xaiojie/papabot/hardware-selection/README.md

# 选型、BOM 与采购

| 资料 | 入口 | 用途 |
|---|---|---|
| 集成板 BOM 总表 | [最新 BOM 总表](procurement/2026-09-12/最新BOM总表.md) | 板载物料与整机配套件汇总 |
| 第三方资料 | [规格书与参考图](../docs/references/README.md) | 厂商规格、供应商说明与商品截图 |
| 采购清单 | [采购说明](procurement/2026-09-12/README.md) | 立创/淘宝清单、替代料及历史价格 |
| 2026-09-13 原始报价 | [报价归档](procurement/2026-09-12/立创报价单-20260913/README.md) | 原始 Excel、CSV、核对数据 |
| 模块方案 V7 | [V7](bom-v7/README.md) | 早期模块方案底表，与集成板清单区分使用 |
| 早期 BOM 工作簿 | [BOM 与建模尺寸](bom-v1/exports/桌面助手-BOM与建模尺寸.xlsx) | 原 `outputs/<会话编号>/` 工作簿 |
| 2S 供电选择 | [电源方案](power-selection-2s.md) | 电池和充电方案演进 |
| ACE800 电池记录 | [电池记录](battery-stock-2026-09-09/README.md) | 选型与结构适配依据 |
| 舵机参考 | [MG90S](servo-mg90s-180.md) | 型号和尺寸参考 |

`bom-v1` 至 `bom-v7` 之间有生成器和历史数据依赖，保留原相对布局。库存、价格、已购数量与替代料兼容性须按实际采购和器件核对，历史报价不视为实时数据。

采购原始表格未重新生成，本轮只归类目录并修正引用路径。生成器输出归到对应 BOM 版本的 `exports/`；本机依赖、检查转储和缓存不入库。
