xaiojie/papabot/pcb-design/README.md

# PCB 设计与制造资料

当前集成板为 `DesktopAssistant_Integrated`，110 × 75 mm 双层板。用户在 2026-09-13 调整过文字，继续编辑时优先读取用户最新版备份。

| 资料 | 入口 | 适用范围 |
|---|---|---|
| 用户最新版 | [核对结论](integrated-v1/user-latest-review-2026-09-13/核对结论.md) | 保留用户丝印与文字位置调整 |
| 芯片和屏幕资料 | [第三方资料索引](../docs/references/README.md) | 完整 PDF、规格图和供应商说明 |
| V1.2 无旋钮交付 | [交付说明](integrated-v1/final-no-encoder-2026-09-12/README.md) | 五页原理图、原生工程、Gerber、BOM 与检查报告 |
| 集成板设计演进 | [设计记录](integrated-v1/README.md) | 部分早期条目已被最终交付替代 |
| RevB 载板 | [RevB](native-rev-b/README.md) | 模块方案载板，屏幕电源修订为 3.3V |
| RevB 用户丝印 | [丝印与核验](revb-lettering-2026-09-10/README.md) | Jay/爬爬丝印版本 |
| RevA 早期载板 | [RevA](native-rev-a/README.md) | 历史资料，旧屏电源接法不作为当前接线依据 |

`repair-*`、`layout-*`、`before` 和 `history` 保留用于追溯；本次仓库整理没有重新生成制造文件。DRC 与 Gerber 检查记录不等于实板上电、充电、负载和温升验证，当前状态见 [项目进度总览](../项目进度总览.md)。
