xaiojie/papabot/mechanical-design/README.md

# 外壳、腿部与打印资料

| 资料 | 入口 | 状态 |
|---|---|---|
| 结构版本入口 | [当前结构版本](当前结构版本.md) | 当前 CAD 与使用说明 |
| A5 宽体短机身 | [A5](structure-a5/README.md) | CAD 试装基线，含 31 个 STL、试配件、渲染与检查记录 |
| 完整圆角外观提案 | [方案与效果图](concept-rounded-body-20260915/外观与结构方案.md) | 设计提案，尚未实施到 Blender/STL |
| A4 结构 | [A4](structure-a4/README.md) | A5 前的结构基线 |
| A3 与电池适配 | [A3](structure-a3/README.md) · [ACE800](battery-ace800-a3/README.md) | 模块方案历史结构 |
| A2 与早期结构 | [A2](structure-a2/README.md) · [早期总装](assembly-v1/README.md) | 设计追溯 |
| 早期比例与配色 | [V6 比例](concepts/design-v6-compact-centered/design-notes.md) · [奶油薄荷](concepts/design-v7-cmf-options/design-notes.md) | 外观参考，不作为加工尺寸依据 |
| BOM 与外壳规划 | [核对与修改计划](a4-planning-2026-09-13/BOM核对与外壳修改计划.md) | PCB、模块和内部安装空间记录 |

A5 报告记录机身 124 × 112 × 76 mm，中立站姿含脚垫和耳朵为 162.9 × 116.5 × 122.46 mm。完整圆角效果图表达下一版方向，不能直接当作已修改的 A5 模型。

Git 跟踪 STL、建模脚本、渲染、说明和检查报告。原生 `.blend`、自动备份及重复整机 ZIP 沿用既有忽略规则保留本地；外部克隆需要原生模型时应另外取得对应文件。CAD 检查不替代实物打印、试装、承重或行走验证。
