xaiojie/papabot/design-coordination/README.md

# PCB与整机结构协调记录

2026-09-08：用户明确恢复旧V1方案：**屏幕竖直正对使用者，旋钮与按键保留在原板，藏在可拆前盖内，屏幕内凹。** 当前机械入口为[structure-a3](../mechanical-design/structure-a3/README.md)，30个独立STL及Blender总装/爆炸/零件总览/拆前盖场景已生成。后台建模，原V1、A1、A2保留。

2026-09-09：电气载板已更新为[RevB](../pcb-design/native-rev-b/README.md)，屏幕VCC/BLK改为3.3V；JP3默认断开，J10预留外部3.3V输入。机械仍为A3，新增连接位的实物插头高度及线束空间待验，未修改Blender/STL。

## 当前接口

- 单位mm；X左右、Y前后（前为负）、Z向上。机身宽124、高76；前盖外Y−46.2，主壳后Y68，后盖外Y70.6，含盖深116.8。
- 屏幕原板91×44mm，中心(10.5,−20.2,68)，孔距标称84.5×37.5。原EC11位于右上(43.5,78.5)，独立按键位于右下(43.5,55.8)，均保留原装。显示面法线−Y，与前窗平行，玻璃名义内凹20.79mm。
- R02为深可拆前盖，集成内井及麦克风导声管；取下4颗M3×30/0.8mm垫片后向−Y抽出。底盘前固定点归R01，前盖无电线，不必拆底盘/主板。旋钮和按键在拆盖后操作。
- 旋钮总高度沿用V1假设；商品图15mm是轴长，不能直接当作PCB到旋钮顶的总高。实物间隙与声学需复核。
- PCB现为native-rev-b，保持原80×32mm精确板框、天线U形开口及4个Ø3.2孔。孔心(5,5)、(75,5)、(75,27)、(5,27)。变换X=u−40，Y=v−2，Z=w+66，w=0为板底。固定用4颗小头M2×8，头径≤4mm，避开J9。R06底部仍为M3×10。
- 底盘4.6mm厚，Z30～34.6；电池目标75×40×20mm，Z35.6～55.6。尺寸、出线及≤80g待商家最终确认。
- 8个MG90S 180°，每腿2个；采用原装舵盘和中心螺丝，不打印花键。各腿与A2打印几何相同，耳槽、轴伸、舵盘与负载待同批实物试验。
- R03保留S1A、充电口、喇叭套和功放座，取消EC11/按键孔及R07/R08后置压片。R09/R10可单独调整。后盖附件沿+Y退出，需要线束检修余量。
- R14仍为可换麦克风托架；模块外形身份待核。DFR0753/PCA/好盈UBEC用开放架和绝缘垫/扎带；DFR0753仅为空间预留，UBEC标称本体43×17×7不含线和磁环。
- USB调试仍需拆后盖并松开右侧电源架；后盖Type-C为独立充电口，首版仍关机充电。

## 文件与检查范围

[参数记录](../mechanical-design/structure-a3/reports/assembly-parameters.json)及[接口JSON](interface-proposal.json)为当前A3数据。旧后置控件决定已被用户本轮确认替代。

30件STL重读均为单一闭合连通体；453对静态实体检查无超过0.05mm³冲突。正面显示区143条抽样视线无遮挡，前后盖各16个轴向拆卸位置与32个逐腿姿态抽样通过。详见[验证说明](../mechanical-design/structure-a3/验证说明.md)，不等于连续扫掠、实物配合、线束、承载、步态、声学、温升或RF通过。

A3只改4个打印件R01/R02/R03/R04，取消R07/R08，其余26件的STL几何数据与A2逐字节一致。原V1/A1/A2的Blender文件校验值与A2交付记录一致。前一版当前入口已备份在history/before-a3/。

采购参考V7暂定选型；结构细化差额见[装配说明](../mechanical-design/structure-a3/装配与打印说明.md)。A3前盖新增M3×30，M2螺母总数减为60。A3机械修订当时没有变更购物车或下单，也没有改电气PCB；2026-09-09的RevB电气修改见顶部入口。
