xaiojie/papabot/hardware-selection/battery-stock-2026-09-09/README.md

# 成品电池方案：格氏 ACE 800mAh 2S

2026-09-09，按用户授权以现成电池调整设计。**本轮选定格氏 ACE 800mAh / 45C / 7.4V / 2S1P，T型插头。** 不再等待定制1000mAh、内置保护均衡和XT30齐全的电池包。已选型，未下单、未联系商家。

| 采购项 | 准确选项 | 页面参考价 | 数量 |
|---|---|---:|---:|
| [格氏 ACE 电池](https://item.taobao.com/item.htm?id=663039669190&skuId=4779123056788) | **T型插头；800mAh-45C-7.4V-2S1P** | ¥39.60 | 1 |
| [优信电子保护均衡板](https://item.taobao.com/item.htm?id=574046367042) | **HX-2S-JH20，2串带均衡款** | ¥9.02 | 1 |
| 机器端T插配对线 | 与电池实物匹配、16/18AWG短线；不剪电池原插头 | 未计价 | 1 |
| 2S三线平衡头配对线 | 按实物接头确认；中间线接BM，另两根独立封好 | 未计价 | 1 |

前两项合计 **¥48.62**。两页查询时均有货；价格和库存不是结算承诺。店铺显示名称分别为“格氏电池全国总代”和“深圳市优信电子科技有限公司”。旧采购表的电池定制行和“随定制附送XT30”行由以上条目替代；其余常规物料沿用V7及RevB装配差额。

## 电池与取舍

- 页面尺寸 **60×32×16mm**，主线16AWG、长80mm；平衡线22AWG、长45mm。尺寸不含插头和自由线长。
- 主图写55g（±15g），详情表写60g，按约55–60g规划，收货称重。不要当作已实测重量。
- 标称容量800mAh、能量5.92Wh，比原1000mAh少20%；不据此承诺整机续航。
- 45C是页面标称放电倍率，理论换算36A仅用于理解标称，**不是本机允许电流，也没有做过负载实测**。这是一款动力电池候选，不再以“商家必须承诺持续3A/10A并且内置所有功能”为采购门槛。
- 此款按**没有内置保护板**处理，另接现成保护均衡板。四足八舵机目标保留，先按现有一个舵机进行限流测试，再逐级增加负载。

## 电路适配结果

现有载板是[RevB](../../pcb-design/native-rev-b/README.md)，电池与舵机的功率路径本来就在板外。这次电池仍为7.4V、满电8.4V，因此**不需要修改载板铜线、板框、屏幕3.3V或重新生成Gerber**。本轮已读取现有嘉立创工程P1核对接口；没有改动在线工程。

| 核对处 | 结果 |
|---|---|
| J8 | 仍接逻辑UBEC稳压后的5V / P− |
| J9 | 仍接保险丝、总开关之后的VBAT_SW / P−，仅用于采样 |
| R1/R2 | 100kΩ/33kΩ，8.4V分压为2.084V，保持不变 |
| J3/J10/JP3 | 屏幕仅3.3V；外供J10时JP3断开，保持RevB接法 |
| 舵机供电 | DFR0753输出5V，经独立粗线配电；不走载板/PCA细铜箔 |
| 逻辑供电 | 好盈86010010 UBEC跳帽设5V；与舵机路只共地，不并联5V输出 |

具体线束见[电源接线与调试](接线与调试.md)和[接线图](power-wiring.svg)。新增保护板是采购模块，不是新增一块待打样PCB。

## 结构适配结果

新增[电池适配试装件](../../mechanical-design/battery-ace800-a3/README.md)：R21定位垫框、R22独立保护板托架。原A3机壳、前后盖、底盘和PCB支撑架保持原几何，原位旋钮及正面内凹屏幕保持原设计。

新Blender副本中包含按成品尺寸更新的总装与电源舱场景；原A3源文件不覆盖。新增STL供试装，实物尺寸、固定牢固度及温升还未验证。

## 充电与软件边界

电池充电要求按标准2S锂聚合物处理：**8.4V CC/CV，首轮0.4A，关机充电。** 这是保守调试设定，不是从商品页取得的最大充电电流。原TELESKY MK021163充电板的实际电流仍未知，**不能直接假定它已经是0.4A，也不能只凭空载8.4V就连接新电池**。先用电池模拟负载确认限流、终止电压和温升；若无法设到合适电流，改用能明确设定2S/0.4A的外置充电器。保护板不代替充电器。

现有USB/台式电源开发测试程序继续使用。它没有电池ADC与低压停机功能，不能当作整机电池保护固件。后续整机固件按校准后的电压先采用7.2V提示、7.0V停止动作并提示手动关机的保守起点，再做负载压降和滞回验证；板上单节2.9V保护只是最后一道硬件保护。

## 依据与检查记录

- 电池选中SKU截图：`evidence/ace800-selected.png`，详情参数：`evidence/ace-details-2.jpg`。
- 保护板供货页手册：[67325.pdf](evidence/YourCee-67325-2S-protection.pdf)。标称46.7×23×3.15mm、工作电流上限10A、瞬时20A；这些是模块页面规格，不作为整机实测结论。
- 手册内阻写“<300mΩ”，未擅自改为其他数值。必须实测压降和温升，尤其增加舵机负载时。
- [电气兼容性记录](electrical-review.json)、[新物料记录](selection.json)、[结构检查](../../mechanical-design/battery-ace800-a3/reports/fit-check.json)。

本方案完成选型和设计适配；没有宣称已实机运行、已充电验证或已通过八舵机负载测试。
