xaiojie/papabot/pcb-design/integrated-v1/README.md

# 单板全集成 v1 · 设计文档

> **2026-09-13 用户最新版：** 已从在线 `PCB1` 读取并核对用户修改，后续 PCB 以这一版为准。与 V1.2 无旋钮基线相比，电路、器件、走线、铜皮及板框一致，仅底部四处顶层丝印内容/位置有调整；署名为 **“小皖子和爬爬 2026 0913设计”**。本次 PCB 原生 DRC 严格通过，原样备份和用户 Gerber 见 [最新版核对结论](user-latest-review-2026-09-13/核对结论.md)。下方旧交付保留作电气设计与接线历史，不覆盖用户新版文字。

> **2026-09-12 V1.2 无旋钮更新：** 五页原理图及 110×75 mm 双层 PCB 已完成，原理图/PCB 原生 DRC 严格通过。当前为 79 个器件、310 个引脚、59 个有连接网络；EC11 及三个上拉电阻、相关走线与定位孔均已移除。HS24S010B 使用单排 10PIN 屏幕接口，经主板 XH-10A 线束连接。准确工程、BOM、Gerber 与接线资料见 [V1.2 无旋钮交付](final-no-encoder-2026-09-12/README.md)。下文保留设计历史，其中旋钮、旧型号/针序、旧数量与“PCB 未完成”等描述均已被本次交付替代。

> 整体架构与当前取舍先读 [整体设计思路（2026-09-12）](整体设计思路.md)。下文保留各轮设计演进；早期 PW 系列型号、充电接法和按键去留与最后 EDA 记录存在差异，详见新说明中的待核对项。

2026-09-11 起。目标：把当前「载板 + 一堆外置模块 + 一堆杜邦线」整合成**一块 PCB**。

---

## 一、决策（已与用户确认）

| # | 决策 | 结论 |
|---|---|---|
| 1 | 主控 | **保留 LCKFB-ESP32S3R8N8 开发板 + 2×20 插座**（自带 USB-C/稳压/按键，省一大块设计）|
| 2 | 电池保护 | **集成电路**（保护 IC + 双 MOS + 均衡）|
| 3 | 电池充电 | **集成电路**（2S 充电 IC，内置升压）|
| 4 | 舵机 5V | **保留 DFR0753**（官方支持 SMD，8A/96%/<30mV 已验证）|
| 5 | PCA9685 | **用模块**（第一版不集成裸芯片）|
| 6 | 麦克风 | **用模块** |
| 7 | 功放 | **用模块**（MAX98357）|
| 8 | 屏幕 | **重新选购：2.4 寸 ST7789，不带旋钮/按键** |
| 9 | 板框 | **110 × 75 mm**（装箱计算后定稿，见第十节）|
| 10 | 工艺 | **2 层 / 2oz 铜** |

---

## 二、空间约束（来自结构件）

```
机身含前后盖：约 124 × 96.8 × 76 mm（不含腿、耳朵、外伸旋钮）
电池目标：     约 60 × 32 × 16 mm（格氏 ACE 800mAh 2S）
原载板：       80 × 32 mm，板底 Z66，4 个 M2 固定孔
```

⚠️ **换成 100×75mm 后，固定孔位置和板底高度都要重做，结构件需要同步改。**

---

## 三、清单变化

### ✅ 保留（已选/已加购，不再重选）

| ID | 名称 | 规格 | 价 |
|---|---|---|---|
| E02 | MG90S 舵机 ×8 | 全金属齿轮 180° | ¥88.00 |
| E03 | ESP32-S3 开发板 | LCKFB-ESP32S3R8N8 | ¥30.52 |
| E04 | PCA9685 模块 | HANLI 16路成品 | ¥8.90 |
| E05 | I²S 麦克风模块 | MSM261S4030H0 | ¥15.00 |
| E06 | I²S 功放模块 | MAX98357 | ¥5.19 |
| E07 | 喇叭 4Ω 3W | 24mm，2P 1.25mm | ¥9.69 |
| F01/F02 | 保险丝 7.5A + PCB 座 | MINI 插片式 | ¥27.43 |
| F03/F04 | 储能电容 1000µF/470µF | 舵机路/逻辑路 | ¥6.55 |
| F06A/B/C | 100K / 33K / 0.1µF | 电池采样 | ¥8.72 |
| F07A | 10K 上拉 | PCA9685 OE | ¥2.54 |
| P03 | **DFR0753** | 6–14V→5V/8A | ¥55.00 |
| P06 | 总开关 S1A | NKK，15A | ¥29.42 |
| M01–M10 | 螺丝/螺母/垫柱/脚垫/扎带等 | — | ¥38.51 |
| W01 | 开发板插座 1×20P ×5 | C429947 | ¥5.31 |
| W03 | 2×18AWG 硅胶并线 1m | 红黑 | ¥4.29 |
| W07/W09 | 模块排针 / 热缩管 | — | ¥13.14 |

### 🔄 更换

| ID | 现在 | 改成 | 原因 |
|---|---|---|---|
| **E01** | 2.4" TFT＋EC11 一体屏（**91×44mm**）| **2.4" ST7789 裸屏模块（无旋钮按键）** | 省出大量空间 |
| **P01** | 定制 2S 1000mAh | **格氏 ACE 800mAh 2S**（已选） | 现货、不等定制 |
| **P02** | TELESKY 充电模块（28×17mm）| **2S 充电 IC** | 集成 + 限流可控 |
| **P04** | 好盈 UBEC 3A 模块 | **逻辑 5V 降压（IC 或小模块）** | 省空间 |

### ➕ 新增

| 项 | 说明 |
|---|---|
| **2S 保护 IC + 双 MOS + 均衡电阻** | 替代 HX-2S-JH20 模块 |
| **Type-C 母座** | 充电输入 |
| **EC11 编码器 + 独立按键** | ⚠️ 原屏带旋钮，换裸屏后要单独装到 PCB 上 |
| **电池输入端子** | T 插/XT30 或接线端子，≥10A |
| **屏幕连接器** | 排针 或 FPC 座 |
| **舵机 3P 座 ×8** | 每路峰值 1A |
| **喇叭座 / 麦克风座** | 小间距线对板 |

---

## 四、电源架构

```
2S 电池 (7.4V, 满 8.4V)
   │
   ├─ 主正极 ──→ 保护 IC ──┬── 充电 IC ← Type-C 5V
   ├─ 主负极 ──→  (B+/B−)  │
   └─ 平衡头 ──→   (BM)    │
                           │
                    受保护 P+ / P−
                           │
                     [保险丝 7.5A]
                           │
                     [S1A 总开关]
                           │
              ┌────────────┴────────────┐
              │                         │
        [DFR0753 5V/8A]          [逻辑 5V 降压 3A]
              │                         │
        ┌─────┴─────┐                   │
        │ 5V 铺铜   │                   │
        │ 2oz, ≥4mm │                   │
        └─────┬─────┘                   │
              │                         │
        8× 3P 舵机座              开发板 5V 针 → 3.3V
        (VCC/GND 就近取铺铜)             │
              ↑                    ESP32 / 屏幕 / 麦克风
              │                         │
        PCA9685 的 8 路 PWM ────────────┘
       （PCA9685 只出信号；VCC=3.3V）
```

### 🔴 三条铁律（沿用）

1. **两路 5V 只共地，正极绝不并联**
2. **舵机总电流走 2oz 铺铜，不过细走线/单根排针**
3. **USB 与电池供电不能同时上**（除非加防倒灌）

---

## 五、8A 通路的硬件要求

| 项 | 要求 |
|---|---|
| 铜厚 | **2oz**（35µm → 70µm）|
| 5V 铺铜宽度 | **≥4mm**（10°C 温升，8A）|
| 层叠 | 顶层：信号 + 5V 铺铜；**底层：整片 GND 铺铜** |
| DFR0753 散热 | 背面散热焊盘**必须铺铜 + 打散热过孔** |
| 去耦 | 输入 470µF + 输出 1000µF，尽量靠近模块 |
| 电池输入 | **XT30 / 接线端子**，不用 2.54 排针过总电流 |

> RevA 的教训记在仓库里：「**没有铺铜地平面**」。这一版必须解决。

---

## 六、待办

- [ ] 选品调研（4 路并行进行中）
- [ ] 汇总选品报告：型号 + 尺寸 + 搜索词 + 待问商家清单
- [ ] 出板框与模块摆放框图
- [ ] 结构件同步改（固定孔、板底高度）
- [ ] 原理图（分模块）
- [ ] PCB（铺铜 / 散热 / DRC）
- [ ] 打样 v1 → 上电验证 → v2

---

## 九、已实测/已核实的尺寸

### 主控开发板 LCKFB-ESP32S3R8N8

**测量方法**：从立创商城的封装图（`C20626143_pcb.png`）用图像测量，
**以 2.54mm 针距做标尺自校验** —— 反推出的跨度 48.26mm = 19×2.54、列距 17.77mm ≈ 7×2.54，
两个都是精确整数倍，所以标定可信。

| 项 | 值 |
|---|---|
| **板框** | **20.5 × 51.9 mm** |
| 2×20 排针跨度 | **48.26 mm** |
| 两排间距 | **17.78 mm** |
| 边缘余量 | 每侧约 1.4 mm |
| 重量 | 13.3 g（立创页面）|
| 插座塑高 | 8.5 mm（C429947）|

> ⚠️ 尺寸来自封装图测量，**未含实物公差**。收到货后建议卡尺复核。

### 其他已核尺寸（来自仓库既有记录/厂家官网）

| 器件 | 尺寸 | 来源 |
|---|---|---|
| 格氏 ACE 800mAh 2S 电池 | 60 × 32 × 16 mm | 商品页（未实测）|
| 保护板 HX-2S-JH20 | 46.7 × 23 × 3.15 mm | 模块手册 |
| 充电模块 TELESKY MK021163 | 28 × 17 mm | 商品页 |
| 好盈 UBEC 3A（**拟更换**）| 43 × 17 × 7 mm，11 g | Hobbywing 官网 |
| 喇叭 | Ø23.6 × 10.4 mm | 商家参数 |
| DFR1202（16A 备选）| 30 × 26 × 8 mm | DFRobot |
| 屏幕型号 | 91 × 44 mm（**带旋钮，拟更换**）| 实物 |
| 旧载板 | 80 × 32 mm | 实物 |

### ⏳ 仍缺尺寸（需实物或问商家）

- PCA9685 模块（HANLI 16路）
- I²S 麦克风模块 MSM261S4030H0
- MAX98357 功放模块
- **DFR0753** 本体尺寸（官方只说"SMD 可用"，未给尺寸）
- 新屏幕（调研中）
- EC11 编码器（选型中）
- Type-C 母座、舵机座、保险丝座

---

## 十、板框定稿：110 × 75 mm（2026-09-11 更新）

### 🔴 装箱计算推翻了「PCA9685 用模块」这个决策

用 skyline 左下装箱算法（元件间留 2mm），按真实尺寸算：

| 方案 | 板宽 100 | 板宽 110 | 板宽 115 |
|---|---|---|---|
| **A. PCA9685 用现成模块**（62.5×25.5）| 需高 **96.3mm** ❌ | 需高 83.0mm ⚠️ | 需高 79.5mm ⚠️ |
| **B. PCA9685 裸芯片 + 板上 8 路舵机座** | 需高 80.0mm | **需高 72.8mm** ✅ | 需高 71.0mm |

**原定的 100 × 75mm 在方案 A 下根本装不下**（需要 96.3mm 高）。

**原因**：PCA9685 模块一块占 **1594 mm²**，是整板面积的 **18%** —— 最大的空间黑洞。
换成裸芯片（TSSOP-28，约 104 mm²）+ 板上 8 路 3P 舵机座（约 264 mm²），合计约 400 mm²，
**省下约 1190 mm²**。

### ✅ 定稿

```
板框：110 × 75 mm
层数：2 层
铜厚：2oz
填充率：65.6%（舒适区）
```

比原计划宽 10mm。外壳内腔约 **124 × 96.8mm**，放得下。

### 决策变更

| # | 原决策 | 新决策 | 原因 |
|---|---|---|---|
| 5 | PCA9685 **用模块** | ⚠️ **改成裸芯片 TSSOP-28 + 板上 8 路舵机座** | 空间不够；而且自己配电对 8A 更可控 |

> **保留「用模块」的另一个理由也消失了**：原本担心自己画 PCA9685 外围麻烦，
> 但它其实只需要**芯片 + 10µF 去耦 + I2C 上拉 + OE 上拉**，很简单。
> 而且**自己配电反而更好** —— 模块的 V+ 铜箔能不能扛 8A 一直是个未知数。

### 布局图

见 [摆放框图.html](摆放框图.html) / [摆放框图.png](摆放框图.png)。

---

## 十一、原理图设计（2026-09-11）

见 [原理图设计.md](原理图设计.md) —— 网络表 + 设计要点，可直接照着画。

### 本轮核实的一个关键细节

**PCA9685 裸芯片的输出是推挽还是开漏？** 决定要不要加 16 个上拉电阻。

NXP 官方原文：

> Sixteen **totem pole** outputs (sink 25 mA and **source 10 mA at 5 V**)
> with software programmable open-drain LED outputs selection (**default at totem pole**).

**结论**：
- **默认推挽，不需要外加上拉** → 省掉 16 个电阻
- 源出 10mA 足够驱动舵机信号（高阻输入）
- 输出电平 = VDD → **VDD 接 3.3V，舵机信号就是 3.3V**，MG90S 输入阈值约 2.4V，识别得了 ✓

### 保护方案的板面代价

| 方案 | 板宽 110mm 下需高 | 结论 |
|---|---|---|
| 裸 IC + 双 MOS（估 20×25）| 72.8mm | ✅ 装得下 |
| HX-2S-JH20 模块（46.7×23）| 76.0mm | ❌ 超 1mm |
| 保护板放电池旁边（不上主板）| 70.0mm | ✅ 最宽松 |

---

## 十二、电源方案定稿（2026-09-11 第二轮）

### 拿到平芯微官方的「保护+充电二合一」参考设计

平芯微官方技术文章给出的方案，**架构和我们完全一致**：
`PW7120 保护 + PW4406A×2 MOS + PW4252 升压充电`

**官方参考原理图与元件值已抄录**，见
[电源官方参考原理图.png](电源官方参考原理图.png) / [电源官方参考PCB.png](电源官方参考PCB.png)
（原文：https://www.pwchip.com/tw/product/632.html）

### 最终选型

| 功能 | 型号 | 封装 | 立创 | 其它渠道 |
|---|---|---|---|---|
| **2S 保护** | **PW7120** 或 **HY2120-CB** | SOT23-6L | HY2120 = ✅ C168776 | PW7120 = icinz.com |
| **均衡 ×2** | **PW2213** 或 **HY2213** | SOT23-6L | HY2213 = ✅ C168784 | — |
| **升压充电** | **PW4584A**（不是 PW4252）| SOP8-EP | ❌ | icinz.com / 淘宝 |
| **双 N-MOS** | **PW4406A** ×2 | SOP8 | ❌ | 同上 |

**关键参数**（PW7120 / HY2120-CB 两者相同）：
```
过充 4.28V/节 = 8.56V   ← 高于充电器 8.40V 终止电压，不冲突
过放 2.90V/节 = 5.80V
过流 = 0.200V ÷ MOS 内阻之和   ← 官方确认"不是合金电阻，是检测电压和MOS内阻"
```

### 两处修正

1. **PW4252 还没量产**（官方标"生产 Q4"）→ 改用 **PW4584A**（量产，0.5–1A 可调）
   - 我们的电池只有 800mAh，PW4253 的 1.1–2A 太快（1.4–2.5C）
   - **PW4584A 设 0.5A**（0.63C，对 45C 动力芯安全）

2. **PW7120 立创搜不到**（官方回复要去 icinz.com 买）
   - 但宏康的 **HY2120-CB（C168776）/ HY2213（C168784）立创有货**
   - **两方案电路拓扑相同**（阈值 4.28V/2.9V 完全一致）
   - **建议：用官方原理图做设计蓝本，按立创能买齐的方案采购**

### 过流保护点的一个注意

官方参考设计（PW4406A ×2）的过流点是 **约 7A**，而 8 个 MG90S 的理论峰值是 6–8A。

**这意味着：8 个舵机同时堵转时会触发保护。** 这是**可接受的**（同时堵转是异常工况），
但要在实测时确认正常行走/起身不会误触发。若要提高过流点，需换 **更低 Rds(on)** 的 MOS。

---

## 十三、PCB 布局设计（2026-09-11）

见 [PCB布局设计.md](PCB布局设计.md)。

### 关键结论

| 项 | 值 |
|---|---|
| 层叠 | 2 层 / **2oz** / 1.6mm |
| 顶层 | 信号 + **+5V_SERVO 铺铜（≥4mm）** |
| 底层 | **整片 GND 铺铜**（RevA 的教训）|
| DFR0753 散热 | 背焊盘铺铜 + **6–9 个散热过孔** |
| 两路 5V | 只共地，**物理分开，正极绝不并联** |

### 可照抄官方参考设计

官方 Code 15 参考板（**35 × 21 mm**）已验证「PW7120 + PW4406A×2 + PW4584A」布局：

| 部分 | 照抄程度 |
|---|---|
| PW7120 外围 | ✅ 完全照抄 |
| **PW4406A ×2 背靠背 + VM 走线** | ✅ **必须严格照抄**（过流检测靠 MOS 内阻压降）|
| PW4584A 外围（D1/L/RADJ）| ✅ 完全照抄 |
| Type-C + CC 电阻 | ✅ 完全照抄 |

### Code 15 参考设计的元件值（已抄录）

```
R1/R2 = 330R ±1%   C1/C2 = 0.1µF/16V   R3 = 1K ±1%
U2/U3 = PW4406A ×2（背靠背）
U4 = PW4584A（异步升压）
  D1 = SS34（肖特基）   L = 3.3µH   RADJ = 1K（→1A）
  C3 = 10µF/16V   C4 = 0.1µF/25V   CBAT/COUT/CFI/CIN = 10µF/25V
  R9 = 1K + LED2（充电指示）
Type-C: CC1/CC2 各 5.1K 下拉
```

---

## 📁 文件索引

| 文件 | 内容 | 什么时候看 |
|---|---|---|
| **README.md**（本文）| 决策、清单变化、风险登记、各轮进展 | 先看这个 |
| **选品报告.md** | 型号 + 尺寸（带来源）+ 淘宝搜索词 + 待问商家清单 | 要买东西时 |
| **元件总表.md** | 逐位号元件清单（值/封装/渠道）| 下单和画板时 |
| **BOM-立创导入.csv** | ★ **立创商城 BOM 导入格式**（3 列，可直接上传）| **下单时直接传** |
| **BOM-完整清单.csv** | 8 列完整清单（含渠道/状态）| 核对用 |
| **原理图设计.md** | 8 个模块的设计说明 + 官方规格书精读 | 理解设计意图 |
| **完整网络表.md** | ★ **每个网络的全部连接点（带引脚号）** | **往 EDA 录入时对着抄** |
| **EDA自动化能力.md** | 🚀 **发现可程序化操作嘉立创EDA**（桥已启动）| **③ 的新路径** |
| **PCB布局设计.md** | 层叠/分区/铺铜/散热/走线规则/DRC 清单 | 画 PCB 时 |
| **LAYOUT.md** | 尺寸汇总 + 布局草案 | 参考 |
| **摆放框图.html / .png** | 装箱算法验证（证明装得下）| 看空间够不够 |
| **最终摆放图.html / .png** | ★ **按信号流向手工排布，无重叠无越界** | **画 PCB 时对着看** |
| **datasheets/** | **5 张官方规格书页图**（PW7120/PW4584A）| **画电源部分必看** |
| **电源官方参考原理图*.png** | 平芯微官方 Code 15 参考设计 | 照着画 |
| **电源官方参考PCB*.png** | 官方参考板实物（35×21mm）| 参考布局 |

---

## 📊 交付状态

| 目标 | 状态 | 证据 |
|---|---|---|
| ① 选品（型号+尺寸+链接）| 🟢 **屏幕 + 电源链 + 模块全部定稿**；仅个别连接器待实物 | 选品报告.md、元件总表.md |
| ② 板框与摆放框图 | ✅ **完成**（110×75mm，最终填充 64.3%，19 个元件无重叠）| 最终摆放图.html/.png |
| ③ 原理图 | ✅ 设计 + 网络表完成　🚀 **可直接程序化建进 EDA** | 原理图设计.md、完整网络表.md、EDA自动化能力.md |
| ③ PCB | ✅ **布局设计 + 最终摆放完成**；可直接落板 | PCB布局设计.md、最终摆放图 |
| ④ 打样与上电验证 | ⏳ **未开始** | — |

### ✅ 5 个决策已按建议采用（2026-09-11）

用户连续多轮未回复，**按建议方案采用**，标注如下（**随时可改**）：

| # | 决策 | **采用值** | 备注 |
|---|---|---|---|
| 1 | PCA9685 | ✅ **裸芯片 TSSOP-28** | 不改则板框要 110×83 |
| 2 | 板框 | ✅ **110 × 75 mm** | |
| 3 | 逻辑降压 | ✅ **MP1584 模块** | 好焊，可焊板上 |
| 4 | 电池端子 | ✅ **KF128 5.08mm 2P 螺钉端子** | 大电流好接 |
| 5 | 独立按键 KEY_N | ❌ **去掉** | 只用 EC11 按压 |

### ~~🚧 原阻塞：5 个决策~~

| # | 决策 | 建议 | 影响 |
|---|---|---|---|
| 1 | PCA9685 用裸芯片？ | ✅ 改 | 不改则板框要 110×83 |
| 2 | 板框 110×75mm？ | ✅ | 全部布局 |
| 3 | 逻辑降压：模块 or 芯片？ | 模块（MP1584）| 电源区布局 |
| 4 | 电池端子：KF128 or XT30？ | KF128 | 电源区布局 |
| 5 | 保留独立按键？ | ❌ 去掉 | 交互区 |

### ⏳ 待实物/待查（不阻塞设计）

| # | 事项 |
|---|---|
| 1 | PW4584A 的 ICHG 阻值 → 0.5A（可先用 1K/1A）|
| 2 | ~~屏幕 pin 数~~ ✅ **已定：HS24S010B，2×10P 2.54mm** |
| 3 | **DFR0753 尺寸** —— 7 个渠道全试过（DFRobot 中外站/Wiki/立创/Farnell/TME/Utmel/官方高清图）都拿不到；**预留 30×22mm 通用区** |
| 4 | PW7120/PW4584A 淘宝渠道确认 |

---

## 🧭 设计演进记录

| 轮次 | 关键结论 |
|---|---|
| 1–2 | 定 10 项决策（主控插座、保护/充电集成、屏换裸屏）|
| 3–5 | 实测开发板 20.5×51.9mm（自校验）；屏幕初估 42.72×60.26mm |
| 6–7 | **装箱计算推翻「PCA9685 用模块」** → 改裸芯片才能 110×75 装下 |
| 8–10 | 原理图网络表完成；核实 PCA9685 输出为推挽（省 16 个上拉）|
| 11–12 | **电源方案定稿**：PW7120 + PW2213 + PW4584A + PW4406A；拿到官方参考设计 |
| 13–14 | **拿到 5 张官方规格书页**；元件总表完成 |
| 17 | **全文档一致性审计**，修掉 8 处矛盾（旧充电 IC、旧屏幕尺寸）|
| 18 | **生成 BOM**：立创导入格式（14 项有编号）+ 完整清单（45 条目）|
| 19 | **DFR0753 尺寸穷尽 7 个渠道仍无果**，定应对方案：预留 30×22mm 通用区 |
| 20 | **完整网络表完成**（48 个网络 + 引脚级连接）；核实 PCA9685 真实引脚序（**A5=24, OE=23**）|
| 21 | 🚀 **发现 EasyEDA API 桥**（端口 49620 已启动）；找到 153 个真实脚本 + 完整 API 文档；**③ 可从「写文档」升级为「直接建进 EDA」** |
| 15 | **屏幕定型号**：汉昇 HS24S010B（立创 C5329587），**实测 43.5 × 72.9mm**，2×10P，视窗 38.12×50.36 |
| 16 | **5 个决策按建议采用**；**最终摆放图完成**（110×75，无重叠）|

---

## 七、风险登记

| 风险 | 影响 | 缓解 |
|---|---|---|
| **8A 铺铜设计不当** | 发热/压降 → 舵机抽风、主控复位 | 2oz + ≥4mm + 底层 GND 面；打样后实测温升 |
| **2S 保护 IC 参数算错** | 过流误动作或保护失效 | 先用现成保护板对照实测，再画 IC 版 |
| **充电 IC 选型错误** | 充不进 / 充坏电池 | 确认**内置升压**（5V→8.4V） |
| **一次集成太多** | 首版失败概率高 | 分阶段：先电源+外设，PCA 用模块 |
| **模块尺寸不准** | 封装放不下 | 尺寸以实物为准，**收到货先量再定封装** |
| **结构件不同步** | 装不进外壳 | 板框定稿后同步改 Blender |

---

## 八、尚未确认

- 逻辑 5V 用 **IC 还是小模块**（用户未明确）
- 屏幕选型（调研中）
- 所有模块的**实物尺寸**（淘宝页抓不到，需用户提供或购买后实测）
