xaiojie/papabot/pcb-design/rev-a/README.md

# 桌面助手 PCB 电路审阅包 · Rev A

**当前原生PCB为RevB：** 请用[RevB工程与接线说明](../native-rev-b/README.md)。本目录是早期设计资料，不用其中旧屏幕供电/控件说明指导当前接线。

**2026-09-09更新：本目录的5V屏幕接线属于旧设计记录，已发现必须修订。** 新模块原理图确认控件上拉至VCC，当前按3.3V供电方向修订。最新结论见[屏幕资料核对](../native-rev-a/supplier-review-2026-09-09/屏幕资料核对与PCB修改要求.md)；本目录历史网表/示意图尚未改成新硬件，不能据旧5V说明接屏幕。

2026-09-08。本包已同步厂家主控电源原理图、屏幕供电和背光说明，以及主任务当前的原理图22元件、PCB21元件载板结构。它提供接线与上电核验依据，**本包仍不是已完成制造检查的 PCB 发布文件**。

嘉立创EDA专业版工程为 `DesktopAssistant_RevA`，项目 ID `e5e438419c1c4681946d5009bb8d6daf`。原生原理图/PCB 由主任务维护；本目录的 `build-review.py` 只生成本地审阅数据和概念图，不操作 EDA，不改写 `DesktopAssistant_RevA.eprj2`。

## 当前原生载板与审阅网表

主任务报告的原生原理图共 **22 个元件，PCB为21个元件**，C2（470µF/16V）因12mm高度可能影响主控插装/USB空间而放在外部UBEC/功放支路，通过两只独立 C429947 20P 排母连接 LCKFB 主控；排母之间采用厂家板卡的 17.78mm 列距。7 组外设接口和两条可断线桥对应如下：

| 原生位号 | 审阅数据名称 | 功能 |
|---|---|---|
| 两只 20P 排母 | U1 的左右排位置 | 主控板接口，2.54mm 节距；不得套用列距15.24mm的整板封装 |
| J3 | J_LCD | LCD：5V供电、3.3V SPI，第8脚NC，模块BLK不接 |
| J4 | J_PCA | PCA9685逻辑：3.3V、GND、SDA、SCL、OE |
| J5 | J_MIC | 麦克风：3.3V、I2S、LR |
| J6 | J_AMP | 功放信号：GND、BCLK、LRC、DIN |
| J7 | J_REAR | 后置编码器与独立按键 |
| J8 | J_LOGIC_IN | 好盈UBEC的逻辑5V入口 |
| J9 | J_SENSE | 总开关后的电池采样入口 |
| JP1 | JP_MCU | 逻辑5V至主控5V的可断开线桥 |
| JP2 | JP_SENSE | 电池采样可断开线桥 |

高电流供电继续采用外部独立线束与额定连接点：DFR0753到八个舵机、好盈UBEC到功放，以及电池、保险、开关和降压输入均不借主控排母或信号杜邦线承载。

审阅逻辑网表另含主控模块、电池、外部降压、充电板、喇叭和八个舵机，因此其 **41 个功能元件、40 个连接网络、2 个独立 NC 点** 与原生原理图22元件/PCB21元件不是同一统计范围。它没有冒充原生网表导出。

## 文件

| 文件 | 内容 |
|---|---|
| [signal-schematic.svg](signal-schematic.svg) / [PNG](signal-schematic.png) | 主控与J3–J9接口、GPIO和上电限制 |
| [power-schematic.svg](power-schematic.svg) / [PNG](power-schematic.png) | 保险、开关、两路5V、充电分支、JP1/JP2与ADC |
| [01-controller-pinout.csv](01-controller-pinout.csv) | 40个主控位置、厂家排针脚号和丝印 |
| [02-gpio-plan.csv](02-gpio-plan.csv) | 19个GPIO用途、方向和限制 |
| [04-connector-map.csv](04-connector-map.csv) | 载板自定义接口、原生位号和逐针接线 |
| [03-logical-netlist.json](03-logical-netlist.json) | 整机逻辑连接、独立NC与原生位号映射 |
| [05-electrical-evidence-review.md](05-electrical-evidence-review.md) | 本次USB直连与屏幕规格证据 |
| [board-interface.svg](board-interface.svg) / [JSON](board-interface.json) | 保留的A1结构空间候选；实际布局以主任务原生工程为准 |
| [validation.json](validation.json) | 审阅数据的一致性检查；不代表ERC、DRC或实测 |

## 已确认的电气事实

**主控USB与5V排针直接相连。** 厂家公开原理图第2页（图框2024-02-28）显示 Type-C U13 VBUS 与 J1.2/3/4 同接 `+5V`，U6 ME6217C33M5G 将该网络降至3.3V，图中没有电源选择或反向阻断器件。[原页证据](sources/lckfb-schematic-core.jpg)。外接5V与普通USB VBUS不得同时直连；单在外供一侧串二极管仍不能阻止向电脑回灌。

**屏幕工作电压为3.3–5V，BLK可不接、默认全亮。** 所选 TOUGLESY 2.4寸 ST7789＋EC11 商品规格图已确认上述两项。Rev A 的 VCC接 `+5V_LOGIC`，SPI使用3.3V，BLK留空；载板J3第8脚也不接线。这不证明信号脚有5V容限。模块工作电流、物理针序与3.3V SPI实际稳定性仍需在收货后确认。[供应商图](sources/selected-display-module-spec.png)。

**主控尺寸和针序已有原厂依据。** 板体51.66×20.32mm，两排20P、节距2.54mm、列距17.78mm、首末孔距48.26mm。项目位置Ln/Rn按“元件面朝上、天线上、USB下”从上到下编号；厂家原理图左排J2、右排J1由下往上编号，故Ln＝厂家J2.(21−n)，Rn＝厂家J1.(21−n)。原生排母Pin 1朝向必须对应其实际封装。

**19个GPIO没有重复分配。** 避开启动配置0/3/45/46、USB19/20、UART43/44、内存26–37与板载LED48。ADC用GPIO1/ADC1_CH0；两个I2S时钟组分别用于麦克风与功放。

## 供电与首次上电核验

1. **首次USB烧录：把主控从载板完全取下，单独接电脑USB。** 烧录结束断开USB，再装回载板。整机使用电池供电时勿插USB。
2. **JP1、JP2都是人工可断开线桥，初次上电先保持断开。** 分别用于切断主控外供5V和电池采样路径；它们不是自动防回灌或自动电源切换电路。
3. **先核电源再连接负载。** 确认两路降压均为5V，好盈跳帽处于5V档；核对极性、主控3.3V、接口电压、静态电流及ADC节点电压，按分阶段上电结果分别接通JP1/JP2。改接线桥时断电。未完成实测前不把正常电压或上电行为写成已通过。
4. **电池采样从总开关后取电。** 100k/33k＋100nF在8.4V时输出名义2.084V，1%电阻最坏约2.116V；等效阻抗24.8kΩ、RC约2.48ms。JP2可断开采样，供电瞬态中3.3V未建立时的ADC注入仍需分析与测试，100k限流不等于自动满足芯片额定。
5. **舵机逐只卸载测试。** OE先保持高，核PCA模块实际下拉及I2C上拉电源，再配置频率与零输出、自检后使能；验证复位、低电量、八舵机动作电流和温升。OE只禁止PWM，不切断舵机电源。

首版采用关机充电；电池保护后P+经过7.5A保险，再分至充电板与S1A总开关，开关后分两路降压。充电板负端接保护后的P−，不绕过BMS。`+5V_SERVO`与`+5V_LOGIC`禁止并联，舵机回流走独立粗线返回舵机电源；电气共地不等于共用细回路线。

## 仍需实物确认

- HANLI PCA9685板的OE下拉、I2C上拉阻值与物理脚序；外加10k不能直接假定压过板载下拉。芯片MODE2拟用OUTNE=00、OUTDRV=1、INVRT=0；0x40只对应A0–A5全低。
- 所购麦克风的确切板型：DFRobot SEN0327 HTML为直径14mm、1.8–3.3V；所链PDF却是Sipeed I2S_Mic、矩形15.24×9.14×11.2mm。相同MSM261S4030H0芯片不能证明同一块板。3.3V I2S功能映射可继续，实际针序以实物为准。
- MAX98357模块的A/B版本、SD_MODE/GAIN及上电静音配置。功放VIN走独立5V线，喇叭接BTL的SPK+/SPK−，任何一端都不接地。
- 后置EC11与独立键拆下后的公共端和无源触点针序。A/B/两键各10k上拉3.3V，不将原屏控件焊盘自动并入新接口。
- DFR0753实际焊盘、充电电流/反向漏电、定制电池保护与均衡参数，以及外部保险座安装、支路插座、线径和温升。目标舵机5V/6A必须结合低电量与堵转情况验证。

来源索引见 [sources/README.md](sources/README.md)。厂家资料证明规格和原理连接，不能代替本机负载测试。

## 结构与后续发布

3D工作暂停。主任务原生布局已将天线端设为u=14.17mm，采用U形槽u=0…24.17、v=9.5…22.5mm；实际PCB记录优先。`board-interface.*`保留80×32×1.6mm、四孔Ø3.2的A1候选，坐标变换X=u−40、Y=v−2、Z=w+64，四孔中心(5,5)、(75,5)、(75,27)、(5,27)。其放置只是空间候选，不能据此声称原生21元件PCB的连接器、天线、USB维护空间、线束弯折与高度都已经校验。实际板框、元件位置及DRC以主任务正在维护的原生工程为准。

外部高电流供电及MINI PCB保险座仍需有额定且可靠的安装方式。完成原生ERC、PCB布线/DRC、供电承载和装配核验后再发布Gerber、钻孔、BOM与装配图。本包的检查不代替这些制造检查。

`python3 build-review.py`可重生成本包JSON/CSV/SVG和数据检查，已同步本次证据，不会恢复旧的屏幕电压/BLK未知项。PNG需由对应SVG重新渲染。该脚本不会操作EDA。
