xaiojie/papabot/hardware-selection/procurement/2026-09-12/README.md

# 采购清单 · 2026-09-12（对应 Integrated V1.2 无旋钮版）

> 依据：`pcb-design/integrated-v1/final-no-encoder-2026-09-12/`
> 设计规格：**79 器件 / 36 种物料 / 310 引脚 / 59 网络 / 110×75mm 双层板 / 原生 DRC 严格通过**
> 屏幕：**汉昇 HS24S010B（立创 C5329587）** —— 不带旋钮和按钮

---

## 📁 文件说明

| 文件 | 用途 |
|---|---|
| **`立创商城-一键下单.csv`** | ⭐ **直接导入立创商城 BOM 工具**，只有「立创编号 + 数量」两列 |
| `立创商城-明细核对.csv` | 带型号/值/封装/位号，人工核对用 |
| `立创商城-逐位号.csv` | 按位号展开（79 行），贴片/焊接对照用 |
| **`淘宝-采购清单.md`** | 淘宝部分，含商品链接、价格、以及 V1.2 新增件 |

---

## 🛒 两个渠道怎么分

### 立创商城（一键下单）

| 内容 | 数量 | 文件 |
|---|---|---|
| **板载物料** | **36 种 / 79 器件** | `立创商城-一键下单.csv` |
| **屏幕 HS24S010B** | 1 | 搜 `C5329587`（没在板上，单独加）|
| **配套插头/跳帽/保险丝插片** | 见淘宝清单第二节 | 搜型号 |

**下单步骤：**
1. 立创商城 → **BOM 配单** → 上传 `立创商城-一键下单.csv`
2. 系统自动匹配 36 种物料
3. **手动加**：屏幕 `C5329587`、配套插头、跳帽、保险丝插片
4. 核对数量后下单

### 淘宝

| 分类 | 项数 | 金额 |
|---|---|---|
| 板外功能模块（舵机/麦克风/功放/两路降压/充电头）| 6 | ¥226.1 |
| 线材与连接 | 5 | ¥32.14 |
| 紧固件与结构 | 8 | ¥31.01 |
| **V1.2 新增**（总开关/NTC/喇叭/保险丝/跳帽）| 6 | 待核算 |
| 电池 | 1 | 待定 |

**详细链接见 `淘宝-采购清单.md`**

---

## ✂️ 相比旧 BOM 砍掉的 7 项

集成板做进板子了，淘宝件作废：

```
旧屏 TOUGLESY＋EC11    ¥32.4    → 换成 HS24S010B
PCA9685 成品模块        ¥8.9     → 板载 U7
采样电阻电容            ¥8.72    → 板载 R10/R19/R21/R24
PCA9685 OE 上拉         ¥2.54    → 板载 R13/R14/R15
2S Type-C 充电模块      ¥14.13   → 板载 IP2326
旧屏旋钮 EC11           —        → V1.2 彻底移除
旧屏按键 KEY0           —        → 不需要
                       ───────
                        约 ¥66.7
```

**V1.2 全板没有任何旋钮或按钮** ✓ —— 输入交互完全由软件方案处理。

---

## 🔴 下单前必须先决定的两件事

### ① 电池要不要保护板

集成板**自带**过充/过放保护（HY2120-CB）+ 均衡（HY2213-BB3A ×2）。

| 方案 | 买什么 |
|---|---|
| **A** | 带保护板的成品包 → ⚠️ 与板上**重复** |
| **B** ✅ | **裸 2S1P 电芯包**（无保护板）→ 完全用板上保护，**推荐** |

**还要注意接口**：主板 JBAT 是 **XT30**，格氏那块是 **T 插**，需要转接。

### ② 外壳怎么办

新板是 **110×75mm**，原 80×32mm 载板的结构**不兼容**。
`mechanical-design/structure-a3/` 还没适配新板 + 新屏。

**可以先打样焊板调试，外壳后面再设计。**

---

## ⚠️ 三个跳线默认断开

| 跳线 | 断开时 | 何时接 |
|---|---|---|
| **JP_CHG** | EN 下拉，**禁止充电** | 电池/电流/NTC 台架核验后 |
| **JP_MCU** | +5V_LOGIC 与 MCU_5V 隔离 | 外部逻辑 5V 供电时；**USB 调试保持断开** |
| **JP_LCD** | 开发板 +3V3 与 LCD_3V3 隔离 | 用开发板 3.3V 供屏时接通 |

**屏幕供电只能选一个来源，J10 和开发板稳压输出不能并联。**

---

## 📌 数据来源

全部取自 `pcb-design/integrated-v1/final-no-encoder-2026-09-12/`：

| 文件 | 用途 |
|---|---|
| `采购BOM_合并同料.csv` | 36 种物料（本清单的立创部分）|
| `板载BOM_79器件.csv` | 79 个器件逐个明细 |
| `装配与接线说明.md` | 板外物料、屏幕线束、跳线 |
| `接口引脚表.csv` | 310 引脚逐针连接 |
| `PCB_DRC_final.json` | DRC 结果 |

**注意**：本轮 BOM **价格和库存未刷新** —— 立创下单时会显示实时价格。

---

## 🆕 配套件已全部找到并并进 BOM（2026-09-12 追加）

### 立创商城：新增 6 项

| 立创编号 | 型号 | 规格 | 数量 | 用途 |
|---|---|---|---|---|
| **C5329587** | HS24S010B | 2.4" IPS ST7789 320×240 3.3V | 1 | **屏幕** |
| **C5360462** | WAFER-XH2.54-10PJK | XH2.54 胶壳 10P | 1 | J3 屏幕线束 |
| **C5360454** | WAFER-XH2.54-2PJK | XH2.54 胶壳 2P | 2 | J7 / J10 |
| **C5360455** | WAFER-XH2.54-3PJK | XH2.54 胶壳 3P | 1 | JBAL |
| **C5360463** | WAFER-XH2.54-DZ | XH2.54 压线端子 | 30 | 配上面所有胶壳（含备用）|
| **C100114** | 2.54短路帽闭口 | 2.54mm 跳线帽 | 5 | JP_CHG / JP_LCD / JP_MCU + 备用 |

**`立创商城-一键下单.csv` 现在是 42 行（36 板载 + 6 配套）** —— 直接导入即可。

### ⚠️ 还有 2 样是「立创 MRO 工业品」，不走元件库

立创的元件 BOM 工具**导不进 MRO 商品**，要单独加购：

| 物品 | 链接 | 说明 |
|---|---|---|
| **XT30 母头**（配板上 JBAT 的公头 C431092）| [XT30(2+2)-F.G.B 三件套](https://item.szlcsc.com/mro/20526039.html) | AMASS 艾迈斯，母头焊线 |
| **小号插片保险丝 7.5A** | [汽车保险丝分类](https://list.szlcsc.com/catalog/907.html) | 板上 F1 = `01530008Z` 是 **Mini Blade（小号）** 座，15A/32V 规格，**要配 7.5A 小号插片** |

> 📌 **保险丝座已确认**：`01530008Z` = Littelfuse 座，**Mini Blade / ATM / APM 小号插片**，不是中号（ATO）也不是大号（MAX）。
> 设计要求的额定值是 **7.5A**（见 `原理图设计.md`：`VBAT_PROT+ → F1（7.5A）→ S1A 总开关 15A`）。

### ✏️ 一处修正

之前淘宝清单里写的「**KF301 5.0mm 2P 插头 ×5**」是我搞错了 ——
**KF301 是螺钉式端子，导线直接拧进去，不需要配对插头** ✓ 已从清单移除。

---

## 🔧 修正：两个「匹配不到」的编码（2026-09-12 追加）

立创 BOM 工具导入后，这两个显示 **❌ 暂无匹配结果**：

| 原编码 | 型号 | 位号 |
|---|---|---|
| `C9900021383` | 长排针,2.54mm,6p | J4 J5 |
| `C9900216560` | Type-C-16P | J6 |

### 原因

**`C9900…` 开头是嘉立创EDA 的「内部/客供料」编号，不是立创商城的商品编号** ——
BOM 工具当然匹配不到。

### 换成真实商品编码（封装已核对）

| 原编码 | 新编码 | 型号 | 品牌 | 封装核对 |
|---|---|---|---|---|
| `C9900021383` | **`C37208`** | 2.54-1x6P直针 | BOOMELE(博穆精密) | 原封装 `HDR-TH_6P-P2.54-V-M-A` ✅ 一致 |
| `C9900216560` | **`C2848974`** | GT-USB-7010E | G-Switch(品赞) | 原封装 `USB-C-SMD_GT-USB-7010E` ✅ **型号就在封装名里** |

> 💡 **J6 的线索是封装名**：`USB-C-SMD_GT-USB-7010E` 里的 `GT-USB-7010E`
> 就是具体型号，直接搜它就能找到封装完全一致的物料 —— 不会买错。

### 现在

**`立创商城-一键下单.csv` = 42 行，全部有真实立创编码，无 C9900 残留。**

---

## 🔄 J6 USB-C 母座换型（2026-09-12 追加）

### 问题：GT-USB-7010E 没货了

```
C2848974   GT-USB-7010E   stockNumber: 0   ❌ 确实没货
```

### 先确认板子到底要什么封装

从 `PCB1_geometry.json` 里把 J6 的 16 个焊盘坐标全扒出来量了：

```
12 个信号脚（贴片）
  间距序列 31.5 / 25.6 / 19.7 / 19.7 / 19.7 / 19.7 / 19.6 / 19.7 / 19.7 / 25.6 / 31.5 mil
  → 常规间距 19.7 mil = 0.50 mm    ← USB-C 标准脚距
  → 跨度 252 mil = 6.40 mm

4 个固定脚（多层）
  x 跨度 340.2 mil = 8.64 mm       ← USB-C 外壳标准宽度
  y 跨度 164.5 mil = 4.18 mm
```

**结论：这是【通用 USB-C 16P 卧贴】封装，不是某家专有。**
（两端间距大是因为 A1/B12、A4/B9 是双针合并焊盘 —— 16P USB-C 的标准做法）

### 有货的替代（都核对过「16P SMD 卧贴」）

| 编码 | 型号 | 品牌 | 库存 | 采用 |
|---|---|---|---|---|
| ~~C2848974~~ | ~~GT-USB-7010E~~ | G-Switch(品赞) | **0** | ❌ 没货 |
| **C165948** | **TYPE-C-31-M-12** | **韩国韩荣** | **233,087** | ✅ **已换用** |
| C2997435 | HC-TYPE-C-16P-01A-G | HCTL(华灿天禄) | 655 | 备选 |

**已把 BOM 里的 J6 换成 `C165948`。**

> ✅ **为什么选它**：23 万库存、韩荣品牌、国内最通用的 USB-C 16P 卧贴
> —— 大量国产开发板都用它，封装就是事实标准。
>
> ⚠️ **建议在 EDA 里再确认一眼**：右键 J6 → 更换器件 → 搜 `C165948`
> → 看封装预览的焊盘位置是否与原来重合。如果重合就直接用。

### 备选（如果 C165948 也不合适）

```
型号   HC-TYPE-C-16P-01A-G
编码   C2997435
品牌   HCTL(华灿天禄)
库存   655
链接   https://item.szlcsc.com/3468398.html
```

---

## 🔄 U7 PCA9685 换型（2026-09-12 追加）

### 这个「海外代购」是什么

```
C2688894   PCA9685PW,112   TSSOP-28   U7   NXP(恩智浦)
供货方式：RS Components 代购（海外）
库存：0
```

**它不是「模块」，是裸芯片。**

**PCA9685 是什么：**
- NXP 的 **16 路 12 位 PWM 驱动 IC**，I²C 接口
- 淘宝上卖 ¥8–15 的「**16 路舵机驱动板**」= 这颗芯片 + 外围元件做成的模块
- 集成板把它**直接做在板上**（U7），所以**不需要买模块**，只要裸芯片

> ⚠️ 你原来 BOM 里的 `E04 16路PWM舵机信号模块 ¥8.9` 就是它的模块版 ——
> 集成板已经把这部分做进 PCB 了，**那个模块不用买了** ✓

### 换型：同芯片，只是包装不同

| 编码 | 型号 | 库存 | 说明 |
|---|---|---|---|
| ~~C2688894~~ | ~~PCA9685PW,112~~ | **0** | ❌ 管装，海外代购 |
| **C2678753** | **PCA9685PW,118** | **455** | ✅ **编带，已换用** |
| C92206 | PCA9685PW/Q900,118 | 1422 | 车规版，备选 |

```
,112 = 管装 (tube)
,118 = 编带 (tape & reel)      ← 都是 NXP 同一颗芯片
                                   封装都是 TSSOP-28，完全一样
```

**已把 BOM 里的 U7 换成 `C2678753`。**

> 💡 **立创直接有货，不用去淘宝。** 而且比淘宝靠谱（原装 NXP，不是散新）。

### 如果还想在淘宝找备选

搜索词（淘宝搜索页要登录，我抓不到直链）：

```
PCA9685PW 贴片 TSSOP-28 原装
PCA9685PW,118
PCA9685 芯片 16路
```

**注意**：淘宝上的多是**散新/翻新**，或直接卖模块。
**要买模块版**搜：`PCA9685 16路舵机驱动板`（约 ¥8–15）

---

## 📋 三次换型汇总

| 位号 | 原编码 | 原型号 | 问题 | 换成 |
|---|---|---|---|---|
| J4 J5 | `C9900021383` | 长排针 6P | EDA 内部编码，匹配不到 | **C37208** |
| J6 | `C9900216560` | Type-C-16P | EDA 内部编码，匹配不到 | **C165948** |
| J6 | `C165948`→原 `C2848974` | GT-USB-7010E | 库存 0 | 同上 |
| **U7** | `C2688894` | PCA9685PW,112 | **库存 0（海外代购）** | **C2678753** |

**现在 42 项全部有货、全部是真实立创编码。**

---

## 🔄 第二轮换型：C86816 电容 + C28319 电阻（2026-09-12）

### ① C86816 22µF 电容 → **立创有货替代，不用淘宝**

```
C86816   村田 GRM21BR61E226ME44L      （用户反馈无货）
C602037  三星 CL21A226MAYNNNE         库存 342,318  ✅ 已换用
```

**等价性核对：**

| | 村田原选 | 三星替代 |
|---|---|---|
| 封装 | 0805 | 0805 ✅ |
| 容值 | 22 µF | 22 µF ✅ |
| 精度 | ±20% | ±20% ✅ |
| 耐压 | 25V | 25V ✅ |
| **介质** | **X5R** | **X5R** ✅ |

**完全等价，而且三星库存 34 万，不可能缺货。**

### ② C28319 500mΩ 电阻 → **立创确实没有，淘宝买**

```
C28319     厚声 0805W8F500LT5E          库存 0     ❌
C4013772   Stackpole RMCF0805FTR500     库存 0     ❌
C2083351   Vishay RCWE0805R500FKEA      库存 2     ⚠️ 仅剩 2 个
```

**淘宝已找到同款**：[0805W8F500LT5E 厚声 500mΩ ±1% 125mW](https://item.taobao.com/item.htm?id=1041899561942&skuId=6226693982787)
—— 型号、品牌、精度、功率全对 ✅

> ⚠️ **R6 是 IP2326 充电电流采样电阻**，**必须 ±1%**，不能用 ±5% 普通电阻。

**已从立创清单移除，转到淘宝清单「二·五」节。**

---

## 📋 换型总账（四轮）

| 位号 | 原编码 | 问题 | 换成 |
|---|---|---|---|
| J4 J5 | `C9900021383` | EDA 内部编码 | **C37208** |
| J6 | `C9900216560` | EDA 内部编码 | **C165948** |
| J6 | `C2848974` | 库存 0 | 同上 |
| U7 | `C2688894` | 库存 0 海外代购 | **C2678753** |
| C11 C12 | `C86816` | 库存 0 | **C602037** |
| **R6** | `C28319` | **库存 0，无替代** | **→ 淘宝买** |

**立创清单现在 41 种（板载 35 + 板外 6），全部有货。**
