xaiojie/papabot/pcb-design/integrated-v1/final-2026-09-12/README.md

# DesktopAssistant Integrated · PCB 设计交付

2026-09-12 · 当前工程 `DesktopAssistant_Integrated` · 嘉立创EDA专业版 3.2.149.88089769。

**五页原理图已修复并通过检查；关联 PCB 已完成板框、布局、布线、双面接地铜皮和丝印，原生 PCB DRC 严格通过。可编辑工程、原理图 PDF、BOM 和 Gerber 审阅包已导出并复核。** 本目录是本次设计的有效交付入口，优先于上级目录中的早期选品、单页原理图、导入稿及布局草案。

## 文件入口

| 文件 | 用途 |
|---|---|
| [DesktopAssistant_Integrated_final.epro2](DesktopAssistant_Integrated_final.epro2) | 完整可编辑工程，包含五张有效原理图页、关联 PCB 和工程器件库 |
| [Integrated_schematic_final.pdf](Integrated_schematic_final.pdf) | 五页 A3 原理图，已逐页检查渲染 |
| [DesktopAssistant_Integrated_Gerber_review.zip](DesktopAssistant_Integrated_Gerber_review.zip) | 原生 Gerber、钻孔、槽孔和飞针网络数据，供制造审阅 |
| [PCB_Gerber_Top.png](PCB_Gerber_Top.png) / [PCB_Gerber_Bottom.png](PCB_Gerber_Bottom.png) | 从实际 Gerber 绘制的正反面审阅图；背面是翻面后的视角，颜色仅为展示 |
| [板载BOM_83器件.csv](板载BOM_83器件.csv) / [采购BOM_合并同料.csv](采购BOM_合并同料.csv) | 83 个板载器件，合并后 37 种物料；本轮未刷新价格、库存 |
| [引脚网络表_323引脚.csv](引脚网络表_323引脚.csv) / [接口引脚表.csv](接口引脚表.csv) | 当前原生网表导出的连接资料 |
| [器件坐标_结构参考.csv](器件坐标_结构参考.csv) | 毫米坐标，原点为板左上角，X 向右、Y 向下；供结构参考，不作为未经检查的贴片机文件 |
| [装配与接线说明.md](装配与接线说明.md) | 外置模块、屏幕线束、三处跳线和后续实物验证 |
| [PCB_DRC_final.json](PCB_DRC_final.json) / [Schematic_verification.json](Schematic_verification.json) | 本次最终原生检查结果 |
| [Native_archive_verification.json](Native_archive_verification.json) / [Gerber_verification.json](Gerber_verification.json) | 原生归档、逐引脚与实际制造文件核验 |

## 本次原理图修复

原单页拆成五张功能分区明确的原生图页，元件、标题、说明和网络标签统一对齐。当前顺序为：

1. `01_电池保护与均衡`：HY2120-CB、背靠背 MOS 和两节 HY2213-BB3A 均衡。
2. `02_USB充电`：USB-C 5V 输入、IP2326 2S 升压充电、NTC、使能及状态指示。
3. `03_配电与主控`：保险丝、外置总开关、两路降压接口、ESP32-S3 插座和电池采样。
4. `04_显示音频与交互`：独立 3.3V 屏幕支路、I²S 接口和单独的 EC11。
5. `05_八路舵机驱动`：PCA9685、OE 默认禁止输出、八路统一引脚定义的舵机接口。

除布局外，修复了保护 MOS 源漏/栅极连接、检测滤波、均衡器型号与驱动脚、充电 VSYS/VOUT 分离、供电隔离和部分错误的器件/封装。具体电路修复过程保留在 [阶段记录](../repair-2026-09-12/修复与检查记录.md)。

**新屏幕为 HS24S010B / C5329587，本身不带旋钮或按钮。** 主板 J3 使用真实的 XH-10A / C2908608 连接器，通过线束连接屏幕；已移除把整块 LCD 模组当作主板器件的旧封装。EC1 是单独的 EC1106S 编码器，位于主板右下方。没有额外的旧屏 KEY0 按钮。

## PCB 实际规格与布局

| 项目 | 当前设计 |
|---|---|
| 板框 | 闭合矩形，110 × 75 mm |
| 层叠 | 2 层 FR-4，标称成品厚度 1.6 mm，上下铜层各约 70 µm / 2oz |
| 安装孔 | 4 个 Ø3.2 mm 非金属化孔，坐标 (4,4)、(106,4)、(4,71)、(106,71) mm |
| 螺钉净空 | 上下铜层均预留半径 2.8 mm 的螺钉头禁布区 |
| MCU 插座 | J2 左列、J1 右列，20 针直插座，列距 17.78 mm；1 脚在上，20 脚在下 |
| 天线净空 | 两面 x=56.5–71.3、y=0–10 mm 区域禁布铜；这是铜净空，不是板框缺口 |
| 充电区 | 左下角；USB-C 朝下板边，IP2326 与电感、输入输出电容紧邻 |
| 电池/保护/均衡 | 左上区域；原始电池负极与保护后系统 GND 分开 |
| 屏幕接口 | 右上 J3，屏幕在前面板独立安装 |
| 舵机区 | 右侧 PCA9685 与八个 3P 接口；大电流主干使用两面并联走线 |
| EC11 | 右下角 EC1，独立于屏幕 |
| 丝印 | 83 个位号已统一，另有版本、Jay、电池极性、舵机方向和三处 OPEN 标记 |

关键电源先手动布线，再完成其余网络。电池正极主干约 2.5 mm，MOS 共漏极采用多条扇出与 3.5 mm 主干；舵机 5V 主干两面各 2.5 mm，地回路有并联走线及接地铜皮。普通信号线约 0.254 mm，QFN 逃线使用局部细线后加宽。全板有 899 段原生走线、88 个过孔，其中 46 个为新增 GND 缝合过孔。

原生三维视图已经成功渲染并检查可见器件位置；没有嵌入外置 LCD、完整 ESP32 开发板或外壳总装。最终归档内的 [原生二维预览](PCB_native_preview.webp) 已提取保存。结束阶段电脑锁屏，因此未能额外保存原生三维截图。

## 检查结果

| 检查 | 结果 |
|---|---|
| 原理图原生 DRC | 错误结果为空，严格返回 true |
| PCB 原生 DRC | 错误结果为空，严格返回 true，保存返回 true |
| 器件 / 引脚 / 网络 | 83 / 323 / 62 |
| 有意不连接的 NC 引脚 | 45；单引脚孤立网络 0 |
| 审阅连接表 → 原生原理图 → PCB | 323 个引脚逐一一致 |
| 电气关系独立核对 | 保护、充电、隔离、舵机等 15 项全部通过 |
| 归档完整性 | epro2 和 Gerber ZIP 的 CRC 通过 |
| 保存状态与 epro2 | 器件、焊盘网络、走线、过孔、填充、丝印、规则和层叠一致；仅归档省略了一个无自定义内容的默认规则选择器 |
| Gerber 走线 | 顶层 696 段、底层 203 段，与当前 PCB 一一一致 |
| Gerber 铜皮 | 10 个接地填充区域均完整导出，几何核验没有缺失面积 |
| 钻孔/槽孔 | 207 个金属化圆孔（含 88 个过孔）、4 个 USB-C 金属化槽孔、9 个非金属化孔；与原生封装/板孔一致 |
| 锡膏/阻焊 | 200 个贴片焊盘均有锡膏开口，所有元件焊盘均有对应阻焊开口 |
| 飞针数据 | 网络与原理图一致；45 个 NC 引脚保留为相互独立的网络 |
| 封装外形审查 | 对工程中可读取的 61 条本体外形检查，未发现交叠；不等同于完整三维装配验证 |

部分元件的焊盘锡膏扩展为 -100 mm，是库中使用独立锡膏图形的表示方式。已依据最终 GTP 验证 200 个贴片焊盘的开口，没有直接依据 API 数值误改封装。USB-C 的四个长孔实际导出为 G85 槽孔。

重新布线时有四个网络的局部线形发生变化，已保存 [转角对比图](Critical_corner_review.png)：BST_CAP、GND 和 VBAT_FUSED 为转角整理；CHG_VSYS 删除了重复的同网连接段，仍经相邻同网引脚连接。原生连通性及实际制造走线检查均通过，不声称所有手工线段形状逐点未变。

## 后续编辑注意

**本版接地铜皮为原生、可编辑的静态 Fill 多边形，不能随走线自动重算。** 当前 EDA 版本的 Pour 重建接口与界面重建均遇到故障，因此使用 10 个已检查的 GND 填充区域和 46 个缝合过孔完成当前版。最终原生 PCB 不含未生成的 Pour 占位对象。

移动器件、改变板框或修改走线后，需要从最新焊盘、线路和净空重新生成接地铜皮，再运行连通性/间距 DRC 和制造文件核验。不要直接重跑 `layout-2026-09-12/` 中的历史布线、导入或填充脚本，它们记录特定阶段状态，可能覆盖后续修改。继续编辑请打开本目录 epro2，并先保存新的备份。

Gerber 中 `Copper Areas: 0` 指自动 Pour 对象数量；当前接地铜皮以 `SolidRegion` 导出，已做实际多边形覆盖核验。单独的 Via 钻孔文件是完整 PTH 文件的子集，不是额外需要重复钻的孔。

## 尚未验证的实物事项

设计文件和检查已完成，尚未进行本版打样下单、付款、焊接、实物充放电、温升、满负载舵机测试或结构试装。当前 110×75 mm 主板与原 80×32 mm 载板的固定结构不同；新屏幕、EC11、外接模块、线束和插头空间需要纳入整机结构。

IP2326 的 R8=255kΩ 对应约 0.353A，是公式计算值，低于手册典型 0.5A 示例范围，须在连接实际电池前验证恒流、截止、超时与 NTC 动作。2S 保护/均衡阈值、MOS 温升、舵机启动压降及电源模块输出也须逐项验证。没有以 DRC 通过宣称整机已可安全运行或持续承载 8A。

本轮原理图修订号为 1.1，PCB 丝印版本为 Integrated V1.0，二者在本交付包中逐引脚一致。文件 SHA-256 列表见 `SHA256SUMS.txt`。
