xaiojie/papabot/design-coordination/history/before-a3/design-coordination/README.md

# PCB与整机结构协调记录

2026-09-08：用户已恢复结构设计并要求专心后台建模。当前机械入口为[structure-a2](../../../../mechanical-design/structure-a2/README.md)，32个独立STL及Blender整机/爆炸/零件总览场景已生成；原V1和A1文件保留。PCB入口为[原生检查版](../../../../pcb-design/native-rev-a/README.md)，本轮机械任务不修改电气设计。

## 当前接口

- 坐标单位mm；X左右、Y前后（前为负）、Z向上。机身外宽124、高76；前盖外Y−26.2，主壳后Y68，后面板外Y70.6。
- PCB按native-rev-a中原80×32mm含天线U形开口的精确板框、4个Ø3.2孔生成参照。孔中心(5,5)、(75,5)、(75,27)、(5,27)。整机变换`X=u−40; Y=v−2; Z=w+66`，w=0为板底。
- PCB紧固件选小头M2×8，头径≤4mm；R06底盘连接仍为M3×10。原PCB孔不改，避免M3大头与J9排针外壳冲突。
- 屏幕保留91×44mm完整原板，标称孔距84.5×37.5mm。EC11和独立按键按用户确认后置，后续拆焊接线；玻璃约0.8mm内缩及60×43开窗需实物复核。
- 底盘4.6mm厚，Z30～34.6；电池目标75×40×20mm，放置Z35.6～55.6。R06横梁下方距目标电池3mm、距1mm上束带2mm。电池最终尺寸、≤80g重量和出线待商家确认。
- 每腿两个MG90S 180°，共8个；用原装舵盘和中心螺丝，打印件不含花键。耳孔为可调槽；同批舵机与舵盘未实测。
- R03集成后置控件、S1A、充电口、喇叭套和功放座；R09/R10充电板固定可单独调整。R14为可换麦克风托架，模块身份与外形仍待核。
- PCA9685、DFR0753和好盈UBEC采用开放支架加绝缘垫/扎带。DFR0753包络仅为空间预留，UBEC本体43×17×7mm不含导线和磁环。
- USB调试首轮通过拆后盖、松开右侧电源架接入主控USB；后面板Type-C为独立充电口，仍按关机充电。

## 文件与验证边界

[参数记录](../../../../mechanical-design/structure-a2/reports/assembly-parameters.json)与[接口JSON](interface-proposal.json)为当前A2数据。旧print-v2参数仍作为历史输入，不能覆盖当前坐标。

当前32件STL重读闭合检查通过，静态检查363对实体交集未发现超过0.05mm³冲突。腿部32个离散姿态的检查范围见[验证说明](../../../../mechanical-design/structure-a2/验证说明.md)。这些结果不代替切片、实物试装、连续扫掠、扭矩、步态、线束、温升或RF验证。

采购仍参考V7暂定选型；A2细化后产生的紧固件差额单列在[装配说明](../../../../mechanical-design/structure-a2/装配与打印说明.md)，没有改购物车或替用户联系商家、下单。PCB Gerber/原生工程的既有审查结果见PCB目录，最终生产资格不因结构文件导出而自动成立。
