xaiojie/papabot/pcb-design/native-rev-b/before/current-pointers-before-revb/pcb-design/native-rev-a/README.md

# DesktopAssistant RevA — 嘉立创EDA原生PCB检查版

2026-09-09屏幕资料复核：**当前RevA需要修订，旧Gerber暂停下单。** 新收到的整板原理图显示A/B/PUSH/K0各经10kΩ上拉至屏幕VCC，引脚说明指定3.3V；当前J3.2仍接5V，不能据此连接所选模块。屏幕应改按3.3V供电，具体供电源需核对最大工作电流及主控稳压余量。详见[屏幕资料核对与PCB修改要求](supplier-review-2026-09-09/屏幕资料核对与PCB修改要求.md)。此前原理图/PCB严格DRC、25个网络和Gerber板框/钻孔检查通过描述的是既有设计；本次未修改原生工程或Gerber。3D仍为A3标称试装模型，控件留原板。

## 打开工程

- 在线工程：<https://pro.lceda.cn/editor?cll=warn#id=e5e438419c1c4681946d5009bb8d6daf>
- PCB：`Board1 / PCB1`，文档 ID `641e84beea5fc9c6`。
- 原理图：`Board1 / Schematic1 / P1`，图页 ID `834bc1f5a1044766`。
- 离线备份：`DesktopAssistant_RevA_PCB_review.epro2`，可在嘉立创EDA专业版导入。
- `Schematic1_1` 为保留的早期副本，不是当前设计入口。

## 已完成的设计

| 项目 | 当前结果 |
|---|---|
| 载板 | 80×32mm，双面布线；建议工艺目标为1.6mm、1oz，尚未下单 |
| 原理图 | 22个实体元件，包含板外C2 |
| PCB | 21个实体元件、98个元件焊盘、4个Ø3.2mm非金属化安装孔 |
| 网络 | 25个网络全部连通，86个已接网络焊盘；12个焊盘按设计空置 |
| 实际原生布线 | 738个铜线段、24个过孔 |
| 板框对象 | 板框层1个闭合POLY；原生一键导出已识别尺寸并进入保存窗口 |
| 线宽 | 信号12mil；3.3V 24mil；5V及GND 40mil；电池采样前段32mil |
| 过孔 | 已从工程源文件核实0.6mm外径/0.3mm钻孔；两处GND换层增加了并联过孔 |
| 主控插座 | 两排20P，2.54mm针距、17.78mm排距；两排1脚均朝天线 |
| 天线 | 板左侧24.17×13mm的U形避空；须以实际主控及射频测试复核 |
| 旋钮/按键接口 | J7输入上拉至主控3.3V；已确认模块也上拉到其VCC，因此屏幕5V接法必须修订，控件继续留原板 |
| 电源边界 | 载板只处理逻辑供电与信号，8个舵机及功放功率支路走板外配线 |

C2（470µF/16V）放在板外UBEC/功放供电分支，避免电解电容高度占用主控下方空间。JP1、JP2初始保持断开。主控USB VBUS与5V排针直连，本版没有自动防倒灌切换；首次烧录时应把主控拔下单独连接USB。

## 检查结果及边界

1. 原理图导出网表与接口定义核对：98个焊盘逐一匹配，没有网络名错误。
2. 原理图与PCB的21个板上元件唯一ID一致；12个NC焊盘保持空置。
3. 从原生EDA重新读取全部焊盘、铜线、过孔和板框，使用连续几何而非网格近似验证：25/25网络连通；所有铜线和过孔均接入焊盘，没有孤立铜。没有发现异网短接、线宽、铜到板边或螺钉头避铜违规。
4. 实际最小异网铜间距为8.009mil；铜到板/槽边最小13.016mil；铜相对半径2.5mm螺钉头的最小额外余量为4.331mil（约0.110mm）。数值基于当前精确原生坐标，不含制造公差。
5. 导入时EDA自动合并/拆分同网线段，过孔查询API按整数mil返回外径/孔径，但已从保存的原生工程确认仍为0.6/0.3mm。因此API返回数据与候选的字面比较并不完全一致；逐网铜轮廓最大偏差仅0.070711mil（约0.0018mm），修改后的真实几何已另行通过验证。详见 `routing-import-check.json`。
6. **原生PCB严格DRC为true，界面全部(0)。** 初始37条连接性提示及1条网表不一致，在应用原理图属性同步后消失，保存重开后仍通过。修复前后全部铜线、过孔、焊盘及网络映射一致；设计规则也逐项一致，没有放宽规则或屏蔽报错。原生内部为何产生旧连接性结果尚无接口证据，不将其归因于已证明的物理断线。
7. **原理图原生严格检查为true，0致命错误、0错误、0警告。** J1/J2按C429947官方目录补齐属性，器件名恢复为制造商型号，图面仍用Value显示MCU_LEFT_20P/MCU_RIGHT_20P。保存重开后通过；两条信息仅为检查开始/完成日志。本版以模块连接器为边界，检查通过不代替模块内部电路及整机负载实测。
8. Gerber ZIP完整性通过，包含上下铜层、上下阻焊、上下丝印、板框和钻孔；板框80×32mm、U形开口、4个Ø3.2mm非金属孔及122个金属孔（98元件孔+24过孔）已与工程核对。独立过孔钻孔文件是金属孔文件中24孔的重复子集，勿另行叠加加工。详见`gerber-export-check.json`。
9. 已修复原生“一键导出”提示没有板框层线条的问题：原8段独立LINE虽进入API导出的Gerber，却未被原生尺寸检查识别。现用同一路径的1个闭合POLY替代。原生导出显示估算79.985×31.979mm，实际Gerber仍为80×32mm；点击导出并执行DRC后正常进入系统保存窗口，不再出现缺板框警告。铜线、元件、过孔、焊盘与规则均未改动。详见`outline-recognition-check.json`。

打样前重点确认模块原板控件电平、主控排针方向和插座高度，并核对天线避空及开口铣刀内角。A3已完成标称CAD配合检查，实物配合仍未验收。完整接线和首次上电步骤见 `装配与上电核对.md`；当前下单结论以 `supplier-review-2026-09-09/屏幕资料核对与PCB修改要求.md` 为准。

## 交付文件

- `DesktopAssistant_RevA_PCB_review.epro2`：本次最新原生工程备份。
- `DesktopAssistant_RevA_Gerber_review.zip`：原生导出的Gerber与钻孔检查文件，尚未下单。
- `previews/641e84beea5fc9c6.webp`：从原生工程导出的PCB实际预览。
- `previews/834bc1f5a1044766.webp`：从原生工程导出的原理图实际预览。
- `载板接口与引脚.csv`：全部元件焊盘的针号、信号及位置。
- `载板装配清单.csv`：21个板上元件加板外C2；是装配清单，不是重新下单建议。
- `装配与上电核对.md`：模块接线、电源分支、跳线及调试顺序。
- `DesktopAssistant_Carrier_RevA.enet`：原理图制造网表，不包含板外C2。
- `native-routing-validation.json`：实际原生PCB的独立几何与连通性检查。
- `native-pcb-drc.json`：原生严格DRC返回值。
- `native-schematic-drc.json`：原理图原生严格检查与界面计数。
- `drc-resolution.json`：本次同步与检查结果记录。
- `gerber-export-check.json`：Gerber板框、钻孔与源工程核对。
- `outline-recognition-check.json`：原生一键导出板框识别修复与复验记录。
- `netlist-check.json`、`pcb-netlist-check.json`：接口/网表核对结果。
- `routing-import-check.json`：导入前后差异及真实几何验收结果。
- `delivery-manifest.json`：工程备份校验值与当前交付状态。

`router/`中保存离线候选和对应验证。实际原生布线以保存的`.epro2`和`pcb-persisted-geometry.json`为准；`pcb-routed-readback.json`保留API原始返回值。`audit/`保留原生API操作记录。`build_schematic.py`为过时的初始建图脚本，不得在当前工程上直接重跑；其他早期`.epro2`仅为历史备份。
