xaiojie/papabot/design-v6-compact-centered/design-notes.md

# V6：紧凑比例，屏幕居中

日期：2026-09-07。

用户认可小耳饰，希望继续压缩机身横向长度，暂不考虑刻字和 Logo；指出整板 91 mm、屏幕标注 59 mm，希望屏幕居中并减少板两侧余量。本轮保留耳饰，清空两侧装饰，按这两个商品标称尺寸重新研究比例。

## 文件

- [本轮效果图](desktop-pet-compact-centered-v6.png)
- [主要提示词](imagegen-prompt.txt)与[示意图修正提示词](imagegen-final-prompt.txt)：内置 imagegen 参考图编辑。
- [商品规格图](../mechanical-design/assembly-v1/reference/selected-display-module-spec.png)

## 结果与限制

本轮先以约 **118 mm 的机身外宽**表现紧凑居中方案，相比上轮 130 mm 的预估减少 12 mm。它是基于位置假设的外观目标，**不是已经确认的最小宽度、加工尺寸或保证兼容的结果**。不含腿；高度、深度、耳饰与整机占地仍待后续结构设计。

本轮将商品标注 59 mm 用作屏幕组件外形宽度的比例参考，而非确认它就是有效显示区开窗宽度。显示电子规格仍为原来的 2.4 英寸 ST7789、320×240；既有商品标注矛盾仍需实物/尺寸图澄清。

效果图保留居中的屏幕、小耳饰、奶白色可拆前盖与浅绿色四足，移除所有刻字和 Logo。旋钮与按键仍留在完整 PCB 上并由前盖遮挡，拆盖后操作。耳饰外观方向已获用户认可，固定方式还未工程验证。

## 为何不能直接用 91 + 3～5 mm 得到居中外壳

整板长 91 mm，屏幕组件标注宽 59 mm，差值 32 mm 包含左侧板边及右侧旋钮/按键区。商品图中显示区偏左，不能假定这 32 mm 均匀分配在屏幕两侧。

设屏幕组件距 PCB 左边为 a，板右边到外壳外边的余量为 r，外壳宽度为 W。保持完整 PCB 和显示区居中时：

`W = 2 × (91 - (a + 59/2) + r) = 123 - 2a + 2r`

仅知道 91 和 59 两个长度还不能唯一确定 W，需要 a 的实测值。

本轮画图使用以下**假设值**，并非从商品图读出的明确尺寸：

| 参数 | 数值 | 依据 |
| --- | --- | --- |
| 整板宽 | 91 mm | 商品标称 |
| 屏幕组件宽 | 59 mm | 商品标注，非已确认光学开窗 |
| a：屏幕组件左边到 PCB 左边 | 5.5 mm | 为研究比例而作的估计，待实测 |
| r：PCB 右边到外壳外边 | 3 mm | 暂定设计余量，包含壳壁，非已验证内部净空 |
| 推导的外壳宽 W | 118 mm | 按上述假设计算 |
| PCB 左边到外壳左边 | 24 mm | 由 118 - 91 - 3 得出 |
| 屏幕左边在外壳中的位置 | 29.5 mm | 24 + 5.5 |
| 屏幕中心 / 外壳中心 | 59 / 59 mm | 两者对齐 |

所以在本轮完整模块居中的假设下，右侧可以只留约 3 mm，**左侧的整板余量并不是 3～5 mm，而是约 24 mm**。用户提出的极小板边余量与严格居中需要进一步核实，不能宣称本图已经同时满足。

若 a 在 5～7 mm、r 为 3 mm，计算出的居中外壳宽度约为 115～119 mm；这仅是参数敏感性示例，不是测量结果。实际值可能不同。

## 后续结构依据

需要确认屏幕有效区/外形相对 PCB 左边的准确位置、原板尺寸与孔距公差、壳壁厚度、排针/插头空间，以及旋钮高度和按压行程。商品提示手工尺寸存在 0.5～1 mm 误差，不能把本轮 3 mm 直接当作经过公差验证的装配余量。

数值关系已计算复核；生成图中的模型、标线和部件轮廓仅为示意，不应从图片量取尺寸。真实 CAD 需要按实测数据重新建立约束，随后校核舵机安装、线束、重量与运动干涉。
