xaiojie/papabot/hardware-selection/power-selection-2s.md

# 电池与 Type-C 充电：2026-09-07 选型记录

2026-09-09现行方案：[ACE800成品电池＋外置保护均衡](battery-stock-2026-09-09/README.md)。下文定制1000mAh/XT30及6.4V阈值是历史记录；当前阈值与接线以新方案为准。

2026-09-08采购V7更新：淘宝购物车27项已核，含8个MG90S。电池定制线径更新为18AWG；完整可复制规格见[发给商家的文字](bom-v7/03-电池定制-发给商家.txt)。普通14.70元车内电池未核实达标，定制报价仍留空。充电头已选绿联CD104 17W双USB-A，单口固定5V/2.4A，1个27.90元；Type-C数据/充电线按用户要求本次不采购。PCB及3D打样暂缓。当前表格见[采购V7](bom-v7/README.md)。

2026-09-08最新补充：用户授权完成四类配件选型。舵机路保留DFR0753×1；逻辑路选好盈UBEC 3A(2-6S)/86010010×1（35元，5.5–26V输入，跳帽必须5V）；总开关选立创NKK S1A/C5366606×1（29.42元，官网15A/DC、30VDC）。详见[选型与接线V4](bom-v4/README.md)。S1A直接断开两路工作负载，去掉F05重复MOSFET预算；首版仍关机充电，不含额外电子自动低压断电。约6.4V负载电压停止动作并提示手动关机是待验证起点，停动作不等于断电。主控为LCKFB-ESP32S3R8N8。下文保留9月7日电池/充电来源与定制文字；当时的网页拒绝记录不表示本轮未查到新商品。

本轮选择：定制成品 **2S 7.4V 1000mAh 电池包 1 包**，配 **TELESKY MK021163 的 TYPE-C 接口 2S 8.4V 充电板 1 块**。MG90S 全金属齿轮 180 度共 **8 个**，每腿 2 个。没有下单，也没有给店家发送消息。

电池属于定制需求选择，商家尚未承诺能够按此供货，尚无报价和成品尺寸。充电板的店铺款式、截图价格和标注平面尺寸已有依据，芯片型号、默认恒流电流、实际充电终止与温升仍未核实。整套电源尚不能标记为已验证兼容或已准许装机通电。

## 给电池商家的定制文字

> 我需要 1 包成品动力锂聚合物电池，用于 8 个 MG90S 舵机和 ESP32 桌面机器人。规格为 2S1P，标称 7.4V，充满 8.4V，整包容量 1000mAh。整包需支持持续放电至少 10A，电芯、保护板、线材和插头都需要匹配。允许充电电流至少 1A，请提供推荐充电电流及最大允许值。请用匹配的同批电芯，集成每节过充、过放、过流、短路保护，以及已接好的 2S 被动均衡；采用共口保护方案，对外引出保护后的 P+/P-。成品带绝缘包膜、已焊线、XT30 配对接头，主线以 18AWG 硅胶线约 80～100mm 为定制要求，由你们按额定电流和温升核定。含保护板和包膜的主体外形希望控制在 75×40×20mm 内，重量尽量不超过 80g；这是目标，请给实际可做尺寸与重量。不要用标称普通数码电芯或低电流保护板替代。请先回复能否做 1 包、实际成品长宽厚、重量、持续放电电流、过流动作值/延迟、充电范围、均衡方式、接头极性、单价和交期，再安排生产。

容量按整包标称。两节 1000mAh 电芯串联后的电池包仍为 1000mAh。上面的 75×40×20mm 是询价包络目标，不能当作确定的电池仓尺寸；还需给出线材出口、插头和装配余量。

定制入口来自图二明盛电子的 [商品页](https://item.taobao.com/item.htm?id=966262592635)。页面上的“可定制其他尺寸和电压（此项不发）”是询价入口，不是可以直接拍下就发货的具体电池。现货 7.4V 款截图价 **14.70 元** 不适用于上述高倍率定制要求。BOM 暂预留 **80 元**，范围 60～120 元仅为预算假设；不是商家报价，也没有新的预算上限批准。

## 充电板选择

- 店铺：telesky 旗舰店，图五白色 PCB。
- 商品：[2串7.4V / 8.4V 锂电池 USB 升压充电板](https://detail.tmall.com/item.htm?id=709098048793&skuId=5148568746386)。
- 选择 **TYPE-C接口**，数量 **1**，商家编码 **MK021163**。
- 用户截图价 **14.13 元**。页面标注板体 **28×17mm**，人工测量约 0.5～1mm 误差。板厚、最高元件、孔距、孔径以及 USB 金属座相对板边的位置还没有尺寸依据。
- 页面声明输入约 **4.6～5.5V / 5V 2A**，给两节普通 4.2V 锂电池串联充电，具有涓流、恒流、恒压及充电状态指示等功能。这些是商品声明，未进行实物测试。
- **默认电池端恒流充电电流没有在这张图中明确给出。** 不能把 5V 2A 输入当成 8.4V 2A 充电输出。仅按功率守恒，10W 输入在 8.4V 时的理想电流上限为约 1.19A，实际还存在转换损耗，但这不能反推出该板实际恒流设置。
- 本项目先以 **0.4～0.5A 充电**为设计目标。可让商家确认能否提供该限流设置；若默认其他电流，必须保证实际最大值不超过电池厂家允许的充电范围。修改限流设置的服务与费用未包含在截图价中。默认电流没有确认之前不将电池与板直接连接测试。
- 图中看到 BAT+、BAT- 两个电池端焊点，不能由此声称具有每节电芯保护和均衡。因此本轮把每节保护与均衡明确要求在成品电池包内部完成。充电输出接到电池包厂家定义的保护后充电端，共口方案即 P+/P-；不能绕过保护去接裸电芯端。
- 充电头已选绿联CD104 17W双USB-A，单口5V/2.4A；USB-A转Type-C线由用户安排，本次不采购。首版按关机充电布置；八舵机供电来自电池经降压，不能依靠该充电板带动整机。已有合适充电头或线材时可在 Excel 将相应数量改成 0。

实际充电板芯片型号尚不明确。检索了 [英集芯 IP2326 原厂数据手册，立创镜像](https://datasheet.lcsc.com/datasheet/pdf/6aa3821340da5e73caf821c7fe4760e8.pdf?productCode=C5441281)：其 2S 均衡需要中点检测等连接，充电电流由外部配置决定。这是用于区分芯片功能和完整商品电路的技术依据，**并不是声称图三或图五就是该芯片或已经实现这些功能**。

## 图片里的候选结论

| 图片 | 可读到的所选规格 | 结论 |
|---|---|---|
| 1 Breeze | 当前选中 11.1V 500mAh 30C，39元；同页有7.4V850mAh30C选项 | 当前选中的3S不用于本项目；2S850mAh作为现货备选，但其价格、尺寸、保护、接头额定电流及充电上限未确认 |
| 2 对讲机电池 | 7.4V，选项53×34×10mm，14.70元，称带保护；标题另写50mm | 现货放电能力/均衡不明，不能直接认定合适；使用该页定制入口询价 |
| 3 黑色QC充电板 | 8.4V锂电池5V充2串，一件1个，7.13元 | 保留备选；尺寸、电流、均衡实施不明。另售“保护板”不是同一充电SKU，也不能替代充电板 |
| 4 扑翼机电池 | 7.4V 40mAh、20C、2.82g，58元 | 不选。按标称20C计算只有0.8A，容量与动力供应均不适合本项目 |
| 5 白色Type-C板 | 2S8.4V、TYPE-C、MK021163、28×17mm，14.13元 | 本轮选择的充电板样品款式；限流、板厚和孔位待核 |
| 6 802540 | 当前选中3.7V半成品电芯/无保护，11.80元；图示工作电流1000mA | 不选此SKU。其它2S和动力款不能继承这个单节价格或尺寸；没有证据满足10A成品包要求 |
| 7 MG90S | 黑色壳、金属输出轴、塑料舵盘与螺丝 | 外观参考已归档。整机8个、每腿2个；照片不确定孔距与花键配合 |

价格均来自本轮用户截图，不是结算价。网页访问尝试被 Computer Use 自动访问审查拒绝，未绕过限制读取商品页，未把标签页标题或链接当作已读取详情证据。

## 供电与机械布局

结构顺序：外部 5V USB 充电头 → Type-C 2S 充电板 → 保护后电池接口。电池保护后P+经保险分出充电支路，再经S1A总开关分别送DFR0753舵机5V支路及好盈86010010逻辑/音频5V支路，两支路共地、输出不并联。2S 电压不能直接送给 MG90S 或 ESP 低压输入。

持续放电 10A 是采购筛选目标。原 BOM 的舵机支路 5V/6A、逻辑支路 5V/2A 也是待实测的选型目标，尚未证明满足八舵机起身、无线和音频同时工作的峰值与温升。不能只因电池额定电流足够就认定整机电源通过验证。

电池托架位于机身内较低处，以重量和重心校核后定位；采用束带及柔软缓冲，留出包膜、线缆和装配余量。充电板、降压热源与软包电池分开，Type-C板固定到可更换后接口板，避免反复插线使焊点受力。

屏幕沿用上轮建议：保留91×44mm完整PCB，将EC11和独立按键移到后部可拆面板，使前脸只露居中显示区，玻璃内缩约0.5～1mm作为设计目标。拆焊条件、实际高度和线束尚未验证；用户尚未单独确认拆焊执行，本轮没有动硬件或修改Blender。仅去掉旋钮帽不足以确认可以平齐。原先约20.8mm深井不作为最终目标。

## 没有舵机工程图时的建模办法

商品图足够重建外观和开始可调整的装配占位。可用原厂外形作为初始参考，但当前商家没有证明与原厂同版。先参数化地建立舵机包络和可替换托架，使用随包舵盘连接打印腿件，避免凭照片直接制作输出轴花键。

最终锁孔至少补齐：本体长宽高、安装耳外廓与孔距/孔径、轴中心到边缘及轴高、舵盘厚度/孔位、线材出口。收到货后用卡尺测这几项，先打印单腿与孔距样片再发布全套。8个舵机中取2个做单腿试配，不额外增加到10个；备用件可自愿另买，但不计入当前BOM。
