xaiojie/papabot/mechanical-design/当前结构版本.md

# 当前结构版本

2026-09-14：最新为 **A5 宽体短机身 CAD 试装版**。

- [A5原生Blender模型](structure-a5/DesktopAssistant-整机结构-A5.blend)
- [A5完整模型包](structure-a5/DesktopAssistant-A5-试装模型包.zip)
- [A5装配、USB充电开孔与打印说明](structure-a5/README.md)
- [A5验收摘要](structure-a5/验收摘要.md)
- [A5整机渲染](structure-a5/renders/A5-perspective.png)
- [A5背面充电口与内凹总开关](structure-a5/renders/A5-rear.png)

机身宽124×深112×高76 mm；当前站姿整机宽162.9×深116.5×高122.46 mm，含耳朵和脚垫，不含线缆。110×75 mm主板横置，J6充电USB-C朝后盖，S1A候选总开关内凹安装；HS24S010B近齐平前窗，无EC11。Blender默认隐藏相机/灯光辅助物和关系线。

原A4、A3、ACE800改版文件、概念图及PCB/BOM均保留。独立毫米STL以本次A5包为准，腿部与主板支架不能与A4混装。

31个独立打印件、5个试配件、9张实际渲染图。模型通过静态、离散姿态、拆卸及导出复读检查，尚未做实物打印、承重、连续步态或温升测试。先以试配件核对真实屏幕、舵机和USB-C接口。
