xaiojie/papabot/pcb-design/integrated-v1/原理图设计.md

# 单板全集成 v1 · 原理图设计

> **2026-09-12 V1.2 无旋钮更新：** 五页原理图及 110×75 mm 双层 PCB 已完成，原理图/PCB 原生 DRC 严格通过。当前为 79 个器件、310 个引脚、59 个有连接网络；EC11 及三个上拉电阻、相关走线与定位孔均已移除。HS24S010B 使用单排 10PIN 屏幕接口，经主板 XH-10A 线束连接。准确工程、BOM、Gerber 与接线资料见 [V1.2 无旋钮交付](final-no-encoder-2026-09-12/README.md)。下文保留设计历史，其中旋钮、旧型号/针序、旧数量与“PCB 未完成”等描述均已被本次交付替代。

2026-09-11。板框 **110 × 75 mm**，2 层 / **2oz**。

> 本文是**原理图级设计**（网络表 + 设计要点），可直接照着在嘉立创EDA里画。

---

## 📘 官方规格书精读（2026-09-11）

**5 张官方规格书页已存档到 `datasheets/`**，以下是精读出的设计依据。

### PW7120 保护 IC（SOT23-6L，印字 `20CB 7120`）

| 脚 | 名称 | 功能 |
|---|---|---|
| 1 | **DOUT** | 放电控制输出，接放电 MOS（Q2）栅极 |
| 2 | **COUT** | 充电控制输出，接充电 MOS（Q1）栅极 |
| 3 | **VM** | 充/放电**电流检测**输入。经限流电阻（一般 1kΩ）接 Q1 源极，**检测电流在 Q1+Q2 两个 MOS 上形成的压降** |
| 4 | **VC** | 两节电池中间节点输入 |
| 5 | **VDD** | 电源输入（电池正极），**需 0.1µF 瓷片去耦** |
| 6 | **VSS** | 电源地（电池负极）|

**官方外围推荐值（原文抄录）**：

> R1 和 R2 用于稳定芯片的供电电压，**推荐分别使用 330Ω**。
> R1、R2 太大 → 导通电流导致检测电压上升，阈值偏差增大，充电器反接时 VDD-VSS 可能超极限；
> R1、R2 太小 → 反接时芯片损坏。**一般控制在 100Ω 至 470Ω 之间**。
>
> R3 太小 → 充电器反接时芯片内部流入过大电流有损坏危险；
> R3 太大 → 接高电压充电器时可能无法切断充电电流。**应控制在 1KΩ 至 4KΩ 之间**。
>
> C1 和 C2 **推荐 ≥ 0.1µF**。

**Q1/Q2 选型参考**：`PW8206A6S`（SOT23-6）、`PW4406A`（SOP8）、`PW20N03`/`PW50N03`（TO252）

**极限参数**：

| 项 | 范围 |
|---|---|
| 供电 VDD | −0.3 ~ **+12V** |
| VM / COUT 允许输入 | VDD−30 ~ VDD+0.3V |
| VC / DOUT 允许输入 | −0.3 ~ VDD+0.3V |
| 功耗 PD（TA=25°C，θJA=200°C/W）| **625 mW** |
| 焊接温度（10 秒）| 260°C |

### ⭐ 官方「保护 + 均衡」搭配电路（参考电路图 2）

这是我们要照抄的均衡方案：

```
         B+ ──┬──────────────────────────────┬── P+
              │                              │
        ┌─────┴───── 上节均衡 ─────┐         │
        │  PW2213 (SOT23-6L)       │         │
        │  620KΩ × 2（分压到两节） │         │
        │  PW2302（N-MOS 放电）    │         │
        │  0.1µF                   │         │
        └──────────────────────────┘         │
   BM ──┬────────────────────────────────────┤
        │  ┌──── 下节均衡 ────┐               │
        │  │  PW2213          │               │
        │  │  620KΩ × 2       │               │
        │  │  PW2302          │               │
        │  │  0.1µF           │               │
        │  └──────────────────┘               │
   B− ──┴──────────────────────────────────────┴── P−
```

**均衡元件清单（每节一套，共 2 套）**：
| 元件 | 值 |
|---|---|
| PW2213 | ×1 |
| 分压电阻 | **620KΩ × 2** |
| 均衡 MOS | **PW2302** ×1 |
| 电容 | 0.1µF ×1 |

> 来源：[PW7120 规格书 p3](datasheets/PW7120规格书_p3_均衡搭配与极限参数.png)

### PW4584A 充电 IC（SOP8-EP）

**引脚表**（官方）：

| 脚 | 符号 | 说明 |
|---|---|---|
| 1 | VIN | 电源输入 |
| 2 | AGND | 数字模拟地 |
| 3 | LX | 内部功率 MOS 漏极输入端，外接功率电感和二极管 |
| 4 | VBS | 外接 BOOST 升压输出端 |
| 5 | BAT | 充电输出端 |
| 6 | **ICHG** | **充电电流控制端口，外部通过电阻与地相接，可设置充电电流** |
| 7 | NTC | 热敏电阻输入端 |
| 8 | STAT | 充电状态指示端口 |
| 9 | PGND | 功率地，**需大面积良好接地和散热** |

**官方典型应用电路元件值**（规格书 p1）：

```
VIN 5V ──┬── CIN 10µF ── GND
         ├── R1 1K ── LED ── GND        （电源指示）
         └── L1 4.7µH ── LX(3)
                          │
                       D1 = SS34（肖特基）── VBS(4) ── BAT(5) ── 电池
                       
  ICHG(6) ── RICHG 1K ── GND            ← 充电电流设定
  CF1 = 1nF（VIN 附近）
  COUT = 10µF + CF2 = 1nF（BAT 附近）
  C2 = 22nF   C3 = 22nF   C4 = 1nF
  NTC(7) 接热敏电阻
  STAT(8) 充电状态指示
  AGND(2) / PGND(9) ── GND
```

**关键电气参数**：
| 项 | 值 |
|---|---|
| 输入 | 3.6–6V，过压 6V 关闭充电，**VIN 耐压 30V** |
| 输出 | 8.4V / 1A |
| **开关频率** | **500kHz** |
| 效率 | 90%（异步升压）|
| 充电电流 | **外部电阻调节 0.5A–1A** |
| 内置 | 自适应环路、输入欠压/过压、输出过压/短路保护、NTC |
| 封装 | SOP8-EP |

**⭐ 官方 PCB 布局建议（原文抄录，必须遵守）**：

1. 输入、L1、D1、VBS 引脚、BAT 引脚与 GND 组成的**功率通路，采用短而宽的布线**
2. 输入电容 **CIN、CF1 尽量靠近 PW4584A 的 VIN 引脚**；**COUT 尽量靠近 BAT 引脚**
3. **电感 L1 和肖特基 D1 应该直接相连，连接短而粗；芯片、L1、D1 三者同一层，不过孔和跳线**
4. **LX 节点（L1、D1、LX 引脚连接处）尽量短，面积尽量少**，以减少干扰和 EMI —— **这个很关键**
5. **芯片底部散热片是功率地，需与地可靠焊接，多打过孔增加散热**

**充电指示灯参考电路**：`PW2602C + LED2(红) + LED1(绿)`
- 充电中：LED2 亮，LED1 灭
- 充满：LED2 灭，LED1 亮

> 来源：[PW4584A 规格书 p1/p2](datasheets)

---

## 一、系统框图

```
                    ┌──────────── 2S 电池 7.4V ────────────┐
                    │  B+                        B−        │
                    │   │            ┌──── BM ────┐        │
                    │   │            │ (平衡中点)  │        │
                    │   ▼            ▼            ▼        │
                    │ ┌──────────────────────────────┐      │
                    │ │  2S 保护 IC + 双 N-MOS       │      │
                    │ └──────────────┬───────────────┘      │
                    └────────────────┼──────────────────────┘
                                     │ P+ / P−（受保护）
                          ┌──────────┴──────────┐
                          │                     │
                    [Type-C 5V]           [保险丝 7.5A]
                          │                     │
                  ┌───────▼────────┐      [S1A 总开关]
                  │ PW4584A 充电IC │            │ VBAT_SW
                  │ (5V→8.4V 升压) │            │
                  └───────┬────────┘      ┌─────┴─────┐
                          │               │           │
                     （充回电池）    [DFR0753]   [逻辑降压 3A]
                                      5V/8A         5V/3A
                                         │           │
                                   +5V_SERVO    +5V_LOGIC
                                         │           │
                          ┌──────────────┤           ├──────────┐
                          │              │           │          │
                   8× 舵机 VCC     PCA9685 输出    开发板      功放
                   （5V 铺铜分配）   PWM 0-7        5V针
```

---

## 二、网络命名

| 网络 | 含义 | 电压 |
|---|---|---|
| `VBAT_RAW+` / `VBAT_RAW−` | 电池原始正负极（保护**前**）| 6.0–8.4V |
| `BM` | 两节电池中间节点（平衡检测）| 3.0–4.2V |
| `VBAT_PROT+` | 保护后正极（P+）| 6.0–8.4V |
| `GND` | 保护后负极（P−）＝ 全机地 | 0V |
| `VBUS` | Type-C 输入 5V | 5V |
| `VBAT_SW` | 总开关之后 | 6.0–8.4V |
| `+5V_SERVO` | DFR0753 输出 | 5.0V / 8A |
| `+5V_LOGIC` | 逻辑降压输出 | 5.0V / 3A |
| `+3V3` | 开发板 3.3V | 3.3V |

---

## 三、分模块网络表

### 模块 1 · 电池输入与保护 ✅ 型号已定

**主芯片：HY2120-CB**（HYCON 宏康 / 平芯微 PWChip，SOT-23-6）

| 引脚 | 连到 | 说明 |
|---|---|---|
| 电池连接器 + | `VBAT_RAW+` | 接线端子 ≥10A |
| 电池连接器 − | `VBAT_RAW−` | |
| 平衡头中点 | `BM` | ⚠️ 用万用表确认，**不只看线色** |
| IC `VDD` | `VBAT_RAW+` **经 R1 330Ω** | R1 范围 100–470Ω |
| IC `VSS` | `VBAT_RAW−` | |
| IC `VC` | `BM` **经 R2 330Ω** | 中间节点检测 |
| IC `VM` | 双 MOS 中间点 **经 R3 1k–4kΩ** | 过流检测 |
| IC `COUT` → Q1 栅极 | N-MOS 1 | **充电控制** |
| IC `DOUT` → Q2 栅极 | N-MOS 2 | **放电控制** |
| C1 / C2 | 各 0.1µF，靠近 VDD / VSS | 去耦 |
| 双 N-MOS | **背靠背串在 `VBAT_RAW−` → `GND`** | 低端开关 |

**HY2120-CB 已核实的保护参数**（来源：平芯微官方文章 + 立创商城）：

| 项 | 值 |
|---|---|
| 过充检测 | **4.280V** ±25mV，延时 1.0s |
| 过充释放 | 4.080V，延时 ~16ms |
| **过放检测** | **2.900V** ±80mV，延时 128ms |
| 过放释放 | 3.000V，延时 ~1.2ms（**CB 版支持自恢复**）|
| 放电过流 | **VM 端 0.200V** ±30mV，延时 12ms |
| 充电过流 | VM 端 −0.200V，延时 8ms |
| **短路** | **0.6–1.4V**，响应 150–500µs |
| 工作/待机电流 | 4.5µA / 2.1µA |
| 0V 电池充电 | ✅ 支持 |

> ✅ **过充阈值 4.280V/节 = 8.56V，高于充电器的 8.40V 终止电压** —— 两者不冲突，
> 保护 IC 只在充电器失效时才动作。**这正是正确的架构。**

**过流点计算**（关键）：

```
I_过流 = 0.200V ÷ (两个 MOS 的 Rds(on) 之和)

目标过流点 ≈ 10A  →  Rds(on)总和应 ≈ 20mΩ  →  每个 MOS ≈ 10mΩ
```

⚠️ Rds(on) 随温度上升约 1.5 倍，**按 25°C 规格值选，热态过流点会更高**，这是可接受的。

**MOS 候选**（平芯微推荐）：
| 型号 | 封装 | 场景 |
|---|---|---|
| **PW8206A6S** | SOT-23-6（双 N-MOS）| 中小电流，占板小 |
| **PW4406A** | SOP8 | 通用 |
| PW20N03 / PW80N03 | TO252 | 大电流 |

> **备选方案**：不上主板，把 HX-2S-JH20 模块（46.7×23×3.15mm）放在电池旁边 —— 板面省 1074mm²。
> 实测下来这样板面最宽松（需高 70mm vs 72.8mm）。

### 模块 1B · 单元均衡 ✅ 型号已定

**HY2213**（HYCON 宏康，SOT-23-6，立创 C168784）—— **单节**均衡 IC，2S 需要 **2 颗**。

| 项 | 值 |
|---|---|
| 过充检测 | 4.000–4.500V ±25mV |
| 过充释放 | 3.800–4.500V ±35mV |
| 待机检测 | 2.70V |
| 工作/待机电流 | 2.5µA / 0.5µA |
| 封装 | SOT-23-6 |

**用法**：每节电芯并一颗 HY2213 + 一个限流电阻，超过阈值时电阻放电，把高的一节拉下来。

### 📐 官方参考设计（平芯微「PW7120 + PW4252」二合一方案）

**平芯微官方给出的完整参考设计**，架构和我们完全一致：

| 参数 | 官方规格 |
|---|---|
| 电池 | 2S 7.4V / 8.4V 满充 |
| 保护芯片 | **PW7120** |
| MOS | **PW4406A × 2**（SOP8，背靠背）|
| 持续放电 | 3A |
| **过流保护** | **约 7A** |
| 充电芯片 | PW4252（升压）|
| 电池端充电电流 | 1.2A |

**官方参考原理图的元件值**（已抄录，见 [电源官方参考原理图.png](电源官方参考原理图.png)）：

```
【保护】U1 = PW7120（SOT23-6L）
  R1 = 330R ±1%          R2 = 330R ±1%
  C1 = 0.1µF/16V         C2 = 0.1µF/16V
  R3 = 1K ±1%（VM 到 P−）
  U2/U3 = PW4406A ×2（背靠背，SOP8）
         U2: G=4  S=1,2,3  D=5,6,7,8
         U3: 同，D 对 D 相连
  电池侧 B+/B− ── 输出侧 P+/P−

【充电】U4 = PW4252（SOP8-EP）
  RADJ = 2.74K ±1%  →  1.2A   ← ⚠️ 见下方"改 0.5A"
  R4   = 10K ±1%（NTC 上拉）
  L    = 2.2µH
  C4   = 0.1µF/25V（自举）
  C5   = 0.1µF/25V
  C3 = CBAT = CIN = 10µF/25V
  R5 = 4.75K ±1% + LED1（充电指示）
  R6 = 0R

【USB Type-C】
  CC1 / CC2 各 5.1K ±1% 下拉（Sink 标准配置）
```

**官方还提供了 PCB 文件下载**：
- `PW7120保护板PCB.zip`
- `PW7120+均衡的PCB.zip` ← **含均衡的版本**

> 来源：[平芯微官方技术文章](https://www.pwchip.com/tw/product/632.html)

### ⚠️ 选型修正：PW4252 **还没量产**

官方页面标「**生产 Q4**」，官方回复："目前Q4才会出，可以先看 PW4253"。

**而我们的电池只有 800mAh**：

| 型号 | 充电电流范围 | 对 800mAh 电池 | 状态 |
|---|---|---|---|
| PW4252 | 0.4–1.2A | 0.5–1.5C | ❌ Q4 才量产 |
| **PW4584A** ⭐ | **0.5–1A** | **0.63–1.25C** | ✅ **量产** |
| PW4253 | 1.1–2A | 1.4–2.5C ❌ **太快** | ✅ 量产 |

**结论：改用 PW4584A，充电电流设 0.5A**（约 0.63C，对 45C 动力芯是安全的）

**PW4584A 参数**（官方）：
- 输入 3.6–6V，**VIN 耐压 30V**，输入过压 6V 关闭
- 升压型，两串，充满 **8.4V**
- 充电电流 **0.5A–1A** 电阻可调
- **带 OVP 过压保护**
- **SOP8-EP**
- 官方评论确认：**可与 PW7052 组合**实现充电+保护；**脚位与 PW4053A 相同**

### ⚠️ 采购渠道问题

| 型号 | 立创商城 | 其它渠道 |
|---|---|---|
| **PW7120 / PW2213 / PW4584A**（平芯微）| ❌ **搜不到** | **icinz.com**（官方指定）或淘宝 |
| **HY2120-CB**（宏康）| ✅ **C168776** | 淘宝 |
| **HY2213**（宏康）| ✅ **C168784** | 淘宝 |

**两个可选组合**：

| | **方案 A（平芯微官方组合）** | **方案 B（立创一次买齐）** |
|---|---|---|
| 保护 | PW7120 ✗立创无 | **HY2120-CB** ✅C168776 |
| 均衡 | PW2213 ✗立创无 | **HY2213** ✅C168784 |
| 充电 | PW4584A ✗立创无 | PW4584A（淘宝）|
| MOS | PW4406A ×2 | 同 |
| **优势** | ✅ **有官方原理图 + PCB 文件** | ✅ **立创一次下单** |
| 劣势 | 要分开两个渠道买 | 无官方组合参考图 |

> 💡 **两方案的电路拓扑是一样的**（PW7120 与 HY2120-CB 的阈值完全相同：4.28V / 2.9V）。
> **建议：用方案 A 的官方原理图做设计蓝本，按方案 B 采购**（立创能一次买齐保护+均衡）。

### 📐 官方 Code 15 参考设计（PW4584A 版，**这才是我们要照抄的**）

官方英文站给出的是 **PW4584A** 版本（我们选定的那颗），与 PW4252 版有**两处电路差异**：

| | PW4252 版 | **PW4584A 版（我们用的）** |
|---|---|---|
| 升压拓扑 | **同步**整流 | **异步**（**多一个肖特基二极管**）|
| 关键器件 | 无二极管 | **D1 = SS34**（LX → 输出）|
| 电感 | 2.2µH | **3.3µH** |
| RADJ | 2.74K → 1.2A | **1K → 1A** |
| 输出电容 | C5 0.1µF | **COUT / CFI 各 10µF/25V** |

**官方 Code 15 参考原理图元件值**（见 [电源官方参考原理图_PW4584A版.png](电源官方参考原理图_PW4584A版.png)）：

```
【保护】U1 = PW7120（SOT23-6L）
  R1 = 330R ±1%   R2 = 330R ±1%
  C1 = 0.1µF/16V  C2 = 0.1µF/16V
  R3 = 1K ±1%（VM → P−）
  U2 / U3 = PW4406A ×2（背靠背，SOP8）

【充电】U4 = PW4584A（SOP8-EP）异步升压
  D1 = SS34（肖特基）        ← 异步升压必需
  L  = 3.3µH
  RADJ = 1K ±1%              ← 1A；改 0.5A 需查规格书换值
  C3 = 10µF/16V              C4 = 0.1µF/25V
  CBAT / COUT / CFI / CIN = 10µF/25V
  R9 = 1K ±1% + LED2（充电指示）
  R2(上) + LED1

【USB Type-C】
  CC1 / CC2 各 5.1K ±1% 下拉
```

**官方参考板实测尺寸：35 × 21 mm**（含保护 + 充电 + Type-C，不含均衡）

> 来源：[PWChip Code 15 英文页](https://www.pwchip.com/en/product/607.html)
> ⚠️ **RADJ = 1K → 1A**；我们要 0.5A，**需查 PW4584A 规格书确认对应阻值**。
> 规格书下载：https://www.pwchip.com/file-download-5613-left.html（需注册）

### 模块 2 · 充电 ✅ 型号已定（改用国产方案）

**主芯片：PW4252**（平芯微 PWChip，**SOP8-EP**）—— 5V 输入同步升压充电 IC

| 引脚 | 连到 | 说明 |
|---|---|---|
| `VIN` | `VBUS`（Type-C）| 经 10µF + 0.1µF 到 GND |
| `SW` | 电感 L1 | 升压开关节点 |
| `BAT` | `VBAT_PROT+` | **充回保护后的正极**（共口）|
| **电流设定电阻** | `BAT` 到 GND | **设 0.4A**（范围 0.4–1.2A）|
| `NTC` | NTC 10k 分压 | 电池温度保护 |
| `EP`（底部焊盘）| `GND` + 铺铜散热 | **必须焊 + 打过孔** |

**为什么改用它，而不是 TI BQ25887**：

| | **PW4252 + HY2213×2** | TI BQ25887 |
|---|---|---|
| 封装 | **SOP8-EP + SOT-23-6** ✅ 好手焊 | VQFN 4×4 ❌ 要热风枪 |
| 控制 | **电阻设定，不用写固件** ✅ | I2C，要写固件配置 |
| 均衡 | HY2213×2 独立 | 内置 400mA |
| 价格 | 国产，便宜 | 贵 |
| 资料 | 有实测数据 + 完整 BOM | TI 官方 |

**PW4252 参数**：
- 5V 升压到 8.4V，输出最大 **1.2A**
- 输入 4.5–6V，输入过压 6V，VIN 耐压 20V
- **同步整流，效率 93%**
- 充电电流外部电阻调节 **0.4A–1.2A**
- 输入自适应环路，兼容 5V/1A~3A 适配器
- 支持涓流/恒流/恒压三段式充电
- **电池反接保护，静态功耗 0µA**
- 内置 NTC 温度保护

**首版充电设定**：**0.4A / 8.4V CC/CV**（0.5C，保守值）

**备选**：PW4584A（异步 1A，便宜）、PW4253（同步 2A，快充）、PW4000（升降压 3A，宽输入）

### 模块 3 · 电源分配

| 从 | 到 | 说明 |
|---|---|---|
| `VBAT_PROT+` | 保险丝 F1（7.5A）| |
| F1 | S1A 总开关 | 15A |
| 开关后 | `VBAT_SW` | |
| `VBAT_SW` | DFR0753 `VIN` | 经 470µF + 0.1µF |
| DFR0753 `VOUT` | `+5V_SERVO` | 经 **1000µF** + 0.1µF |
| `VBAT_SW` | 逻辑降压 `VIN` | 经 10µF |
| 逻辑降压 `VOUT` | `+5V_LOGIC` | 经 **470µF** + 0.1µF |
| `VBAT_SW` | R1 100kΩ → `ADC_BAT` | 电池采样 |
| `ADC_BAT` | R2 33kΩ → `GND` | 分压 8.4V → 2.084V |
| `ADC_BAT` | C 100nF → `GND` | 滤波 |
| `ADC_BAT` | GPIO1 | |

### 模块 4 · 主控（2×20 插座 J1/J2）

**完整引脚表**（沿用仓库已核规划，`L`/`R` 为开发板位置）：

| GPIO | 位置 | 网络 | 用途 |
|---|---|---|---|
| 1 | L1 | `ADC_BAT` | 电池电压采样 |
| 2 | L2 | `ENC_B` | 旋钮 B 相 |
| 4 | L4 | `MIC_BCLK` | 麦克风 I2S 时钟 |
| 5 | L5 | `MIC_WS` | 麦克风帧时钟 |
| 6 | L6 | `MIC_SD` | 麦克风数据 |
| 7 | L8 | `ENC_A` | 旋钮 A 相 |
| 8 | L9 | `PCA_SDA` | PCA I2C 数据 |
| 9 | L10 | `PCA_SCL` | PCA I2C 时钟 |
| 10 | L11 | `PCA_OE_N` | 舵机输出禁止（**高=禁止**）|
| 11 | L12 | `LCD_MOSI` | 屏幕 SPI 数据 |
| 12 | L13 | `LCD_SCLK` | 屏幕 SPI 时钟 |
| 13 | L14 | `LCD_CS_N` | 屏幕片选 |
| 14 | L15 | `LCD_DC` | 屏幕数据/命令 |
| 15 | R5 | `AMP_BCLK` | 功放 I2S 时钟 |
| 16 | R6 | `AMP_WS` | 功放帧时钟 |
| 17 | R7 | `AMP_DIN` | 功放数据 |
| 21 | R10 | `LCD_RST_N` | 屏幕复位 |
| 38 | R13 | `ENC_SW_N` | 旋钮按压 |
| 40 | R11 | `KEY_N` | 独立按键（可选）|
| **18** | **R8** | **空闲** | **原来接舵机 PWM，现在走 PCA9685 → 可留测试点** |
| — | L17/L18/L19 | `+3V3` | 3.3V 输出 |
| — | R17/R18/R19 | `+5V_LOGIC` | 5V 输入 |
| — | L7/L20/R9/R20 | `GND` | |

### 模块 5 · 舵机（PCA9685 裸芯片 + 8 路座）

#### 🔑 已核实的芯片特性（NXP 官方）

> "Sixteen **totem pole** outputs (sink 25 mA and **source 10 mA at 5 V**) with software programmable open-drain selection (**default at totem pole**)."

**→ 默认推挽输出，不需要外加上拉电阻。** 省掉 16 个电阻。

#### 连接

| 引脚 | 连到 | 说明 |
|---|---|---|
| `VDD` | `+3V3` | **3.3V**（I2C 也上拉到 3.3V）|
| `VSS` | `GND` | |
| `SDA` / `SCL` | `PCA_SDA` / `PCA_SCL` | 上拉 10kΩ 到 `+3V3` |
| `OE` | `PCA_OE_N` + 10kΩ 上拉到 `+3V3` | **高电平禁止输出** → 上电默认禁止，舵机不乱动 |
| `A0`–`A5` | `GND` | I2C 地址 0x40 |
| `EXTCLK` | 悬空 | 用内部 25MHz 振荡器 |
| `LED0`–`LED7` | `PWM0`–`PWM7` | → 8 个舵机信号脚 |
| `LED8`–`LED15` | 悬空（可留测试点）| 备用 8 路 |
| `VDD` 去耦 | 0.1µF + 10µF 到 GND | 紧贴芯片 |

#### 舵机 3P 座 ×8

```
每个 3P 座：
  1  信号  ← PCA9685 LEDn
  2  +5V   ← 【+5V_SERVO 铺铜，就近取】
  3  GND   ← 【GND 铺铜，就近取】
```

⚠️ **脚序必须和舵机线色对上**（红色电源在中间，地/信号在两旁，不同批次可能不同）——**焊接前用蜂鸣档确认**。

⚠️ **8A 全部走铺铜**，每个座就近从铺铜取电，**绝不串联**。

### 模块 6 · 音频

| 器件 | 引脚 | 连到 |
|---|---|---|
| 麦克风 SEN0327 | `VDD` | `+3V3` |
| | `GND` | `GND` |
| | `SCK`(BCLK) | `MIC_BCLK` (GPIO4) |
| | `WS` | `MIC_WS` (GPIO5) |
| | `SD` | `MIC_SD` (GPIO6) |
| | `L/R` | `GND`（选左声道）|
| 功放 MAX98357A | `Vin` | `+5V_LOGIC` |
| | `GND` | `GND` |
| | `BCLK` | `AMP_BCLK` (GPIO15) |
| | `LRC` | `AMP_WS` (GPIO16) |
| | `DIN` | `AMP_DIN` (GPIO17) |
| | `SD` | 悬空（默认 (L+R)/2 立体声混合）|
| | `GAIN` | 悬空（默认 9dB）|
| | `OUT+` / `OUT−` | 喇叭两端（**BTL，都不接地**）|

### 模块 7 · 交互（EC11 + 按键）

| 信号 | 连到 | 上拉 |
|---|---|---|
| `ENC_A` | EC11 A 相 | 10kΩ → `+3V3` |
| `ENC_B` | EC11 B 相 | 10kΩ → `+3V3` |
| `ENC_SW_N` | EC11 按压 | 10kΩ → `+3V3` |
| EC11 公共端 | `GND` | |
| `KEY_N` | 轻触开关 | 10kΩ → `+3V3`（可选，建议去掉）|

> 💡 **建议去掉独立按键** —— EC11 自带按压，省一个开孔和两个元件。

### 模块 8 · 显示 ✅ 型号已定

**屏幕：汉昇 HS24S010B**（立创 **C5329587**）— 2.4" IPS / ST7789 / SPI / 3.3V / **43.5 × 72.9mm**

**连接器：上下各一排 10 针 2.54mm**（两排同信号、顺序不同，**用右排即可**）

| 右排针 | 信号 | 连到 | 说明 |
|---|---|---|---|
| 1 | GND | `GND` | |
| 2 | VCC | `+3V3` | **3.3V**（不要 5V）|
| 3 | SCL | `LCD_SCLK` (GPIO12) | SPI 时钟 |
| 4 | SDA | `LCD_MOSI` (GPIO11) | SPI 数据（MOSI）|
| 5 | RES | `LCD_RST_N` (GPIO21) | 复位 |
| 6 | DC | `LCD_DC` (GPIO14) | 数据/命令 |
| 7 | CS | `LCD_CS_N` (GPIO13) | 片选 |
| 8 | LED | `+3V3` | 背光，常亮 |
| 9 | FS0 | **悬空** | 外挂字库/Flash 用，不用 |
| 10 | FCS | **悬空** | 同上 |

**左排（11–20）是同一组信号、顺序不同**，可作为备份焊盘或留空。

**去耦**：VCC 到 GND 加 0.1µF（紧贴连接器）

> ⚠️ **必须用立创 EDA 库里的 `C5329587` 封装**，不要自己画 ——
> 两排针的顺序不同，画错就插不上。

## 四、关键设计要点

| # | 要点 | 原因 |
|---|---|---|
| 1 | **PCA9685 的 VDD 接 3.3V，不是 5V** | I2C 上拉到 3.3V；ESP32 GPIO 不耐 5V |
| 2 | **舵机信号 3.3V 电平可用** | MG90S 输入高阈值约 2.4V ✓ |
| 3 | **OE 上拉到 3.3V = 上电禁止输出** | 舵机不乱动，固件初始化后才放开 |
| 4 | **PCA9685 输出不用上拉** | NXP 核实：默认推挽，10mA 源出 |
| 5 | **两路 5V 只共地，正极绝不并联** | 舵机噪声不窜进逻辑 |
| 6 | **8A 走 2oz 铺铜（≥4mm 宽）** | 不过细走线、不过单根排针 |
| 7 | **底层整片 GND 铺铜** | RevA 没有地平面，是硬伤 |
| 8 | **DFR0753 背面散热焊盘铺铜 + 打散热过孔** | 40W 满载发热大 |
| 9 | **电池采样从总开关后取** | 关机时读数为 0，能区分"关机"和"没电" |
| 10 | **充电走保护后的 P+/P−（共口）** | 过充时有保护板兜底 |

---

## 五、元件清单（原理图级）

| 类别 | 元件 | 数量 |
|---|---|---|
| 主控 | 2×20 母座（C429947）| 2 |
| 电源 | DFR0753 | 1 |
| 电源 | 逻辑降压（MP1584 模块 / MP2315 芯片）| 1 |
| 电源 | **PW4584A** + 电感 **4.7µH** + 肖特基 **SS34** + RICHG | 1 套 |
| 电源 | **PW7120** + **PW4406A×2** + R1/R2=330Ω + R3=1K | 1 套 |
| 电源 | **PW2213×2** + 620KΩ×4 + **PW2302×2** | 1 套 |
| 电源 | 保险丝 7.5A + PCB 座 | 1 |
| 电源 | S1A 总开关 | 1 |
| 保护 | 2S 保护 IC + 双 N-MOS + 均衡电阻 | 1 套 |
| 舵机 | PCA9685 (TSSOP-28) | 1 |
| 舵机 | 3P 公排针 ×8 | 8 |
| 音频 | 麦克风模块 + 功放模块 + 喇叭座 | 各 1 |
| 交互 | EC11 编码器 | 1 |
| 显示 | 8P 或 14P 母座 | 1 |
| 连接器 | Type-C 16P 母座 | 1 |
| 连接器 | 电池输入端子（KF128 / XT30）| 1 |
| 电容 | 1000µF/10V ×1，470µF/16V ×1 | 2 |
| 电容 | 10µF ×2，0.1µF ×8 | 10 |
| 电阻 | 10kΩ ×5（I2C×2 + OE + 按键×2）| 5 |
| 电阻 | 100kΩ + 33kΩ（电池采样）| 2 |
| 电阻 | 100Ω ×2（保护 IC 滤波 + 均衡）| 2 |

---

## 六、上电顺序

```
1. 不接电池，量各电源网络对 GND 不短路
2. 接电池（不插开发板），测 VBAT_PROT ≈ 电池电压
3. 总开关 ON，测 +5V_SERVO 和 +5V_LOGIC 都 ≈5.0V
4. 插开发板，测 +3V3 ≈3.3V，开机正常
5. 接屏幕 → 出画面
6. 接麦克风/功放 → 录音放音
7. 接 PCA9685（先不插舵机）→ 量 VDD=3.3V、OE 被上拉
8. 插 1 个舵机测小角度 → 记电流/压降/温升
9. 逐级 2 → 4 → 8 个
```

---

## 七、待确认

| # | 项 | 状态 |
|---|---|---|
| 1 | ~~2S 保护 IC 具体型号~~ | ✅ **已定：HY2120-CB（SOT-23-6）** |
| 2 | 逻辑降压：模块 还是 芯片 | 待用户定（MP1584 模块 / MP2315 芯片）|
| 8 | PW4252 / HY2120 / HY2213 的采购渠道与价格 | 立创商城有 HY2120/HY2213；PW4252 需确认 |
| 3 | 屏幕引脚数（8P / 14P）| 待实物 |
| 4 | 电池输入端子选型（KF128 / XT30）| 待用户定 |
| 5 | 是否保留独立按键 KEY_N | 待用户定 |
| 6 | ~~BQ25887 I2C 配置~~ | ✅ **不用 I2C 了**（PW4584A 电阻设定）|
| 7 | DFR0753 实物尺寸（画封装要用）| 待实物 |
