xaiojie/papabot/mechanical-design/structure-a2/验证说明.md

# A2 交付验证

- 32/32个STL重新读回通过：单一连通闭合体、正体积；无边界边、非流形边、重复/退化三角面；尺寸与清单相符，导出单位mm且Z=0落底。
- 主装配场景内32个可打印网格闭合；原V1和A1源文件保留，完整性记录见complete-preservation.json。
- 静态检查覆盖177个外购件/接插件/引脚预留体；363对执行实体交集，超过0.05mm³的冲突为0。
- 4条腿共32个离散抽样姿态未报告零件碰撞。采样：髋−15/0/+15°、膝−20/0/+20°，每腿8个非静止组合。抽样中的移动件与固定件包围盒已分离，不需进一步实体交集。
- PCB紧固件专项：Ø6mm的M3螺丝头与J9名义排针壳体相交；采用Ø≤4mm的M2螺丝头后，名义最小边缘间隙约0.46mm。PCB没有修改。
- 螺母受力路径已按建模尺寸复核：R06/R16脚底侧装槽留1.6mm下承压壁；后控件/喇叭固定座留1.6mm前承压壁。模型检查不证明打印后的材料强度。

检查采用模型名义尺寸，尚未实际切片、试装或承载测试。小于0.05mm³的交叠不作为本检查冲突，接触安装面允许共面。抽样姿态逐腿独立检查，没有证明整个连续活动范围、同时四腿联动、线束或地面支撑安全。

证据文件：complete-stl-verification.json、complete-reopen.json、assembly-collision-check.json、leg-motion-sample-check.json、pcb-fastener-head-check.json、complete-preservation.json、presentation-preservation.json。它们位于本目录或交付包的reports/中。
