xaiojie/papabot/mechanical-design/structure-a3/设计修正说明.md

# A3 前后盖修正

用户已确认：按旧V1，旋钮和按键留在原91×44mm屏幕板上，藏在可拆前盖内；屏幕竖直正对前方（法线沿整机−Y），采用内凹显示。此决定替代A2的拆焊后置方案。

本轮按该决定修正：

- 保持原屏幕板和玻璃的安装平面不动，前盖加深到原V1的Y−46.2附近，玻璃仍在Y−25.4附近，名义内凹约20.8mm；不倾斜屏幕。
- 前盖作为独立深盖，整合黑色遮光内壁和麦克风导声通道，沿−Y直接拆下。原板旋钮保留在屏幕右侧，拆盖后可操作。
- 底盘前方固定点转接主壳，使拆前盖不必拆底盘、PCB或腿。前盖用4颗M3×30固定到既有主壳孔位。
- 后面板保留充电口、总开关、喇叭和功放固定，取消旋钮/按键孔及R07、R08后置压片；仍可独立拆卸。
- 复核静态配合、沿轴拆盖路径、STL闭合性，输出正面视图及拆开视图。旋钮整装高度沿用V1名义包络，商品图中的15mm是轴长，实物总高度仍需复核。

A2原文件保留为历史，不覆盖用户V1源文件。电气PCB和四腿结构继续沿用当前方案。
