xaiojie/papabot/mechanical-design/structure-a4/紧固件与辅料.md

# A4 紧固件与辅料起始清单

这是本次模型的装配起始配置，不是已经购买或实物试装确认的清单。M2螺钉与自攻螺钉分开；打印导孔与舵机自带螺丝均须试配。不能用此表覆盖原采购BOM。

| 部位 | 建议配置 | 数量 | 说明 |
|---|---|---:|---|
| 上壳到底盘 | M3×10 + M3螺母 | 4套 | R01有侧装螺母槽 |
| 前盖、后盖 | M3×10 + M3螺母 | 8套 | 各4，螺母预装在上壳 |
| R06到底盘 | M3×10 + M3螺母 | 4套 | 支柱底部侧装螺母 |
| 四个髋固定座到底盘 | M3×12 + M3螺母 | 8套 | 每座2；顶部螺母、头部和导线需实际复核 |
| 主板到R06 | M2.5×8 + M2.5螺母 | 4套 | 头径≤5 mm，避免大垫片侵入铜区 |
| 八个舵机耳片 | M2×8 + M2螺母 | 16套 | 每舵机2；也可按实物配原厂合适螺丝，不能强行扩舵机孔 |
| 四个髋舵盘到上腿 | M2×8 + M2螺母 | 8套 | 只接原装双臂舵盘，按实物检查末端突出 |
| 四个膝舵盘到下腿 | M2×10 + M2螺母 | 8套 | 下腿4.8厚；试装核对螺纹伸出不碰旋转部件 |
| 舵盘中心 | 舵机原配中心螺丝 | 8 | 不用M2通用螺丝替代型号不明的中心螺丝 |
| 两个耳朵 | M2×6 + M2螺母 | 2套 | 沿用A3耳朵的螺母槽与内压垫 |
| 开关可换板 | M2×6 + M2螺母 | 2套 | 结合实际垫片/头厚检查螺钉末端 |
| 屏幕压框 | 2 mm塑料用自攻×6 | 4 | Ø1.7导孔；轻压四角软垫，不压玻璃 |
| 麦克风、功放、USB侧板 | 2 mm塑料用自攻×6 | 6 | 每件2 |
| 电池托盘、两路降压托架 | 2 mm塑料用自攻×6 | 6 | 每件2；主板架拆下后安装 |
| 喇叭后压圈 | 2 mm塑料用自攻×8 | 2 | 只压壳边，勿使振膜受力 |

合计参考：M3螺母24；M2.5螺母4；M2螺母36。普通M2×8共24，M2×10共8，M2×6共4；塑料用2 mm自攻×6共16、×8共2。上述未含备件，舵盘连接方式与孔距必须以到货批次为准。

结构辅料：透明PC片57×42×0.8 mm（四角R2），屏幕四角0.5 mm EVA或相近软垫，电池底0.8 mm绝缘软垫，模块绝缘垫，2条电池束带、模块束带/扎带、线束固定扎带，Ø12×2硅胶脚垫4个。透明片薄胶仅在周边接触，不覆盖亮区，不让胶污染液晶。

电气辅料沿用项目最新接线说明：电池转接/均衡线、屏幕10线接头、端子线等另按真实端接选型；本模型不会自动证明线序或插头极性正确。
