xaiojie/papabot/mechanical-design/structure-a4/验收摘要.md

# A4 CAD 试装版本验收摘要

日期：2026-09-14。原生文件重新打开、几何检查和导出验证完成；未进行实物打印或负载测试。

| 检查 | 本次结果 |
|---|---|
| 静态装配 | 通过 |
| 原生零件闭合连通 | 通过 |
| 31个毫米STL | 通过 |
| 5个试配件 | 通过 |
| 36组腿部离散姿态 | 通过 |
| 23个拆装位置 | 通过 |
| USB插拔量规 | 通过 |
| 屏幕接头对主板 | 通过 |
| 原文件保护 | 通过 |
| 最终图像 | 8张，与最终原生文件对应 |

静态交集阈值0.05 mm³；腿部离散检查阈值0.1 mm³。腿部每条检查髋−15/0/+15°和膝−20/0/+20°的9种组合，共36组；不表示整个连续行程、同时步态或地面接触已验证。拆装需按README的断线、拆盖、拆主板顺序。

USB检查仅适用于15×14×8 mm护套及6.5×8.4×2.6 mm金属端量规，检查装入及向外3/8/15 mm位置。J6金属端的正常插接重合排除，采购连接器与PCB焊盘兼容仍待核实。屏幕接头使用7.7 mm深包络，与主板前边相隔1.1 mm，不能直接换成长母头。

原生文件：`DesktopAssistant-整机结构-A4.blend`

SHA-256：`82c49abd8b2335633ff7e55c6c32337df68edd180fdfc25d098fc703cb272ab1`

原A3、用户最新版PCB source、最新BOM总表的哈希前后相同。主板纹理已打包到Blender文件。

质量和重心仅为明示假设下的估算，详见`reports/mass-and-support-estimate.json`；未据此批准舵机扭矩或整机承重。屏幕、舵机、开关、降压、电池等实际配合以试配结果为准。
