xaiojie/papabot/mechanical-design/structure-a5/验收摘要.md

# A5 CAD 试装验收摘要

2026-09-14。实际模型、独立STL和最终图像已核对；尚无实物打印或负载测试。

| 检查 | 结果 |
|---|---|
| 静态装配 | 通过 |
| 原生31零件闭合连通 | 通过 |
| 31个毫米STL复读 | 通过 |
| 5个试配件复读 | 通过 |
| 36组腿部离散姿态 | 通过 |
| 24个拆装检查位置 | 通过 |
| J6充电USB-C插拔量规 | 通过 |
| 屏幕接头对主板 | 通过 |
| 原文件保护 | 通过 |

静态体积交集阈值0.05 mm³，腿部检查阈值0.1 mm³。每腿髋−15/0/+15°、膝−20/0/+20°；不代表连续行程、地面接触或四腿联动已验证。

J6量规为14×15×8护套、8.4×6.5×2.6金属端；完全插入以及向外3/8/15 mm位置均无非配合碰撞。后盖17×11入口按护套留余量。实际连接器焊盘兼容及插口基准仍须实板验证。

整机当前站姿宽×深×高：162.9 × 116.5 × 122.46 mm；机身124×112×76 mm。未计入外接线缆。

托盘拆卸检查包含移除R18/UBEC后向右平移2 mm再上提的路径。主板、壳体拆卸和实际线束仍需按README操作。

9张图均由最终Blender模型渲染。默认视口关闭相机/灯光辅助物和关系线。原A4、A3、PCB source和BOM未由本次脚本修改。

Blender SHA-256：`ace8224003803e50476a99f97ab77cd0ece0d78287bd298232193ee7870a4cf9`
