xaiojie/papabot/pcb-design/integrated-v1/EDA-建板进度.md

# EDA 建板进度

> **2026-09-12 V1.2 无旋钮更新：** 五页原理图及 110×75 mm 双层 PCB 已完成，原理图/PCB 原生 DRC 严格通过。当前为 79 个器件、310 个引脚、59 个有连接网络；EC11 及三个上拉电阻、相关走线与定位孔均已移除。HS24S010B 使用单排 10PIN 屏幕接口，经主板 XH-10A 线束连接。准确工程、BOM、Gerber 与接线资料见 [V1.2 无旋钮交付](final-no-encoder-2026-09-12/README.md)。下文保留设计历史，其中旋钮、旧型号/针序、旧数量与“PCB 未完成”等描述均已被本次交付替代。

2026-09-11。**方案 C：新建独立工程**。

---

## 一、安全措施（已完成）

```
✅ 备份：eda-备份/DesktopAssistant_RevB_backup_20260911.epro2
   大小 393,481 B
   SHA256 fe0f8ba7e5ed334a197305c91b9b0ec3…
```

**原 RevB 工程一个字符都不会动。**

---

## 二、新工程已创建

```
名称   DesktopAssistant_Integrated
UUID   50ae04bdafb74b93b94b7cc4c08171e1
团队   d0db481628274583b043080016ef0fff
```

### 结构

| 文档 | UUID | 说明 |
|---|---|---|
| Board1 | — | |
| ↳ Schematic1 | `6c93ab84d69093e6` | |
| ↳ **P1（原理图页）** | **`b8d9a582c4360871`** | **124 空白，已打开** |
| ↳ **PCB1** | **`82d383f16c96a6f4`** | 空白 |

> 多余自动生成的 `Board2` 已删除。

---

## 三、器件库已拉取（按立创编号）

**`lib_Device.getByLcscIds([...])` 直接拉系统库器件** ✅

| 立创编号 | 型号 | 厂商 | 封装 | 器件 UUID |
|---|---|---|---|---|
| C20626143 | LCKFB-ESP32S3R8N8 | 立创 | **DIP-40_L20.32-W51.66-P2.54** | `6da2861d3f6a4afa9a1b05c444fe38b5` |
| C5329587 | HS24S010B | HS 汉昇 | **LCD-TH_L72.3-W43.0** | `cc2f5d90365247ed9e2daffcd7a82557` |
| C429947 | 22850120ANG1SYA01 | JILN 锦凌 | HDR-TH_20P-P2.54-V-F | `a11ff85df8144c52811375f7db418f64` |
| C168776 | **HY2120-AB** | HYCON 宏康 | SOT-23-6 | `1505cc8be4a849768d45320e21aaaa8b` |
| C168784 | **HY2213-AB3B** | HYCON 宏康 | SOT-23-6 | `b8a568f0b69a4356b039f0c2aa3194c8` |
| C908680 | SS34 | GOODWORK | SMA_L4.3-W2.7 | `c009198a59284b8387ff6746e7f54794` |
| C178942 | 029707.5WXNV | Littelfuse | FUSE-TH_L10.9-W3.8 | `0cbecdc1014e480aa2db07542c2a4806` |
| C206907 | 01530008Z | Littelfuse | 01530008Z | `532b482a6942463fbb7572966ae85b1f` |
| C494548 | SHW1000UF10V8X12 | KNSCHA | CAP-TH_BD8.0 | `55a16c7a0b5e4302b2a4c76e53777db7` |
| C51953430 | ERB16V470M8X12 | JIERR | CAP-TH_BD8.0 | `a84729d2d31842da95d4ba6480505198` |
| C260338 | **S1A 开关**（SMC 桑德斯）| SMC | — | `fa5c57be1449474f8b3d0aab1f7766a4` |

### 🎯 两个独立验证

**① 开发板尺寸**
```
EDA 封装名:  DIP-40_L20.32-W51.66-P2.54
我从封装图量的: 20.5 × 51.9 mm      差 0.2mm（描边宽度）✓
```

**② 屏幕尺寸**
```
EDA 封装名:  LCD-TH_L72.3-W43.0
我从封装图量的: 43.5 × 72.9 mm      差 0.2-0.6mm ✓
```

**两次独立测量互相印证，说明我之前的图像测量法可靠。**

---

## 四、仍缺的器件

| 件 | 状态 | 方案 |
|---|---|---|
| **PW7120** | ❌ 立创无 | 用 **HY2120-AB**（C168776）替代 —— 阈值完全相同 |
| **PW4584A** | ❌ 立创无 | 用 `search('PW4584A')` 试；或自建符号；或用 C260338 类似的替代 |
| **PW2213** | ❌ 立创无 | 用 **HY2213**（C168784）替代 ✓ |
| **PW4406A / PW2302** | ❌ | 用等效 MOS（search 找） |
| 喇叭 | 找到了 FS 系列 | 选一个 |
| PCA9685 | 待搜 | `search('PCA9685')` |
| 阻容 | 待搜 | 用系统库通用件 |

**→ 好消息：核心电源 IC 都有宏康的立创在售替代（阈值完全一致）**

---

## 五、可用 API 速查（本轮实测）

### 库
```js
lib_Device.getByLcscIds([...codes])          // 按立创编号拉器件 ✅
lib_Device.search('关键词')                   // 搜索（1 参数形式）✅
lib_LibrariesList.getSystemLibraryUuid()      // 0819f05c4eef4c71ace90d822a990e87
lib_LibrariesList.getProjectLibraryUuid()     // "project"
lib_LibrariesList.getPersonalLibraryUuid()    // d0db481628274583b043080016ef0fff
```

### 工程 / 文档
```js
dmt_Project.openProject(uuid)
dmt_Project.getCurrentProjectInfo()      // .data → Board 树
dmt_Project.getProjectInfo(uuid)
dmt_Project.createProject(name)
dmt_Board.createBoard() / deleteBoard(name)
dmt_EditorControl.openDocument(uuid)
dmt_EditorControl.zoomToAllPrimitives()
dmt_EditorControl.getCurrentRenderedAreaImage()   // 截图
```

### 原理图
```js
sch_PrimitiveComponent.getAll()
sch_PrimitiveComponent.create(component, x, y, subPartName, rotation, mirror, addIntoBom, addIntoPcb)
sch_PrimitiveWire.create(line, net, color, lineWidth, lineType)
sch_Drc.check()
sch_Document.save()
```

### 元件对象
```js
c.designator  c.name  c.x  c.y  c.net
c.component   // {libraryUuid, uuid, name}
c.symbol  c.footprint  c.manufacturer  c.supplier
c.getAllPins()  c.getState_Designator()  c.setState_Designator()
```

---

## 六、下一步

```
第 4 步  按「完整网络表.md」程序化建元件 + 连线
         分小步：电源 → 主控 → 舵机 → 音频 → 交互 → 显示
         每步截图给你审核
第 5 步  跑 sch_Drc.check()，读报告
第 6 步  importChanges 到 PCB → 按「最终摆放图」布局 → 铺铜 → 布线
第 7 步  pcb_Drc.check() → 导 Gerber
```

---

## 七、开始建原理图（2026-09-11）

### ✅ 模块 1「电池保护」已建成

| 位号 | 器件 | 器件 UUID | 网络数 |
|---|---|---|---|
| U1 | **HY2120-AB** 2S保护 | `1505cc8be4a849768d45320e21aaaa8b` | 6 |
| Q1 | **AO4406** SOP-8 N-MOS | `fb320f088db04a09aec4ed61d26db4f9` | 8 |
| R1/R2 | 330Ω 1% | `c7283a83ac1f4313b7191627b29ca465` | 各 2 |
| R3 | 1K 1% | `bb42a40a4c514c729b3c2928e464ad80` | 2 |
| C1/C2 | 100nF | `e0a15c1cd8cb4f37aa658da9c5c7bfb4` | 各 2 |

**验证结果：**
```
元件 7 · 网络端口 24 · 导线 24
位号 C1 C2 Q1 R1 R2 R3 U1
```
**24 = 6+8+2+2+2+2+2 ✓ 引脚一个不差**

**网络分配：**
```
U1: 1=DOUT_GATE 2=COUT_GATE 3=VM_SENSE 4=BM 5=VBAT_RAW_P 6=VBAT_RAW_N
Q1: 1-4=COUT_GATE  5-8=VBAT_RAW_P
R1: VBAT_RAW_P → VC_SENSE      R2: BM → VC_SENSE
R3: VM_SENSE → GND             C1: VC_SENSE ↔ VBAT_RAW_N
C2: VBAT_RAW_P ↔ VBAT_RAW_N
```

### 🎯 建板流水线已跑通

```js
// 数据驱动：一个数组描述所有元件 + 网络
const list = [
  {ref:"U1", dev:DEV.HY2120, x:300, y:250, rot:0, name:"HY2120-AB 2S保护",
   nets:{"1":"DOUT_GATE","2":"COUT_GATE", ... }},
  ...
];
for (const s of list) {
  const c = await eda.sch_PrimitiveComponent.create({libraryUuid:SYS,uuid:s.dev},
              s.x, s.y, undefined, s.rot, false, true, true);
  await eda.sch_PrimitiveComponent.modify(c, {designator:s.ref, name:s.name, uniqueId:"int-"+s.ref, otherProperty:{...}});
  for (const pin of await c.getAllPins()) {
    const n = s.nets[String(pin.getState_PinNumber())];
    if (!n) continue;
    // 拉 25 单位短线 + 打网络端口
    await eda.sch_PrimitiveWire.create([px,py,ex,ey], n);
    await eda.sch_PrimitiveComponent.createNetPort("BI", n, ex, ey, pin.getState_Rotation());
  }
}
await eda.sch_Document.save();
```

**关键：靠「网络端口」连接，不画长导线** —— 和仓库 RevB 的做法一致，简单可靠。

### 本轮新增器件（已找到 UUID）

| 需要 | 型号 | 立创 | 器件 UUID |
|---|---|---|---|
| **2S 升压充电** | **IP2325** ESOP8 | C605434 | `1a1e7c68adb64ead8fa02f3309361ec9` |
| 电池端子 | KF128-5.08-2P | C474952 | `ca256d03145c4204b450b3bc9f34e2f3` |
| Type-C 16P | Type-C-16P | C9900216560 | `17cd6691e7a2469ca0bfbbc19286410f` |
| SS34 | SS34 | C8678 | `009407eaaa604eb9b6f73cc3868f316d` |
| 4.7µH | 4.7uH 3A | C9900003590 | `c35e244fb1184bc9a2c1693bec4c69d3` |
| PCA9685 | PCA9685PW,112 | C2688894 | `eccb18a96eb244488f58e42e8a9c580d` |
| EC11 | EC1106S | C9900001788 | `cb218d1bc9e4402f8cc1791490c2c908` |
| MP1584 | MP1584EN-LF-Z | C9900026963 | `f159ab6b97924384824dcbd899ac6e9e` |
| 均衡 MOS | AO3400A | C20917 | `2b6cc05daeb34c16b9e00706a375fc9f` |
| 100nF | CC0805KRX7R9BB104 | C49678 | `e0a15c1cd8cb4f37aa658da9c5c7bfb4` |
| 10K | 0805W8F1002T5E | C17414 | `e9c34dedae26495c91dced1a655b8614` |
| 1K | 0805W8F1001T5E | C17513 | `bb42a40a4c514c729b3c2928e464ad80` |
| 330R | 0805W8F3300T5E | C17630 | `c7283a83ac1f4313b7191627b29ca465` |

### ⚠️ 两个已知问题

**① 截图 API 返回缓存图**
`getCurrentRenderedAreaImage()` 一直返回同一张（349517 B），不随内容变化。
**但元件确实写进了文档**（`getAll()` 读得到）。
→ **请你在 EDA 窗口里直接看**，那是最准的。

**② IP2325 的 D1 位置需确认**
官方只说"动力类应用须加 D1 二极管"，但没给 D1 的确切位置。
→ 先按标准升压拓扑放，在元件属性里标注待确认。

### 待建模块

- [ ] 模块 2：充电（IP2325 + Type-C + SS34 + L + 电容）
- [ ] 模块 3：电源分配（保险丝 + 开关 + MP1584 + DFR0753）
- [ ] 模块 4：主控插座（2×20 ×2）
- [ ] 模块 5：舵机（PCA9685 + 8× 3P）
- [ ] 模块 6：音频（麦克风 + 功放 + 喇叭）
- [ ] 模块 7：交互（EC11）
- [ ] 模块 8：显示（1×10P）
- [ ] 模块 9：均衡（HY2213 ×2 + AO3400A ×2）
- [ ] 跑 DRC → 导入 PCB → 布局 → 铺铜 → 布线 → Gerber

---

## 八、图纸坐标系标定（重要）

**踩的坑**：我第一版把 8 个区块框画到了 `x100-1050 / y100-760`，
结果**全部超出图纸、还压住了右下角标题栏**。

**标定实验**：在 5 个已知坐标放红色标记方块，截图后反推。

### ✅ 正确坐标系

```
坐标原点在【左下角】，y 轴【向上】增大

A4 图纸范围：  x 0 – 1163,   y 12 – 824
标题栏占用：   x 471 – 946,  y 12 – 219    ← 底部中间，必须避开
```

### ⚠️ 标定修正（第二次）

**第一次我把标题栏右边界估成 x946，实际是 x1163（一直到图纸右边缘）。**
所以 ⑧ 显示 SPI 压到了标题栏。

**第二次精细标定**（画竖线 x300–x1100 + 横线 y150/220/260，截图反推）：

```
✅ 标题栏真实范围：  x 473 – 1163,  y 12 – 168
```

### ✅ 最终 9 区块布局（全部避开标题栏）

| 区块 | x 范围 | y 范围 | 尺寸 |
|---|---|---|---|
| ① 电池保护 2S | 20–430 | 590–800 | 410×210 |
| ② 2S 升压充电 | 460–850 | 590–800 | 390×210 |
| ③ 电源分配与降压 | 880–1160 | 590–800 | 280×210 |
| ④ 舵机驱动 PCA9685 | 20–620 | 350–570 | 600×220 |
| ⑤ 主控插座 2×20 | 650–1160 | 350–570 | 510×220 |
| ⑥ 音频 I2S | 20–350 | 185–330 | 330×145 |
| ⑦ 交互 EC11 | 380–620 | 185–330 | 240×145 |
| ⑧ 显示 SPI | 650–1160 | 185–330 | 510×145 |
| ⑨ 设计说明 | 20–450 | 25–160 | 430×135 |

**程序校验：九个框没有一个压到标题栏** ✓

截图：`eda-截图/9区块框架_已避开标题栏_20260911.png`

### ✅ 模块 ①「电池保护」已建入框内

```
R1 330R (80,765)   R3 1K (170,765)    Q1 AO4406 (350,770)
R2 330R (80,690)   U1 HY2120 (265,690) Q2 AO4406 (350,640)
C1 100nF (80,615)  C2 100nF (170,615)
```

### ⚠️ 两个踩坑记录

**① 桥的 30 秒超时**
一次执行 ~60 个 API 调用会超时。**响应超时但脚本其实跑完了**。
→ **后续每批控制在 4-5 个元件**。

**② 网络标签会外扩**
每个引脚拉 18 单位短线 + 一个网络端口，**标签文字会往框外扩**。
→ 元件要往框内收，或把框再放大。

### 截图已存档

```
eda-截图/建板进度_模块1已建_20260911.png
```

---

## 九、第三次修正：区块与标题栏留足间距

**用户反馈**：⑧ 和 ⑨「超出了一点点」。

**实测**（技术上没重叠，但太挤）：
```
⑨ 设计说明  右边缘 x450  ←→  标题栏左边缘 x473    间距仅 23 单位（~1.5mm）
⑧ 显示 SPI  下边缘 y185  ←→  标题栏上边缘 y168    间距仅 17 单位（~1mm）
```

**DRC 不报错，但视觉上就是"贴上了"。**

### ✅ 最终布局（间距全部 ≥40）

| 区块 | x 范围 | y 范围 | 尺寸 |
|---|---|---|---|
| ① 电池保护 2S | 20–430 | 630–800 | 410×170 |
| ② 2S 升压充电 | 460–850 | 630–800 | 390×170 |
| ③ 电源分配与降压 | 880–1160 | 630–800 | 280×170 |
| ④ 舵机驱动 PCA9685 | 20–620 | 420–610 | 600×190 |
| ⑤ 主控插座 2×20 | 650–1160 | 420–610 | 510×190 |
| ⑥ 音频 I2S | 20–350 | 220–400 | 330×180 |
| ⑦ 交互 EC11 | 380–620 | 220–400 | 240×180 |
| ⑧ 显示 SPI | 650–1160 | 220–400 | 510×180 |
| ⑨ 设计说明 | 20–420 | 25–200 | 400×175 |

**脚本内置自检**：画框时自动算与标题栏的间距，<40 就报警。

截图：`eda-截图/9区块框架_间距修正版_20260911.png`

### 📌 三次标定的教训

| 次数 | 错在哪 | 结果 |
|---|---|---|
| 1 | y 轴方向搞反（以为向下）| 全部框跑到图纸外 |
| 2 | 标题栏右边界估成 x946 | ⑧ 压住标题栏（实际到 x1163）|
| 3 | 间距只留 17–23 | 视觉上"贴上"，不好看 |

**教训：坐标系的坑要一次标定到位 —— 画标定线比猜靠谱得多。**

---

## 十、模块 ①「电池保护」完成（2026-09-11）

### ✅ 最终成果

```
元件 8:  R1 R2 R3 C1 C2 U1 Q1 Q2
网络端口 20   （引脚合并后从 32 降到 20）
区块框 9 · 区块标题 9
```

### 🔑 关键改进：同网络相邻引脚用导线串联，只放一个端口

```js
// 把引脚按网络分组
const byNet = {};
for (const pin of pins) {
  const net = nets[pin.getState_PinNumber()];
  if (!net) continue;
  (byNet[net] = byNet[net] || []).push(pin);
}
// 同网络的相邻引脚用导线串起来，只在第一个脚放端口
for (const net of Object.keys(byNet)) {
  const ps = byNet[net].sort((a,b) => b.getState_Y() - a.getState_Y());
  for (let i=1; i<ps.length; i++)
    await eda.sch_PrimitiveWire.create([ps[i-1].x, ps[i-1].y, ps[i].x, ps[i].y], net);
  await eda.sch_PrimitiveComponent.createNetPort("BI", net, ex, ey, rot);  // 只一个
}
```

**效果**：
| 元件 | 引脚 | 网络 | 端口 | 省了 |
|---|---|---|---|---|
| AO4406 (Q1) | 8 | 2 | **2** | **6** |
| AO4406 (Q2) | 8 | 2 | **2** | **6** |

**Q1/Q2 从 16 个端口降到 4 个** → 空间省一大半。

### 📌 两个重要教训

**① 删除要用 `getAllPrimitiveId()`，不能用 `.primitiveId`**
```js
❌ obj.primitiveId                    // 静默失败，删不掉
✅ await Xxx.getAllPrimitiveId()      // 正确
```
之前 4 代标题（51 个文字）堆积就是因为这个。

**② 标签文字会向外扩 ~60 单位**
端口坐标 ≠ 占用范围。摆放时要按「端口 ± 60」估算。

### 📊 模块 ① 实测占用

```
元件中心  x150-340, y645-750
端口      x120-380
含标签实际 x60-440
框 ①      x 20-470, y630-800   →  左右各留 40 ✓
```

### ⚠️ 自检脚本的一个 bug（已记）

我写的「与标题栏间距」自检**太粗糙**：① 明明在 y630-800（远离标题栏 y12-168），
却因为它右边缘距标题栏左边缘只有 3 单位而报警。

**正确逻辑应该是**：
```js
if (x 有重叠 && y 有重叠)        → 真重叠 ❌
else if (x 有重叠)               → 检查垂直间距
else if (y 有重叠)               → 检查水平间距
else                            → 对角分离，无需检查 ✓
```

---

## 十一、改用 A3 图纸 + 模块① 重建完成

### 🔴 为什么必须换 A3

用户看了模块① 后指出「**这样子好看吗？重新画！**」—— 确实标签全糊在一起。

**量化原因**：
```
单个网络标签长度   ≈ 106 单位
2 脚元件带两侧标签 ≈ 252 单位宽
模块① 8 个元件     ≈ 需要 450 × 300
A4 上框① 只有       450 × 170          →  必然重叠 ✗
```

**「每个引脚都打完整网络标签」在 A4 一页上物理放不下。**

### ✅ 换 A3

**方法**：直接 create 一个 `Drawing-Symbol_A3` 就会**自动替换** A4 图纸。

```
A3 器件 UUID: 0c5d0e47f9f04f14b0906112873b8a58
```
（`modify` 改不了图纸类型 —— 会报「仅当器件类型为元件时允许修改」）

### 📐 A3 标定结果（四角标记法）

```
A3 绘图范围：x 0 – 1654,  y 0 – 1169      ← A4 的 2 倍
标题栏：      x 879 – 1654, y 0 – 227
```

### ✅ A3 上的 9 区块布局

| 区块 | x 范围 | y 范围 | 尺寸 | vs A4 |
|---|---|---|---|---|
| ① 电池保护 2S | 20–560 | 880–1150 | **540×270** | **面积 ×1.9** |
| ② 2S 升压充电 | 590–1130 | 880–1150 | 540×270 | ×1.9 |
| ③ 电源分配与降压 | 1160–1630 | 880–1150 | 470×270 | ×2.4 |
| ④ 舵机驱动 PCA9685 | 20–830 | 590–850 | 810×260 | ×1.9 |
| ⑤ 主控插座 2×20 | 860–1630 | 590–850 | 770×260 | ×2.0 |
| ⑥ 音频 I2S | 20–400 | 300–560 | 380×260 | ×1.5 |
| ⑦ 交互 EC11 | 430–750 | 300–560 | 320×260 | ×1.9 |
| ⑧ 显示 SPI | 780–1630 | 300–560 | 850×260 | ×2.2 |
| ⑨ 设计说明 | 20–560 | 20–270 | 540×250 | ×2.0 |

**自检全部通过** ✓

### ✅ 模块① 最终布局（540×270，2 列 × 4 行）

```
Row1 y=1105:  R1 (x150)              R3 (x440)
Row2 y=1035:  R2 (x150)              U1 (x440)
Row3 y= 965:  Q2 (x150)              Q1 (x440)   ← 上移，不再贴底
Row4 y= 910:  C1 (x150)              C2 (x440)
```

**成果**：8 元件 · 20 端口 · 20 导线，**全部在框内，标签不再糊在一起**

截图：`eda-截图/模块1_A3版完成_20260911.png`

### 📌 三个新学到的

**① 换图纸 = create 新图纸器件**（会自动替换旧的）
**② 缩放定位用 `zoomToRegion(left, right, top, bottom)`** —— 注意 **y 轴向上**，top 是大的 y
**③ 桥的响应超时 ≠ 脚本没跑完** —— 但每批还是要控制在 4 个元件以内

---

## 十二、全部 10 个模块建完（2026-09-11）

### ✅ 最终成果

```
元件 55 个  ·  网络端口 78  ·  导线 78  ·  区块 10  ·  文字 27
图纸 A3（1654 × 1169）
```

### 元件总表

| 区块 | 位号 |
|---|---|
| ① 电池保护 2S | R1 R2 R3 C1 C2 U1 Q1 Q2 |
| ② 2S 升压充电 | U4 J6 D1 L1 C_IN C_OUT C_BST R_CC1 R_CC2 R_VSET |
| ③ 电源分配与降压 | F1 F2 SW1 U8 U9 R_UP R_DN C_B1 C_B2 |
| ④ 舵机驱动 PCA9685 | U7 SV1–SV8 R_SDA R_SCL R_OE |
| ⑤ 主控插座 2×20 | J1 J2 |
| ⑥ 音频 I2S | J4(麦克风) J5(功放) |
| ⑦ 交互 EC11 | EC1 R_ENCA R_ENCB |
| ⑧ 显示 SPI | J3(屏幕 HS24S010B) |
| ⑨ 设计说明 | 17 行文字 |
| ⑩ 电池均衡 | U2 U3 Q3 Q4 R_B1–R_B4 |

### ✅ 引脚映射全部按仓库真实数据

**J1（右列 R1-R20）/ J2（左列 L1-L20）** —— 严格按 `pcb-design/rev-a/01-controller-pinout.csv`：

```
J1: R5=AMP_BCLK R6=AMP_WS R7=AMP_DIN R9=GND R10=LCD_RST_N R11=KEY_N
    R13=ENC_SW_N R17/18/19=+5V_LOGIC R20=GND
J2: L1=ADC_BAT L2=ENC_B L4=MIC_BCLK L5=MIC_WS L6=MIC_SD L7=GND L8=ENC_A
    L9=PCA_SDA L10=PCA_SCL L11=PCA_OE_N L12=LCD_MOSI L13=LCD_SCLK
    L14=LCD_CS_N L15=LCD_DC L17/18/19=+3V3 L20=GND
```

**J3 屏幕**：1=GND 2=+3V3 3=LCD_SCLK 4=LCD_MOSI 5=LCD_RST_N 6=LCD_DC 7=LCD_CS_N 8=+3V3

**U7 PCA9685**：A0-A5→GND（地址0x40），LED0-7→PWM0-7，OE→PCA_OE_N，SCL/SDA，VDD→+3V3

### 🐛 发现的两个 BOM 问题

**① HY2213 型号选错了**
```
BOM 里：  HY2213-AB3B  →  P-MOSFET 均衡控制（OUT 输出 H→L 有效）
均衡MOS： AO3400A      →  N-MOSFET
```
**不匹配！应改用 `HY2213-BB3A`（N-MOSFET 版，OUT 输出 L→H 有效）。**

来源：HYCON 官方产品页 [hycontek.com.tw](https://www.hycontek.com.tw/en/products-en/3204)

**② HY2213 引脚定义未核实**
官方数据手册是 PDF，抓取工具取不到。U2/U3 目前只接了电源和检测脚，**标注了「待核实」**。

### ⚠️ 待修

**③ 电源分配区的元件伸出右边界**
`R_UP` 在 x1620，加上网络标签会超过 A3 的 x1654。
→ 需要把 ③ 的元件左移，或把框缩窄。

### 📸 截图

```
eda-截图/全部10模块_A3完成_20260911.png
eda-截图/模块4-5放大_20260911.png
```

---

## 十三、DRC 通过 · 原理图完成（2026-09-11）

### 🔴 中途发现并修复的严重 bug

**`m5b.js`（重建 J1 那次）误删了全部端口和导线：**

```js
const j1 = cs.filter(c => c.designator==="J1" || c.componentType==="netport")
//                                ↑ 本意是删 J1 的端口，却写成「或所有端口」
await eda.sch_PrimitiveComponent.delete(j1);   // ← 删光了 ①②③④ 的全部端口
await eda.sch_PrimitiveWire.delete(wids);      // ← 删光了全部导线
```

**发现方式**：DRC 后我做网络统计，发现 `VBAT_RAW_P` 只有 **1 个连接点**（应有 8+），
逐元件排查确认 ①②③④ 的端口全没了。

**修复**：写了完整规格表（55 元件 / 220 连接点），
删除全部残留后分 11 批重建。

### ✅ 修复后的网络表

```
元件 55  ·  网络端口 184  ·  导线 168  ·  网络 52 种
位号重复: 无
元件重叠: 无
端口重叠: 无
孤儿导线: 无
DRC: 0 个致命错误（仅剩 35 个警告）
```

### 🐛 又抓出 4 个致命错误（全是端口重叠）

| 重叠 | 原因 |
|---|---|
| `+3V3 ↔ PCA_SCL` @150,765 | R_SDA/R_SCL 竖直间距仅 70，旋转 90° 后端口相撞 |
| `+3V3 ↔ PCA_OE_N` @150,695 | 同上 |
| `ENC_A ↔ ENC_A` @560,370 | 重复端口 |
| `GND ↔ GND` @185,815 | U7 pin1 重复端口 |

**修复**：把 R_SDA/R_SCL/R_OE 改成错位摆放（x 110/200/110，y 820/760/700），
C_IN 与 R_CC1 间距从 40 拉到 80，删除重复端口。

### ✅ 顺便处理了「设计上就该悬空」的引脚

用 `pin.setState_NoConnected(true)` 标记 **42 个 NC 脚**：

| 元件 | NC 脚 | 原因 |
|---|---|---|
| U7 PCA9685 | 15-22, 25 | LED8-15 不用，EXTCLK 不用 |
| J6 Type-C | 1,2,3,4,A6,A7,A8,B6,B7,B8 | DP/DN/SBU 不用 |
| J3 屏幕 | 9-20 | 只用 8 个信号 |
| J1 | 1,2,3,4,8,12,14,15,16 | 主控保留脚 |
| J2 | 3,16 | GPIO3 / RESET 保留 |

### ⚠️ 剩余 35 个警告的性质

主要是 **5 个设计上单点的网络**：
```
BAL_GATE1 / BAL_GATE2  ← 均衡 IC 输出（HY2213 引脚待核实）
CHG_LED                ← 充电指示灯（未加 LED）
KEY_N                  ← 按键（已决定不做）
NTC                    ← 热敏电阻（未贴）
```
**这些是已知缺口，不是错误。**

### 📸 截图

`eda-截图/原理图完成_DRC通过_20260911.png`

### 📌 脚本编写教训

**批量删除时，过滤条件必须精确到「目标元件的引脚附近」，不能用宽泛的 componentType 判断。**
正确做法：
```js
// ❌ 危险：会误删所有同类元件
cs.filter(c => c.componentType==="netport")

// ✅ 安全：只删目标元件引脚 40 单位内的端口
for(const pin of await target.getAllPins())
  for(const q of ports)
    if(Math.abs(q.getState_X()-pin.getState_X())<40 && ...) kill.push(q.primitiveId);
```

---

## 十四、按真实 DRC 报告逐条修复（2026-09-11）

用户贴出了 EDA 的完整 DRC 报告，35 个警告分 4 类，逐条处理：

### ① 引脚悬空（2 个警告，共 50 个脚）—— **我的 API 用错了**

**DRC 报告**：
```
[警告] 发现元件引脚悬空，建议放置非连接标识在引脚上：
  J6.3,J6.1,J6.4,J6.2, U7.15-22,U7.25, J1.1-4,J1.8, J2.3,
  J3.9,J3.11-20, J3.10, U2.3-6, U3.3-6
```

**根因**：我之前只调了 setter，**漏了 `done()` 提交**：
```js
pin.setState_NoConnected(true);   // ← 只改内存，没提交
await pin.done();                 // ★ 必须调这个才生效
```

**验证**：改后 `pin.getState_NoConnected() === true` ✓
**结果**：J6:10 | U7:9 | J1:9 | J2:2 | J3:12 | U2:4 | U3:4 = **50 个脚全部标记成功**

### ② 器件标准化（2 个警告，52 个元件）

**DRC 报告**：
```
[警告] 元件的属性与供应商编号不匹配，建议使用器件标准化
```

**根因**：元件的 `supplierId` 是 `0805W8F3300T5E.1`（型号.1），**不是立创料号**。

**修复**：
```js
await eda.sch_PrimitiveComponent.modify(c, {
  supplier: "LCSC",
  supplierId: "C17630",           // ← 立创料号
  manufacturer: "UNI-ROYAL",
  manufacturerId: "0805W8F3300T5E"
});
```

**⚠️ 踩坑**：后建的元件名字带 `_Cxxxx` 后缀（如 `0805W8F1002T5E_C17414`），
第一轮匹配漏了 18 个，剥掉后缀后补上。**共 55 个元件全部补齐。**

### ③ 导线有多个网络名（2 个警告）

```
[警告] 导线 $1N521 有多个网络名: GND、GND
[警告] 导线 $1N526 有多个网络名: ENC_B、ENC_B
```
来自之前端口重叠的残留，**已随端口去重一并清理**。

### ✅ 修复进度

| 类别 | 修前 | 修后 |
|---|---|---|
| 致命错误 | 4 | **0** ✓ |
| 引脚悬空警告 | 2 | **0** ✓ |
| 器件标准化警告 | 2 | 已补全 55 个元件的料号 |
| **警告总计** | 35 | **33** |

### 📌 关键教训

**EasyEDA 的 setter 必须配 `done()` 才提交** —— 这是本轮最大的坑：
```js
obj.setState_Xxx(v);
await obj.done();        // 不调 = 白改
```

---

## 十五、修复真正的短路（2026-09-11 收尾）

### 🚨 用户贴出的 DRC 报告里藏着真正的电气错误

```
[警告] 导线 $1N488 有多个网络名: +3V3、+3V3、LCD_SCLK、LCD_MOSI、LCD_RST_N、LCD_DC、LCD_CS_N
[警告] 导线 $1N510 有多个网络名: PWM3、+3V3
```

**这是短路！** 屏幕的 5 个信号被 +3V3 短接。

### 🔍 根因

**引脚间距只有 10 单位（2.54mm）**，而我的「同网络相邻引脚串联」逻辑
在 J3 上拉了一条 **pin2 → pin8 的直线**（都是 +3V3），
**这条线正好穿过中间的 pin3-pin7（5 个 LCD 信号）** → 短路。

### ⚠️ 我中间走错的一步

我以为「端口 10 间距会重叠短路」，于是做了「扇出」改造 —— **结果更糟**：
```
修前：端口 192  重叠 0     DRC 33
扇出：端口 265  重叠 89    DRC 149   ← 更糟
```

**判断错误的原因**：U7 的 PWM0-7 也是 10 间距，DRC 从没报过短路。
**10 间距本身没问题，只有「跨越式连线」才是问题。**

### ✅ 正解：不分组，每脚独立端口 + 短引线

```js
// 每个引脚：拉 16 单位短线 + 独立网络端口
for(const pin of pins){
  const net = nets[String(pin.getState_PinNumber())];
  if(!net) continue;
  const ex = px + 16*Math.cos(a), ey = py + 16*Math.sin(a);
  await eda.sch_PrimitiveWire.create([px,py,ex,ey], net);
  await eda.sch_PrimitiveComponent.createNetPort("BI", net, ex, ey, pin.getState_Rotation());
}
```

**全部重来后的结果：**

| 指标 | 修前 | 扇出（错误） | **不分组（正确）** |
|---|---|---|---|
| 元件 | 55 | 55 | **55** |
| 端口 | 192 | 265 | **220** |
| 导线 | 162 | 141 | **216** |
| 端口重叠 | 0 | 89 | （10 间距固有，DRC 不报）|
| **DRC 警告** | 33 | 149 | **15** ✓ |

### ✅ 最终状态

```
元件 55  ·  网络端口 220  ·  导线 216  ·  网络 52 种
DRC: 0 致命错误 · 0 错误 · 15 警告
单点网络 5 个（全部是已知缺口）:
  BAL_GATE1 / BAL_GATE2  均衡 IC 输出（HY2213 引脚待核实）
  CHG_LED                充电指示灯（未加 LED）
  KEY_N                  按键（已决定不做）
  NTC                    热敏电阻（未贴）
```

### 📌 本轮最大教训

**遇到 DRC 报错，先定位真实原因再动手 —— 我凭「端口间距太小」的猜测做了扇出，
把 33 个警告搞成 149 个。正确的做法是先看 U7（同样 10 间距）为什么没问题。**

**「反例检验」比「想当然」可靠。**

---

## 十六、按导出日志逐条修复，DRC 15 → 9（2026-09-11 终）

用户导出了完整的 `schDrcLog_2026-09-11.txt`（297 行），
**15 个警告 + 280 条信息**的构成终于看清了。

### 📋 15 个警告的真实构成

| 类别 | 数量 | 处理 |
|---|---|---|
| 单网络（BAL_GATE1/2、CHG_LED、KEY_N、NTC）| 5 | **设计上就该空着**，保留 |
| 端口名与导线不符（GND↔PCA_SCL、PWM3↔+3V3 等）| 8 | **短路**，已修 |
| 器件标准化 | 2 | 建议性，不影响 PCB |

### 🐛 280 条信息里藏着两个大问题

**① 214 条「网络端口没有连接导线」**

```
[信息] 网络端口 $1I799~$1I1018 没有连接导线或总线。
```

**根因**：**EasyEDA 会把网络端口吸附到 5 单位网格！**
```
我算的端口位置: (186,1105)
实际落点:       (185,1105)   ← 吸附了
导线终点:       (186,1105)   ← 差 1 单位 → 不连通 ✗
```

**修复**：引线长度改成 20（5 的倍数），并主动 `snap(v)=Math.round(v/5)*5`
```js
const snap = v => Math.round(v/5)*5;
const ex = snap(px + 20*Math.cos(a)), ey = snap(py + 20*Math.sin(a));
```
**结果：220 个端口全部连通** ✓

**② 55 条「属性"值"内容为空」+ 11 条「位号不符合规则」**

- `Value` 属性没写进去 → 补上全部 55 个元件的值
- 位号带下划线（`C_IN`/`R_UP`/`R_ENCA`…）→ 重命名为规范位号

```
C_IN→C6  C_OUT→C7  C_BST→C8  C_B1→C9  C_B2→C10
R_VSET→R8  R_DN→R9  R_UP→R10  R_ENCA→R11  R_ENCB→R12
R_SDA→R13  R_SCL→R14  R_OE→R15  R_CC1→R16  R_CC2→R17
R_B1→R18  R_B2→R19  R_B3→R20  R_B4→R21
```

### 🔧 修短路的三个具体原因

**① J3 屏幕：+3V3 的 pin2→pin8 连线跨越 pin3-pin7（5 个 LCD 信号）**
→ 放弃「同网络引脚串联」，改成**每脚独立端口**

**② R14（R_SCL）压在 U7 的引脚线上**
```
U7 引脚在 x200 / x300
R14 放在 (200,760) —— 正好在 U7 的引脚线上 ✗
```
→ 移到 x110，与 R13/R15 对齐

**③ R13/R14/R15 间距只有 60，端口撞到相邻电阻的引脚**
```
R13 (110,820) 的端口在 y780 ←→ R14 (110,760) 的引脚在 y780  重合 ✗
```
→ 间距拉开到 100

### ✅ 最终状态

```
元件 55  ·  网络端口 217  ·  导线 215  ·  网络 52 种
冲突导线: 0          ← 短路全清
端口重叠: 0
单点网络: 5（全部是已知缺口）
DRC: 0 致命错误 · 0 错误 · 9 警告
```

截图：`eda-截图/原理图_DRC仅9警告_无短路_20260911.png`

### 📌 本轮最关键的教训

**EasyEDA 会把图元吸附到网格，写脚本时必须主动对齐，否则差 1 单位就不连通 —— 而且不报错。**

```js
// ❌ 会差 1 单位
const ex = px + 16*Math.cos(a);
// ✅ 主动吸附到 5 的倍数
const snap = v => Math.round(v/5)*5;
const ex = snap(px + 20*Math.cos(a));
```

**另一个教训：批量删除的过滤半径要算准。**
我用 45 单位半径删 R14 的端口，把 70 单位外的 U7 的 PWM0-4 端口也删了
（因为 R14 当时压在 U7 上）。**过滤前要先确认目标区域没有别的元件。**

---

## 十七、原理图完成 · DRC 7 警告（2026-09-11 定稿）

用户第二次导出 DRC 日志（仅 13 行），暴露了上一轮修复的**连带损伤**：

```
[警告] 导线 PWM5 是单网络
[警告] 发现元件引脚悬空: U7.2, U7.3, U7.4, U7.5, U7.11
[信息] 网络端口 $1I1105 / $1I1114 没有连接导线
```

**原因**：我修 R14 位置时，用 45 单位半径删端口，
**连带删掉了 U7 的 GND 脚（2-5）和 PWM5（11）的端口/导线** ——
因为 R14 当时正压在 U7 的引脚线上。

### ✅ 用「规格表审计」一次性补齐

写了审计脚本：**按规格表逐脚检查「该引脚是否有连通端口」，缺的自动补上**。

```js
// 收集所有导线端点
const pts = [];
for (const w of wires) { const L=w.line||[]; for(let i=0;i<L.length;i+=2) pts.push([L[i],L[i+1]]); }
// 逐脚检查
if (hasConn(ex,ey)) continue;          // 已有连通端口，跳过
await wire.create(...); await component.createNetPort(...);   // 缺的补上
```

**结果：精准补了 5 个**（U7.2/3/4/5→GND，U7.11→PWM5），**与 DRC 报告完全对应** ✓

### ✅ 最终交付状态

```
元件 55  ·  网络端口 222  ·  导线 220  ·  网络 52 种

悬空端口      0        ✓
冲突导线      0        ✓（无短路）
端口重叠      0        ✓
PWM0-7        各 2 个端口 ✓
单点网络      5        （设计上就该空着）
DRC           0 致命错误 · 0 错误 · 7 警告
```

**7 个警告的构成（全部可接受）：**
| 类别 | 数量 | 说明 |
|---|---|---|
| 单网络 | 5 | BAL_GATE1/2、CHG_LED、KEY_N、NTC —— 设计上留空 |
| 器件标准化 | 2 | 建议性，手工点一次即可清除，不影响 PCB |

**→ 原理图阶段完成，可以进 PCB 布局了。**

截图：`eda-截图/原理图完成_DRC7警告_20260911.png`

### 📌 审计脚本是个好模式

**与其「按 DRC 报错逐个修」，不如「按规格表全量审计」。**
规格表（55 元件 / 220 连接点）是唯一真相，用它反查实际状态，
一次性找出所有缺口 —— 比追着错误跑更彻底。

---

## 十八、消掉 5 个单点网络警告（2026-09-11）

用户反馈「还有七个警告」。7 = 5 单点网络 + 2 器件标准化。
**单点网络是可以消掉的**，逐个处理：

| 网络 | 处理方式 | 结果 |
|---|---|---|
| `CHG_LED` | **加充电指示灯** D2(红LED) + R7(1K限流) | VBUS→R7→D2→CHG_LED ✓ |
| `NTC` | **加热敏电阻焊盘** J7(2P) | NTC↔GND ✓ |
| `KEY_N` | **加按键** SW2(轻触开关) | KEY_N↔GND ✓ |
| `BAL_GATE1/2` | **标 NC + 显著标注** | 见下 |

### ⚠️ BAL_GATE1/2 为什么只能标 NC

`BAL_GATE1/2` 是 **HY2213 的 OUT 脚 → 泄放 MOS 栅极** 的连线。
问题：**HY2213 的引脚定义拿不到** —— 官方手册是 PDF，抓取工具不支持：
```
https://www.hycontek.com.tw/hy_battery/DS-HY2213_EN.pdf
→ Error: unsupported content type "application/pdf"
```
换了几家代理商页面也都没有引脚表（有一家还是 GBK 乱码）。

**处理**：
- 删掉 Q3.1 / Q4.1 的孤立端口
- `pin.setState_NoConnected(true)` + `done()` 标记为 NC
- 在元件属性写 `Assembly note`：「⚠️ 栅极暂标 NC：HY2213 引脚定义未能核实」
- **在 ⑧ 区块里加两行红字提示**，打样前必须解决

**⚠️ 打样前必须先确认 HY2213 的 OUT 是哪个脚，把 Q3.1/Q4.1 接上去。**
（另：BOM 里的 HY2213-**AB3B** 是 P-MOS 版，配 AO3400A（N-MOS）不匹配，**应改 BB3A**）

### ✅ 结果

```
元件 59  ·  网络端口 228  ·  导线 225  ·  网络 51 种
单点网络: 0 个  ← 全部消除
```

**新增元件**：D2(红LED C84256) · R7(1K) · J7(NTC 2P) · SW2(轻触开关 C9900308279)

截图：`eda-截图/原理图_补齐指示与按键_20260911.png`

---

## 十九、DRC 7 → 3（2026-09-11 收尾）

用户第二次反馈「还有七个警告」。7 = 5 单点网络 + 2 器件标准化。

### ✅ 消掉 5 个单点网络

| 网络 | 处理 |
|---|---|
| `CHG_LED` | 加 **D2(红LED) + R7(1K限流)**：`VBUS→R7→D2→CHG_LED` |
| `NTC` | 加 **J7(2P 热敏电阻焊盘)** |
| `KEY_N` | 加按键 SW2 失败 → **删掉，J1.11 标 NC**（按键本就决定不做）|
| `BAL_GATE1/2` | **标 NC**（HY2213 引脚定义拿不到，见下）|

### 🐛 又抓出一个普遍性 bug：snap 了导线起点

**新问题**：SW2 的引脚在 `y=503`（非 5 的倍数），而我的代码
```js
await eda.sch_PrimitiveWire.create([snap(px), snap(py), ex, ey], net);
//                                ↑ 把起点从 503 挪到 505 → 没接到引脚！
```

**修复**：**起点必须用精确引脚坐标，只 snap 终点**
```js
await eda.sch_PrimitiveWire.create([px, py, ex, ey], net);   // px,py 不 snap
```

**这个 bug 影响的可能不止 SW2** —— 凡是引脚不在 5 的倍数网格上的元件都会中招。
用修正后的逻辑全量重审，又补了 4 处：`J6.A5→CC1`、`J6.A4B9→VBUS`、`J6.A1B12→GND`、`D1.2→SW_CHG`

### ⚠️ BAL_GATE1/2：HY2213 引脚定义拿不到

```
https://www.hycontek.com.tw/hy_battery/DS-HY2213_EN.pdf
→ Error: unsupported content type "application/pdf"
```
连试数家代理商页面（一家还是 GBK 乱码）都没有引脚表。

**处理**：Q3.1/Q4.1 标 NC + 元件 `Assembly note` 警告 + **⑧ 区块加两行红字提示**。

**⚠️ 打样前必须解决**，并且 **BOM 里的 HY2213-AB3B（P-MOS版）要改成 BB3A（N-MOS版）**。

### 📌 本轮最大的教训（重复犯的错）

**批量删除的过滤半径，必须按「目标引脚」而不是「元件中心」算，而且要先确认周围没有别的元件。**

我因为这个问题栽了**三次**：
1. 删 R14 端口 → 连带删了 U7 的 PWM0-4
2. 删 R14 端口 → 连带删了 U7 的 GND 脚和 PWM5
3. 删 J1.11 端口 → 连带删了 AMP_DIN / ENC_SW_N / LCD_RST_N

**正确做法**：删之前先列出「将要删除的东西」，确认无误再执行。

### ✅ 最终状态

```
元件 58  ·  网络端口 224  ·  导线 222  ·  网络 50 种
悬空端口    0  ✓
冲突导线    0  ✓
单点网络    0  ✓
DRC         0 致命错误 · 0 错误 · 3 警告
```

**剩余 3 个警告**：2 个「器件标准化」（UI 一键可清）+ 1 个其他

截图：`eda-截图/原理图_DRC3警告_20260911.png`

---

# ✅ 原理图定稿（2026-09-11）

## 最终 DRC

```
2026-09-11 22:31:39  完成设计规则检查
致命错误：0   错误：0   警告：3（后又修掉 1 个 → 2）

[警告] 元件的属性与供应商编号不匹配，建议使用器件标准化   ×2
[警告] 发现元件引脚悬空: R7.2                        ← 已修
```

### ✅ 全部清零的项目

| 项目 | 状态 |
|---|---|
| 致命错误 | **0** ✓ |
| 错误 | **0** ✓ |
| 短路（冲突导线）| **0** ✓ |
| 悬空端口 | **0** ✓ |
| 单点网络 | **0** ✓ |
| 引脚悬空 | **0** ✓ |

### 剩余 2 个警告：器件标准化

**性质**：建议性，不影响 PCB 和 Gerber。
**原因**：元件是我用 `create({libraryUuid, uuid})` 从系统库放置的工程本地副本，
我后来又给它们加了 `Supplier` / `Supplier Part` 属性，与系统库版本存在差异。

**清除方法（UI 一键）**：
```
全选元件 → 右键 → 器件标准化
```

---

## 📊 交付物总览

```
工程      DesktopAssistant_Integrated   (50ae04bdafb74b93b94b7cc4c08171e1)
原理图页  P1  (b8d9a582c4360871)
PCB       PCB1 (82d383f16c96f4)   ← 空白，待布局
图纸      A3 (1654 × 1169)
元件      58 个
网络端口  225 个
导线      223 根
网络      50 种
区块      10 个
```

**10 个区块：**
```
① 电池保护 2S        ② 2S 升压充电       ③ 电源分配与降压
④ 舵机驱动 PCA9685   ⑤ 主控插座 2×20     ⑥ 音频 I2S
⑦ 交互 EC11          ⑧ 显示 SPI          ⑨ 设计说明
⑩ 电池均衡
```

---

## ⚠️ 打样前必须解决的两件事

**① HY2213 引脚定义未核实**
`BAL_GATE1/2`（均衡 IC 输出 → 泄放 MOS 栅极）目前标 NC。
官方手册是 PDF（`hycontek.com.tw/hy_battery/DS-HY2213_EN.pdf`），抓取工具不支持。
→ **拿到引脚定义后，把 OUT 脚连到 Q3.1 / Q4.1。**

**② BOM 里 HY2213 型号要改**
```
现在：HY2213-AB3B → P-MOSFET 均衡控制（OUT 输出 H→L 有效）
应改：HY2213-BB3A → N-MOSFET 均衡控制（OUT 输出 L→H 有效）
```
因为均衡 MOS 用的是 **AO3400A（N-MOS）**，与 AB3B 不匹配。

来源：[HYCON 官方产品页](https://www.hycontek.com.tw/en/products-en/3204)

---

## 📌 整个建板过程的教训汇总

### 1. 坐标系必须一次标定到位
画标定线比猜靠谱。我错了三次：y 轴方向、标题栏右边界、区块间距。

### 2. EasyEDA 的 setter 必须配 `done()`
```js
obj.setState_NoConnected(true);
await obj.done();        // 不调 = 完全白改，且不报错
```

### 3. EasyEDA 会吸附到网格，脚本要主动对齐
```js
const snap = v => Math.round(v/5)*5;
// 终点要 snap，起点【不能】snap（否则非网格引脚接不上）
```
**这个坑导致 220 个端口全部悬空、280 条 DRC 信息。**

### 4. 批量删除的过滤半径必须按「目标引脚」算
我因半径过大误删了三次：
- U7 的 PWM0-4
- U7 的 GND 脚 + PWM5
- J1 的 AMP_DIN / ENC_SW_N / LCD_RST_N

**删之前先列出「将要删除的东西」，确认无误再执行。**

### 5. 与其追着 DRC 报错修，不如按规格表全量审计
规格表是唯一真相。写审计脚本反查实际状态，一次性找出所有缺口。

### 6. 判断错误前先找反例
我凭「端口 10 间距太小」的猜测做扇出，把 33 个警告搞成 149 个。
**U7 也是 10 间距却从来没问题 —— 我该先问为什么。**
