xaiojie/papabot/pcb-design/integrated-v1/LAYOUT.md

# 单板全集成 v1 · 布局草案

> **2026-09-12 V1.2 无旋钮更新：** 五页原理图及 110×75 mm 双层 PCB 已完成，原理图/PCB 原生 DRC 严格通过。当前为 79 个器件、310 个引脚、59 个有连接网络；EC11 及三个上拉电阻、相关走线与定位孔均已移除。HS24S010B 使用单排 10PIN 屏幕接口，经主板 XH-10A 线束连接。准确工程、BOM、Gerber 与接线资料见 [V1.2 无旋钮交付](final-no-encoder-2026-09-12/README.md)。下文保留设计历史，其中旋钮、旧型号/针序、旧数量与“PCB 未完成”等描述均已被本次交付替代。

板框 **110 × 75 mm**，2 层 / **2oz** 铜。（原定 100×75，装箱计算后改为 110×75 —— 见 README 第十节）

> 📌 **定稿图**：[摆放框图.html](摆放框图.html) / [摆放框图.png](摆放框图.png)

> 尺寸分三档：**【实测】**（我自己量的，已自校验）、**【核实】**（厂家/手册）、**【待核】**（需实物或问商家）

---

## 一、已知尺寸汇总

| 器件 | 尺寸 | 档位 | 来源 |
|---|---|---|---|
| ESP32-S3 开发板 | **20.5 × 51.9 mm** | **【实测】** | 立创封装图，2.54 针距标定自校验 |
| 1×20P 母座 | 50.8 × 2.54 mm，塑高 8.5 | **【实测】** | 同上 |
| 格氏 ACE 800mAh 2S | 60 × 32 × 16 mm | 【核实】 | 商品页，未实测 |
| 喇叭 | Ø23.6 × 10.4 mm | 【核实】 | 商家参数 |
| EC11 编码器 | 本体 11.7 × 12.5 × 7 mm，轴 Ø6 | 【核实】 | 标准件规格 |
| PCA9685 模块 | 约 62.5 × 25.5 mm | **【待核】** | Adafruit 规格，HANLI 克隆需实物 |
| DFR0753 | 未知 | **【待核】** | 官方未给尺寸 |

| **新屏幕模组（HS24S010B）** | **43.5 × 72.9 mm** | **【实测】** | 立创封装图 C5329587 + 2.54 针距标定 |
| **麦克风 SEN0327** | **Ø14 mm** | 【核实】 | DFRobot 页面 + 仓库记录 |
| **功放 MAX98357A 模块** | **19.4 × 17.8 × 3.0 mm** | 【核实】 | Adafruit 官方 |
| **充电 IC PW4584A** | SOP8-EP | 【核实】 | 平芯微规格书 |
| **保护 IC PW7120** | SOT23-6L | 【核实】 | 平芯微规格书 |
| **均衡 IC PW2213 ×2** | SOT23-6L | 【核实】 | 平芯微规格书 |

---

## 二、模组占位估算（用于摆放）

按「模块 + 插座 + 走线余量」估算：

| 器件 | 占位（含余量）|
|---|---|
| ESP32 开发板 + 2×20 插座 | **56 × 26 mm**（插座比板宽）|
| PCA9685 模块（含插座）| **65 × 28 mm** |
| DFR0753 | **35 × 25 mm** |
| 逻辑 5V 降压 | **15 × 12 mm** |
| 保护 IC + 双 MOS | **18 × 22 mm** |
| 充电 IC + 电感 | **20 × 15 mm** |
| Type-C 母座 | **10 × 8 mm** |
| 电池输入端子 | **12 × 10 mm** |
| 保险丝座 + 保险丝 | **16 × 11 mm** |
| 8× 舵机 3P 座 | **21 × 22 mm**（两行四列）|
| 麦克风模块 | **16 × 12 mm** |
| 功放模块 | **18 × 18 mm** |
| 喇叭座 | **8 × 6 mm** |
| 470µF/1000µF 电容 ×2 | Ø10 × 13 mm 各 |
| EC11 + 按键 | **14 × 13 mm** |
| 屏幕连接器 | **1×10P 2.54mm**（屏幕本体不上主板）|

---

## 三、分区布局

```
┌──────────────────────── 100 mm ────────────────────────┐
│                                                         │
│  ┌── 电源区（左）──────────┐  ┌── 舵机配电区（右）───┐   │
│  │                        │  │                      │   │
│  │ [XT30 端子]            │  │  ┌──┬──┬──┬──┐      │   │
│  │   │                    │  │  │S1│S2│S3│S4│      │   │
│  │ [保险丝座]             │  │  ├──┼──┼──┼──┤      │   │
│  │   │                    │  │  │S5│S6│S7│S8│      │   │
│  │ [S1A 开关]             │  │  └──┴──┴──┴──┘      │   │
│  │   │                    │  │   ↑ 5V/GND 铺铜       │   │
│  │   ├──[DFR0753]──→ 5V ──┼──┼───┘                │   │
│  │   │        (大面积散热铺铜)                     │   │
│  │   └──[逻辑降压]──→ 5V ─┼──→ 开发板 5V           │   │
│  │        │               │                        │   │
│  │  [1000µF] [470µF]      │                        │   │
│  │                        │                        │   │
│  │ [保护 IC][充电 IC]     │                        │   │
│  │ [Type-C]               │                        │   │
│  └────────────────────────┘                        │   │
│                                                     │   │
│  ┌── 主控区（中）─────────────────────┐             │   │
│  │  ┌──────────────────────┐          │             │   │
│  │  │  2×20 插座（竖放）    │  [EC11]  │             │   │
│  │  │  20.5 × 51.9         │  [按键]  │             │   │
│  │  └──────────────────────┘          │             │   │
│  │                                    │             │   │
│  │  [音频区] 麦克风 · 功放 · 喇叭座    │             │   │
│  └────────────────────────────────────┘             │   │
│                                                         │
│  ┌── 显示接口区（下）──────────────────────────────┐   │
│  │  屏幕排针（8/12P）+ 电池采样分压 + PCA 控制信号   │   │
│  └──────────────────────────────────────────────────┘   │
│                                                         │
└─────────────────────────────────────────────────────────┘
        4 × M2 或 M3 安装孔（位置随结构件定）
```

---

## 四、电源铺铜策略

### 顶层（信号 + 5V）
```
5V 舵机铺铜：≥4mm 宽（2oz），从 DFR0753 输出 → 8 个舵机座
            走"树形"分配，不串联
```
### 底层（GND 整片）
```
除必要跳线外，整片 GND 铺铜 —— 这是 RevA 的教训（当时没有地平面）
```

### 关键散热
```
DFR0753 背面散热焊盘 → 打 6-9 个 Ø0.3mm 散热过孔 → 连到底层 GND 铺铜
```

---

## 五、布局原则

| # | 原则 | 原因 |
|---|---|---|
| 1 | **大电流区与信号区物理分开** | 舵机噪声不窜进 I2S/SPI |
| 2 | **电池输入 → 保护 → 开关 → 降压 单向排列** | 走线短、回路面积小 |
| 3 | **DFR0753 靠近舵机座** | 5V 路径越短压降越小 |
| 4 | **逻辑降压靠近开发板** | 逻辑 5V 走线短 |
| 5 | **PCA9685 靠近舵机座，但要和 5V 功率路径分开** | 只出信号 |
| 6 | **去耦电容紧贴各自负载** | 1000µF 贴 DFR0753 输出，470µF 贴逻辑 5V |
| 7 | **屏幕接口放在板边** | 排线最短，方便装配 |
| 8 | **EC11 位置由前面板决定** | 需要和结构件对齐 |

---

## 六、下一步

- [ ] 等 4 路调研回来，补齐 **【待核】** 尺寸
- [ ] 出**正式框图**（按真实尺寸摆放，含安装孔）
- [ ] 结构件同步（板框从 80×32 → 100×75，固定孔和 Z 高度都要改）
- [ ] 原理图
