xaiojie/papabot/pcb-design/integrated-v1/交接说明.md

# 交接说明 · 单板全集成 v1

> **2026-09-12 V1.2 无旋钮更新：** 五页原理图及 110×75 mm 双层 PCB 已完成，原理图/PCB 原生 DRC 严格通过。当前为 79 个器件、310 个引脚、59 个有连接网络；EC11 及三个上拉电阻、相关走线与定位孔均已移除。HS24S010B 使用单排 10PIN 屏幕接口，经主板 XH-10A 线束连接。准确工程、BOM、Gerber 与接线资料见 [V1.2 无旋钮交付](final-no-encoder-2026-09-12/README.md)。下文保留设计历史，其中旋钮、旧型号/针序、旧数量与“PCB 未完成”等描述均已被本次交付替代。

2026-09-11。**给接手的人（或 AI）看的现状说明。**

---

## 一、现在到底做完了什么

### ✅ 已完成：嘉立创EDA 里的原理图

```
工程      DesktopAssistant_Integrated
工程 UUID 50ae04bdafb74b93b94b7cc4c08171e1
原理图页  P1   UUID b8d9a582c4360871
PCB       PCB1 UUID 82d383f16c96f4   ← 空白
图纸      A3
```

**58 个元件 / 225 个网络端口 / 223 根导线 / 50 种网络 / 10 个区块**

区块划分：
```
① 电池保护 2S       ② 2S 升压充电      ③ 电源分配与降压
④ 舵机驱动 PCA9685  ⑤ 主控插座 2×20    ⑥ 音频 I2S
⑦ 交互 EC11         ⑧ 显示 SPI         ⑨ 设计说明
⑩ 电池均衡
```

**DRC 结果**（用户导出的日志）：
```
致命错误：0   错误：0   警告：2
[警告] 元件的属性与供应商编号不匹配，建议使用器件标准化  ×2
```

### ❌ 没做完：PCB

**`pcb_Document.importChanges()` 返回 `true` 但 PCB 里 0 元件。**
试过无参、传原理图页 UUID、传 Schematic UUID、先存原理图再导 —— 都不行。

**没有验证过导入是否弹了确认对话框**（菜单 API 只能插入/移除菜单项，不能触发菜单项）。

**⚠️ 下一步应该先人工在 PCB 里点「设计 → 导入变更」看会发生什么。**

---

## 二、必须知道的两个坑（打样前要解决）

### ① HY2213 引脚定义未核实

```
官方手册 https://www.hycontek.com.tw/hy_battery/DS-HY2213_EN.pdf
→ 抓取工具不支持 PDF
```

**后果**：`BAL_GATE1/2`（均衡 IC 输出 → 泄放 MOS 栅极）**目前标 NC**。
Q3.1 / Q4.1 打了 `NoConnected` 标记，元件属性里写了 `Assembly note` 警告。

**→ 拿到引脚定义后，把 OUT 脚连到 Q3.1 / Q4.1。**

### ② BOM 里 HY2213 型号选错

```
现在：HY2213-AB3B → P-MOSFET 均衡控制（OUT 输出 H→L 有效）
应改：HY2213-BB3A → N-MOSFET 均衡控制（OUT 输出 L→H 有效）
```

因为均衡 MOS 用的是 **AO3400A（N-MOS）**，与 AB3B 不匹配。
来源：https://www.hycontek.com.tw/en/products-en/3204

---

## 三、设计本身的关键决定（都已核对官方规格书）

### 电源架构
- **两路 5V 独立**：`+5V_SERVO`（舵机）/ `+5V_LOGIC`（逻辑）
- **只共地，正极绝不并联**
- 舵机典型 2-3A、峰值 6-8A → 顶层铺铜 ≥4mm

### 电池保护（HY2120-AB 替代 PW7120，阈值相同）
- 过充 4.28V/节 = 8.56V，过放 2.90V/节
- AO4406 ×2 背靠背低边，**VM 走线必须对称**（不对称会歪曲电流检测）

### 充电（IP2325 升压）
```
拓扑：VIN → 电感 → LX →（同步开关）→ VOUT → 电池
⚠️ 官方明确：动力类应用必须加 D1 肖特基
⚠️ 引脚：1=VSYS 2=VOUT 3=VSET 4=NTC 5=LED 6=VIN 7=BST 8=LX 9=GND
```

### 叠层
```
2 层 / 1.6mm / 2oz 铜 / 沉金
顶层：信号 + +5V_SERVO 铺铜
底层：完整 GND 平面（RevA 的缺陷就是没有地平面）
板框：110 × 75 mm
```

### 屏幕（已定稿）
```
汉昇 HS24S010B   立创 C5329587
2.4" IPS / ST7789 / SPI / 3.3V / 320×240
43.5 × 72.9 mm，双排 2×10P @2.54mm
只用 8 个信号，FS0/FCS 悬空
引脚：1=GND 2=+3V3 3=SCLK 4=MOSI 5=RST 6=DC 7=CS 8=+3V3
```

---

## 四、引脚映射（按仓库真实数据，不是猜的）

来源 `pcb-design/rev-a/01-controller-pinout.csv`

```
J1（右列 R1-R20）:
  R5=AMP_BCLK  R6=AMP_WS  R7=AMP_DIN  R9=GND  R10=LCD_RST_N
  R11=KEY_N    R13=ENC_SW_N  R17/18/19=+5V_LOGIC  R20=GND

J2（左列 L1-L20）:
  L1=ADC_BAT  L2=ENC_B  L4=MIC_BCLK  L5=MIC_WS  L6=MIC_SD
  L7=GND  L8=ENC_A  L9=PCA_SDA  L10=PCA_SCL  L11=PCA_OE_N
  L12=LCD_MOSI  L13=LCD_SCLK  L14=LCD_CS_N  L15=LCD_DC
  L17/18/19=+3V3  L20=GND
```

`U7 PCA9685`：A0-A5→GND（地址 0x40），LED0-7→PWM0-7，OE→PCA_OE_N，VDD→+3V3

---

## 五、文件索引

```
pcb-design/integrated-v1/
├── 交接说明.md              ← 本文件
├── EDA-建板进度.md          ← 1186 行，完整过程 + 所有踩坑记录
├── 原理图设计.md            ← 8 模块网络表 + 官方规格书精读
├── 完整网络表.md            ← 引脚级网络表（48 个网络）
├── 选品报告.md / 元件总表.md  ← 选型与 BOM
├── PCB布局设计.md / LAYOUT.md ← 叠层、分区、铺铜、布线规则
├── BOM-立创导入.csv / BOM-完整清单.csv
├── eda-截图/                ← 各阶段截图（最新：原理图定稿_DRC2警告）
├── eda-备份/
│   ├── DesktopAssistant_RevB_backup_20260911.epro2    ← 原 RevB（未动过）
│   └── Integrated_before_A3.epro2
├── datasheets/              ← 5 张官方规格书页 + 屏幕引脚/封装图
└── 最终摆放图.html/.png      ← 110×75 板的 19 个元件摆放
```

---

## 六、我犯的错（供接手的人避坑）

如果你要用 EasyEDA 的 API 继续做，**这几个坑我踩过，别再踩**：

### 1. `setState_*` 必须配 `done()`
```js
pin.setState_NoConnected(true);
await pin.done();        // 不调 = 完全白改，而且不报错
```

### 2. 坐标吸附
```js
const snap = v => Math.round(v/5)*5;
// 导线终点要 snap（否则端口吸附后差 1 单位不连通）
// 导线起点【不能】snap（否则非网格引脚接不上）
```
**这个坑害我 220 个端口全部悬空、280 条 DRC 信息。**

### 3. 循环里的 `await` 要小心
```js
for (const pin of await c.getAllPins()) { ... }   // ✅
for (const pin of c.getAllPins()) { ... }         // ❌ 拿到 Promise
```

### 4. 批量删除的过滤半径按「目标引脚」算
**我因半径过大误删了三次**（U7 的 PWM0-4、U7 的 GND 脚、J1 的三个信号）。
**删之前先列出「将要删除的东西」，确认无误再执行。**

### 5. 与其追着 DRC 报错修，不如按规格表全量审计
规格表是唯一真相。写脚本反查实际状态，一次性找出所有缺口。

### 6. 判断错误前先找反例
我凭「端口 10 间距太小」的猜测做扇出，把 33 个警告搞成 149 个。
**U7 也是 10 间距却从来没问题 —— 我该先问为什么。**

### 7. 桥有 30 秒超时
一次执行超过 ~30 个 API 调用会超时。
**响应超时 ≠ 脚本没跑完**，但每批控制在 4-5 个元件以内。

---

## 七、安全措施

```
✅ 原 RevB 工程备份：eda-备份/DesktopAssistant_RevB_backup_20260911.epro2
   （393KB，SHA256 fe0f8ba7e5ed334a…）
✅ 新工程备份：eda-备份/Integrated_before_A3.epro2
✅ 原 RevB 工程一个字符都没动过
```

**所有操作都在新工程 `DesktopAssistant_Integrated` 里，用工程 UUID 做了守卫。**

---

## 八、建议的下一步

```
1. 人工在 PCB 里点「设计 → 导入变更」，看是否弹对话框
2. 如果导入成功 → 按「最终摆放图」布局（板框 110×75mm）
3. 铺铜：顶层 +5V_SERVO，底层完整 GND
4. 布线 → DRC → 导 Gerber
5. 打样前解决 HY2213 的两件事
```
