xaiojie/papabot/pcb-design/integrated-v1/元件总表.md

# 单板全集成 v1 · 元件总表

> **2026-09-12 V1.2 无旋钮更新：** 五页原理图及 110×75 mm 双层 PCB 已完成，原理图/PCB 原生 DRC 严格通过。当前为 79 个器件、310 个引脚、59 个有连接网络；EC11 及三个上拉电阻、相关走线与定位孔均已移除。HS24S010B 使用单排 10PIN 屏幕接口，经主板 XH-10A 线束连接。准确工程、BOM、Gerber 与接线资料见 [V1.2 无旋钮交付](final-no-encoder-2026-09-12/README.md)。下文保留设计历史，其中旋钮、旧型号/针序、旧数量与“PCB 未完成”等描述均已被本次交付替代。

2026-09-11。**这是从设计走向下单的清单。**

> 标 ✅ 的表示已有确定的型号和参数；标 ⏳ 的等实物或等确认。

---

## 一、核心 IC

| 位号 | 型号 | 封装 | 功能 | 立创编号 | 采购渠道 |
|---|---|---|---|---|---|
| U1 | **PW7120** | SOT23-6L | 2S 保护 | ❌ 无 | **icinz.com** / 淘宝（印字 `20CB 7120`）|
| U2/U3 | **PW4406A** ×2 | SOP8 | 放电控制 N-MOS（背靠背）| ❌ | icinz.com / 淘宝 |
| U4 | **PW4584A** | SOP8-EP | 5V→8.4V 升压充电 | ❌ | icinz.com / 淘宝 |
| U5/U6 | **PW2213** ×2 | SOT23-6L | 单元均衡（每节一颗）| ❌ | icinz.com / 淘宝 |
| Q3/Q4 | **PW2302** ×2 | — | 均衡放电 MOS | ❌ | 同上 |
| U7 | **PA9685**（PCA9685）| **TSSOP-28** | 16 路 PWM 舵机驱动 | 需查 | 立创 / 淘宝 |
| — | 逻辑降压 | — | 见"决策待定" | — | — |

**备选（立创有货的宏康版本）**：

| 原型号 | 立创替代 | 立创编号 | 说明 |
|---|---|---|---|
| PW7120 | **HY2120-CB** | **C168776** | 阈值完全相同（4.28V / 2.9V）|
| PW2213 | **HY2213-AB3B** | **C168784** | 同为单节均衡 IC |

---

## 二、主控与模块

| 位号 | 名称 | 规格 | 封装/占位 | 状态 |
|---|---|---|---|---|
| J1/J2 | 开发板插座 | **1×20P 2.54mm 母座** | C429947 | ✅ 已选（仓库 W01）|
| — | ESP32-S3 开发板 | LCKFB-ESP32S3R8N8 | 20.5 × 51.9mm | ✅ 已购 |
| — | **屏幕** | **汉昇 HS24S010B** 2.4" ST7789 240×320 SPI 3.3V | **43.5 × 72.9mm**，2×10P 2.54mm | ✅ **C5329587**，立创有货 |
| — | 麦克风 | DFRobot **SEN0327** | Ø14mm | ✅ 已加购 |
| — | 功放 | **MAX98357A** 模块 | 19.4 × 17.8 × 3.0mm | ✅ 已加购 |
| — | 喇叭 | 4Ω 3W 24mm | Ø23.6 × 10.4mm | ✅ 已加购 |
| — | 舵机 | MG90S ×8 | — | ✅ 已加购 |

---

## 三、连接器

| 位号 | 名称 | 规格 | 数量 | 状态 |
|---|---|---|---|---|
| J3 | **屏幕接口** | **2×10P 2.54mm 母座**（用一排即可，另一排留或不装）| 1 | ✅ 建议用 1×10P（只接右排）|
| J4 | 舵机座 | **2.54mm 单排 3P 公排针** | **8** | ✅（仓库 W07）|
| J5 | 电池输入 | **KF128 5.08mm 2P 螺钉端子** | 1 | ⏳ 待决策（或 XT30）|
| J6 | Type-C | **16P 母座**（贴片/沉板）| 1 | ⏳ 待买 |
| J7 | 喇叭 | 2P 1.25mm 或直接焊线 | 1 | ✅ 建议焊线 |
| J8 | 麦克风 | 排针或焊线 | 1 | ⏳ 待实物 |
| J9 | 充电 I2C（可选）| 4P 排针 | 1 | 可选 |
| — | EC11 编码器 | 5 脚直插，Ø6 轴 | 1 | ⏳ 待买 |

---

## 四、电源无源件

### PW7120 保护外围

| 位号 | 值 | 封装 | 数量 | 依据 |
|---|---|---|---|---|
| R1, R2 | **330Ω ±1%** | 0805/1206 | 2 | 官方推荐（100–470Ω）|
| R3 | **1KΩ ±1%** | 0805 | 1 | 官方推荐（1K–4K）|
| C1, C2 | **0.1µF/16V** | 0805 | 2 | 官方推荐 ≥0.1µF |

### PW2213 均衡外围（×2 套）

| 位号 | 值 | 数量 | 依据 |
|---|---|---|---|
| 分压电阻 | **620KΩ** | **4** | 官方参考电路图 2 |
| 电容 | **0.1µF** | 2 | 同上 |

### PW4584A 充电外围

| 位号 | 值 | 封装 | 依据 |
|---|---|---|---|
| **L1** | **4.7µH**（≥1.5A 饱和）| 贴片电感 | 官方典型应用电路 |
| **D1** | **SS34**（肖特基 3A/40V）| SMA/DO-214AC | 官方 |
| **RICHG** | **1KΩ → 1A**（0.5A 待查）| 0805 | 官方；见待办 |
| R1(LED) | 1KΩ | 0805 | 官方 |
| CIN | **10µF/25V** | 0805/1206 | 官方 |
| COUT | **10µF/25V** | 0805/1206 | 官方 |
| CF1, CF2 | **1nF** | 0603/0805 | 官方 |
| C2, C3 | **22nF** | 0603/0805 | 官方 |
| C4 | **1nF** | 0603 | 官方 |
| CC1, CC2 | **5.1K ±1%** | 0603/0805 | Type-C Sink 标准 |
| LED1/LED2 | 充电指示（红/绿）| 0603/0805 | 官方参考 |

### 两路 5V 储能

| 位号 | 值 | 说明 |
|---|---|---|
| C_BULK1 | **1000µF/10V** | DFR0753 输出侧（舵机路）|
| C_BULK2 | **470µF/16V** | 逻辑 5V 侧 |
| 去耦 | 0.1µF ×N | 每个 IC 电源脚 |

### 电池采样

| 位号 | 值 |
|---|---|
| R_UP | **100KΩ ±1%** |
| R_DN | **33KΩ ±1%** |
| C | **0.1µF** |

### PCA9685 外围

| 位号 | 值 | 说明 |
|---|---|---|
| I2C 上拉 | **10KΩ ×2** → +3V3 | SDA/SCL |
| OE 上拉 | **10KΩ ×1** → +3V3 | 上电默认禁止输出 |
| 去耦 | **0.1µF + 10µF** | VDD |

### 交互

| 位号 | 值 | 说明 |
|---|---|---|
| ENC 上拉 | 10KΩ ×2 → +3V3 | A/B 相 |
| PUSH 上拉 | 10KΩ ×1 | EC11 按压 |

---

## 五、其他

| 项 | 规格 | 状态 |
|---|---|---|
| 保险丝 | MINI 插片 7.5A | ✅（仓库 F01）|
| 保险丝座 | PCB 座 01530008Z | ✅（仓库 F02）|
| 总开关 | NKK S1A | ✅（仓库 P06）|
| DFR0753 | 6–14V→5V/8A | ✅（仓库 P03）|
| 螺丝/垫柱/扎带/热缩管 | — | ✅（仓库 M01–M10）|

---

## 六、⏳ 待办

| # | 事项 | 状态 | 阻塞什么 |
|---|---|---|---|
| 1 | ~~5 个决策~~ | ✅ **已按建议采用**（可改）| 无 |
| 2 | ~~屏幕 pin 数~~ | ✅ **2×10P 2.54mm** | 无 |
| 3 | ~~板框~~ | ✅ **110 × 75 mm** | 无 |
| 4 | **PW4584A 的 ICHG 阻值 → 0.5A** | ⏳ 规格书需注册下载 | 充电电流（可先用 1K/1A）|
| 5 | **DFR0753 实物尺寸** | ⏳ **7 渠道穷尽，等收货实测** | 该模块封装（预留 30×22mm 通用区）|
| 6 | **PW7120/PW4584A 采购渠道** | ⏳ icinz.com 或淘宝 | 下单 |
| 7 | PBC 打样 | ⏳ | 需先完成原理图录入 |

### ✅ 已解除的阻塞

| 事项 | 结论 |
|---|---|
| 5 个决策 | 按建议采用：PCA9685 裸芯片 / 110×75 / MP1584 模块 / KF128 端子 / 无独立按键 |
| 屏幕选型 | **汉昇 HS24S010B**，立创 **C5329587**，43.5×72.9mm，2×10P |
| 电源方案 | PW7120 + PW2206A×2 + PW2213×2 + PW4584A（**有官方参考设计**）|

---

## 七、💰 预算估算（不含已购）

| 项 | 估算 |
|---|---|
| 电源 IC（PW7120 + PW4584A + PW2213×2 + MOS×4）| ¥15–30 |
| 无源件（电阻电容电感二极管）| ¥15–25 |
| 连接器（Type-C/端子/排针/座）| ¥15–25 |
| PCA9685 裸芯片 | ¥5–10 |
| 新屏幕 | ¥30–50 |
| PCB 打样（110×75，2 层 2oz，5 片）| **¥60–80** |
| **合计** | **约 ¥140–220** |
