xaiojie/papabot/pcb-design/integrated-v1/完整网络表.md

# 单板全集成 v1 · 完整网络表

> **2026-09-12 V1.2 无旋钮更新：** 五页原理图及 110×75 mm 双层 PCB 已完成，原理图/PCB 原生 DRC 严格通过。当前为 79 个器件、310 个引脚、59 个有连接网络；EC11 及三个上拉电阻、相关走线与定位孔均已移除。HS24S010B 使用单排 10PIN 屏幕接口，经主板 XH-10A 线束连接。准确工程、BOM、Gerber 与接线资料见 [V1.2 无旋钮交付](final-no-encoder-2026-09-12/README.md)。下文保留设计历史，其中旋钮、旧型号/针序、旧数量与“PCB 未完成”等描述均已被本次交付替代。

2026-09-11。**这是往嘉立创EDA录入原理图的直接依据。**

> 每个网络列出**所有**连接点（位号.引脚）。引脚号均已核对官方规格书。
> 标 ⚠️ 的是需要特别注意的。

---

## 一、元件引脚定义（已核实）

### U1 · PW7120（SOT23-6L，2S 保护）
| 脚 | 名 | 脚 | 名 |
|---|---|---|---|
| 1 | DOUT | 4 | VC |
| 2 | COUT | 5 | VDD |
| 3 | VM | 6 | VSS |

### U2 / U3 · PW4406A（SOP8，双 N-MOS）
| 脚 | 名 |
|---|---|
| 1, 2, 3 | **S**（源）|
| 4 | **G**（栅）|
| 5, 6, 7, 8 | **D**（漏）|

### U4 · PW4584A（SOP8-EP，升压充电）
| 脚 | 名 | 脚 | 名 |
|---|---|---|---|
| 1 | VIN | 5 | BAT |
| 2 | AGND | 6 | ICHG |
| 3 | LX | 7 | NTC |
| 4 | VBS | 8 | STAT |
| 9 | PGND（底部焊盘）| | |

### U7 · PCA9685（TSSOP-28，16 路 PWM）
```
 1=A0    2=A1    3=A2     4=A3     5=A4     6=LED0   7=LED1
 8=LED2  9=LED3  10=LED4  11=LED5  12=LED6  13=LED7  14=Vss
15=LED8  16=LED9 17=LED10 18=LED11 19=LED12 20=LED13 21=LED14
22=LED15 23=OE   24=A5    25=EXTCLK 26=SCL  27=SDA  28=VDD
```

### U8 · MP1584 降压模块
| 脚 | 名 |
|---|---|
| IN+ | 输入正 |
| IN− | 输入负 |
| OUT+ | 输出正 |
| OUT− | 输出负 |

### J1 / J2 · 主控插座（2×20，位置映射见仓库 `01-controller-pinout.csv`）
> 元件面朝上、天线在上、USB 在下；左列 L1–L20、右列 R1–R20 由上往下。

---

## 二、电源网络

### NET-01 `VBAT_RAW+`（电池原始正极）
| 连接点 | 说明 |
|---|---|
| J5.1 | 电池端子 |
| U1.5 (VDD) | **经 R1 330Ω** |
| U1.4 (VC) | **经 R2 330Ω** |
| U2.5,6,7,8 (D) | 上管漏极 |
| **P+** | 直通到输出正极 |

### NET-02 `VBAT_RAW−`（电池原始负极）
| 连接点 | 说明 |
|---|---|
| J5.2 | 电池端子 |
| U1.6 (VSS) | 保护 IC 地 |
| C1−, C2− | 去耦电容地 |
| U3.1,2,3 (S) | 下管源极 |

### NET-03 `BM`（电池中间节点，均衡检测）
| 连接点 | 说明 |
|---|---|
| 电池平衡头中间线 | ⚠️ **万用表确认，不只看线色** |
| U1.4 (VC) | **经 R2 330Ω** |
| U5 分压电阻上端 | 上节 PW2213 |
| U6 分压电阻上端 | 下节 PW2213 |

### NET-04 `VM_SENSE`（过流检测点）
| 连接点 | 说明 |
|---|---|
| U1.3 (VM) | 保护 IC 检测脚 |
| R3 一端 | **1KΩ 限流** |
| R3 另一端 → U2.1,2,3 (S) + U3.5,6,7,8 (D) | **两管中间点** |

> ⚠️ **这是过流保护的关键节点**：VM 检测 Q1+Q2 两个 MOS 上的压降。
> `I_过流 = 0.200V ÷ (Rds_Q1 + Rds_Q2)`，**走线必须严格照抄官方参考，不对称会导致检测偏差**。

### NET-05 `COUT_GATE`（充电控制栅极）
| 连接点 |
|---|
| U1.2 (COUT) → U2.4 (G) |

### NET-06 `DOUT_GATE`（放电控制栅极）
| 连接点 |
|---|
| U1.1 (DOUT) → U3.4 (G) |

### NET-07 `GND`（全机地 = 保护后负极 P−）
| 连接点 | 说明 |
|---|---|
| U2.1,2,3 (S) | 上管源极 = P− |
| U1.3 经 R3 | VM 检测 |
| U4.2 (AGND), U4.9 (PGND) | 充电 IC 地 |
| U4 的 CIN/C3/C4/CBAT/COUT/CF 的负端 | |
| U7.14 (Vss) | PCA9685 地 |
| U8.IN−, OUT− | 逻辑降压地 |
| DFR0753 GND | 舵机降压地 |
| J3.1 (屏幕 GND) | |
| J4.1..8 pin3 (舵机地 ×8) | |
| J6.GND (Type-C) | |
| U_MCU L7, L20, R9, R20 | 主控地 |
| 所有去耦电容负端 | |

### NET-08 `VBUS`（Type-C 5V 输入）
| 连接点 | 说明 |
|---|---|
| J6.VBUS | Type-C 的 VBUS（多脚并联）|
| U4.1 (VIN) | **经 CIN 10µF + CF1 1nF 到 GND** |
| R1_LED 一端 | 电源指示（经 LED 到 GND）|

### NET-09 `VBAT_SW`（总开关之后）
| 连接点 | 说明 |
|---|---|
| SW1 输出 | NKK S1A |
| U4.5 (BAT) | 充电**输出**（充回电池）|
| R_UP 上端 | 电池采样分压 |
| U8.IN+ | 逻辑降压输入 |
| DFR0753 VIN | 舵机降压输入 |

> ⚠️ **充电是「共口」的**：U4.BAT 接在**保护之后**的 VBAT_SW，
> 充电电流穿过保护 MOS，过充时保护 IC 能兜底。

### NET-10 `+5V_SERVO`（舵机 5V / 8A）
| 连接点 | 说明 |
|---|---|
| DFR0753 VOUT | **经 1000µF 到 GND** |
| J4.1..8 pin2 (舵机 VCC ×8) | **铺铜 ≥4mm，就近取** |

### NET-11 `+5V_LOGIC`（逻辑 5V / 3A）
| 连接点 | 说明 |
|---|---|
| U8.OUT+ | **经 470µF 到 GND** |
| U_MCU R17, R18, R19 | 主控 5V 针（**3 根并接**）|
| 功放 MAX98357A Vin | 音频功放供电 |

> ⚠️ **`+5V_SERVO` 和 `+5V_LOGIC` 只共地，正极绝不并联。**

### NET-12 `+3V3`（3.3V）
| 连接点 | 说明 |
|---|---|
| U_MCU L17, L18, L19 | 主控 3.3V 输出（3 根并接）|
| J3.2 (屏幕 VCC), J3.8 (屏幕 LED) | **屏幕只用 3.3V** |
| U7.28 (VDD) | PCA9685 逻辑电（**几 mA**）|
| 麦克风 SEN0327 VDD | |
| I2C 上拉 ×2 上端 | |
| OE 上拉 上端 | |
| ENC 上拉 ×2 上端 | |

### NET-13 `SW_CHG`（充电升压开关节点）
| 连接点 | 说明 |
|---|---|
| U4.3 (LX) | |
| L1 一端 | 4.7µH |
| D1 阳极 | SS34 |
| U4.4 (VBS) 经 C4 0.1µF | 自举 |

> ⚠️ **官方要求：LX 节点面积尽量小；L1、D1、芯片三者同一层，不过孔。**

### NET-14 `CHG_OUT`（升压输出）
| 连接点 |
|---|
| D1 阴极 → U4.4 (VBS) |
| **COUT 10µF + CF2 1nF 到 GND** |

### NET-15 `ICHG_SET`（充电电流设定）
| 连接点 |
|---|
| U4.6 (ICHG) → RICHG 1KΩ → GND |

> ⚠️ **1KΩ → 1A**。要 0.5A 需查 PW4584A 规格书（电气特性表）确认对应阻值。

### NET-16 `NTC`（电池温度检测）
| 连接点 |
|---|
| U4.7 (NTC) → 热敏电阻 10K → GND（可选，不用时可固定分压）|

### NET-17 `CHG_STAT`（充电状态）
| 连接点 |
|---|
| U4.8 (STAT) → R9 1KΩ → LED2 → VBAT_SW |

---

## 三、信号网络

### NET-20 `ADC_BAT`（电池电压采样）
| 连接点 | 说明 |
|---|---|
| VBAT_SW 经 R_UP 100KΩ | 上臂 |
| R_DN 33KΩ → GND | 下臂（8.4V → 2.084V）|
| C 0.1µF → GND | 滤波 |
| U_MCU **L1 (GPIO1)** | ADC1_CH0 |

### NET-21 `LCD_SCLK`
`U_MCU L13 (GPIO12)` → `J3.3`

### NET-22 `LCD_MOSI`
`U_MCU L12 (GPIO11)` → `J3.4`

### NET-23 `LCD_RST_N`
`U_MCU R10 (GPIO21)` → `J3.5`

### NET-24 `LCD_DC`
`U_MCU L15 (GPIO14)` → `J3.6`

### NET-25 `LCD_CS_N`
`U_MCU L14 (GPIO13)` → `J3.7`

### NET-26 / 27 / 28 `ENC_A` / `ENC_B` / `ENC_SW_N`
| 网络 | 主控 | 编码器 | 上拉 |
|---|---|---|---|
| `ENC_A` | L8 (GPIO7) | EC11 A 相 | 10KΩ → +3V3 |
| `ENC_B` | L2 (GPIO2) | EC11 B 相 | 10KΩ → +3V3 |
| `ENC_SW_N` | R13 (GPIO38) | EC11 按压 | 10KΩ → +3V3 |
| — | — | EC11 公共端 → GND | |

### NET-29 / 30 / 31 `MIC_BCLK` / `MIC_WS` / `MIC_SD`
| 网络 | 主控 | 麦克风 SEN0327 |
|---|---|---|
| `MIC_BCLK` | L4 (GPIO4) | SCK |
| `MIC_WS` | L5 (GPIO5) | WS |
| `MIC_SD` | L6 (GPIO6) | SD |
| — | — | L/R → **GND**（选左声道）|

### NET-32 / 33 / 34 `AMP_BCLK` / `AMP_WS` / `AMP_DIN`
| 网络 | 主控 | MAX98357A |
|---|---|---|
| `AMP_BCLK` | R5 (GPIO15) | BCLK |
| `AMP_WS` | R6 (GPIO16) | LRC |
| `AMP_DIN` | R7 (GPIO17) | DIN |
| — | — | GAIN / SD 悬空（默认 9dB、立体声混合）|
| — | — | OUT+ / OUT− → 喇叭（**BTL，都不接地**）|

### NET-35 / 36 / 37 `PCA_SDA` / `PCA_SCL` / `PCA_OE_N`
| 网络 | 主控 | PCA9685 | 上拉 |
|---|---|---|---|
| `PCA_SDA` | L9 (GPIO8) | **27 (SDA)** | 10KΩ → +3V3 |
| `PCA_SCL` | L10 (GPIO9) | **26 (SCL)** | 10KΩ → +3V3 |
| `PCA_OE_N` | L11 (GPIO10) | **23 (OE)** | 10KΩ → +3V3（**上电默认禁止输出**）|

### NET-38 `PCA_ADDR`（地址脚）
`U7.1,2,3,4,5,24 (A0–A5)` → **全部接 GND**（I2C 地址 = 0x40）

### NET-39 `PCA_EXTCLK`
`U7.25 (EXTCLK)` → **悬空**（用内部 25MHz 振荡器）

### NET-40 ~ 47 `PWM0` ~ `PWM7`（舵机信号 ×8）
| 网络 | PCA9685 | 舵机座 |
|---|---|---|
| `PWM0` | U7.6 (LED0) | J4-1 pin1 |
| `PWM1` | U7.7 (LED1) | J4-2 pin1 |
| `PWM2` | U7.8 (LED2) | J4-3 pin1 |
| `PWM3` | U7.9 (LED3) | J4-4 pin1 |
| `PWM4` | U7.10 (LED4) | J4-5 pin1 |
| `PWM5` | U7.11 (LED5) | J4-6 pin1 |
| `PWM6` | U7.12 (LED6) | J4-7 pin1 |
| `PWM7` | U7.13 (LED7) | J4-8 pin1 |

> **LED8–LED15（15,16,17,18,19,20,21,22）全部悬空** —— 备用，可留测试点。
> ⚠️ **不需要外加上拉电阻**（NXP 核实：输出默认推挽，源出 10mA）。

### NET-48 / 49 均衡网络（每节一套）
| 网络 | 连接 |
|---|---|
| `BAL_TOP` | 上节电芯正极 → U5 分压电阻上端 |
| `BAL_MID` | BM → U5 分压电阻下端 + U6 分压电阻上端 |
| `BAL_BOT` | 下节电芯负极（VBAT_RAW−）→ U6 分压电阻下端 |
| `BAL_MOS1` | U5 输出 → Q3 栅极 → 均衡电阻 → 上节电芯 |
| `BAL_MOS2` | U6 输出 → Q4 栅极 → 均衡电阻 → 下节电芯 |

> 分压电阻 **620KΩ ×2/每颗 IC**，均衡 MOS **PW2302**，去耦 **0.1µF**。
> 来源：PW7120 官方规格书 p3「参考电路图 2」。

---

## 四、Type-C 配置

| 脚 | 连接 | 说明 |
|---|---|---|
| VBUS | `VBUS` 网络 | **多脚并联** |
| GND | `GND` | |
| CC1 | 5.1KΩ → GND | **Sink 标准配置** |
| CC2 | 5.1KΩ → GND | 同上 |
| D+ / D− | **悬空** | 只充电，不传数据 |

---

## 五、完整性校验

| 检查项 | 状态 |
|---|---|
| 每个网络的连接点 ≥2 | ✅ |
| 所有 IC 电源脚已接 | ✅ |
| 所有 IC 地脚已接 | ✅ |
| 未用引脚已声明（LED8–15、EXTCLK、D±、FS0/FCS）| ✅ |
| 上拉电阻齐备（I2C×2、OE、ENC×2、CC×2）| ✅ |
| 去耦电容齐备（每个 IC 电源脚）| ✅ |
| 无网络名冲突 | ✅ |

---

## 六、⚠️ 五项「必须照抄官方」的地方

| # | 部位 | 原因 |
|---|---|---|
| 1 | **PW4406A 背靠背 + VM 走线** | 过流检测靠 MOS 内阻压降，走线不对称 → 检测偏差 |
| 2 | **LX 节点面积最小** | 官方明确要求，减少干扰和 EMI |
| 3 | **L1、D1、芯片同一层，不过孔** | 官方要求，功率回路最短 |
| 4 | **CIN/CF1 靠 VIN，COUT 靠 BAT** | 官方要求 |
| 5 | **R1/R2=330Ω、R3=1KΩ、C1/C2≥0.1µF** | 官方推荐值，偏差会导致阈值偏移 |
