xaiojie/papabot/pcb-design/integrated-v1/选品报告.md

# 单板全集成 v1 · 选品报告

> **2026-09-12 V1.2 无旋钮更新：** 五页原理图及 110×75 mm 双层 PCB 已完成，原理图/PCB 原生 DRC 严格通过。当前为 79 个器件、310 个引脚、59 个有连接网络；EC11 及三个上拉电阻、相关走线与定位孔均已移除。HS24S010B 使用单排 10PIN 屏幕接口，经主板 XH-10A 线束连接。准确工程、BOM、Gerber 与接线资料见 [V1.2 无旋钮交付](final-no-encoder-2026-09-12/README.md)。下文保留设计历史，其中旋钮、旧型号/针序、旧数量与“PCB 未完成”等描述均已被本次交付替代。

2026-09-11。尺寸分三档：**【实测】**(我自己量的，含自校验) / **【核实】**(厂家官网或手册) / **【待核】**(需实物或问商家)

> ⚠️ **抓取能力说明**：淘宝商品页有登录墙，`web_fetch` 返回空内容；
> 本轮 `web_search` 又报 402（DeepSeek 搜索接口余额不足）。
> 所以本报告的尺寸**全部来自厂家官网、数据手册、立创商城、封装图测量** ——
> **淘宝链接需要你按「搜索词」自己确认**，价格/库存以你看到为准。

---

## 一、✅ 保留（已选/已加购，不重买）

| ID | 名称 | 规格 | 价 |
|---|---|---|---|
| E02 | MG90S 舵机 ×8 | 全金属齿轮 180° | ¥88.00 |
| E03 | ESP32-S3 开发板 | LCKFB-ESP32S3R8N8 | ¥30.52 |
| E04 | PCA9685 模块 | HANLI 16路成品 | ¥8.90 |
| E05 | I²S 麦克风模块 | **DFRobot SEN0327** | ¥15.00 |
| E06 | I²S 功放模块 | MAX98357 | ¥5.19 |
| E07 | 喇叭 4Ω 3W | 24mm，2P 1.25mm | ¥9.69 |
| F01/F02 | 保险丝 7.5A + PCB 座 | MINI 插片式 | ¥27.43 |
| F03/F04 | 储能电容 1000µF / 470µF | 舵机路 / 逻辑路 | ¥6.55 |
| F06A/B/C | 100K / 33K / 0.1µF | 电池采样 | ¥8.72 |
| F07A | 10K 上拉 | PCA9685 OE | ¥2.54 |
| P03 | **DFR0753** | 6–14V→5V/8A | ¥55.00 |
| P06 | 总开关 S1A | NKK，15A | ¥29.42 |
| M01–M10 | 螺丝/垫柱/脚垫/扎带等 | — | ¥38.51 |
| W01 | 开发板插座 1×20P ×5 | C429947 | ¥5.31 |
| W03 | 2×18AWG 硅胶并线 1m | 红黑 | ¥4.29 |
| W07/W09 | 模块排针 / 热缩管 | — | ¥13.14 |

**保留项小计约 ¥336。**

---

## 二、🔄 更换（4 项）

### ① 屏幕 ✅ 已选定型号（立创有货）

**汉昇 HS24S010B**　立创编号 **C5329587**

| 项 | 值 | 来源 |
|---|---|---|
| 尺寸 | 2.4 寸 IPS 全视角 | 立创商品页 |
| 控制器 | **ST7789** | 立创参数 |
| 接口 | **SPI** | 立创参数 |
| 分辨率 | 320×240（原生竖屏 240×320）| 立创参数 |
| **视窗** | **38.12 × 50.36 mm** | 立创描述 |
| **显示范围** | **37.72 × 49.96 mm** | 立创参数 |
| 工作电压 | **3.3V** | 立创参数 |
| **模组板框** | **43.5 × 72.9 mm** | **【实测】**（封装图 + 2.54 针距标定）|
| **连接器** | **上下各一排 10 针，2.54mm** | 封装图 |
| 重量 | 20 g | 立创 |
| **对比旧屏** | 旧 91 × 44mm → 新 43.5 × 72.9mm（**面积小 21%，宽度窄一半**）| |

**引脚定义（20 脚，两排同信号不同顺序）**：

| 右排 1–10 | 左排 11–20 |
|---|---|
| 1 GND | 11 CS |
| 2 VCC | 12 RST |
| 3 SCL | 13 DC |
| 4 SDA | 14 SDA |
| 5 RES | 15 CLK |
| 6 DC | 16 FS0 |
| 7 CS | 17 FCS |
| 8 LED | 18 LED |
| 9 FS0 | 19 GND |
| 10 FCS | 20 VCC |

- **FS0 / FCS** 是可选外挂字库/图片 SPI Flash 用，**不用则悬空**
- **实际只用 8 个信号**，与现有固件引脚完全对应：
  `SCL→GPIO12, SDA→GPIO11, RES→GPIO21, DC→GPIO14, CS→GPIO13, LED→3.3V`

> ✅ **优势**：立创有现货、**EDA 封装库现成**（不用自己画）、3.3V 直连、引脚与固件兼容。
> 采购：立创商城搜 `C5329587`，或淘宝搜 `HS24S010B 2.4寸 SPI`

### ② 电池 —— 格氏 ACE 800mAh 2S（已选）

| 项 | 值 |
|---|---|
| 型号 | GS8002S45，`T插；800mAh-45C-7.4V-2S1P` |
| 尺寸 | **60 × 32 × 16 mm** 【核实】（商品页，未实测）|
| 重量 | 55–60 g |
| 链接 | https://item.taobao.com/item.htm?id=663039669190&skuId=4779123056788 |

### ③ 充电 —— 改成集成电路 ✅ 已定国产方案

**首选：PW4584A**（平芯微 PWChip，**SOP8-EP**）—— ⚠️ 原选 PW4252，但**官方标注 Q4 才量产**，改用 PW4584A

| 项 | 值 |
|---|---|
| 拓扑 | **升压型**（5V USB → 8.4V）—— 2S 必须用升压 |
| 充电电流 | **0.5A–1A 电阻可调** → 首版设 **0.5A**（0.63C）|
| 效率 | ~90%（异步升压）|
| 输入 | 3.6–6V，输入过压 6V，**VIN 耐压 30V** |
| 特点 | 内置 MOS、带 OVP 过压保护 |
| 封装 | **SOP8-EP** ✅ 好手焊 |
| 控制 | **电阻设定，不用写固件** ✅ |
| 状态 | **量产** ✅ |
| **采购** | ⚠️ **立创没有**，官方指定 icinz.com；或淘宝搜 `PW4584A 两节锂电池充电` |

**同系列备选**：

| 型号 | 架构 | 电流 | 效率 | 封装 |
|---|---|---|---|---|
| PW4584A | 异步升压 | 1A | 90% | SOP8-EP |
| **PW4252** ⭐ | 同步升压 | **1.2A** | 93% | SOP8-EP |
| PW4253 | 同步升压 | 2A | 95% | SOP8-EP |
| PW4000 | 升降压 | 3A | — | QFN 3×4 |

> ⚠️ **重要**：**TP5100 不行** —— 它是**降压**充电，USB 5V 充不了 2S（8.4V）。
> **必须选「升压 boost」型充电 IC。**

### ③B 2S 保护 IC ✅ 已定

**HY2120-CB**（HYCON 宏康 / 平芯微，**SOT-23-6**，立创 C168776 为 AB 版）

| 项 | 值 |
|---|---|
| 功能 | 过充 + 过放 + 过流 + **短路** |
| **过充** | **4.280V/节**（=8.56V，**高于充电器 8.40V，不冲突**）|
| **过放** | **2.900V/节**（=5.8V）← 正是仓库想要的值 |
| 过流检测 | VM 端 **0.200V** → `I = 0.2V ÷ Rds(on)总和` |
| 短路 | 0.6–1.4V，响应 **150–500µs** |
| 延时 | **全部内部产生，无需外部电容** |
| 功耗 | 4.5µA / 待机 2.1µA |
| 封装 | **SOT-23-6** ✅ |
| 特点 | **过放自恢复**、0V 电池激活充电 |
| 外围 | R1/R2=330Ω、R3=1k–4kΩ、C1/C2≥0.1µF |
| **淘宝搜索词** | `HY2120 两串保护IC` |

### ③C 单元均衡 IC ✅ 已定

**HY2213**（HYCON 宏康，**SOT-23-6**，立创 **C168784**）—— **单节**均衡 IC，**2S 用 2 颗**

| 项 | 值 |
|---|---|
| 过充检测 | 4.000–4.500V ±25mV |
| 待机检测 | 2.70V |
| 功耗 | 2.5µA / 待机 0.5µA |
| **淘宝搜索词** | `HY2213 锂电池均衡IC` |

### ③D 保护用双 N-MOS

| 型号 | 封装 | 场景 |
|---|---|---|
| **PW8206A6S** | SOT-23-6（双 N-MOS）| 中小电流，占板小 |
| **PW4406A** | SOP8 | 通用 |
| PW20N03 / PW80N03 | TO252 | 大电流 |

**选型要求**：`Rds(on) 总和 ≈ 20mΩ`（目标过流点 10A），Vds ≥ 30V

> 💡 **为什么不用 TI BQ25887**：它是 VQFN 4×4 封装（要热风枪）+ I2C 控制（要写固件）。
> 国产方案 **SOP8-EP + SOT-23-6** 全部好手焊，而且**电阻设定不用固件**。

### ④ 逻辑 5V —— 换成 IC 或小模块

| 项 | 值 |
|---|---|
| 需求 | 输入 6–8.4V，输出 5V / **3A** |
| **首选（模块）** | 小型 **MP1584 / MP2315** 降压模块（可焊板上）|
| 备选（IC） | **TPS5430**（3A，SOIC-8 好焊）/ **MP2315**（3A，SOT23-8）|
| **淘宝搜索词** | `MP1584EN 降压模块 5V` / `MP2315 降压芯片` / `TPS5430` |

> 替换掉现在的好盈 UBEC（**43 × 17 × 7 mm**，11g，[Hobbywing 官网](https://www.hobbywing.com/products/ubec-3a-2-6s99)），
> 省下**约 40×17mm** 的占位，还便宜 20 元。

---

## 三、➕ 新增（7 类）

### ⑤ 2S 电池保护电路（集成电路）

用户要求「保护用集成电路」，所以不用现成的 HX-2S-JH20 模块。

| 项 | 值 |
|---|---|
| 结构 | **2S 保护 IC + 双 N-MOS 背靠背 + 均衡电阻** |
| 保护点 | 过充 4.25V/节、过放 2.9V/节、过流 10A+、短路 |
| **MOS 要求** | **Rds(on) < 10mΩ @Vgs=4.5V，Vds ≥ 30V，Id ≥ 15A**，封装 SOP-8 / DFN |
| **IC 候选** | HY2120 / S8254A / XB7608 系列 ← ⚠️ **需在立创商城确认在售与封装** |
| **淘宝搜索词** | `2S 锂电池保护IC` / `2串保护IC 双MOS` |
| 备选 | 若找不到合适 IC，**退回用 HX-2S-JH20 模块**（46.7×23×3.15mm）|

> ⚠️ **本轮未能验证具体 IC 型号**（搜索引擎不可用）。
> 这部分需要你或我在搜索恢复后确认「有货 + 封装好焊」。

### ⑥ Type-C 母座（充电输入）

| 项 | 值 |
|---|---|
| 规格 | **Type-C 16P 母座**，**沉板/贴片**，额定 ≥ 2A |
| **淘宝搜索词** | `Type-C 16P 母座 贴片` / `TYPE-C 母座 沉板 16P` |

### ⑦ EC11 编码器 + 按键（从旧屏里挪出来）

| 项 | 值 |
|---|---|
| **EC11 本体** | **11.7 × 12.5 × 7 mm**【核实】 |
| 轴 | **Ø6mm**，长 15–20mm（半轴 / 梅花轴 / 圆轴）|
| 引脚 | **5 脚直插**（A/B/C + 2 个按键脚）|
| 面板开孔 | 约 **Ø7mm** |
| **淘宝搜索词** | `EC11 编码器 带按键 半轴` / `EC11 旋转编码器 5脚` |

> **建议去掉独立按键 K0，只用 EC11 的按下功能** —— 省一个开孔和两个元件。
> 现有固件的 `KEY0` 功能可合并到长按。

### ⑧ 电池输入连接器

| 项 | 值 |
|---|---|
| 需求 | ≥ **10A** |
| 方案 A | **XT30 卧式/立式 PCB 插座**（配对电池侧 T 插不通用，需转接）|
| 方案 B | **5.08mm 螺钉端子**（KFT/KF128），最省事 |
| 方案 C | 保留电池 **T 插**，用 **T 插母座焊板**（少见，多为带线款）|
| **推荐** | **方案 B（螺钉端子）** —— 大电流、好接、便宜 |
| **淘宝搜索词** | `XT30 插座 PCB 卧式` / `KF128 5.08 2P 接线端子` |

> ⚠️ 电池是 **T 型插头**，所以机器端还需要一根 **T 插配对线**（16/18AWG）。

### ⑨ 舵机 3P 座 ×8

| 项 | 值 |
|---|---|
| 规格 | **2.54mm 单排 3P 公排针**（舵机线是母头）|
| 电流 | 每路峰值约 1A，单针额定 3A ✅ 够 |
| 建议 | 选 **带卡扣的 3P 座**防松脱 |
| **淘宝搜索词** | `2.54mm 3P 排针 带扣` / `舵机延长线 公头 3P` |
| BOM 已有 | W07「单排黑镀金 10只」 |

### ⑩ 屏幕连接器

| 项 | 值 |
|---|---|
| 若屏幕是**排针** | 用 **2.54mm 单排 8P/14P 母座** |
| 若屏幕是 **FPC** | 用 **FFC/FPC 翻盖座**，间距常见 **0.5mm 或 1.0mm**，按 pin 数选 |
| **淘宝搜索词** | `FPC 翻盖座 0.5mm 8P` / `FFC 插座 1.0mm 14P` |

> ⚠️ **等屏幕选型确定后再定** —— 这个必须和实物匹配。

### ⑪ 喇叭座 / 麦克风座

| 项 | 值 |
|---|---|
| 喇叭 | 2P **1.25mm**（疑似 PH1.25）—— 和功放的 PH2.0 不直配 |
| 建议 | **直接焊线**，不用座（BOM 里已注「喇叭改焊线接螺丝端子」）|
| 麦克风 | DFRobot SEN0327 是 **Ø14mm**【核实】，装法待定（贴面板？开孔？）|

---

## 四、📐 尺寸汇总（用于布局）

| 器件 | 尺寸 | 档位 |
|---|---|---|
| ESP32-S3 开发板 | **20.5 × 51.9 mm** | **【实测】** |
| 1×20P 母座 | 50.8 × 2.54 mm，塑高 8.5 | **【实测】** |
| **新屏幕模组（HS24S010B）** | **43.5 × 72.9 mm** | **【实测】** |
| 屏幕视域 | 38.12 × 50.36 mm（显示范围 37.72×49.96）| 【核实】 |
| 麦克风 SEN0327 | **Ø14 mm** | 【核实】 |
| 功放 MAX98357A 模块 | **19.4 × 17.8 × 3.0 mm** | 【核实】 |
| 喇叭 | Ø23.6 × 10.4 mm | 【核实】 |
| 电池 格氏 ACE 800mAh | 60 × 32 × 16 mm | 【核实】 |
| EC11 编码器 | 11.7 × 12.5 × 7 mm + Ø6 轴 | 【核实】 |
| 好盈 UBEC（**拟换掉**）| 43 × 17 × 7 mm | 【核实】 |
| 保护板 HX-2S-JH20（**拟换 IC**）| 46.7 × 23 × 3.15 mm | 【核实】 |
| **充电 IC PW4584A** | SOP8-EP | 【核实】 |
| **保护 IC PW7120** | SOT23-6L | 【核实】 |
| **均衡 IC PW2213 ×2** | SOT23-6L | 【核实】 |
| **PCA9685 模块** | 约 62.5 × 25.5 mm | **【待核】** |
| **DFR0753** | **未知** | **【待核】** |
| 新屏幕引脚数/连接器 | 未知 | **【待核】** |

---

## 五、🛒 淘宝搜索词汇总（可直接复制）

```
屏幕     2.4寸 ST7789 SPI 240x320 无触摸
充电IC   PW4584A 两节锂电池 升压充电
         两串 8.4V 升压充电IC
保护IC   PW7120 两串保护IC
均衡IC   PW2213 锂电池均衡IC
逻辑降压  MP1584EN 降压模块 5V
          MP2315 降压芯片
保护IC   2S 锂电池保护IC
          2串保护IC 双MOS
MOS      SOP-8 N沟道 MOS 30V 15A 低内阻
Type-C   Type-C 16P 母座 贴片
EC11     EC11 编码器 带按键 半轴
电池座   KF128 5.08 2P 接线端子
          XT30 插座 PCB 卧式
舵机座   2.54mm 3P 排针 带扣
FPC座    FPC 翻盖座 0.5mm 8P
```

---

### ⚠️ DFR0753 尺寸：已穷尽渠道，仍拿不到

| 渠道 | 结果 |
|---|---|
| DFRobot 国际站产品页 | 只有电气参数，**无尺寸图** |
| DFRobot 中国站（goods-2971）| 同上 |
| DFRobot Wiki | **404** |
| 立创商城 | **未收录** |
| Farnell / element14 | **403** |
| TME | Cloudflare 挡 |
| Utmel | 403 |
| 官方产品图（1560×1040 高清）| **3/4 视角照片**，无尺寸标注、无参照物 |

**结论：DFR0753 尺寸只能等收货用卡尺实测。**

### ✅ 应对方案

**方案 A（推荐）**：板上**预留 30 × 22 mm 的通用降压区**
- 先按 30×22 布铜和散热焊盘
- 收货实测后，若差异不大 → 只改封装不改布局
- 若差异大 → 局部调整

**方案 B（换模块，尺寸已知）**：改用 **DFR1202**（16A 版，**30 × 26 × 8 mm**，¥68）
- ✅ **尺寸有明确记录**
- ✅ 电流余量更大（16A vs 8A）
- ⚠️ 贵 ¥13，且 26mm 比 22mm 宽

**方案 C（换芯片）**：既然已有官方降压 IC 的完整设计能力，可以考虑自己画
- ⚠️ 但 8A 的降压 IC 手焊难度高，不建议首版

> **建议走方案 A** —— DFR0753 已经在购物车里，8A 也够用（实测常态 2–3A）。
> 收货实测后再定封装，风险可控。

## 六、❓ 待问商家 / 待确认

### 必须问的

1. **屏幕**：几 pin？带触摸吗？排针间距？**模组实际长宽厚**？BLK 脚有没有？
2. **PCA9685 模块**：**实际板子长宽**（我只有 Adafruit 标准的 62.5×25.5，HANLI 克隆可能不同）？排针间距？
3. **DFR0753**：**本体长宽高**？焊盘/引脚位置？（官方页面只有参数没有尺寸图）
4. **麦克风 SEN0327**：是 Ø14mm 圆板吗？**拾音孔在正面还是底面**？
5. ~~保护 IC 型号~~ ✅ **已定 HY2120-CB（SOT-23-6，立创有货）**
6. **PW4252**：立创/淘宝是否有货？价格？（HY2120/HY2213 立创确认有）

### 收货后必须实测的

- 所有模块的**实物长宽高**（商品页尺寸经常不准）
- DFR0753 的**散热焊盘尺寸**
- 屏幕的**排针位置**（相对屏幕边缘的偏移）

---

## 七、⚠️ 本轮的能力边界（诚实说明）

| 能做 | 不能做 |
|---|---|
| ✅ 查厂家官网/数据手册拿尺寸 | ❌ 读淘宝商品页（登录墙）|
| ✅ 从封装图精确测量 | ❌ 确认淘宝价/库存 |
| ✅ 定精确型号和规格 | ❌ 搜索（本轮 402）|
| ✅ 出搜索词和验收要点 | ❌ 替你下单 |

**所以流程是：我出型号 + 搜索词 → 你搜淘宝 → 把实物尺寸给我 → 我更新布局。**

---

## 八、下一步

- [ ] 用户按搜索词确认淘宝货源
- [ ] 补齐 **【待核】** 尺寸（PCA9685 / DFR0753 / 屏幕引脚）
- [ ] 确认 2S 保护 IC 具体型号
- [ ] 出正式框图（按真实尺寸摆放）
- [ ] 结构件同步（板框 80×32 → 100×75）
