xaiojie/papabot/pcb-design/native-rev-b/修改与复核报告.md

# RevB 修改与复核报告

日期：2026-09-09。状态：本次屏幕供电修订和设计文件复核完成；实物试装及上电验证待完成。未下单。

## 修改依据与边界

用户提供的整板原理图显示，VCC直接供液晶并连接A/B/PUSH/K0上拉，没有画出5V稳压/电平转换；引脚说明指定3.3V。采用3.3V供电同时匹配屏幕逻辑及ESP32-S3 GPIO。BLK按说明固定接3.3V。市场图/部分示例注释的5V说法未用作本版接线依据。

原生载板新增独立LCD_3V3网络、JP3选择连接位、J10外部3.3V输入和C5旁路。屏幕5V供电铜线已移除，J3.2与J3.8均在LCD_3V3。J7沿用原脚位，说明修订为保留原板控件；R4–R7默认不焊。没有改动主控GPIO分配或机械几何。

保留21个原有PCB元件位置、原板框及安装孔。移除49段旧5V铜线，保留689段原有铜线，新增63段及1个过孔；最终752段、25个过孔、24个板上元件、104个元件焊盘。原理图另含板外C2。

## 检查证据

| 检查 | 结果 | 证据文件 |
|---|---|---|
| 原生PCB严格DRC | 通过；空错误列表 | native-pcb-drc.json |
| 原生原理图严格DRC | 通过；空错误列表 | native-schematic-drc.json |
| 原理图/PCB/归档网表 | 104/104引脚匹配；5V与LCD隔离 | netlist-check.json |
| 独立连续几何 | 26/26网络连通，无孤立铜，无间距/板边/螺钉头避让违规 | native-routing-validation.json |
| 保存工程对照 | 21个原元件位置、板框与孔不变；规则实际数值不变 | native-archive-check.json |
| Gerber输出 | 752铜线、129PTH、4NPTH逐一匹配；闭合板框 | gerber-export-check.json |

精确归档焊盘尺寸下，最小异网间距为8.0001mil（约0.203203mm），最小铜到板/槽边为13.0157mil；相对半径2.5mm螺钉头避让圆的最小额外余量为4.3307mil。8mil间距接近规则下限，工艺选用1oz并由板厂按该能力处理，不能直接换成未经复核的厚铜工艺。

原生封装电阻孔带±0.011mil小偏移，验证分别处理焊盘中心与钻孔中心；API的孔径/尺寸取整不用于最终孔径判断。Gerber与归档最大钻孔、线段差均不超过1µm。129个PTH包含104元件孔及25过孔；via-only钻孔文件不可再次叠加加工。

归档省略LCD_3V3空规则选择器及空网络的默认等长选择器，所有实际规则与模板/层叠仍逐项比较。196项原理图属性仅在绘制顺序和默认删除线字段上不同；内容、位置、可见性、元件及连接均一致。飞针文件为11个NC脚各生成唯一NET_n名称，已确认互相独立、未与26条有效网络混同。详情见source-archive-normalization.json及gerber-export-check.json。

## 交付后仍需的实物验证

1. 屏幕3.3V/背光全亮最大电流未给出；共用主控电源的电流/温升余量尚未确认。JP3保持断开；可经J10采用独立合格3.3V支路。外部稳压器还未定型、采购或做安装验证。
2. 实物主控针序、插座高度、板底元件、J10/JP3连接方式、线束弯曲和A3壳体配合尚未验收。PCB外形不变不代表新增插头高度自动合适。
3. 上下电时序、信号倒灌、显示/语音/Wi-Fi并发、舵机负载、温升/RF和步态需要样机测试。供电检查与低速SPI调试完成后再提高刷新率。
4. U形槽内角按板厂铣刀处理，孔槽尺寸和双层1.6mm/1oz选项须在下单预览核对。用户自行决定打样，本次未执行下单。

旧RevA保留为历史备份，不能混用其5V屏幕接线或Gerber。在线项目保留旧名称DesktopAssistant_RevA，实际Board1/P1/PCB1已为RevB。
