xaiojie/papabot/mechanical-design/assembly-v1/reports/independent-review.md

# 第一阶段总装模型独立审查

审查日期：2026-09-07  
范围：只读核对 `scripts/build_assembly.py`、`mechanical-design/modeling-and-print-plan.md`、生成的 `.blend` 清单/日志及 8 张渲染。此结论仅针对第一阶段外观和装配评审，不是生产打印放行。

## 结论

当前交付基本覆盖第一阶段：A 奶油薄荷配色、可编辑 `.blend`、按集合和父级组织的独立对象、已选屏幕模块及未选电子/舵机占位、整机多视角、前盖/底盖拆开状态和爆炸图均已生成。日志显示 Blender 5.2.1 LTS 完成构建与 8 张渲染；对象清单含 161 个网格，其中 45 个标作 `PRINT_CANDIDATE`、44 个标作 `ENVELOPE`。清单中的网格非流形边、零面积面均为 0。

模型适合继续做比例、造型和空间布局评审，但尚不能据此确认可拆装、运动、紧固或可打印性。以下问题应在把任何对象升级为试配件之前解决或明确披露。

## 主要发现（按优先级）

### P1 — 前盖定位柱没有主壳配对结构，组装位置存在实体干涉

脚本在前盖组中创建四个独立管状定位件（中心 `y=-16.8`、深 5 mm），但主壳没有对应定位孔、螺母座或让位结构。主壳前缘约在 `y=-14.7`，定位件延伸到 `y=-14.3`，因此装配姿态包含约 0.4 mm 的名义重叠；这不是经过定义的压配公差。渲染能表达拆盖方向，却不能证明盖子可实际装入、锁止或反复拆卸。

建议：第一阶段文档把它称为“定位概念”并列入待补尺寸；下一阶段明确定位柱与主壳接收孔/槽、装配间隙、紧固件和工具路径，再做干涉检查。若定位柱意图与前盖一体成型，应合并为一个零件或在清单中明确“同件多对象”，避免把四根柱误计为四个打印件。

### P1 — 腿部舵机托架目前没有与主壳形成可实现的连接

主壳侧开口在每侧 `x=±57`，12 mm 宽，内边约为 `|x|=51`；所谓机身侧托架中心在 `x=±44.5`、厚 5 mm，外边约为 `|x|=47`，与侧开口/侧壁之间留有约 4 mm 空档。托架只是带两孔的薄板，也没有包围脚本注释所称的舵机本体。当前渲染依靠空间叠放呈现完整外观，不能说明舵机载荷如何传入壳体。

建议：继续保留为舵机/机构概念占位是合理的，但将 `P010` 从可打印候选降级或显著标注为“结构占位”；待选定舵机后再定义壳体安装耳、螺钉轴线、轴承/舵盘连接、装配顺序和活动避让。

### P1 — “45 个可打印候选”不等于 45 个独立可交付零件

脚本把前盖定位柱、电子托板支柱、耳部定位键、屏幕垫柱等都作为独立网格并统一标成 `PRINT_CANDIDATE`。其中部分显然更像所属零件的一体特征，部分可能是独立垫柱；当前没有 BOM 层级或 `same_part_as` 关系来区分。耳框与耳键也是两个重叠对象，电子托板与四个支柱同样分离。直接按对象导出会得到错误的零件数量和悬空小件。

建议：第一阶段可以保持对象可编辑性，但交付说明必须说清楚“对象级独立”不代表“制造件级独立”。下一阶段先冻结部件边界和数量，再决定布尔合并、一体打印或外购。

### P2 — 布尔构建顺序持续产生 Blender 警告，重建结果缺少强保证

`cube()` / `cylinder()` 先应用倒角，然后保留一个未应用的 Weighted Normal 修改器；后续 `boolean()` 再把布尔修改器追加到它后面并单独应用。构建日志大量出现 `Applied modifier was not first, result may not be as expected`。当前导出的评估网格没有非流形边，渲染也完成，但这一结果不足以证明未来参数变化或 Blender 版本变化后仍会得到相同开孔。

建议：在后续脚本中让几何布尔先于法线类修改器，或在每次布尔前显式处理修改器栈；把该警告数纳入构建失败/验收条件。当前 `.blend` 应记录为“本次构建可打开和渲染”，不要表述为无警告可复现。

### P2 — 拆装动画展示了位移状态，没有验证真实拆卸路径

帧 40 将前盖、装饰圈和遮光井分别作为三个组向前移动 85 mm；帧 70 只把底盖向下移动 29 mm；帧 100 对所有大组做平移。该方式清楚表达“拆下后在哪里”，但未检查连续路径上的碰撞、线缆牵连、旋钮避让、螺钉退出长度或工具空间。前盖渲染中旋钮仍在 PCB 上，深前盖确实把它遮住，但未证明拆盖过程中不会扫碰旋钮或按键。底盖四颗螺钉跟随底盖一起移动，只能视为示意。

建议：文档统一称为“拆开姿态/爆炸示意”，避免称为“已验证拆装动画”。下一阶段用连续行程做 swept-volume/干涉检查，并明确哪些附属件随总成拆下。

### P2 — 爆炸图有裁切和归属表达问题

`exploded.png` 顶部耳件被画面裁切；显示支撑框留在装配原位，而显示模块前移，能看出层次但不易判断垫柱/螺钉属于哪一侧。腿组、线束和电子板同时散开，部分线束成为悬空短段。它可用于内部概览，不适合作为装配顺序图。

建议：扩大爆炸相机画幅，避免任何部件出框；按装配轴分层，必要时用编号/引线图单独说明前盖、显示总成、底盘和四腿，不让概念线束承担装配说明作用。

### P2 — 当前自动验证范围容易被误读为“打印检查通过”

清单只检查每个评估网格的非流形边、零面积面和体积。它没有检查对象间碰撞、共面/重叠实体、最小壁厚、悬垂、封闭后的可装入性、孔径/公差、导出单位、STL 实际尺寸、切片或强度。尺寸列也来自对象 `dimensions`，并非一份带公差和测量基准的工程尺寸报告。

建议：第一阶段报告可以保留“161 个网格均未检出非流形边/零面积面”，同时紧邻披露上述未检查项，禁止简写为“网格验证通过”或“可打印”。

## 已确认合理的部分

- 场景根节点、功能集合与装配组层级清楚；前盖、装饰圈、遮光井、主壳、底盖、屏幕、屏幕支架、电子托板、耳件和四腿均可单独选择与移动，满足第一阶段编辑和评审需求。
- `.blend` 自带材质、相机、灯光与打包字体；渲染不依赖外部表情位图。场景属性明确写有 `NO_PRINT_RELEASE`，未选电子模块使用 `ENVELOPE` 标记。
- 91×44 mm PCB、84.5×37.5 mm 孔距、Ø3 mm 孔为供应商标称值，并标明制造前实测；118 mm 外宽、LCD 外形/偏置、有效区推导、旋钮突出约 21 mm，以及舵机/电子模块均被识别为假设。这与计划文件的阶段边界一致。
- 正面、侧面、背面、三分之四视角、前盖拆开、底盖拆开和爆炸图均有实际 PNG；A 奶油薄荷的颜色关系在渲染中可辨认。

## 第一阶段交付说明中必须披露

1. 这是比例、外观、空间占位和分件组织模型；不是 STL/STEP/G-code、生产图、打印报价依据或制造放行。
2. 屏幕 PCB 与孔距来自商品标称，LCD 玻璃/外框/相对位置、排针方向、背面最高元件、按钮和 EC11 全高/突出均需实物测量。21 mm 是明确假设。
3. 118 mm 外宽及当前机身深高、屏幕居中方式、四腿落点和姿态尚未由重心、舵机扭矩、稳定性或运动学验证。
4. 舵机、主控、驱动、功放、麦克风、扬声器、电源与连接器未最终选型；其模型和孔/开口仅为占位，不构成采购或孔位确认。
5. 前盖/底盖画面是拆开姿态；紧固、配合、公差、连续拆卸路径、线束连接和工具进入空间尚未验证。
6. 当前对象清单的 `PRINT_CANDIDATE` 表示后续拟开发的几何，不表示每个对象都是独立制造件或已经通过打印检查。
7. 本次拓扑结果仅说明列入清单的单体评估网格未检出非流形边和零面积面；未进行对象间干涉、最小壁厚、切片、试配、承载、热、声学或实物验证。

## 建议的下一道验收门槛

在进入试配打印前，至少应完成：实测屏幕总成及旋钮/按钮/接插件包络；选择舵机并重建载荷路径；明确制造件 BOM 和一体/分体关系；补齐前盖与底盖的配对定位和紧固结构；对连续拆卸路径及整机各姿态做碰撞检查；消除构建日志中的修改器顺序警告；随后再对选定的小样件做毫米单位导出、最小壁厚、切片和实物试配验证。

---

## 第二轮复核（2026-09-07）

本节保留以上初审作为修订历史，并以第二轮脚本、重新生成的 `.blend`、新渲染、`reopen-verification.json` 与日志为当前状态依据。第二轮已实质修复多项初审问题，但重开验证当前结果为 **23/25**，仍不能表述为全部验证通过。

### 已确认修复或改进

- **前盖与主壳外形接缝已明显改善。** 主壳改为与前盖后截面相配的 `ring_loft`。新 `hero.png` 中原先前上角明显破口/大接缝已消失；侧视仍能看到正常的可拆分界线，未见先前那种破损边缘。
- **前盖定位结构已形成配对概念。** 四个定位管已通过 UNION 并入前盖，主壳增加接收套和让位孔；脚本记录 3.2 mm 外半径定位管与 3.4 mm 接收孔半径，即 0.2 mm 名义径向间隙。重开验证中前盖与主壳实体相交体积为 0。该间隙仍是试配假设，紧固方式和工艺公差未验证，不能称为最终连接设计。
- **对象级零件数量的误导已减少。** 耳键已并入耳框并在主壳开接收孔；电子托板支柱已并入托板。`PRINT_CANDIDATE` 从初审时 45 个降至 31 个，说明一体特征不再作为独立打印对象计数。
- **修改器顺序警告已消失。** 第二轮构建日志未再出现 `Applied modifier was not first`；Weighted Normal 统一在几何操作完成后添加。日志仅保留 Blender 6.0 相关的 `use_nodes` 弃用提醒，不影响本次 Blender 5.2.1 构建。
- **P010 的状态表述诚实。** 四个 P010 已从 `PRINT_CANDIDATE` 降为 `ENVELOPE`，对象属性明确写有承载连接与孔位未完成，并在渲染中隐藏。当前材料没有把舵机托架或载荷路径说成已完成，这一点符合阶段边界。
- **腿部外移消除了已发现的 PCB 相交。** 四个腿组在全部关键帧上左右各外移 13 mm；重开验证测得四个髋舵机包络与 PCB 相交体积均为 0。机身宽仍为 118 mm，可见整机包络宽度为 208 mm。208 mm 是当前占位姿态的外包络，不是步态、稳定性或最终落脚宽度认证。
- **拆盖路径验证比初审更具体。** 验证脚本抽样检查前盖/遮光井在 0、2、5、10、20、40、85 mm 七个前移位置，与 PCB、旋钮和 LCD 外框的最大相交体积均为 0。这支持当前直线拆盖概念，但仍不是连续 swept-volume、线束、工具或手指操作验证。
- **相机构图已修复。** 新 `hero.png`、`side.png`、`exploded.png` 和 `layout.png` 中未见对象越出画幅；先前爆炸图顶部耳件被裁切的问题已消失。自动投影边界检查也判定 8 个视角全部位于画面内。侧视前腿接近下边缘但脚垫仍完整可见，属于紧凑构图，不是裁切。

### 当前阻塞项

#### P1 — 主壳拓扑在第二轮回归，重开验证明确失败

第二轮 `object-inventory.json` 和重开验证均报告 `P001__main_hood` 有 **51 条非流形边**；重开验证还报告 **2 个零面积面**。这与初审产物中主壳为 0 的状态不同，是主壳改用 loft、增加孔/接收套并做连续布尔后出现的新回归。渲染外观看起来完整，前盖/主壳抽样相交也为 0，但这些结果不能抵消单体拓扑失败。

当前应明确写为：“第二轮外观和装配占位可评审，主壳网格拓扑未通过重开验证”；不能写成“网格检查通过”“验证全部通过”或“可进入打印”。在下一次修订中需要定位非流形边与零面积面来自哪一步 loft/UNION/DIFFERENCE，并在重新保存后让同一重开检查归零。

#### P3 — 字体失败是验证脚本的筛选缺陷，不能当成交付资源缺失

报告把 `Bfont Regular` 计入字体列表并因其未打包而失败；脚本实际只排除了名字精确等于 `Bfont` 的字体。Blender 内置 Bfont 通常不需要作为外部资源打包，而真正使用的 `Arial Unicode MS Regular` 已显示 `packed: true`。因此 23/25 中的字体失败属于校验逻辑误报的可能性很高。

建议把过滤条件改为识别 Blender 内置 Bfont，再重跑验证；在修正验证器前，只能说“实际使用的 Arial Unicode 字体已打包、无外部位图，字体检查项因 Bfont 识别问题失败”，不要直接声称 25/25。

### 第二轮当前结论

初审中的前盖无配对定位、独立小特征被误计为零件、修改器顺序警告、P010 被误列为可打印候选、腿部与 PCB 相交以及爆炸图裁切，均已得到可核对的修复或诚实降级。尚未选定真实舵机，P010 承载连接仍未设计，脚宽 208 mm 也未做稳定性和运动学验证；这些待办表述符合事实。

第二轮尚不能关单，唯一实质几何阻塞是主壳的 51 条非流形边和 2 个零面积面。字体项应修正验证器后复跑。只有主壳拓扑归零、重开验证按修正后的合理规则全数通过，才可以把本轮描述为“第一阶段模型验证完成”；即使届时通过，也仍不构成生产打印发布。

---

## 最终复核（2026-09-07）

本节取代第二轮的阻塞结论，初审和第二轮文字继续保留作为修订记录。最终复核依据当前构建脚本、对象清单、重开验证报告、README 和最后一轮 8 张渲染。

### 复核结果

- 主壳接收套已改为先将后退 0.3 mm 的实心圆柱与壳体并集，再统一切出 3.4 mm 半径内孔，避免接收套内孔与壳面共面。当前 `object-inventory.json` 中 `P001__main_hood` 为 **0 条非流形边、0 个零面积面**；全部 150 个受检网格的拓扑项均通过。第二轮记录的 51 条非流形边和 2 个零面积面已经消除。
- 字体检查已排除名称以 `Bfont` 开头的 Blender 内置字体。重开报告只检查实际使用的 `Arial Unicode MS Regular`，其状态为已打包；外部位图数量仍为 0。第二轮的字体误报已经修复。
- 最新重开报告为 **25/25**，明确保持 `print_release: false`。其中包括毫米单位、屏幕 PCB 标称包络/孔中心、显示居中、单体拓扑、若干明确命名的实体相交、四个髋舵机与 PCB、七个直线拆盖采样位置、四个展示帧、8 个相机构图、字体和原生图形依赖检查。
- 屏幕支撑框已新增 `6 × 8 × 33 mm` 的局部排针让位开口，对应当前假设的后向排针区域。该开口解决了占位模型中的明显穿插风险，但排针焊接方向、线缆接头和弯折半径仍必须实测；README 没有把此处写成最终连接器空间验证。
- 最后一轮构建日志显示 151 个网格、31 个 `PRINT_CANDIDATE`，8 张 1800×1350 PNG 全部重新生成并最终保存 `.blend`。构建日志没有恢复 `Applied modifier was not first`；仅有面向 Blender 6.0 的 `use_nodes` 弃用提醒。
- 人工复看 `hero`、`front_open`、`exploded`、`layout`，并结合前轮 `side` 复核，未见主壳破面、大接缝、排针/支架明显穿插或画面裁切。前盖定位接收结构在拆开/爆炸视图中表达清楚，爆炸图耳件完整位于画幅内。

### 文档边界判断

README 对交付边界的表述准确：本包用于第一阶段外观、比例、分件和空间占位评审；“分件”不等于制造件 BOM；P010 是隐藏的未完成连接占位；拆开中间帧不是已验证动作；不输出 STL、3MF、STEP 或 G-code；真实屏幕细节、舵机和其他电子件、紧固与承载、运动范围、材料/表面和公差仍待确定。118 mm 机身宽、208 × 106 × 122.5 mm 当前静态包络、0.2 mm 定位径向间隙以及 21 mm 旋钮突出等也均按假设或待实测值披露。

重开报告同样主动列出未检查项：整机碰撞矩阵、连续 swept-volume、制造公差与最小壁厚、紧固/工具/载荷路径、舵机运动/强度/稳定性/步态、切片和实物试配、电气/热/声学性能。因此 **25/25 只代表定义在验证脚本中的第一阶段检查通过**，不能扩展解释为制造验证通过。

README 文件清单中列出了 `reports/validation-report.md`，但最终复核时该文件不存在；目前实际可用的验证证据是 `reopen-verification.json` 与 `reopen-verification.log`。这是交付包清单的一处轻微不一致，不影响 `.blend`、渲染和机器可读验证本身，但正式交付前应删除该不存在的条目或补上与 JSON 一致的可读报告。

另一个可追溯性细节是：25/25 重开报告生成在最后一轮完整渲染之前，而渲染流程末尾又保存了一次由同一脚本重建的 `.blend`。本次核对确认最终构建日志成功、脚本几何未在两者之间变化，对象清单仍为全零拓扑；若要形成严格的“最终文件哈希对应验证报告”，应在最后保存后再运行一次只读重开验证并记录文件哈希。这属于交付证据强化，不构成本阶段模型评审的实质阻塞。

### 最终结论

**本第一阶段包现在可以作为外观、比例、分件组织、内部占位和拆开/爆炸展示模型交付评审。** 初审发现的可复现几何、对象分类、相交、修改器顺序和构图问题均已修复或按未完成占位诚实降级；当前定义的重开验证为 25/25，未发现新的第一阶段阻塞。

制造待办仍未完成：需要实测屏幕/旋钮/按钮/排针与线缆包络，选定舵机和电子模块，完成 P010 与壳体的真实载荷连接、紧固与工具路径、腿部运动学/稳定性/强度、整机碰撞、壁厚/公差、毫米导出、切片和实物试配。完成这些工作并另行验证后，才能发布打印或商家生产交付包。
