xaiojie/papabot/pcb-design/integrated-v1/user-latest-review-2026-09-13/核对结论.md

# 用户最新版 PCB 核对结论

核对日期：2026-09-13，在线源文件比对完成时间为 18:41（Asia/Shanghai）。

**当前 PCB 的电路和布局与 V1.2 无旋钮参考设计一致。用户修改的四处顶层丝印已保留，后续以用户最新版为准。** 本次未修改 PCB 器件、走线、铜皮或文字，仅做读取、DRC、导出备份和版本说明整理。

## 核对对象

- 在线工程：`DesktopAssistant_Integrated`，UUID `50ae04bdafb74b93b94b7cc4c08171e1`。
- 在线 PCB：`PCB1`，UUID `bc31667e02a33e5b`；通过端口 49620 的 Bridge 读取。
- 用户制造文件：下载目录中的 `Gerber_PCB1_2026-09-13.zip`，本目录保留其字节不变的副本。
- 电气/几何基线：`../final-no-encoder-2026-09-12/` 中的 V1.2 无旋钮交付。

## 用户改动

| 丝印 | 当前内容与变化 |
|---|---|
| 署名 | `Jay` 改为 **`小皖子和爬爬 2026 0913设计`**，字体及位置按用户当前文件保留 |
| 产品名 | `DesktopAssistant` 内容未变，移动位置 |
| 版本 | `Integrated V1.2` 内容未变，移动位置 |
| 规格 | `2S / 2oz / 1.6mm` 内容未变，移动位置 |

以上均为顶层丝印对象。已查看用户 Gerber 的顶面渲染：底部文字完整可见，未见这些文字压住焊盘或安装孔。

## 电路、布局和 DRC

原生源文件逐类比较确认：79 个器件、310 个引脚网络分配、59 个有连接网络、787 段走线（顶层 608 / 底层 179）、84 个过孔及 10 个静态 GND 填充的电气和几何记录一致。板框仍为 110×75 mm 矩形，四个安装孔不变，EC11 仍已移除。

非设计差异仅包括文档时间/客户端元数据，以及填充对象的空引用写法；填充路径、层和网络未变。

当前 PCB 原生 DRC 结果：`errors: []`，`strict_pass: true`。这次结果是 PCB 检查，不代表整机通电或负载实测验收。

## Gerber 比对细节

用户 ZIP 的 CRC 通过。与 V1.2 制造基线比较，电路、板框、走线和铜皮一致；主要可见变化为顶层丝印。用户导出额外包含钻孔图示层 `Gerber_DrillDrawingLayer.GDD`。

两份 Gerber 不是字节相同：基线与用户导出的坐标格式分别为 2.6 mm 和 4.5 mm。除常规末位舍入外，三个已修正的 NC 连接器焊盘有局部导出数值差异，最大坐标分量差约 0.00116 mm，局部铜/阻焊边界差在 0.003 mm 内；三个焊盘之外未发现超出常规舍入的铜/阻焊变化。0.003 mm 容差仅用于这三个位置，并非全板统一放宽。

这三个孔的实际导出直径均为 **1.2 mm**。钻孔数量为 203 个镀铜圆孔（包含 84 个过孔）、4 个镀铜槽孔、7 个非镀铜孔，与基线一致。引脚网络也一致。完整原始差异和局部容差依据保留在制造比对 JSON 中。

编辑器中的红/蓝表示铜层；本目录蓝/金预览使用统一的检查配色。下单页面的配色可能不同，实际阻焊颜色及表面处理由订单工艺参数决定，本次未读取当前订单选择。预览中较深的区域是无铜区域，不表示板上新增挖空。

## 当前文件入口

- [用户最新版蓝色顶面预览](User_latest_Gerber_Top.png)
- [可编辑工程原样备份](DesktopAssistant_Integrated_用户丝印原样备份_20260913.epro2)
- [用户 Gerber 原文件副本](Gerber_PCB1_2026-09-13.zip)
- [在线 PCB 源文件快照](User_latest_PCB1.source)
- [原生 PCB 比对记录](Live_PCB_comparison.json)
- [当前 PCB DRC](User_latest_PCB_DRC.json)
- [制造文件比对记录](Manufacturing_comparison.json)
- [文件 SHA-256](SHA256SUMS.txt)

工程归档已通过 CRC 检查并回读确认新版文字及位置。这是用户当前工程的原样备份，未重新规范化原理图导出缓存。旧交付文件保留作历史和接线资料，不用于覆盖本版 PCB 丝印。本次未提交订单或支付。
