xaiojie/papabot/mechanical-design/structure-a3/delivery/DesktopAssistant-A3/验证说明.md

# A3 验证记录

- 30/30个STL重新读回：每个为单一连通闭合体、正体积，无边界/非流形边、重复或退化三角面；与清单尺寸一致，毫米单位，Z=0落底。
- 主装配场景30个可打印网格重开闭合。原V1/A1保留，A2作为历史参考不覆盖。
- 完整91×44mm原板与7个原位旋钮/按键对象已恢复；显示面法线为−Y。正面有效区143条抽样视线均未被前盖或遮光井挡住。
- 玻璃前面至前盖最前面名义内凹20.79mm；旋钮包络最前点至盖内面轴向间隙1.31mm。
- 静态检查覆盖231个外购件、接插件或预留体，453对执行实体交集，未发现超过0.05mm³冲突。包含原位EC11、独立按键、屏幕排针与前盖M3×30螺丝包络。
- 前盖沿−Y、后盖及其附件沿+Y，各抽样16个位置：0、0.25、0.5、1、2、3、5、8、12、16、20、24、30、40、60、100mm，未报告超过0.05mm³的冲突。
- 腿部沿用A2几何；已抽样32个逐腿姿态（髋−15/0/+15°，膝−20/0/+20°的非静止组合），未报告零件冲突。不是同时四腿联动验证。
- 爆炸和拆盖展示场景生成前后，主装配打印件的几何与位置指纹一致。

实体交集小于0.05mm³不列作冲突，共面安装接触允许。直视检查不保证大角度可视范围；离散拆盖位置不等于连续扫掠。旋钮总高度仍用V1假设，商品图仅确认轴长标记。以上没有验证真实模块、线束、打印公差、螺纹受力、负载、步态、温升或声学表现。

报告位于reports/：complete-stl-verification.json、complete-reopen.json、assembly-collision-check.json、cover-service-check.json、leg-motion-sample-check.json、complete-preservation.json、presentation-preservation.json、final-artifact-reopen.json。独立交付包内含相同报告。
