xaiojie/papabot/项目进度总览.md

# 桌面助手 · 项目进度总览

> **固件与联调复检：2026-10-26（Asia/Shanghai）。** 依据 2026-09-14～09-17 的实机记录刷新：
> 双舵机 bringup、屏幕「白屏」定性、assistant 产品固件实机跑通（屏幕/Wi-Fi/天气/额度/云端中转）、
> 第三部 GIF 动画与分区表改造。**本轮只读代码与产物、未重新上电**（当前机器上没有 USB 串口设备），
> 所有"实测"标注均来自 9 月那几轮的串口记录。

> **PCB 用户版本核对：2026-09-13 18:41（Asia/Shanghai）。** 当前在线 PCB1 与 V1.2 无旋钮基线的电路和布局一致，保留用户新增的“小皖子和爬爬 2026 0913设计”及另外三处文字位置调整。原生 PCB DRC 严格通过；当前 PCB 编辑与制造文件入口改为 [用户最新版核对与原样备份](pcb-design/integrated-v1/user-latest-review-2026-09-13/核对结论.md)。本次仅检查、备份及更新版本说明；软件、结构和实机状态沿用下文各自的记录时间。

> 更新：2026-09-12 16:39（Asia/Shanghai）。
> **PCB 专项更新：2026-09-12 23:35。** Integrated V1.2 已移除 EC11，完成五页原理图、PCB 布局布线、双面接地填充及原生 DRC；导出工程和 Gerber 已核验。入口见 [V1.2 无旋钮交付](pcb-design/integrated-v1/final-no-encoder-2026-09-12/README.md)。下文软件与实机记录仍保留 16:39 的检查时间。
> 本次 PCB 更新依据：在线 EDA 原理图/PCB、HS24S010B 规格书、修订工程及制造文件检查报告；未烧录、运行舵机或下单。软件/实机章节的源码及控制台健康查询来自此前 16:39 检查，本次未重测。
> 当前进度统一从本文查看。旧 `PROGRESS.md`、各 README 的日期章节及 `design-selection.json` 保留设计历史；出现冲突时，按本文列出的证据与适用版本判断。

## 1. 整体处于什么阶段

**目前已做出能显示中文和动画、联网获取信息、通过网页远程控制的桌面原型，正在进行模块联调。完整的“能听、能说、四足行走、内置电池”的整机尚未完成。**

| 分项 | 已完成 | 当前缺口 | 状态依据 |
|---|---|---|---|
| 主控 | ESP32-S3 开发板已到货，Flash、PSRAM、Wi-Fi、LED、按键实测通过 | 整机并发与长期稳定性 | bench-v1 实机验收记录 |
| 屏幕与交互 | 旧 TOUGLESY ST7789 实屏点亮（12 针接线全部验证通过）；中文、表情、时钟、天气、额度、状态、**三部 GIF 动画**（共 6+3=9 屏）；旧屏旋钮切屏 | 新 HS24S010B 点亮（无旋钮版）、信息与表情联动 | assistant 实机记录 + 当前源码 |
| 联网与网页 | 天气和账号额度已接通；网页切屏、换表情、远程画面、状态回传已验证 | AP 配网、多设备、数据字段直接上报 | 控制台部署记录 + 本次健康查询 |
| 舵机运动 | **双舵机**台架串口验证通过（GPIO18/GPIO15，两路 PWM 各自独立通道、1000–2000 µs）；bringup 与 assistant 都已是双路配置 | 实物型号复核、关节标定、PCA9685 八路、单腿与步态、带载温升 | 2026-09-14 串口实测 + 当前 `config.h` / `wiring.json` |
| 语音 | 麦克风、功放、喇叭已选型，接口已规划 | 录音、播放、ASR、对话、TTS 全链路 | 未见完成验收记录 |
| RevB 载板 | 原生工程、Gerber、Jay/爬爬丝印与设计检查齐全 | 下单/收货状态、焊接、PCB 上电及整机验证 | 制造包哈希/CRC 本次复核通过 |
| integrated-v1 集成板 | 五页原理图、110×75 mm 双层 PCB、79 器件、EC11 已移除、全布线/双面接地填充、原生 DRC 和 Gerber 核验完成 | 打样、焊接、供电/充电/负载实测、外壳适配 | 9 月 12 日最终工程与检查报告 |
| A3 结构 | Blender 总装、30 件 STL、装配资料；ACE800 另有 2 件适配件 | 实物试装、打印、负载；集成板方案的结构适配 | 静态验证通过，实装未确认 |
| 电池与供电 | ACE800 2S 电池已选；模块方案与集成方案均有设计资料 | 采购/到货、充电限流、负载压降、温升、续航 | 选型记录；未见整机供电实测 |

不按文件数量计算完成百分比。下一阶段的成果应以语音闭环、单腿动作、供电测试和实体装配来验收。

## 2. 目前可以运行的软件

### 2.1 本机固件

- **bringup**：硬件自检工程，保留作接口排查工具。主控已烧录实测；主机测试现为 **16 组、293 项检查、0 失败**（2026-09-14 双舵机改动后重跑）。它的 9 月 10 日验证文档没有包含后续全部屏幕/舵机进展。
- **assistant**：产品应用固件。六个固定页面（表情、数字时钟、表盘、天气、账号额度、状态）加 **三部 GIF 动画页**，共 **9 个可轮换页面**（序号 0–8；`screen` 的范围随动画部数变化）。网页用 7 个类别按钮，其中“动画”属于同一类别。
- 已有记录的表情区域刷新约 **23 fps**；这是 10 MHz SPI 配置下的阶段实测，不能套用为所有页面帧率。
- 当前本地 USB-JTAG 固件镜像存在：`firmware/assistant/.pio/build/lckfb_s3_usbjtag/firmware.bin`，**约 4.0 MB，文件时间 9 月 17 日 11:16**（已换用 `partitions-assistant-8mb.csv` 单 app 6.875 MB 布局，才能装下三部动画）。镜像存在与时间先后不等于已经重新核对设备内版本；9 月 16 日那次烧录成功后未再读取设备固件版本。
- 2026-09-16 实测基线：全屏 320×240 推屏 **133 ms**；表情页局部刷新 160×136 **37.8 ms**。运行期 heap≈206 KB、PSRAM≈7954 KB。
- assistant 的现有主机测试范围主要是脏矩形与 SPI 预算（历史记录为 5 组、25 项）；不代表网络、音频、供电和机械运动全部通过测试。本轮未重跑构建或行为测试。

### 2.2 网页控制台与外部数据

入口：[爬爬控制台](https://papa.papaclaoud.top/)。设备通过 WSS 主动连接中转服务。

已有端到端记录覆盖切屏、换表情、前后翻页、刷新数据、状态回传与画面推流。历史远程画面实测约 **4.5 fps**（设定上限 5 fps），与本地屏幕帧率是两项不同指标。当前版本按浏览器连接数量自动开关推流。

**本轮健康检查**：`GET /api/health` 返回 `ok=true`、`service=papa-relay`、`deviceOnline=true`、`clients=0`。这说明查询时服务正常且设备在线；本轮未登录控制台或重测按钮、视频帧和舵机。

当前源码：天气每 **20 分钟**刷新，账号额度每 **5 分钟**刷新，失败 **1 分钟**后重试。已有自动连网、Wi-Fi 掉线重连与云端重连代码。额度页显示的是账号状态和额度，**语音对话功能仍未接通**。

### 2.3 源码已更新、旧说明尚未完全同步的地方

| 项目 | 当前可核对的事实 | 旧说明的问题 |
|---|---|---|
| Wi-Fi 配置 | `wifi connect` 成功后默认写入应用 NVS；末尾加 `ram` 才只用于本次连接；`wifi forget` 可清除 | “所有 Wi-Fi 凭据只存 RAM”不再适用于当前 assistant；bringup 仍是独立工程 |
| 舵机限幅 | 当前 `config.h` 为 **1000–2000µs**，1500µs 中位、每 20ms 变化最多 5µs、10s 超时停 PWM | README 中 500–2400µs 是上一阶段配置；脉宽不能直接当作已标定角度 |
| 舵机接线 | 单舵机目前使用开发板 GPIO18 临时测试路径 | 不据此认定 RevB 载板已增加该舵机接头或铜线 |
| 额度刷新 | 当前为 5 分钟，部署记录有约 304 秒间隔的阶段实测 | assistant README 中还有 10 分钟描述 |
| 字库与权限 | 字库仍需明确再分发许可；设备支持在 NVS 保存 API/管理凭据 | 不能继续引用旧“零持久化凭据”结论；发布前需替换合适字库、收窄额度读取权限 |
| 动画格式 | 2026-09-17 起为 **GFX1 v2**：`u32 start + u16 run`，`0xFFFFFFFF` 结束，单帧像素数不再受 65535 限制 | 文档里 `u16 start / 0xFFFF` 的写法已过期；脚本与 `anim.cpp` 的 `kFormatVersion` 必须同步，否则固件拒绝加载 |
| flash 分区 | assistant 用 `partitions-assistant-8mb.csv`（单 app 6.875 MB，无 OTA / 无 spiffs）；**bringup 仍是 `default_8MB.csv`** | 两个工程的分区表已故意不一致（bringup 的 dist 交付件按原布局做过哈希）。nvs 偏移相同，所以保存的 Wi-Fi 凭据不受影响 |

## 3. PCB 的三个版本分别到哪了

| 版本 | 用途 | 文件状态 | 当前结论 |
|---|---|---|---|
| RevA | 早期载板 | 历史工程与 Gerber 保留 | 屏幕 5V 接法已由 RevB 的 3.3V 修订替代；不作为当前制板入口 |
| **RevB + Jay/爬爬** | 现有模块方案载板 | 原生工程与制造包完整、检查通过 | 当前已完成的载板交付版本；采购与实物验收仍独立确认 |
| **integrated-v1** | 充电/保护/舵机配电等进一步集成 | 五页原理图、完整 PCB 和 Gerber 已导出；原理图/PCB DRC 严格通过 | 设计交付完成；台架、机械及制造审核仍是后续验收阶段 |

### 3.1 RevB 的有效交付

- **80 × 32mm、2 层 FR-4、1.6mm、1oz**，保留左侧天线缺口和 4 个 Ø3.2mm 安装孔。
- 屏幕 VCC/BLK 使用 3.3V；JP1/JP2/JP3 初始断开、R4–R7 默认不焊，供电按 RevB 装配说明选择。
- 已有严格原理图/PCB DRC 通过记录、26 个网络连通、104 个元件焊盘复核。新增 Jay/爬爬仅改顶层丝印，电路和机械几何保持不变。
- 本轮复核原生工程和 Gerber 的 SHA-256 与 `verification.json` 一致，两个归档 CRC 通过。
- 用户此前填写过嘉立创下单表单（5 块、蓝油白字等），**现有记录没有证明已经提交、付款、投产或收货**。以用户补充的实际状态为准。

文件：[带字版交付说明](pcb-design/revb-lettering-2026-09-10/README.md) · [Gerber](pcb-design/revb-lettering-2026-09-10/DesktopAssistant_RevB_Jay_PaPa_Gerber.zip) · [原生工程](pcb-design/revb-lettering-2026-09-10/DesktopAssistant_RevB_Jay_PaPa.epro2) · [RevB 装配说明](pcb-design/native-rev-b/装配与上电核对.md)。

### 3.2 integrated-v1 的真实进度

当前 EDA 工程 `DesktopAssistant_Integrated` 已完成五页原理图，**79 个器件、310 个引脚、59 个有连接网络**。HY2120-CB 保护、HY2213-BB3A 均衡输出与 MOS、电源隔离和 IP2326 充电连接已修复；原理图原生 DRC 严格通过，逐引脚与 15 项电气关系检查均通过。

关联 PCB1 为 **110×75 mm、2 层 FR-4、1.6 mm、2oz**，四个 Ø3.2 mm 安装孔。787 段在线走线、84 个过孔和 10 个双面 GND 填充区域已完成，PCB 原生 DRC 严格通过。可编辑工程及 Gerber 的 CRC、线路、钻孔、槽孔、锡膏和铜皮导出核验均已完成。

屏幕为 **HS24S010B（C5329587），没有旋钮或按钮**。主板使用 XH-10A（2.5 mm）线束接口，屏幕端为单排 2.54 mm 10PIN，屏幕独立安装。EC1 和 R11/R12/R26 已从原理图与 PCB 移除，ENC_A/ENC_B/ENC_SW_N 已删除；J1.13、J2.2、J2.8 改为 NC，旋钮的两个定位孔也已移除。新屏按 3.3V 四线 SPI 接入，BLK 固定高电平开启，可选 FSO/FCS 未使用。ESP32 开发板和两路降压、音频等模块仍按外置/插接件装配。

当前铜皮为可编辑的静态填充，修改布局或走线后须重新生成并复查。尚未完成本版制板下单、焊接、实际充电/保护/舵机负载验证以及与原 A3 外壳的联合试装。0.353A 充电电流是公式值，不能据此视为已完成电池验收；沉金等表面工艺未在本轮提交订单。

屏幕资料的引脚表与 CN1 机械图一致，但附带小原理图的第 7–10 脚顺序不同，接线前需核对实物丝印；规格表、机械图和商品说明的视窗尺寸也有差异，外壳开窗未在本轮冻结。9 月 12 日交付工程/PDF 已清除 EDA 导出缓存的旧版重叠文字。9 月 13 日起，PCB 编辑以用户在线最新版及其原样备份为准，保留新版丝印；原样备份未重新整理原理图导出缓存。

文件：[用户最新版 PCB 核对与备份](pcb-design/integrated-v1/user-latest-review-2026-09-13/核对结论.md) · [V1.2 无旋钮历史交付](pcb-design/integrated-v1/final-no-encoder-2026-09-12/README.md) · [装配与接线](pcb-design/integrated-v1/final-no-encoder-2026-09-12/装配与接线说明.md)。

## 4. 结构、采购与电源

### 4.1 A3 是已有的结构试装基线

A3 按现有 TOUGLESY 完整屏幕模块设计：屏幕正对使用者、内凹约 20.8mm，原位旋钮和独立按键位于可拆前盖内。机身含盖约 **124 × 116.8 × 76mm**，不包含腿、耳朵等外伸部分。

- 30 个独立 STL、Blender 总装、拆盖与爆炸视图、装配打印说明已交付。
- 已有静态记录：30 件闭合/连通检查通过；453 对实体交集检查没有超过设定阈值的冲突；拆盖抽样检查通过。
- ACE800 方案另外增加 **R21 定位垫框、R22 保护板托架**。原 30 件未因此替换。
- 未见实体打印、安装配合、线束避让、载荷及步态完成验收。
- **110×75mm 集成板与新屏幕尚未同步到这套 A3 结构。** 集成方案中把外形包络当作可用内腔的文字，不能用于证明装得下；需要重新核对支架、孔位、模块高度与线束空间。

文件：[A3 说明](mechanical-design/structure-a3/README.md) · [试装 ZIP](mechanical-design/structure-a3/delivery/DesktopAssistant-A3-整机结构试装包.zip) · [电池适配件](mechanical-design/battery-ace800-a3/README.md)。

### 4.2 实物与采购登记

| 物料/服务 | 当前能确认的状态 |
|---|---|
| LCKFB-ESP32S3R8N8 | 已到货并有实机测试记录 |
| TOUGLESY ST7789 + EC11 | 已到货并飞线点亮；继续作为当前模块测试屏幕 |
| 单个测试舵机 | 已有动作记录；此前采购口述为 MG90S，较新测试记录称 SG90，实物型号需核对；不能把一个舵机试验扩展为八路完成 |
| 新屏 HS24S010B | 集成方案选型，未见购买/到货证明 |
| 电池、保护/充电、音频、其余舵机和小件 | 有选型/BOM；最新下单、收货数量待补 |
| PCB 与 3D 打印 | 制造文件或试装文件存在；实际订单、收货状态待补 |

**电池当前选型是现货格氏 ACE800（2S、7.4V、800mAh、T 插），旧定制 1000mAh 方案已被覆盖。** 模块路线配 HX-2S-JH20 外置保护均衡；集成路线计划把保护与充电做进 PCB，两条路线的 BOM 应分别核算。电池和模块参数目前来自选型资料，尚非整机负载验证结果。

采购 V7 的 **¥467.30** 是历史已选商品参考，不含当时未报价的电池、运费和打样，也不是已支付金额；后续电池与集成方案都有替换，不能拿此数作为当前总价。原始 **≤¥300** 目标尚未形成满足该预算的最终 BOM，需重算两条路线的实际成本。

文件：[采购 V7](hardware-selection/bom-v7/README.md) · [现货电池方案](hardware-selection/battery-stock-2026-09-09/README.md)。

## 5. 接下来按什么顺序推进

| 顺序 | 具体工作 | 完成标准 |
|---|---|---|
| 1 | 补齐订单/到货与实物型号记录，整理模块路线和集成路线的差额 BOM | 清楚已买、待买、可复用物料及各路线成本 |
| 2 | 集成板先修均衡选型/连线、补最新原生归档、解决 PCB 导入 | 电气设计审查闭合；PCB 有正确元件与网络，再进入布线 |
| 并行 A | 用现有开发板完成音频模块测试，再接 ASR → 对话 → TTS | 能录到有效声音、扬声器正常播放，完成一次语音往返 |
| 并行 B | 单舵机型号/脉宽标定 → 单腿两关节 → PCA9685 八路 | 无硬顶限位，动作与急停符合预期，有电流和压降记录 |
| 3 | 根据最终使用的 PCB/屏幕路线更新支架和壳体，先做关键件试装 | 实物尺寸、孔位、线束、拆盖与单腿装配通过 |
| 4 | 完成电池/充电/电源负载测试，再组合成整机 | 屏幕、Wi-Fi、音频和运动并发不复位，温升/压降可接受 |
| 5 | 四足站立、缓步、转向及持续运行；完善配网与交互 | 实机达到“可显示、可语音、可行走”的产品目标 |

语音模块测试和单腿验证可以先于集成 PCB 完成。当前最有价值的新验收结果是语音闭环、受控单腿动作和真实供电记录。

## 6. 本轮整理与证据索引

本轮纠正了旧总览中的 RevA 制板入口、电池定制状态、屏幕/舵机未测、六屏/八屏口径及 Wi-Fi 存储策略等冲突。旧文档原样备份在 [本轮历史备份](docs/history/project-status/20260912-163905/项目进度总览.md)。

| 证据 | 本轮核对范围 |
|---|---|
| [主控实机记录](firmware/bringup/docs/验证记录.md) / [验收 CSV](firmware/bringup/docs/实机验收记录.csv) | 读取既有实机数据，未重复上电测试 |
| [主机测试结果](firmware/bringup/test/host-test-results.txt) | 读取既有 14/259 通过记录，未重跑 |
| [应用固件说明](firmware/assistant/README.md) / [当前主程序](firmware/assistant/src/main.cpp) / [配置](firmware/assistant/include/config.h) | 对照历史实验记录和当前实现，区分文档滞后 |
| [控制台部署记录](firmware/web-console/部署记录.md) | 对照已有端到端记录，另只读查询本次 `/api/health` |
| [RevB 丝印检查](pcb-design/revb-lettering-2026-09-10/verification.json) | 重新计算交付包 SHA-256、检查 ZIP CRC，均通过；未重新运行 CAD DRC |
| [集成板 V1.2 无旋钮交付](pcb-design/integrated-v1/final-no-encoder-2026-09-12/README.md) | 在线 EDA 检查、逐针验证及修订工程/Gerber 核验已完成 |
| [A3 静态检查](mechanical-design/structure-a3/reports/assembly-collision-check.json) / [STL 检查](mechanical-design/structure-a3/reports/complete-stl-verification.json) | 读取静态验证报告，不代替实体试装 |

待用户补充的记录：PCB/结构件是否下单或收货，电池/音频是否到货，以及当前单舵机的实际型号。
