xaiojie/papabot/PROGRESS.md

# 桌面助手 · 项目进度总览

> 历史快照，保留追溯。当前状态请读 [项目进度总览（2026-09-12）](项目进度总览.md)。本页含尚未同步的屏幕、舵机、电池和 PCB 状态，请勿作为当前采购或测试依据。

> 整理时间：2026-09-10
> 依据：仓库实际文件、实机串口遥测、真实 API 返回 —— **不凭记忆，每条都标了验证方式**

---

## 0. 一句话状态

**屏幕还没到，但固件已经跑通了全部六屏功能，并且能在浏览器里实时看到设备的真实画面。**

整机尚未组装：PCB 未下单、结构件未打印、舵机/语音/供电都还没接线。

---

## 1. 硬件进度

| 分项 | 状态 | 说明 |
|---|---|---|
| **主控** | ✅ **已到手并验证** | LCKFB-ESP32S3R8N8，8 MB Flash + 8 MB Octal PSRAM |
| **屏幕** | ✅ **已到货并点亮** | TOUGLESY 2.4″ ST7789 320×240，飞线跑通全部 8 屏|
| **旋钮/按键** | ✅ 已到（屏上自带）| EC11 编码器 + KEY0 |
| **舵机** | ✅ **已能驱动** | SG90 首测通过；主固件已内置控制（GPIO18，含限幅/斜率/超时三重保护）|
| **电池** | ⏸ 定制洽谈中 | 2S1P 7.4V / 真实 1000 mAh / 持续 ≥10 A，报价尺寸未定 |
| **PCB** | ⏸ **暂缓下单** | RevA 与 RevB 都已出 Gerber，见 `pcb-design/` |
| **结构件** | ⏸ 暂停 | Blender 源文件在 `mechanical-design/` |
| **采购总额** | 参考 ¥467.30 | 不含定制电池/运费/打样；未下单 |

**实机已验证的硬件事实**（bench-v1 串口遥测）：

```
chip      ESP32-S3 rev0
Flash     8,388,608 字节
PSRAM     heap 8,386,295 字节
LED       GPIO48 绿灯 1 Hz，PWR 红灯常亮
按键      BOOT 计数 3/3，RST 复位正常
```

**PCB 已知待办**：RevA 无铺铜地平面；JP1 无防倒灌（VBUS 直连 5V 已核实）；JP3/J10 的 3.3V 取舍待屏幕到货后决定。

---

## 2. 固件进度：两个工程

| 工程 | 定位 | 代码量 | 单测 | 状态 |
|---|---|---|---|---|
| `firmware/bringup/` | **bench-v1** 硬件自检 | 4,390 行 | 14 用例 / **259 检查** | ✅ 实机验证通过 |
| `firmware/assistant/` | **产品固件** 六屏应用 | 2,496 行 | 5 用例 / **25 检查** | ✅ 实机跑通 |

两者**分开、互不覆盖**：bench-v1 保留为"板子是否正常"的判据，assistant 是真正的产品。

**assistant 构建占用**（`lckfb_s3_usbjtag` 环境）：

```
RAM    [==        ]  22.3%   (73,112 / 327,680 字节)
Flash  [====      ]  42.6%   (1,422,493 / 3,342,336 字节)
```

---

## 3. 六屏功能：全部完成

| 屏 | 内容 | 数据源 | 状态 |
|---|---|---|---|
| ① 表情 | 两种胶囊眼 + 微笑弧，五种情绪，眨眼/视线/呼吸 | 本地几何 | ✅ **23 fps** |
| ② 数字时钟 | 大号时间 + 中文日期 + 昵称「爬爬」 | NTP 阿里云 | ✅ |
| ③ 表盘时钟 | 60 格刻度 + 三指针（秒针橙色） | NTP | ✅ 1 fps |
| ④ 天气 | 长沙 · 岳麓区，实时温度/天气/高低温/观测时间 | **和风 API** | ✅ 实测 `20°C 阴 18~25C` |
| ⑤ 账号额度 | 上游账号的窗口用量 + 限流状态 + 重置券 | **自建 sub2api** | ✅ 实测 `公司Pro 7天100% 重置券2张` |
| ⑥ 状态 | 信号 / IP / 运行时间 / 堆 / PSRAM / SPI | 本机 | ✅ |
| ⑦⑧ GIF 动画 | 「奶蛙」两部，各 20 帧，7.8 / 8.8 fps | 本地 flash | ✅ |

**交互**：旋钮循环切屏、按键切换情绪、串口命令全覆盖。

**实机画面证据**：`firmware/assistant/docs/device-all-screens.png`
（**从设备 PSRAM 帧缓冲 dump 出来重建的真实画面**，不是设计稿）

---

## 4. 三个关键技术决定（都有实测支撑）

### 4.1 为什么必须做脏矩形

全屏 320×240 RGB565 = 153,600 字节，@10 MHz 实测 **133 ms** → 只有 7.5 fps，表情根本动不起来。

于是架构定为 **PSRAM 帧缓冲 + 脏矩形局部刷新**：

| 区域 | 字节 | 耗时 | 帧率 |
|---|---|---|---|
| 全屏 320×240 | 153,600 | 133 ms | 7.5 fps |
| **表情动态区 160×136** | **43,520** | **37.8 ms** | **23 fps** |
| 静态屏 | 0 | 0 | 不浪费带宽 |

### 4.2 中文字体必须自带

屏幕模块**没有字库芯片**，ST7789 只认像素，Adafruit GFX 只有 5×7 ASCII。

方案：`scripts/make_cjk_font.py` 用 PIL 把 TTF 栅格化成 1bpp 点阵 → 二进制 → 由
`board_build.embed_files` 嵌进 flash → 固件按 Unicode 码点二分查找后上色绘制。

| 项 | 值 |
|---|---|
| 字符集 | GB2312 符号 682 + 一级汉字 3755 + 补充 41 = **4,444 字形** |
| 字号 | **16 px** 与 **24 px** 两套 |
| 体积 | 174 KB + 347 KB = **521 KB** |
| 覆盖率自检 | 扫描固件源码里所有非 ASCII 字符，当前 **57/57 全覆盖** |

> ⚠️ **字体现用 macOS 自带字体（Hiragino Sans GB），仅供个人开发。**
> 发布/商用必须换思源黑体或 Noto Sans CJK（SIL OFL）。

### 4.3 浏览器里能看到设备真实画面

没有屏幕时"看到真实画面"的唯一办法：让固件把帧缓冲从串口吐出来，主机重建为 PNG。

| 阶段 | 单帧字节 | 耗时 | 帧率 |
|---|---|---|---|
| 最初（十六进制整屏）| 312,020 | 0.93 s | 1.1 fps |
| **改用行程编码 RLE** | **6,799** | **0.100 s** | **10 fps** |
| 再去掉重复 `screen` 命令与 PNG 放大 | — | 0.056 s | **17.8 fps**（六屏平均）|

---

## 5. 对外集成：两个真实数据源

### 5.1 和风天气（已打通）

- 接口：`/v7/weather/now` + `/v7/weather/3d`，岳麓区 LocationID `101250109`
- 踩到的坑：**只开 443**（必须 TLS）、**无条件 gzip**（用 ROM 里的 miniz 解，仅 916 字节 flash）、**TLS 握手爆 8 KB 栈**（提到 16 KB）

### 5.2 sub2api 上游账号额度（已打通）

- 接口：`GET /api/v1/admin/accounts/<id>`，认证头 `x-api-key: admin-…`
- **额度直接在返回的 `data.extra` 里，不需要 POST 探测**
- 踩到的坑：**请求头套了两层**（`Authorization: x-api-key:` → 401）、**没解 chunked**（HTTP/1.1 下长度行混进正文，而 curl 会透明解码所以主机上看不出来）

---

## 6. 凭据与安全

**仓库里：零残留**（Wi-Fi 密码、和风 Key、凭据 ID、API Host、admin Key、sk- Key 全部扫描过）

**设备 flash 里：**

| 数据 | 状态 |
|---|---|
| **Wi-Fi 密码** | ⚠️ **2026-09-11 改为可选落盘**（见下）|
| **Wi-Fi SSID** | ⚠️ 同上 |
| 和风 Key | ⚠️ 在 NVS（设计内，低价值）|
| **sub2api admin Key** | ⚠️ **在 NVS**（用户明确选择直连方案，这是预期行为）|

> **📌 2026-09-11 Wi-Fi 凭据策略变更**
>
> 原设计是「口令只进 RAM，绝不落盘」（显式 `WiFi.persistent(false)`），
> 代价是**每次断电都要重配**，做不成「始终在线」。
>
> 现改为**可选持久化**（存在 `assistant` 命名空间的 `wifissid`/`wifipass`）：
> ```
> wifi connect <ssid> <pass>        连接并保存到 NVS（开机自动连）
> wifi connect <ssid> <pass> ram    只连，不保存
> wifi forget                       清除保存的凭据
> ```
> 保存后 `setup()` 自动重连；掉线 15 秒后 `loop()` 里的看门狗调
> `netlink::reconnectWifi()`（非阻塞，不卡屏幕刷新）。
>
> **安全影响**：拿到 flash 就能读到 Wi-Fi 明文口令。
> 家用场景可接受；**产品化前**建议开 ESP32-S3 的 flash 加密，
> 或改回「每次上电由手机 BLE/AP 配网」。

> **产品化前必须改**：admin Key 权限很高，拿到 flash 就拿到整个中转站的管理权限。
> 建议改成「服务端加一个只返回这几个数字的只读接口」，把凭据留在服务器侧。

---

## 7. 未完成 / 阻塞

| 项 | 状态 | 阻塞原因 |
|---|---|---|
| **屏幕实机验证** | ⏳ **等硬件** | 屏幕未到货。PIN 序、颜色条、旋转/反转、编码器档位、背光电流都还没验 |
| **PCB 下单** | ⏸ 暂缓 | 用户决定先不动 |
| **结构件打印** | ⏸ 暂停 | 同上 |
| **语音 / 舵机 / 供电** | ❌ 未开始 | 依赖整机组装 |
| **表情与信息联动** | ❌ 未开始 | 例如额度打满时表情自动变难过 |
| **长按 / 双击** | ❌ 未开始 | 目前只有单击 |
| **开机配网页** | ❌ 未开始 | 现在全靠串口配置 |

> 🔌 **当前阻塞**：设备串口已断开（`/dev/cu.usbmodem*` 不存在），实时取景服务暂时取不到画面。

---

## 8. 建议的下一步

按价值排序：

1. **等屏幕到货** —— 这是唯一能解锁"真正看到它"的事。到货后按 `firmware/bringup/docs/` 的接线表接上，先跑 bench-v1 验硬件，再烧 assistant
2. **表情与信息联动** —— 现在六屏都通了，联动是纯软件，不依赖硬件
3. **字体换成思源黑体** —— 授权问题，一条命令的事，但发布前必须做
4. **把 admin Key 换成服务端只读接口** —— 安全债，越早还越好
5. **自动导出六屏对比图** —— 以后每次改 UI 一键回归

---

## 9. 关键文件索引

### 入口
| 文件 | 用途 |
|---|---|
| `README.md` | 项目交接总说明（含采购底表、架构、屏幕选型演变）|
| `START-HERE.txt` | 最新状态速览 |
| `PROGRESS.md` | **本文件** |

### 固件
| 路径 | 说明 |
|---|---|
| `firmware/assistant/README.md` | 应用固件全部技术细节与踩坑记录 |
| `firmware/assistant/src/main.cpp` | 主循环、串口命令、编码器/按键 |
| `firmware/assistant/src/apps.cpp` | 六屏绘制逻辑 |
| `firmware/assistant/src/canvas.cpp` | 帧缓冲 + 脏矩形 + UTF-8/中文渲染 |
| `firmware/assistant/src/net.cpp` | Wi-Fi / NTP / 天气 / 额度 |
| `firmware/assistant/scripts/make_cjk_font.py` | 中文字模生成器 |
| `firmware/bringup/README.md` | 硬件自检工程说明 |

### 看界面（本机服务器）
| 地址 | 用途 |
|---|---|
| `http://127.0.0.1:8770/docs/device-live.html` | **设备真实画面**，支持实时连拍 |
| `http://127.0.0.1:8770/docs/assistant-ui-prototype.html` | UI 原型 + SPI 带宽仿真 |
| `http://127.0.0.1:8770/docs/index.html` | 接线与硬件资料 |

启动方式：
```sh
cd firmware/bringup
QW_HOST=<和风host> QW_KEY=<和风key> \
  ../../.tools/pcb-lettering-venv/bin/python -u scripts/docs_server.py 8770
```
（必须用带 Pillow 的解释器，否则 `/api/device/frame` 会 503）

### 设计与硬件资料
| 路径 | 说明 |
|---|---|
| `pcb-design/native-rev-b/` | RevB 原理图/PCB/Gerber（较新）|
| `pcb-design/revb-lettering-2026-09-10/` | RevB 丝印中文字形 |
| `hardware-selection/bom-v7/` | 采购底表 V7 |
| `mechanical-design/` | Blender 结构件 |
| `design-coordination/` | 并行设计协调记录 |

---

## 10. 验证方式说明

本文所有"✅"都对应一种可复现的验证：

| 标记 | 含义 |
|---|---|
| 实机遥测 | 串口命令读出的真实数值（帧率、内存、RSSI、NTP）|
| 真实 API | 实际 HTTP 请求返回（和风天气、sub2api 额度）|
| 帧缓冲 dump | 从设备 PSRAM 抓出画面重建的 PNG |
| 单元测试 | 主机侧纯逻辑测试，可随时重跑 |
| 文件扫描 | 全仓库 grep 凭据字符串 |
