xaiojie/papabot/文件清理记录.md

# 工作目录清理记录

2026-09-08 按用户要求清理。共移出 48 个文件，约 71.13 MB。文件移入废纸篓，没有清空废纸篓。

## 已移出

- 初版概念图及提示词、V2–V5 过渡外观草稿。
- V7 未选的 B–F 配色及对应提示词、旧对比页。
- V8 三款蓝白探索方案。
- 旧 Blender 总装 ZIP；其中内容均已有副本，旧模型与保留的 `.blend1` 一致。
- 项目内四个 `.DS_Store` 目录缓存。

## 保留

- 当前 BOM V7 全部文件与电池询价记录，内容未改。
- BOM V1–V6、原始导出及选型证据：历史生成器存在串联引用，当前 V7 直接依赖 V6 的数据、Excel 和匹配记录，因此保留原路径。
- V6 当前造型比例、A 奶油薄荷原图、原始提示词与颜色参数。
- 用户编辑后的 `.blend`、其 `.blend1` 备份、八张渲染、模型脚本、规格图和验证报告。

对 157 个保留文件核对清理前后 SHA-256，全部一致。只调整了当前目录文档及已选配色索引，修正因清理失效的当前入口链接。历史快照内的旧路径是当时记录，不作当前入口。

## 恢复位置

`/Users/jay/.Trash/桌面助手清理-20260908-111622`

“移出文件”保留原项目相对路径；“修改前文档”保存调整前的六份索引文档；“清理清单.json”记录每个移出文件的路径、大小和校验值。需要恢复时，可按原相对路径移回。

当前进度：样机 BOM 已整理，概念外观、Blender 第一阶段总装和奶油薄荷配色已完成；定制电池供应、实物尺寸、结构配合、PCB 和固件仍待推进。
