xaiojie/papabot/docs/仓库结构.md

# papabot 仓库结构

2026-10-26 整理。根目录保留项目入口、进度和机器可读的选择记录，资料按固件、PCB、结构、选型、接口、文档归类。

| 目录 / 文件 | 入口 | 放什么 |
|---|---|---|
| `firmware/` | [固件导航](../firmware/README.md) | 两套固件、网页界面、中转服务和接线文档 |
| `pcb-design/` | [PCB 导航](../pcb-design/README.md) | 用户最新版、制造资料、工程与历史版本 |
| `mechanical-design/` | [结构导航](../mechanical-design/README.md) | CAD 脚本、STL、试配件、渲染及概念方案 |
| `hardware-selection/` | [选型与采购](../hardware-selection/README.md) | 型号、BOM、报价、采购和规格证据 |
| `design-coordination/` | [接口约定](../design-coordination/README.md) | PCB 与结构接口、EDA Bridge、基线记录 |
| `docs/history/` | [旧进度](history/PROGRESS-2026-09-12.md) | 分日进度、旧交接与清理记录 |
| `docs/images/` | [README 首图](images/a5-hero.jpg) | 项目说明使用的图片 |
| `docs/references/` | [第三方资料索引](references/README.md) | 规格书、厂商参考图、供应商说明与来源清单 |
| `scripts/` | [仓库检查器](../scripts/check_repository.py) | 仓库级维护工具 |
| `项目进度总览.md` | [当前进度](../项目进度总览.md) | 当前阶段、已验收与待验证事项 |
| `design-selection.json` | [选择记录](../design-selection.json) | 保留生成器依赖的根路径 |

## 文件放置约定

- 新固件功能与测试放入对应固件工程；虚拟环境、编译产物和 Node.js 依赖保留本地。
- 新结构外观草图放 `mechanical-design/concepts/`；结构版本的脚本、STL、渲染和报告放该版本目录内。
- 新采购资料放 `hardware-selection/procurement/<日期>/`；工作簿归到对应 BOM 版本，不再使用会话编号作为根目录。
- 旧进度与交接放 `docs/history/`，不与当前进度并列充当入口。
- 第三方资料也纳入 Git，沿用各模块资料目录，并在 `docs/references/` 汇总来源和查阅入口。
- `.local/` 放本机日志和临时检查资料；`.tools/`、`.workbuddy/`、`.playwright-cli/` 继续作为被忽略的本机环境。
- 其他项目放本仓库外。翻译云两个目录本次已移出，本地内容逐文件校验保留。
- 既有 PCB 与结构历史目录存在脚本依赖，保持模块内部相对位置。工程文件、制造包、STL、图像、BOM 原始表格未重新生成。

## 本次迁移对照

| 原路径 | 新路径 |
|---|---|
| `design-v6-compact-centered/` | `mechanical-design/concepts/design-v6-compact-centered/` |
| `design-v7-cmf-options/` | `mechanical-design/concepts/design-v7-cmf-options/` |
| `采购清单-20260912/` | `hardware-selection/procurement/2026-09-12/` |
| `outputs/01a07a09-ef1b-7760-a41d-14c5a4d8f9ec/` | `hardware-selection/bom-v1/exports/` |
| `project-status-history/` | `docs/history/project-status/` |
| `PROGRESS.md` | `docs/history/PROGRESS-2026-09-12.md` |
| `文件清理记录.md` | `docs/history/文件清理记录-2026-09-08.md` |
| `docs/交接说明-2026-09-12.md` | `docs/history/交接说明-2026-09-12.md` |

旧核验 JSON 内的绝对路径反映当时的工作位置，按原证据保留；当前导航、相关生成器和活动引用已同步到新位置。

## 仓库检查

```sh
python3 scripts/check_repository.py
python3 firmware/bringup/scripts/test_host.py
python3 firmware/assistant/scripts/test_host.py
```

仓库检查覆盖被跟踪的缓存、无关项目、本机绝对符号链接，以及根 README 和本页链接的模块导航。历史快照可能引用已被替代的文件，不作为当前运行入口。
