xaiojie/papabot/pcb-design/integrated-v1/摆放框图.html

# 单板全集成 v1 · 摆放框图

板框 110 × 75 mm，2 层 / 2oz 铜。按真实尺寸摆放（自动装箱，最终会按信号流向重排）。

⚠️ 这个图推翻了一个已定决策
如果 PCA9685 用现成模块（62.5×25.5mm，占 1594mm²），110mm 宽也要 83mm 高， 100×75 根本装不下（需 96.3mm）。
换成 裸芯片 TSSOP-28 + 板上 8 路舵机座（合计约 400mm²）后，110×75 就够了。

✅ 板框定稿建议：110 × 75 mm
填充率 65.6%（舒适区）。比 100×75 宽 10mm，但外壳内腔约 124×96.8mm，放得下。

## 尺寸档位说明

档位 | 含义 | 本轮有几项
🟢 实测 | 我自己量的，含 2.54 针距自校验 | ESP32 开发板、插座
🔵 核实 | 厂家官网 / 数据手册 | 屏幕、麦克风、功放、EC11、喇叭、电池
⚪ 估 | 按经验估算，需实物确认 | 大部分电源和连接器
🔴 待核 | 查不到，必须问商家或实测 | —（本轮已全部消除）

## 最终摆放要按信号流向重排

上图是算法装箱的结果（保证不重叠、证明装得下），但区域是散的。正式布局要按这些原则重排：

1. 电池 → 保险丝 → 开关 → 两路降压 单向排列，走线短
2. DFR0753 靠近 8 路舵机座，5V 铺铜路径最短
3. 逻辑降压靠近开发板，逻辑 5V 走线短
4. ESP32 靠近 PCA9685 / 麦克风 / 功放 / 屏幕连接器（I2C、I2S、SPI 都要短）
5. 大电流区与信号区物理分开 —— 舵机噪声不窜进 I2S/SPI
6. EC11 位置由前面板决定，需要和结构件对齐

## 关键约束

项 | 要求
铜厚 | 2oz
5V 舵机铺铜 | ≥4mm 宽（8A / 10°C 温升）
层叠 | 顶层：信号 + 5V 铺铜 ｜ 底层：整片 GND 铺铜（RevA 的教训）
DFR0753 散热 | 背面散热焊盘必须铺铜 + 打散热过孔到底层
电池输入 | 接线端子 / XT30，不用 2.54 排针过总电流
去耦 | DFR0753 输出 1000µF，逻辑 5V 470µF，都紧贴负载
