xaiojie/papabot/mechanical-design/concept-rounded-body-20260915/生成说明.md

# 概念效果图生成说明

工具：内置 imagegen，未使用 CLI/API 回退。图像生成于 2026-09-14，2026-09-15 整理到项目。

参考源：`../structure-a5/renders/` 中的 `A5-perspective.png`、`A5-front.png`、`A5-rear.png`、`A5-top.png`。

主提示要求：保持 A5 机身比例、屏幕占比、四腿、猫耳、象牙白与薄荷绿配色；前后盖改为完整凸圆角矩形，取消下部凹口；腿向腹部收拢；保留后盖 USB-C 入口、通风、喇叭与凹仓内总开关。布局为左侧主透视图、右侧正面和背面图，标明概念图与结构待验证。

第一轮仍保留内凹，第二轮修正主透视及主要凹口，最后一轮修正正、背面小图剩余的内凹轮廓。项目仅保存最终选定版本。

最终原始文件：`/Users/jay/.codex/generated_images/01a07caa-b282-7763-bb22-488623b16e27/exec-6895cbba-4e87-461e-8e37-1b20ff80349c.png`

## 最终修正提示词原文

```text
Precise final correction to the attached concept sheet: leave the large left perspective robot COMPLETELY UNCHANGED. Leave all labels, background and proportions unchanged. Fix ONLY the small upper-right FRONT view and small lower-right REAR view outer panel silhouette.

They still have a small concave waist on each lower side near the knee motors. Remove these remaining inward steps. Extend white panel material to make a pure convex rounded rectangle on BOTH small views. Four positive/convex corners, absolutely no negative/concave bend in the boundary.

In the 1536x1024 reference image:
FRONT small view: outer left panel side stays at roughly x1048 all the way down from y160 to y350, then convex corner rounds to horizontal bottom at y378. Outer right panel side stays at roughly x1438 all the way down to y350, then rounds inward to horizontal bottom at y378. There must be NO early inward curve at y300–330. White panel fills those old concave areas, OCCLUDING the upper knee box that used to occupy them. Keep ordinary consistent convex corner radii around 20-28 image pixels.
REAR small view: outer left side remains at roughly x1048 from y585 to y774, then convex corner joins bottom y801. Right side stays at roughly x1438 to y774, then convex corner joins bottom y801. NO change of direction/concave step at y726–756. Fill these small missing areas with white panel; let servo motor behind be naturally occluded. The front and rear resulting white panel shapes must be geometrically identical rounded rectangles.

Do not redesign feet, screen, ports, ears, text or the large hero. The feet and limbs remain visible outside/below the panels as before. This is not asking to round off the inner notches: the inner notches must cease to exist. Only the four convex corners of a rounded rectangle may change the boundary direction. No inward waist. Keep final text "概念效果图｜结构待验证".
```
