xaiojie/papabot/mechanical-design/structure-a5/重建说明.md

# A5 重建说明

脚本从A3耳朵轮廓、A4建模方法和用户PCB坐标/纹理建立A5。所有构建尺寸以毫米表达，最终Blender对象使用米坐标。原A4、A3、PCB及BOM为读取来源。

在项目根目录执行。先将任何手工修改的A5另存为其他文件名，因为build_a5.py会重建本目录的生成版。

1. Blender后台运行 `scripts/build_a5.py`，检查 `/tmp` 或终端输出中的 `A5_BUILT 31`。
2. Blender后台运行 `scripts/check_a5.py`；再分别加 `-- --motion`、`-- --service` 检查姿态和拆卸。先检查reports中的通过标志，失败时停止导出。
3. Blender后台运行 `scripts/export_and_views.py`。输出31个独立STL、5个试配件及6个展示场景。
4. 用Python运行 `scripts/verify_stl.py complete-manifest.json stl-verification.json` 和 `scripts/verify_stl.py coupon-manifest.json coupon-verification.json`。
5. Blender后台运行 `scripts/final_audit.py` 核对USB、屏幕、尺寸、纹理及原文件哈希。
6. Blender后台运行 `scripts/render_a5.py -- perspective front rear top internal lower-deck exploded front-open parts`，逐张查看实际渲染。
7. 完成视觉检查后运行 `python3 scripts/package_a5.py`。脚本检查报告、图像时间及哈希，输出ZIP并复核CRC及每个成员的哈希。

以上 `scripts/` 均为本目录下的脚本。Blender调用形式为：

```sh
/Applications/Blender.app/Contents/MacOS/Blender --background --disable-autoexec --python mechanical-design/structure-a5/scripts/build_a5.py
```

材质必须显式使用 `ActualGerberUV`，以免默认UVMap遮盖用户Gerber丝印。相机/灯光保留用于渲染，主视口关闭Extras和Relationship Lines，摄影棚对象在主视口中隐藏。
