xaiojie/papabot/mechanical-design/concepts/design-v7-cmf-options/design-notes.md

# 已选配色：A 奶油薄荷

用户已确认奶油白机身与前盖、薄荷绿腿与耳框及细边，采用低光泽磨砂方向。V6 为当前造型比例基准，小耳饰、居中显示屏、四足、暂不加刻字和 Logo。

- [配色原图](a-cream-mint.png)
- [原始生成提示词](prompts/a-cream-mint.txt)
- [当前设计选择记录](../../../design-selection.json)
- [Blender 总装与渲染](../../assembly-v1/README.md)

| 部位 | 颜色目标 |
|---|---|
| 机身 | #EEEADF |
| 前盖 | #F4F0E8 |
| 腿、耳框及细边 | #9FB9A9 |

原图以哑光 PLA 的细微层纹表现磨砂观感；最终基材、供应商色号和后处理仍以实物样片确认。颜色代码是设计目标，图片是外观示意，不能据图量取加工尺寸。

2026-09-08 按用户要求清理：其余五款配色、对应提示词和旧对比页已移入废纸篓；当前图像及提示词未改。恢复位置见[文件清理记录](../../../docs/history/文件清理记录-2026-09-08.md)。
