xaiojie/papabot/firmware/网页控制台-规划.md

# 网页控制台 · 规划方案

2026-09-11。**一个网页能实现哪些功能，怎么做，有哪些坑。**

---

## 〇、先说结论：三条路，推荐第三条

| 方案 | 全平台 | 需要 HTTPS | 带宽 | 复杂度 | 评价 |
|---|---|---|---|---|---|
| **A. 纯 BLE 网页**（Web Bluetooth）| ❌ **iOS 不支持** | ✅ 需要 | 低（~25KB/s）| 中 | ⚠️ 只适合安卓 |
| **B. 纯 WiFi 网页**（ESP32 自建服务器）| ✅ | ❌ 不需要 | **高** | **低** | ✅ |
| **C. WiFi 为主 + BLE 为辅**（推荐）| ✅ | 部分 | 高 | 中 | ✅ **最佳** |

### 🎯 核心判断

**ESP32 自己当 Web Server 是更优解**，理由：

```
✅ iOS / 安卓 / 电脑 全平台通用
✅ 局域网内 http://192.168.x.x —— 不需要 HTTPS 证书
✅ 带宽够（WiFi 实测能跑 17.8fps 画面预览，BLE 只有 3fps）
✅ 不依赖外网
✅ 网页资源可以放 PSRAM（我们有 8MB）
```

**BLE 的价值只剩一个**：不想切 WiFi 时配网。但代价是「iOS 用不了 + 必须 HTTPS 托管」—— **不划算**。

**→ 配网改用 AP 模式（设备自己当热点），全平台通用，不需要 HTTPS。**

---

## 一、功能总清单

### 1. 配网与连接

| 功能 | 通道 | 说明 |
|---|---|---|
| 首次配网（AP 模式）| WiFi | 设备开热点 `爬爬-配网` → 手机连 → 打开 `192.168.4.1` |
| 扫描附近 WiFi | WiFi | ESP32 扫描，网页显示列表 + 信号强度 |
| 输入密码连接 | WiFi | 支持显示/隐藏密码、连接中动画 |
| 连接结果反馈 | WiFi | 成功→跳到新 IP；失败→显示错误码 |
| 多组 WiFi 记忆 | WiFi | 存 3-5 组，自动连信号最强的 |
| 当前网络状态 | WiFi | SSID / IP / RSSI / 网关 / DNS |
| 手动改设备名/mDNS | WiFi | 支持 `爬爬.local` 访问，不用记 IP |
| 一键切换网络 | WiFi | 不用重新配网 |

### 2. 屏幕控制（核心功能）

| 功能 | 通道 | 说明 |
|---|---|---|
| **画面实时预览** | WebSocket | **★ 核心** —— 复用现有 RLE 协议，实测 17.8fps |
| 切换 8 个屏 | HTTP/WS | 表情 / 数字钟 / 表盘 / 天气 / 额度 / 状态 / GIF×2 |
| 上/下一屏 | WS | 对应旋钮动作 |
| 显示自定义文字 | WS | 便签、跑马灯、单行提示 |
| 改表情情绪 | WS | 5 种情绪（对应按键）|
| 改昵称 | WS | 「爬爬」|
| 背光亮度 | WS | 0-100% |
| 屏幕方向/反转 | WS | rotate / invert |
| **一键截图** | WS | 从预览流抓帧存 PNG |
| **批量导出八屏对比图** | WS | 回归测试用（PROGRESS.md 里的待办）|

### 3. 舵机控制（8 路 PCA9685）

| 功能 | 说明 |
|---|---|
| **8 路滑块实时控制** | 每路 0-180°，拖动即动 |
| 预设姿态 | 站起 / 坐下 / 挥手 / 点头 / 摇头 / 打招呼 |
| **动作序列编辑器** | 关键帧 + 时间轴，可存/读/循环播放 |
| 参数设置 | 每路限速、限幅、死区、微调 |
| 一键回中 | 所有舵机到 90° |
| **急停** | 立即停 PWM 输出（安全）|
| PWM 读数 | 显示每路当前脉宽（µs）|

### 4. 系统与调试

| 功能 | 说明 |
|---|---|
| 状态面板 | 信号 / IP / 运行时间 / 堆 / PSRAM / 芯片温度 |
| **实时日志** | WebSocket 推串口日志到网页 |
| **命令终端** | 复用现有命令分发器，网页里直接敲命令 |
| 重启 / 恢复出厂 | |
| **OTA 固件升级** | 网页上传 .bin 直接升级（WiFi 模式）|
| 分区/版本信息 | |

### 5. 设置

| 功能 | 说明 |
|---|---|
| 和风天气 | Key + LocationID（岳麓区 `101250109`）|
| 账号额度 | sub2api Host + admin Key + 账号 ID |
| 时区 / NTP | |
| 昵称 / 亮度 / 屏幕方向 | |
| **⚠️ 凭据写入策略** | 选「落盘 NVS」还是「仅 RAM」|

### 6. 数据展示

| 功能 | 说明 |
|---|---|
| 天气卡片 | 实时温度/天气/高低温/观测时间 |
| 额度卡片 | 窗口用量 + 限流状态 + 重置券 |
| 历史曲线（可选）| 内存/信号/温度趋势 |

---

## 二、技术架构

### 设备端（ESP32-S3）

```
┌─────────────────────────────────────────────┐
│  启动                                        │
│    ↓                                         │
│  有线凭据吗？──否──→ AP 模式                 │
│    │                  SSID: 爬爬-配网         │
│   是                  网页: 192.168.4.1      │
│    ↓                  ↓                      │
│  连 WiFi ←────── 用户配网 ────┘              │
│    ↓                                         │
│  STA 模式 + mDNS (爬爬.local)                │
│    ↓                                         │
│  Web Server                                  │
│    ├─ HTTP  静态页面（gzip，放 flash/PSRAM） │
│    ├─ HTTP  REST API（/api/status 等）       │
│    ├─ WS    命令通道（复用命令分发器）        │
│    ├─ WS    画面流（RLE 帧）                  │
│    └─ HTTP  OTA 上传                          │
└─────────────────────────────────────────────┘
```

### 复用现有资产（重要）

**你已经有的、可以直接复用的：**

| 现有资产 | 复用方式 |
|---|---|
| **串口命令分发器**（`next`/`prev`/`mood`/`pulse`/`set nick`…）| **WS 收到的字符串直接喂给它** —— 几乎零改动 |
| **RLE 帧编码**（实测 6.8KB/帧、17.8fps）| 把串口的输出改道到 WebSocket |
| **`docs_server.py` 的实时取景服务** | 逻辑已经在，改成设备端自建 |
| **`canvas.cpp` 帧缓冲 + 脏矩形** | 直接复用，预览就是读帧缓冲 |
| **`Preferences`(NVS) 持久化** | 网页设置写 NVS |

**→ 这个架构的最大好处：固件改动很小，主要是「加一个 Web Server + 把串口输出改道到 WS」。**

### 前端

```
单页应用（SPA），纯静态
  ├─ index.html
  ├─ app.js        （原生 JS 或轻框架）
  ├─ style.css
  └─ 打包后 gzip，预计 30-60 KB

通信：
  ├─ REST   /api/status, /api/settings, /api/wifi/scan
  ├─ WS     /ws/cmd    命令通道（文本）
  └─ WS     /ws/frame  画面流（二进制）
```

**前端体积要控制**：ESP32 的 flash 有 42% 余量，但网页 + 字库 + 固件加起来要算总账。
**建议 50KB 以内**，必要时放 PSRAM 或 SPIFFS/LittleFS 分区。

---

## 三、要不要保留 BLE？

**建议：保留 BLE，但定位降到「安卓用户的便捷配网」**

| 场景 | 用哪个 |
|---|---|
| **配网（主）** | AP 模式 —— 全平台 |
| 配网（备选）| BLE —— 仅安卓，且需要 HTTPS 托管的页面 |
| 日常控制 | **WiFi 网页**（唯一选择，因为带宽）|
| 低功耗远程 | BLE —— 但我们是插电设备，不需要 |

**→ 如果嫌麻烦，BLE 可以整个不做。** 省下约 50KB flash + 40KB RAM。

---

## 四、分阶段实施

### 第 1 阶段：最小可用（估计 1-2 天）

```
✅ ESP32 自建 Web Server
✅ AP 配网页（扫描 + 输入密码 + 连接）
✅ 状态页（信号/IP/内存）
✅ 命令终端（WS → 现有命令分发器）
```

**产出**：手机浏览器能配网 + 敲命令

### 第 2 阶段：核心功能（2-3 天）

```
✅ 画面实时预览（WS 推 RLE 帧）
✅ 8 屏切换按钮
✅ 表情 / 昵称 / 亮度控制
✅ 截图 + 八屏对比图导出
```

**产出**：这就是「远程看到屏幕 + 操作它」

### 第 3 阶段：舵机（2-3 天）

```
✅ 8 路滑块
✅ 预设姿态
✅ 急停
✅ 动作序列编辑器
```

**产出**：完整的动作控制台

### 第 4 阶段：完善（2-3 天）

```
✅ OTA 升级
✅ 实时日志
✅ 设置持久化
✅ 页面美化 / 移动端适配
```

---

## 五、技术约束与坑

### 🔴 必须知道的

| # | 约束 | 影响 |
|---|---|---|
| 1 | **Web Bluetooth 不支持 iOS** | 想用 BLE 就必须放弃 iPhone 用户 |
| 2 | **Web Bluetooth 必须 HTTPS** | 页面不能放设备上（设备只有 http）|
| 3 | **HTTPS 页面不能请求 http:// 设备**（Mixed Content）| 所以「HTTPS 页面 + HTTP 设备」这条路是死的 |
| 4 | **BLE 实吞吐 ~25KB/s** | 画面预览只能 3fps，**必须走 WiFi** |

### 🟡 要注意的

| # | 事项 | 说明 |
|---|---|---|
| 5 | **AP 配网时手机可能提示"无互联网"** | 正常，继续用即可（iOS 可能要手动关「无线局域网助理」）|
| 6 | **WiFi + BLE 共存有性能折损** | 若两个都开，画面帧率会降 |
| 7 | **`ARDUINO_LOOP_STACK_SIZE=16384`** | 已为 TLS 提过栈，Web Server 也可能吃栈 |
| 8 | **网页资源体积** | 建议 ≤50KB，否则要挤 flash |
| 9 | **凭据安全** | sub2api admin Key 权限很高，网页写入要提示风险 |
| 10 | **OTA 掉电变砖** | 建议双分区 OTA（`default_8MB.csv` 要确认够）|

### 🟢 可以放心的

- ESP32-S3 跑 Web Server + WS 很轻松（RAM 才用 22.3%）
- 画面预览带宽：WiFi 局域网 >1MB/s，17.8fps 的 6.8KB 帧只占 120KB/s，**余量很大**
- 8MB PSRAM 基本空闲，网页可以放进去

---

## 六、一句话总结

> **做一个「ESP32 自己托管的网页」——手机连上设备就能：配网、看屏幕实时画面、切屏、控舵机、改设置、升级固件。**
>
> **不需要 BLE，不需要 HTTPS，iOS 安卓都能用。**

**如果一定要 BLE**（比如你主要用安卓、且不想切 WiFi），那就在这个基础上**再加一个独立的 HTTPS 配网页**，其余功能仍走 WiFi 网页。

---

## 七、下一步

| 选项 | 内容 |
|---|---|
| **A** | 我先写**最小可用版**（AP 配网 + 状态 + 命令终端），你烧进去试 |
| **B** | 先写**画面预览**（最直观、最能验证架构）|
| **C** | 先出**页面原型**（HTML，在电脑上看效果，不碰固件）|
| **D** | 先确认几个决策：要不要 BLE / 凭据落不落盘 / OTA 分区分多大 |

**我建议 C → B → A**：先看原型确认样子，再做画面预览打通链路，最后补配网。
