xaiojie/papabot/hardware-selection/battery-stock-2026-09-09/evidence/YourCee-67325-2S-protection.pdf

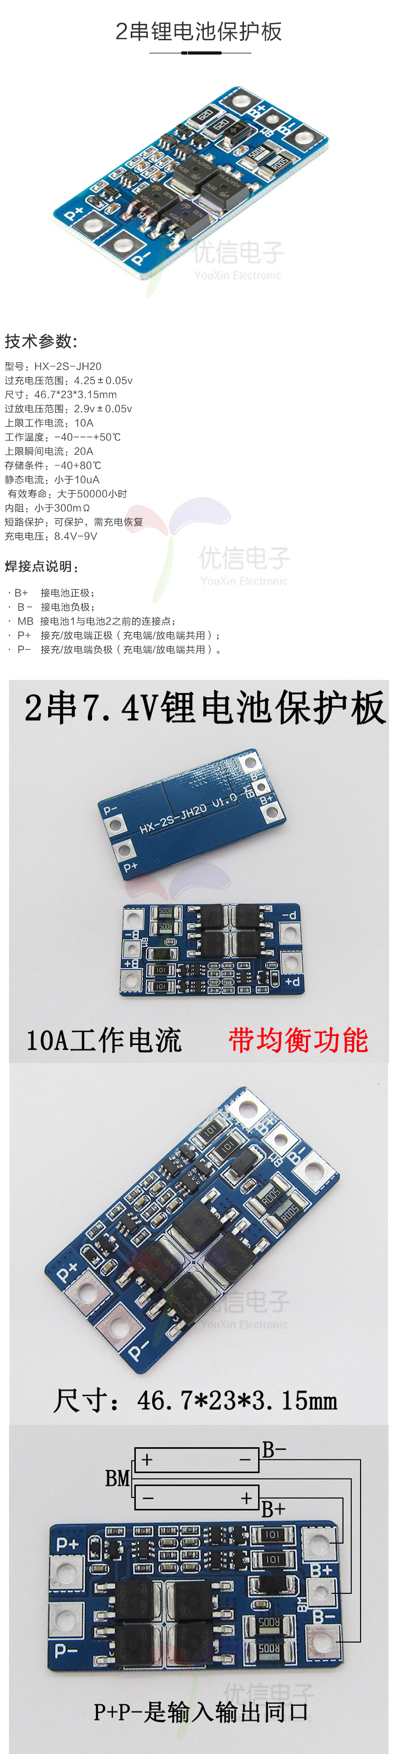
[picture p21: page 1]
