xaiojie/papabot/pcb-design/native-rev-a/preflight-2026-09-08/下单复核结论.md

# RevA PCB 下单复核 — 2026-09-08

**结论：暂缓下单。** 板框、钻孔、原生 DRC 和网络连接检查均通过；当前尚不能确认载板与 A3 保留原板旋钮/按键方案的电气兼容性。本结论是基于实际接口设计与证据缺口的工程判断，不代表已发现屏幕必然输出 5V。

## 本轮重新检查的结果

| 检查 | 结果 | 证据 |
|---|---|---|
| 嘉立创EDA当前项目/PCB | `DesktopAssistant_RevA` / `641e84beea5fc9c6` | `live-pcb-drc.json` |
| PCB 严格 DRC | 通过，API `passed: true` | `live-pcb-drc.json` |
| 当前原理图严格 DRC | 通过，API `passed: true`；本次没有重新读取界面错误计数 | `live-schematic-drc.json` |
| 工程几何 | 738条铜线、1条闭合板框、102个焊盘（含4个安装孔）、24个过孔，与修复板框后的记录一致 | `live-geometry-comparison.json` |
| 设计规则 | 在 API 单位换算的 0.000001mm 容差内一致 | `rule-comparison.json` |
| 独立连续几何检查 | 25/25网络连通，无孤立铜，无检查范围内的几何违规 | `native-routing-validation.json` |
| 最小异网铜间距 / 铜到板边 | 8.009mil / 13.016mil | `native-routing-validation.json` |
| 实际 Gerber 板框 | 80×32mm闭合板框及24.17×13mm侧开口与定义一致 | `archive-preflight.json` |
| 实际钻孔 | 122个金属化孔（98元件孔+24过孔），4个Ø3.2非金属化孔；逐孔与保存工程匹配 | `archive-preflight.json` |
| 导出网表 | 98个元件焊盘逐一匹配接口定义 | `archive-preflight.json` |

Gerber 中单独的 `Drill_PTH_Through_Via.DRL` 是 `Drill_PTH_Through.DRL` 的24孔子集，不能重复加工。本次没有重新导出或修改 Gerber、原生工程、铜线、焊盘或设计规则。

## 影响下单的未确认项

1. **屏幕原板控件与 J7 的电压兼容性。** 当前 J3.2 接 `+5V_LOGIC`；J7 的 A/B/按压/独立按键直接连接 ESP32-S3 GPIO，并各有10kΩ电阻上拉至3.3V。原设计按拆焊后的无源触点处理。A3已改为旋钮和按键留在原屏幕板上，使用模块引出的 A、B、PUSH、K0 时，必须确认其公共端、板载上拉以及在5V供电时的实际信号电压。商家图只说明VCC为3.3–5V和各信号功能，没有提供这些内部连接。模块能用5V供电，不能据此证明所有信号与3.3V GPIO兼容。
2. **主控插座的实物匹配。** 两排20P、2.54mm针距、17.78mm排距和1脚方向按现有厂家资料设计；实际到货型号、排针/插座高度及主控底部让位尚未试插。A3中的孔位和空间是标称模型配合。

保留原板旋钮并不必然需要重新布线；若模块内部确实是兼容的3.3V信号或合适的无源触点，可能只需修正接线说明。若有5V上拉或其他不兼容电路，则需先修改接口设计并重新复核、导出。当前不选择未经验证的电平转换方案，也不把屏幕改接3.3V当作已经验证的解决办法。

## 下一步

先向商家取得所选屏幕准确版本的原理图；或屏幕到货后，在未连接ESP32的条件下核对公共端、上拉及A/B/PUSH/K0电压，并核对SPI的3.3V逻辑兼容性。断电通断检查与上电电压测量分开进行。同步核对主控与插座尺寸/方向。

可以发给屏幕商家的文字：

> 这款屏幕接5V供电时，A、B、PUSH、K0这四个脚能直接接ESP32的3.3V IO吗？它们有没有接到5V的上拉电阻？SPI信号能直接用3.3V吗？麻烦发一下这块模块的原理图。

以上接口核对不需要先打印整机。待这些事项确认并处理后，再决定是否释放当前布线作为首批功能样板；整机负载、线束、打印公差和步态继续留在样机验证阶段。

## 已知上电边界

载板只承载逻辑供电和信号；8个舵机及功放功率支路仍走板外配线。主控USB VBUS与5V排针直连，现版没有自动防倒灌切换，首次烧录拔下主控单独接USB。完整步骤以更新后的 `../装配与上电核对.md` 为准。

机械现行版本为A3，屏幕竖直朝前，控件留原板、藏在可拆前盖内。旧原生工程中的 `REAR_DRY_CONTACTS` 名称和拆焊备注保留了实际设计来源，不作为现行机械装配指令。旧检查包与说明已备份，新检查包仍为待确认版本。

## 本次核对的文件标识

- 原生工程：`DesktopAssistant_RevA_PCB_review.epro2`
  SHA-256：`d1cd0c346180e4c6d4f6c5db1d1d6702007795b03cb1cb408ce0701482a7b223`
- Gerber：`DesktopAssistant_RevA_Gerber_review.zip`
  SHA-256：`5bb6b24ac4f5287ba9d7496af1de8c203dfab9e1f86b854cde08af113cc6e084`

这两个文件保持原样，未下单。
