xaiojie/papabot/design-v6-compact-centered/desktop-pet-compact-centered-v6.png

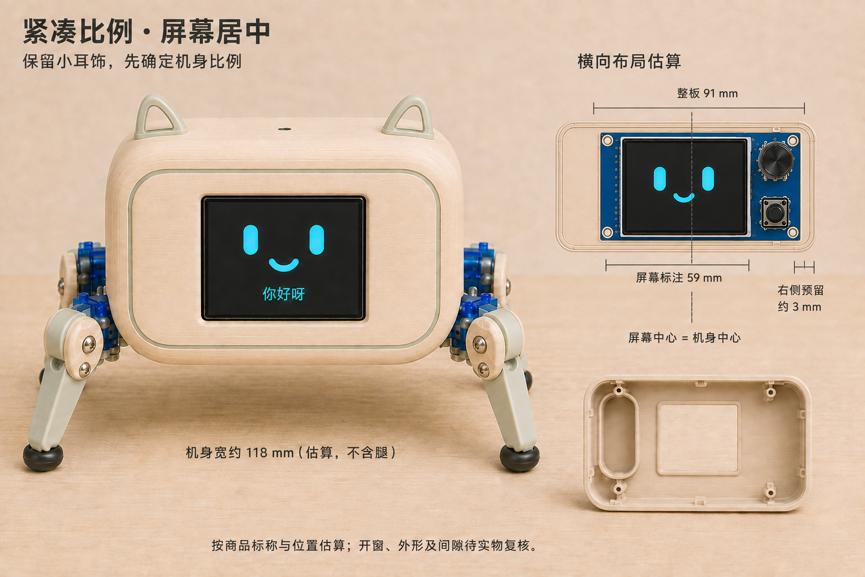
design-v6-compact-centered/desktop-pet-compact-centered-v6.png
