xaiojie/papabot/firmware/assistant/data/anim.preview.png

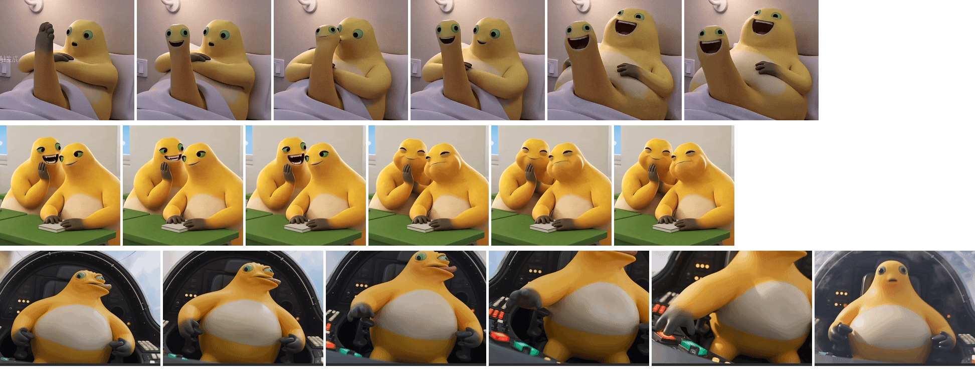
firmware/assistant/data/anim.preview.png
