xaiojie/papabot/firmware/assistant/data/preview-cjk24.png

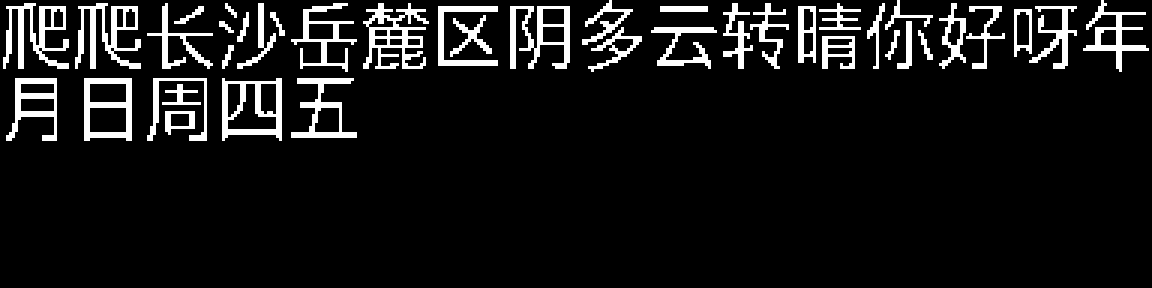
firmware/assistant/data/preview-cjk24.png
