xaiojie/papabot/firmware/assistant/docs/_captures/after-weather-3x.png

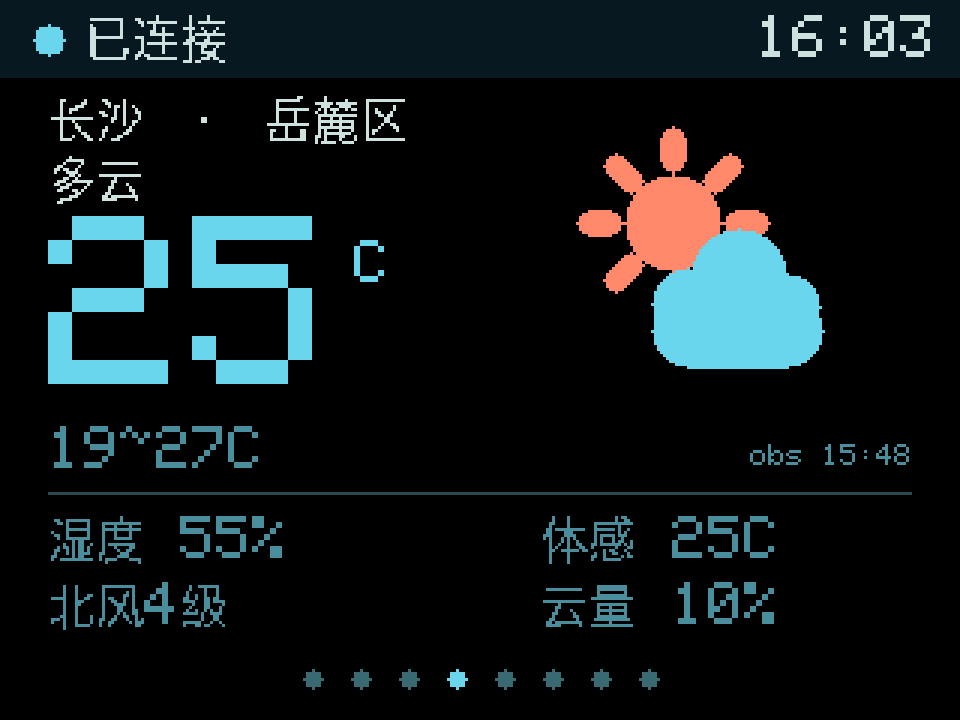
firmware/assistant/docs/_captures/after-weather-3x.png
