xaiojie/papabot/firmware/assistant/docs/_captures/after-weather-nonete-3x.png

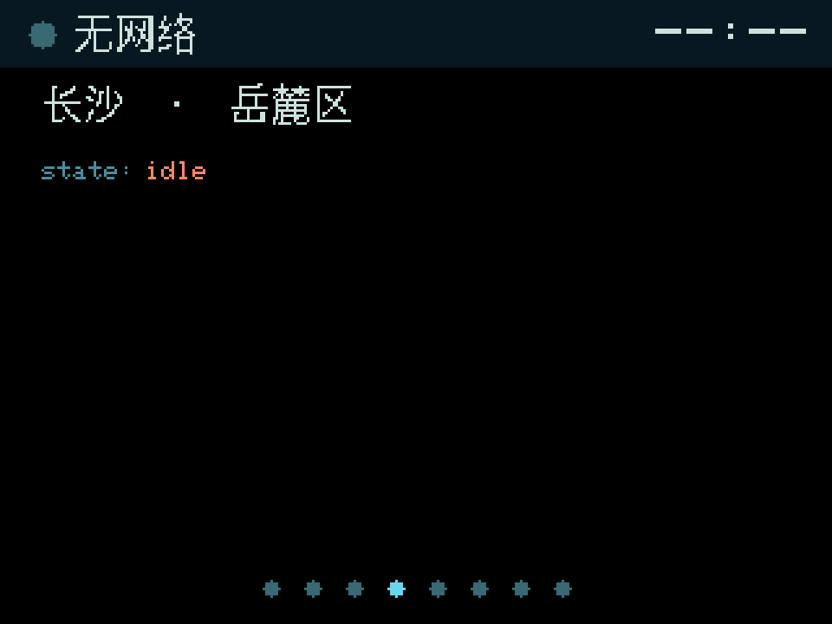
firmware/assistant/docs/_captures/after-weather-nonete-3x.png
