xaiojie/papabot/firmware/assistant/docs/_captures/before-weather-3x.png

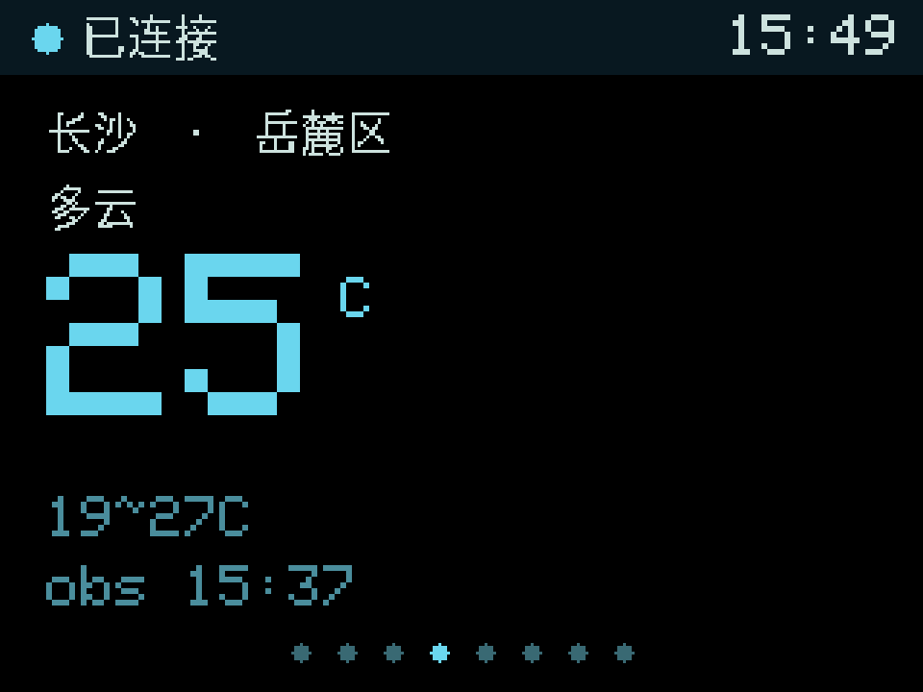
firmware/assistant/docs/_captures/before-weather-3x.png
