xaiojie/papabot/firmware/assistant/docs/device-anim.png

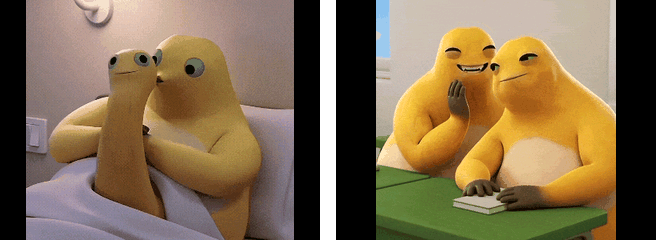
firmware/assistant/docs/device-anim.png
