xaiojie/papabot/firmware/assistant/docs/device-sys.png

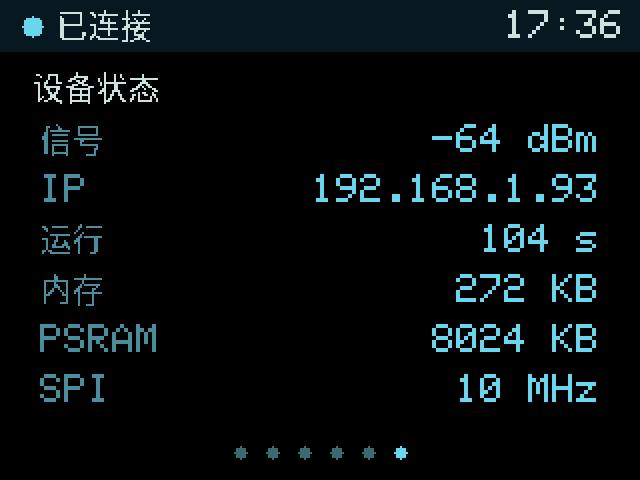
firmware/assistant/docs/device-sys.png
