xaiojie/papabot/hardware-selection/battery-stock-2026-09-09/evidence/ace800-product.webp

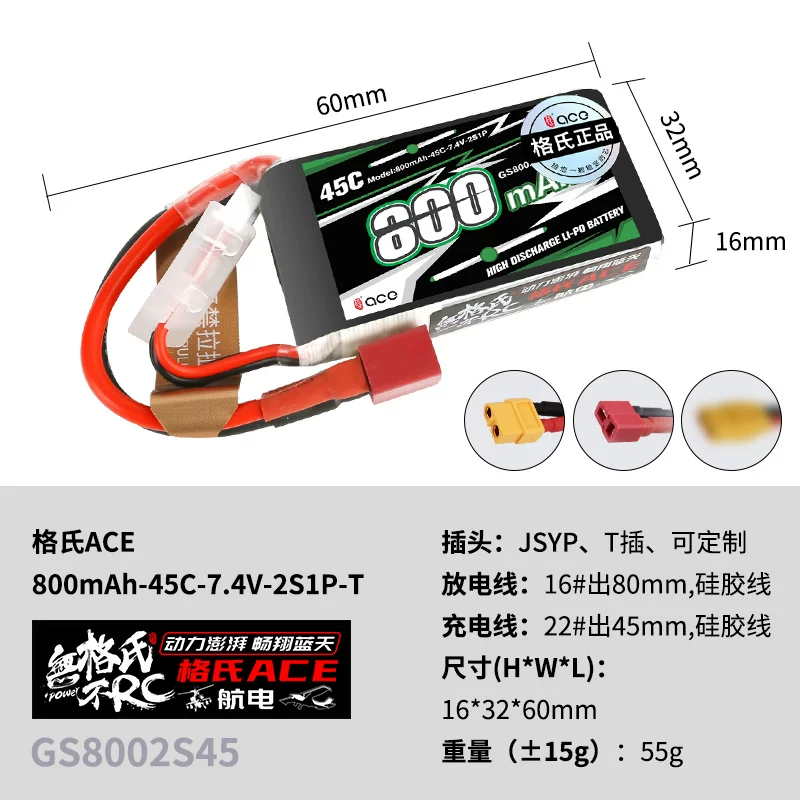
hardware-selection/battery-stock-2026-09-09/evidence/ace800-product.webp
