xaiojie/papabot/hardware-selection/battery-stock-2026-09-09/evidence/ace800-selected.png

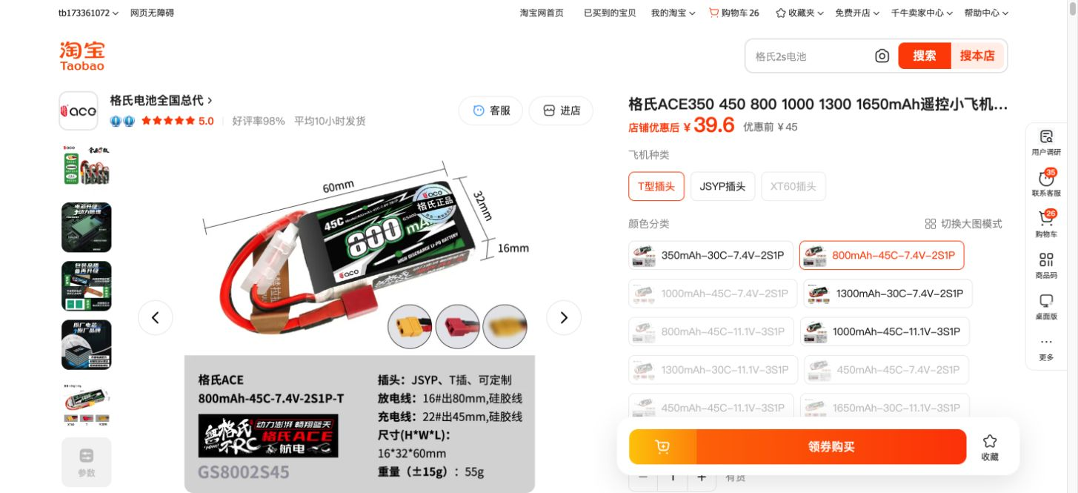
hardware-selection/battery-stock-2026-09-09/evidence/ace800-selected.png
