xaiojie/papabot/hardware-selection/battery-stock-2026-09-09/evidence/ace-details-2.jpg

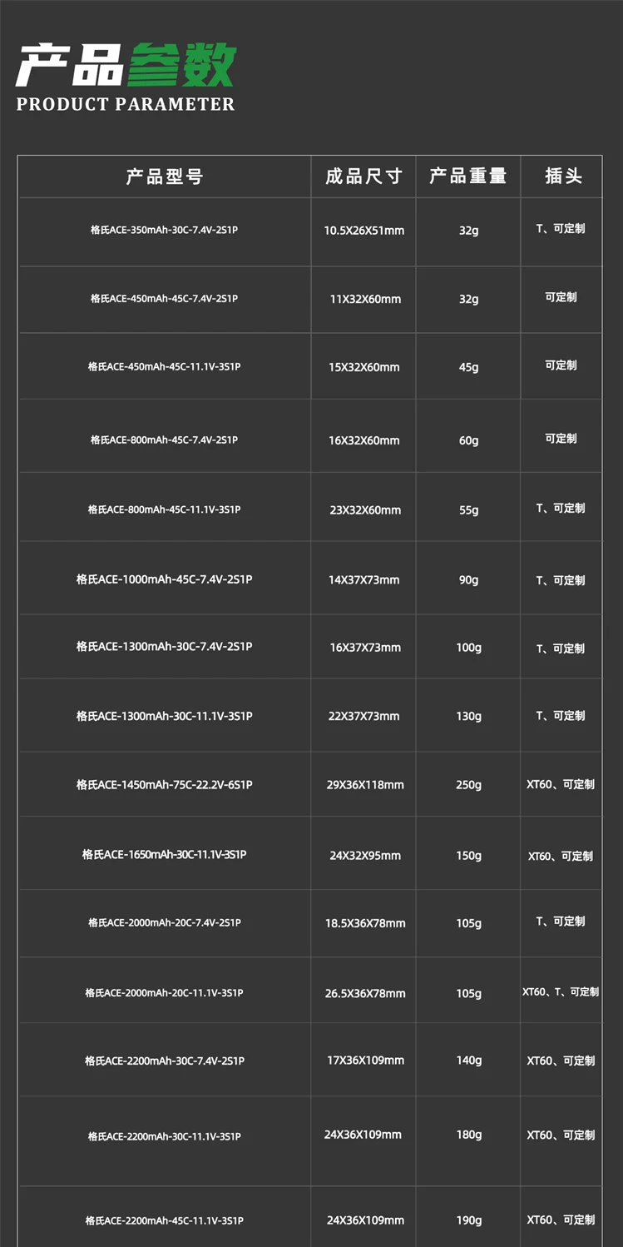
hardware-selection/battery-stock-2026-09-09/evidence/ace-details-2.jpg
