xaiojie/papabot/hardware-selection/battery-stock-2026-09-09/evidence/ace-details-7.jpg

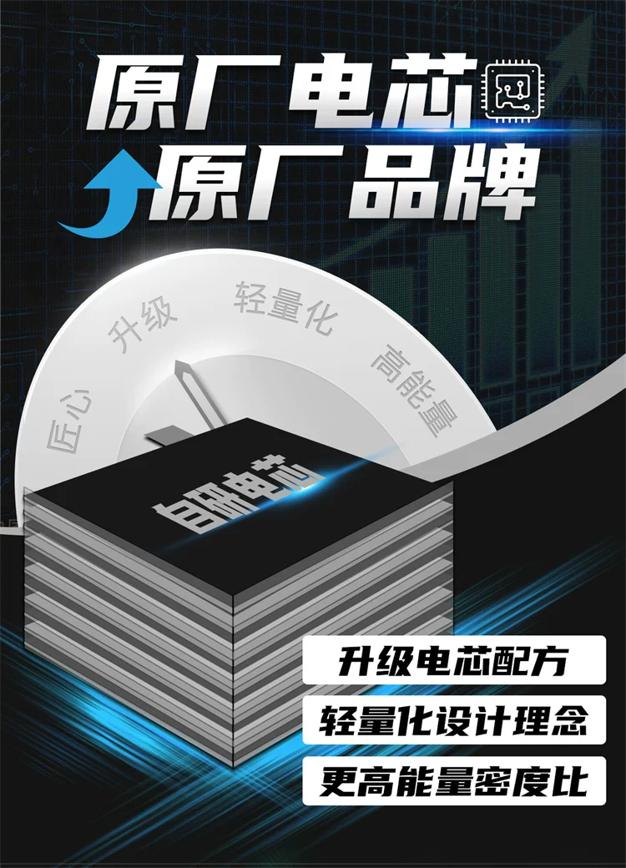
hardware-selection/battery-stock-2026-09-09/evidence/ace-details-7.jpg
