xaiojie/papabot/hardware-selection/reference/battery-802540-unprotected-selected.png

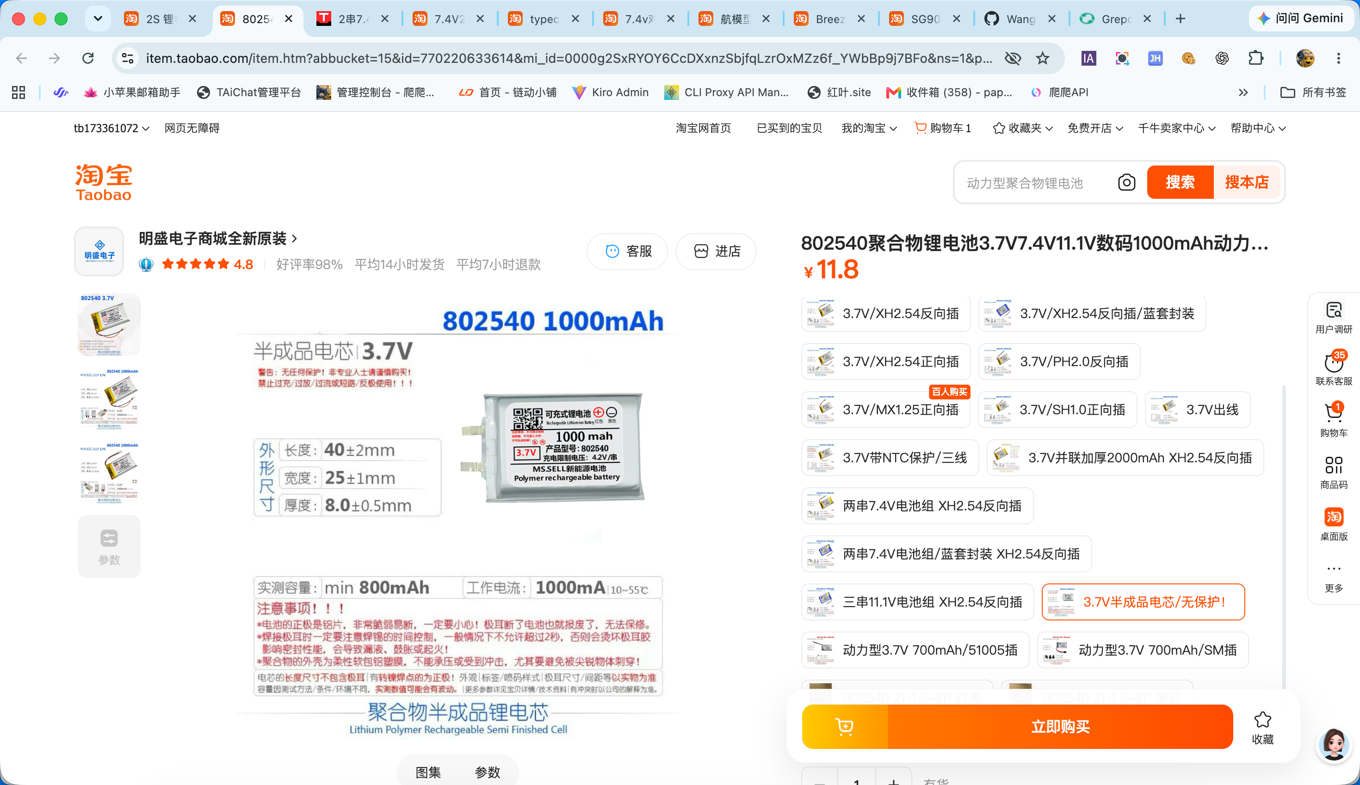
hardware-selection/reference/battery-802540-unprotected-selected.png
