xaiojie/papabot/hardware-selection/reference/battery-breeze-3s-selected.png

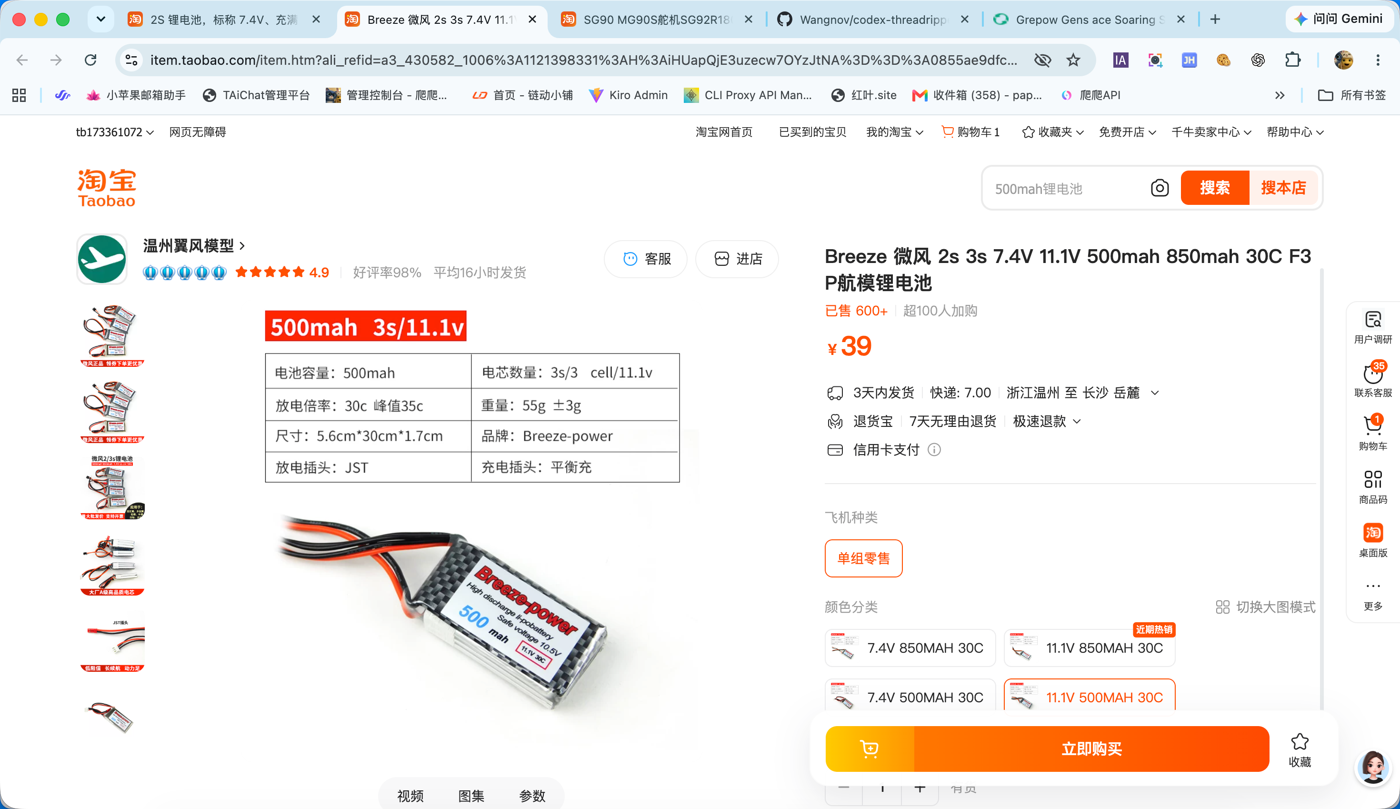
hardware-selection/reference/battery-breeze-3s-selected.png
