xaiojie/papabot/hardware-selection/reference/battery-custom-inquiry-7p4.png

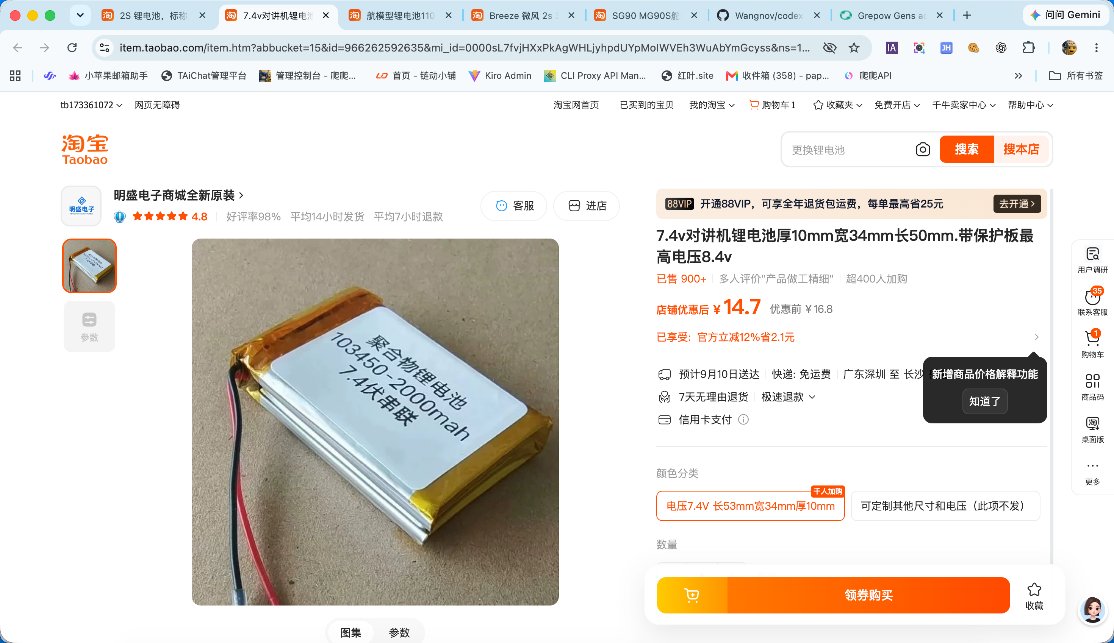
hardware-selection/reference/battery-custom-inquiry-7p4.png
