xaiojie/papabot/hardware-selection/reference/battery-flapping-40mah.png

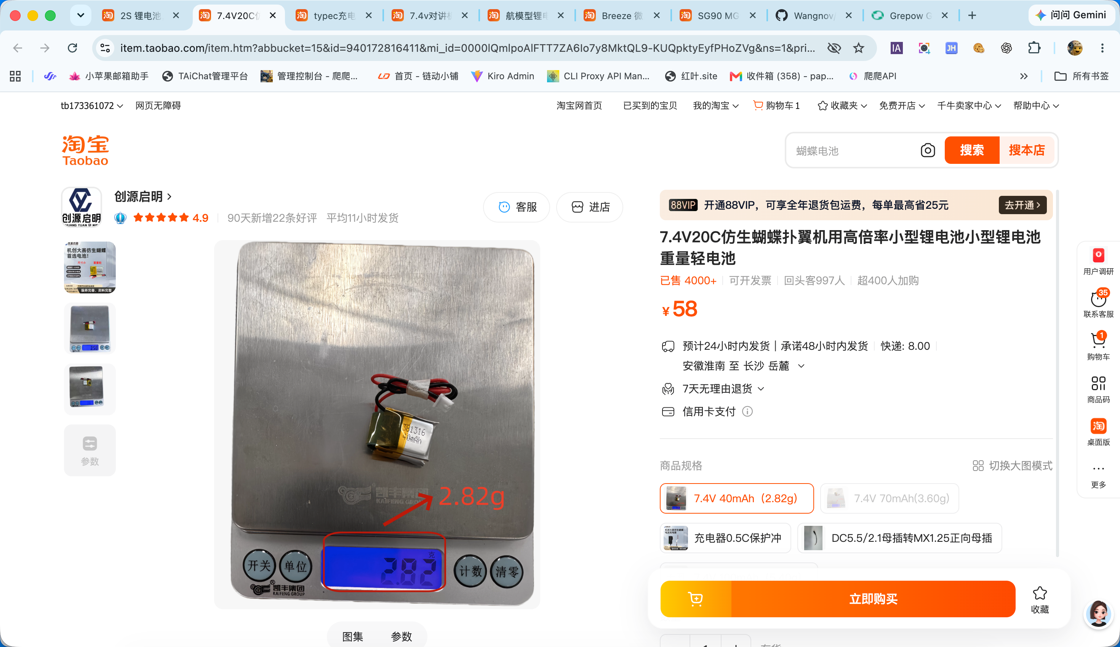
hardware-selection/reference/battery-flapping-40mah.png
