xaiojie/papabot/hardware-selection/reference/charger-qc-2s-black.png

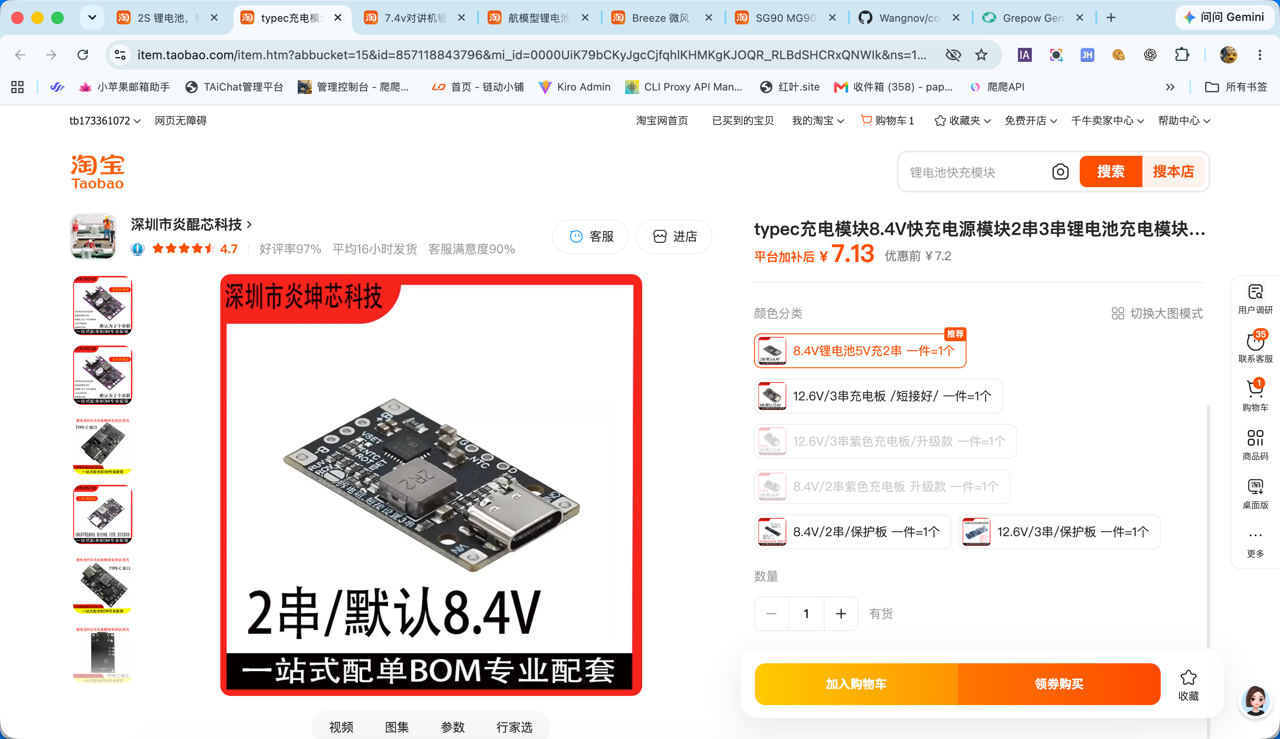
hardware-selection/reference/charger-qc-2s-black.png
