xaiojie/papabot/hardware-selection/reference/charger-telesky-2s-typec.png

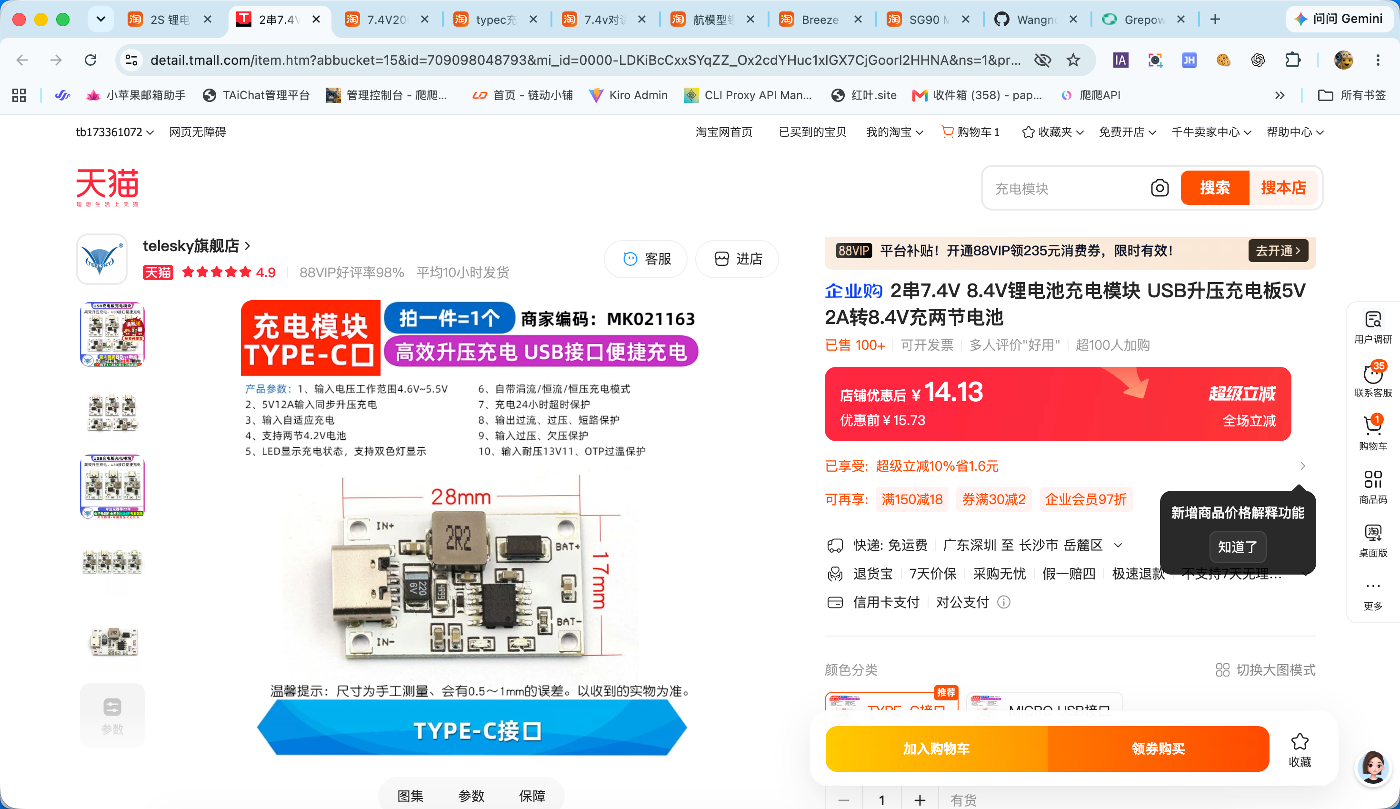
hardware-selection/reference/charger-telesky-2s-typec.png
