xaiojie/papabot/hardware-selection/reference/screen-2p4-ec11-price-32p40.png

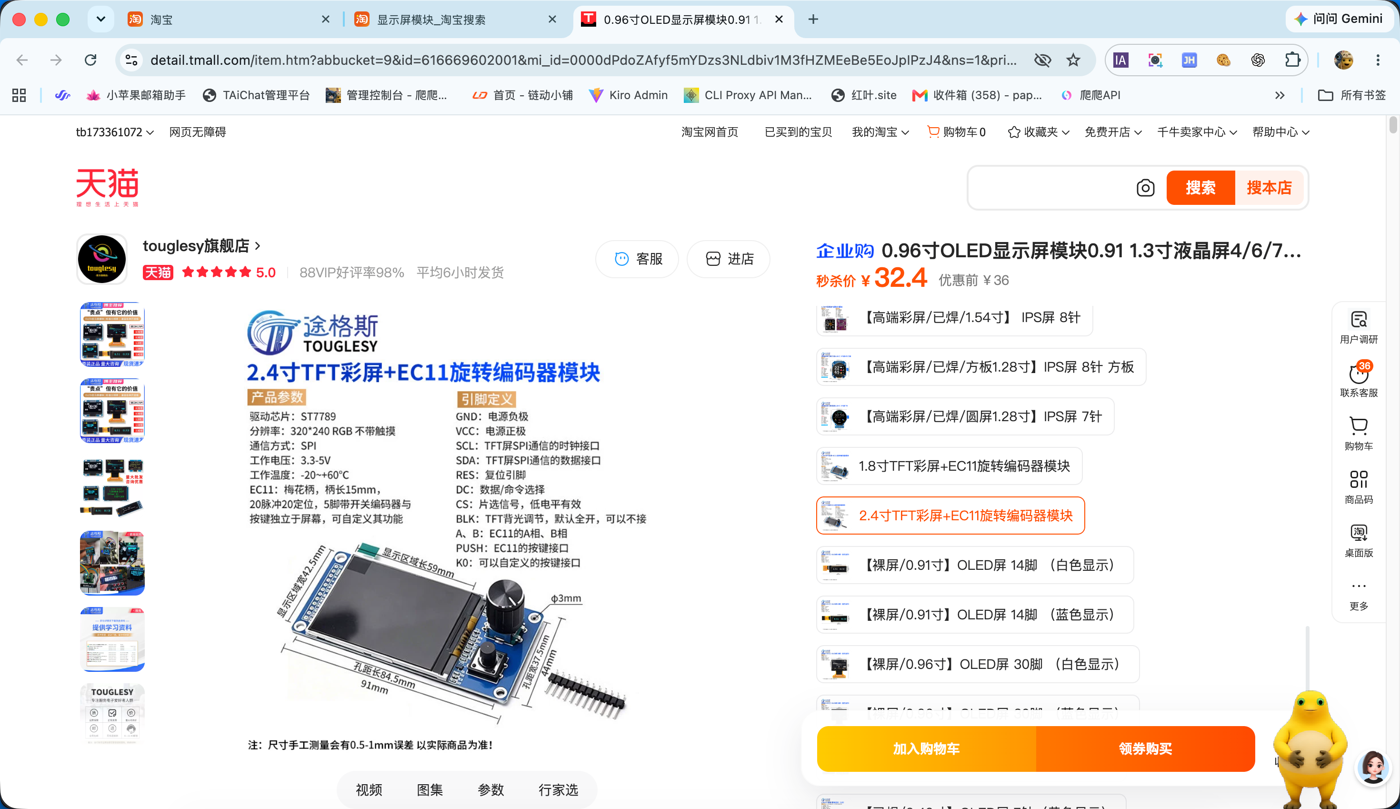
hardware-selection/reference/screen-2p4-ec11-price-32p40.png
