xaiojie/papabot/hardware-selection/reference/servo-combined-listing-start-price.png

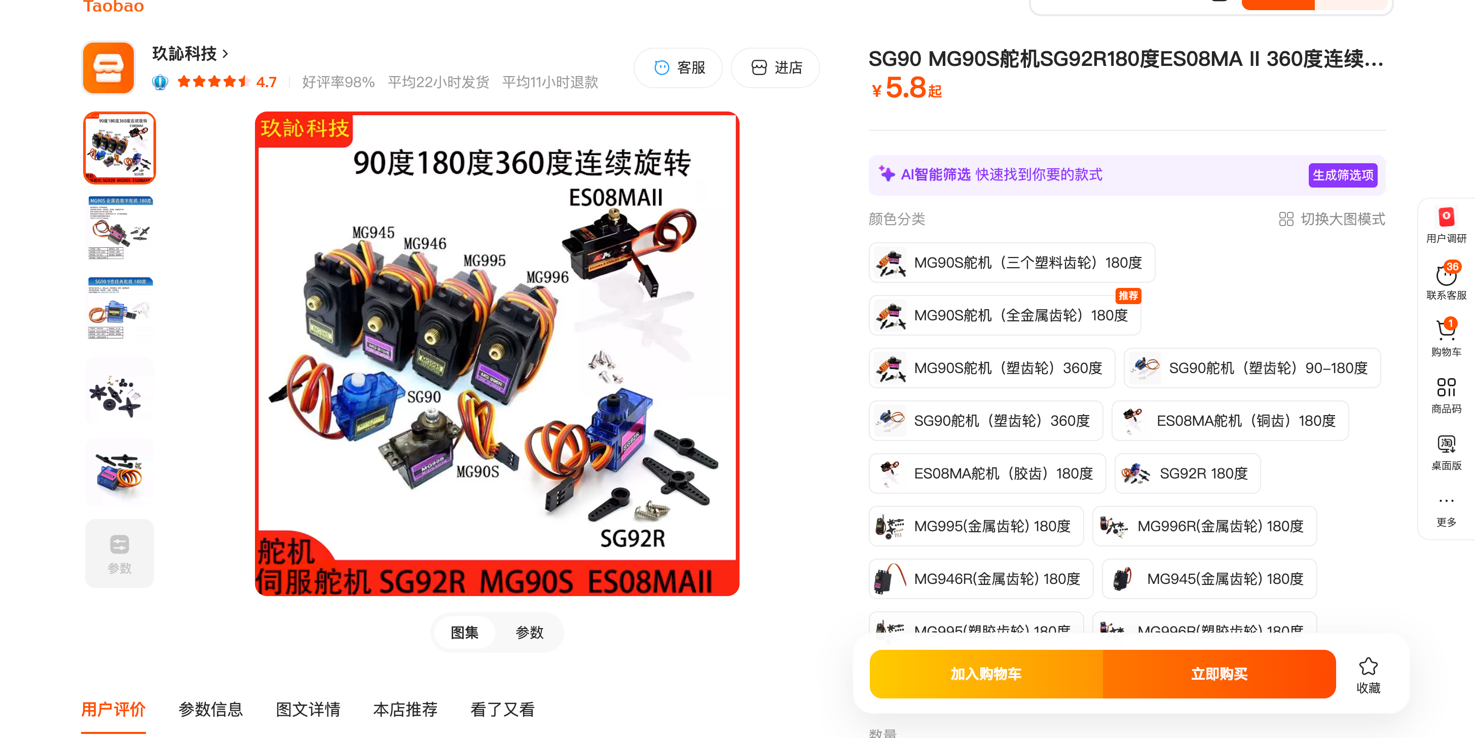
hardware-selection/reference/servo-combined-listing-start-price.png
