xaiojie/papabot/hardware-selection/reference/servo-mg90s-product-photo.png

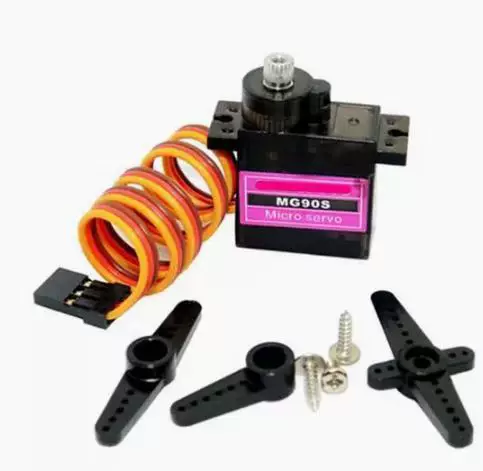
hardware-selection/reference/servo-mg90s-product-photo.png
