xaiojie/papabot/hardware-selection/reference/servo-option-1-sg90-selected.png

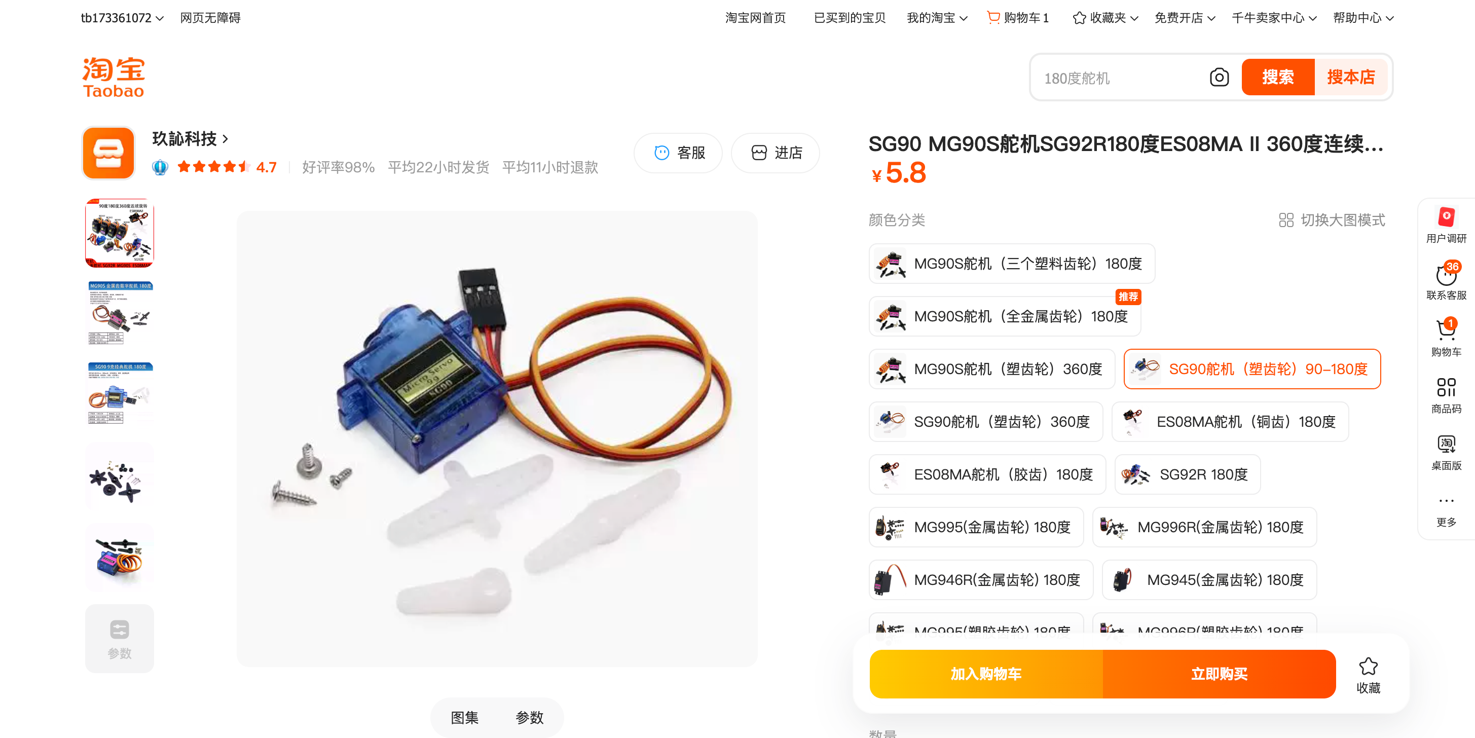
hardware-selection/reference/servo-option-1-sg90-selected.png
