xaiojie/papabot/hardware-selection/reference/servo-option-2-mg90s-180-selected.png

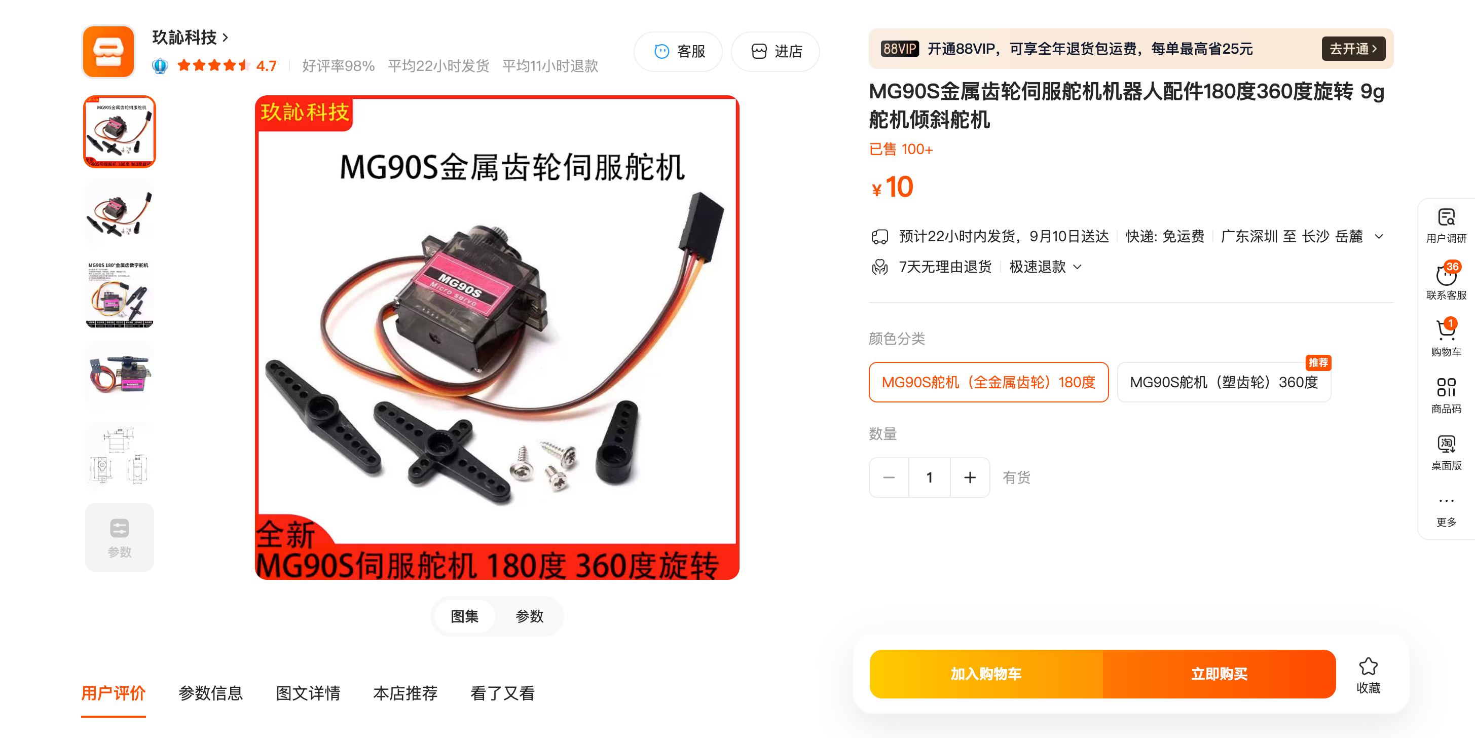
hardware-selection/reference/servo-option-2-mg90s-180-selected.png
