xaiojie/papabot/mechanical-design/assembly-v1/reference/selected-display-module-spec.png

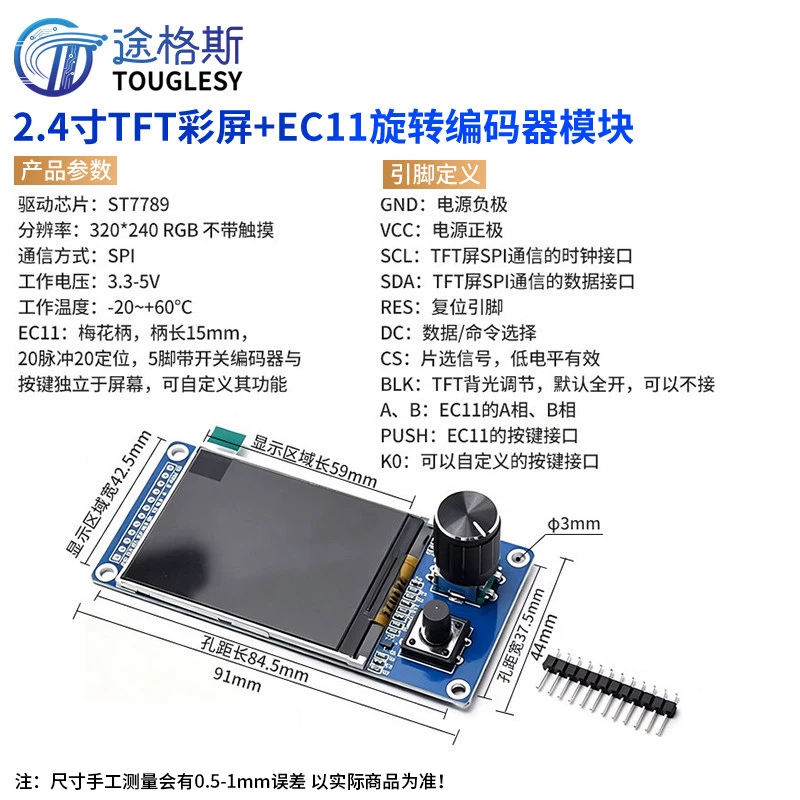
mechanical-design/assembly-v1/reference/selected-display-module-spec.png
