xaiojie/papabot/mechanical-design/concepts/design-v7-cmf-options/a-cream-mint.png

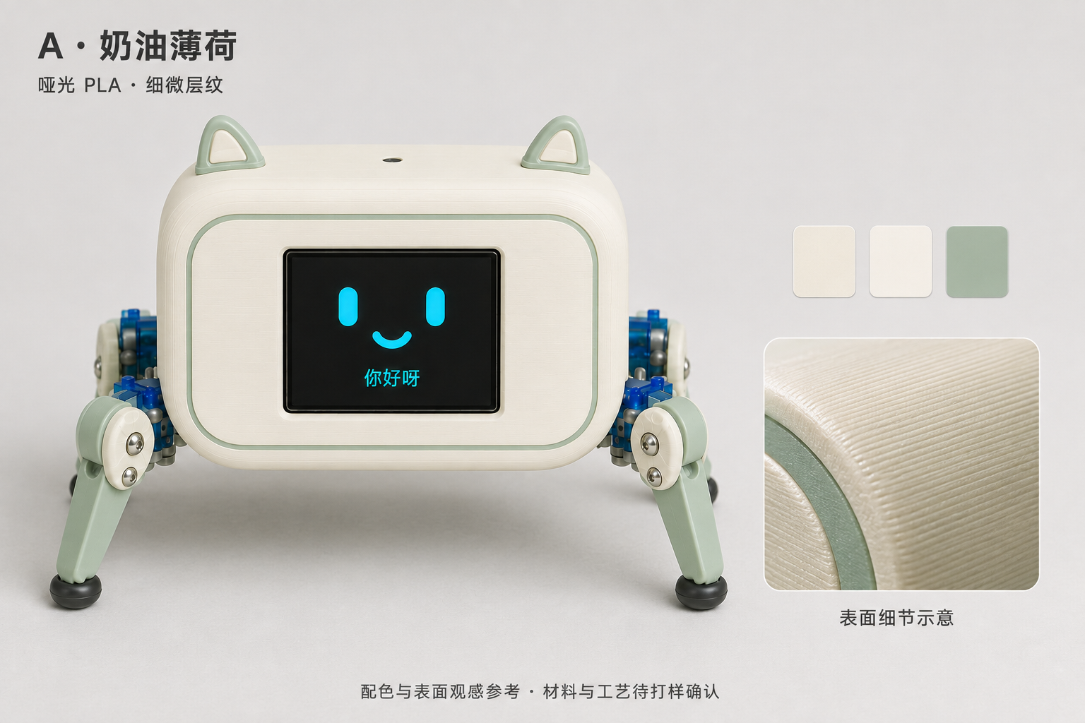
mechanical-design/concepts/design-v7-cmf-options/a-cream-mint.png
