xaiojie/papabot/mechanical-design/structure-a2/renders/R06-part.png

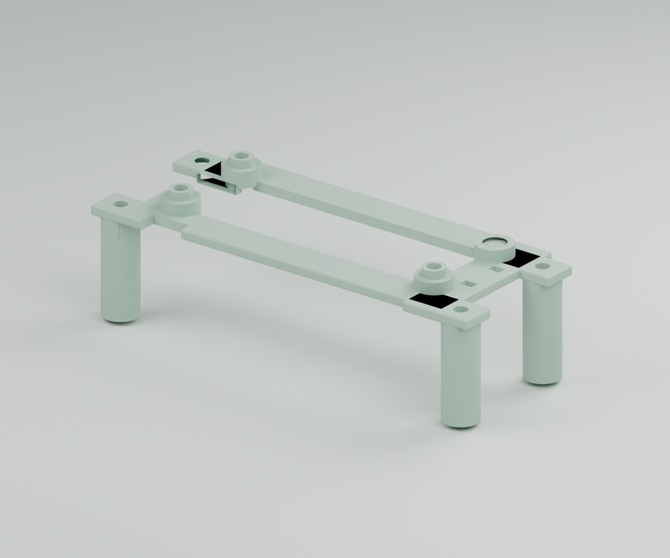
mechanical-design/structure-a2/renders/R06-part.png
