xaiojie/papabot/mechanical-design/structure-a2/renders/R06-pcb-and-battery.png

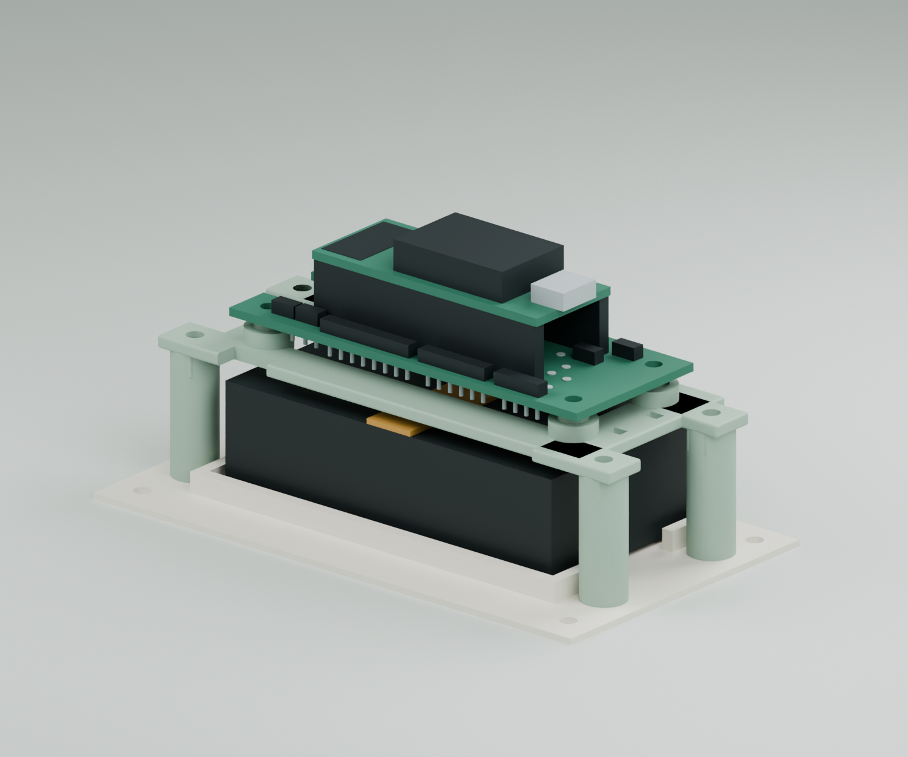
mechanical-design/structure-a2/renders/R06-pcb-and-battery.png
