xaiojie/papabot/mechanical-design/structure-a2/renders/R06-underside.png

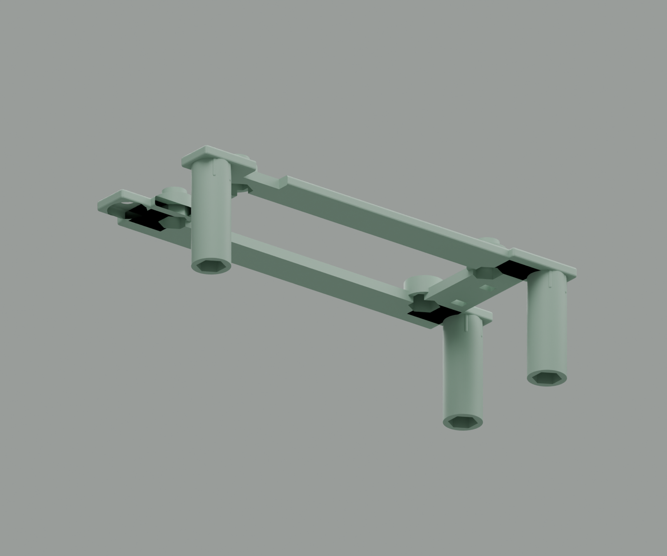
mechanical-design/structure-a2/renders/R06-underside.png
