xaiojie/papabot/mechanical-design/structure-a4/renders/A4-exploded.png

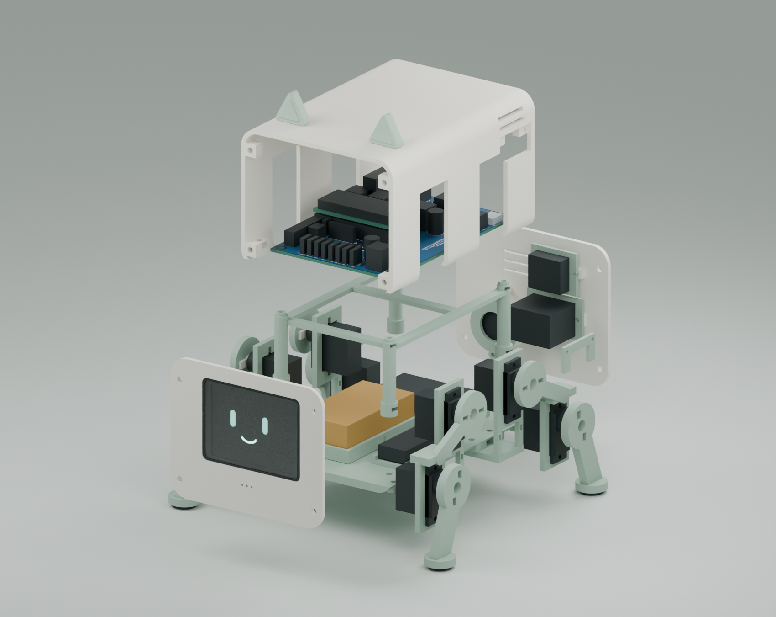
mechanical-design/structure-a4/renders/A4-exploded.png
