xaiojie/papabot/mechanical-design/structure-a4/renders/A4-front-open.png

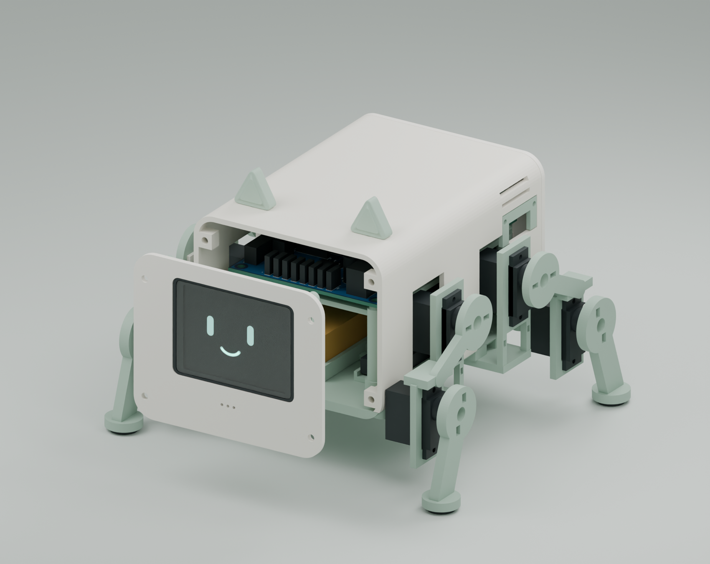
mechanical-design/structure-a4/renders/A4-front-open.png
