xaiojie/papabot/mechanical-design/structure-a4/renders/A4-front.png

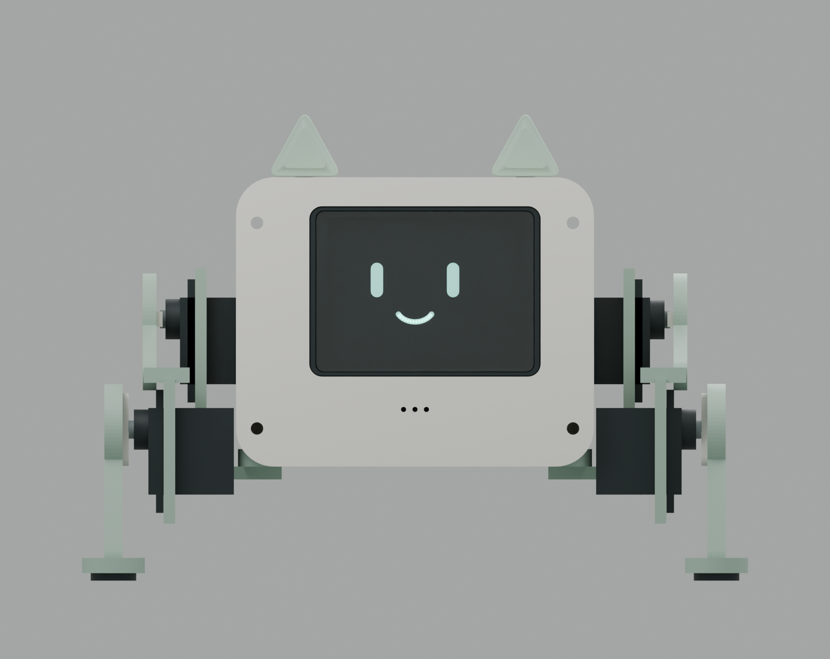
mechanical-design/structure-a4/renders/A4-front.png
