xaiojie/papabot/mechanical-design/structure-a4/renders/A4-internal.png

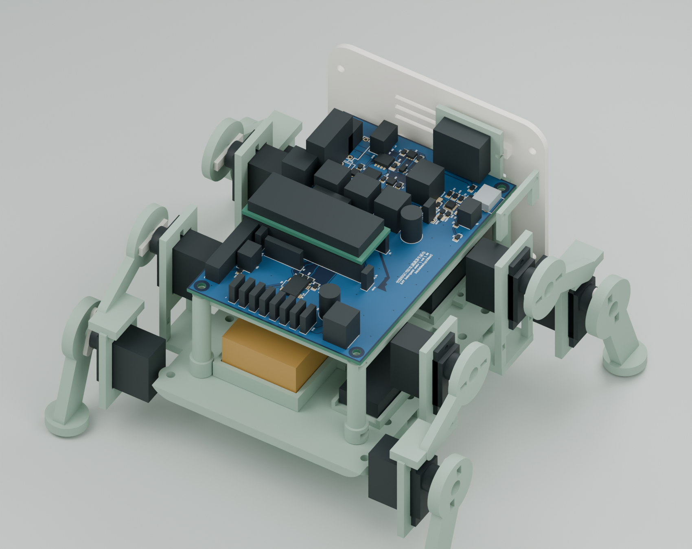
mechanical-design/structure-a4/renders/A4-internal.png
