xaiojie/papabot/mechanical-design/structure-a4/renders/A4-lower-deck.png

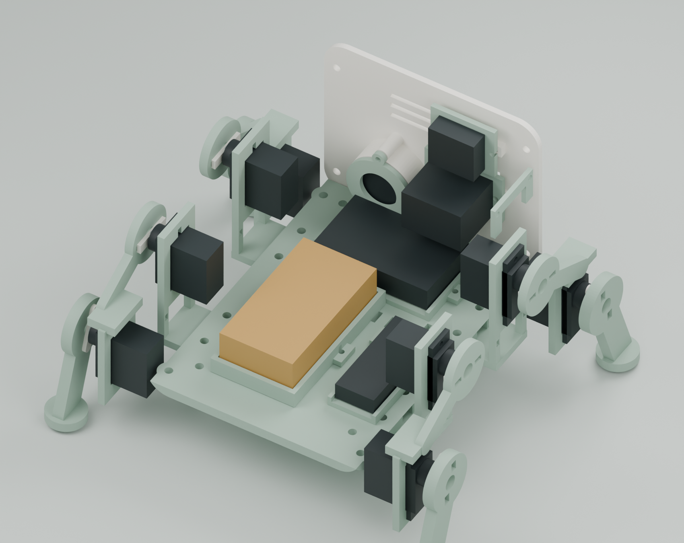
mechanical-design/structure-a4/renders/A4-lower-deck.png
