xaiojie/papabot/mechanical-design/structure-a4/renders/A4-perspective.png

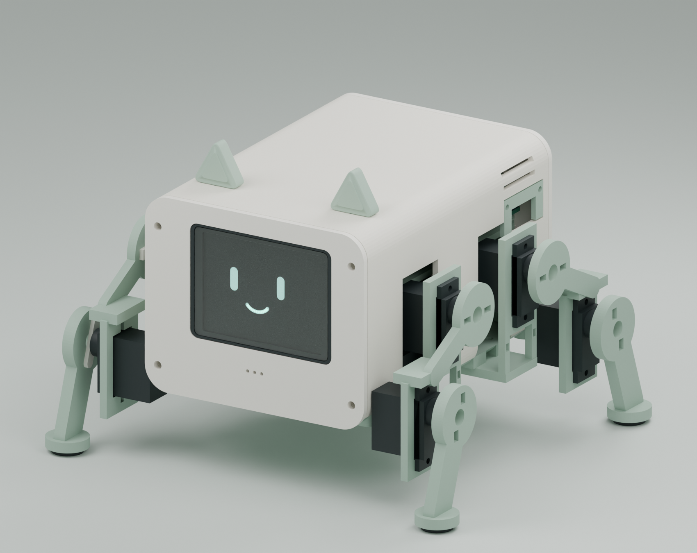
mechanical-design/structure-a4/renders/A4-perspective.png
