xaiojie/papabot/mechanical-design/structure-a4/renders/A4-rear.png

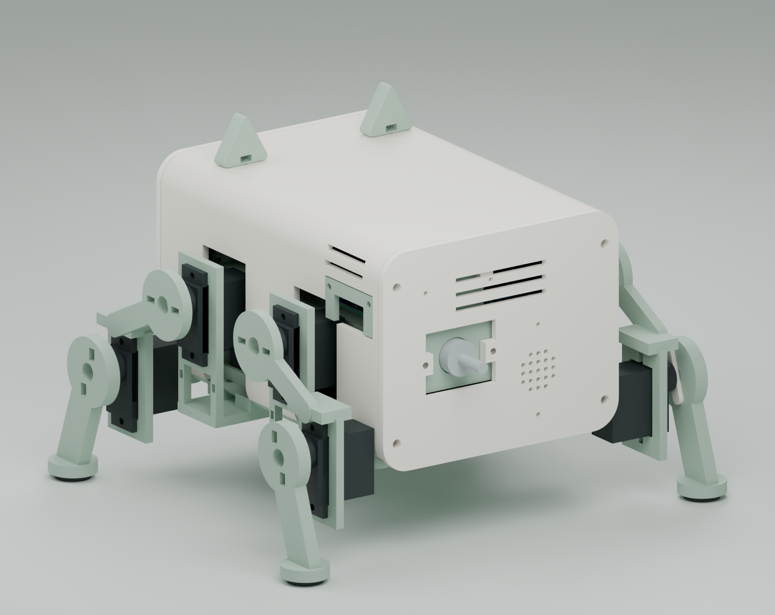
mechanical-design/structure-a4/renders/A4-rear.png
