xaiojie/papabot/mechanical-design/structure-a5/renders/A5-exploded.png

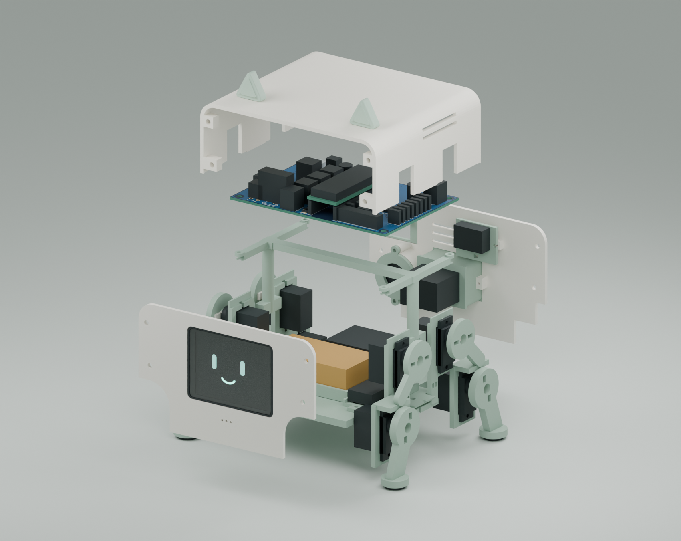
mechanical-design/structure-a5/renders/A5-exploded.png
