xaiojie/papabot/mechanical-design/structure-a5/renders/A5-front.png

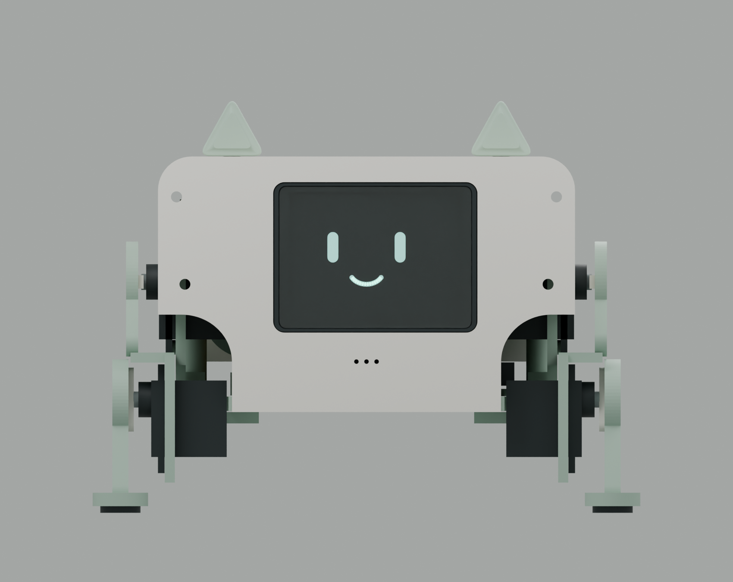
mechanical-design/structure-a5/renders/A5-front.png
