xaiojie/papabot/mechanical-design/structure-a5/renders/A5-internal.png

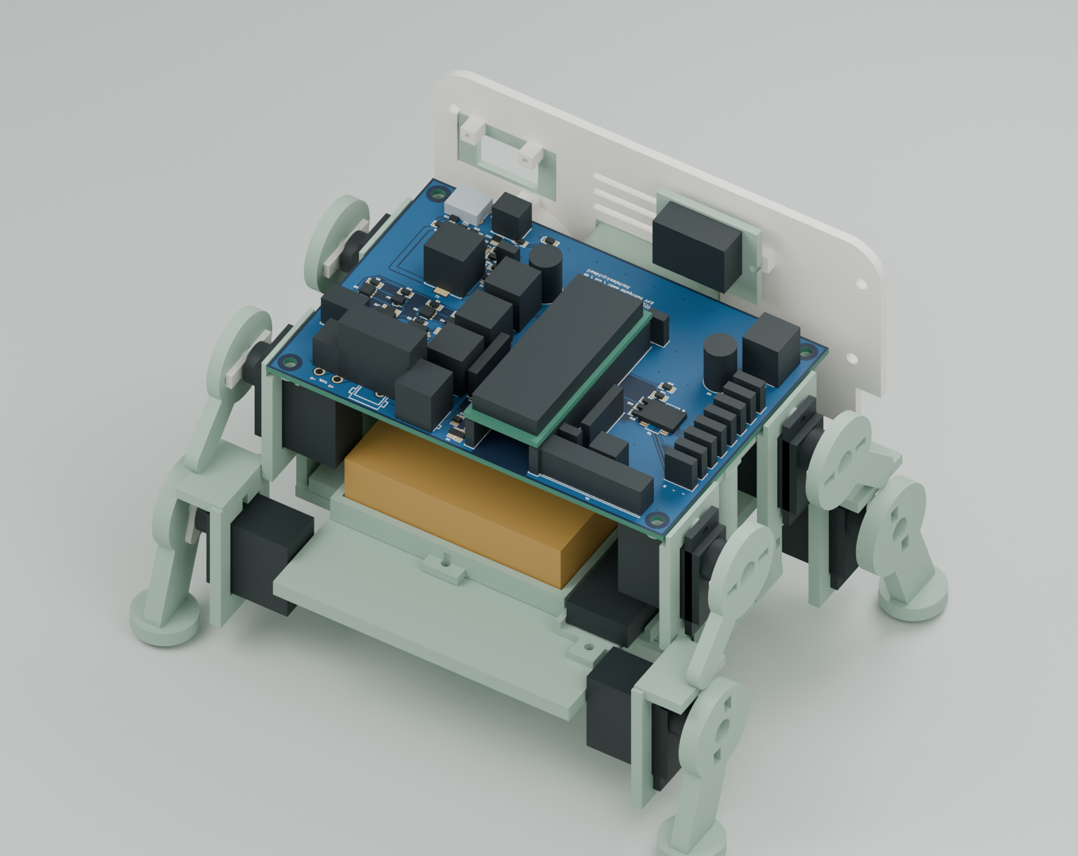
mechanical-design/structure-a5/renders/A5-internal.png
