xaiojie/papabot/mechanical-design/structure-a5/renders/A5-rear.png

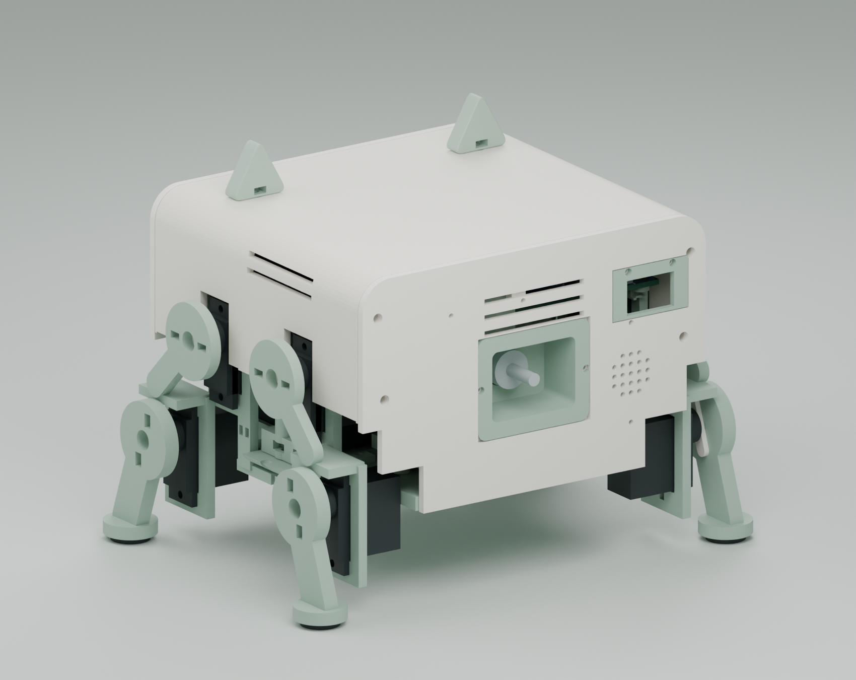
mechanical-design/structure-a5/renders/A5-rear.png
