xaiojie/papabot/mechanical-design/structure-a5/renders/A5-top.png

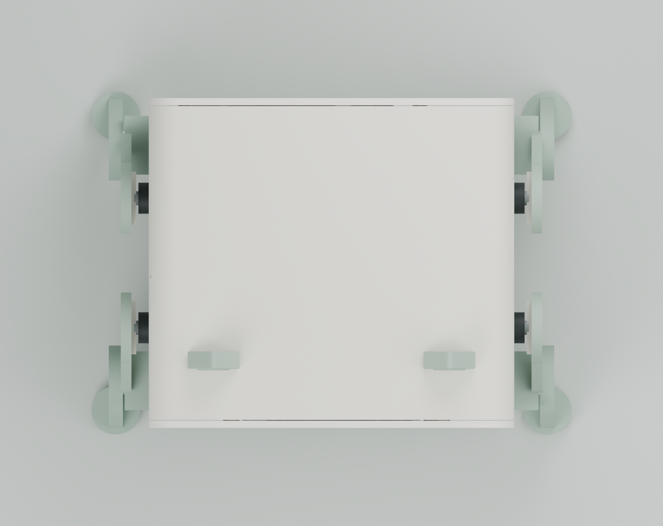
mechanical-design/structure-a5/renders/A5-top.png
