xaiojie/papabot/pcb-design/integrated-v1/datasheets/PW4584A规格书_p2_引脚与PCB建议.png

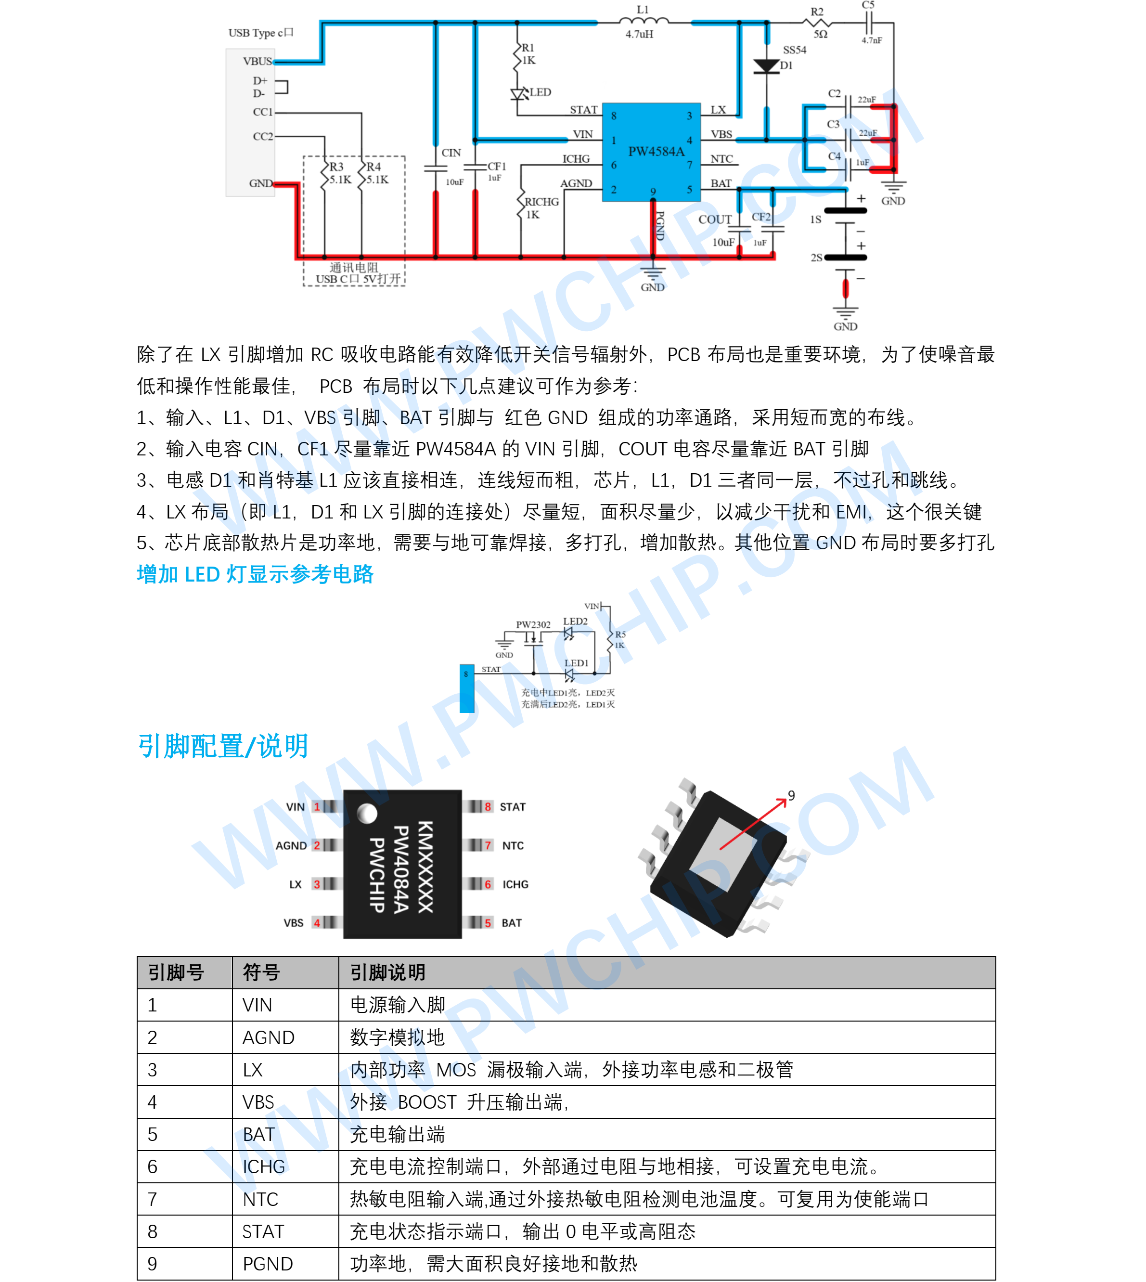
pcb-design/integrated-v1/datasheets/PW4584A规格书_p2_引脚与PCB建议.png
