xaiojie/papabot/pcb-design/integrated-v1/datasheets/PW7120规格书_p1_典型应用电路.png

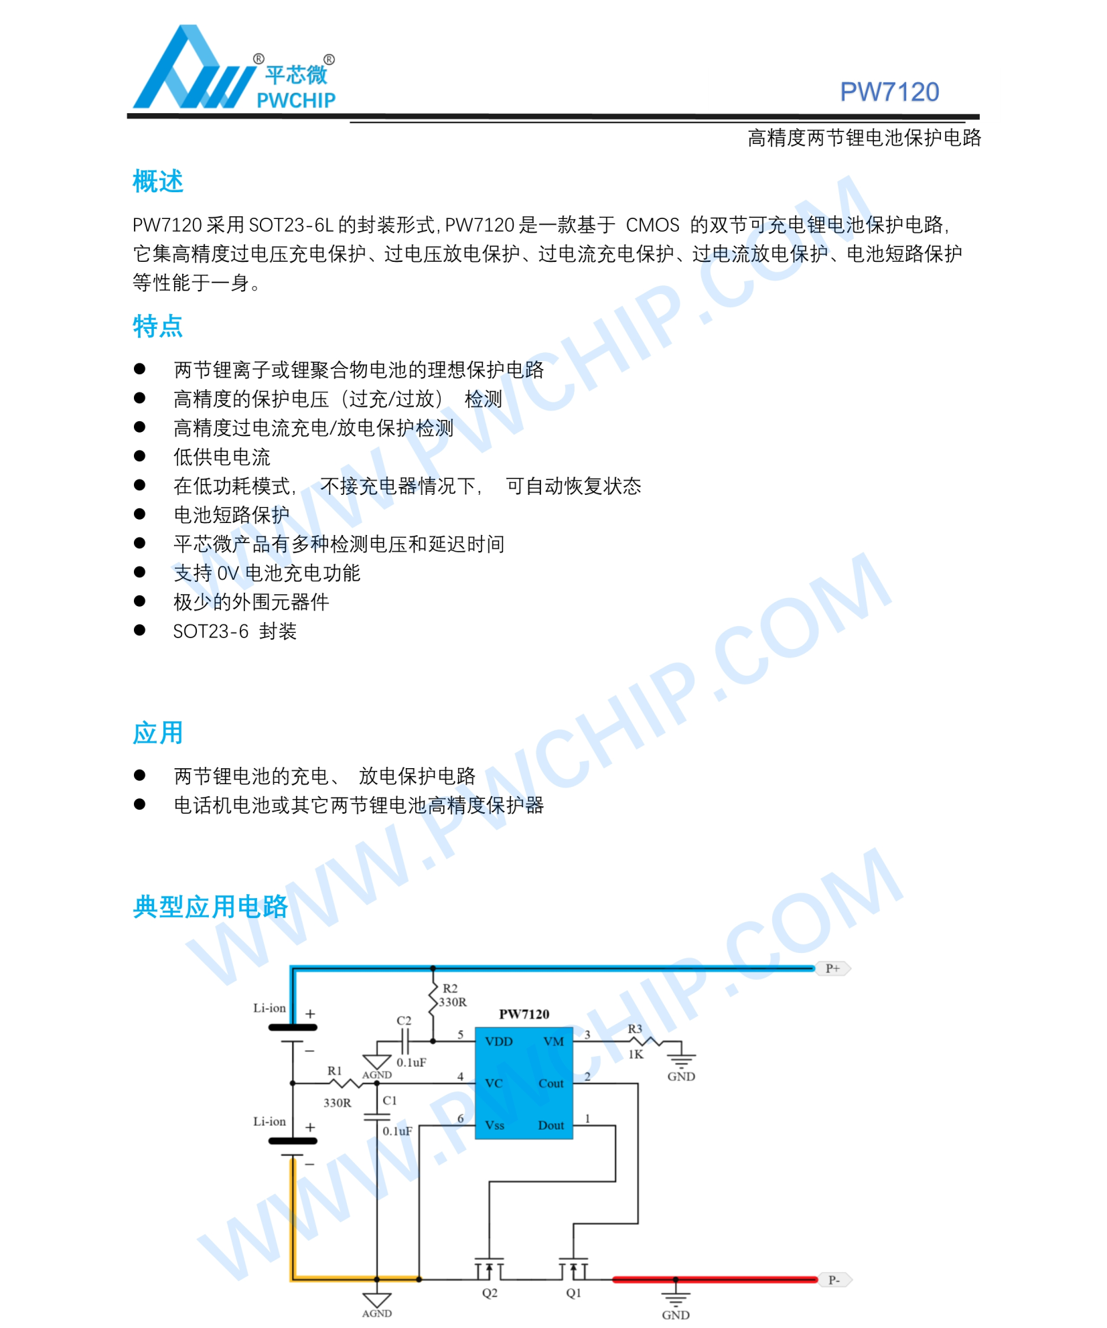
pcb-design/integrated-v1/datasheets/PW7120规格书_p1_典型应用电路.png
