xaiojie/papabot/pcb-design/integrated-v1/datasheets/PW7120规格书_p2_引脚描述与搭配电路.png

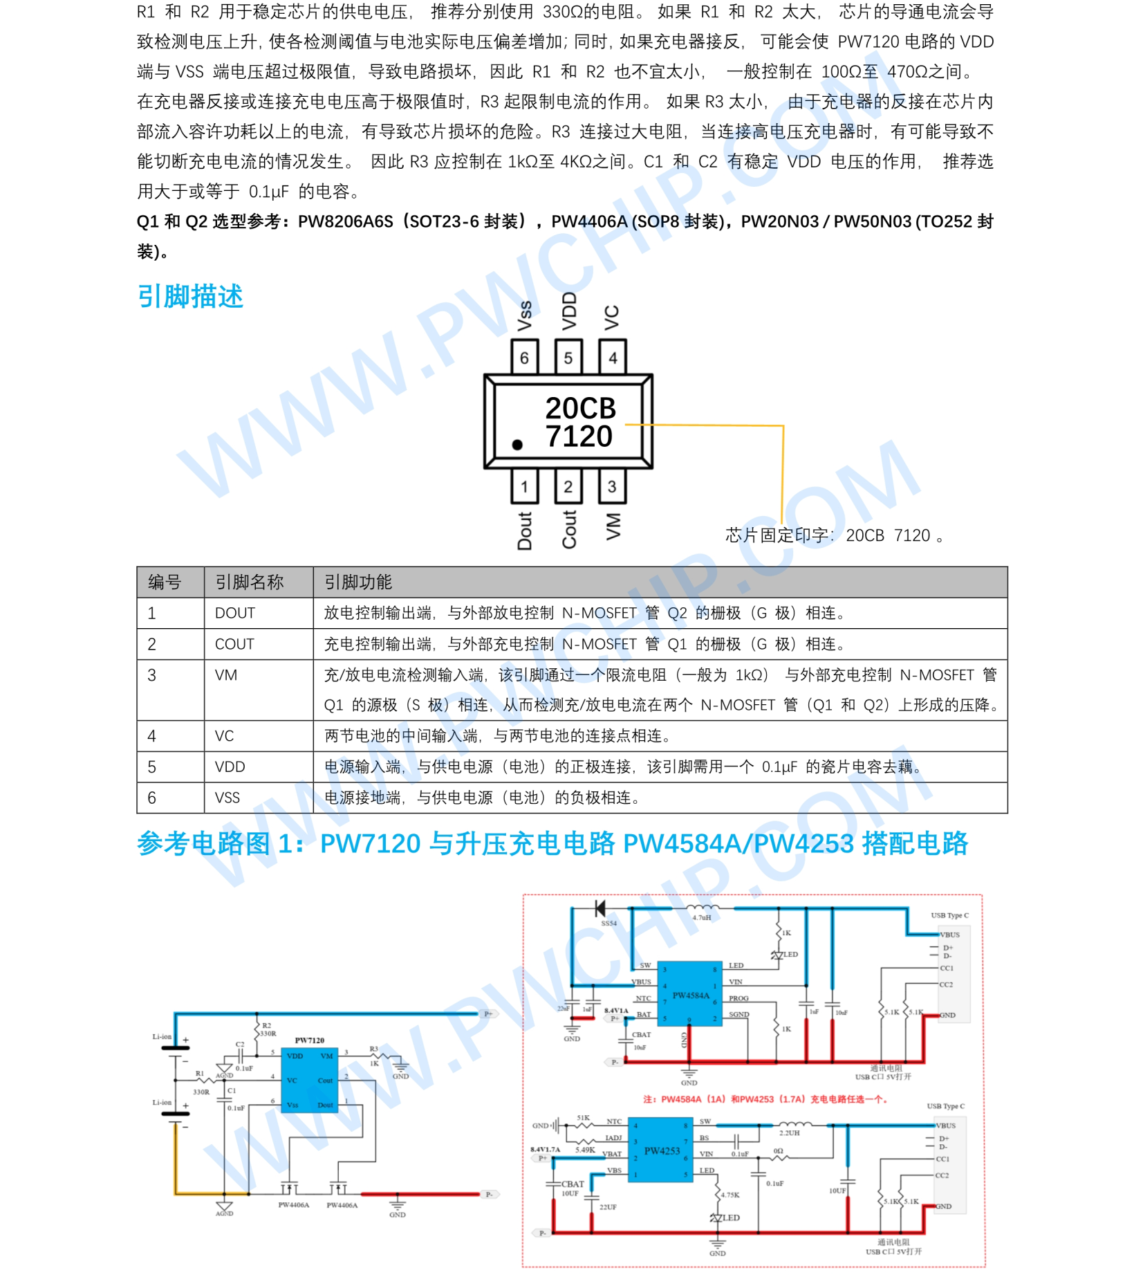
pcb-design/integrated-v1/datasheets/PW7120规格书_p2_引脚描述与搭配电路.png
