xaiojie/papabot/pcb-design/integrated-v1/datasheets/PW7120规格书_p3_均衡搭配与极限参数.png

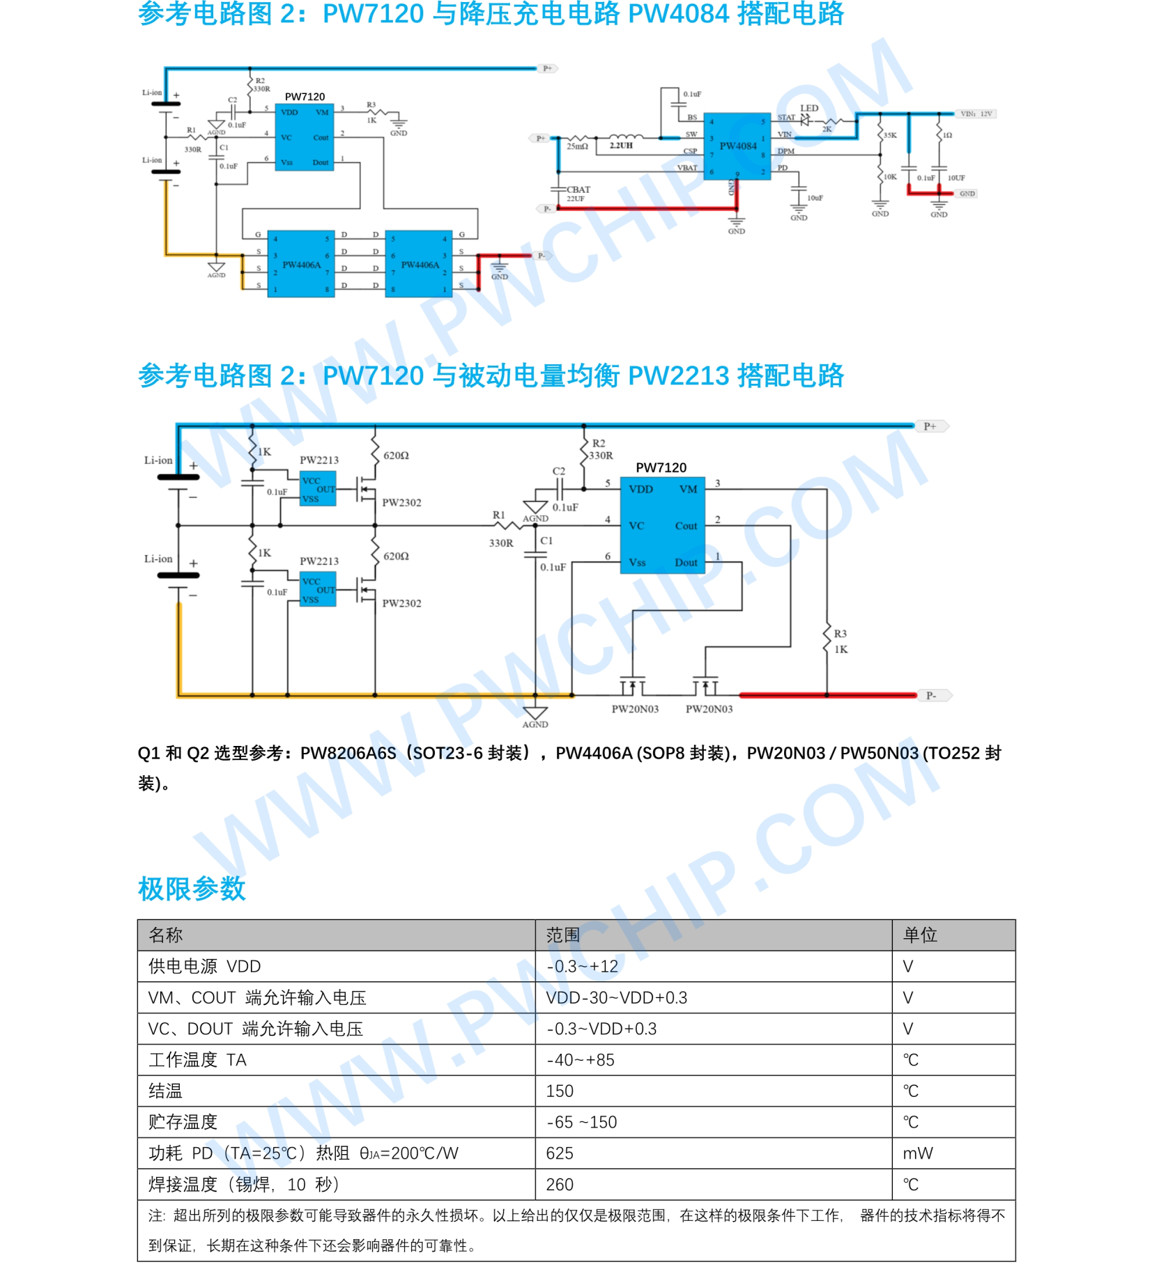
pcb-design/integrated-v1/datasheets/PW7120规格书_p3_均衡搭配与极限参数.png
