xaiojie/papabot/pcb-design/integrated-v1/datasheets/屏幕_HS24S010B_封装图.png

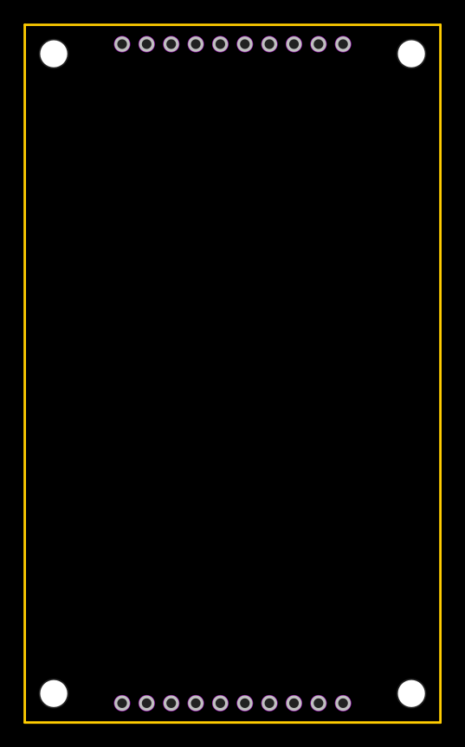
pcb-design/integrated-v1/datasheets/屏幕_HS24S010B_封装图.png
