xaiojie/papabot/pcb-design/integrated-v1/eda-截图/9区块_A3版_20260911.png

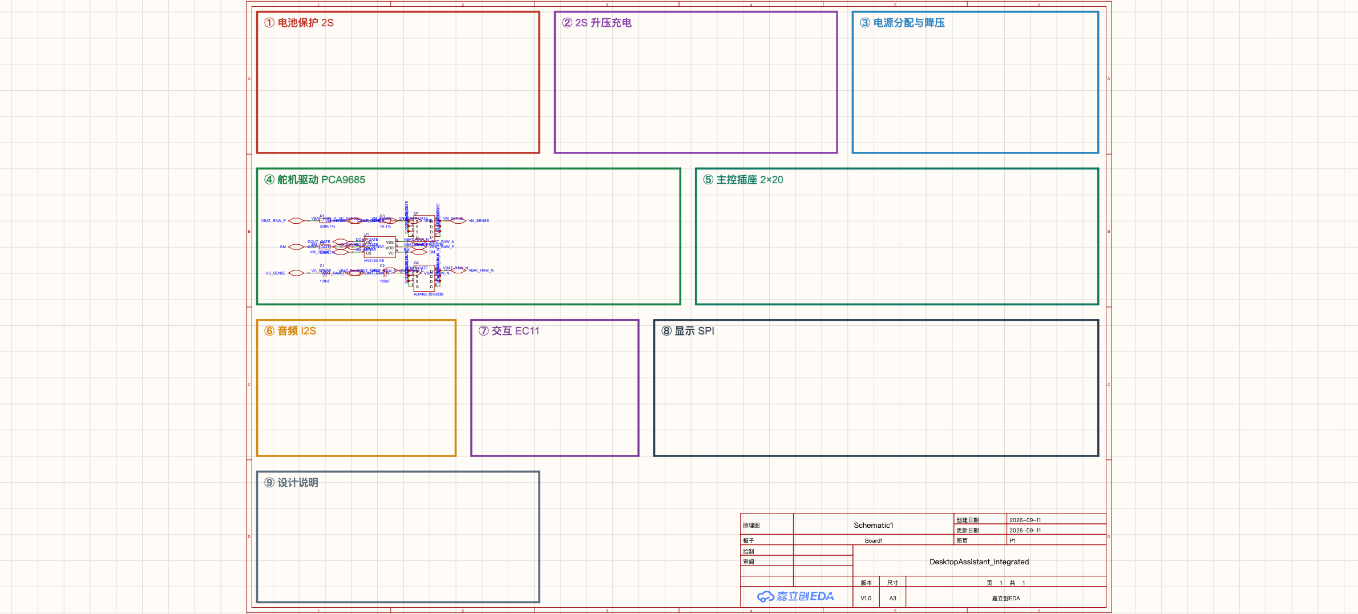
pcb-design/integrated-v1/eda-截图/9区块_A3版_20260911.png
