xaiojie/papabot/pcb-design/integrated-v1/eda-截图/9区块框架_已避开标题栏_20260911.png

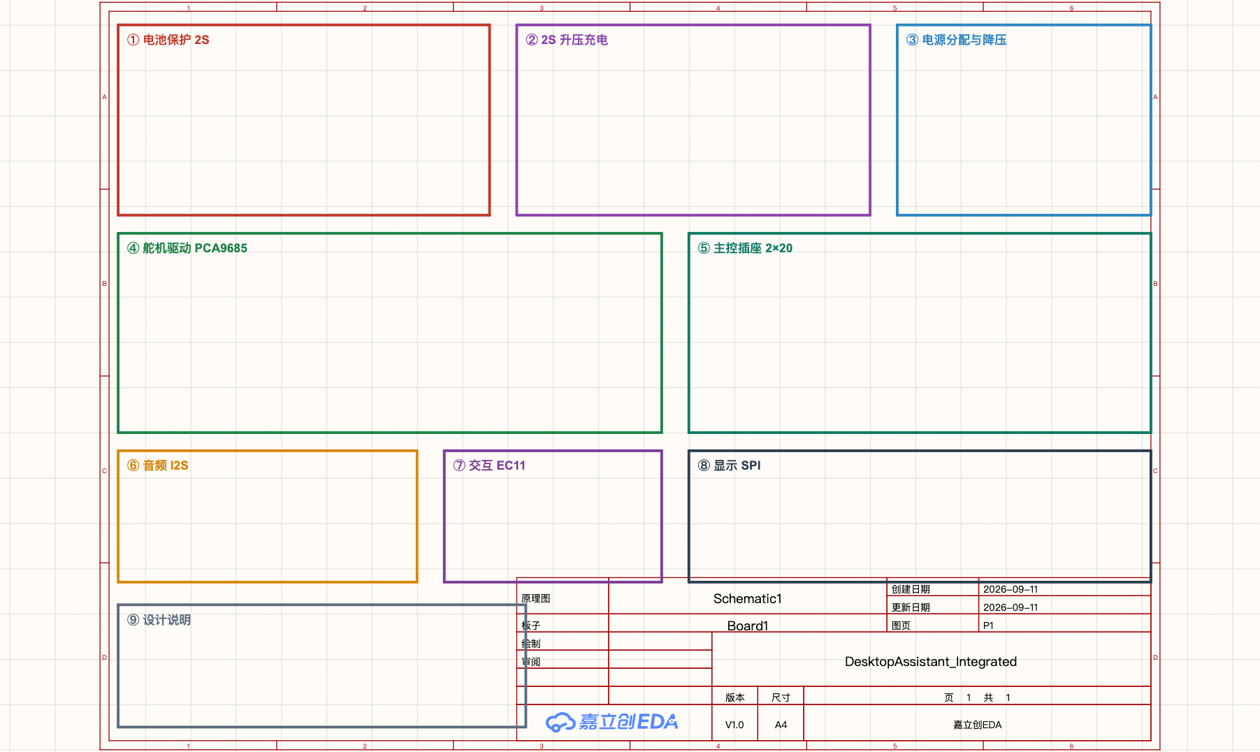
pcb-design/integrated-v1/eda-截图/9区块框架_已避开标题栏_20260911.png
