xaiojie/papabot/pcb-design/integrated-v1/eda-截图/RevB载板原理图_20260911.png

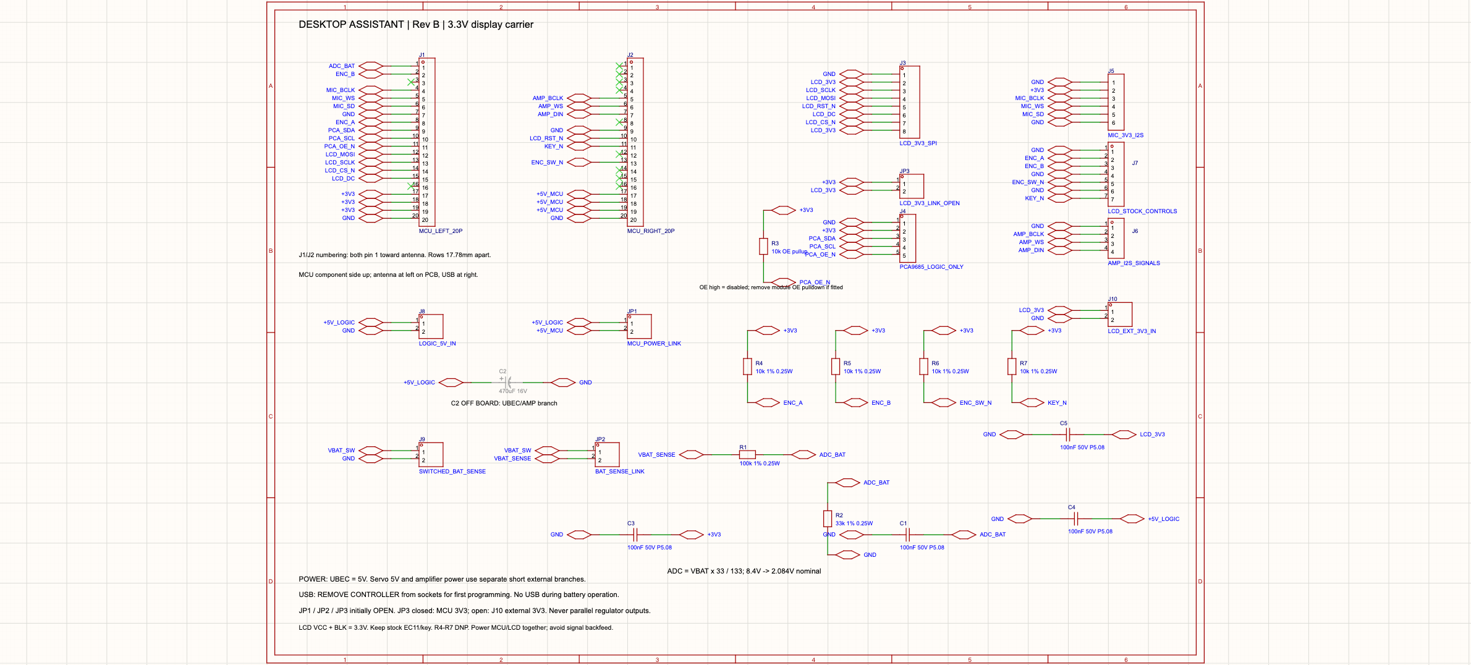
pcb-design/integrated-v1/eda-截图/RevB载板原理图_20260911.png
