xaiojie/papabot/pcb-design/integrated-v1/eda-截图/全部10模块_A3完成_20260911.png

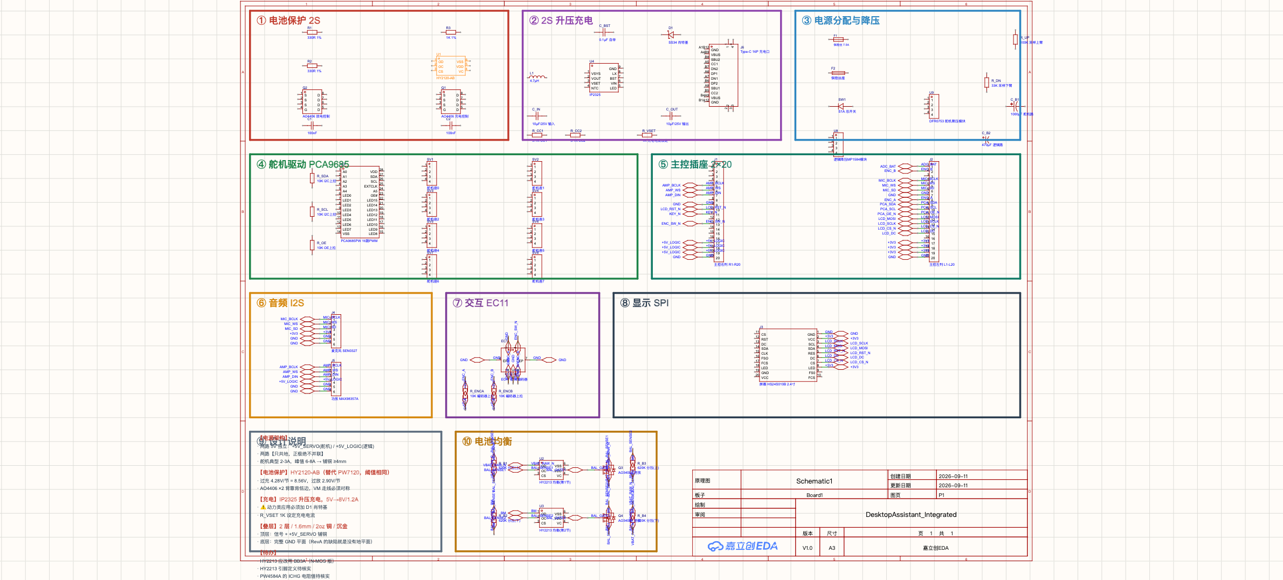
pcb-design/integrated-v1/eda-截图/全部10模块_A3完成_20260911.png
