xaiojie/papabot/pcb-design/integrated-v1/eda-截图/原理图_DRC3警告_20260911.png

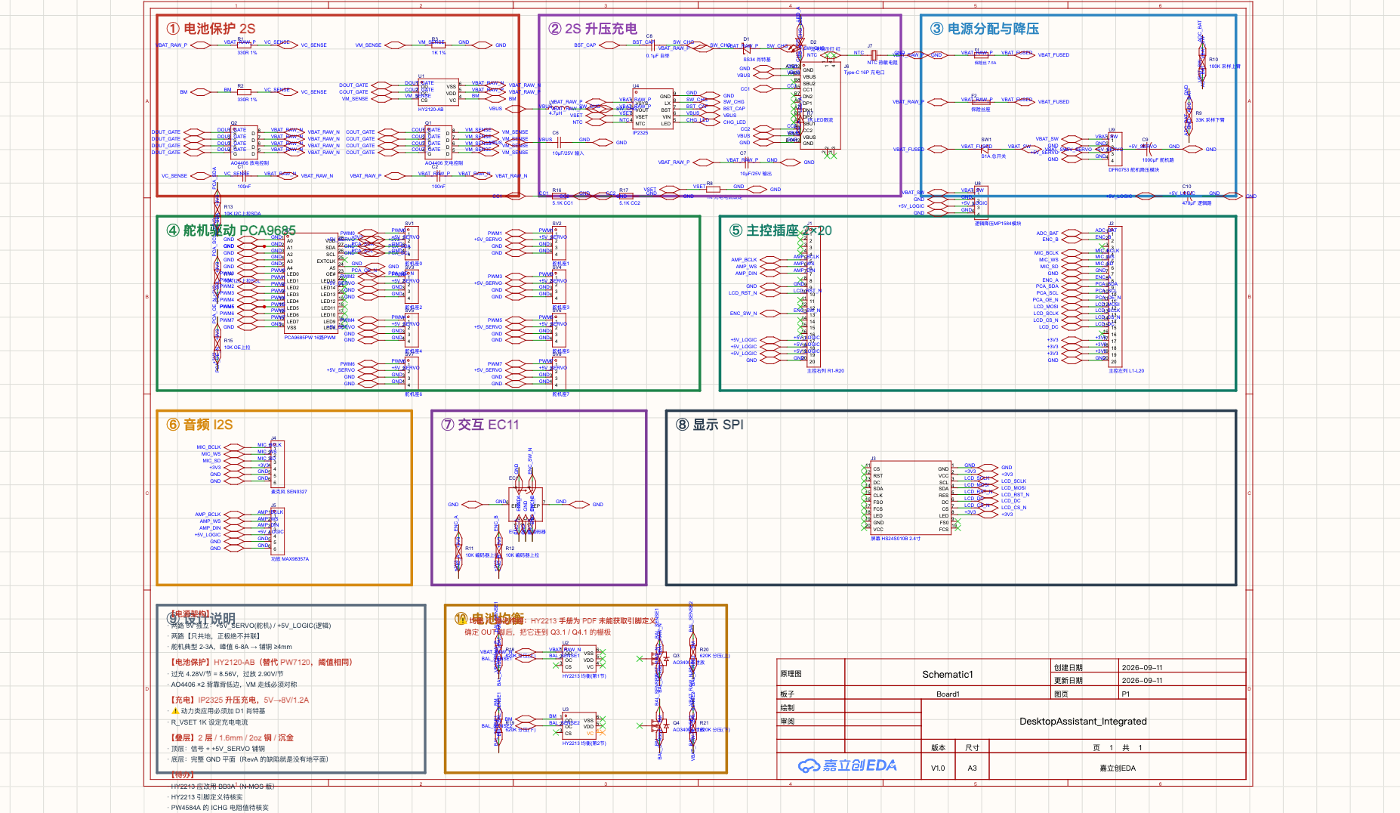
pcb-design/integrated-v1/eda-截图/原理图_DRC3警告_20260911.png
