xaiojie/papabot/pcb-design/integrated-v1/eda-截图/原理图_DRC仅9警告_无短路_20260911.png

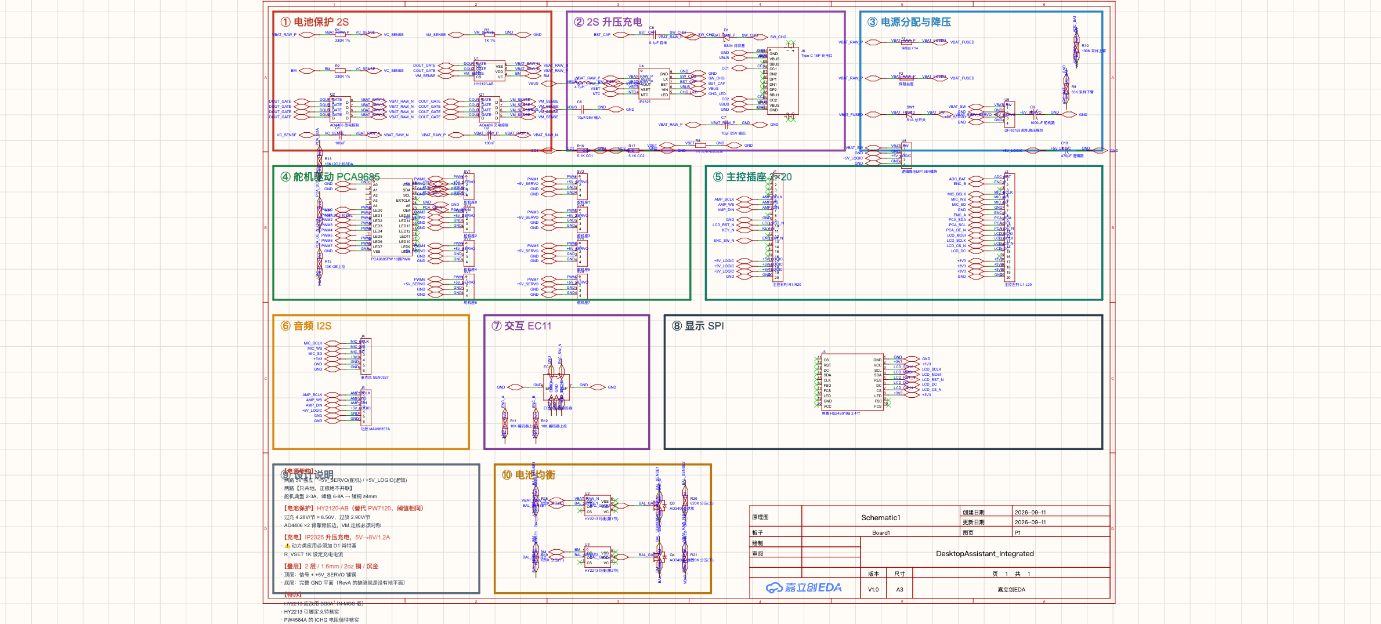
pcb-design/integrated-v1/eda-截图/原理图_DRC仅9警告_无短路_20260911.png
