xaiojie/papabot/pcb-design/integrated-v1/eda-截图/建板进度_模块1已建_20260911.png

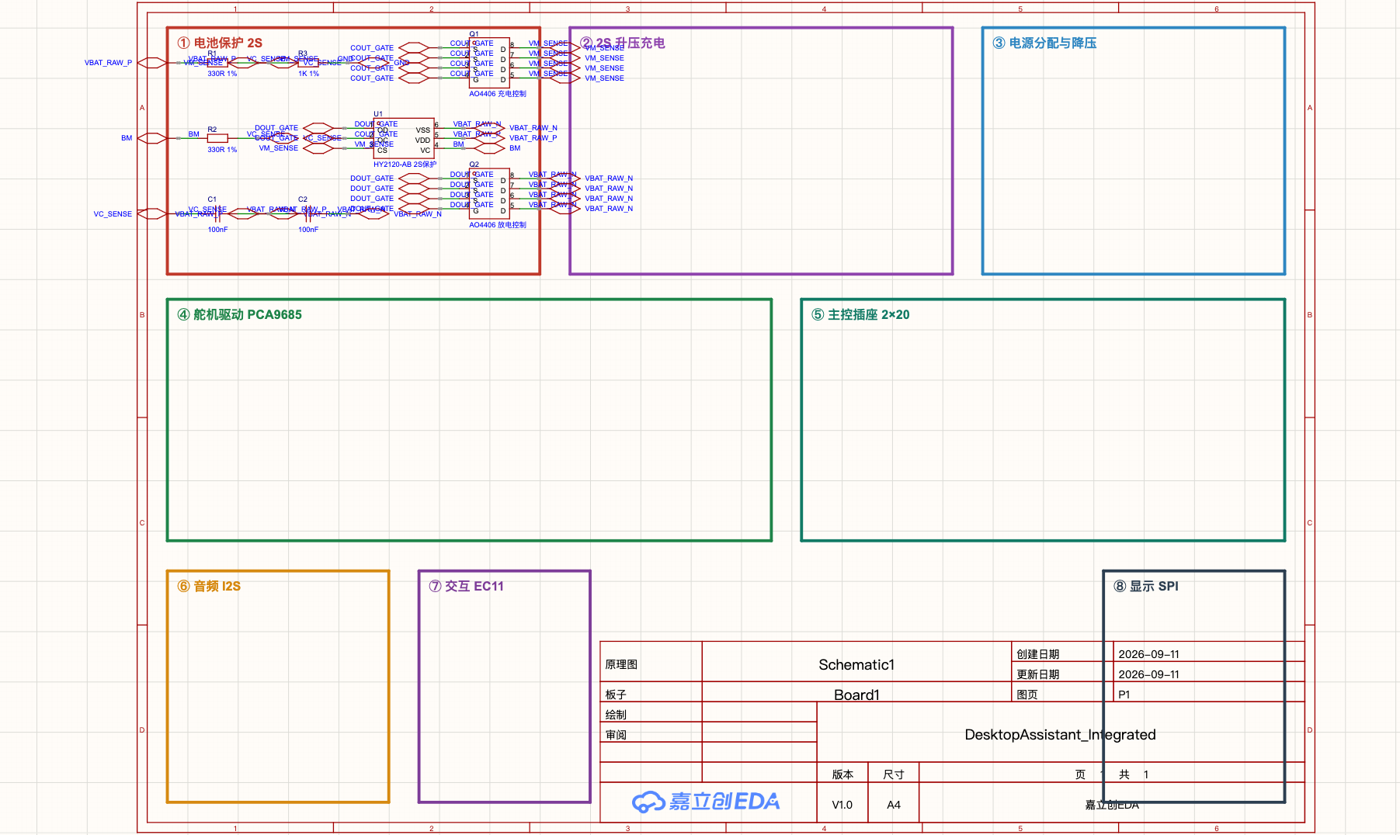
pcb-design/integrated-v1/eda-截图/建板进度_模块1已建_20260911.png
