xaiojie/papabot/pcb-design/integrated-v1/eda-截图/模块1完成_20260911.png

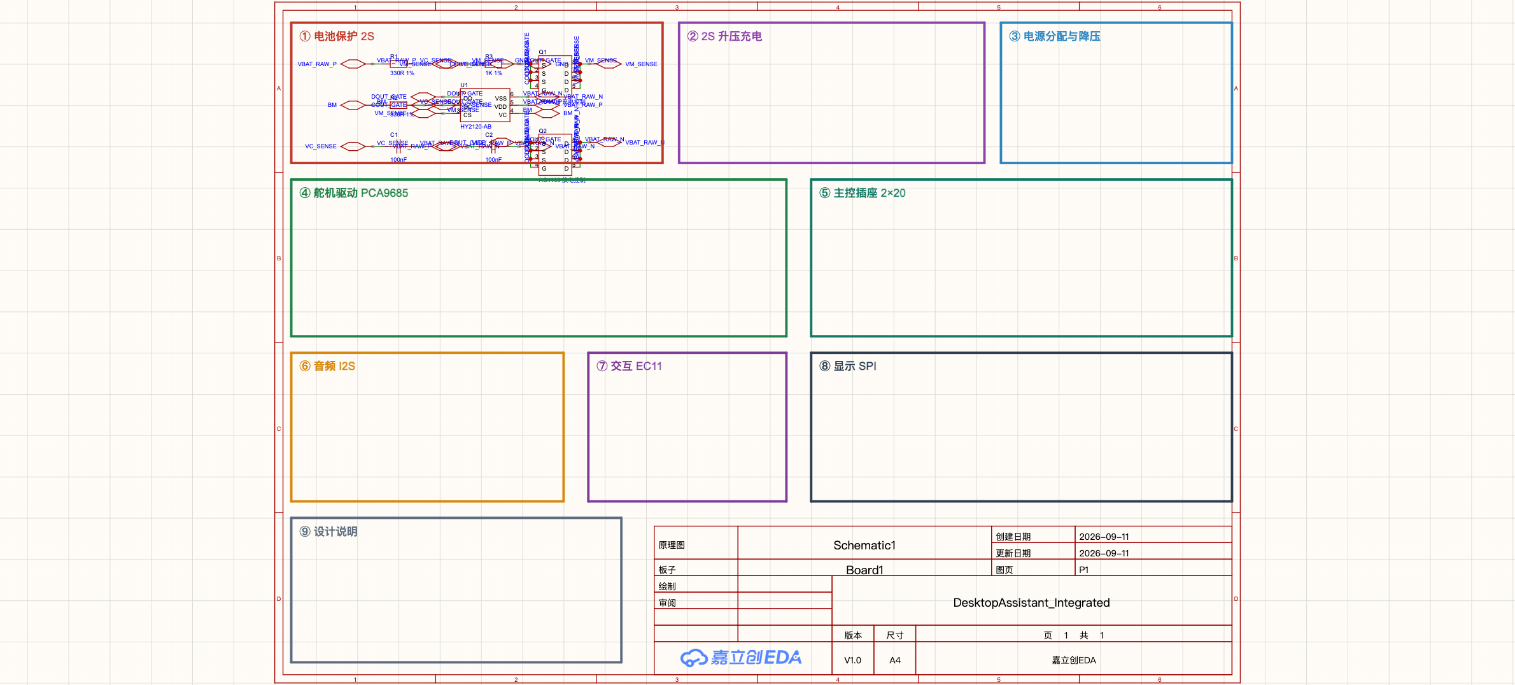
pcb-design/integrated-v1/eda-截图/模块1完成_20260911.png
