xaiojie/papabot/pcb-design/integrated-v1/eda-截图/模块4-5放大_20260911.png

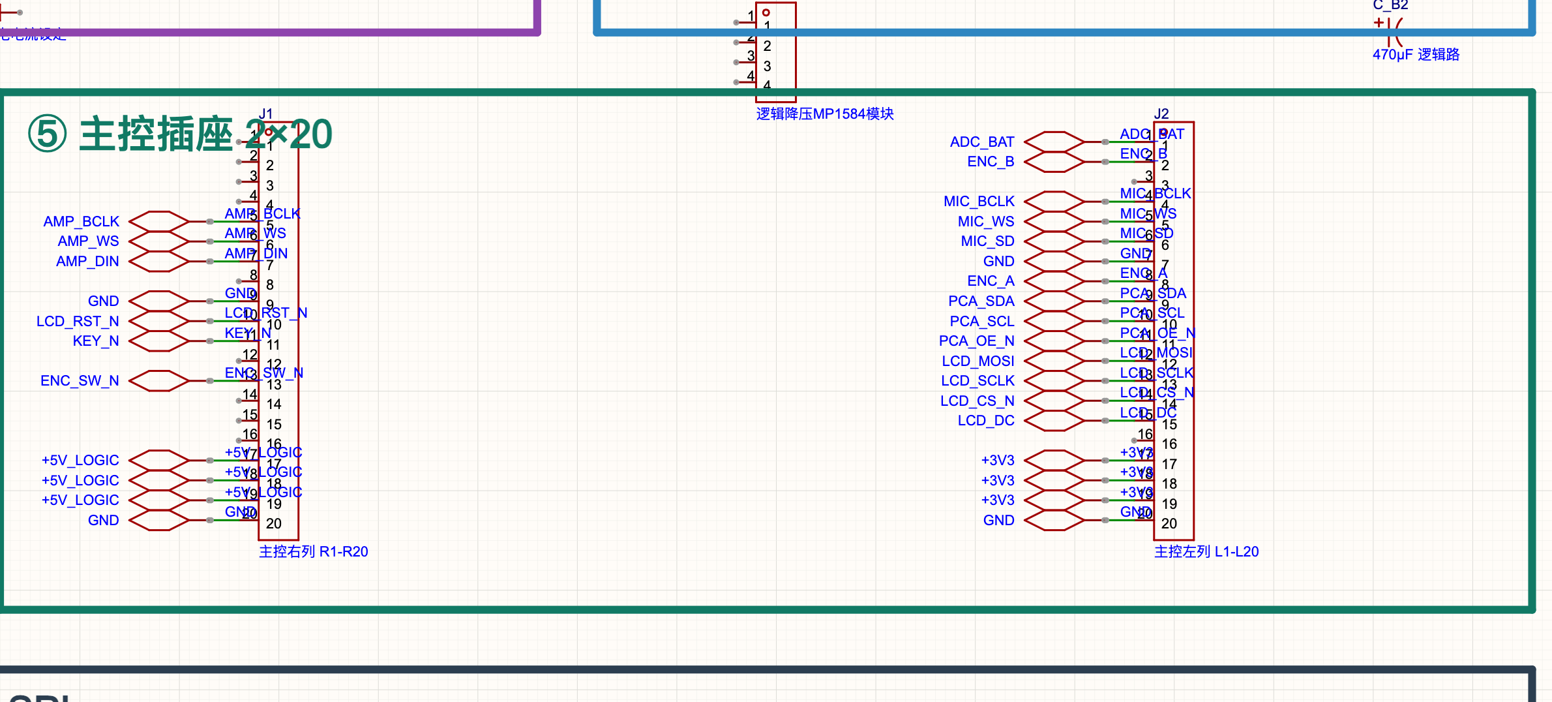
pcb-design/integrated-v1/eda-截图/模块4-5放大_20260911.png
