xaiojie/papabot/pcb-design/integrated-v1/final-2026-09-12/Critical_corner_review.png

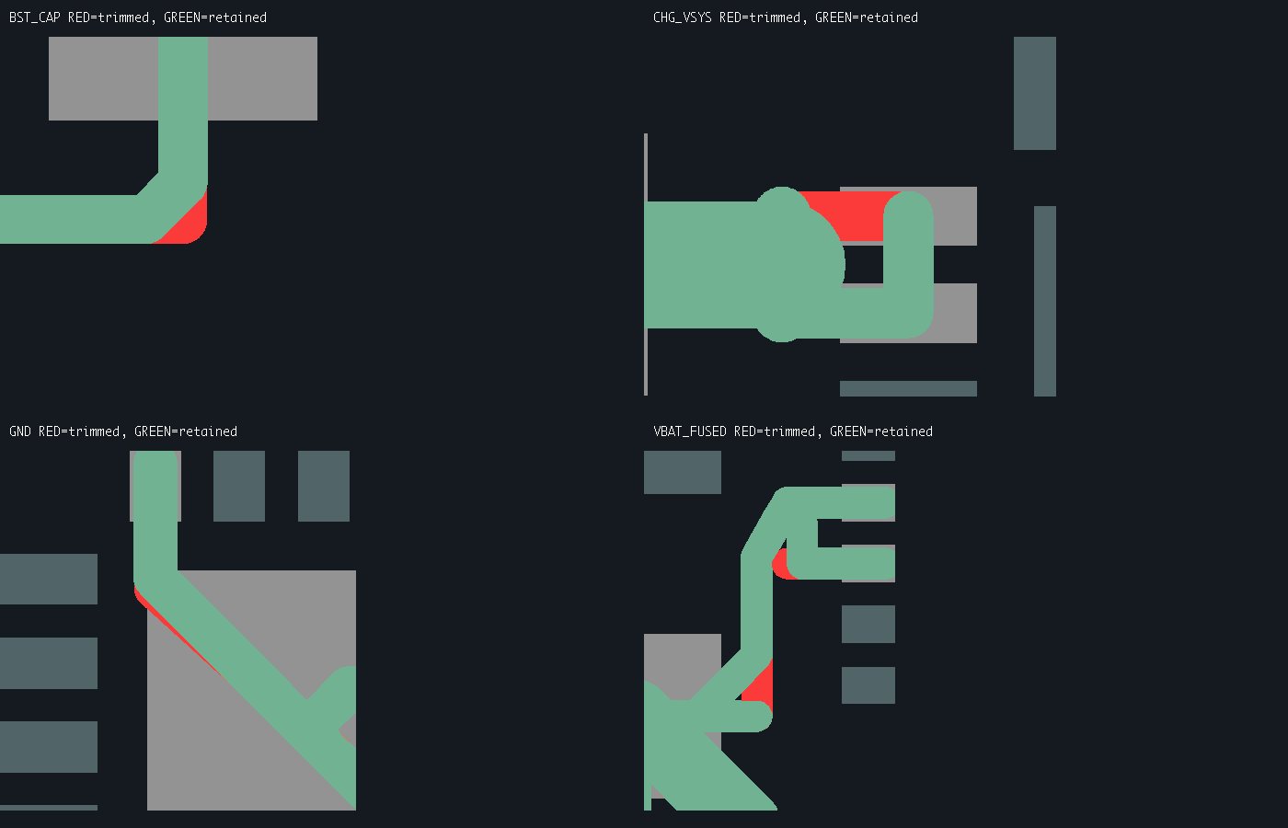
pcb-design/integrated-v1/final-2026-09-12/Critical_corner_review.png
