xaiojie/papabot/pcb-design/integrated-v1/final-2026-09-12/PCB_Gerber_Bottom.png

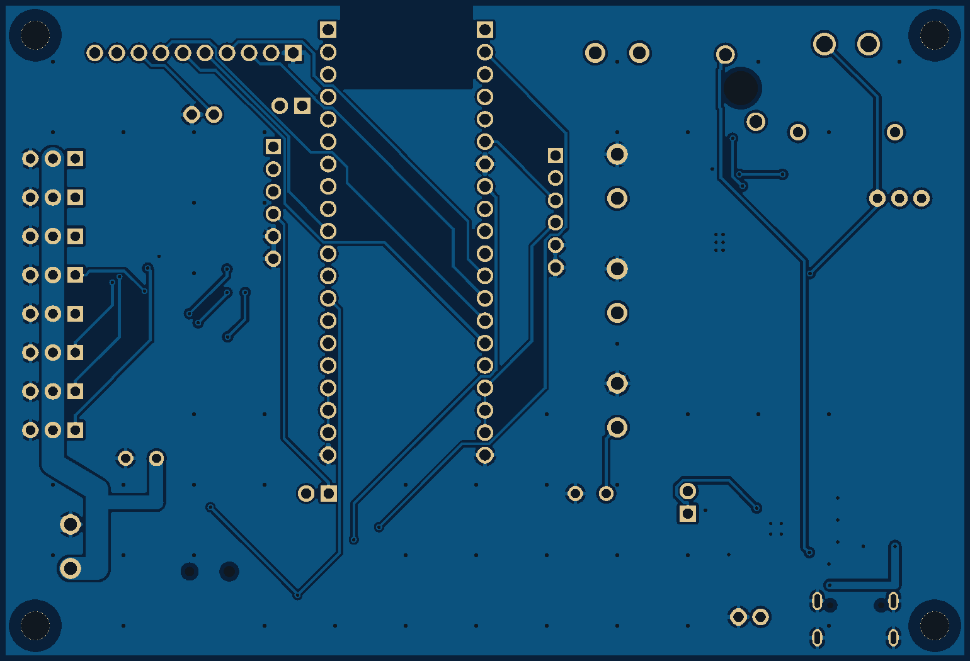
pcb-design/integrated-v1/final-2026-09-12/PCB_Gerber_Bottom.png
