xaiojie/papabot/pcb-design/integrated-v1/final-2026-09-12/PCB_native_preview.webp

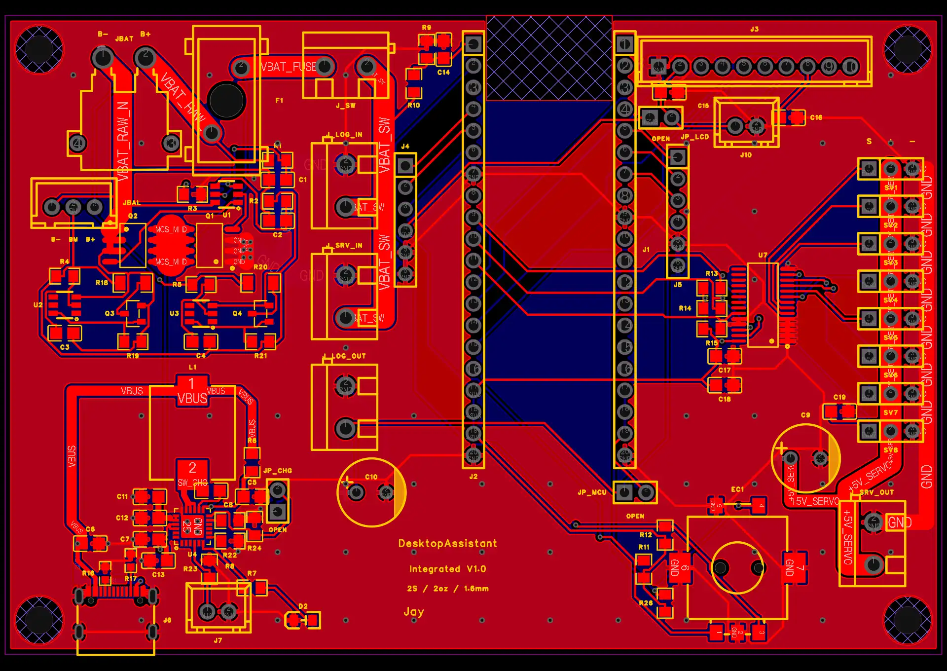
pcb-design/integrated-v1/final-2026-09-12/PCB_native_preview.webp
