xaiojie/papabot/pcb-design/integrated-v1/final-2026-09-12/Schematic_page_5.png

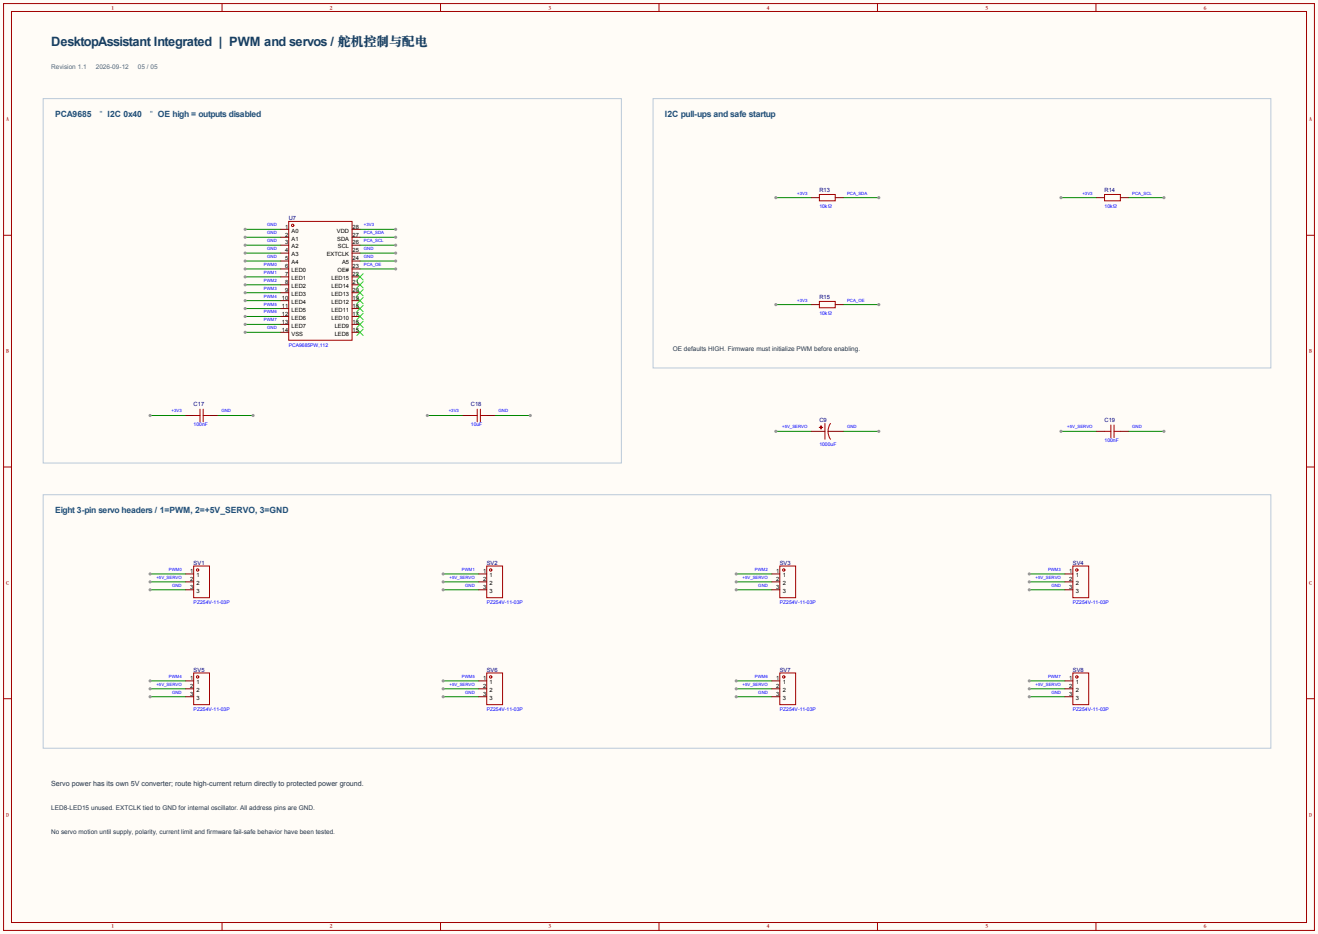
pcb-design/integrated-v1/final-2026-09-12/Schematic_page_5.png
