xaiojie/papabot/pcb-design/integrated-v1/final-no-encoder-2026-09-12/Schematic_page_3.png

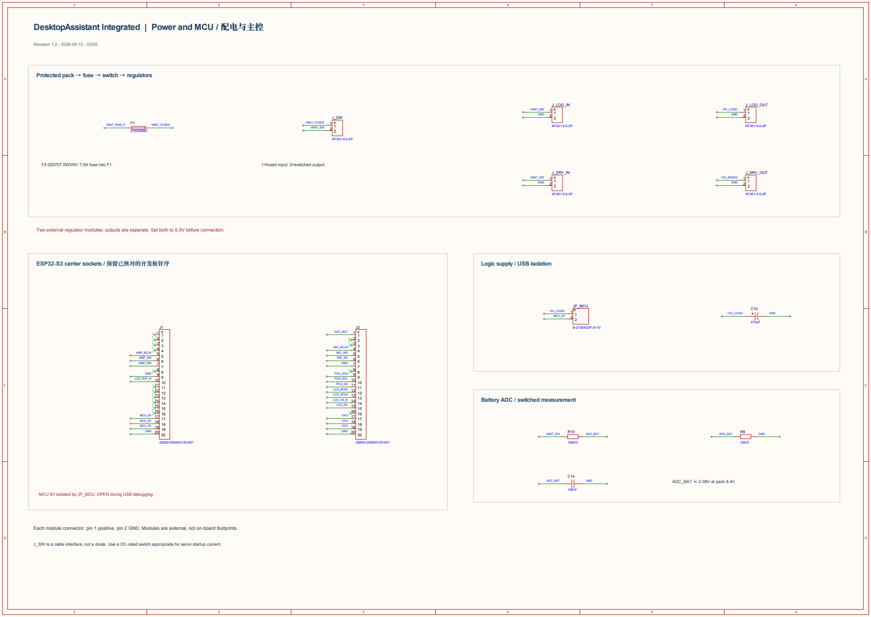
pcb-design/integrated-v1/final-no-encoder-2026-09-12/Schematic_page_3.png
