xaiojie/papabot/pcb-design/integrated-v1/layout-2026-09-12/bm-routing.png

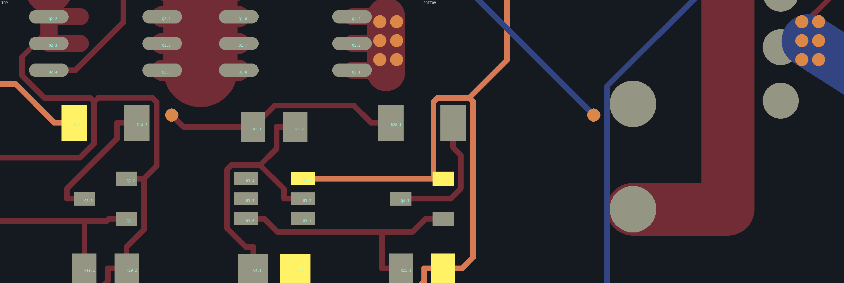
pcb-design/integrated-v1/layout-2026-09-12/bm-routing.png
