xaiojie/papabot/pcb-design/integrated-v1/no-encoder-2026-09-12/LCD_datasheet_page_13.png

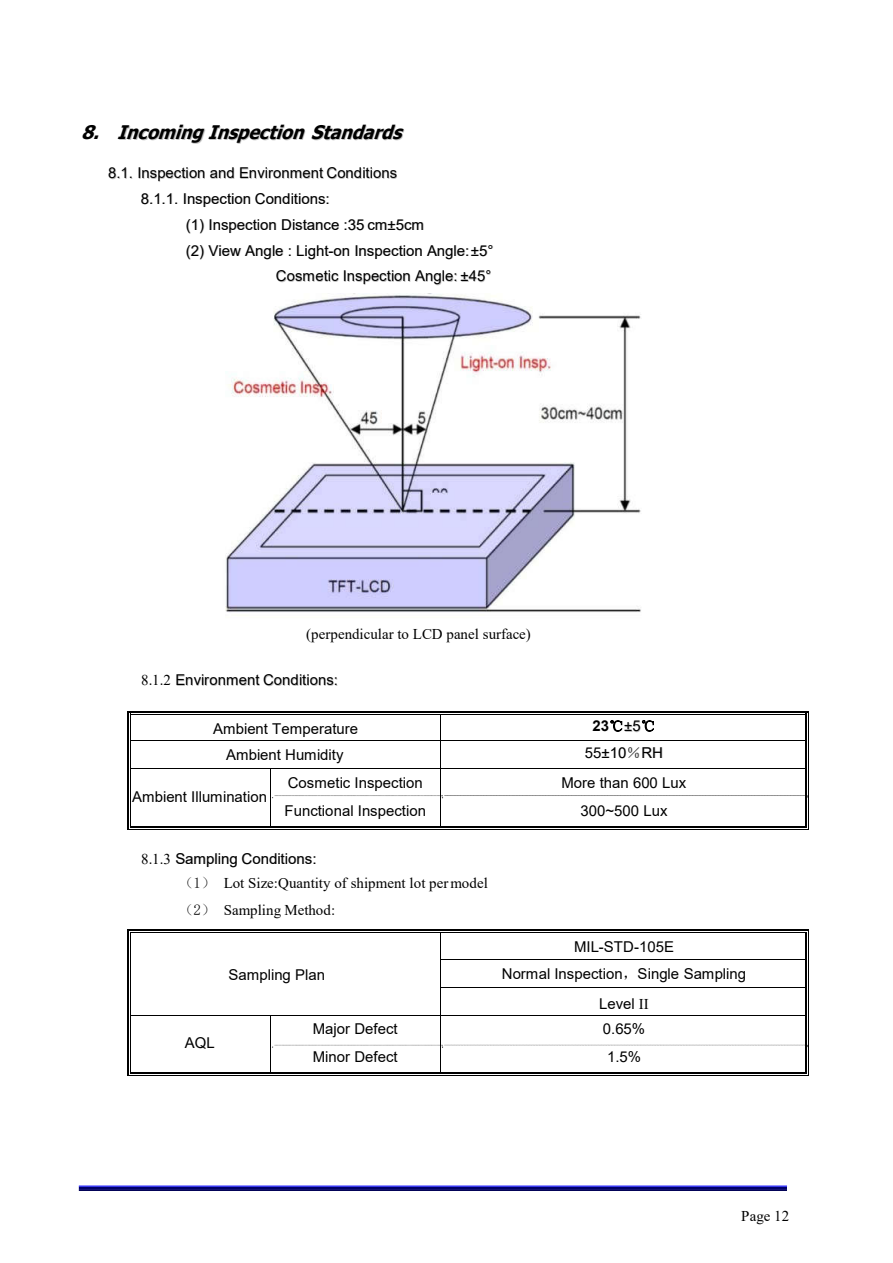
pcb-design/integrated-v1/no-encoder-2026-09-12/LCD_datasheet_page_13.png
