xaiojie/papabot/pcb-design/integrated-v1/user-latest-review-2026-09-13/User_latest_Gerber_Top.png

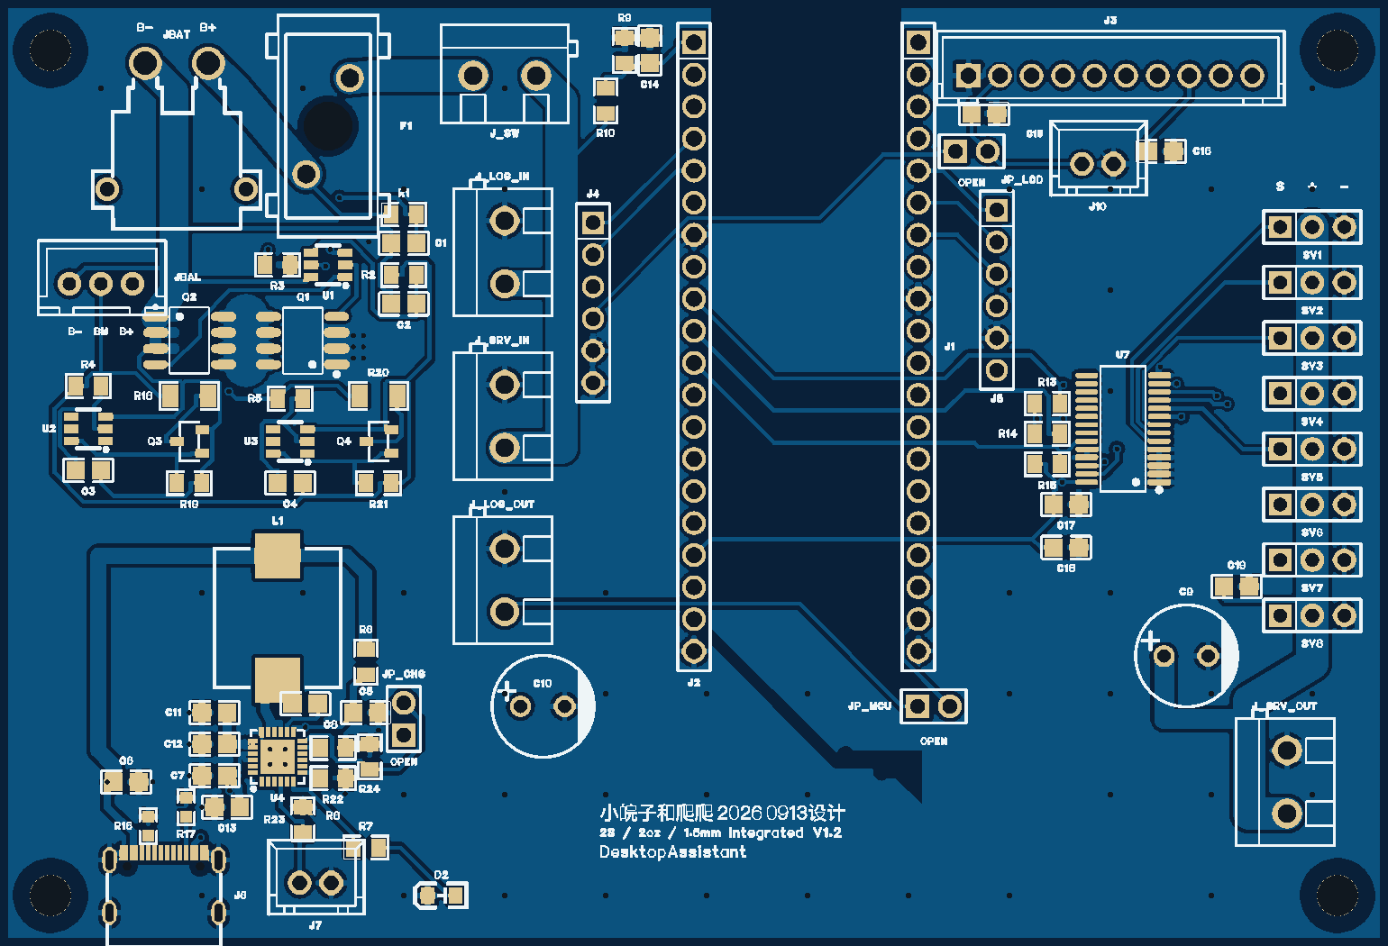
pcb-design/integrated-v1/user-latest-review-2026-09-13/User_latest_Gerber_Top.png
