xaiojie/papabot/pcb-design/integrated-v1/摆放框图.png

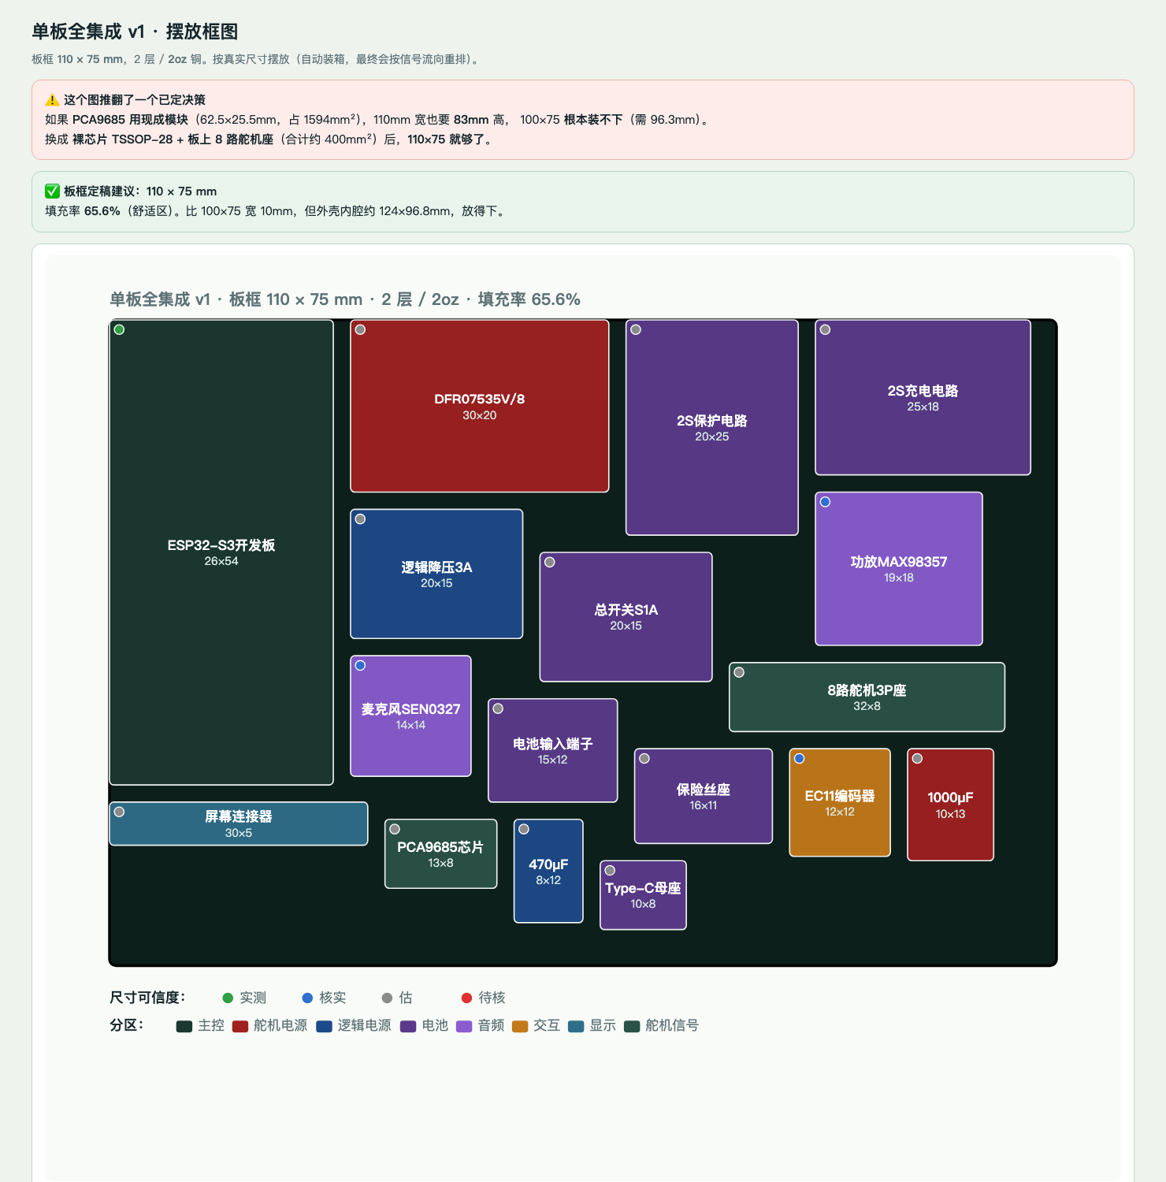
pcb-design/integrated-v1/摆放框图.png
