xaiojie/papabot/pcb-design/integrated-v1/最终摆放图.png

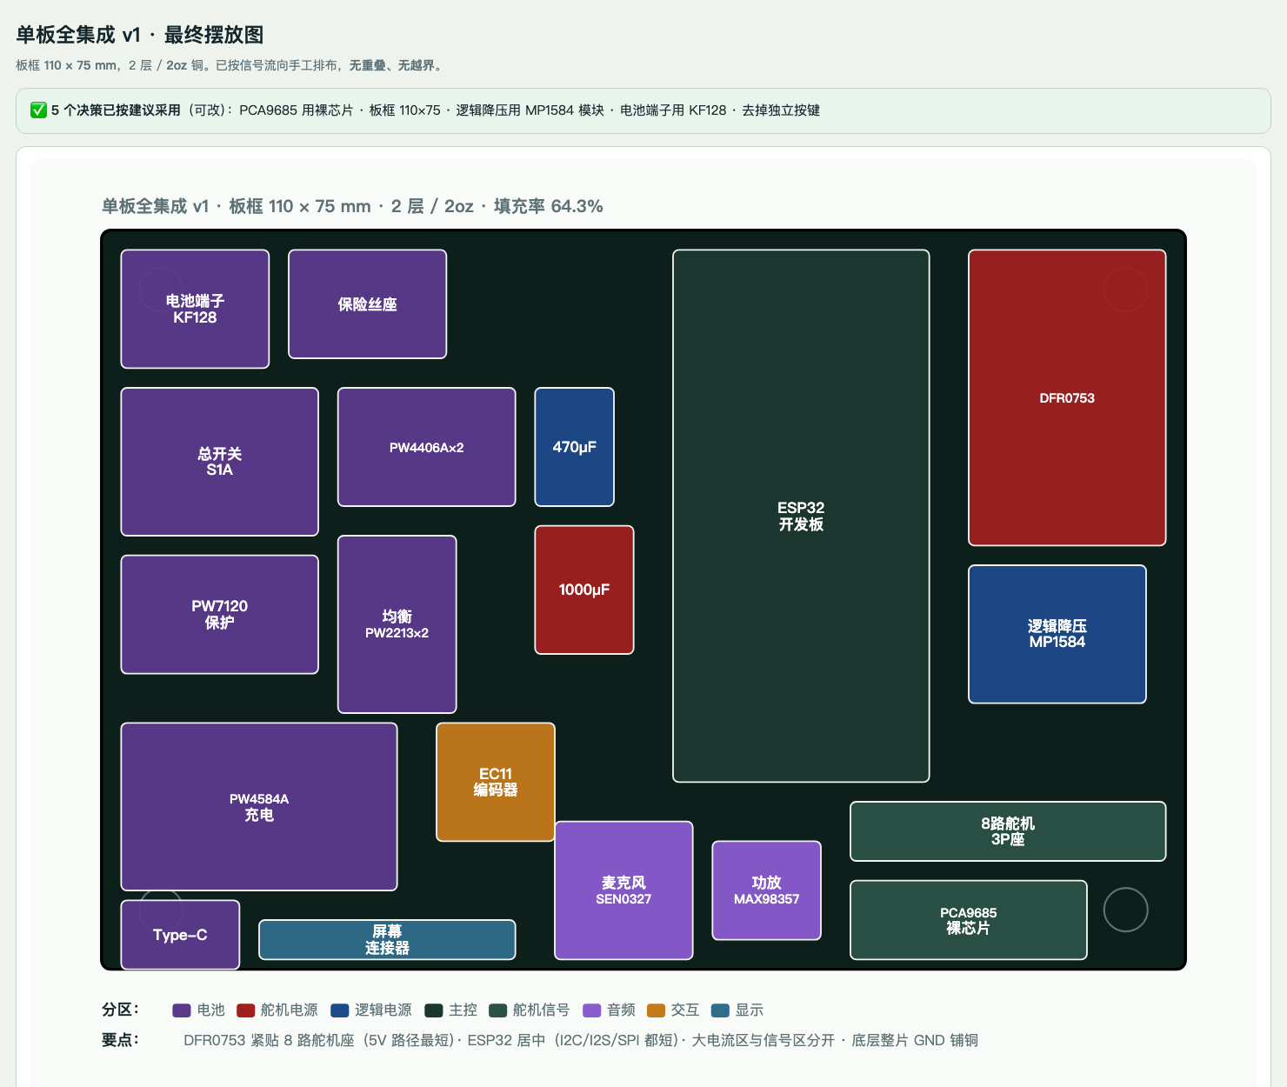
pcb-design/integrated-v1/最终摆放图.png
