xaiojie/papabot/pcb-design/integrated-v1/电源官方参考PCB.png

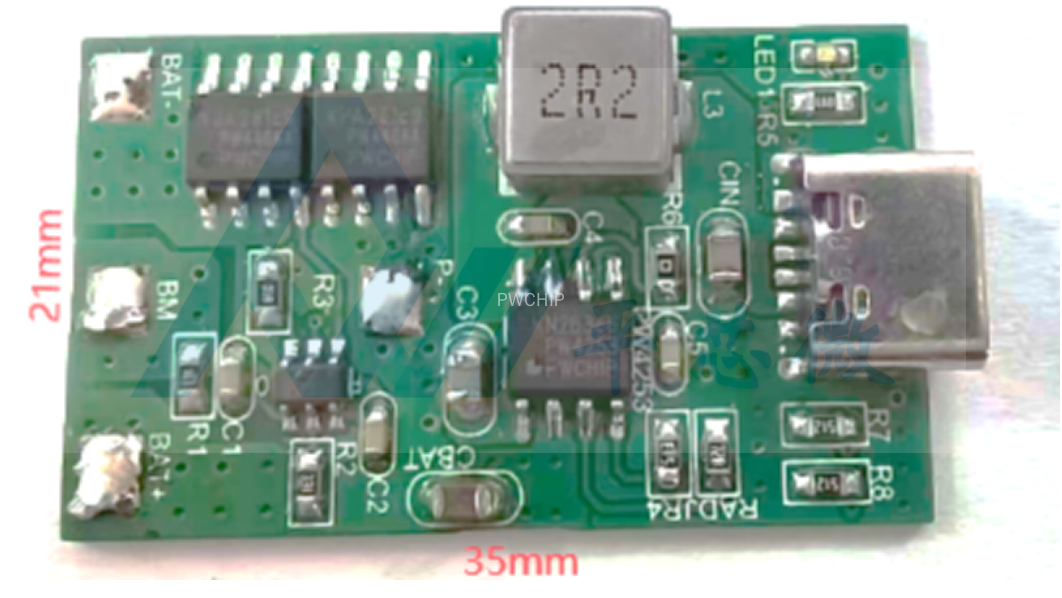
pcb-design/integrated-v1/电源官方参考PCB.png
