xaiojie/papabot/pcb-design/integrated-v1/电源官方参考PCB_PW4584A版.png

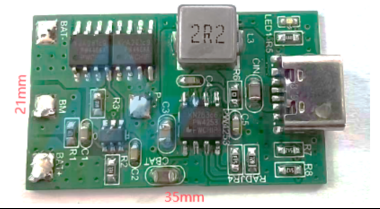
pcb-design/integrated-v1/电源官方参考PCB_PW4584A版.png
