xaiojie/papabot/pcb-design/integrated-v1/电源官方参考原理图.png

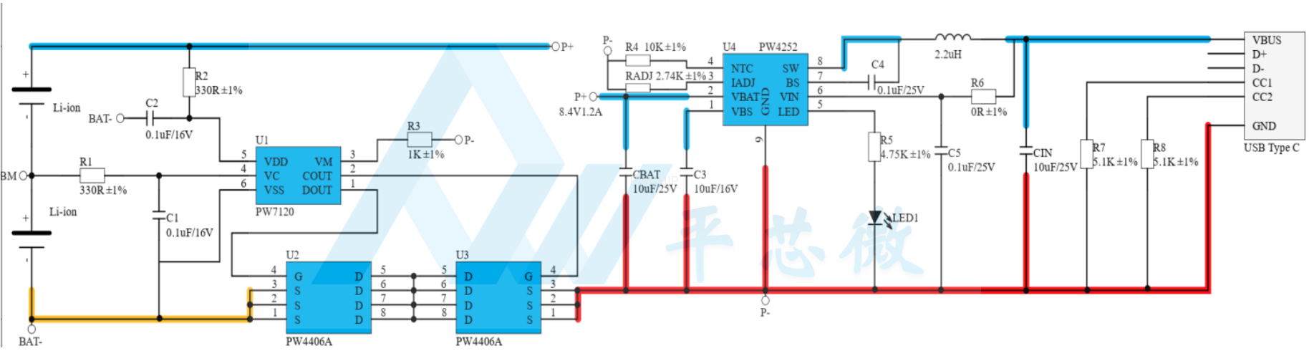
pcb-design/integrated-v1/电源官方参考原理图.png
