xaiojie/papabot/pcb-design/rev-a/board-interface.png

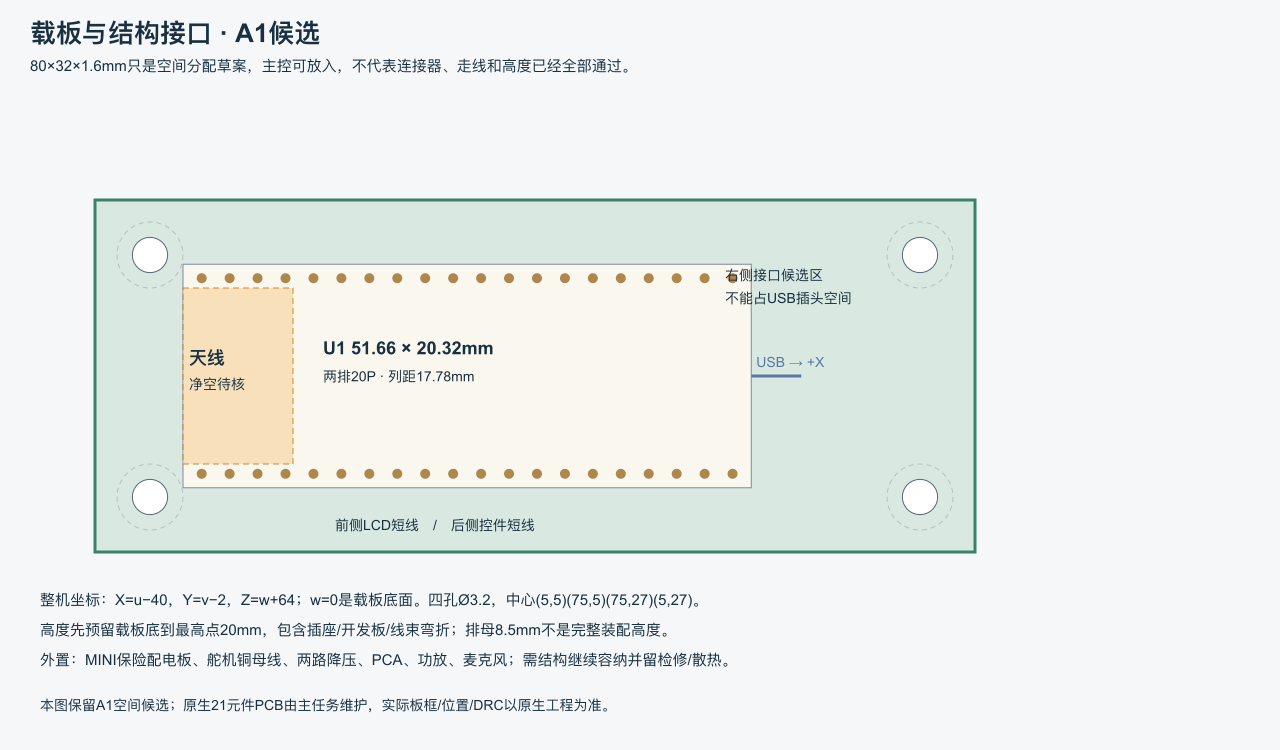
pcb-design/rev-a/board-interface.png
