xaiojie/papabot/pcb-design/rev-a/power-schematic.png

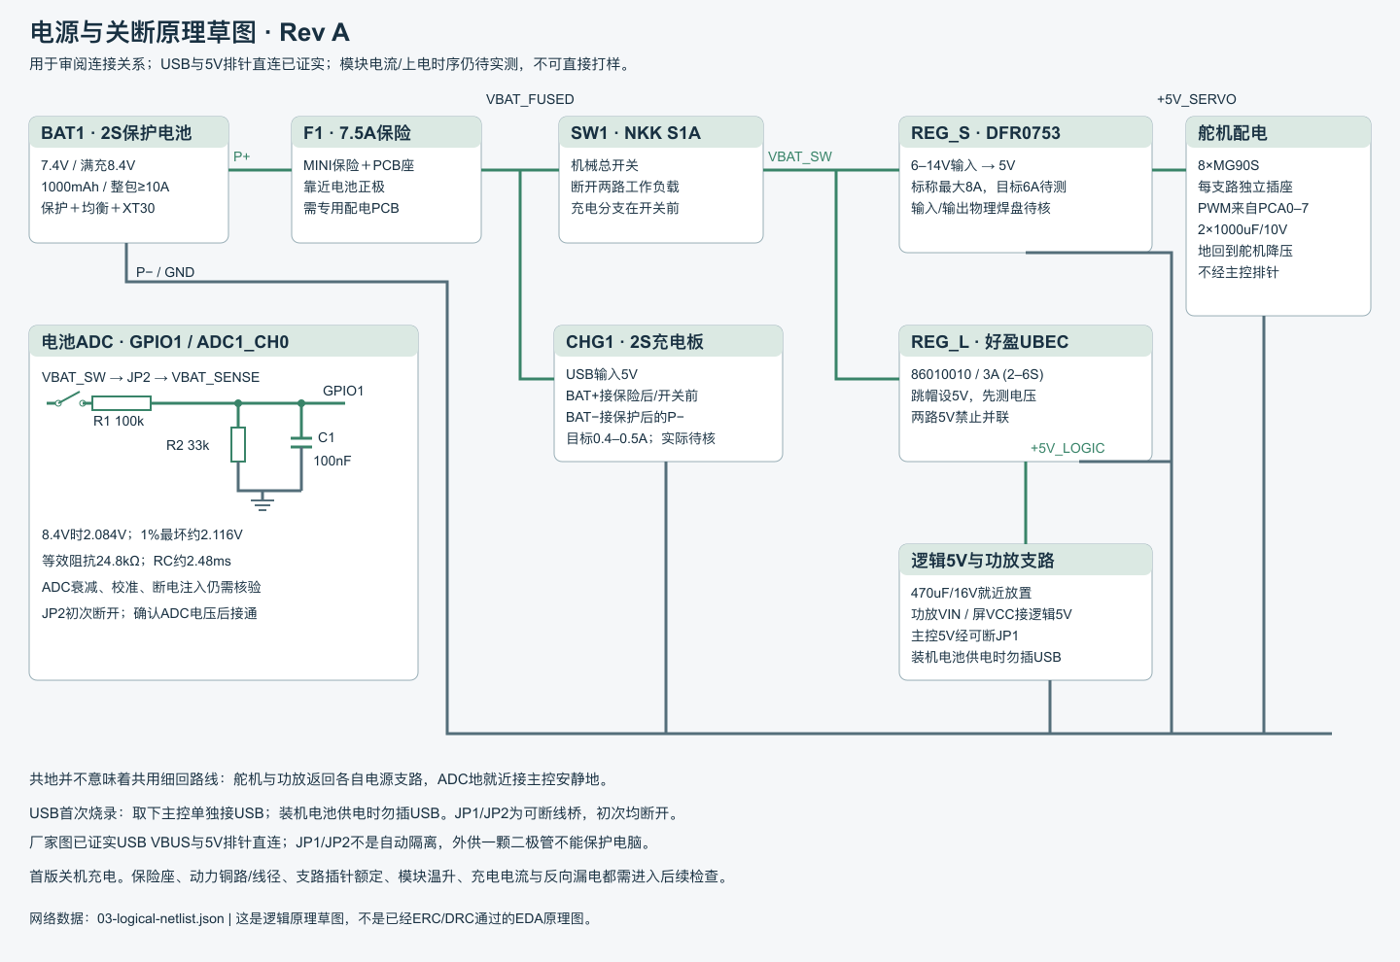
pcb-design/rev-a/power-schematic.png
