xaiojie/papabot/pcb-design/rev-a/signal-schematic.png

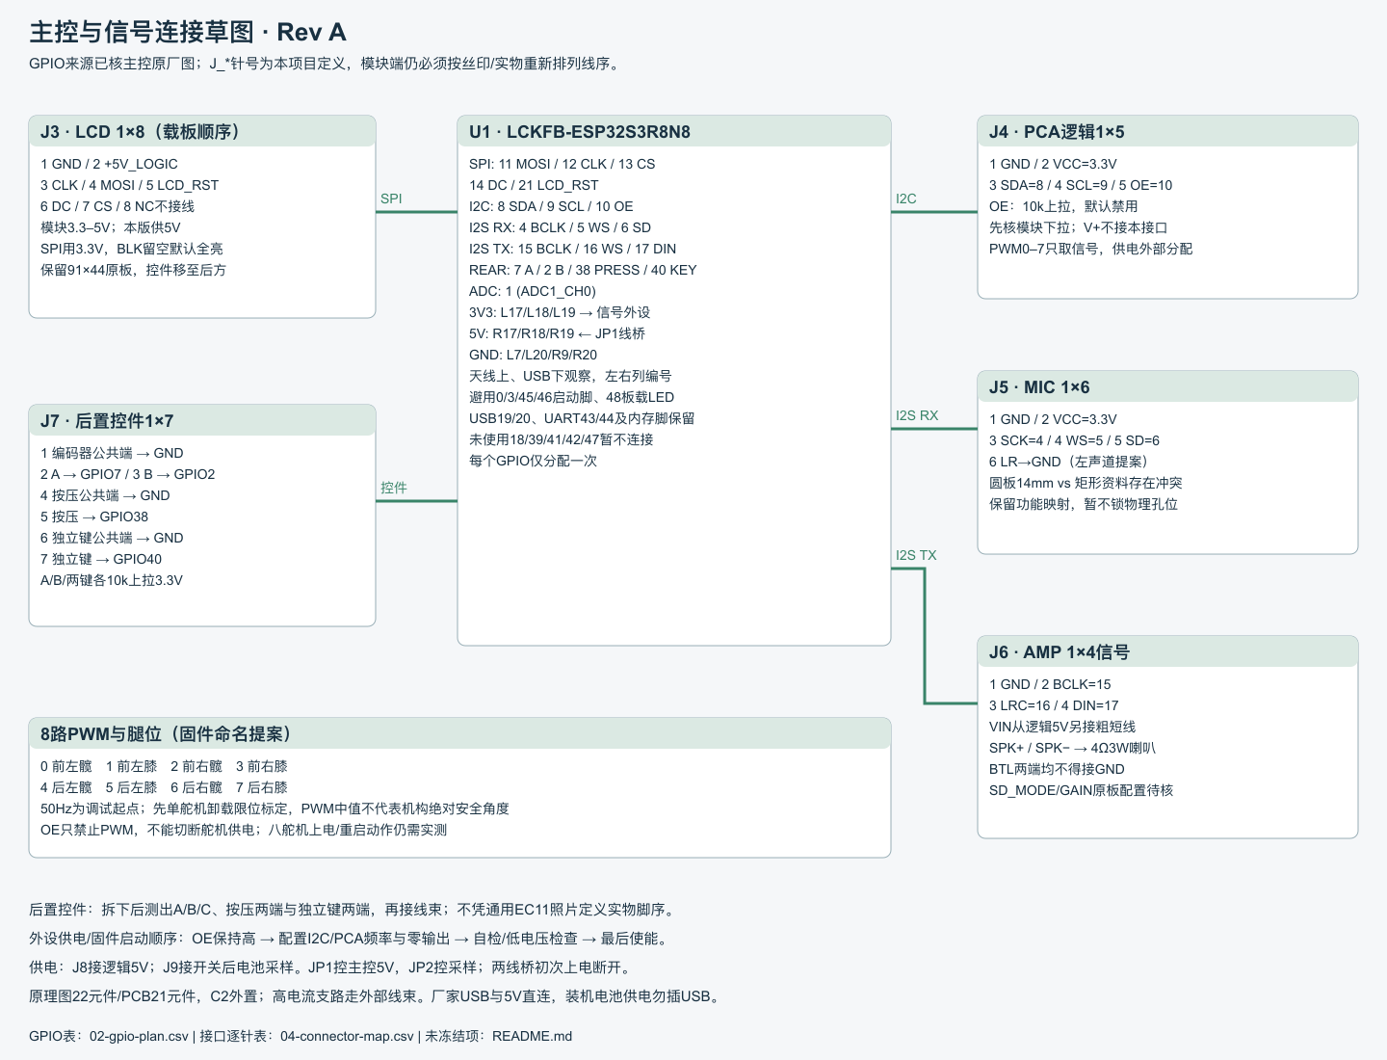
pcb-design/rev-a/signal-schematic.png
