xaiojie/papabot/pcb-design/rev-a/sources/lckfb-antenna-detail.png

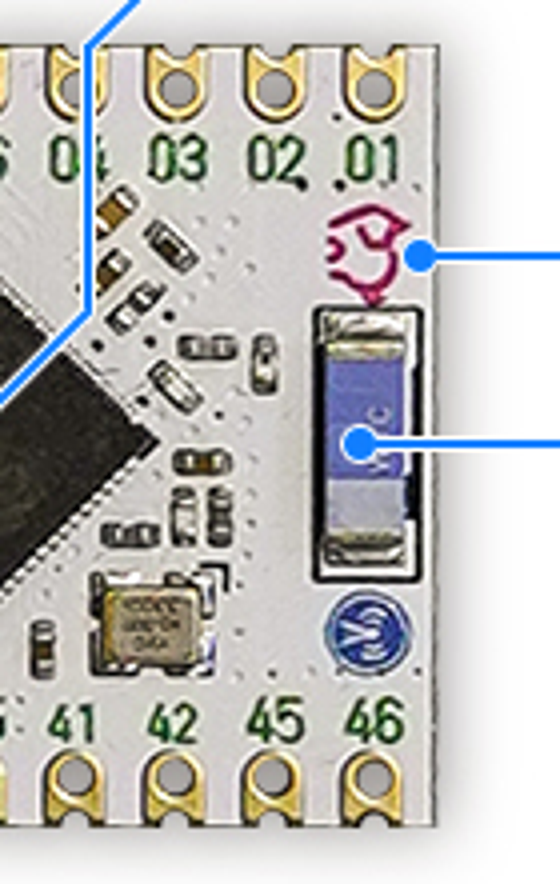
pcb-design/rev-a/sources/lckfb-antenna-detail.png
