xaiojie/papabot/pcb-design/rev-a/sources/lckfb-contact-sheet.jpg

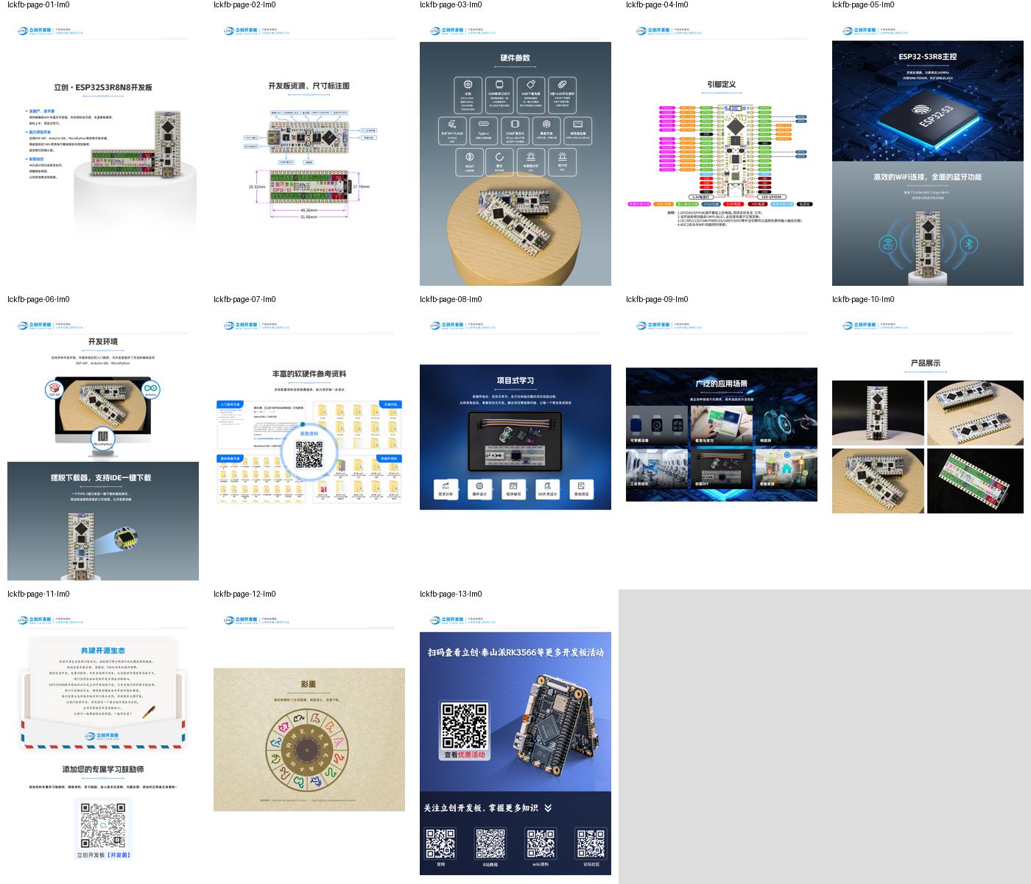
pcb-design/rev-a/sources/lckfb-contact-sheet.jpg
