xaiojie/papabot/pcb-design/rev-a/sources/lckfb-page-04-Im0.jpg

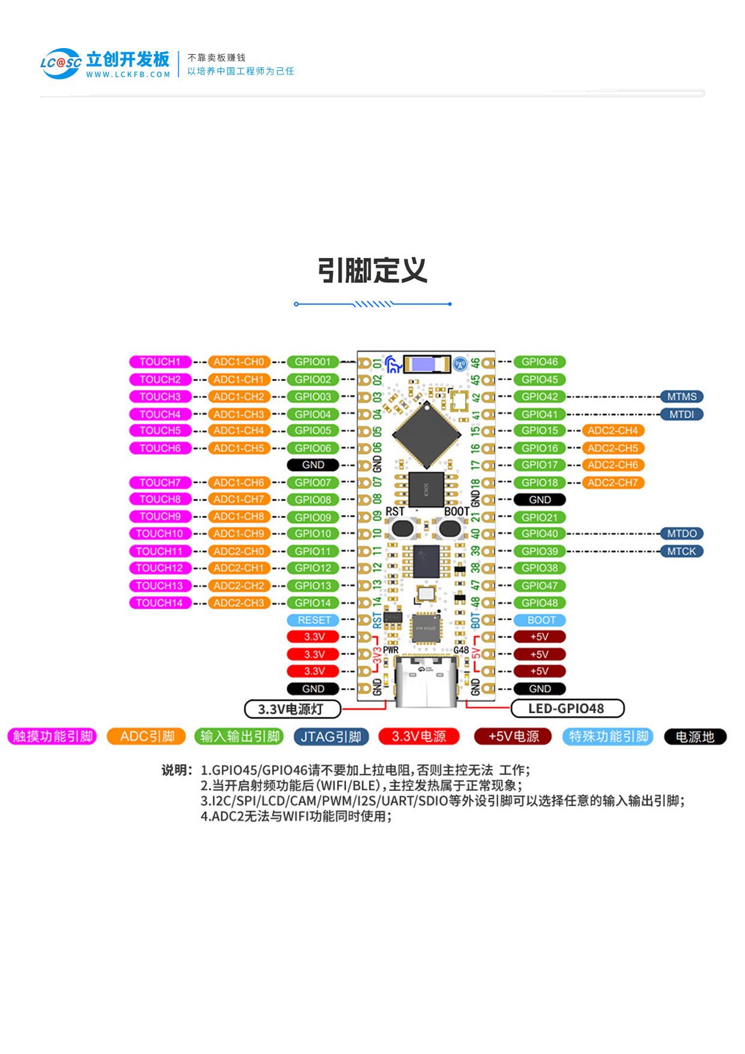
pcb-design/rev-a/sources/lckfb-page-04-Im0.jpg
