xaiojie/papabot/pcb-design/rev-a/sources/lckfb-page-06-Im0.jpg

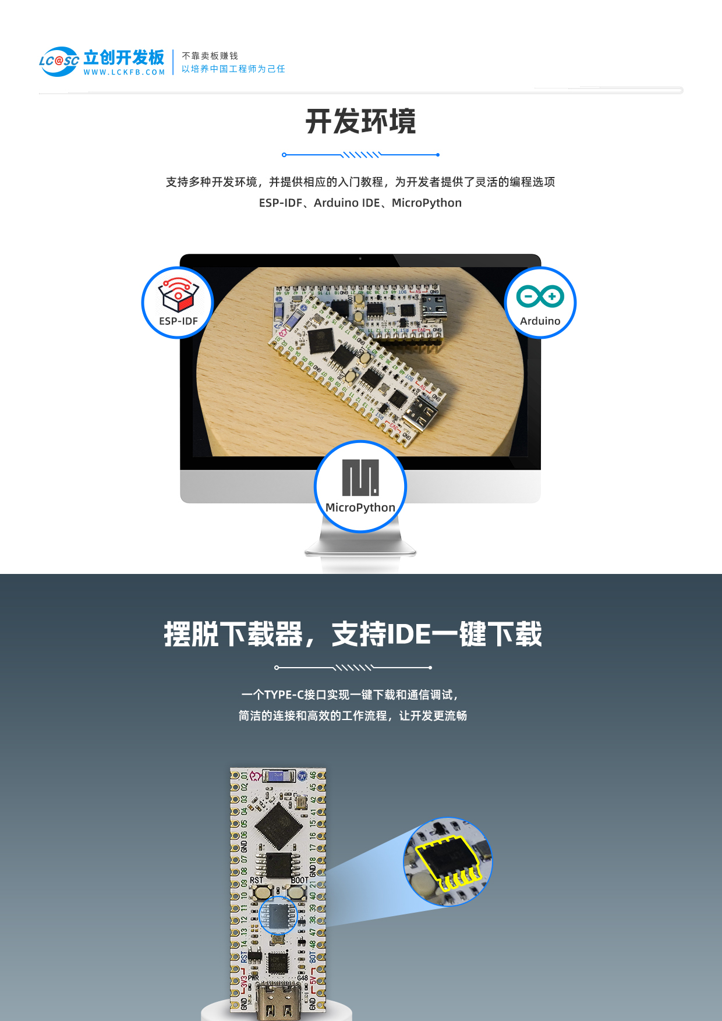
pcb-design/rev-a/sources/lckfb-page-06-Im0.jpg
