xaiojie/papabot/pcb-design/rev-a/sources/lckfb-page-10-Im0.jpg

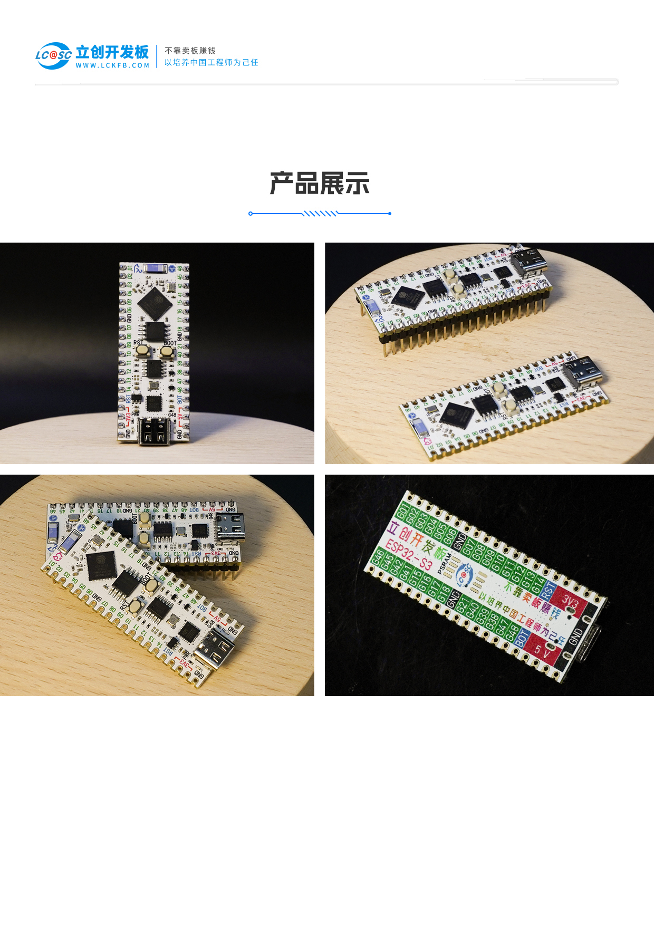
pcb-design/rev-a/sources/lckfb-page-10-Im0.jpg
