xaiojie/papabot/pcb-design/rev-a/sources/lckfb-page-11-Im0.jpg

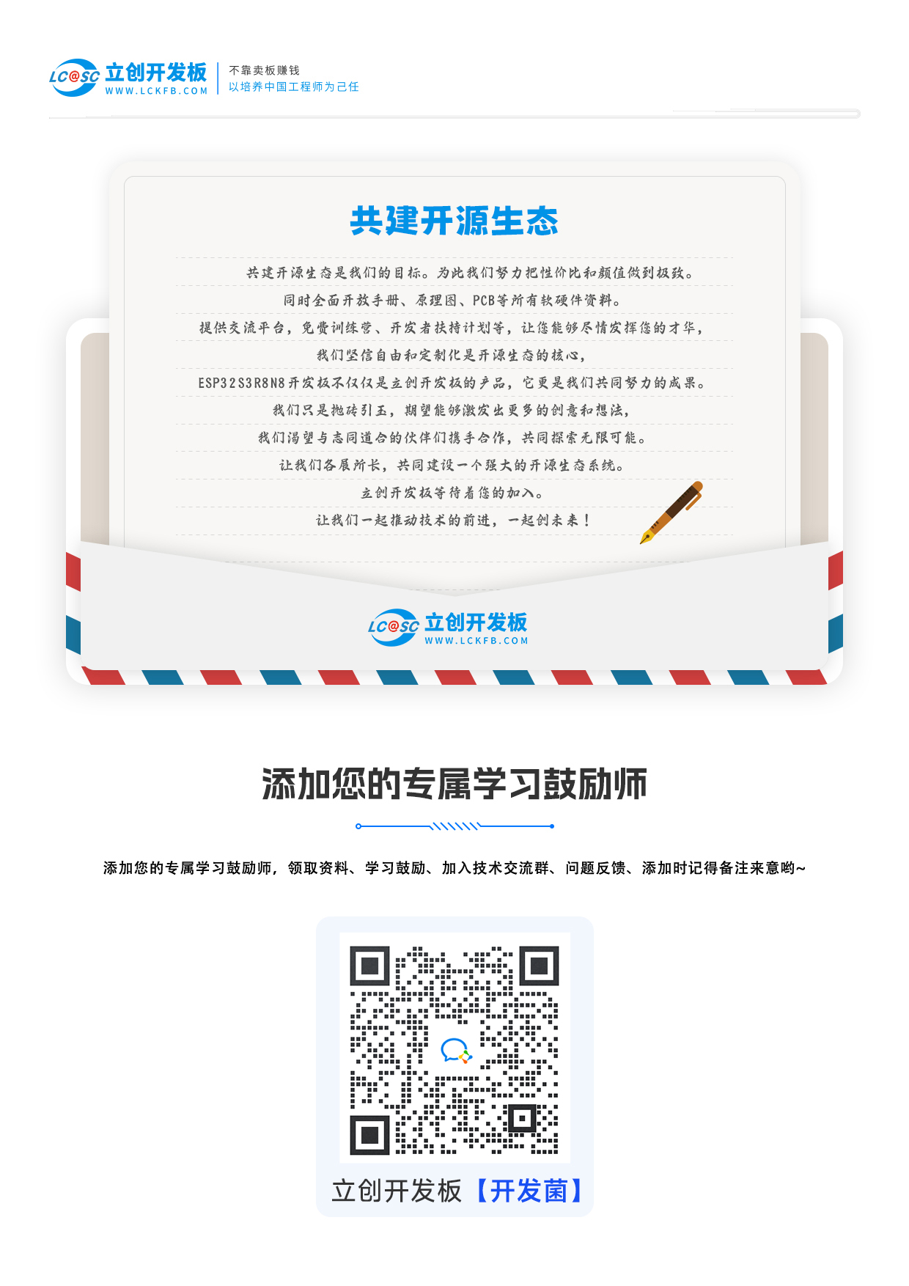
pcb-design/rev-a/sources/lckfb-page-11-Im0.jpg
