xaiojie/papabot/pcb-design/rev-a/sources/lckfb-page-12-Im0.jpg

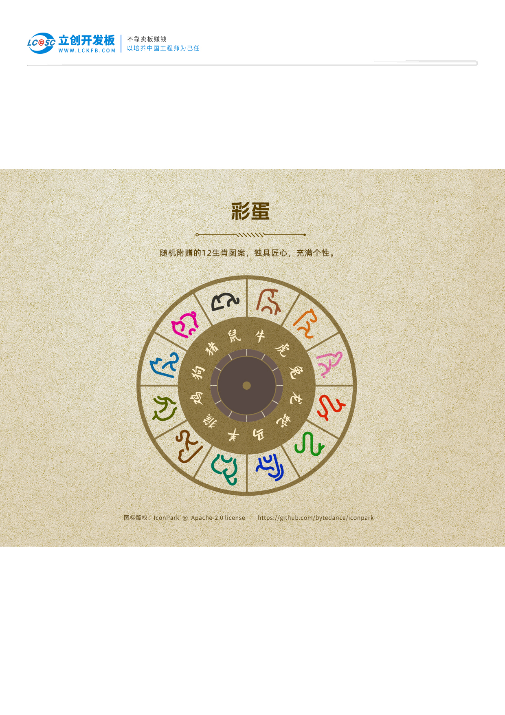
pcb-design/rev-a/sources/lckfb-page-12-Im0.jpg
