xaiojie/papabot/pcb-design/rev-a/sources/lckfb-page-13-Im0.jpg

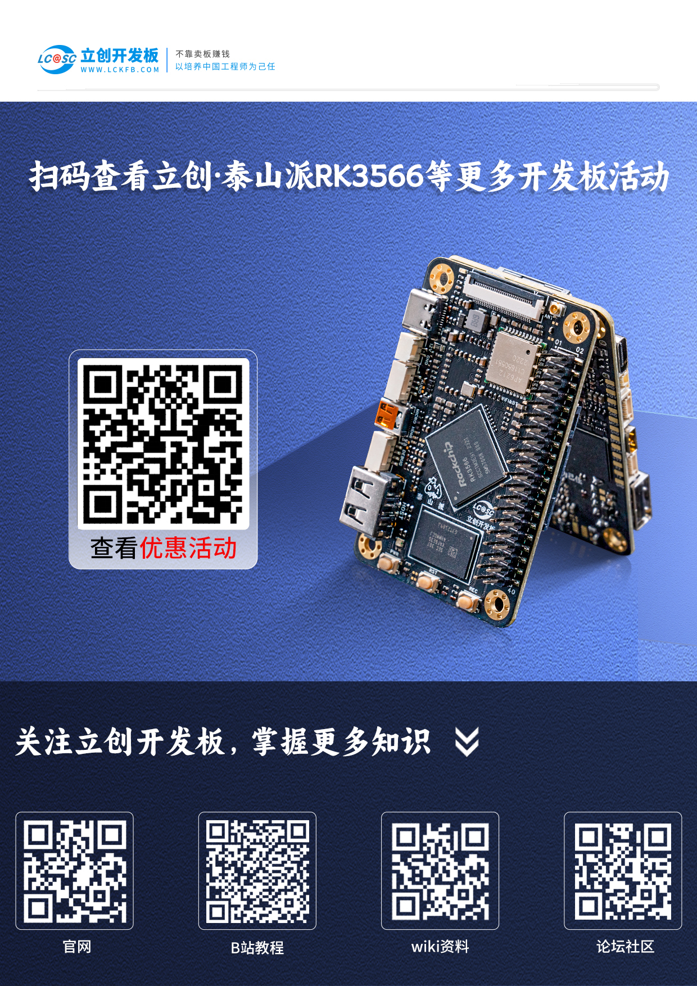
pcb-design/rev-a/sources/lckfb-page-13-Im0.jpg
