xaiojie/papabot/pcb-design/rev-a/sources/lckfb-schematic-core.jpg

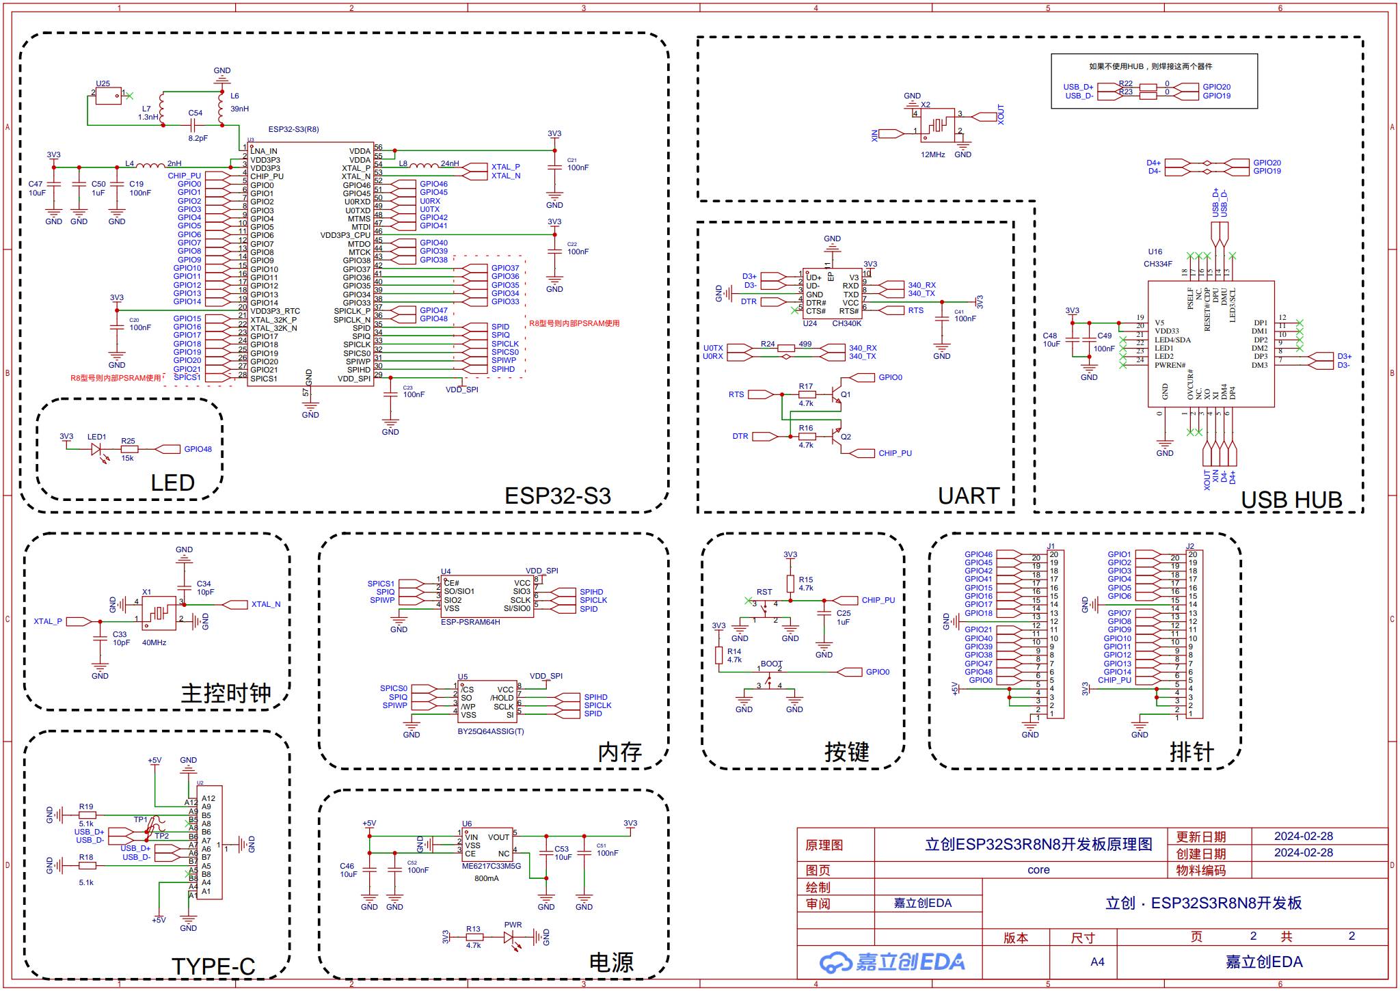
pcb-design/rev-a/sources/lckfb-schematic-core.jpg
