xaiojie/papabot/pcb-design/rev-a/sources/lckfb-schematic-cover.jpg

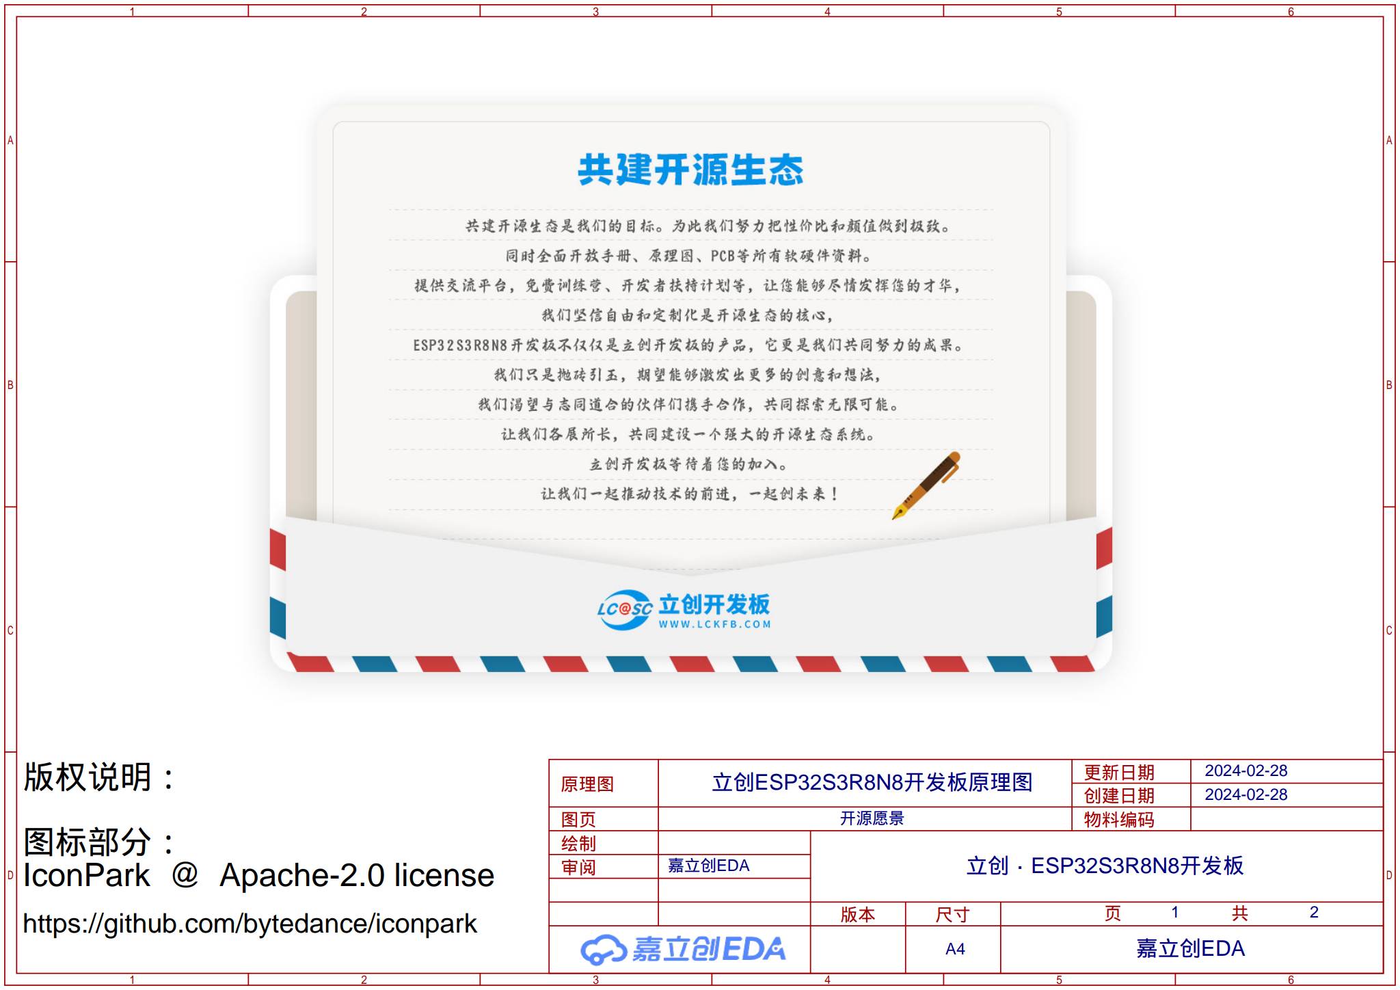
pcb-design/rev-a/sources/lckfb-schematic-cover.jpg
