xaiojie/papabot/pcb-design/revb-lettering-2026-09-10/gerber-silkscreen.png

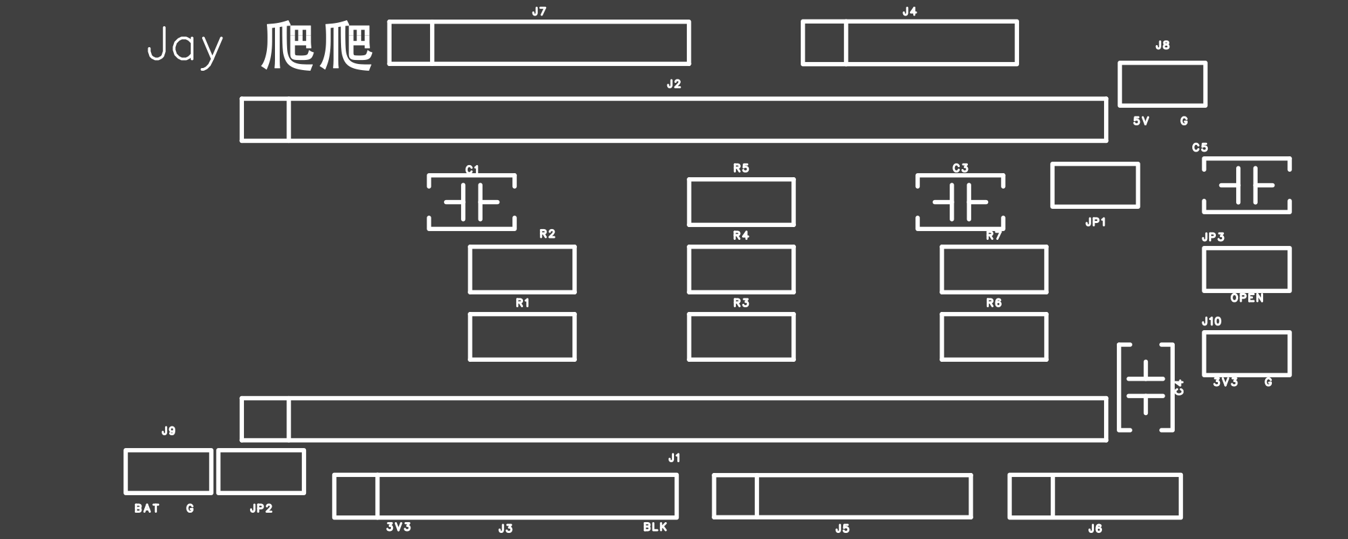
pcb-design/revb-lettering-2026-09-10/gerber-silkscreen.png
