xaiojie/papabot/pcb-design/revb-lettering-2026-09-10/gerber-top-preview.png

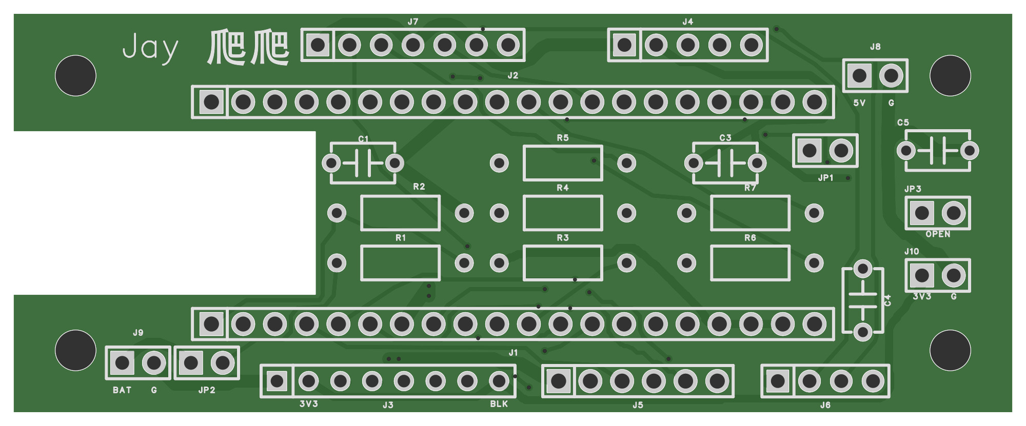
pcb-design/revb-lettering-2026-09-10/gerber-top-preview.png
