xaiojie/papabot/pcb-design/revb-lettering-2026-09-10/pcb-lettering-preview.png

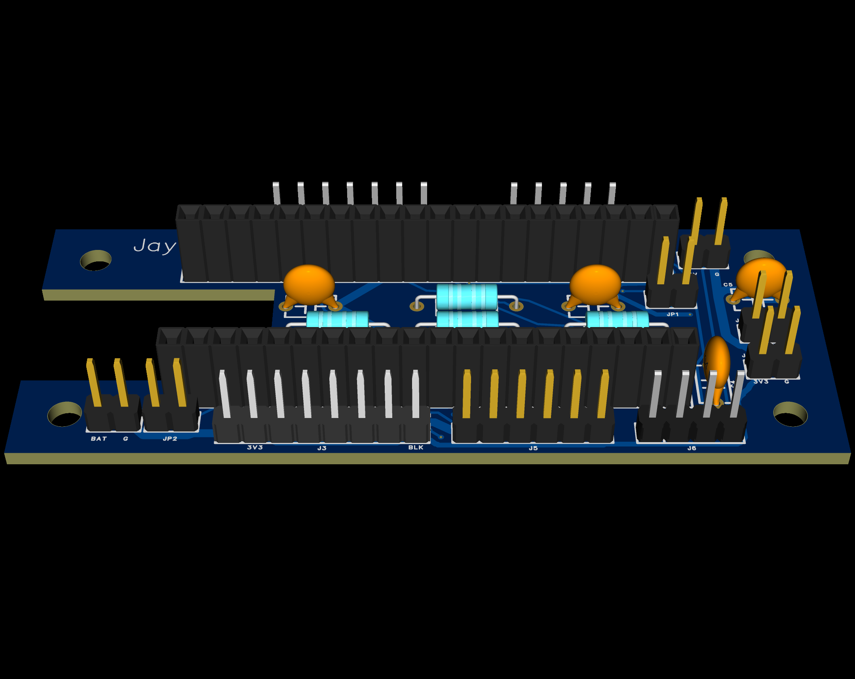
pcb-design/revb-lettering-2026-09-10/pcb-lettering-preview.png
