xaiojie/papabot/hardware-selection/bom-v7/README.md

# 桌面助手采购 V7

**2026-09-09 PCB装配补充：** [RevB装配清单](../../pcb-design/native-rev-b/载板装配清单.csv)新增1只100nF电容、JP3短导线位及J10外部3.3V输入预留；R4–R7默认不焊。外部稳压器是否需要采购取决于屏幕电流/主控稳压余量，尚未选购。本目录Excel和购物车记录保留原采购版本，接线以[RevB说明](../../pcb-design/native-rev-b/装配与上电核对.md)为准。

当前配件全部按用户要求暂定。用户反馈“锂电池总汇店”表示可以做，采购表电池行已换为此店，标记“暂定·待尺寸报价”；完整规格、尺寸重量、线材、报价及交期仍待最终回复。详情见[04 电池换店记录](04-电池换店候选.md)。原店已回复“没有”并排除，车内原店普通款勿下单；原购物车核验记录保留旧商品身份，不能当作新定制款已加购的证据。

2026-09-08，购物车11项核对后补入16个SKU，现在共27项。MG90S金属齿轮180°为8个、单价11元；其余每项1份。未下单、未联系商家。

- [00 整机核对表](00-整机配件采购核对.xlsx)：单页8列，44行覆盖原42类需求。采样/去耦小件拆为真实商品，100nF电容只计一包。此表用于核对，不用于立创导入。
- [01 立创BOM](01-立创商城-BOM导入.xlsx)：单页3列、10项；沿用已核实的C编号，与V6逐字节一致，采购套数填1。
- [02 淘宝采购表](02-淘宝天猫-采购清单.xlsx)：单页7列、27行；26行已加购常规商品，1行新店暂定电池定制入口，电池报价留空。常规商品链接为此前核对的购物车SKU，新电池入口尚未加购。
- [03 电池定制文字](03-电池定制-发给商家.txt)：可直接复制给商家，由用户沟通。目标为2S1P、7.4V、1000mAh、整包持续≥10A，含逐节保护/均衡、18AWG短引线及XT30配对件。

本轮新增参考金额89.66元。淘宝已选商品参考355.93元，不含待定制电池；加立创111.37元，已知参考合计467.30元。这是逐行展示价格汇总，单品券/首单礼金可能互斥，不能当作最终实付；运费及打样不含。车内普通电池14.70元也不计入定制电池报价。

Type-C数据/充电线按用户要求取消本次采购。PCB打样、整套3D打印及试样打印暂缓；XT30配对件并入电池定制，不另买。没有额外的产品官网采购单。

本轮补入：热缩管、双面信号试接板、镀金排针、尼龙垫柱盒、M2/M3螺母、M3平垫、硅胶脚垫、电池束带、扎带、EVA泡棉、绿联17W USB-A充电头，以及100kΩ/33kΩ/10kΩ电阻和100nF电容。采购表区分“1包”和“装机用量”；少量商品固定袋装数量高于单机需要，余件备用，不意味着新增整机数量。

电路小件是直插原型器件，尚未冻结最终PCB封装。分压初选100kΩ上臂+33kΩ下臂，8.4V约为2.08V，100nF作RC；上臂从工作开关后的电池母线取电，ADC采样及衰减/校准随固件确定。OE拟用10kΩ上拉3.3V，先核实所购PCA板是否有下拉/接地连接再接线。现有模块自带的去耦/排针优先复用，不盲目增加电平转换器。

绿联CD104已核商品图：17W双口，输出固定5V，单口2.4A、总3.4A，选裸头。充电板实际恒流仍未核定；首次充电前必须确认不超电池上限，必要时按该板资料改设0.4～0.5A。首版关机充电；保护板带均衡不代表在任意充电电流下都能即时平衡。

8舵机的总电流走专门配电，不能集中通过一根杜邦线、一个排针接点或洞洞板细焊盘。两路降压共地，5V输出不并联；喇叭两端为BTL输出，都不接地。电池≥10A是采购目标，8舵机启动/堵转、保险丝、降压温升和低电量压降仍需实测。

EVA条用于电池缓冲和麦克风周围的环形密封，中心留通孔，不将不透声泡棉贴住拾音孔。尼龙垫柱、螺母和脚垫先供试装，最终结构按到货件测量。未改Blender、PCB或打印文件。

核验记录：[购物车](evidence/taobao-cart-audit.json)、[立创原匹配记录](evidence/lcsc-match-audit.json)、[Excel核验](validation.json)。旧V1–V6归档保留，当前采购请用V7。
