xaiojie/papabot/采购清单-20260912/立创报价单-20260913/README.md

# 立创商城 BOM 报价单 · 2026-09-13

> 用户在立创商城实际配单后的报价单，已归档。
> 对应设计：**Integrated V1.2 无旋钮版**

---

## 一、报价单信息

| 项目 | 值 |
|---|---|
| **BOM 配单编号** | `BOM260913000033` |
| **BOM 名称** | 立创商城-一键下单 |
| **上传时间** | 2026-09-13 00:42:30 |
| **采购套数** | 1 |
| **商品总价** | **¥230.88** |
| 原价 | ¥246.43 |
| **折扣** | **-¥15.55** |
| 询价网址 | https://bom.szlcsc.com/bom.html |

> 📌 立创提示：**匹配结果为实时查询，库存和价格会波动。超过 24 小时请重新匹配再下单。**

---

## 二、✅ 结果：全部通过

| 检查 | 结果 |
|---|---|
| 项数 | **41 项**（与我们的清单完全一致 ✓）|
| 匹配结果 | **41/41 系统匹配** ✓ |
| 渠道 | **41/41 现货** ✓ |
| 交期 | **全部「4 小时内发货」** ✓ |
| 无法匹配 | 0 |
| 待确认 | 0 |

**五轮换型全部生效了 —— 立创那边一项都没卡。**

---

## 三、💰 费用构成（按金额排序）

| 金额 | 占比 | 型号 | 买 | 实际需要 |
|---|---|---|---|---|
| **¥34.37** | 14.3% | **HS24S010B** 屏幕 | 1 | 1 |
| **¥24.35** | 10.1% | **01530008Z** 保险丝座 | 1 | 1 |
| ¥17.66 | 7.3% | PCA9685PW,118 | 1 | 1 |
| ¥15.35 | 6.4% | 74437368022 电感 | 1 | 1 |
| ¥15.34 | 6.4% | GRM21BR61H106KE43L 10µF | 10 | 6 |
| ¥10.28 | 4.3% | CL21A226MAYNNNE 22µF | 10 | 2 |
| ¥7.39 | 3.1% | HY2120-CB | 5 | 1 |
| ¥6.15 | 2.6% | XH-3A | 50 | 1 |
| ¥5.72 | 2.4% | PZ254V-11-03P 舵机排针 | 50 | 8 |
| ¥5.31 | 2.2% | ESP32 插座 | 5 | 2 |
| 其余 31 项 | 39.0% | — | — | — |

---

## 四、⚠️ MOQ（最小起订量）导致的超买

**立创的电阻电容 MOQ 普遍是 100 只**，所以实际买到的远超需求：

| 类型 | MOQ | 需要 | 实际买 | 多出 |
|---|---|---|---|---|
| 0805 电阻 | 100 | 1–4 | 100 | **25–100 倍** |
| 0603 电阻 | 100 | 2 | 100 | 50 倍 |
| 0805 电容 | 20 | 9 | 20 | 2.2 倍 |
| XH 胶壳 | 50 | 1–2 | 50 | **25–50 倍** |
| 舵机排针 | 50 | 8 | 50 | 6 倍 |
| 跳线帽 | 50 | 5 | 50 | 10 倍 |
| LED | 50 | 1 | 50 | 50 倍 |

**这是立创的正常规则，不是问题** —— 余料留着以后用。总花费仍然很低（阻容合计才¥20 左右）。

---

## 五、🔍 两个值得考虑优化的项

### ① 保险丝座 ¥24.35 —— 占 10%，偏贵

```
01530008Z  Littelfuse(美国力特)  插件  库存 417   ¥24.35
```

**这是进口 Littelfuse 的正品价。** 国产同规格（Mini Blade 座）淘宝只要 ¥1–3。

**要省的话**：
- 立创搜 `保险丝座 小号 直插` 找国产替代
- 或淘宝买（几块钱）

**但注意**：保险丝座涉及电池主回路安全，**别买杂牌**。

### ② 电感 ¥15.35 —— 进口 Würth

```
74437368022  Wurth(伍尔特)  2.2µH 28A  ¥15.35
```

**这颗是德国伍尔特的高电流电感**，¥15.35 是合理价。
**但 2.2µH / 28A 这个规格国产也有** —— 如果想省可以找国产替代（¥3–6）。

**不过它是 IP2326 升压充电的关键器件**，换之前要核对饱和电流和 DCR。

---

## 六、📊 对比我们之前的估算

| | 金额 |
|---|---|
| 我之前的估算 | 「约 ¥289 + 立创 + 电池」 |
| **立创实际报价** | **¥230.88** |

**立创部分实际 ¥230.88，比预估低** ✓

---

## 七、📁 本目录文件

| 文件 | 内容 |
|---|---|
| `立创商城BOM报价单-BOM260913000033.xls` | **原始文件**（立创导出）|
| `报价明细.csv` | 转成 CSV，41 行全部字段 |
| `报价明细.json` | 同上，程序可读 |

**CSV 字段：**
```
立创编号 / 需要数量 / 购买数量 / 型号 / 品牌 / 封装 / 商品名称
MOQ / MPQ / 库存 / 单价 / 小计 / 匹配结果 / 渠道 / 交期 / 链接
```

---

## 八、下一步

```
1. ⏰ 24 小时内下单（不然库存价格要重新匹配）
2. 手动加 2 样 MRO：
     • XT30 母头
     • 小号插片保险丝 7.5A
3. 淘宝买 R6（500mΩ 采样电阻）
4. 同一个立创账号下 PCB 打样 + SMT 贴片
```
