xaiojie/papabot/mechanical-design/STL零件与缺项清单.md

# STL零件与整机装配核对（A3）

2026-09-08更新：机械目录内共75个STL文件，其中 **30个是当前A3整机件**。其余是A2、A1和试配片的历史文件。

当前统一使用[structure-a3/stl-complete](structure-a3/stl-complete)，每个文件打印1件。逐件用途、尺寸见[A3零件清单](structure-a3/零件清单.md)。

| 部分 | 当前件数 | 内容 |
|---|---:|---|
| 外壳、盖板和基础支撑 | 6 | R01主壳、R02深可拆前盖、R03后盖、R04屏幕框、R05底盘/电池托架、R06主控架 |
| 四条腿 | 12 | 每腿L101髋座、L102上腿/膝座、L104下腿/脚掌各1 |
| 音频固定 | 2 | R11喇叭压圈、R14麦克风架；功放座集成在R03 |
| 充电、PWM与电源固定 | 6 | R09充电托架、R10压条2件、R16 PCA架、R17/R18电源架 |
| 小耳朵及固定垫 | 4 | R12左右耳、R13左右内侧垫 |
| 合计 | 30 | 电子件、金属紧固件和原装舵盘不计打印件 |

用户已确认按旧V1：屏幕竖直正对前方，内凹约20.8mm；旋钮和按键留在原板，藏在前盖内。R07/R08后置压片因此取消，编号不连续不代表缺件。前盖集成内井与导声管，用4颗M3×30固定；底盘前固定点已移到主壳。

当前所需结构均已建模或集成。仍待做实物复测、切片试打、线束与承载/步态验证；旋钮原位总高度尤其需核对，商品图15mm仅为轴长。螺丝长度与M2螺母差额见[装配说明](structure-a3/装配与打印说明.md)。

[原12个STL历史清单](STL零件与缺项清单-历史A1.md)保留供追溯。V1/A1/A2与A3不要混打。
