xaiojie/papabot/采购清单-20260912/最新BOM总表.md

# 桌面助手 · 最新 BOM 总表

> **对应设计**：`pcb-design/integrated-v1/final-no-encoder-2026-09-12/`
> **Integrated V1.2 无旋钮版** · 79 器件 / 310 引脚 / 59 网络 / 110×75mm 双层板
> **屏幕**：汉昇 HS24S010B（立创 C5329587）—— 不带旋钮和按钮
> 更新：2026-09-12

---

# 一、立创商城（⭐ 一键下单，41 项）

**文件：`立创商城-一键下单.csv`** —— 登录立创商城 → BOM 配单 → 上传

> ## ✅ 已实际配单并拿到报价（2026-09-13）
>
> ```
> BOM配单编号  BOM260913000033
> 商品总价     ¥230.88（原价 ¥246.43，折扣 -¥15.55）
> 结果         41/41 系统匹配 ✅   41/41 现货 ✅   全部 4 小时内发货
> ```
> **详见 `立创报价单-20260913/`**
>
> ⏰ 立创提示：**报价 24 小时内有效**，超时要重新匹配

## 板载元件（35 种 / 79 器件）

| # | 立创编号 | 型号 | 规格 | 数量 | 位号 |
|---|---|---|---|---|---|
| 1 | `C116509` | HY2120-CB | 2S 保护 IC | 1 | U1 |
| 2 | `C113632` | HY2213-BB3A | 均衡 IC | 2 | U2 U3 |
| 3 | `C2832094` | IP2326 | 2S 升压充电 IC | 1 | U4 |
| 4 | `C2678753` | **PCA9685PW,118** | 16 路 PWM 驱动 | 1 | U7 |
| 5 | `C5155212` | AO4406 | 双 N-MOS SOP-8 | 2 | Q1 Q2 |
| 6 | `C20917` | AO3400A | N-MOS SOT-23 | 2 | Q3 Q4 |
| 7 | `C429947` | 22850120ANG1SYA01 | **ESP32 插座 1×20P** | 2 | J1 J2 |
| 8 | `C431092` | XT30PW-M30.G.Y | **XT30 电池接口** | 1 | JBAT |
| 9 | `C206907` | 01530008Z | **保险丝座**（小号插片）| 1 | F1 |
| 10 | `C2908608` | XH-10A | **屏幕接口** | 1 | J3 |
| 11 | `C2908600` | XH-2A | NTC / 外接 3V3 | 2 | J7 J10 |
| 12 | `C2908601` | XH-3A | 电池平衡线 | 1 | JBAL |
| 13 | `C474881` | KF301-5.0-2P | 电源端子（螺钉式）| 5 | J_SW / J_LOG_IN/OUT / J_SRV_IN/OUT |
| 14 | `C2937625` | PZ254V-11-03P | **舵机接口 1×3P** | 8 | SV1–SV8 |
| 15 | `C124375` | B-2100S02P-A110 | 跳线排针 1×2P | 3 | JP_CHG / JP_LCD / JP_MCU |
| 16 | `C37208` | 2.54-1x6P直针 | 麦克风/功放排针 | 2 | J4 J5 |
| 17 | `C165948` | TYPE-C-31-M-12 | **USB-C 充电口** | 1 | J6 |
| 18 | `C49678` | CC0805KRX7R9BB104 | 100nF 0805 | 9 | C1–C4 C8 C14 C15 C17 C19 |
| 19 | `C440198` | GRM21BR61H106KE43L | 10µF 0805 | 6 | C5 C6 C7 C13 C16 C18 |
| 20 | `C602037` | CL21A226MAYNNNE | **22µF 0805 X5R** | 2 | C11 C12 |
| 21 | `C494548` | SHW1000UF10V8X12 | 1000µF 电解 | 1 | C9 |
| 22 | `C51953430` | ERB16V470M8X12 | 470µF 电解 | 1 | C10 |
| 23 | `C5240946` | 74437368022 | 2.2µH 电感 | 1 | L1 |
| 24 | `C149504` | 0805W8F1003T5E | 100kΩ | 4 | R10 R19 R21 R24 |
| 25 | `C17408` | 0805W8F1000T5E | 100Ω | 3 | R4 R5 R7 |
| 26 | `C17414` | 0805W8F1002T5E | 10kΩ | 3 | R13 R14 R15 |
| 27 | `C17436` | 0805W8F1203T5E | 120kΩ | 1 | R22 |
| 28 | `C17513` | 0805W8F1001T5E | 1kΩ | 1 | R3 |
| 29 | `C17578` | 0805W8F2553T5E | 255kΩ | 1 | R8 |
| 30 | `C17630` | 0805W8F3300T5E | 330Ω | 2 | R1 R2 |
| 31 | `C17633` | 0805W8F3302T5E | 33kΩ | 1 | R9 |
| 32 | `C17840` | 0805W8F8202T5E | 82kΩ | 1 | R23 |
| 33 | `C17957` | 1206W4F2200T5E | 220Ω 1206 | 2 | R18 R20 |
| 34 | `C23186` | 0603WAF5101T5E | 5.1kΩ 0603 | 2 | R16 R17 |
| 35 | `C84256` | NCD0805R1 | 红色 LED | 1 | D2 |

## 板外配套件（6 种 / 40 件）

| # | 立创编号 | 型号 | 规格 | 数量 | 用途 |
|---|---|---|---|---|---|
| 36 | `C5329587` | **HS24S010B** | **2.4" IPS ST7789 320×240 3.3V** | 1 | **屏幕** |
| 37 | `C5360462` | WAFER-XH2.54-10PJK | XH2.54 胶壳 10P | 1 | J3 屏幕线束 |
| 38 | `C5360454` | WAFER-XH2.54-2PJK | XH2.54 胶壳 2P | 2 | J7 / J10 |
| 39 | `C5360455` | WAFER-XH2.54-3PJK | XH2.54 胶壳 3P | 1 | JBAL |
| 40 | `C5360463` | WAFER-XH2.54-DZ | XH2.54 压线端子 | 30 | 配所有胶壳（含备用）|
| 41 | `C100114` | 2.54短路帽闭口 | 2.54mm 跳线帽 | 5 | JP_* + 备用 |

---

# 二、⚠️ 立创 MRO 工业品（导不进 BOM，要单独加购）

| 物品 | 链接 | 说明 |
|---|---|---|
| **XT30 母头** | [XT30(2+2)-F.G.B](https://item.szlcsc.com/mro/20526039.html) | 配板上 JBAT 公头 |
| **小号插片保险丝 7.5A** | [汽车保险丝分类](https://list.szlcsc.com/catalog/907.html) | F1 = `01530008Z` 是 **Mini Blade 小号**座 |

---

# 三、淘宝（板外模块 + 线材 + 紧固件）

**文件：`淘宝-采购清单.md`（含全部链接）**

## 🔴 立创缺货，必须淘宝买

| 位号 | 型号 | 链接 |
|---|---|---|
| **R6** | 0805W8F500LT5E 厚声 0805 **500mΩ ±1% 125mW** | [淘宝](https://item.taobao.com/item.htm?id=1041899561942&skuId=6226693982787) |

## 板外模块

| 物品 | 链接 | 参考价 |
|---|---|---|
| MG90S 舵机 ×8 | [玖訫科技](https://item.taobao.com/item.htm?id=1005683789132&skuId=5999915261650) | ¥88.0 |
| I²S 麦克风模块 | [DFRobot](https://item.taobao.com/item.htm?id=610064842890) | ¥15.0 |
| MAX98357 功放模块 | [信诚新电子](https://item.taobao.com/item.htm?id=866632847020&skuId=5886764007198) | ¥5.19 |
| 舵机降压 DFR0753 | [DFRobot](https://item.taobao.com/item.htm?id=633486468011) | ¥55.0 |
| 逻辑降压模块 | [顶峰模型](https://item.taobao.com/item.htm?id=820639316179&skuId=5525930664079) | ¥35.0 |
| 绿联 USB 充电头 | [绿联数码](https://item.taobao.com/item.htm?id=39662398527&skuId=6289267198584) | ¥27.9 |

**小计 ¥226.1**

## 🆕 V1.2 新增需要

```
外置总开关（接 J_SW）    100kΩ B4100 NTC（接 J7）
喇叭（接功放 OUT+/OUT−）  保险丝插片（配 F1）
```

## 线材 ¥32.14 + 紧固件 ¥31.01

详见 `淘宝-采购清单.md`

---

# 四、🔋 电池（需要你先决定）

**集成板自带**保护（HY2120-CB）+ 均衡（HY2213-BB3A ×2）

| 方案 | 买什么 | 说明 |
|---|---|---|
| A | 带保护板的成品包 | ⚠️ 与板上保护重复 |
| **B** ✅ | **裸 2S1P 电芯包** | 完全用板上保护，**推荐** |

| 候选 | 规格 | 链接 | 价格 |
|---|---|---|---|
| 格氏 ACE GS8002S45 | 800mAh-45C-7.4V-2S1P | [格氏总代](https://item.taobao.com/item.htm?id=663039669190&skuId=4779123056788) | ¥39.60 |
| 定制 2S1P | 1000mAh 带 XT30 | [锂电池总汇店](https://item.taobao.com/item.htm?id=986003989892) | 待报价 |

> 🔴 主板 JBAT 是 **XT30**；格氏那块是 **T 插**，要换或做转接线

---

# 五、换型记录（五轮，全部因为缺货/编码问题）

| 位号 | 原编码 | 问题 | 换成 |
|---|---|---|---|
| J4 J5 | `C9900021383` | EDA 内部编码，匹配不到 | **C37208** |
| J6 | `C9900216560` | EDA 内部编码，匹配不到 | **C165948** |
| J6 | `C2848974` | 库存 0 | 同上 |
| U7 | `C2688894` | 库存 0（海外代购）| **C2678753** |
| C11 C12 | `C86816` | 库存 0 | **C602037** |
| **R6** | `C28319` | **库存 0，无替代** | **→ 淘宝** |

---

# 六、💰 汇总

| 渠道 | 内容 | 金额 |
|---|---|---|
| **立创商城** | 41 项（板载 35 + 板外 6）| 见 CSV |
| **立创 MRO** | XT30 母头 + 保险丝插片 | 待核算 |
| **淘宝** | 板外模块 6 项 | ¥226.1 |
| **淘宝** | 线材 5 项 | ¥32.14 |
| **淘宝** | 紧固件 8 项 | ¥31.01 |
| **淘宝** | R6 + V1.2 新增件 | 待核算 |
| **电池** | 1 项 | 待定 |
| | **合计** | **约 ¥289 + 立创 + 电池** |

---

# 七、📋 下单顺序

```
1️⃣ 立创商城
   • 上传 立创商城-一键下单.csv（41 项）
   • 手动加：XT30 母头、小号插片保险丝 7.5A
   • 屏幕 C5329587 已在 CSV 里 ✓

2️⃣ 嘉立创（同一平台）
   • PCB 打样 + SMT 贴片
   • 上传 Gerber + 嘉立创SMT-BOM.csv + 嘉立创SMT-坐标文件.csv
   • R6 走「客供料」（淘宝买的寄过去）

3️⃣ 淘宝
   • 板外模块 + 线材 + 紧固件 + R6

4️⃣ 电池       ← 先定方案 A/B
5️⃣ 外壳       ← 等结构适配 110×75mm
```

---

# 八、📁 本目录文件

| 文件 | 用途 |
|---|---|
| **`最新BOM总表.md`** | ⭐ 本文，一眼看全 |
| **`立创商城-一键下单.csv`** | ⭐ 上传立创 BOM 工具（41 项）|
| `立创商城-明细核对.csv` | 带型号/规格/位号核对 |
| `立创商城-逐位号.csv` | 79 行，贴片焊接对照 |
| `嘉立创SMT-坐标文件.csv` | ⭐ SMT 贴片上传（原点已转好）|
| `嘉立创SMT-BOM.csv` | ⭐ SMT 用的 BOM（49 贴片件）|
| `淘宝-采购清单.md` | 淘宝部分，含全部链接 |
| `哪些焊到板上.md` | 哪些焊/哪些不焊 |
| `焊接服务怎么找.md` | 代焊方案对比 |
| `README.md` | 总览 + 换型过程记录 |
