xaiojie/papabot/采购清单-20260912/淘宝-采购清单.md

# 淘宝 · 采购清单（V1.2 无旋钮版）

> **对应设计**：`pcb-design/integrated-v1/final-no-encoder-2026-09-12/`
> **79 器件 / 36 种物料 / 310 引脚 / 110×75mm 双层板 / 原生 DRC 严格通过**
> 整理：2026-09-12 · 依据 `final-no-encoder-2026-09-12/装配与接线说明.md`

---

## ⚠️ 相比旧 BOM，有 7 项不用买了

集成板把这些**做进板子上了**：

| 旧编号 | 原物品 | 现状 |
|---|---|---|
| ~~E01~~ | 旧屏 TOUGLESY 2.4"＋EC11（¥32.4）| ❌ 换成 **HS24S010B**（立创 C5329587）|
| ~~E04~~ | PCA9685 16 路成品模块（¥8.9）| ❌ **板载 U7** |
| ~~F06A/B/C~~ | 采样电阻 100k/33k＋电容（¥8.72）| ❌ **板载 R10/R19/R21/R24** |
| ~~F07A~~ | PCA9685 OE 上拉电阻（¥2.54）| ❌ **板载 R13/R14/R15** |
| ~~P02~~ | 2S Type-C 充电模块（¥14.13）| ❌ **板载 IP2326 + Type-C** |
| ~~旋钮~~ | 旧屏自带的 EC11 | ❌ **V1.2 已彻底移除，也不另配** |
| ~~KEY0~~ | 旧屏按键 | ❌ **不需要** |

**小计省下约 ¥66.7，而且 V1.2 全板没有任何旋钮/按钮** ✓

---

## 一、淘宝必买：板外功能模块

| # | 物品 | 规格 | 链接 | 参考价 |
|---|---|---|---|---|
| 1 | **MG90S 舵机 ×8** | 全金属齿轮 180° | [玖訫科技](https://item.taobao.com/item.htm?id=1005683789132&skuId=5999915261650) | ¥88.0 |
| 2 | **I²S 麦克风模块** | MSM261S4030H0 | [DFRobot官方店](https://item.taobao.com/item.htm?id=610064842890) | ¥15.0 |
| 3 | **I²S 功放模块** | MAX98357（焊接款）| [信诚新电子](https://item.taobao.com/item.htm?id=866632847020&skuId=5886764007198) | ¥5.19 |
| 4 | **舵机路降压模块** | DFR0753，6~14V→5V/8A | [DFRobot官方店](https://item.taobao.com/item.htm?id=633486468011) | ¥55.0 |
| 5 | **逻辑路降压模块** | 好盈 86010010，3A(2-6S) | [顶峰模型](https://item.taobao.com/item.htm?id=820639316179&skuId=5525930664079) | ¥35.0 |
| 6 | **USB-A 充电头** | 绿联 CD104，5V/2.4A | [绿联数码](https://item.taobao.com/item.htm?id=39662398527&skuId=6289267198584) | ¥27.9 |

**小计 ¥226.1**

### 🆕 V1.2 新增需要（旧清单里没有）

| # | 物品 | 接哪里 | 说明 |
|---|---|---|---|
| 7 | **外置直流总开关** | J_SW | 板上只留两个焊盘，开关本体外购 |
| 8 | **100kΩ B4100 NTC** | J7 | 板上没有 NTC 本体，温度探头要外接 |
| 9 | **喇叭** | MAX98357 的 OUT+/OUT− | **不要**把任一端接主板 GND |
| 10 | **保险丝插片** | 配 F1（立创 C206907）| 座子在板上，插片另配 |
| 11 | **2S 电池** | JBAT（XT30）| 见第四节 |
| 12 | **跳帽 ×3** | JP_CHG / JP_LCD / JP_MCU | 默认断开，但调试必须用 |

---

## 二、淘宝必买：线材与连接

| # | 物品 | 规格 | 链接 | 参考价 |
|---|---|---|---|---|
| 13 | 杜邦线 | 母对母 20cm，1排40根 | [zave旗舰店](https://detail.tmall.com/item.htm?id=608543275703&skuId=6167752202862) | ¥8.36 |
| 14 | 硅胶并线 | 红黑 2×18AWG，1米 | [wxrkdz](https://item.taobao.com/item.htm?id=900626764964&skuId=5923525883949) | ¥4.29 |
| 15 | 排针 | 2.54mm 单排直针 10只 | [zave旗舰店](https://item.taobao.com/item.htm?id=606726184415&skuId=4430371271852) | ¥4.52 |
| 16 | 热缩管 | 127只 黑色盒装 | [touglesy](https://item.taobao.com/item.htm?id=615600154622&skuId=4334209992605) | ¥8.62 |
| 17 | 洞洞板 | 4×6 双面喷锡 5块 | [达科峰](https://item.taobao.com/item.htm?id=616867442654&skuId=5864266635679) | ¥6.35 |

**小计 ¥32.14**

### ✅ 配套插头 —— 已全部在立创找到，见 README

**原来这里列的「KF301 配对插头」是我写错了** ——
KF301 是**螺钉式端子**，导线直接拧进去，**不需要配对插头** ✓

其余配套件已在立创商城找到编码，全部并进 `立创商城-一键下单.csv`：

| 配套对象 | 立创编号 | 说明 |
|---|---|---|
| 屏幕 HS24S010B | **C5329587** | 2.4" IPS ST7789 |
| XH2.54 胶壳 10P | **C5360462** | 配 J3 屏幕线束 |
| XH2.54 胶壳 2P | **C5360454** | 配 J7 / J10（×2）|
| XH2.54 胶壳 3P | **C5360455** | 配 JBAL |
| XH2.54 压线端子 | **C5360463** | 配上面所有胶壳 |
| 2.54mm 跳线帽 | **C100114** | 配 JP_CHG/JP_LCD/JP_MCU |

---|---|---|---|
| J3 屏幕线束 | XH-10A | C2908608 | **XH-2.5 10P 胶壳 + 端子** |
| J7 / J10 | XH-2A ×2 | C2908600 | XH-2.5 2P 胶壳 + 端子 ×2 |
| JBAL 平衡线 | XH-3A | C2908601 | XH-2.5 3P 胶壳 + 端子 |
| 电源端子 ×5 | KF301-5.0-2P | C474881 | KF301 5.0mm 2P 插头 ×5 |
| JBAT 主电源 | XT30PW-M | C431092 | **XT30 配对半边** |
| 跳线 ×3 | B-2100S02P | C124375 | 2.54mm 跳帽 ×3 |

---

## 二·五、🔴 立创缺货，必须淘宝买

| 位号 | 型号 | 规格 | 链接 | 说明 |
|---|---|---|---|---|
| **R6** | **0805W8F500LT5E** | 厚声 0805 **500mΩ ±1% 125mW**（发100只）| [淘宝](https://item.taobao.com/item.htm?id=1041899561942&skuId=6226693982787) | 充电电流采样电阻 |

**为什么立创买不到**（我都查过）：
```
C28319     厚声 0805W8F500LT5E          库存 0     ❌
C4013772   Stackpole RMCF0805FTR500     库存 0     ❌
C2083351   Vishay RCWE0805R500FKEA      库存 2     ⚠️ 仅剩2个
```

> ⚠️ **R6 是 IP2326 充电电流采样电阻**，精度直接影响充电电流准确性。
> **必须买 ±1%**，不能用 ±5% 的普通电阻代替。

---

## 三、淘宝必买：紧固件与结构

| # | 物品 | 规格 | 链接 | 参考价 |
|---|---|---|---|---|
| 18 | M2 六角螺母 | 316不锈钢 20个 | [亿豪紧固件](https://item.taobao.com/item.htm?id=673051124656&skuId=5054000291214) | ¥0.96 |
| 19 | M3 六角螺母 | 316不锈钢 50个 | [亿豪紧固件](https://item.taobao.com/item.htm?id=673051124656&skuId=5054000291216) | ¥1.19 |
| 20 | M3 平垫片 | 6×0.8mm 200片 | [固万基](https://item.taobao.com/item.htm?id=575265264956&skuId=5076932416603) | ¥2.77 |
| 21 | 尼龙绝缘垫柱 | 180PCS 混合盒 | [壹优创](https://item.taobao.com/item.htm?id=704528035119&skuId=5130695735303) | ¥11.16 |
| 22 | 硅胶脚垫 | Ø12×2mm 50只 | [硅胶制品厂](https://item.taobao.com/item.htm?id=771706659250&skuId=5290081145877) | ¥6.83 |
| 23 | 魔术贴束带 | 1×15cm 2条 | [粘扣带制造](https://item.taobao.com/item.htm?id=773700829610&skuId=5466028503337) | ¥1.6 |
| 24 | EVA 泡棉 | 20mm×10m×1mm | [敏佰旗舰店](https://item.taobao.com/item.htm?id=645815964629&skuId=4660038213867) | ¥3.0 |
| 25 | 尼龙扎带 | 3×100mm 100条 | [力泰塑料](https://item.taobao.com/item.htm?id=676815692302&skuId=5034408146913) | ¥3.5 |

**小计 ¥31.01**

---

## 四、🔋 电池（需要你先做决定）

**集成板自带**：过充/过放保护（HY2120-CB）+ 均衡（HY2213-BB3A ×2）

| 方案 | 买什么 | 说明 |
|---|---|---|
| **A** | 带保护板的成品包 | ⚠️ 与板上保护**重复**，浪费且可能互相干扰 |
| **B** ✅ | **裸 2S1P 电芯包**（无保护板）| 完全用板上保护，**推荐** |

**候选电池**（下单前问卖家能否出**不带保护板**的版本）：

| 型号 | 规格 | 链接 | 价格 |
|---|---|---|---|
| 格氏 ACE GS8002S45 | 800mAh-45C-7.4V-2S1P | [格氏总代](https://item.taobao.com/item.htm?id=663039669190&skuId=4779123056788) | ¥39.60 |
| 定制 2S1P | 1000mAh 带 XT30 | [锂电池总汇店](https://item.taobao.com/item.htm?id=986003989892) | 待报价 |

> 🔴 **接口注意**：主板 JBAT 是 **XT30**。
> 格氏那块是 **T 插** —— 要换 XT30，或者自己做一根 T插→XT30 转接线。

---

## 五、⏸ 暂缓

| 项 | 原因 |
|---|---|
| **3D 打印外壳整套** | 新板 **110×75mm**，原 80×32mm 载板结构不兼容；A3 结构尚未适配新板新屏 |
| **屏幕线束成品** | 需自制：J3（XH-10A）→ 屏幕 CN1 排针，10 根，逐针焊（定义见第八节）|
| **USB-A 转 Type-C 线** | 你已明确不需要 |

---

## 六、💰 汇总

| 渠道 | 内容 | 金额 |
|---|---|---|
| **立创商城** | 板载 36 种物料 / 79 器件 | 见 `立创商城-一键下单.csv` |
| **立创商城** | 屏幕 HS24S010B（C5329587）| ~¥30–50 |
| **立创商城** | 配套插头/端子/跳帽/保险丝插片 | 待核算 |
| **淘宝** | 板外模块 6 项 | ¥226.1 |
| **淘宝** | 线材 5 项 | ¥32.14 |
| **淘宝** | 紧固件 8 项 | ¥31.01 |
| **淘宝** | V1.2 新增件（开关/NTC/喇叭/保险丝）| 待核算 |
| **电池** | 1 项 | 待定 |
| | **合计** | **约 ¥289 + 立创 + 电池** |

---

## 七、📋 下单顺序

```
1️⃣ 立创商城   ← 先下，一键导入最省事
   • 立创商城-一键下单.csv       ← 36 种板载物料（编号+数量）
   • 屏幕 HS24S010B              ← 搜 C5329587
   • 配套插头 + 跳帽 + 保险丝插片

2️⃣ 淘宝
   • 板外模块（舵机/麦克风/功放/两路降压/充电头）
   • 线材 + 紧固件
   • V1.2 新增件（总开关 / NTC / 喇叭）

3️⃣ 电池       ← 先定方案 A（带保护）还是 B（裸电芯）
4️⃣ 外壳       ← 等结构适配 110×75mm
```

---

## 八、🔌 附：屏幕线束定义（自制时用）

**主板 J3（XH-10A）→ 屏幕 CN1 排针**

| J3 | 网络 | 屏幕 CN1 | 信号 |
|:---:|---|---|---|
| 1 | GND | 1 | GND |
| 2 | LCD_3V3 | 2 | VCC |
| 3 | LCD_SCLK | 3 | SCL |
| 4 | LCD_MOSI | 4 | SDA |
| 5 | LCD_RST_N | 5 | RES |
| 6 | LCD_DC | 6 | DC |
| 7 | LCD_CS_N | 7 | CS |
| 8 | LCD_3V3 | 8 | BLK（背光控制，高电平开）|
| 9 | NC | 9 | FSO（不用）|
| 10 | NC | 10 | FCS（不用）|

> ⚠️ **供应商 PDF 第 7 页附带的小原理图，7–10 脚顺序和上表不同** ——
> 以上表（PDF 第 6 页机械图 CN1 + 第 7 页 Pin Definition 表）为准。
> **接线前核对实物丝印和 1 脚方向，不要按线色或插头外观猜。** J3 的**方焊盘是 1 脚**。
>
> 屏幕是 **ST7789V2、240×320、四线 SPI、3.3V** 模组，资料里没有触摸接口定义。

---

## 九、⚠️ 三个跳线默认都是断开的

| 跳线 | 断开时 | 什么时候接 |
|---|---|---|
| **JP_CHG** | EN 下拉，**禁止充电** | 电池/电流/NTC/保护台架核验完成后 |
| **JP_MCU** | +5V_LOGIC 与 MCU_5V 隔离 | 用外部逻辑 5V 供电时；**USB 调试时保持断开** |
| **JP_LCD** | 开发板 +3V3 与 LCD_3V3 隔离 | 选开发板 3.3V 供屏时接通；用 J10 外部 3.3V 时保持断开 |

**三处丝印都标了 OPEN。屏幕供电只能选一个来源，不能并联。**
