xaiojie/papabot/mechanical-design/a4-planning-2026-09-13/BOM核对与外壳修改计划.md

# A4 外壳修改计划与 BOM 核对

依据用户提供的《立创商城-一键下单-立创_20260913.xls》、项目《最新BOM总表》及用户最新版 PCB 制定。本轮完成清单核对、模型只读检查与规划；未修改 Blender、STL、PCB、原 BOM 或 Excel。

## 1. 本轮结论

继续采用已讨论的 A4 方向：**94 mm 宽、横屏接近前面板表面、奶油白与薄荷绿配色、四腿八舵机**。以现有 110×75 mm PCB 纵向安装为边界，重做前屏组件、主板托架、底盘和腿座。深度 132 mm、高度 76 mm 是初始布局目标，实际插头和部件包络检查通过前不作为打印定稿尺寸。

本方案从 A3 建立新版本，移除旧外置充电板、PCA9685 模块和独立保护板的专用支架。两路降压、开发板、音频模块、电池、外置总开关仍需要安装空间。

## 2. BOM 与 Excel 核对结果

Excel 工作表为 `sheet`，共 47 行、25 列；第 7–47 行是 41 项物料。它与项目归档的 `立创商城BOM报价单-BOM260913000033.xls` SHA-256 相同。

| 核对项 | 结果及解释 |
|---|---|
| 配单编号与上传时间 | BOM260913000033；2026-09-13 00:42:30 |
| 总表与 Excel 的 41 项 | 料号集合、型号、需求数量逐项一致 |
| 立创板载部分 | 35 种、78 件；R6 另购 1 件后，才是全板 36 种、79 件 |
| 立创板外部分 | 6 种、40 件，包含屏幕、胶壳、端子及备用跳帽；不是 40 个独立模块 |
| 购买数量 | 均不少于需求数量；起订量产生的余料不计入装机空间 |
| 报价时匹配与库存 | 41 项均显示系统匹配、现货；描述的是导出时状态，不是当前库存查询或付款证明 |
| 金额差异 | A4 单元格写折后 230.88 元、原价 246.43 元；X7:X47 明细小计合计 240.71 元，比折后总额高 9.83 元，原因未在表中说明 |
| 全整机范围 | Excel 未包含全部电池、降压、音频、开关、紧固件、主板制造及装配费用，不能据此判断整机采购齐全 |

原表保持原样。后续整理 BOM 时需纠正“35 种 / 79 器件”的表述；另外 AO4406 每颗是单 N 沟道 MOS，两颗组成保护开关，不是每颗双 N-MOS。电感 Excel 参数为额定电流 10A、饱和电流 28A，不能把商品标题的 28A 当持续额定电流。

## 3. 采购替换与结构尺寸的关系

| 位置 | 当前采购型号 | 与当前设计的关系 | 建模处理 |
|---|---|---|---|
| J6 充电 USB-C | C165948 / TYPE-C-31-M-12 | 当前 PCB 坐标表仍标 `USB-C-SMD_GT-USB-7010E`；历史记录只说明同为 16P 卧贴，尚未提供完整焊盘/固定脚重合核验 | 优先核对两者机械图、固定脚、插口高度和插拔方向；开孔先做可换侧板方案，不先定死尺寸，也不据此擅改 PCB |
| J4、J5 音频排针 | C37208 / 2.54-1x6P直针 | 采购为普通直针；原设计采用长排针库器件 | 按采购件 6 mm 配合针长、2.5 mm 塑高及插接端高度建立包络，不沿用旧占位高度 |
| U7 | C2678753 / PCA9685PW,118 | 采购后缀与设计原记录不同，均标 TSSOP-28 | 属于主板板载器件，不新增外置 PCA 模块仓；保留电气/封装替换记录 |
| C11、C12 | C602037 / CL21A226MAYNNNE | 22µF、25V、0805 X5R 替代原采购编码 | 仍属于主板低矮贴片区域，不新增独立模块空间 |
| XH 胶壳 | C5360454/55/62 | 型号写 XH2.54，但 Excel 封装与参数明确 2.5 mm | 主板端按 XH 2.5 mm 配合；屏幕端为另一种 2.54 mm 排针连接，不把两端视作直接对插 |

配单成功只证明商城找到对应商品。J6 与 J4/J5 的机械核对是外壳开孔/高度定稿前的具体工作，不等同于判定它们已经不兼容。

## 4. 建模输入与部件包络

尺寸单位为 mm。供应商标称值、旧占位和实测值分开管理；带线模块须同时计算本体、插头、焊脚、弯线和拆装工具空间。

| 部件 | 数量 | 当前依据 | 外壳规划方式 |
|---|---:|---|---|
| 用户最新版主板 | 1 | 110×75×1.6；四个 Ø3.2 孔，中心距 102×67；PCB 几何已核对 | 水平纵放，四孔可拆托架；下方绝缘和焊脚净空独立于电池仓 |
| LCKFB-ESP32S3R8N8 | 1 | 历史标称本体约 20.5×51.9；插座塑高 8.5；实际插合总高未实测 | 保留拔插、下载 USB 插线和天线周围净空；不按裸主板厚度计算上层空间 |
| HS24S010B | 1 | 规格表横放约 72.26×43×3.7；不同图表的 VA/AA 有差异 | 可拆压框＋软垫，初步预留 74×45×5 本体空间，另算排针与线束；有效显示区居中 |
| MG90S | 8 | 最新 BOM 保留；供应商版本的耳孔、轴高和舵盘仍需实物核对 | 实际电机尺寸不缩放；重排髋座和上腿，保留原装舵盘连接方式 |
| 电池 | 1 | 总表仍待定；之前 ACE800 标称 60×32×16，不含 T 插/线束 | 暂按 ACE800 建可换托盘包络，保留转接线、均衡线、软垫和束带；不视为新采购确认 |
| DFR0753 舵机降压 | 1 | 型号明确，旧 A3 的 50×30×10 空间只是预留 | 确认本体、端接件和高度后设计独立底层托架，不能把旧预留当厂家尺寸 |
| 好盈 86010010 逻辑降压 | 1 | 历史标称本体 43×17×7，不含导线和磁环 | 保留可调整绑带架，磁环与线束另占空间 |
| I²S 麦克风 | 1 | 最新采购写 MSM261S4030H0 模块；旧资料有 SEN0327 / Ø14 占位 | 优先核对实际模块及声孔位置，使用可换前部托架与短导声口 |
| MAX98357 功放 | 1 | 历史包络 19.4×17.8×3，供应商焊接款的端子高度未核实 | 后上部可换托架，计算接线端子与螺丝刀空间 |
| 喇叭 | 1 | 新总表未定具体型号；旧候选为 C50387237，约 Ø23.6×10.4、4Ω 3W | 先按 24 mm 级可换压圈规划，不冻结压圈口径和深度 |
| 外置总开关 | 1 | 新总表未定型号；旧候选 NKK S1A | 放后部可换接口板，等安装螺纹、面板厚度及焊片包络核对后定孔 |
| 保险丝插片、NTC | 各 1 | Mini Blade 7.5A；100kΩ B4100 探头 | 插片装入板载 F1 后增加高度与拔取空间；NTC 贴近电池，线束有固定点 |
| C9、C10、L1、端子 | 随主板 | C9/C10 本体均 Ø8×12；L1 平面 11×10、实际高度待核；KF301 为螺钉式 | 建立主板最高元件包络；KF301 预留拧线工具空间，无需另造配对插头空间 |

充电头、备用器件、洞洞板和工具属于板外使用或备料，不放进整机。电池采购若改为其他型号，只更换托盘参数，不能假定任意 1000mAh 包都能装入 ACE800 槽。

## 5. 尺寸、朝向与空间分层

### 外形边界

- 用户确认的宽度范围为 92–95，本方案沿用 94。
- 初始外形目标 94×132×76，不含脚、耳朵、插头和外露开关。
- 前窗接近齐平，保护窗可低于外框 0.3–0.5；液晶与保护片分开固定，不压迫玻璃或排线。
- 初始壳壁 2.4，转角 R8–R10；底盘和腿部受力区另加筋，不整体薄壁化。
- 直边内净宽约 89.2，75 宽主板居中时每侧约 7.1；内净深约 127.2，110 长主板剩余约 17.2。上述只是静态尺寸预算，未扣筋、屏幕、端子和线束。

### 按实际 PCB 坐标安排方向

采用机身 X 左右、Y 前后（前为负）、Z 向上。PCB 原坐标 u 从板左向右、v 从板上向下；居中放置时使用参考变换：

`X = v − 37.5；Y = 55 − u`。

| 接口参考点 | 原 PCB (u,v) | 机身 (X,Y) | 实际布置含义 |
|---|---|---|---|
| J3 屏幕 | (88,6) | (−31.5,−33) | 左前内侧，上插线束再引向前屏；不意味着插口直接朝向前脸 |
| J6 充电 USB-C | (13,70) | (32.5,42) | 右后侧，对应侧壁接口区 |
| JBAT 电池 | (14,10) | (−27.5,41) | 左后部，电池线沿侧通道接入 |
| J_SW 总开关线 | (40,6) | (−31.5,15) | 左侧偏后，经线束接后部开关 |
| SV1–SV8 | u=104 | Y=−49 | 接口排位于前部，后腿线束需沿两侧回走 |

这细化了旧概念中“屏幕接口一端朝前”的说法。主板安装孔中心距转换为左右 67、前后 102，不能套用旧载板孔距。

主板在侧壁内留有余量，USB 插座可能缩在壳内；模型阶段需检查插头外壳是否先撞侧壁、是否真正插到底。优先通过可换侧板的凹入口和小范围主板偏置解决，偏置后重算支架、屏幕及线束空间。不能只在概念图位置挖一个 USB 形孔。

### 内部层次

1. 前部：独立屏幕压框、柔性线束和短麦克风导声结构。
2. 上层：主板、插接 ESP32、最高元件和端子上方操作空间。
3. 下层中央：软垫与束带固定的电池，可独立取出；与焊脚、螺钉和高温部位隔开。
4. 下层两侧/后部：两路降压分开固定，按实际包络错位，电源线与音频线分路。
5. 后上部：喇叭、功放、可换开关接口板及散热口，避免声孔直接面向齿轮机构。

76 mm 高度须容纳底盘、电池/模块、隔层、PCB 与最高器件、上壳余量。只有逐项堆叠与三维交集检查通过，才能冻结高度。

## 6. 现有模型逐件修改范围

已使用 Blender 5.2.1 LTS 后台、禁用自动脚本方式只读打开 A3。主场景为 `10_A3_COMPLETE_ASSEMBLY`；文件含历史、爆炸和展示副本，后续需分清原件与展示副本。原模型单位是米，124 mm 壳宽在 Blender 中为 0.124，导出 STL 时必须单独验证 mm 比例。

| 原件或组件 | A4 处理 |
|---|---|
| R01 主外壳 | 重做 94 mm 壳体、可拆上壳/底盘连接、侧接口板位置和内部固定点 |
| R02 深前盖 | 重做浅前框，取消深遮光井及旧旋钮/按键让位；背面可拆压屏 |
| R04 屏幕支架 | 按 HS24S010B 与实际排针位置重做，不沿用旧 91×44 屏幕孔距 |
| R03 后盖、R11 喇叭压圈 | 重排喇叭/功放/开关和散热；去掉旧外置充电板开孔 |
| R05 底盘、电池托架 | 重做承力底盘、可换电池托盘及四腿安装横梁 |
| R06 主板支架 | 按新版四孔重做纵向托架，检查 Ø5.6 螺钉头避铜区；不直接套用 Ø6 金属垫片 |
| R09、R10_1、R10_2 | A4 中取消旧外置充电板托架与压条，旧文件保留 |
| R16 | A4 中取消独立 PCA9685 模块架 |
| ACE800 适配件 R21、R22 | 参考 R21 的软垫/束带思路；R22 独立保护板托架不进入集成版 |
| R17、R18 | 按实际两路降压本体和线束重排，保留可调固定 |
| R14 麦克风架 | 按新前脸位置重做可换小托架和导声路径 |
| L101、L102 四组 | 重排髋座、上腿与膝舵机方向，使机构靠近窄机身，保持真实 MG90S 尺寸 |
| L104 下腿与脚掌 | 保留风格与 Ø12 脚垫接口为起点；根据新姿态检查长度与行程，不承诺原件直接通用 |
| R12/R13 小耳组件 | 尽量复用造型，调整安装位置，复查内部螺母空间 |

腿部不做全局比例缩放。仅把旧腿向内平移约 15 mm，足端总宽仍可能超过 210 mm；160–175 mm 站姿总宽仅是收拢目标。先验证一条腿的关节、舵盘、线束和行程，再复制到四角。

## 7. 后续实施顺序与交付

| 步骤 | 工作 | 本阶段完成条件 |
|---|---|---|
| 1 输入确认 | 核对 J6 机械兼容、屏幕孔位/排针、主要模块包络、电池与开关/喇叭候选 | 有可追溯尺寸；未定项使用显式可换接口，禁止伪装成实测 |
| 2 建立 A4 装配副本 | 从 A3 新建 `structure-a4/DesktopAssistant-整机结构-A4.blend`，导入当前 PCB 参考和购买件包络 | 板、孔、插头方向正确；原 A3、用户 PCB、BOM 文件不变 |
| 3 内部布局 | 电池低位、两路降压错层、主板托架、前屏和 USB 插接检查 | 94 mm 宽下无硬件干涉，连接器可插拔，电池可取出 |
| 4 壳体和支架 | 重做前框、后盖、底盘、托架、接口板、声孔和散热口 | 螺丝可操作、开盖不拉断线、受力传到底盘 |
| 5 单腿与四腿 | 重做髋/上腿连接并检查极限姿态，再组四腿 | 无机构互碰或拉线，支撑范围与重心经过计算；实体负载仍单独验证 |
| 6 小件试配 | 输出屏幕角部/压框、USB 侧板、主板孔位及舵机夹具试配件 | 0.3–0.5 mm/侧的初始配合余量经所用打印机与材料校准 |
| 7 定稿交付 | 输出总装/爆炸/开盖图、独立 mm STL、紧固件表和装配顺序 | 原生文件重开正常、STL 闭合连通、尺寸和数量检查通过；实物与运动验收状态单独列明 |

不先打印整套外壳。试配件用于最容易出现尺寸差异的屏幕、USB 和舵机接口，随后再定稿整壳。

## 8. 方案取舍与未定项

推荐继续采用 A：**94 mm 窄机身、现有 PCB 水平纵放、132×76 深高起步**。相较于后半段加宽的 B 方案，它更符合用户确认的等宽外观；相较于缩短机身并重新拆分 PCB 的 C 方案，它能保留用户当前电路板。若插头/电源模块包络证明 130–135 深度内装不下，应先呈现实际冲突与最小增量，不悄悄增宽或修改 PCB。

当前待补充的不是整体外观方向，而是具体机械输入：

- 电池是否继续采用 ACE800；未获新答复前仅把其 60×32×16 标称包络用于规划，不冻结电池仓。
- J6 新采购件与当前 PCB 的机械重合核验。
- HS24S010B 的实际孔位、VA/AA、排针朝向和插合总深度。
- DFR0753、麦克风、功放的实际模块及接线包络。
- 开关和喇叭是否沿用旧候选；使用可换后部接口板和压圈控制改动范围。
- 新紧固件长度/数量需随 A4 重新统计；总表现有螺母/垫片数量不是 A4 螺丝套装已齐全的证明。

## 9. 来源与文件

- [最新 BOM 总表](../../hardware-selection/procurement/2026-09-12/最新BOM总表.md)
- [淘宝采购清单](../../hardware-selection/procurement/2026-09-12/淘宝-采购清单.md)
- 用户原始 Excel：`/Users/jay/Downloads/立创商城-一键下单-立创_20260913.xls`
- [本次机器核对记录](BOM核对记录.json)
- [用户最新版 PCB 核对与备份](../../pcb-design/integrated-v1/user-latest-review-2026-09-13/核对结论.md)
- [PCB 毫米坐标表](../../pcb-design/integrated-v1/final-no-encoder-2026-09-12/器件坐标_结构参考.csv)
- [当前电气装配说明](../../pcb-design/integrated-v1/final-no-encoder-2026-09-12/装配与接线说明.md)
- [A4 概念方案](../a4-concept-2026-09-13/设计方案.md)，只作风格和初始尺寸参考。
- [A3 模型源文件](../structure-a3/DesktopAssistant-整机结构-A3.blend)
- [ACE800 旧适配副本](../battery-ace800-a3/DesktopAssistant-A3-ACE800.blend)，仅借用电池包络/软垫思路。

旧《元件总表》和 A3 文档含旧屏、旧模块、旧孔距及保护板记录，不能覆盖当前 BOM、PCB 和本计划。本计划没有把报价、加购物车或 DRC 当作收货、实际装配或负载测试证据。
