xaiojie/papabot/hardware-selection/bom-v7/04-电池换店候选.md

# 电池换店候选 · 2026-09-08

最新反馈：用户表示第一家“锂电池总汇店”回复可以做，并决定当前所有配件先暂定。已向用户提供尺寸/线材回复文字，供用户自行发送；没有代发。电池供应商暂定为此店，完整规格、成品尺寸重量、报价及交期待最终答复。采购表已更新定制入口，未加购新定制款，未计入预算。以下是此前搜索依据。

优先问“锂电池总汇店”，其次问“鹰王电池工厂直销店”。本次查看了淘宝搜索结果、商品规格和详情图片，尚未找到能仅凭页面确认全部满足原要求的成品。以下都是询价候选，未加购、未下单、未代发商家消息。

| 店铺 | 页面已明确展示 | 仍需商家答复 |
|---|---|---|
| [锂电池总汇店](https://item.taobao.com/item.htm?id=986003989892) | 标题写“一个起订”；定制尺寸选项；详情展示7.4V串联组合包和加保护板服务 | 能否用高倍率全新电芯做1000mAh整包持续10A；2S保护与均衡、共口充放电、成品尺寸重量及XT30线束；单包报价和交期 |
| [鹰王电池工厂直销店](https://item.taobao.com/item.htm?id=559166020526&skuId=4558635752804) | 已选看“XT30头＋2S/7.4V 1000MAH 35C”，标称62×24×17mm；该普通版本展示20元、运费10元、预售15天内发货 | 两节版本未明确内置保护/均衡；能否由厂家加装适合持续10A的2S保护均衡板，保持充放电共口；加装后的尺寸重量、充电能力、线材及最终报价 |

“锂电池总汇店”的5元是定制入口展示价，并非本项目定制报价。鹰王的35C是商品标称倍率，不是对整包、保护板和线束持续10A能力的独立验证；其页面“带保护板”字样明确对应的是3.7V单节选项，不能套用到7.4V两节选项。平衡插头也不等于内置均衡电路，因此该普通航模版本尚不能直接按现有两线充电方案选定。

先发这一句筛选商家即可：

> 老板，能做1块7.4V、1000mAh的电池吗？要整块能持续输出10A，带保护板和两节电池的均衡功能，焊好XT30插头。能做的话，我再发尺寸和线材要求。

对方说能做后，再发[03简洁定制要求](03-电池定制-发给商家.txt)。原目标保持：标准2S1P、充满8.4V、全新配对电芯、整包持续≥10A、逐节过充/过放及过流/短路保护、接好的2S均衡、受保护充放电共口、支持≥1A充电；18AWG约10cm引线，电池端触点防误触的XT30及机器端配对线束；包好后尽量≤75×40×20mm、≤80g。尺寸重量可由商家先提方案，不擅自降电流要求。

其他查看记录：

- 深圳市捷讯新能源科技（商品553314372759）：有定制标题和7.4V/1000mAh普通规格，未见整包持续10A及均衡说明，可作后续备选。
- 广东延尔企业店（商品694697850466）：页面明确可定制高倍率电池，但所看现货规格只有150mAh/8C，不满足本项目，未列为直接采购款。
- 深圳海高志（商品594055173962）：有7.4V、15A、带保护板选项，但详情标重160g，超出80g目标；均衡也未明确，不优先。
- 原店明盛电子商城全新原装（商品966262592635）：用户已询问，回复“没有”，排除。原车内普通电池仍保留作历史核对，不计入可采购电池或预算。

本次未改购物车。27项、8个舵机及467.30元已知参考小计沿用此前核验记录，本次只更新电池来源状态，没有重新核算整车实时价格。
