xaiojie/papabot/design-coordination/history/before-a3/mechanical-design/STL零件与缺项清单.md

# STL零件与整机装配核对（A2）

2026-09-08更新：机械目录共有45个独立STL，其中 **32个是当前A2整机件**，其余为A1结构草稿、试配片和单件R06检查副本。

当前打印入口只用[structure-a2/stl-complete](structure-a2/stl-complete/)，每个文件打印1件；完整逐件说明见[A2零件清单](structure-a2/零件清单.md)。旧文件保留历史，不与A2混打。

| 部分 | 当前件数 | 内容 |
|---|---:|---|
| 外壳、盖板和基础支撑 | 6 | R01主壳、R02前盖、R03后面板、R04屏幕框、R05底盘/电池托架、R06主控架 |
| 四条腿 | 12 | 每腿L101髋座、L102上腿/膝座、L104下腿/脚掌各1 |
| 后控件与音频固定 | 4 | R07旋钮压片、R08按键压片、R11喇叭压圈、R14麦克风架 |
| 充电、PWM与电源固定 | 6 | R09充电托架、R10压条2件、R16 PCA架、R17/R18两路电源架 |
| 小耳朵及固定垫 | 4 | R12左右耳、R13左右内侧垫 |
| 合计 | 32 | 电子模块和金属紧固件不计打印件 |

此前清单中缺少的腿、耳朵、后面板控件、充电板、降压板、PWM、功放、麦克风和喇叭固定结构均已建模或集成。仍待补的是实物尺寸确认、切片试打与装配/承载验证；结构细化后的螺丝和M2螺母差额见[装配说明](structure-a2/装配与打印说明.md)。

[原12个STL的历史清单](STL零件与缺项清单-历史A1.md)保留供追溯，不代表当前缺件状态。
