xaiojie/papabot/pcb-design/native-rev-b/before/current-pointers-before-revb/pcb-design/native-rev-a/supplier-review-2026-09-09/屏幕资料核对与PCB修改要求.md

# 屏幕资料核对与 PCB 修改要求

日期：2026-09-09。资料由用户提供，目录为 `/Users/jay/Downloads/2.4寸TFT彩屏+EC11旋转编码器模块`。用户确认 EC11 为梅花柄、柄长15mm。原文件保持原样，关键资料副本与校验值保存在本目录的 `sources/` 和 `source-manifest.json`。

**结论：当前 RevA 的屏幕5V供电接法必须修订，旧 Gerber 继续暂停下单。** 新资料明确了原板控件公共端、上拉及针序，之前的电平疑问已有电路证据。屏幕和控件应按3.3V供电设计；可保留原板旋钮、按键，不需要为电平兼容拆焊移位。当前尚未修改原生工程、PCB铜线或Gerber。

## 一 原理图确认的电路

以 `sources/原理图/原理图.png` 中的完整屏幕模块为依据。`EC11资料/360度 旋转编码器模块/` 中另有四种独立编码器模块的原理图，它们不是所选屏幕整板，不能替代整板电路。

| 模块节点 | 原理图证据 | 对载板的含义 |
|---|---|---|
| VCC | 直接接液晶连接器的VDD、LEDA，以及控件上拉；此图没有画出5V转3.3V稳压器 | 不按已具备内部降压处理 |
| A、B | 各有10kΩ上拉至VCC、100Ω串联电阻和100nF滤波；编码器C公共端接GND | 输出高电平随模块VCC变化，不是隔离的无源触点输出 |
| PUSH | 10kΩ上拉至VCC，100Ω串联及100nF滤波；按下接GND | 同样必须匹配ESP32的3.3V输入 |
| KEY0 / K0 | 10kΩ上拉至VCC，100nF滤波；按下接GND | 高电平随VCC变化 |
| SPI | SCL/SDA/RES/DC/CS直接接屏幕接口，此图没有逻辑电平转换器 | 采用3.3V电源和ESP32的3.3V SPI；不向这些脚施加5V |
| BLK | 经1kΩ驱动SS8050；基极有10kΩ上拉到VCC，集电极经10Ω连接背光阴极 | 原理图具备默认点亮偏置；新引脚说明建议不用调光时接3.3V |

`引脚说明.docx` 第2项明确写“液晶屏电源正(3.3V)”。部分STM32示例注释仍写“5V或3.3V”，与引脚说明不一致；此前商品图也写3.3–5V。即使某个实物版本允许VCC为5V，整板图中控件上拉到VCC的连接仍不能据此视为3.3V GPIO兼容。按这些资料的共同可用电压3.3V修订设计。

RevA目前 `J3.2 = +5V_LOGIC`；J7的四路输入分别直连ESP32，并经载板R4–R7的10kΩ电阻上拉到主控3.3V。将该模块按原5V方案连接时，在触点断开、忽略GPIO钳位/漏电的理想模型中，两个上拉网络会使输入电压约为4.15V，而不是3.3V。ESP32-S3资料的输入高电平上限为VDD+0.3V，不能采用这个接法。这个数值是电路计算，不是实测电压，也不用于预测损坏程度。

## 二 12针接线对应关系

下表是供电修订后的目标接线。**当前PCB的J3.2仍为5V，不能按此表直接接入屏幕。** 表中针号来自供应商的引脚说明；插接方向仍须与实物丝印核对。

| 模块针号 | 模块信号 | 载板位置 | 状态或修改要求 |
|---|---|---|---|
| 1 | GND | J3.1 | 共地 |
| 2 | VCC | J3.2 | 必须从当前5V改成经供电预算确认的3.3V |
| 3 | SCL | J3.3 | SPI时钟，GPIO12 |
| 4 | SDA | J3.4 | SPI MOSI，GPIO11；不是I2C数据 |
| 5 | RES | J3.5 | 复位，GPIO21 |
| 6 | DC | J3.6 | 数据/命令，GPIO14 |
| 7 | CS | J3.7 | 片选，GPIO13 |
| 8 | BLK | 当前J3.8空置 | 按新说明，固定亮度时接屏幕的3.3V；可在修订接口或模块线束中实现，当前未实施 |
| 9 | A | J7.2 | ENC_A，GPIO7 |
| 10 | B | J7.3 | ENC_B，GPIO2 |
| 11 | PUSH | J7.5 | ENC_SW_N，GPIO38 |
| 12 | K0 / KEY0 | J7.7 | KEY_N，GPIO40 |

模块GND、载板GND和主控GND相连。载板J7.1/.4/.6本来就是GND，不应误接到其他信号。文档把第10脚B的文字说明重复写成“A相”；根据B标签与整板原理图，它对应B相，已在本表明确。旋钮方向可在固件中调整，不据此随意交换电源和其他脚。

载板与模块的10kΩ上拉在同一3.3V供电条件下可以并存，不会因此产生5V电平；约等效5kΩ，上电状态及滤波需要在最终供电方案中一并检查。不要把“去掉载板上拉”当成继续使用模块5V供电的解决办法，模块自身仍会上拉到5V。

## 三 3.3V供电源尚需确认

主控厂家原理图中的U6为ME6217C33M5G，标注800mA，它同时供应ESP32、存储器、USB相关电路及现有3.3V外设。800mA是器件标注，不能全部算作外设可用电流，也不能替代压降和温升评估。

本资料包没有给出整块屏幕在3.3V、背光全亮时的最大工作电流；也没有提供所用LCD/背光的完整电流参数，因此不能仅凭10Ω背光电阻推导可靠的整板最大电流。顶层RAR内的文档清单也已检查，未发现另一份屏幕功耗规格书。

需要的补充参数只有：**模块在3.3V、背光全亮时的最大工作电流，包含屏幕逻辑和背光。** 可向商家确认，或到货后用限流电源测量作样机评估。随后确定是否共用主控3.3V；若余量或温升不足，则给屏幕增加独立3.3V稳压支路，并检查信号的上电时序。当前不把未知负载直接记为主控稳压器已经能承受。

供电方案落实后，才修改原理图/PCB、同步网表、重新运行DRC、连接性和导出核对，形成新的打样文件。原来的几何检查通过仍有效地描述旧版几何，不能证明新发现的外部模块电压问题已解决。

## 四 EC11尺寸与前盖

`EC1103-D5-K15F7.pdf` 为一页机械图，列出了多个L/F/D选项。用户确认的15mm与图中L=15、F=7选项相符：

- L=15mm，图上标注L±0.3mm，从编码器本体前端量到轴顶；不是旋钮装板后的总高度。
- 梅花轴直径标称Ø6mm，18齿；图中F=7±0.2mm为末端花齿段长度。18齿指机械花齿数，与20脉冲/20定位不同。
- 编码器本体沿轴线厚度标称4.5mm；若按图中安装面贴板装配，安装面到裸轴顶端约4.5+15=19.5mm，未加旋钮帽及实际安装间隙。
- 尺寸图未给旋钮帽的完整外径、高度、内孔深度和装配位置，因此仍不能确认“PCB到旋钮帽最顶端”的真实总高度。

V1/A3继承的旋钮外凸约21mm、直径约15.5mm仍为占位假设。不能用“15mm柄长”把前盖缩到15mm，也不能用19.5mm裸轴长度宣称整装净空已经验收。现行结构继续保持：屏幕竖直朝前、旋钮/按键留原板、藏在可拆前盖内；本次没有修改Blender/STL几何。

## 五 当前文件状态

- 资料审阅完成，关键来源已归档；供电电平问题从“未知”更新为“已识别的修订项”。
- 当前原生工程及Gerber保持原样，未重新导出、未放行打样。
- 需要的PCB修改方向已明确：屏幕3.3V供电、BLK高电平接法、同步接口名称与原板控件接线说明；供电源选择待最大电流信息。
- 主控插座实物匹配、首次上电和整机试装等已有待验证事项继续保留。
