xaiojie/papabot/hardware-selection/bom-v7/00-整机配件采购核对.xlsx

当前状态 | 配件 | 型号 / 规格 | 整机用量 | 本次采购量 | 渠道 / 商品链接 | 参考金额(元) | 核对说明
暂定·待尺寸报价 | 2S动力电池包 | 2S1P 7.4V/1000mAh；整包持续≥10A；保护/均衡；XT30配套 | 1包 | 1包 | 淘宝 · 锂电池总汇店 (https://item.taobao.com/item.htm?id=986003989892) |  | 用户反馈新店可以做，暂定此店。目标含保护板包装≤75×40×20mm、≤80g；18AWG约10cm及XT30配对线束、共口充放电/支持1A充电，待完整规格与报价确认。未加购定制款；勿买车内原店普通电池。
随电池定制 | XT30 主电源配对接头 | 随P01定制包包含配对两半 | 1对 | 随电池配1对 | 电池供应商 · 随包确认 |  | 并入定制电池订单，要求电池端已焊XT30＋机器端配对半边，18AWG引线；本次不重复加购。
已加购 | 2.4英寸 TFT＋EC11 屏幕 | TOUGLESY 2.4英寸 ST7789＋EC11 | 1块 | 1块 | 淘宝 · touglesy旗舰店 (https://detail.tmall.com/item.htm?id=616669602001&skuId=5749013252092) | 32.40 | 已加购1块；屏幕、旋钮和按键为同一模块，不另买。开孔按实物复测。
已加购 | MG90S定位舵机 | MG90S舵机（全金属齿轮）180度 | 8个 | 8个 | 淘宝 · 玖訫科技 (https://item.taobao.com/item.htm?id=1005683789132&skuId=5999915261650) | 88.00 | 已核购物车数量8，单价11元；每腿2个；试单腿复用其中2个，不另买。
已加购 | 16路 PWM 舵机信号模块 | HANLI PCA9685 16路成品模块 | 1块 | 1块 | 淘宝 · 汉丽电子科技 (https://item.taobao.com/item.htm?id=967408745108) | 8.90 | 已加购1块；VCC接3.3V。只取PWM信号，8舵机总电源走外部配电。
已加购 | I²S 数字麦克风模块 | I2S麦克风模块MSM261S4030H0（单规格） | 1块 | 1块 | 淘宝 · DFRobot官方品牌店 (https://item.taobao.com/item.htm?id=610064842890) | 15.00 | 已加购1块；接3.3V，I²S输入；拾音孔和固定位置待实测。
已加购 | I²S 单声道功放模块 | MAX98357 焊接 | 1块 | 1块 | 淘宝 · 信诚新电子 (https://item.taobao.com/item.htm?id=866632847020&skuId=5886764007198) | 5.19 | 已加购焊接款；逻辑5V供电。喇叭改焊线接螺丝端子；两路喇叭输出均不接地。
已加购 | 电池采样上臂电阻 | 1/4W 金属膜电阻1% 100K （100个） | 暂1个 | 1包（100个） | 淘宝 · telesky旗舰店 (https://item.taobao.com/item.htm?id=982371708131&skuId=5939246944184) | 2.54 | 原型上臂100kΩ；与33kΩ下臂组成分压，8.4V约降至2.08V。装机暂1个；测阻并校准ADC。
已加购 | 电池采样下臂电阻 | 1/4W 金属膜电阻1% 33K （100个） | 暂1个 | 1包（100个） | 淘宝 · telesky旗舰店 (https://item.taobao.com/item.htm?id=982371708131&skuId=5939246944172) | 2.54 | 原型下臂33kΩ接地；装机暂1个，ADC引脚和衰减档随原理图/固件确定。
已加购 | 采样滤波及本地去耦电容 | 104P 0.1UF 50V 脚距5.08MM ±20%（50个） | 采样1个＋按需去耦 | 1包（50个） | 淘宝 · jccon旗舰店 (https://item.taobao.com/item.htm?id=609963289065&skuId=4286902992281) | 3.64 | 100nF直插独石电容，1个用于采样RC，其余用于需要补充的本地去耦。两项需求共用一包，不重复购买。
已加购 | PCA9685 OE上拉电阻 | 1/4W 金属膜电阻1% 10K （100个） | 暂1个 | 1包（100个） | 淘宝 · telesky旗舰店 (https://item.taobao.com/item.htm?id=982371708131&skuId=5939246944162) | 2.54 | OE拟通过10kΩ上拉3.3V，默认禁止PWM；接线前核实模块原有上下拉，必要时改板；方案未实施。
已加购 | M2六角螺母 | M2【20个】316不锈钢 | 约20个 | 1包（20个） | 淘宝 · 亿豪紧固件企业店 (https://item.taobao.com/item.htm?id=673051124656&skuId=5054000291214) | 0.96 | 普通公制右牙，配M2机牙螺丝；捕获槽按实物留公差。
已加购 | M3六角螺母 | M3【50个】316不锈钢 | 约12个 | 1包（50个） | 淘宝 · 亿豪紧固件企业店 (https://item.taobao.com/item.htm?id=673051124656&skuId=5054000291216) | 1.19 | 选择普通螺母捕获槽方案；暂用约12个，不再另买热熔铜嵌件。
已加购 | M3平垫片 | M3*6*0.8[200个] | 约12个 | 1包（200个） | 淘宝 · 固万基官方旗舰店 (https://item.taobao.com/item.htm?id=575265264956&skuId=5076932416603) | 2.77 | M3、外径6mm、厚0.8mm；暂用约12个。此SKU为200片小袋，余件备用，非200台用量。
已加购 | 尼龙绝缘垫柱试装盒 | 180PCS白色 | 约4个垫柱 | 1盒（180件混合） | 淘宝 · 深圳市壹优创电子 (https://item.taobao.com/item.htm?id=704528035119&skuId=5130695735303) | 11.16 | M3尼龙螺丝/螺母/垫柱混合盒；高度按实物试配。180件是套装总件数，不是180根垫柱。
已加购 | 自粘硅胶软脚垫 | 灰色带胶 直径12mm*2mm/50只装 | 4个 | 1包（50只） | 淘宝 · 硅胶制品厂 (https://item.taobao.com/item.htm?id=771706659250&skuId=5290081145877) | 6.83 | 暂用4只，余46只备用；脚底粘贴面按Ø12mm设计，实物测试抓地力。
已加购 | 电池反扣魔术贴束带 | 黑色1cm宽*15cm长【2条】 | 约1条 | 1包（2条） | 淘宝 · 粘扣带制造 (https://item.taobao.com/item.htm?id=773700829610&skuId=5466028503337) | 1.60 | 10×150mm，暂用1条另1条备用；按成品电池和托架试配，不勒压软包。
已加购 | 自粘EVA缓冲/密封泡棉 | 20mm宽 10米长 1mm厚 | 按用途裁切 | 1卷 | 淘宝 · 敏佰旗舰店 (https://item.taobao.com/item.htm?id=645815964629&skuId=4660038213867) | 3.00 | 裁短条作电池缓冲；麦克风只裁环形密封垫，中心留通孔。不是透声网或覆盖拾音孔的海绵。
已加购 | 小号尼龙扎带 | 国标3*100黑【宽2.5mm】100条 | 约10根 | 1包（100条） | 淘宝 · 浙江力泰塑料工厂店 (https://item.taobao.com/item.htm?id=676815692302&skuId=5034408146913) | 3.50 | 实际宽2.5mm、长100mm；暂用约10条，只束线，不直接捆压电芯。
已加购 | 2S 8.4V Type-C 充电模块 | MK021163，选择TYPE-C接口 | 1块 | 1块 | 淘宝 · TELESKY旗舰店 (https://detail.tmall.com/item.htm?id=709098048793&skuId=5148568746386) | 14.13 | 已加购TYPE-C款；实际充电电流待核，目标0.4–0.5A；首版关机充电。
已加购 | 舵机路独立降压模块 | DC-DC降压模块6~14V转5V8A（单规格） | 1块 | 1块 | 淘宝 · DFRobot官方品牌店 (https://item.taobao.com/item.htm?id=633486468011) | 55.00 | 已加购1块；只需一路舵机电源。5V/6A目标及低电量、温升待实测。
已加购 | 逻辑/音频路5V降压模块 | 好盈86010010，选择3A(2-6S) | 1块 | 1个 | 淘宝 · 顶峰模型 (https://item.taobao.com/item.htm?id=820639316179&skuId=5525930664079) | 35.00 | 原购物车已有1个；到货跳帽设5V。与舵机降压共地，两路5V输出不并联。
已加购 | 绿联USB-A充电头 | 17W丨白色双口USB丨小巧低温|直插 | 1个 | 1个 | 淘宝 · 绿联数码旗舰店 (https://item.taobao.com/item.htm?id=39662398527&skuId=6289267198584) | 27.90 | CD104，固定5V，单口最大2.4A、双口总3.4A。专用一口接充电板；裸头不含线。
已加购 | 全铜母对母20cm信号杜邦线，1排40根 | 全铜杜邦线 母对母（20CM) 2.54mm（1排40P） | 约30根 | 1排（40根） | 淘宝 · zave旗舰店 (https://detail.tmall.com/item.htm?id=608543275703&skuId=6167752202862) | 8.36 | 已加购1排40根；原需求30根，多10根备用，仅用于信号/小电流。
已加购 | 红黑2×18AWG硅胶并线，1米（每色1米） | 硅胶红黑并线 2×18AWG(0.75平方)(1米) | 按布局裁切 | 1米双芯 | 淘宝 · wxrkdz旗舰店 (https://detail.tmall.com/item.htm?id=900626764964&skuId=5923525883949) | 4.29 | 已加购1米双芯，即红黑各1米。需自裁焊接；长度、压降、固定待配线。
已加购 | 舵机接口及模块排针 | 单排黑--镀金（10只） | 3P×8＋短排针 | 1包（10条40P） | 淘宝 · zave旗舰店 (https://item.taobao.com/item.htm?id=606726184415&skuId=4430371271852) | 4.52 | 2.54mm单排直针，可裁成3P×8及模块短针；复用模块自带排针。不能用单个接点承载8舵机总电流。
已加购 | 绝缘热缩管 | 127只 黑色 盒装 | 1包 | 1盒（127段） | 淘宝 · touglesy旗舰店 (https://item.taobao.com/item.htm?id=615600154622&skuId=4334209992605) | 8.62 | 按焊点选择管径后收缩；余量作备用。
已加购 | 信号试接洞洞板 | 4x6 双面喷锡洞洞板（5块） | 1块 | 1包（5块） | 淘宝 · 达科峰旗舰店 (https://item.taobao.com/item.htm?id=616867442654&skuId=5864266635679) | 6.35 | FR-4双面喷锡，40×60mm；暂用1块，其余备用。只用于信号试接，舵机总电流走独立配电。
已列立创BOM | ESP32-S3 开发板 | LCKFB-ESP32S3R8N8 C20626143 | 1块 | 1块 | 立创商城 · C20626143 (https://item.szlcsc.com/22034693.html) | 30.52 | 已列立创BOM；价格取账户报价。附公排针未焊，不重复买；排母另列。
已列立创BOM | 带线小喇叭 4Ω 3W | 24MM-4Ω3W-2P1.25 C50387237 | 1个 | 1个 | 立创商城 · C50387237 (https://item.szlcsc.com/53008620.html) | 9.69 | 已列立创BOM；自带1.25mm插头不能直插功放端子，需改焊导线，不再买PH2.0转接线。
已列立创BOM | MINI 汽车插片保险丝 7.5A 32VDC | 029707.5WXNV C178942 | 1个 | 5个 | 立创商城 · C178942 (https://item.szlcsc.com/190335.html) | 3.08 | 已列立创BOM；装机1个，买5个含4备件；保险值仍需结合舵机浪涌核验。
已列立创BOM | MINI 保险丝 PCB 座 | 01530008Z C206907 | 1个 | 1个 | 立创商城 · C206907 (https://item.szlcsc.com/208026.html) | 24.35 | 已列立创BOM；这是PCB保险座，需配电载板安装，不能直接当带线保险座使用。
已列立创BOM | 舵机5V路储能电容 1000µF 10V | SHW1000UF10V8X12 C494548 | 暂2个 | 5个 | 立创商城 · C494548 (https://item.szlcsc.com/505124.html) | 2.66 | 已列立创BOM；买5个，初始装2个、备3个，数量按供电实测调整。
已列立创BOM | 逻辑5V路储能电容 470µF 16V | ERB16V470M8X12 C51953430 | 暂1个 | 10个 | 立创商城 · C51953430 (https://item.szlcsc.com/54681555.html) | 3.89 | 已列立创BOM；买10个，初始装1个、备9个，最终位置与数量按电路。
已列立创BOM | M2×6 圆头十字机牙螺丝 | PM2X6 C357534 | 暂20个 | 100个 | 立创商城 · C357534 (https://item.szlcsc.com/mro/332656.html) | 1.07 | 已列立创BOM；100个为最小包装，暂用20个；长度随结构核对，不作舵盘中心螺丝。
已列立创BOM | M3×8 圆头十字机牙螺丝 | PM3X8 C357544 | 暂12个 | 100个 | 立创商城 · C357544 (https://item.szlcsc.com/mro/332666.html) | 1.38 | 已列立创BOM；100个为最小包装，暂用12个；屏幕/外壳用孔和长度待结构核对。
已列立创BOM | 总开关 | S1A C5366606 | 1个 | 1个 | 立创商城 · C5366606 (https://item.szlcsc.com/6201668.html) | 29.42 | 已列立创BOM；焊片式、保持开关，切断两路工作负载。面板孔/绝缘待设计。
已列立创BOM | 开发板插座 1×20P 2.54mm 直排母 | 22850120ANG1SYA01 C429947 | 2条 | 5条 | 立创商城 · C429947 (https://item.szlcsc.com/426399.html) | 5.31 | 已列立创BOM；装机2条、买5条；配开发板随包公针，不承担8舵机公共电流。
本次不采购 | USB-A 转 Type-C 数据/充电线 | 5V≥2A，建议USB2.0数据线，约1m | 1条 | 0条 | 用户取消本次采购 |  | 用户明确不需要采购Type-C数据/充电线。
暂缓 | 外壳、腿及支架整套打印 | 奶油白/薄荷绿；原色FDM基础处理 | 1套 | 本次0 | 3D打印 · 待报价 |  | 按用户要求暂缓，设计尚未完成；本轮不选商家、不加购、不计预算。
暂缓 | 样框/单腿/公差试样 | 第一轮试配 | 1轮 | 本次0 | 3D打印 · 待报价 |  | 按用户要求暂缓，设计尚未完成；本轮不选商家、不加购、不计预算。
暂缓 | 载板/配电PCB | 目标5片小批，单机用1片 | 1片载板 | 本次0 | 嘉立创PCB · 待设计报价 |  | 按用户要求暂缓，设计尚未完成；本轮不选商家、不加购、不计预算。
费用另计 | 多供应商运费 | 最终按各订单结算 | — | 非配件 | 非配件 · 费用核对 |  | 运费按实际订单结算；只作费用核对，非配件，不套用旧预算为实际报价。
费用另计 | 补件与试制返工 | 未发生支出 | — | 按需补件 | 非配件 · 费用核对 |  | 只作后续补件/返工费用核对；未发生，不提前重复购买整套配件。
 |  |  |  |  | 已知商品参考小计 | 467.30 | 不含定制电池、运费、打样；优惠以实际结算为准。已加购不等于已下单。
