xaiojie/papabot/mechanical-design/structure-a5/零件清单.csv

编号 | 名称 | 装机数量 | STL文件 | 打印外包尺寸mm | 建议方向 | 说明
R01 | 124 mm 宽体可拆上壳 | 1 | stl-complete/R01__A5__mm.stl | 124.0 × 44.5 × 106.6 | front_down | 124×112×76机身；壁2.4；底部2×M2.5；充电口移到可拆后盖。
R05 | 宽体承力底盘 | 1 | stl-complete/R05__A5__mm.stl | 120.07 × 106.6 × 4.3 | Z | 4.6mm底；上壳、主板架、腿座及下层托盘独立固定。
R06 | 主板横置支架 102×67 | 1 | stl-complete/R06__A5__mm.stl | 109.0 × 72.4 × 45.6 | inverted | 板底Z80.5；四孔102×67；支柱移至髋舵机之间。4×M2.5固定PCB，2×M3固定底盘。
R02 | 浅前脸、压屏固定点和麦克风孔 | 1 | stl-complete/R02__A5__mm.stl | 124.0 × 76.0 × 7.7 | front_down | 前表面Y−56；不保留EC11或按钮；4×M3×10固定。
R07 | 黑色可换屏幕遮边 | 1 | stl-complete/R07__A5__mm.stl | 63.8 × 47.8 × 2.0 | front_down | 外边低于前框0.3 mm；57.6×42.6的浅槽放57×42×0.8透明PC片，面低0.45 mm；后方开窗51×38.7。
R04 | HS24S010B 可换背压框 | 1 | stl-complete/R04__A5__mm.stl | 78.05 × 56.1 × 2.2 | back_down | 72.26×43标称背板；四角0.5mm EVA，禁止压玻璃/焊点；4×M2×6自攻。CN1插头深度须≤7.7mm或改弯脚线束。
R21 | ACE800 可换电池托盘 | 1 | stl-complete/R21__A5__mm.stl | 65.0 × 44.0 × 6.9 | Z | 内净32.8×61；按标称60×32×16包络，各侧需试配后微调；0.8mm EVA；两条束带，不能压电池引线。
R17 | DFR0753 开放绑带托架 | 1 | stl-complete/R17__A5__mm.stl | 63.0 × 34.0 × 7.1 | Z | 2×M2自攻螺丝可拆；EVA+束带；尺寸为标称/预留，实物接线和端子另核。
R18 | 好盈 UBEC 开放绑带托架 | 1 | stl-complete/R18__A5__mm.stl | 21.0 × 58.0 × 4.3 | Z | 2×M2自攻螺丝可拆；EVA+束带；尺寸为标称/预留，实物接线和端子另核。
R03 | 可拆后盖、散热及喇叭座 | 1 | stl-complete/R03__A5__mm.stl | 124.0 × 76.0 × 13.5 | back_down | 喇叭后置，避开膝关节；4×M3×10；开关板独立，未定型号可只换小板。
R11 | 24 mm 级喇叭后压圈 | 1 | stl-complete/R11__A5__mm.stl | 28.0 × 36.6 × 2.0 | front_down | 候选23.6×10.4；2×M2×8自攻轻压壳边，不能压振膜；型号变更替换此件。
R19 | 功放后盖绑带架 | 1 | stl-complete/R19__A5__mm.stl | 28.0 × 23.0 × 2.2 | back_down | 2×M2×6；预留端子高度，不与外部独立PCA板混淆。
R14 | 前部可换麦克风托架 | 1 | stl-complete/R14__A5__mm.stl | 23.0 × 12.0 × 2.0 | front_down | 可调绑带+EVA；按MSM261S4030H0实际模块调整导声垫，非承诺旧Ø14模块适配。
R08 | 内凹总电源开关仓 | 1 | stl-complete/R08__A5__mm.stl | 40.0 × 32.0 × 18.4 | back_down | 保留J_SW总开关功能；沿用S1A候选包络，拨杆不超出后盖；实际型号仍需核对。
R20 | J6充电USB-C可换后盖孔板 | 1 | stl-complete/R20__A5__mm.stl | 27.0 × 16.0 × 2.0 | back_down | 17×11插头入口；口中心X−42/Z83.8；插拔沿Y；2×M2×6固定。5V充电，不是主控下载口。
R12_L | 原型小耳朵 L | 1 | stl-complete/R12_L__A5__mm.stl | 17.6 × 18.66 × 6.47 | front_down
R12_R | 原型小耳朵 R | 1 | stl-complete/R12_R__A5__mm.stl | 17.6 × 18.66 × 6.47 | front_down
R13_L | 耳朵压垫 L | 1 | stl-complete/R13_L__A5__mm.stl | 10.0 × 10.0 × 1.2 | Z
R13_R | 耳朵压垫 R | 1 | stl-complete/R13_R__A5__mm.stl | 10.0 × 10.0 × 1.2 | Z
L101_FL | 收拢髋固定座 FL | 1 | stl-complete/L101_FL__A5__mm.stl | 55.4 × 32.0 × 25.75 | side_down | MG90S原尺寸；2×M3×12固定底盘，底盘内沉头槽配D≤5.5/H≤1.8低头螺丝；底面M3螺母槽；耳孔27.5±1.4。
L102_FL | 向内错位膝座及上腿 FL | 1 | stl-complete/L102_FL__A5__mm.stl | 71.7 × 41.0 × 14.5 | side_down | 用原装舵盘；中心Ø6.4工具孔；2×M2螺丝接舵盘。
L104_FL | 收拢下腿及脚掌 FL | 1 | stl-complete/L104_FL__A5__mm.stl | 43.7 × 30.25 × 16.5 | side_down | Ø12×2脚垫；原装舵盘，非打印花键；新腿不可默认与A3混装。
L101_FR | 收拢髋固定座 FR | 1 | stl-complete/L101_FR__A5__mm.stl | 55.4 × 32.0 × 25.75 | side_down | MG90S原尺寸；2×M3×12固定底盘，底盘内沉头槽配D≤5.5/H≤1.8低头螺丝；底面M3螺母槽；耳孔27.5±1.4。
L102_FR | 向内错位膝座及上腿 FR | 1 | stl-complete/L102_FR__A5__mm.stl | 71.7 × 41.0 × 14.5 | side_down | 用原装舵盘；中心Ø6.4工具孔；2×M2螺丝接舵盘。
L104_FR | 收拢下腿及脚掌 FR | 1 | stl-complete/L104_FR__A5__mm.stl | 43.7 × 30.25 × 16.5 | side_down | Ø12×2脚垫；原装舵盘，非打印花键；新腿不可默认与A3混装。
L101_RL | 收拢髋固定座 RL | 1 | stl-complete/L101_RL__A5__mm.stl | 55.4 × 32.0 × 25.75 | side_down | MG90S原尺寸；2×M3×12固定底盘，底盘内沉头槽配D≤5.5/H≤1.8低头螺丝；底面M3螺母槽；耳孔27.5±1.4。
L102_RL | 向内错位膝座及上腿 RL | 1 | stl-complete/L102_RL__A5__mm.stl | 71.7 × 41.0 × 14.5 | side_down | 用原装舵盘；中心Ø6.4工具孔；2×M2螺丝接舵盘。
L104_RL | 收拢下腿及脚掌 RL | 1 | stl-complete/L104_RL__A5__mm.stl | 43.7 × 30.25 × 16.5 | side_down | Ø12×2脚垫；原装舵盘，非打印花键；新腿不可默认与A3混装。
L101_RR | 收拢髋固定座 RR | 1 | stl-complete/L101_RR__A5__mm.stl | 55.4 × 32.0 × 25.75 | side_down | MG90S原尺寸；2×M3×12固定底盘，底盘内沉头槽配D≤5.5/H≤1.8低头螺丝；底面M3螺母槽；耳孔27.5±1.4。
L102_RR | 向内错位膝座及上腿 RR | 1 | stl-complete/L102_RR__A5__mm.stl | 71.7 × 41.0 × 14.5 | side_down | 用原装舵盘；中心Ø6.4工具孔；2×M2螺丝接舵盘。
L104_RR | 收拢下腿及脚掌 RR | 1 | stl-complete/L104_RR__A5__mm.stl | 43.7 × 30.25 × 16.5 | side_down | Ø12×2脚垫；原装舵盘，非打印花键；新腿不可默认与A3混装。
