xaiojie/papabot/outputs/01a07a09-ef1b-7760-a41d-14c5a4d8f9ec/桌面助手-BOM与建模尺寸.xlsx

Sheet: 采购BOM
奶油薄荷桌面助手 · 内置电池版 BOM
首轮现金预留（元） |  | 619.53
已有截图价小计（元） |  | 126.53
定制2S电池规格及Type-C板型已选。电池未报价，充电电流待核；金额为现金预留。
黄色 D/F 列可修改；F 列为参考预算单价。币种：人民币。
包括一次 PCB 小批打样、整套打印和一轮试样；不含工具、精细喷漆及后续语音服务。
编号 | 器件 / 规格方向 | 数量 | 单位 | 参考单价 | 预算小计 | 当前选型状态 | 影响哪些模型 | 价格依据 | 资料 / 搜索方向
E01 | 途格斯 2.4寸 ST7789 TFT＋EC11 | 1 | 块 | 32.40 | 32.40 | 已选，待实测 | 开窗、支架、前盖深度 | 用户此前选中 SKU 截图 ¥32.4；非实时价 | hardware-selection/reference/screen-2p4-ec11-price-32p40.png
E02 | MG90S 全金属齿轮 180度，带舵盘螺丝 | 8 | 个 | 10.00 | 80.00 | 本轮选定，待实测 | 安装耳、输出轴、舵盘、腿部承载 | 用户图二选中 SKU 截图 ¥10；非实时价 | https://towerpro.com.tw/product/mg90s-3/
E03 | ESP32-S3 N16R8 已焊排针开发板 | 1 | 块 | 45.00 | 45.00 | 推荐型号，板型待定 | USB孔、托板、排母高度与天线空间 | 预算预留；官网有型号，未读到人民币价 | https://www.waveshare.net/shop/ESP32-S3-DEV-KIT-N16R8.htm（参考 N16R8-M）
E04 | PCA9685 16路 PWM 成品模块 | 1 | 块 | 12.00 | 12.00 | 推荐模块，待选商品 | 托板、排针与舵机插头空间 | 预算预留，未询价 | https://www.nxp.com/docs/en/data-sheet/PCA9685.pdf
E05 | I²S 数字麦克风模块，INMP441 类 | 1 | 块 | 8.00 | 8.00 | 推荐接口，待选商品 | 声孔方向、密封导音、安装卡座 | 预算预留，未询价 | 检索：INMP441 I2S 麦克风模块 已焊排针 尺寸图
E06 | MAX98357A I²S 单声道功放模块 | 1 | 块 | 6.00 | 6.00 | 推荐模块，待选商品 | 托板、接线端子空间 | 预算预留，未询价 | https://www.analog.com/en/products/max98357a.html
E07 | 4Ω 3W 小喇叭，优先约28～30mm外形 | 1 | 个 | 6.00 | 6.00 | 规格方向，外形待选 | 声孔、支架、背腔与磁体高度 | 预算预留，未询价 | 检索：4欧 3W 28mm 30mm 喇叭 带线 尺寸
P01 | 定制2S 7.4V 1000mAh电池包＋保护均衡 | 1 | 包 | 80.00 | 80.00 | 规格选定；待商家确认可做 | 电池仓、压条、插头和重心 | 80元为定制预算，未报价；含保护均衡及已焊线接头 | 定制询价入口：https://item.taobao.com/item.htm?id=966262592635；持续10A、允许充电至少1A、XT30；75×40×20仅包络目标
P02 | TELESKY 2S 8.4V Type-C充电板 MK021163 | 1 | 块 | 14.13 | 14.13 | 选TYPE-C款；充电电流待核 | 后接口板、28×17板体与插拔空间 | 用户图五TYPE-C款14.13元；非结算价，不含改电流服务 | https://detail.tmall.com/item.htm?id=709098048793&skuId=5148568746386；目标0.4～0.5A，实际限流须与电池允许值匹配
P03 | 舵机路降压模块，约5V大电流输出 | 1 | 块 | 28.00 | 28.00 | 电源路线候选，待选商品 | 板体、散热、接线与固定空间 | 预算预留，未询价 | 候选目标：5V连续6A级；按8舵机实测峰值和温升选定
P04 | 逻辑/音频路降压模块，5V约2A级 | 1 | 块 | 12.00 | 12.00 | 电源路线候选，待选商品 | 托板、散热与接线空间 | 预算预留，未询价 | 2S输入；与舵机分支供电并共地，实际余量待验证
P05 | USB-A转Type-C充电线，支持5V2A | 1 | 条 | 5.00 | 5.00 | 选接口方向；线材待购 | 外部插头避让；充电座已在P02上 | 预算预留；替代原面板充电插座，避免重复计价 | 与P10及P02配套；现有合适线材可将数量改0
P06 | 电源控制开关 | 1 | 个 | 5.00 | 5.00 | 开关外形待选 | 开孔、拨杆行程与内侧固定 | 预算预留，未询价 | 优先控制负载开关；若直接切电源须满足实际直流电流
P07 | 负载开关/保险、采样与滤波元件 | 1 | 套 | 15.00 | 15.00 | 原理图阶段定值 | 高件高度、发热、维修空间 | 预算预留，未询价；非器件级PCB BOM | 包括必要MOSFET、保险、分压、电容等；具体料号待原理图
P08 | 电源/信号线、排母及配套连接器 | 1 | 套 | 18.00 | 18.00 | 接口方向待定 | 插拔、弯曲、走线和扎线位置 | 预算预留，未询价 | 主电流接头按电流选；舵机标准3线接口；大电流不走开发板
P09 | 定制载板/配电PCB首次打样 | 1 | 批 | 30.00 | 30.00 | 待设计 | 板框、孔位、接口边和最高元件 | 预算预留，非板厂报价；按一次小批订单 | 单机用1块；以5片小批作为询价口径，计整批现金，不计SMT
P10 | 5V 2A USB-A成品电源适配器 | 1 | 个 | 20.00 | 20.00 | 输入规格选定；商品待购 | 外置，无机身开孔 | 预算预留；已有合适5V电源可将数量改0 | 用于Type-C充电板输入；不当作八舵机工作电源
M01 | 壳体与支架螺钉、螺母、垫柱 | 1 | 套 | 15.00 | 15.00 | 规格与数量待结构设计 | 通孔、螺母槽、柱体与工具空间 | 预算预留；舵机随包中心螺丝不重复计价 | 建议主体以M2螺钉/捕获螺母起步；舵机中心螺丝用随包件
M02 | 软脚垫4只 | 1 | 套 | 8.00 | 8.00 | 外形待定 | 脚底嵌槽与支撑高度 | 预算预留，未询价 | 硅胶/橡胶脚垫或TPU件，采购与打印二选一计价
M03 | 电池束带、缓冲/导音泡棉和扎带 | 1 | 套 | 5.00 | 5.00 | 依结构裁切 | 电池固定、导音与线束整理 | 预算预留，未询价 | 不可挤压软包电池；尺寸按所选电池和固定方式确定
M04 | 整套壳体、腿及安装小件打印 | 1 | 套 | 90.00 | 90.00 | 分件计划，未出生产文件 | 全部外壳、关节、耳饰及安装件 | 预算预留，非商家报价；不按广告每克价折算 | 原色FDM及基础处理口径；奶油白/薄荷绿，精细喷漆另询价
M05 | 屏幕样框、单腿与配合试样打印 | 1 | 轮 | 20.00 | 20.00 | 需尺寸后建模 | 校准间隙、紧固及单腿装配 | 预算预留；为额外试样，不与整套打印重复 | 优先小件试配，失败改图后再打印整套
L01 | 多个供应商合计运费 | 1 | 项 | 25.00 | 25.00 | 待结算 | 无模型影响 | 预算预留；已包邮部分应扣除 | 与各件单价分开
L02 | 补件与试制返工预留 | 1 | 项 | 40.00 | 40.00 | 预留 | 无固定模型尺寸 | 预算预留，不是已发生支出 | 不含购买打印机/焊接工具和长期语音服务费用
 |  |  |  | 现金预留合计 | 619.53

Sheet: 开孔前的尺寸
开孔之前，需要哪些准确尺寸
型号、商品尺寸图和装配方式足够明确时可以开始细化；关键配合仍应通过小件试样确认。
H 列留给实测值或收到的尺寸图。主控小板用可更换托板；外壳接口可用可更换接口板。
编号 | 器件 / 决定 | 已有依据（mm） | 必须补齐的尺寸或决定 | 对应结构 | 依据 | 实测值 / 文件 | 当前状态
D01 | 显示屏＋EC11整板 | 商品91×44；孔距84.5×37.5，孔Ø3 | 板厚、玻璃/发光区尺寸及偏置；旋钮/按键/排针总高 | 前盖、居中开窗、支架、机身深度 | 商品图；V1测量表 | 未提供 | 型号已选，详细尺寸缺失
D02 | 屏幕平齐安装方式 | 上轮建议EC11/按键移到后部可拆面板 | 核实拆焊焊点、屏与PCB高度；玻璃内缩0.5～1仅设计目标 | 前盖、显示支架、后控件板；原PCB不裁切 | 用户平齐需求；移位方案尚待硬件核实 | 建议记录：power-selection-2s.md | 建议方案，未改硬件或CAD
D03 | 8个MG90S本体 | 已选全金属齿轮180度；收到黑色商品图 | 含安装耳尺寸、孔距孔径、轴中心/高度、线缆出口、质量 | 四腿安装座、关节位置与摆动范围 | 商家无尺寸图；官方仅作可调整占位参考 | servo-mg90s-product-photo.png | 外观图已有；安装尺寸待实测
D04 | 配套舵盘＋中心螺丝 | 照片有单臂、双臂和十字塑料舵盘 | 舵盘厚度、孔位、花键配合、中心螺丝规格与工具空间 | 上/下腿连接；复用随包舵盘，不打印花键 | 所选MG90S配套实物；照片不提供精确尺寸 | servo-mg90s-product-photo.png | 外观可建；配合尺寸待实测
D05 | 内置电池包 | 定制2S1000mAh，持续10A，包内保护均衡 | 商家确认可做、真实长宽厚/质量、插头位置与极性、充电上限 | 电池仓、底盖、重心；75×40×20只是询价目标 | 图二定制入口；未获得该规格供货承诺 | 定制要求：power-selection-2s.md | 规格已写；供货和尺寸未冻结
D06 | Type-C充电板＋电源开关 | TELESKY TYPE-C款；图示板体28×17 | 板厚/最高件、孔径孔距、USB口坐标、允许面板厚度；开关外形 | 后部可更换接口板；USB插头和线束避让 | 图五MK021163；人工尺寸误差0.5～1 | charger-telesky-2s-typec.png | 板型已选；精确开孔待实测
D07 | ESP32-S3主控板 | N16R8方向；可参考微雪加焊排针款 | 具体板型长宽高、排针/排母、USB位置、插头空间、天线边界 | 可换托板与USB开孔 | 微雪官方页面及所选实物 | 未提供 | 托板孔位前确定
D08 | 喇叭 | 4Ω3W方向；V1的Ø28×7仅占位 | 外框、厚度、磁体、孔位/压边、出线位置与所需背腔 | 声孔、支架、壳内背腔 | 待选商品图 | 未提供 | 声孔和固定座前确定
D09 | 麦克风 | I²S模块方向；具体板型未选 | 顶/底拾音孔方向、板体和声孔坐标、接线高度 | 收音孔、导音泡棉与麦克风座 | 待选商品图 | 未提供 | 收音孔前确定
D10 | PCA9685/功放/两路降压模块 | 芯片/接口方向已给，成品板未选 | 外形、孔位、高件、端子、散热和线束插拔 | 可更换托板、内腔和通风 | 待选成品板图；不要把芯片尺寸当板尺寸 | 未提供 | 可先预留，固定孔后定
D11 | 自定义PCB | 原理图和布线未开始 | 先共定板框、固定孔、接口方向、元件高度与禁布区 | 托板、机身内腔和外部接口 | 我们设计的机械约束 | 未设计 | 板框孔位需先定，布线可并行
D12 | 紧固件＋软脚垫 | 紧固建议M2为起点；脚垫4只 | 螺钉头/长度、螺母外形、柱高、脚垫外形 | 可拆壳体、舵盘连接和脚底 | 供货尺寸与结构设计 | 未提供 | 加工孔之前定
D13 | 腿长、关节轴向和承载 | 当前两关节仅姿态占位，含腿宽208 | 运动范围、有效力臂、整机质量/重心、舵机持续工作能力 | 腿、支架、避让、站姿 | 我们设计并由单腿/整机测试验证 | 未设计 | 不能照抄V1当运动机构
D14 | 打印材料与公差 | 配色磨砂已定；V1壁厚2.4、间隙为试验值 | 材料、工艺、供应商公差；薄件厚度和孔配合试样 | 所有最终打印件，尤其关节和螺母槽 | 商家能力与试样 | 未确定 | 整套发布前确定

Sheet: 分件计划
外壳与安装配件分件计划
预计分件清单，不是已发布的 STL 数量；允许将垫柱/夹子等并入相邻零件。
电池托架、实际舵机承载座和后接口板需新增；外购舵机、舵盘和螺丝不在打印件中。
编号 | 部件 | 预计数量 | 颜色 / 材料方向 | 定尺寸和连接的依据 | 目前状态
S01 | 主壳 | 1 | 奶油白，低光泽 | 前/底盖接口、舵机载荷路径 | V1有外形，结构待细化
S02 | 可拆前盖 | 1 | 奶油白 | 有效开窗、屏幕平齐方式 | 需要重做前端高度关系
S03 | 底盖/维修盖 | 1 | 奶油白 | 电池取出、紧固和工具通路 | V1有外形，锁止待设计
S04 | 前脸薄荷装饰圈 | 1 | 薄荷绿 | 可独立嵌件或着色，避免过薄 | V1仅0.4mm深，需按工艺调整
S05 | 屏幕固定支架 | 1 | 内部色不限 | 91×44板与真实孔位，需排针避让 | V1占位支架，待实测
S06 | 短遮光圈/玻璃保护边 | 1 | 深色或奶白内部 | 与平齐方案联动，不沿用20mm深井 | 重新设计
S07 | 屏幕隔离垫柱 | 4 | 内部色不限 | 真实板厚和安装高度，可并入支架 | 按实物定高，数量可合并
S08 | 可更换电子托板 | 1 | 内部色不限 | 主控、驱动和PCB板框孔位 | V1有占位，孔位待定
S09 | 耳框 | 2 | 薄荷绿 | 底座可拆，避开声孔 | V1有形状，紧固待细化
S10 | 耳内片 | 2 | 奶油白 | 可嵌入，按工艺确定厚度 | V1厚0.7mm，待工艺调整
S11 | 机身侧舵机安装座 | 4 | 薄荷绿/内部结构色 | MG90S安装耳、轴线、承载连接 | V1仅占位，需新建
S12 | 上腿/第二舵机承载件 | 4 | 薄荷绿；结构材料待定 | 输出舵盘与第二舵机本体固定 | 需按MG90S与舵盘重画
S13 | 下腿 | 4 | 薄荷绿；结构材料待定 | 舵盘连接、限位、脚垫 | 需按舵盘与步态重画
S14 | 关节装饰盖 | 8 | 奶白/薄荷绿 | 旋转避让与中心螺丝可达 | V1有外观，需调整
S15 | 电池托架 | 1 | 内部色不限 | 定制2S1000mAh；按含保护板包膜的成品尺寸 | 规格已写，实物尺寸与布局待定
S16 | 电池压条/束带座 | 1 | 内部色不限 | 固定牢靠且不压迫电池 | 新增，随托架设计
S17 | 喇叭支架/背腔件 | 1 | 内部色不限 | 喇叭外框、磁体与声学空间 | 新增/与壳体整合待定
S18 | 麦克风固定座 | 1 | 内部色不限 | 拾音孔与泡棉导音对齐 | 新增，待麦克风板型
S19 | 后部可更换接口与控件板 | 1 | 奶油白 | P02充电口、调试USB/开关；预研EC11与按键移位 | 充电板型已选；孔位和控件移位待核
S20 | 线束固定夹 | 2 | 内部色不限 | 弯曲/插拔空间、避免进入关节 | 建议起始数量，布局后调整
S21 | 舵机局部装饰罩（可选） | 8 | 薄荷绿/奶油白 | 只遮外露侧面，留散热和摆动空间 | 可选外观件，运动校核后决定
