xaiojie/papabot/pcb-design/integrated-v1/BOM-完整清单.csv

分类 | 位号 | 型号/规格 | 封装 | 数量 | 立创编号 | 渠道 | 状态
主控 | U1 | ESP32-S3 开发板 LCKFB-ESP32S3R8N8 | 开发板 | 1 | C20626143 | 立创 | 已购
显示 | J3 | 汉昇 HS24S010B 2.4寸 ST7789 SPI | 模组 43.5×72.9 | 1 | C5329587 | 立创 | 待购
插座 | J1 J2 | 1×20P 2.54mm 母座 塑高8.5 | 插件 | 2 | C429947 | 立创 | 待购
电源 | U1 | PW7120 两串保护IC | SOT23-6L | 1 |  | icinz/淘宝 | 待购
电源 | U2 U3 | PW4406A 双N-MOS | SOP8 | 2 |  | icinz/淘宝 | 待购
电源 | U4 | PW4584A 升压充电IC | SOP8-EP | 1 |  | icinz/淘宝 | 待购
电源 | U5 U6 | PW2213 均衡IC | SOT23-6L | 2 |  | icinz/淘宝 | 待购
电源 | Q3 Q4 | PW2302 均衡放电MOS | SOT23 | 2 |  | icinz/淘宝 | 待购
电源 | D1 | SS34 肖特基 40V/3A | SMA | 1 | C908680 | 立创 | 待购
电源 | L1 | 4.7µH 功率电感 ≥1.5A | 贴片 | 1 |  | 立创 | 待购
电源 | U8 | 逻辑降压 MP1584EN 模块 | 模块 | 1 |  | 淘宝 | 待购
电源 | U7 | PCA9685 16路PWM | TSSOP-28 | 1 |  | 立创/淘宝 | 待购
电源 | F1 | MINI 插片保险丝 7.5A | 插件 | 1 | C178942 | 立创 | 待购
电源 | F2 | MINI 保险丝 PCB 座 | 插件 | 1 | C206907 | 立创 | 待购
电源 | SW1 | NKK S1A 总开关 | 插件 | 1 | C5366606 | 立创 | 待购
电源 | J5 | KF128 5.08mm 2P 螺钉端子 | 插件 | 1 |  | 立创/淘宝 | 待购
电源 | J6 | Type-C 16P 母座 沉板/贴片 | 贴片 | 1 |  | 立创/淘宝 | 待购
舵机 | J4 | 2.54mm 单排 3P 公排针 | 插件 | 8 |  | 立创/淘宝 | 待购
舵机 | — | MG90S 舵机 | 成品 | 8 |  | 淘宝 | 已购
音频 | — | I2S 麦克风 DFRobot SEN0327 | 模块 Ø14 | 1 |  | DFRobot | 待购
音频 | — | MAX98357A 功放模块 | 模块 19.4×17.8 | 1 |  | 淘宝 | 待购
音频 | — | 喇叭 4Ω3W 24mm | 成品 | 1 | C50387237 | 立创 | 待购
交互 | ENC1 | EC11 编码器 带按压 Ø6轴 | 插件5脚 | 1 |  | 淘宝 | 待购
电容 | C_B1 | 1000µF/10V 电解 | 直插 | 1 | C494548 | 立创 | 待购
电容 | C_B2 | 470µF/16V 电解 | 直插 | 1 | C51953430 | 立创 | 待购
电容 | CIN COUT | 10µF/25V | 0805/1206 | 2 |  | 立创 | 待购
电容 | C1 C2 C1B C2B | 0.1µF/16V | 0805 | 4 |  | 立创 | 待购
电容 | C2B C3B | 22nF | 0603 | 2 |  | 立创 | 待购
电容 | CF1 CF2 C4 | 1nF | 0603 | 3 |  | 立创 | 待购
电阻 | R1 R2 R2B | 330Ω ±1% | 0805 | 3 |  | 立创 | 待购
电阻 | R3 | 1KΩ ±1% | 0805 | 1 |  | 立创 | 待购
电阻 | RICHG | 1KΩ（设1A；0.5A待查） | 0805 | 1 |  | 立创 | 待购
电阻 | R_BAL1-4 | 620KΩ ±1% | 0805 | 4 |  | 立创 | 待购
电阻 | CC1 CC2 | 5.1KΩ ±1% | 0603 | 2 |  | 立创 | 待购
电阻 | R_UP | 100KΩ ±1% | 0805 | 1 |  | 立创 | 待购
电阻 | R_DN | 33KΩ ±1% | 0805 | 1 |  | 立创 | 待购
电阻 | I2C上拉 | 10KΩ | 0805 | 2 |  | 立创 | 待购
电阻 | OE上拉 | 10KΩ | 0805 | 1 |  | 立创 | 待购
电阻 | ENC上拉 | 10KΩ | 0805 | 2 |  | 立创 | 待购
LED | LED1 LED2 | 充电指示 红/绿 | 0805 | 2 |  | 立创 | 待购
备选 | — | HY2120-AB（替代 PW7120） | SOT23-6L | 1 | C168776 | 立创 | 备选
备选 | — | HY2213-AB3B（替代 PW2213） | SOT23-6L | 2 | C168784 | 立创 | 备选
结构 | M1 | PM2X6 圆头十字机牙螺丝 | — | 1包 | C357534 | 立创 | 待购
结构 | M2 | PM3X8 圆头十字机牙螺丝 | — | 1包 | C357544 | 立创 | 待购
PCB | — | 单板全集成 v1 | 110×75mm 2层 2oz | 5片 |  | 嘉立创 | 待打样
