xaiojie/papabot/pcb-design/native-rev-b/载板装配清单.csv

位号 | 名称或规格 | 设计数量 | 初装数量 | 默认状态 | 安装位置 | 封装模板 | 备注
C1 | 100nF 50V P5.08 | 1 | 1 | 安装 | PCB | CAP-TH_L5.0-W2.5-P5.08-D0.7 | 100nF，电池ADC滤波。
C2 | 470uF 16V OFF BOARD | 1 | 1 | 安装 | 板外UBEC/功放分支 | 不占PCB位置 | 板外470µF/16V，放UBEC/功放电源支路；注意极性并绝缘固定，不占PCB位置。
C3 | 100nF 50V P5.08 | 1 | 1 | 安装 | PCB | CAP-TH_L5.0-W2.5-P5.08-D0.7 | 100nF，主控3.3V旁路。
C4 | 100nF 50V P5.08 | 1 | 1 | 安装 | PCB | CAP-TH_L5.0-W2.5-P5.08-D0.7 | 100nF，逻辑5V旁路。
C5 | 100nF 50V P5.08 | 1 | 1 | 安装 | PCB | CAP-TH_L5.0-W2.5-P5.08-D0.7 | 新增100nF/50V/P5.08屏幕旁路电容；外部稳压器仍须配齐其规定的输入/输出电容。
J1 | MCU_LEFT_20P | 1 | 1 | 安装 | PCB | HDR-TH_20P-P2.54-V-F | C429947 / 22850120ANG1SYA01；单排20P、2.54mm、塑高8.5mm；两排间距17.78mm，两排1脚朝天线。
J2 | MCU_RIGHT_20P | 1 | 1 | 安装 | PCB | HDR-TH_20P-P2.54-V-F | C429947 / 22850120ANG1SYA01；单排20P、2.54mm、塑高8.5mm；两排间距17.78mm，两排1脚朝天线。
J3 | LCD_3V3_SPI | 1 | 1 | 安装 | PCB | HDR-TH_8P-P2.54-V-M | 屏幕VCC和BLK均为LCD_3V3，仅3.3V；8针载板接口拆分接到12针模块，按同名信号逐根接。
J4 | PCA9685_LOGIC_ONLY | 1 | 1 | 安装 | PCB | HDR-TH_5P-P2.54-V-M | PCA9685逻辑VCC=3.3V，OE高时禁用；舵机电源走板外粗线，V+不经过此口。
J5 | MIC_3V3_I2S | 1 | 1 | 安装 | PCB | HDR-TH_6P-P2.54-V-M-1 | 麦克风3.3V；第6脚为接地的LR，选择左声道；按所购模块丝印接线。
J6 | AMP_I2S_SIGNALS | 1 | 1 | 安装 | PCB | HDR-TH_4P-P2.54-V-M | 仅音频信号；功放电源由5V逻辑UBEC另分支供给。
J7 | LCD_STOCK_CONTROLS | 1 | 1 | 安装 | PCB | HDR-TH_7P-P2.54-V-M | 原屏幕板控件保留；A/B/PUSH/K0分别接2/3/5/7脚；1/4/6脚为GND备用。
J8 | LOGIC_5V_IN | 1 | 1 | 安装 | PCB | HDR-TH_2P-P2.54-V-M-1 | 只接已调到5V的逻辑UBEC输出；不接电池原电压或舵机功率支路。
J9 | SWITCHED_BAT_SENSE | 1 | 1 | 安装 | PCB | HDR-TH_2P-P2.54-V-M-1 | 只接总开关后的电池正极作电压采样，不是供电输入。
J10 | LCD_EXT_3V3_IN | 1 | 0 | 预留输入 | PCB | HDR-TH_2P-P2.54-V-M-1 | 可选外部稳压3.3V输入，1脚3.3V、2脚GND；使用时JP3必须断开。采用短软线或实测可容纳的低矮连接器。
JP1 | MCU_POWER_LINK | 1 | 0 | 保持断开 | PCB | HDR-TH_2P-P2.54-V-M-1 | 默认开路；上电检查后用低矮短导线连接逻辑5V与主控5V；USB无自动防倒灌。
JP2 | BAT_SENSE_LINK | 1 | 0 | 保持断开 | PCB | HDR-TH_2P-P2.54-V-M-1 | 默认开路；检查后连接开关后电池电压与采样分压入口。
JP3 | LCD_3V3_LINK_OPEN | 1 | 0 | 保持断开 | PCB | HDR-TH_2P-P2.54-V-M-1 | 默认开路；仅确认主控3.3V电流及温升余量后跨接，且J10不得接外部电源；优先贴板短导线。
R1 | 100k 1% 0.25W | 1 | 1 | 安装 | PCB | RES-TH_BD2.7-L6.2-P10.20-D0.4 | 100kΩ/1%/0.25W，电池采样分压上臂。
R2 | 33k 1% 0.25W | 1 | 1 | 安装 | PCB | RES-TH_BD2.7-L6.2-P10.20-D0.4 | 33kΩ/1%/0.25W，电池采样分压下臂。
R3 | 10k 1% OE pull-up | 1 | 1 | 安装 | PCB | RES-TH_BD2.7-L6.2-P10.20-D0.4 | 10kΩ OE上拉；若PCA模块自带OE下拉，核对并去掉该下拉后再测试上电禁用。
R4 | 10k 1% 0.25W | 1 | 0 | 不焊/DNP | PCB | RES-TH_BD2.7-L6.2-P10.20-D0.4 | DNP，默认不焊；原屏幕板已有10kΩ上拉到LCD_3V3。保留可选焊位，不能未经评估连接两个稳压输出。
R5 | 10k 1% 0.25W | 1 | 0 | 不焊/DNP | PCB | RES-TH_BD2.7-L6.2-P10.20-D0.4 | DNP，默认不焊；原屏幕板已有10kΩ上拉到LCD_3V3。保留可选焊位，不能未经评估连接两个稳压输出。
R6 | 10k 1% 0.25W | 1 | 0 | 不焊/DNP | PCB | RES-TH_BD2.7-L6.2-P10.20-D0.4 | DNP，默认不焊；原屏幕板已有10kΩ上拉到LCD_3V3。保留可选焊位，不能未经评估连接两个稳压输出。
R7 | 10k 1% 0.25W | 1 | 0 | 不焊/DNP | PCB | RES-TH_BD2.7-L6.2-P10.20-D0.4 | DNP，默认不焊；原屏幕板已有10kΩ上拉到LCD_3V3。保留可选焊位，不能未经评估连接两个稳压输出。
