xaiojie/papabot/pcb-design/integrated-v1/final-2026-09-12/板载BOM_83器件.csv

位号 | 数量 | 型号 | 值 | 封装 | 立创编号 | 制造商 | 说明
C1 | 1 | CC0805KRX7R9BB104 | 100nF | C0805 | C49678 | YAGEO(国巨) | 容值:100nF;精度:±10%;额定电压:50V;温度系数:X7R;
C2 | 1 | CC0805KRX7R9BB104 | 100nF | C0805 | C49678 | YAGEO(国巨) | 容值:100nF;精度:±10%;额定电压:50V;温度系数:X7R;
C3 | 1 | CC0805KRX7R9BB104 | 100nF | C0805 | C49678 | YAGEO(国巨) | 容值:100nF;精度:±10%;额定电压:50V;温度系数:X7R;
C4 | 1 | CC0805KRX7R9BB104 | 100nF | C0805 | C49678 | YAGEO(国巨) | 容值:100nF;精度:±10%;额定电压:50V;温度系数:X7R;
C5 | 1 | GRM21BR61H106KE43L | 10uF | C0805 | C440198 | muRata(村田) | 容值:10uF;精度:±10%;额定电压:50V;温度系数:X5R;
C6 | 1 | GRM21BR61H106KE43L | 10uF | C0805 | C440198 | muRata(村田) | 容值:10uF;精度:±10%;额定电压:50V;温度系数:X5R;
C7 | 1 | GRM21BR61H106KE43L | 10uF | C0805 | C440198 | muRata(村田) | 容值:10uF;精度:±10%;额定电压:50V;温度系数:X5R;
C8 | 1 | CC0805KRX7R9BB104 | 100nF | C0805 | C49678 | YAGEO(国巨) | 容值:100nF;精度:±10%;额定电压:50V;温度系数:X7R;
C9 | 1 | SHW1000UF10V8X12 | 1000uF | CAP-TH_BD8.0-P3.50-D0.6-FD | C494548 | KNSCHA(科尼盛) | 容值:1000uF;精度:±20%;额定电压:10V;纹波电流:-;等效串联电阻(ESR):-;
C10 | 1 | ERB16V470M8X12 | 470uF | CAP-TH_BD8.0-P3.50-D0.5-FD | C51953430 | JIERR(捷而瑞) | 容值:470uF;精度:±20%;额定电压:16V;纹波电流:750mA@100kHZ;等效串联电阻(ESR):125mΩ@100KHz;
C11 | 1 | GRM21BR61E226ME44L | 22uF | C0805 | C86816 | muRata(村田)
C12 | 1 | GRM21BR61E226ME44L | 22uF | C0805 | C86816 | muRata(村田)
C13 | 1 | GRM21BR61H106KE43L | 10uF | C0805 | C440198 | muRata(村田) | 容值:10uF;精度:±10%;额定电压:50V;温度系数:X5R;
C14 | 1 | CC0805KRX7R9BB104 | 100nF | C0805 | C49678 | YAGEO(国巨) | 容值:100nF;精度:±10%;额定电压:50V;温度系数:X7R;
C15 | 1 | CC0805KRX7R9BB104 | 100nF | C0805 | C49678 | YAGEO(国巨) | 容值:100nF;精度:±10%;额定电压:50V;温度系数:X7R;
C16 | 1 | GRM21BR61H106KE43L | 10uF | C0805 | C440198 | muRata(村田) | 容值:10uF;精度:±10%;额定电压:50V;温度系数:X5R;
C17 | 1 | CC0805KRX7R9BB104 | 100nF | C0805 | C49678 | YAGEO(国巨) | 容值:100nF;精度:±10%;额定电压:50V;温度系数:X7R;
C18 | 1 | GRM21BR61H106KE43L | 10uF | C0805 | C440198 | muRata(村田) | 容值:10uF;精度:±10%;额定电压:50V;温度系数:X5R;
C19 | 1 | CC0805KRX7R9BB104 | 100nF | C0805 | C49678 | YAGEO(国巨) | 容值:100nF;精度:±10%;额定电压:50V;温度系数:X7R;
D2 | 1 | NCD0805R1 |  | LED0805-RD | C84256 | 国星光电 | 灯头类型:-;发光颜色:红色;正向压降(Vf):1.6V~2.6V;功率:65mW;测试电流:25mA;波长:615nm~630nm;二极管配置:独立二极管;透镜颜色:-;色温:-;发光强度:195mcd;发光角度:130°;载带方式:正贴;工作温度:-30℃~+85℃;
EC1 | 1 | EC1106S |  | SW-SMD_EC1106S | C9900001788
F1 | 1 | 01530008Z |  | 01530008Z | C206907 | Littelfuse(美国力特) | 保险丝座类型:-;通道数:1;保险丝类型:刀片;
J1 | 1 | 22850120ANG1SYA01 |  | HDR-TH_20P-P2.54-V-F | C429947 | JILN(锦凌) | 插孔结构:1x20P;间距:2.54mm;行距:-;圆孔/方孔:方孔;安装方式:直插;排数:单排;总孔位数:20P;额定电流:3A;插孔方向:顶部;塑高:8.5mm;触头材质:黄铜;触头镀层:金;工作温度:-40℃~+105℃;
J2 | 1 | 22850120ANG1SYA01 |  | HDR-TH_20P-P2.54-V-F | C429947 | JILN(锦凌) | 插孔结构:1x20P;间距:2.54mm;行距:-;圆孔/方孔:方孔;安装方式:直插;排数:单排;总孔位数:20P;额定电流:3A;插孔方向:顶部;塑高:8.5mm;触头材质:黄铜;触头镀层:金;工作温度:-40℃~+105℃;
J3 | 1 | XH-10A |  | CONN-TH_10P-P2.50_HCTL_XH-10A | C2908608 | HCTL(华灿天禄) | 插针结构:1x10P;间距:2.5mm;安装方式:直插;参考系列:XH;总PIN数:10P;排数:1;每排PIN数:10;行距:-;额定电流:3A;触头材质:黄铜;触头镀层:锡;工作温度:-25℃~+85℃;
J4 | 1 | 长排针,2.54mm,6p |  | HDR-TH_6P-P2.54-V-M-A | C9900021383
J5 | 1 | 长排针,2.54mm,6p |  | HDR-TH_6P-P2.54-V-M-A | C9900021383
J6 | 1 | Type-C-16P |  | USB-C-SMD_GT-USB-7010E | C9900216560
J7 | 1 | XH-2A |  | CONN-TH_2P-P2.50_HCTL_XH-2A-X | C2908600 | HCTL(华灿天禄)
J10 | 1 | XH-2A |  | CONN-TH_2P-P2.50_HCTL_XH-2A-X | C2908600 | HCTL(华灿天禄)
JBAL | 1 | XH-3A |  | CONN-TH_XH-3A | C2908601 | HCTL(华灿天禄)
JBAT | 1 | XT30PW-M30.G.Y |  | CONN-TH_XT30PW-M | C431092 | AMASS(艾迈斯)
JP_CHG | 1 | B-2100S02P-A110 |  | HDR-TH_2P-P2.54-V-M-1 | C124375 | Ckmtw(灿科盟) | 插针结构:1x2P;间距:2.54mm;行距:-;圆针/方针:方针;安装方式:直插;排数:单排;总PIN位数:2P;额定电流:3A;额定电压:-;配合针长度:6mm;塑高:2.54mm;端接针长度:3mm;触头材质:黄铜;触头镀层:金;工作温度:-40℃~+105℃;颜色:黑色;
JP_LCD | 1 | B-2100S02P-A110 |  | HDR-TH_2P-P2.54-V-M-1 | C124375 | Ckmtw(灿科盟) | 插针结构:1x2P;间距:2.54mm;行距:-;圆针/方针:方针;安装方式:直插;排数:单排;总PIN位数:2P;额定电流:3A;额定电压:-;配合针长度:6mm;塑高:2.54mm;端接针长度:3mm;触头材质:黄铜;触头镀层:金;工作温度:-40℃~+105℃;颜色:黑色;
JP_MCU | 1 | B-2100S02P-A110 |  | HDR-TH_2P-P2.54-V-M-1 | C124375 | Ckmtw(灿科盟) | 插针结构:1x2P;间距:2.54mm;行距:-;圆针/方针:方针;安装方式:直插;排数:单排;总PIN位数:2P;额定电流:3A;额定电压:-;配合针长度:6mm;塑高:2.54mm;端接针长度:3mm;触头材质:黄铜;触头镀层:金;工作温度:-40℃~+105℃;颜色:黑色;
J_LOG_IN | 1 | KF301-5.0-2P |  | CONN-TH_P5.00_KF301-5.0-2P | C474881 | KEFA(科发)
J_LOG_OUT | 1 | KF301-5.0-2P |  | CONN-TH_P5.00_KF301-5.0-2P | C474881 | KEFA(科发)
J_SRV_IN | 1 | KF301-5.0-2P |  | CONN-TH_P5.00_KF301-5.0-2P | C474881 | KEFA(科发)
J_SRV_OUT | 1 | KF301-5.0-2P |  | CONN-TH_P5.00_KF301-5.0-2P | C474881 | KEFA(科发)
J_SW | 1 | KF301-5.0-2P |  | CONN-TH_P5.00_KF301-5.0-2P | C474881 | KEFA(科发)
L1 | 1 | 74437368022 | 2.2uH | IND-SMD_L11.0-W10.0 | C5240946 | Wurth(伍尔特)
Q1 | 1 | AO4406 |  | SOP-8_L4.9-W3.9-P1.27-LS6.0-BL | C5155212 | JSMSEMI(杰盛微) | 数量:1个N沟道;漏源电压(Vdss):30V;连续漏极电流(Id):11A;导通电阻(RDS(on)):10mΩ@10V;耗散功率(Pd):1.5W;阈值电压(Vgs(th)):1.2V;
Q2 | 1 | AO4406 |  | SOP-8_L4.9-W3.9-P1.27-LS6.0-BL | C5155212 | JSMSEMI(杰盛微) | 数量:1个N沟道;漏源电压(Vdss):30V;连续漏极电流(Id):11A;导通电阻(RDS(on)):10mΩ@10V;耗散功率(Pd):1.5W;阈值电压(Vgs(th)):1.2V;
Q3 | 1 | AO3400A |  | SOT-23-3_L2.9-W1.3-P1.90-LS2.4-BR | C20917 | AOS | 数量:1个N沟道;漏源电压(Vdss):30V;连续漏极电流(Id):5.7A;导通电阻(RDS(on)):48mΩ@2.5V;耗散功率(Pd):1.4W;阈值电压(Vgs(th)):1.45V;
Q4 | 1 | AO3400A |  | SOT-23-3_L2.9-W1.3-P1.90-LS2.4-BR | C20917 | AOS | 数量:1个N沟道;漏源电压(Vdss):30V;连续漏极电流(Id):5.7A;导通电阻(RDS(on)):48mΩ@2.5V;耗散功率(Pd):1.4W;阈值电压(Vgs(th)):1.45V;
R1 | 1 | 0805W8F3300T5E | 330Ω | R0805 | C17630 | UNI-ROYAL(厚声) | 电阻类型:厚膜电阻;阻值:330Ω;精度:±1%;功率:125mW;工作电压:150V;温度系数:±100ppm/℃;
R2 | 1 | 0805W8F3300T5E | 330Ω | R0805 | C17630 | UNI-ROYAL(厚声) | 电阻类型:厚膜电阻;阻值:330Ω;精度:±1%;功率:125mW;工作电压:150V;温度系数:±100ppm/℃;
R3 | 1 | 0805W8F1001T5E | 1kΩ | R0805 | C17513 | UNI-ROYAL(厚声) | 电阻类型:厚膜电阻;阻值:1kΩ;精度:±1%;功率:125mW;最大工作电压:150V;温度系数:±100ppm/℃;
R4 | 1 | 0805W8F1000T5E | 100Ω | R0805 | C17408 | UNI-ROYAL(厚声)
R5 | 1 | 0805W8F1000T5E | 100Ω | R0805 | C17408 | UNI-ROYAL(厚声)
R6 | 1 | 0805W8F500LT5E | 500mΩ | R0805 | C28319 | UNI-ROYAL(厚声)
R7 | 1 | 0805W8F1000T5E | 100Ω | R0805 | C17408 | UNI-ROYAL(厚声)
R8 | 1 | 0805W8F2553T5E | 255kΩ | R0805 | C17578 | UNI-ROYAL(厚声)
R9 | 1 | 0805W8F3302T5E | 33kΩ | R0805 | C17633 | UNI-ROYAL(厚声) | 电阻类型:厚膜电阻;阻值:33kΩ;精度:±1%;功率:125mW;工作电压:150V;温度系数:±100ppm/℃;
R10 | 1 | 0805W8F1003T5E | 100kΩ | R0805 | C149504 | UNI-ROYAL(厚声) | 电阻类型:厚膜电阻;阻值:100kΩ;精度:±1%;功率:125mW;工作电压:150V;温度系数:±100ppm/℃;
R11 | 1 | 0805W8F1002T5E | 10kΩ | R0805 | C17414 | UNI-ROYAL(厚声) | 电阻类型:厚膜电阻;阻值:10kΩ;精度:±1%;功率:125mW;工作电压:150V;温度系数:±100ppm/℃;
R12 | 1 | 0805W8F1002T5E | 10kΩ | R0805 | C17414 | UNI-ROYAL(厚声) | 电阻类型:厚膜电阻;阻值:10kΩ;精度:±1%;功率:125mW;工作电压:150V;温度系数:±100ppm/℃;
R13 | 1 | 0805W8F1002T5E | 10kΩ | R0805 | C17414 | UNI-ROYAL(厚声) | 电阻类型:厚膜电阻;阻值:10kΩ;精度:±1%;功率:125mW;工作电压:150V;温度系数:±100ppm/℃;
R14 | 1 | 0805W8F1002T5E | 10kΩ | R0805 | C17414 | UNI-ROYAL(厚声) | 电阻类型:厚膜电阻;阻值:10kΩ;精度:±1%;功率:125mW;工作电压:150V;温度系数:±100ppm/℃;
R15 | 1 | 0805W8F1002T5E | 10kΩ | R0805 | C17414 | UNI-ROYAL(厚声) | 电阻类型:厚膜电阻;阻值:10kΩ;精度:±1%;功率:125mW;工作电压:150V;温度系数:±100ppm/℃;
R16 | 1 | 0603WAF5101T5E | 5.1kΩ | R0603 | C23186 | UNI-ROYAL(厚声) | 电阻类型:厚膜电阻;阻值:5.1kΩ;精度:±1%;功率:100mW;工作电压:75V;温度系数:±100ppm/℃;
R17 | 1 | 0603WAF5101T5E | 5.1kΩ | R0603 | C23186 | UNI-ROYAL(厚声) | 电阻类型:厚膜电阻;阻值:5.1kΩ;精度:±1%;功率:100mW;工作电压:75V;温度系数:±100ppm/℃;
R18 | 1 | 1206W4F2200T5E | 220Ω | R1206 | C17957 | UNI-ROYAL(厚声)
R19 | 1 | 0805W8F1003T5E | 100kΩ | R0805 | C149504 | UNI-ROYAL(厚声) | 电阻类型:厚膜电阻;阻值:100kΩ;精度:±1%;功率:125mW;工作电压:150V;温度系数:±100ppm/℃;
R20 | 1 | 1206W4F2200T5E | 220Ω | R1206 | C17957 | UNI-ROYAL(厚声)
R21 | 1 | 0805W8F1003T5E | 100kΩ | R0805 | C149504 | UNI-ROYAL(厚声) | 电阻类型:厚膜电阻;阻值:100kΩ;精度:±1%;功率:125mW;工作电压:150V;温度系数:±100ppm/℃;
R22 | 1 | 0805W8F1203T5E | 120kΩ | R0805 | C17436 | UNI-ROYAL(厚声)
R23 | 1 | 0805W8F8202T5E | 82kΩ | R0805 | C17840 | UNI-ROYAL(厚声)
R24 | 1 | 0805W8F1003T5E | 100kΩ | R0805 | C149504 | UNI-ROYAL(厚声) | 电阻类型:厚膜电阻;阻值:100kΩ;精度:±1%;功率:125mW;工作电压:150V;温度系数:±100ppm/℃;
R26 | 1 | 0805W8F1002T5E | 10kΩ | R0805 | C17414 | UNI-ROYAL(厚声) | 电阻类型:厚膜电阻;阻值:10kΩ;精度:±1%;功率:125mW;工作电压:150V;温度系数:±100ppm/℃;
SV1 | 1 | PZ254V-11-03P |  | HDR-TH_3P-P2.54-V-M_PZ254V-11-03P | C2937625 | XFCN(兴飞) | 插针结构:1x3P;间距:2.54mm;行距:-;圆针/方针:方针;安装方式:直插;排数:单排;总PIN位数:3P;额定电流:3A;额定电压:250V;配合针长度:6.1mm;塑高:2.5mm;端接针长度:3mm;触头材质:黄铜;触头镀层:金;工作温度:-40℃~+105℃;颜色:黑色;
SV2 | 1 | PZ254V-11-03P |  | HDR-TH_3P-P2.54-V-M_PZ254V-11-03P | C2937625 | XFCN(兴飞) | 插针结构:1x3P;间距:2.54mm;行距:-;圆针/方针:方针;安装方式:直插;排数:单排;总PIN位数:3P;额定电流:3A;额定电压:250V;配合针长度:6.1mm;塑高:2.5mm;端接针长度:3mm;触头材质:黄铜;触头镀层:金;工作温度:-40℃~+105℃;颜色:黑色;
SV3 | 1 | PZ254V-11-03P |  | HDR-TH_3P-P2.54-V-M_PZ254V-11-03P | C2937625 | XFCN(兴飞) | 插针结构:1x3P;间距:2.54mm;行距:-;圆针/方针:方针;安装方式:直插;排数:单排;总PIN位数:3P;额定电流:3A;额定电压:250V;配合针长度:6.1mm;塑高:2.5mm;端接针长度:3mm;触头材质:黄铜;触头镀层:金;工作温度:-40℃~+105℃;颜色:黑色;
SV4 | 1 | PZ254V-11-03P |  | HDR-TH_3P-P2.54-V-M_PZ254V-11-03P | C2937625 | XFCN(兴飞) | 插针结构:1x3P;间距:2.54mm;行距:-;圆针/方针:方针;安装方式:直插;排数:单排;总PIN位数:3P;额定电流:3A;额定电压:250V;配合针长度:6.1mm;塑高:2.5mm;端接针长度:3mm;触头材质:黄铜;触头镀层:金;工作温度:-40℃~+105℃;颜色:黑色;
SV5 | 1 | PZ254V-11-03P |  | HDR-TH_3P-P2.54-V-M_PZ254V-11-03P | C2937625 | XFCN(兴飞) | 插针结构:1x3P;间距:2.54mm;行距:-;圆针/方针:方针;安装方式:直插;排数:单排;总PIN位数:3P;额定电流:3A;额定电压:250V;配合针长度:6.1mm;塑高:2.5mm;端接针长度:3mm;触头材质:黄铜;触头镀层:金;工作温度:-40℃~+105℃;颜色:黑色;
SV6 | 1 | PZ254V-11-03P |  | HDR-TH_3P-P2.54-V-M_PZ254V-11-03P | C2937625 | XFCN(兴飞) | 插针结构:1x3P;间距:2.54mm;行距:-;圆针/方针:方针;安装方式:直插;排数:单排;总PIN位数:3P;额定电流:3A;额定电压:250V;配合针长度:6.1mm;塑高:2.5mm;端接针长度:3mm;触头材质:黄铜;触头镀层:金;工作温度:-40℃~+105℃;颜色:黑色;
SV7 | 1 | PZ254V-11-03P |  | HDR-TH_3P-P2.54-V-M_PZ254V-11-03P | C2937625 | XFCN(兴飞) | 插针结构:1x3P;间距:2.54mm;行距:-;圆针/方针:方针;安装方式:直插;排数:单排;总PIN位数:3P;额定电流:3A;额定电压:250V;配合针长度:6.1mm;塑高:2.5mm;端接针长度:3mm;触头材质:黄铜;触头镀层:金;工作温度:-40℃~+105℃;颜色:黑色;
SV8 | 1 | PZ254V-11-03P |  | HDR-TH_3P-P2.54-V-M_PZ254V-11-03P | C2937625 | XFCN(兴飞) | 插针结构:1x3P;间距:2.54mm;行距:-;圆针/方针:方针;安装方式:直插;排数:单排;总PIN位数:3P;额定电流:3A;额定电压:250V;配合针长度:6.1mm;塑高:2.5mm;端接针长度:3mm;触头材质:黄铜;触头镀层:金;工作温度:-40℃~+105℃;颜色:黑色;
U1 | 1 | HY2120-CB |  | SOT-23-6_L2.9-W1.6-P0.95-LS2.8-BR | C116509 | HYCON(宏康)
U2 | 1 | HY2213-BB3A |  | SOT-23-6_L2.9-W1.6-P0.95-LS2.8-BR | C113632 | HYCON(宏康)
U3 | 1 | HY2213-BB3A |  | SOT-23-6_L2.9-W1.6-P0.95-LS2.8-BR | C113632 | HYCON(宏康)
U4 | 1 | IP2326 |  | VQFN-24_L4.0-W4.0-P0.50-BL-EP2.5 | C2832094 | INJOINIC(英集芯)
U7 | 1 | PCA9685PW,112 |  | TSSOP-28_L9.7-W4.4-P0.65-LS6.4-BL | C2688894 | NXP(恩智浦) | 类型:-;工作电压(DC):2.3V~5.5V;开关频率:200Hz;通道数:16;输出电压:5.5V;输出电流:25mA;调光:PWM;拓扑结构:-;
