xaiojie/papabot/hardware-selection/procurement/2026-09-12/立创报价单-20260913/立创商城BOM报价单-BOM260913000033.xls

立创商城BOM报价单
BOM配单编号：BOM260913000033 |  |  |  |  | 上传时间：2026-09-13 00:42:30 |  |  |  | 1.名称释义：MPQ--最小包装量；MOQ--最小起订量； 2.匹配结果为实时查询结果，库存和价格可能会有波动。如超过24小时，请在立创商城重新匹配后下单； 3.订货商品的价格仅供参考，请提交订单后确定。 4.如有部分物料未能成功匹配，需要整单购买，请联系商城客服。
BOM名称：立创商城-一键下单 |  |  |  |  | 采购套数：1
商品总价:￥230.88 (原价:￥246.43, 折扣:-￥15.55) 注：报价单总价不含待确认和无法匹配项 |  |  |  |  | 网址：https://bom.szlcsc.com/bom.html
原始需求 |  |  |  |  |  | 匹配结果 |  |  |  |  |  |  | 订单满足
原始型号 | 原始品牌 | 原始封装 | 原参数 | 立创编号 | 数量 | 匹配结果 | 商品名称 | 型号 | 品牌 | 封装 | 参数 | 目录 | 商品编号 | 商品链接 | 渠道 | 交期 | MOQ | MPQ | 库存 | 购买数量 | 单价(RMB) | 关税税率 | 小计(RMB) | 备注
 |  |  |  | C100114 | 5 | 系统匹配 | 2.54mm 封顶式 | 2.54短路帽闭口 | BOOMELE(博穆精密) | P=2.54mm | 结构：1x2 间距：2.54mm 开顶/封顶：封顶式 额定电流：3A 外壳颜色：黑色 是否长柄：无柄 | 连接器 | C100114 | https://item.szlcsc.com/101329.html | 现货 | 4小时内发货 | 50 | 2000 | 665250 | 50 | 0.057 | 0 | 2.85
 |  |  |  | C113632 | 2 | 系统匹配 | 单节锂电池充电平衡IC | HY2213-BB3A | HYCON(宏康) | SOT-23-6 | 芯片类型：均衡芯片 工作电压：1.5V~8V 最大充电电流：- 充电饱和电压：4.19V 放电截止电压：- 电池类型：锂电池 电池节数：1 工作温度：-40℃~+85℃ 电池温度检测：不支持 0V电池充电：不支持 静态电流(Iq)：2uA 均衡电流：- 接口类型：- 功能特性：电芯均衡 | 电源管理 | C113632 | https://item.szlcsc.com/114867.html | 现货 | 4小时内发货 | 5 | 3000 | 4575 | 5 | 0.7992 | 0 | 4.00
 |  |  |  | C116509 | 1 | 系统匹配 | 2节锂离子/锂聚合物电池组保护IC | HY2120-CB | HYCON(宏康) | SOT-23-6 | 芯片类型：保护芯片 工作电压：1.5V~10V 最大充电电流：- 充电饱和电压：4.28V 放电截止电压：2.9V 电池类型：锂电池 电池节数：2 工作温度：-40℃~+85℃ 电池温度检测：不支持 0V电池充电：支持 静态电流(Iq)：100nA 均衡电流：- 接口类型：- 功能特性：过充保护；过流保护；过放保护；短路保护 | 电源管理 | C116509 | https://item.szlcsc.com/117763.html | 现货 | 4小时内发货 | 5 | 3000 | 2900 | 5 | 1.4784 | 0 | 7.39
 |  |  |  | C124375 | 3 | 系统匹配 | 1x2P 间距:2.54mm 方针 直插 | B-2100S02P-A110 | Ckmtw(灿科盟) | 插件,P=2.54mm | 插针结构：1x2P 间距：2.54mm 行距：- 圆针/方针：方针 安装方式：直插 排数：单排 总PIN位数：2P 额定电流：3A 额定电压：- 配合针长度：6mm 塑高：2.54mm 端接针长度：3mm 触头材质：黄铜 触头镀层：金 工作温度：-40℃~+105℃ 颜色：黑色 | 连接器 | C124375 | https://item.szlcsc.com/125650.html | 现货 | 4小时内发货 | 20 | 5000 | 127840 | 20 | 0.17347 | 0 | 3.47
 |  |  |  | C149504 | 4 | 系统匹配 | 厚膜电阻 100kΩ ±1% 125mW | 0805W8F1003T5E | UNI-ROYAL(厚声) | 0805 | 电阻类型：厚膜电阻 阻值：100kΩ 精度：±1% 功率：125mW 工作电压：150V 温度系数：±100ppm/℃ 工作温度：-55℃~+155℃ | 电阻 | C149504 | https://item.szlcsc.com/160838.html | 现货 | 4小时内发货 | 100 | 5000 | 3774300 | 100 | 0.0361 | 0 | 3.61
 |  |  |  | C165948 | 1 | 系统匹配 | Type-C 母 卧贴 | TYPE-C-31-M-12 | 韩国韩荣 | SMD | 连接器类型：Type-C 协议标准：- 公母：母 安装方式：卧贴 触点数量：16P 端口数量：1 额定电流 - 电源：5A 额定电压：20V 插拔寿命：1万次 体长(L)：7.35mm 工作温度：-30℃~+80℃ | 连接器 | C165948 | https://item.szlcsc.com/177331.html | 现货 | 4小时内发货 | 5 | 1000 | 233085 | 5 | 1.051008 | 0 | 5.26
 |  |  |  | C17408 | 3 | 系统匹配 | 厚膜电阻 100Ω ±1% 125mW | 0805W8F1000T5E | UNI-ROYAL(厚声) | 0805 | 电阻类型：厚膜电阻 阻值：100Ω 精度：±1% 功率：125mW 工作电压：150V 温度系数：±100ppm/℃ 工作温度：-55℃~+155℃ | 电阻 | C17408 | https://item.szlcsc.com/18096.html | 现货 | 4小时内发货 | 100 | 5000 | 8404100 | 100 | 0.0271 | 0 | 2.71
 |  |  |  | C17414 | 3 | 系统匹配 | 厚膜电阻 10kΩ ±1% 125mW | 0805W8F1002T5E | UNI-ROYAL(厚声) | 0805 | 电阻类型：厚膜电阻 阻值：10kΩ 精度：±1% 功率：125mW 工作电压：150V 温度系数：±100ppm/℃ 工作温度：-55℃~+155℃ | 电阻 | C17414 | https://item.szlcsc.com/18102.html | 现货 | 4小时内发货 | 100 | 5000 | 47106100 | 100 | 0.0235 | 0 | 2.35
 |  |  |  | C17436 | 1 | 系统匹配 | 厚膜电阻 120kΩ ±1% 125mW | 0805W8F1203T5E | UNI-ROYAL(厚声) | 0805 | 电阻类型：厚膜电阻 阻值：120kΩ 精度：±1% 功率：125mW 工作电压：150V 温度系数：±100ppm/℃ 工作温度：-55℃~+155℃ | 电阻 | C17436 | https://item.szlcsc.com/18124.html | 现货 | 4小时内发货 | 100 | 5000 | 83500 | 100 | 0.0371 | 0 | 3.71
 |  |  |  | C17513 | 1 | 系统匹配 | 厚膜电阻 1kΩ ±1% 125mW | 0805W8F1001T5E | UNI-ROYAL(厚声) | 0805 | 电阻类型：厚膜电阻 阻值：1kΩ 精度：±1% 功率：125mW 工作电压：150V 温度系数：±100ppm/℃ 工作温度：-55℃~+155℃ | 电阻 | C17513 | https://item.szlcsc.com/18201.html | 现货 | 4小时内发货 | 100 | 5000 | 26202800 | 100 | 0.0253 | 0 | 2.53
 |  |  |  | C17578 | 1 | 系统匹配 | 厚膜电阻 255kΩ ±1% 125mW | 0805W8F2553T5E | UNI-ROYAL(厚声) | 0805 | 电阻类型：厚膜电阻 阻值：255kΩ 精度：±1% 功率：125mW 工作电压：150V 温度系数：±100ppm/℃ 工作温度：-55℃~+155℃ | 电阻 | C17578 | https://item.szlcsc.com/18266.html | 现货 | 4小时内发货 | 100 | 5000 | 1200 | 100 | 0.014 | 0 | 1.40
 |  |  |  | C17630 | 2 | 系统匹配 | 厚膜电阻 330Ω ±1% 125mW | 0805W8F3300T5E | UNI-ROYAL(厚声) | 0805 | 电阻类型：厚膜电阻 阻值：330Ω 精度：±1% 功率：125mW 工作电压：150V 温度系数：±100ppm/℃ 工作温度：-55℃~+155℃ | 电阻 | C17630 | https://item.szlcsc.com/18318.html | 现货 | 4小时内发货 | 100 | 5000 | 1861200 | 100 | 0.0326 | 0 | 3.26
 |  |  |  | C17633 | 1 | 系统匹配 | 厚膜电阻 33kΩ ±1% 125mW | 0805W8F3302T5E | UNI-ROYAL(厚声) | 0805 | 电阻类型：厚膜电阻 阻值：33kΩ 精度：±1% 功率：125mW 工作电压：150V 温度系数：±100ppm/℃ 工作温度：-55℃~+155℃ | 电阻 | C17633 | https://item.szlcsc.com/18321.html | 现货 | 4小时内发货 | 100 | 5000 | 394600 | 100 | 0.028017 | 0 | 2.80
 |  |  |  | C17840 | 1 | 系统匹配 | 厚膜电阻 82kΩ ±1% 125mW | 0805W8F8202T5E | UNI-ROYAL(厚声) | 0805 | 电阻类型：厚膜电阻 阻值：82kΩ 精度：±1% 功率：125mW 工作电压：150V 温度系数：±100ppm/℃ 工作温度：-55℃~+155℃ | 电阻 | C17840 | https://item.szlcsc.com/18528.html | 现货 | 4小时内发货 | 100 | 5000 | 103300 | 100 | 0.0319 | 0 | 3.19
 |  |  |  | C17957 | 2 | 系统匹配 | 厚膜电阻 220Ω ±1% 250mW | 1206W4F2200T5E | UNI-ROYAL(厚声) | 1206 | 电阻类型：厚膜电阻 阻值：220Ω 精度：±1% 功率：250mW 工作电压：200V 温度系数：±100ppm/℃ 工作温度：-55℃~+155℃ | 电阻 | C17957 | https://item.szlcsc.com/18645.html | 现货 | 4小时内发货 | 100 | 5000 | 43800 | 100 | 0.0489 | 0 | 4.89
 |  |  |  | C206907 | 1 | 系统匹配 | ACS FUSEHLDR VERTICAL MT | 01530008Z | Littelfuse(美国力特) | 插件 | 保险丝座类型：- 通道数：1 额定电压：32V 额定电流：20A 保险丝类型：刀片 保险丝长度：11mm 保险丝宽度：3.8mm | TVS/保险丝/板级保护 | C206907 | https://item.szlcsc.com/208026.html | 现货 | 4小时内发货 | 1 | 500 | 417 | 1 | 24.35 | 0 | 24.35
 |  |  |  | C20917 | 2 | 系统匹配 | N沟道 耐压:30V | AO3400A | AOS | SOT-23 | 数量：1个N沟道 漏源电压(Vdss)：30V 连续漏极电流(Id)：5.7A 导通电阻(RDS(on))：48mΩ@2.5V 耗散功率(Pd)：1.4W 阈值电压(Vgs(th))：1.45V 栅极电荷量(Qg)：7nC@10V 输入电容(Ciss)：630pF 反向传输电容(Crss)：50pF 工作温度：-55℃~+150℃ 配置：- 类型：N沟道 输出电容(Coss)：75pF 栅极电压(Vgs)：±12V | 三极管/MOS管/晶体管 | C20917 | https://item.szlcsc.com/21629.html | 现货 | 4小时内发货 | 5 | 3000 | 499055 | 5 | 0.52 | 0 | 2.60
 |  |  |  | C23186 | 2 | 系统匹配 | 厚膜电阻 5.1kΩ ±1% 100mW | 0603WAF5101T5E | UNI-ROYAL(厚声) | 0603 | 电阻类型：厚膜电阻 阻值：5.1kΩ 精度：±1% 功率：100mW 工作电压：75V 温度系数：±100ppm/℃ 工作温度：-55℃~+155℃ | 电阻 | C23186 | https://item.szlcsc.com/23913.html | 现货 | 4小时内发货 | 100 | 5000 | 20401100 | 100 | 0.0112 | 0 | 1.12
 |  |  |  | C2678753 | 1 | 系统匹配 | 16通道、12位PWM Fm+ I2C总线LED控制器 | PCA9685PW,118 | NXP(恩智浦) | TSSOP-28 | 类型：- 工作电压(DC)：2.3V~5.5V 开关频率：100kHz~1MHz 通道数：16 输出电压：5.5V 输出电流：25mA 调光：PWM 功能特性：- 工作温度：-40℃~+85℃ 开关管(内置/外置)：内置 | 数码管驱动/LED驱动 | C2678753 | https://item.szlcsc.com/2770670.html | 现货 | 4小时内发货 | 1 | 2500 | 455 | 1 | 17.66 | 0 | 17.66
 |  |  |  | C2832094 | 1 | 系统匹配 | 支持15W快充的2节/3节串联锂电池升压充电IC | IP2326 | INJOINIC(英集芯) | VQFN-24-EP(4x4) | 芯片类型：充电芯片；均衡芯片 工作电压：4.5V~9.5V 最大充电电流：1.5A 充电饱和电压：8.4V 放电截止电压：- 电池类型：锂电池 电池节数：2~3 工作温度：-40℃~+150℃ 电池温度检测：支持 0V电池充电：- 静态电流(Iq)：700nA 均衡电流：- 接口类型：- 功能特性：过流保护；恒压充电；恒流充电；电芯均衡；自动再充电；充电终止；可编程充电电流；过压保护；欠压锁定；涓流充电 | 电源管理 | C2832094 | https://item.szlcsc.com/2988389.html | 现货 | 4小时内发货 | 1 | 5000 | 18974 | 1 | 3.8 | 0 | 3.80
 |  |  |  | C2908600 | 2 | 系统匹配 | 1x2P 间距:2.5mm 直插 系列:XH | XH-2A | HCTL(华灿天禄) | 插件,P=2.5mm | 插针结构：1x2P 间距：2.5mm 安装方式：直插 参考系列：XH 总PIN数：2P 排数：1 每排PIN数：2 行距：- 额定电流：3A 触头材质：黄铜 触头镀层：锡 工作温度：-25℃~+85℃ 额定电压：250V 塑料材质：PA66 阻燃等级：UL94V-0 Z轴-板上高度：7mm Y轴-板上底边宽度：5.9mm | 连接器 | C2908600 | https://item.szlcsc.com/3184371.html | 现货 | 4小时内发货 | 50 | 1000 | 259850 | 50 | 0.0923 | 0 | 4.62
 |  |  |  | C2908601 | 1 | 系统匹配 | 1x3P 间距:2.5mm 直插 系列:XH | XH-3A | HCTL(华灿天禄) | 插件,P=2.5mm | 插针结构：1x3P 间距：2.5mm 安装方式：直插 参考系列：XH 总PIN数：3P 排数：1 每排PIN数：3 行距：- 额定电流：3A 触头材质：黄铜 触头镀层：锡 工作温度：-25℃~+85℃ 额定电压：250V 塑料材质：PA66 阻燃等级：UL94V-0 Z轴-板上高度：7mm Y轴-板上底边宽度：5.9mm | 连接器 | C2908601 | https://item.szlcsc.com/3184372.html | 现货 | 4小时内发货 | 50 | 1000 | 45200 | 50 | 0.123 | 0 | 6.15
 |  |  |  | C2908608 | 1 | 系统匹配 | 1x10P 间距:2.5mm 直插 系列:XH | XH-10A | HCTL(华灿天禄) | 插件,P=2.5mm | 插针结构：1x10P 间距：2.5mm 安装方式：直插 参考系列：XH 总PIN数：10P 排数：1 每排PIN数：10 行距：- 额定电流：3A 触头材质：黄铜 触头镀层：锡 工作温度：-25℃~+85℃ 额定电压：250V 塑料材质：PA66 阻燃等级：UL94V-0 Z轴-板上高度：7mm Y轴-板上底边宽度：5.9mm | 连接器 | C2908608 | https://item.szlcsc.com/3184379.html | 现货 | 4小时内发货 | 10 | 1000 | 8110 | 10 | 0.3696 | 0 | 3.70
 |  |  |  | C2937625 | 8 | 系统匹配 | 1x3P 间距:2.54mm 方针 直插 | PZ254V-11-03P | XFCN(兴飞) | 插件,P=2.54mm | 插针结构：1x3P 间距：2.54mm 行距：- 圆针/方针：方针 安装方式：直插 排数：单排 总PIN位数：3P 额定电流：3A 额定电压：250V 配合针长度：6.1mm 塑高：2.5mm 端接针长度：3mm 触头材质：黄铜 触头镀层：金 工作温度：-40℃~+105℃ 颜色：黑色 附加特征：- | 连接器 | C2937625 | https://item.szlcsc.com/3293280.html | 现货 | 4小时内发货 | 50 | 2000 | 1090250 | 50 | 0.114475 | 0 | 5.72
 |  |  |  | C37208 | 2 | 系统匹配 | 1x6P 间距:2.54mm 方针 直插 | 2.54-1x6P直针 | BOOMELE(博穆精密) | 插件,P=2.54mm | 插针结构：1x6P 间距：2.54mm 行距：- 圆针/方针：方针 安装方式：直插 排数：单排 总PIN位数：6P 额定电流：3A 额定电压：- 配合针长度：6mm 塑高：2.5mm 端接针长度：3mm 触头材质：黄铜 触头镀层：金 工作温度：-40℃~+105℃ 颜色：黑色 | 连接器 | C37208 | https://item.szlcsc.com/38187.html | 现货 | 4小时内发货 | 10 | 1000 | 305580 | 10 | 0.2547 | 0 | 2.55
 |  |  |  | C429947 | 2 | 系统匹配 | 1x20P 间距:2.54mm 直插 | 22850120ANG1SYA01 | JILN(锦凌) | 插件,P=2.54mm | 插孔结构：1x20P 间距：2.54mm 行距：- 圆孔/方孔：方孔 安装方式：直插 排数：单排 总孔位数：20P 额定电流：3A 插孔方向：顶部 塑高：8.5mm 触头材质：黄铜 触头镀层：金 工作温度：-40℃~+105℃ | 连接器 | C429947 | https://item.szlcsc.com/426399.html | 现货 | 4小时内发货 | 5 | 160 | 2250 | 5 | 1.0612 | 0 | 5.31
 |  |  |  | C431092 | 1 | 系统匹配 | AMASS(艾迈斯)航模插头电调机插座锂电池连接器 PCB板卧式 公头XT30PW-M30.G.Y | XT30PW-M30.G.Y | AMASS(艾迈斯) | - | 额定电流：15A 额定电压：500VDC 类型：航模插头 线规：16/18/20AWG 接触电阻：1.2mΩ 尺码/规格：2pin 接口形态：公头 | 工控电气 | C431092 | https://item.szlcsc.com/426930.html | 现货 | 4小时内发货 | 1 | 500 | 73959 | 1 | 2.35 | 0 | 2.35
 |  |  |  | C440198 | 6 | 系统匹配 | 10uF ±10% 50V | GRM21BR61H106KE43L | muRata(村田) | 0805 | 容值：10uF 精度：±10% 额定电压：50V 温度系数：X5R | 电容 | C440198 | https://item.szlcsc.com/439567.html | 现货 | 4小时内发货 | 5 | 3000 | 235080 | 10 | 1.5343 | 0 | 15.34
 |  |  |  | C474881 | 5 | 系统匹配 | 1x2P 5mm 直插 排数:1 每排P数:2 | KF301-5.0-2P | KEFA(科发) | 插件,P=5mm | 结构：1x2P 间距：5mm 颜色：蓝色 安装类型：直插 总PIN数：2P 排数：1 每排PIN数：2 螺钉规格：M2.5 额定电流：17A 额定电压：250V 线规 - AWG：14~22 线规 - 平方毫米：1.5 工作温度：-30℃~+120℃ 板上高度：10mm | 连接器 | C474881 | https://item.szlcsc.com/481499.html | 现货 | 4小时内发货 | 5 | 1000 | 51400 | 5 | 0.6193 | 0 | 3.10
 |  |  |  | C494548 | 1 | 系统匹配 | 1000uF ±20% 10V | SHW1000UF10V8X12 | KNSCHA(科尼盛) | 插件,D8xL12mm | 容值：1000uF 精度：±20% 额定电压：10V 纹波电流：- 等效串联电阻(ESR)：- 脚间距：3.5mm 电容体直径：8mm 电容体长度：12mm 工作寿命：10000hrs@105℃ | 电容 | C494548 | https://item.szlcsc.com/505124.html | 现货 | 4小时内发货 | 5 | 500 | 3915 | 5 | 0.531608 | 0 | 2.66
 |  |  |  | C49678 | 9 | 系统匹配 | 100nF ±10% 50V | CC0805KRX7R9BB104 | YAGEO(国巨) | 0805 | 容值：100nF 精度：±10% 额定电压：50V 温度系数：X7R | 电容 | C49678 | https://item.szlcsc.com/50686.html | 现货 | 4小时内发货 | 20 | 4000 | 10169340 | 20 | 0.1203 | 0 | 2.41
 |  |  |  | C5155212 | 2 | 系统匹配 | 1个N沟道 耐压:30V 电流:11A | AO4406 | JSMSEMI(杰盛微) | SOP-8 | 数量：1个N沟道 漏源电压(Vdss)：30V 连续漏极电流(Id)：11A 导通电阻(RDS(on))：10mΩ@10V 耗散功率(Pd)：1.5W 阈值电压(Vgs(th))：1.2V 栅极电荷量(Qg)：9.63nC 输入电容(Ciss)：940pF 反向传输电容(Crss)：153pF 工作温度：-55℃~+150℃ 类型：N沟道 输出电容(Coss)：131pF 栅极电压(Vgs)：±20V | 三极管/MOS管/晶体管 | C5155212 | https://item.szlcsc.com/5784496.html | 现货 | 4小时内发货 | 5 | 3000 | 5485 | 5 | 0.74052 | 0 | 3.70
 |  |  |  | C51953430 | 1 | 系统匹配 | 470uF ±20% 16V | ERB16V470M8X12 | JIERR(捷而瑞) | 插件,D8xL12mm | 容值：470uF 精度：±20% 额定电压：16V 纹波电流：750mA@100kHZ 等效串联电阻(ESR)：125mΩ@100KHz 电容体直径：8mm 电容体长度：12mm 工作寿命：7000hrs@105℃ 工作温度：-40℃~+105℃ | 电容 | C51953430 | https://item.szlcsc.com/54681555.html | 现货 | 4小时内发货 | 10 | 500 | 480 | 10 | 0.38855 | 0 | 3.89
 |  |  |  | C5240946 | 1 | 系统匹配 | 2.2uH ±20% 28A | 74437368022 | Wurth(伍尔特) | SMD,11x10mm | 电感值：2.2uH 精度：±20% 额定电流：10A 饱和电流(Isat)：28A 直流电阻(DCR)：7mΩ 类型：- | 电感/线圈/变压器 | C5240946 | https://item.szlcsc.com/5947392.html | 现货 | 4小时内发货 | 1 | 500 | 387 | 1 | 15.35 | 0 | 15.35
 |  |  |  | C5329587 | 1 | 系统匹配 | 2.4寸240*320(RGB)彩色SPI串口TFT液晶显示屏 | HS24S010B | HS(汉昇) | - | 核心芯片：ST7789 接口类型：SPI 尺寸(inch)：2.4 像素分辨率：320x240 工作温度：-20℃~+70℃ 显示范围：37.72x49.96mm 视角方向：全视角 工作电压：3.3V | 显示屏 | C5329587 | https://item.szlcsc.com/6087848.html | 现货 | 4小时内发货 | 1 | 1 | 36 | 1 | 34.3664 | 0 | 34.37
 |  |  |  | C5360454 | 2 | 系统匹配 | 1x2P 2.5mm | WAFER-XH2.54-2PJK | XUNPU(讯普) | P=2.5mm | 插孔结构：1x2P 间距：2.5mm 参考系列：XH 行距：- 排数：1 每排PIN数：2 颜色：白色 是否带锁扣：不带锁扣 是否带翅：不带翅 塑料材质：PA66 阻燃等级：UL94V-0 工作温度：-25℃~+85℃ 公母：公 | 连接器 | C5360454 | https://item.szlcsc.com/6178130.html | 现货 | 4小时内发货 | 50 | 2000 | 9850 | 50 | 0.05292 | 0 | 2.65
 |  |  |  | C5360455 | 1 | 系统匹配 | 1x3P 2.5mm | WAFER-XH2.54-3PJK | XUNPU(讯普) | P=2.5mm | 插孔结构：1x3P 间距：2.5mm 参考系列：XH 行距：- 排数：1 每排PIN数：3 颜色：白色 是否带锁扣：不带锁扣 是否带翅：不带翅 塑料材质：PA66 阻燃等级：UL94V-0 工作温度：-25℃~+85℃ 公母：公 | 连接器 | C5360455 | https://item.szlcsc.com/6178131.html | 现货 | 4小时内发货 | 50 | 2000 | 2950 | 50 | 0.0774 | 0 | 3.87
 |  |  |  | C5360462 | 1 | 系统匹配 | 1x10P 2.5mm | WAFER-XH2.54-10PJK | XUNPU(讯普) | P=2.5mm | 插孔结构：1x10P 间距：2.5mm 参考系列：XH 行距：- 排数：1 每排PIN数：10 颜色：白色 是否带锁扣：不带锁扣 是否带翅：不带翅 塑料材质：PA66 阻燃等级：UL94V-0 工作温度：-25℃~+85℃ 公母：公 | 连接器 | C5360462 | https://item.szlcsc.com/6178138.html | 现货 | 4小时内发货 | 10 | 1000 | 180 | 10 | 0.15768 | 0 | 1.58
 |  |  |  | C5360463 | 30 | 系统匹配 | XH 2.54mm 端子 | WAFER-XH2.54-DZ | XUNPU(讯普) | - | 参考系列：XH 线规 - AWG：22~30 允许绝缘外径 (OD)：- 触头材质：磷青铜 触头镀层：锡 | 连接器 | C5360463 | https://item.szlcsc.com/6178139.html | 现货 | 4小时内发货 | 50 | 7000 | 71400 | 50 | 0.08118 | 0 | 4.06
 |  |  |  | C602037 | 2 | 系统匹配 | 22uF ±20% 25V | CL21A226MAYNNNE | SAMSUNG(三星) | 0805 | 容值：22uF 精度：±20% 额定电压：25V 温度系数：X5R | 电容 | C602037 | https://item.szlcsc.com/631473.html | 现货 | 4小时内发货 | 10 | 2000 | 342300 | 10 | 1.0281 | 0 | 10.28
 |  |  |  | C84256 | 1 | 系统匹配 | 片式发光二极管 | NCD0805R1 | 国星光电 | 0805 | 灯头类型：1.2mm方形灯头 发光颜色：红色 正向压降(Vf)：1.6V~2.6V 功率：65mW 测试电流：25mA 波长：615nm~630nm 峰值波长：630nm 二极管配置：独立二极管 透镜颜色：无色透明透镜 色温：- 发光强度：195mcd 发光角度：130° 载带方式：正贴 工作温度：-30℃~+85℃ 半波宽：15nm 发光材料：- 光通量(25℃)：- 抗静电能力：- | 光电器件 | C84256 | https://item.szlcsc.com/85425.html | 现货 | 4小时内发货 | 50 | 3000 | 5191850 | 50 | 0.082 | 0 | 4.10
