xaiojie/papabot/pcb-design/integrated-v1/repair-2026-09-12/generated/当前引脚网络表.csv

位号 | 引脚 | 网络 | 状态
C1 | 1 | PROT_VDD | 已连接
C1 | 2 | VBAT_RAW_N | 已连接
C10 | 1 | +5V_LOGIC | 已连接
C10 | 2 | GND | 已连接
C11 | 1 | CHG_VSYS | 已连接
C11 | 2 | GND | 已连接
C12 | 1 | CHG_VSYS | 已连接
C12 | 2 | GND | 已连接
C13 | 1 | VBAT_FUSED | 已连接
C13 | 2 | GND | 已连接
C14 | 1 | ADC_BAT | 已连接
C14 | 2 | GND | 已连接
C15 | 1 | LCD_3V3 | 已连接
C15 | 2 | GND | 已连接
C16 | 1 | LCD_3V3 | 已连接
C16 | 2 | GND | 已连接
C17 | 1 | +3V3 | 已连接
C17 | 2 | GND | 已连接
C18 | 1 | +3V3 | 已连接
C18 | 2 | GND | 已连接
C19 | 1 | +5V_SERVO | 已连接
C19 | 2 | GND | 已连接
C2 | 1 | PROT_VC | 已连接
C2 | 2 | VBAT_RAW_N | 已连接
C3 | 1 | BAL1_VDD | 已连接
C3 | 2 | VBAT_RAW_N | 已连接
C4 | 1 | BAL2_VDD | 已连接
C4 | 2 | BM | 已连接
C5 | 1 | CHG_VIN | 已连接
C5 | 2 | GND | 已连接
C6 | 1 | VBUS | 已连接
C6 | 2 | GND | 已连接
C7 | 1 | VBAT_FUSED | 已连接
C7 | 2 | GND | 已连接
C8 | 1 | BST_CAP | 已连接
C8 | 2 | SW_CHG | 已连接
C9 | 1 | +5V_SERVO | 已连接
C9 | 2 | GND | 已连接
D2 | 1 | GND | 已连接
D2 | 2 | LED_A | 已连接
EC1 | 1 | ENC_A | 已连接
EC1 | 2 | GND | 已连接
EC1 | 3 | ENC_B | 已连接
EC1 | 4 | ENC_SW_N | 已连接
EC1 | 5 | GND | 已连接
EC1 | 6 | GND | 已连接
EC1 | 7 | GND | 已连接
F1 | 1 | VBAT_RAW_P | 已连接
F1 | 2 | VBAT_FUSED | 已连接
J1 | 1 |  | NC/有意不连接
J1 | 2 |  | NC/有意不连接
J1 | 3 |  | NC/有意不连接
J1 | 4 |  | NC/有意不连接
J1 | 5 | AMP_BCLK | 已连接
J1 | 6 | AMP_WS | 已连接
J1 | 7 | AMP_DIN | 已连接
J1 | 8 |  | NC/有意不连接
J1 | 9 | GND | 已连接
J1 | 10 | LCD_RST_N | 已连接
J1 | 11 |  | NC/有意不连接
J1 | 12 |  | NC/有意不连接
J1 | 13 | ENC_SW_N | 已连接
J1 | 14 |  | NC/有意不连接
J1 | 15 |  | NC/有意不连接
J1 | 16 |  | NC/有意不连接
J1 | 17 | MCU_5V | 已连接
J1 | 18 | MCU_5V | 已连接
J1 | 19 | MCU_5V | 已连接
J1 | 20 | GND | 已连接
J10 | 1 | LCD_3V3 | 已连接
J10 | 2 | GND | 已连接
J2 | 1 | ADC_BAT | 已连接
J2 | 2 | ENC_B | 已连接
J2 | 3 |  | NC/有意不连接
J2 | 4 | MIC_BCLK | 已连接
J2 | 5 | MIC_WS | 已连接
J2 | 6 | MIC_SD | 已连接
J2 | 7 | GND | 已连接
J2 | 8 | ENC_A | 已连接
J2 | 9 | PCA_SDA | 已连接
J2 | 10 | PCA_SCL | 已连接
J2 | 11 | PCA_OE | 已连接
J2 | 12 | LCD_MOSI | 已连接
J2 | 13 | LCD_SCLK | 已连接
J2 | 14 | LCD_CS_N | 已连接
J2 | 15 | LCD_DC | 已连接
J2 | 16 |  | NC/有意不连接
J2 | 17 | +3V3 | 已连接
J2 | 18 | +3V3 | 已连接
J2 | 19 | +3V3 | 已连接
J2 | 20 | GND | 已连接
J3 | 1 | GND | 已连接
J3 | 2 | LCD_3V3 | 已连接
J3 | 3 | LCD_SCLK | 已连接
J3 | 4 | LCD_MOSI | 已连接
J3 | 5 | LCD_RST_N | 已连接
J3 | 6 | LCD_DC | 已连接
J3 | 7 | LCD_CS_N | 已连接
J3 | 8 | LCD_3V3 | 已连接
J3 | 9 |  | NC/有意不连接
J3 | 10 |  | NC/有意不连接
J3 | 11 |  | NC/有意不连接
J3 | 12 |  | NC/有意不连接
J3 | 13 |  | NC/有意不连接
J3 | 14 |  | NC/有意不连接
J3 | 15 |  | NC/有意不连接
J3 | 16 |  | NC/有意不连接
J3 | 17 |  | NC/有意不连接
J3 | 18 |  | NC/有意不连接
J3 | 19 |  | NC/有意不连接
J3 | 20 |  | NC/有意不连接
J4 | 1 | MIC_BCLK | 已连接
J4 | 2 | MIC_WS | 已连接
J4 | 3 | MIC_SD | 已连接
J4 | 4 | +3V3 | 已连接
J4 | 5 | GND | 已连接
J4 | 6 | GND | 已连接
J5 | 1 | AMP_BCLK | 已连接
J5 | 2 | AMP_WS | 已连接
J5 | 3 | AMP_DIN | 已连接
J5 | 4 | +5V_LOGIC | 已连接
J5 | 5 | GND | 已连接
J5 | 6 | GND | 已连接
J6 | 1 | GND | 已连接
J6 | 2 | GND | 已连接
J6 | 3 | GND | 已连接
J6 | 4 | GND | 已连接
J6 | B8 |  | NC/有意不连接
J6 | B7 |  | NC/有意不连接
J6 | B6 |  | NC/有意不连接
J6 | B5 | CC2 | 已连接
J6 | A8 |  | NC/有意不连接
J6 | A7 |  | NC/有意不连接
J6 | A6 |  | NC/有意不连接
J6 | A5 | CC1 | 已连接
J6 | B1A12 | GND | 已连接
J6 | B4A9 | VBUS | 已连接
J6 | A4B9 | VBUS | 已连接
J6 | A1B12 | GND | 已连接
J7 | 1 | NTC | 已连接
J7 | 2 | GND | 已连接
JBAL | 1 | VBAT_RAW_N | 已连接
JBAL | 2 | BM | 已连接
JBAL | 3 | VBAT_RAW_P | 已连接
JBAT | 1 | VBAT_RAW_N | 已连接
JBAT | 2 | VBAT_RAW_P | 已连接
JBAT | 3 |  | NC/有意不连接
JBAT | 4 |  | NC/有意不连接
JP_CHG | 1 | CHG_VIN | 已连接
JP_CHG | 2 | CHG_EN | 已连接
JP_LCD | 1 | +3V3 | 已连接
JP_LCD | 2 | LCD_3V3 | 已连接
JP_MCU | 1 | +5V_LOGIC | 已连接
JP_MCU | 2 | MCU_5V | 已连接
J_LOG_IN | 1 | VBAT_SW | 已连接
J_LOG_IN | 2 | GND | 已连接
J_LOG_OUT | 1 | +5V_LOGIC | 已连接
J_LOG_OUT | 2 | GND | 已连接
J_SRV_IN | 1 | VBAT_SW | 已连接
J_SRV_IN | 2 | GND | 已连接
J_SRV_OUT | 1 | +5V_SERVO | 已连接
J_SRV_OUT | 2 | GND | 已连接
J_SW | 1 | VBAT_FUSED | 已连接
J_SW | 2 | VBAT_SW | 已连接
L1 | 1 | VBUS | 已连接
L1 | 2 | SW_CHG | 已连接
Q1 | 1 | GND | 已连接
Q1 | 2 | GND | 已连接
Q1 | 3 | GND | 已连接
Q1 | 4 | COUT_GATE | 已连接
Q1 | 5 | MOS_MID | 已连接
Q1 | 6 | MOS_MID | 已连接
Q1 | 7 | MOS_MID | 已连接
Q1 | 8 | MOS_MID | 已连接
Q2 | 1 | VBAT_RAW_N | 已连接
Q2 | 2 | VBAT_RAW_N | 已连接
Q2 | 3 | VBAT_RAW_N | 已连接
Q2 | 4 | DOUT_GATE | 已连接
Q2 | 5 | MOS_MID | 已连接
Q2 | 6 | MOS_MID | 已连接
Q2 | 7 | MOS_MID | 已连接
Q2 | 8 | MOS_MID | 已连接
Q3 | 1 | BAL1_GATE | 已连接
Q3 | 2 | VBAT_RAW_N | 已连接
Q3 | 3 | BAL1_BLEED | 已连接
Q4 | 1 | BAL2_GATE | 已连接
Q4 | 2 | BM | 已连接
Q4 | 3 | BAL2_BLEED | 已连接
R1 | 1 | VBAT_RAW_P | 已连接
R1 | 2 | PROT_VDD | 已连接
R10 | 1 | VBAT_SW | 已连接
R10 | 2 | ADC_BAT | 已连接
R11 | 1 | +3V3 | 已连接
R11 | 2 | ENC_A | 已连接
R12 | 1 | +3V3 | 已连接
R12 | 2 | ENC_B | 已连接
R13 | 1 | +3V3 | 已连接
R13 | 2 | PCA_SDA | 已连接
R14 | 1 | +3V3 | 已连接
R14 | 2 | PCA_SCL | 已连接
R15 | 1 | +3V3 | 已连接
R15 | 2 | PCA_OE | 已连接
R16 | 1 | CC1 | 已连接
R16 | 2 | GND | 已连接
R17 | 1 | CC2 | 已连接
R17 | 2 | GND | 已连接
R18 | 1 | BM | 已连接
R18 | 2 | BAL1_BLEED | 已连接
R19 | 1 | BAL1_GATE | 已连接
R19 | 2 | VBAT_RAW_N | 已连接
R2 | 1 | BM | 已连接
R2 | 2 | PROT_VC | 已连接
R20 | 1 | VBAT_RAW_P | 已连接
R20 | 2 | BAL2_BLEED | 已连接
R21 | 1 | BAL2_GATE | 已连接
R21 | 2 | BM | 已连接
R22 | 1 | CHG_TIME | 已连接
R22 | 2 | GND | 已连接
R23 | 1 | NTC | 已连接
R23 | 2 | GND | 已连接
R24 | 1 | CHG_EN | 已连接
R24 | 2 | GND | 已连接
R26 | 1 | +3V3 | 已连接
R26 | 2 | ENC_SW_N | 已连接
R3 | 1 | VM_SENSE | 已连接
R3 | 2 | GND | 已连接
R4 | 1 | BM | 已连接
R4 | 2 | BAL1_VDD | 已连接
R5 | 1 | VBAT_RAW_P | 已连接
R5 | 2 | BAL2_VDD | 已连接
R6 | 1 | VBUS | 已连接
R6 | 2 | CHG_VIN | 已连接
R7 | 1 | CHG_LED | 已连接
R7 | 2 | LED_A | 已连接
R8 | 1 | CHG_ISET | 已连接
R8 | 2 | GND | 已连接
R9 | 1 | ADC_BAT | 已连接
R9 | 2 | GND | 已连接
SV1 | 1 | PWM0 | 已连接
SV1 | 2 | +5V_SERVO | 已连接
SV1 | 3 | GND | 已连接
SV2 | 1 | PWM1 | 已连接
SV2 | 2 | +5V_SERVO | 已连接
SV2 | 3 | GND | 已连接
SV3 | 1 | PWM2 | 已连接
SV3 | 2 | +5V_SERVO | 已连接
SV3 | 3 | GND | 已连接
SV4 | 1 | PWM3 | 已连接
SV4 | 2 | +5V_SERVO | 已连接
SV4 | 3 | GND | 已连接
SV5 | 1 | PWM4 | 已连接
SV5 | 2 | +5V_SERVO | 已连接
SV5 | 3 | GND | 已连接
SV6 | 1 | PWM5 | 已连接
SV6 | 2 | +5V_SERVO | 已连接
SV6 | 3 | GND | 已连接
SV7 | 1 | PWM6 | 已连接
SV7 | 2 | +5V_SERVO | 已连接
SV7 | 3 | GND | 已连接
SV8 | 1 | PWM7 | 已连接
SV8 | 2 | +5V_SERVO | 已连接
SV8 | 3 | GND | 已连接
U1 | 1 | DOUT_GATE | 已连接
U1 | 2 | COUT_GATE | 已连接
U1 | 3 | VM_SENSE | 已连接
U1 | 4 | PROT_VC | 已连接
U1 | 5 | PROT_VDD | 已连接
U1 | 6 | VBAT_RAW_N | 已连接
U2 | 1 |  | NC/有意不连接
U2 | 2 | BAL1_VDD | 已连接
U2 | 3 | VBAT_RAW_N | 已连接
U2 | 4 |  | NC/有意不连接
U2 | 5 |  | NC/有意不连接
U2 | 6 | BAL1_GATE | 已连接
U3 | 1 |  | NC/有意不连接
U3 | 2 | BAL2_VDD | 已连接
U3 | 3 | BM | 已连接
U3 | 4 |  | NC/有意不连接
U3 | 5 |  | NC/有意不连接
U3 | 6 | BAL2_GATE | 已连接
U4 | 1 |  | NC/有意不连接
U4 | 2 |  | NC/有意不连接
U4 | 3 |  | NC/有意不连接
U4 | 4 | NTC | 已连接
U4 | 5 |  | NC/有意不连接
U4 | 6 | CHG_LED | 已连接
U4 | 7 | CHG_TIME | 已连接
U4 | 8 |  | NC/有意不连接
U4 | 9 |  | NC/有意不连接
U4 | 10 |  | NC/有意不连接
U4 | 11 | CHG_ISET | 已连接
U4 | 12 | CHG_EN | 已连接
U4 | 13 | CHG_VIN | 已连接
U4 | 14 | BST_CAP | 已连接
U4 | 15 | SW_CHG | 已连接
U4 | 16 | SW_CHG | 已连接
U4 | 17 | SW_CHG | 已连接
U4 | 18 | GND | 已连接
U4 | 19 | CHG_VSYS | 已连接
U4 | 20 | CHG_VSYS | 已连接
U4 | 21 | VBAT_FUSED | 已连接
U4 | 22 | VBAT_FUSED | 已连接
U4 | 23 |  | NC/有意不连接
U4 | 24 |  | NC/有意不连接
U4 | 25 | GND | 已连接
U7 | 1 | GND | 已连接
U7 | 2 | GND | 已连接
U7 | 3 | GND | 已连接
U7 | 4 | GND | 已连接
U7 | 5 | GND | 已连接
U7 | 6 | PWM0 | 已连接
U7 | 7 | PWM1 | 已连接
U7 | 8 | PWM2 | 已连接
U7 | 9 | PWM3 | 已连接
U7 | 10 | PWM4 | 已连接
U7 | 11 | PWM5 | 已连接
U7 | 12 | PWM6 | 已连接
U7 | 13 | PWM7 | 已连接
U7 | 14 | GND | 已连接
U7 | 15 |  | NC/有意不连接
U7 | 16 |  | NC/有意不连接
U7 | 17 |  | NC/有意不连接
U7 | 18 |  | NC/有意不连接
U7 | 19 |  | NC/有意不连接
U7 | 20 |  | NC/有意不连接
U7 | 21 |  | NC/有意不连接
U7 | 22 |  | NC/有意不连接
U7 | 23 | PCA_OE | 已连接
U7 | 24 | GND | 已连接
U7 | 25 | GND | 已连接
U7 | 26 | PCA_SCL | 已连接
U7 | 27 | PCA_SDA | 已连接
U7 | 28 | +3V3 | 已连接
