xaiojie/papabot/mechanical-design/structure-a2/紧固件与辅料核对.csv

规格 | 单台数量或备料数 | V7清单记录（非到货） | 当前处理
M2×6 | 14 | 100颗已列立创BOM | 数量够，长度与实物复核
M2×8 | 44 | V7未明确列此长度 | 新增，建议备50颗；PCB用4颗必须小头
M2×10 | 6 | V7未明确列此长度 | 新增，建议备10颗
M2螺母 | 64 | 淘宝已选20颗 | 还差44颗；原20颗装可再备3包，总计80颗
M3×8 | 4 | 100颗已列立创BOM | 数量够
M3×10 | 20 | V7未明确列此长度 | 新增，建议备30颗
M3×12 | 8 | V7未明确列此长度 | 新增，建议备10颗
M3螺母 | 32 | 淘宝已选50颗 | 数量够
M3平垫片（Ø6×0.8） | 32 | 淘宝已选200片 | 数量够；PCB的M2处不用此垫片
原装舵盘与中心螺丝 | 8 | 随8个MG90S附带情况待实物确认 | 原装花键和中心螺纹，不能用普通M2代替
Ø12×2硅胶脚垫 | 4 | 淘宝已选50只 | 每脚1只
10×150mm电池束带 | 1 | 淘宝已选2条 | 电池实物到货后确认搭接长度
1mm EVA薄垫 | 1 | 淘宝已选1卷 | 按电池、模块、控件边缘裁切；电源模块可叠到约2mm
2.5×100mm扎带 | 20 | 淘宝已选100条 | 建议预留20根，按走线裁定；不勒压电芯
