xaiojie/papabot/mechanical-design/structure-a3/紧固件与辅料核对.csv

规格 | 单台数量或备料数 | V7记录（非到货） | 当前处理
M2×6 | 14 | V7立创BOM列100颗 | 数量够；长度按实物复核
M2×8 | 40 | V7未明确列此长度 | 建议备50颗；PCB的4颗须小头
M2×10 | 6 | V7未明确列此长度 | 建议备10颗
M2螺母 | 60 | V7淘宝列20颗 | 还差40颗；可加2包20颗，另备损耗
M3×8 | 4 | V7立创BOM列100颗 | 数量够
M3×10 | 16 | V7未明确列此长度 | 建议备20颗
M3×12 | 8 | V7未明确列此长度 | 建议备10颗
M3×30 | 4 | A3深前盖新增长度 | 前盖4颗；建议备6颗，配0.8mm平垫
M3螺母 | 32 | V7淘宝列50颗 | 数量够
M3平垫片 Ø6×0.8 | 32 | V7淘宝列200片 | 前盖按外径≤7mm预留；PCB的M2处不用此垫片
原装双臂舵盘及中心螺丝 | 8 | 随8个MG90S附带情况待确认 | 原装花键和中心螺纹，不能用普通M2代替
Ø12×2硅胶脚垫 | 4 | V7淘宝列50只 | 每脚1只
10×150mm电池束带 | 1 | V7淘宝列2条 | 到货后确认搭接长度
1mm EVA薄垫 | 1 | V7淘宝列1卷 | 电池/模块边缘裁切；电源架可叠至约2mm
2.5×100mm扎带 | 20 | V7淘宝列100条 | 走线备料，实际用量视线束确定
