xaiojie/papabot/pcb-design/native-rev-b/载板接口与引脚.csv

PCB位号 | 针号 | 信号网络 | 焊盘X_mm | 焊盘Y_mm | 说明
C1 | 1 | ADC_BAT | 25.46 | 20.000001 | 100nF，电池ADC滤波。
C1 | 2 | GND | 30.54 | 20.000001 | 100nF，电池ADC滤波。
C3 | 1 | +3V3 | 54.46 | 20.000001 | 100nF，主控3.3V旁路。
C3 | 2 | GND | 59.54 | 20.000001 | 100nF，主控3.3V旁路。
C4 | 1 | +5V_LOGIC | 68.000001 | 6.46 | 100nF，逻辑5V旁路。
C4 | 2 | GND | 68.000001 | 11.54 | 100nF，逻辑5V旁路。
C5 | 1 | LCD_3V3 | 71.459999 | 21.000001 | 新增100nF/50V/P5.08屏幕旁路电容；外部稳压器仍须配齐其规定的输入/输出电容。
C5 | 2 | GND | 76.539999 | 21.000001 | 新增100nF/50V/P5.08屏幕旁路电容；外部稳压器仍须配齐其规定的输入/输出电容。
J1 | 1 | ADC_BAT | 15.869999 | 7.110001 | C429947 / 22850120ANG1SYA01；单排20P、2.54mm、塑高8.5mm；两排间距17.78mm，两排1脚朝天线。
J1 | 2 | ENC_B | 18.409999 | 7.110001 | C429947 / 22850120ANG1SYA01；单排20P、2.54mm、塑高8.5mm；两排间距17.78mm，两排1脚朝天线。
J1 | 3 | NC | 20.949999 | 7.110001 | C429947 / 22850120ANG1SYA01；单排20P、2.54mm、塑高8.5mm；两排间距17.78mm，两排1脚朝天线。
J1 | 4 | MIC_BCLK | 23.489999 | 7.110001 | C429947 / 22850120ANG1SYA01；单排20P、2.54mm、塑高8.5mm；两排间距17.78mm，两排1脚朝天线。
J1 | 5 | MIC_WS | 26.029999 | 7.110001 | C429947 / 22850120ANG1SYA01；单排20P、2.54mm、塑高8.5mm；两排间距17.78mm，两排1脚朝天线。
J1 | 6 | MIC_SD | 28.569999 | 7.110001 | C429947 / 22850120ANG1SYA01；单排20P、2.54mm、塑高8.5mm；两排间距17.78mm，两排1脚朝天线。
J1 | 7 | GND | 31.109999 | 7.110001 | C429947 / 22850120ANG1SYA01；单排20P、2.54mm、塑高8.5mm；两排间距17.78mm，两排1脚朝天线。
J1 | 8 | ENC_A | 33.649999 | 7.110001 | C429947 / 22850120ANG1SYA01；单排20P、2.54mm、塑高8.5mm；两排间距17.78mm，两排1脚朝天线。
J1 | 9 | PCA_SDA | 36.189999 | 7.110001 | C429947 / 22850120ANG1SYA01；单排20P、2.54mm、塑高8.5mm；两排间距17.78mm，两排1脚朝天线。
J1 | 10 | PCA_SCL | 38.729999 | 7.110001 | C429947 / 22850120ANG1SYA01；单排20P、2.54mm、塑高8.5mm；两排间距17.78mm，两排1脚朝天线。
J1 | 11 | PCA_OE_N | 41.269999 | 7.110001 | C429947 / 22850120ANG1SYA01；单排20P、2.54mm、塑高8.5mm；两排间距17.78mm，两排1脚朝天线。
J1 | 12 | LCD_MOSI | 43.809999 | 7.110001 | C429947 / 22850120ANG1SYA01；单排20P、2.54mm、塑高8.5mm；两排间距17.78mm，两排1脚朝天线。
J1 | 13 | LCD_SCLK | 46.349999 | 7.110001 | C429947 / 22850120ANG1SYA01；单排20P、2.54mm、塑高8.5mm；两排间距17.78mm，两排1脚朝天线。
J1 | 14 | LCD_CS_N | 48.889999 | 7.110001 | C429947 / 22850120ANG1SYA01；单排20P、2.54mm、塑高8.5mm；两排间距17.78mm，两排1脚朝天线。
J1 | 15 | LCD_DC | 51.429999 | 7.110001 | C429947 / 22850120ANG1SYA01；单排20P、2.54mm、塑高8.5mm；两排间距17.78mm，两排1脚朝天线。
J1 | 16 | NC | 53.969999 | 7.110001 | C429947 / 22850120ANG1SYA01；单排20P、2.54mm、塑高8.5mm；两排间距17.78mm，两排1脚朝天线。
J1 | 17 | +3V3 | 56.509999 | 7.110001 | C429947 / 22850120ANG1SYA01；单排20P、2.54mm、塑高8.5mm；两排间距17.78mm，两排1脚朝天线。
J1 | 18 | +3V3 | 59.049999 | 7.110001 | C429947 / 22850120ANG1SYA01；单排20P、2.54mm、塑高8.5mm；两排间距17.78mm，两排1脚朝天线。
J1 | 19 | +3V3 | 61.589999 | 7.110001 | C429947 / 22850120ANG1SYA01；单排20P、2.54mm、塑高8.5mm；两排间距17.78mm，两排1脚朝天线。
J1 | 20 | GND | 64.129999 | 7.110001 | C429947 / 22850120ANG1SYA01；单排20P、2.54mm、塑高8.5mm；两排间距17.78mm，两排1脚朝天线。
J2 | 1 | NC | 15.869999 | 24.890001 | C429947 / 22850120ANG1SYA01；单排20P、2.54mm、塑高8.5mm；两排间距17.78mm，两排1脚朝天线。
J2 | 2 | NC | 18.409999 | 24.890001 | C429947 / 22850120ANG1SYA01；单排20P、2.54mm、塑高8.5mm；两排间距17.78mm，两排1脚朝天线。
J2 | 3 | NC | 20.949999 | 24.890001 | C429947 / 22850120ANG1SYA01；单排20P、2.54mm、塑高8.5mm；两排间距17.78mm，两排1脚朝天线。
J2 | 4 | NC | 23.489999 | 24.890001 | C429947 / 22850120ANG1SYA01；单排20P、2.54mm、塑高8.5mm；两排间距17.78mm，两排1脚朝天线。
J2 | 5 | AMP_BCLK | 26.029999 | 24.890001 | C429947 / 22850120ANG1SYA01；单排20P、2.54mm、塑高8.5mm；两排间距17.78mm，两排1脚朝天线。
J2 | 6 | AMP_WS | 28.569999 | 24.890001 | C429947 / 22850120ANG1SYA01；单排20P、2.54mm、塑高8.5mm；两排间距17.78mm，两排1脚朝天线。
J2 | 7 | AMP_DIN | 31.109999 | 24.890001 | C429947 / 22850120ANG1SYA01；单排20P、2.54mm、塑高8.5mm；两排间距17.78mm，两排1脚朝天线。
J2 | 8 | NC | 33.649999 | 24.890001 | C429947 / 22850120ANG1SYA01；单排20P、2.54mm、塑高8.5mm；两排间距17.78mm，两排1脚朝天线。
J2 | 9 | GND | 36.189999 | 24.890001 | C429947 / 22850120ANG1SYA01；单排20P、2.54mm、塑高8.5mm；两排间距17.78mm，两排1脚朝天线。
J2 | 10 | LCD_RST_N | 38.729999 | 24.890001 | C429947 / 22850120ANG1SYA01；单排20P、2.54mm、塑高8.5mm；两排间距17.78mm，两排1脚朝天线。
J2 | 11 | KEY_N | 41.269999 | 24.890001 | C429947 / 22850120ANG1SYA01；单排20P、2.54mm、塑高8.5mm；两排间距17.78mm，两排1脚朝天线。
J2 | 12 | NC | 43.809999 | 24.890001 | C429947 / 22850120ANG1SYA01；单排20P、2.54mm、塑高8.5mm；两排间距17.78mm，两排1脚朝天线。
J2 | 13 | ENC_SW_N | 46.349999 | 24.890001 | C429947 / 22850120ANG1SYA01；单排20P、2.54mm、塑高8.5mm；两排间距17.78mm，两排1脚朝天线。
J2 | 14 | NC | 48.889999 | 24.890001 | C429947 / 22850120ANG1SYA01；单排20P、2.54mm、塑高8.5mm；两排间距17.78mm，两排1脚朝天线。
J2 | 15 | NC | 51.429999 | 24.890001 | C429947 / 22850120ANG1SYA01；单排20P、2.54mm、塑高8.5mm；两排间距17.78mm，两排1脚朝天线。
J2 | 16 | NC | 53.969999 | 24.890001 | C429947 / 22850120ANG1SYA01；单排20P、2.54mm、塑高8.5mm；两排间距17.78mm，两排1脚朝天线。
J2 | 17 | +5V_MCU | 56.509999 | 24.890001 | C429947 / 22850120ANG1SYA01；单排20P、2.54mm、塑高8.5mm；两排间距17.78mm，两排1脚朝天线。
J2 | 18 | +5V_MCU | 59.049999 | 24.890001 | C429947 / 22850120ANG1SYA01；单排20P、2.54mm、塑高8.5mm；两排间距17.78mm，两排1脚朝天线。
J2 | 19 | +5V_MCU | 61.589999 | 24.890001 | C429947 / 22850120ANG1SYA01；单排20P、2.54mm、塑高8.5mm；两排间距17.78mm，两排1脚朝天线。
J2 | 20 | GND | 64.129999 | 24.890001 | C429947 / 22850120ANG1SYA01；单排20P、2.54mm、塑高8.5mm；两排间距17.78mm，两排1脚朝天线。
J3 | 1 | GND | 21.110001 | 2.54 | 屏幕VCC和BLK均为LCD_3V3，仅3.3V；8针载板接口拆分接到12针模块，按同名信号逐根接。
J3 | 2 | LCD_3V3 | 23.650001 | 2.54 | 屏幕VCC和BLK均为LCD_3V3，仅3.3V；8针载板接口拆分接到12针模块，按同名信号逐根接。
J3 | 3 | LCD_SCLK | 26.190001 | 2.54 | 屏幕VCC和BLK均为LCD_3V3，仅3.3V；8针载板接口拆分接到12针模块，按同名信号逐根接。
J3 | 4 | LCD_MOSI | 28.730001 | 2.54 | 屏幕VCC和BLK均为LCD_3V3，仅3.3V；8针载板接口拆分接到12针模块，按同名信号逐根接。
J3 | 5 | LCD_RST_N | 31.270001 | 2.54 | 屏幕VCC和BLK均为LCD_3V3，仅3.3V；8针载板接口拆分接到12针模块，按同名信号逐根接。
J3 | 6 | LCD_DC | 33.810001 | 2.54 | 屏幕VCC和BLK均为LCD_3V3，仅3.3V；8针载板接口拆分接到12针模块，按同名信号逐根接。
J3 | 7 | LCD_CS_N | 36.350001 | 2.54 | 屏幕VCC和BLK均为LCD_3V3，仅3.3V；8针载板接口拆分接到12针模块，按同名信号逐根接。
J3 | 8 | LCD_3V3 | 38.890001 | 2.54 | 屏幕VCC和BLK均为LCD_3V3，仅3.3V；8针载板接口拆分接到12针模块，按同名信号逐根接。
J4 | 1 | GND | 48.920001 | 29.459999 | PCA9685逻辑VCC=3.3V，OE高时禁用；舵机电源走板外粗线，V+不经过此口。
J4 | 2 | +3V3 | 51.460001 | 29.459999 | PCA9685逻辑VCC=3.3V，OE高时禁用；舵机电源走板外粗线，V+不经过此口。
J4 | 3 | PCA_SDA | 54.000001 | 29.459999 | PCA9685逻辑VCC=3.3V，OE高时禁用；舵机电源走板外粗线，V+不经过此口。
J4 | 4 | PCA_SCL | 56.540001 | 29.459999 | PCA9685逻辑VCC=3.3V，OE高时禁用；舵机电源走板外粗线，V+不经过此口。
J4 | 5 | PCA_OE_N | 59.080001 | 29.459999 | PCA9685逻辑VCC=3.3V，OE高时禁用；舵机电源走板外粗线，V+不经过此口。
J5 | 1 | GND | 43.649999 | 2.54 | 麦克风3.3V；第6脚为接地的LR，选择左声道；按所购模块丝印接线。
J5 | 2 | +3V3 | 46.189999 | 2.54 | 麦克风3.3V；第6脚为接地的LR，选择左声道；按所购模块丝印接线。
J5 | 3 | MIC_BCLK | 48.729999 | 2.54 | 麦克风3.3V；第6脚为接地的LR，选择左声道；按所购模块丝印接线。
J5 | 4 | MIC_WS | 51.269999 | 2.54 | 麦克风3.3V；第6脚为接地的LR，选择左声道；按所购模块丝印接线。
J5 | 5 | MIC_SD | 53.809999 | 2.54 | 麦克风3.3V；第6脚为接地的LR，选择左声道；按所购模块丝印接线。
J5 | 6 | GND | 56.349999 | 2.54 | 麦克风3.3V；第6脚为接地的LR，选择左声道；按所购模块丝印接线。
J6 | 1 | GND | 61.19 | 2.54 | 仅音频信号；功放电源由5V逻辑UBEC另分支供给。
J6 | 2 | AMP_BCLK | 63.73 | 2.54 | 仅音频信号；功放电源由5V逻辑UBEC另分支供给。
J6 | 3 | AMP_WS | 66.27 | 2.54 | 仅音频信号；功放电源由5V逻辑UBEC另分支供给。
J6 | 4 | AMP_DIN | 68.81 | 2.54 | 仅音频信号；功放电源由5V逻辑UBEC另分支供给。
J7 | 1 | GND | 24.379999 | 29.459999 | 原屏幕板控件保留；A/B/PUSH/K0分别接2/3/5/7脚；1/4/6脚为GND备用。
J7 | 2 | ENC_A | 26.919999 | 29.459999 | 原屏幕板控件保留；A/B/PUSH/K0分别接2/3/5/7脚；1/4/6脚为GND备用。
J7 | 3 | ENC_B | 29.459999 | 29.459999 | 原屏幕板控件保留；A/B/PUSH/K0分别接2/3/5/7脚；1/4/6脚为GND备用。
J7 | 4 | GND | 31.999999 | 29.459999 | 原屏幕板控件保留；A/B/PUSH/K0分别接2/3/5/7脚；1/4/6脚为GND备用。
J7 | 5 | ENC_SW_N | 34.54 | 29.459999 | 原屏幕板控件保留；A/B/PUSH/K0分别接2/3/5/7脚；1/4/6脚为GND备用。
J7 | 6 | GND | 37.079999 | 29.459999 | 原屏幕板控件保留；A/B/PUSH/K0分别接2/3/5/7脚；1/4/6脚为GND备用。
J7 | 7 | KEY_N | 39.619999 | 29.459999 | 原屏幕板控件保留；A/B/PUSH/K0分别接2/3/5/7脚；1/4/6脚为GND备用。
J8 | 1 | +5V_LOGIC | 67.729999 | 26.999999 | 只接已调到5V的逻辑UBEC输出；不接电池原电压或舵机功率支路。
J8 | 2 | GND | 70.269999 | 26.999999 | 只接已调到5V的逻辑UBEC输出；不接电池原电压或舵机功率支路。
J9 | 1 | VBAT_SW | 8.73 | 4.0 | 只接总开关后的电池正极作电压采样，不是供电输入。
J9 | 2 | GND | 11.27 | 4.0 | 只接总开关后的电池正极作电压采样，不是供电输入。
J10 | 1 | LCD_3V3 | 72.729999 | 11.000001 | 可选外部稳压3.3V输入，1脚3.3V、2脚GND；使用时JP3必须断开。采用短软线或实测可容纳的低矮连接器。
J10 | 2 | GND | 75.269999 | 11.000001 | 可选外部稳压3.3V输入，1脚3.3V、2脚GND；使用时JP3必须断开。采用短软线或实测可容纳的低矮连接器。
JP1 | 1 | +5V_LOGIC | 63.73 | 21.000001 | 默认开路；上电检查后用低矮短导线连接逻辑5V与主控5V；USB无自动防倒灌。
JP1 | 2 | +5V_MCU | 66.27 | 21.000001 | 默认开路；上电检查后用低矮短导线连接逻辑5V与主控5V；USB无自动防倒灌。
JP2 | 1 | VBAT_SW | 14.229999 | 4.0 | 默认开路；检查后连接开关后电池电压与采样分压入口。
JP2 | 2 | VBAT_SENSE | 16.769999 | 4.0 | 默认开路；检查后连接开关后电池电压与采样分压入口。
JP3 | 1 | +3V3 | 72.729999 | 16.000001 | 默认开路；仅确认主控3.3V电流及温升余量后跨接，且J10不得接外部电源；优先贴板短导线。
JP3 | 2 | LCD_3V3 | 75.269999 | 16.000001 | 默认开路；仅确认主控3.3V电流及温升余量后跨接，且J10不得接外部电源；优先贴板短导线。
R1 | 1 | VBAT_SENSE | 25.899933 | 11.999999 | 100kΩ/1%/0.25W，电池采样分压上臂。
R1 | 2 | ADC_BAT | 36.100065 | 11.999999 | 100kΩ/1%/0.25W，电池采样分压上臂。
R2 | 1 | ADC_BAT | 25.899933 | 16.000001 | 33kΩ/1%/0.25W，电池采样分压下臂。
R2 | 2 | GND | 36.100065 | 16.000001 | 33kΩ/1%/0.25W，电池采样分压下臂。
R3 | 1 | +3V3 | 38.899935 | 11.999999 | 10kΩ OE上拉；若PCA模块自带OE下拉，核对并去掉该下拉后再测试上电禁用。
R3 | 2 | PCA_OE_N | 49.100067 | 11.999999 | 10kΩ OE上拉；若PCA模块自带OE下拉，核对并去掉该下拉后再测试上电禁用。
R4 | 1 | +3V3 | 38.899935 | 16.000001 | DNP，默认不焊；原屏幕板已有10kΩ上拉到LCD_3V3。保留可选焊位，不能未经评估连接两个稳压输出。
R4 | 2 | ENC_A | 49.100067 | 16.000001 | DNP，默认不焊；原屏幕板已有10kΩ上拉到LCD_3V3。保留可选焊位，不能未经评估连接两个稳压输出。
R5 | 1 | +3V3 | 38.899935 | 20.000001 | DNP，默认不焊；原屏幕板已有10kΩ上拉到LCD_3V3。保留可选焊位，不能未经评估连接两个稳压输出。
R5 | 2 | ENC_B | 49.100067 | 20.000001 | DNP，默认不焊；原屏幕板已有10kΩ上拉到LCD_3V3。保留可选焊位，不能未经评估连接两个稳压输出。
R6 | 1 | +3V3 | 53.899933 | 11.999999 | DNP，默认不焊；原屏幕板已有10kΩ上拉到LCD_3V3。保留可选焊位，不能未经评估连接两个稳压输出。
R6 | 2 | ENC_SW_N | 64.100065 | 11.999999 | DNP，默认不焊；原屏幕板已有10kΩ上拉到LCD_3V3。保留可选焊位，不能未经评估连接两个稳压输出。
R7 | 1 | +3V3 | 53.899933 | 16.000001 | DNP，默认不焊；原屏幕板已有10kΩ上拉到LCD_3V3。保留可选焊位，不能未经评估连接两个稳压输出。
R7 | 2 | KEY_N | 64.100065 | 16.000001 | DNP，默认不焊；原屏幕板已有10kΩ上拉到LCD_3V3。保留可选焊位，不能未经评估连接两个稳压输出。
