xaiojie/papabot/pcb-design/rev-a/01-controller-pinout.csv

本项目位置 | 厂家原理图针号 | 厂家丝印 | 本轮网络 | 状态 | 观察方向
L1 | J2.20 | GPIO1 | ADC_BAT | 本轮分配 | 元件面朝上，天线在上，USB在下；每列由上到下1–20。这是本项目坐标，不是厂家焊盘编号。
L2 | J2.19 | GPIO2 | ENC_B | 本轮分配 | 元件面朝上，天线在上，USB在下；每列由上到下1–20。这是本项目坐标，不是厂家焊盘编号。
L3 | J2.18 | GPIO3 |  | 保留不接 | 元件面朝上，天线在上，USB在下；每列由上到下1–20。这是本项目坐标，不是厂家焊盘编号。
L4 | J2.17 | GPIO4 | MIC_BCLK | 本轮分配 | 元件面朝上，天线在上，USB在下；每列由上到下1–20。这是本项目坐标，不是厂家焊盘编号。
L5 | J2.16 | GPIO5 | MIC_WS | 本轮分配 | 元件面朝上，天线在上，USB在下；每列由上到下1–20。这是本项目坐标，不是厂家焊盘编号。
L6 | J2.15 | GPIO6 | MIC_SD | 本轮分配 | 元件面朝上，天线在上，USB在下；每列由上到下1–20。这是本项目坐标，不是厂家焊盘编号。
L7 | J2.14 | GND | GND | 供电/地 | 元件面朝上，天线在上，USB在下；每列由上到下1–20。这是本项目坐标，不是厂家焊盘编号。
L8 | J2.13 | GPIO7 | ENC_A | 本轮分配 | 元件面朝上，天线在上，USB在下；每列由上到下1–20。这是本项目坐标，不是厂家焊盘编号。
L9 | J2.12 | GPIO8 | PCA_SDA | 本轮分配 | 元件面朝上，天线在上，USB在下；每列由上到下1–20。这是本项目坐标，不是厂家焊盘编号。
L10 | J2.11 | GPIO9 | PCA_SCL | 本轮分配 | 元件面朝上，天线在上，USB在下；每列由上到下1–20。这是本项目坐标，不是厂家焊盘编号。
L11 | J2.10 | GPIO10 | PCA_OE_N | 本轮分配 | 元件面朝上，天线在上，USB在下；每列由上到下1–20。这是本项目坐标，不是厂家焊盘编号。
L12 | J2.9 | GPIO11 | LCD_MOSI | 本轮分配 | 元件面朝上，天线在上，USB在下；每列由上到下1–20。这是本项目坐标，不是厂家焊盘编号。
L13 | J2.8 | GPIO12 | LCD_SCLK | 本轮分配 | 元件面朝上，天线在上，USB在下；每列由上到下1–20。这是本项目坐标，不是厂家焊盘编号。
L14 | J2.7 | GPIO13 | LCD_CS_N | 本轮分配 | 元件面朝上，天线在上，USB在下；每列由上到下1–20。这是本项目坐标，不是厂家焊盘编号。
L15 | J2.6 | GPIO14 | LCD_DC | 本轮分配 | 元件面朝上，天线在上，USB在下；每列由上到下1–20。这是本项目坐标，不是厂家焊盘编号。
L16 | J2.5 | RESET |  | 保留不接 | 元件面朝上，天线在上，USB在下；每列由上到下1–20。这是本项目坐标，不是厂家焊盘编号。
L17 | J2.4 | 3V3 | +3V3 | 供电/地 | 元件面朝上，天线在上，USB在下；每列由上到下1–20。这是本项目坐标，不是厂家焊盘编号。
L18 | J2.3 | 3V3 | +3V3 | 供电/地 | 元件面朝上，天线在上，USB在下；每列由上到下1–20。这是本项目坐标，不是厂家焊盘编号。
L19 | J2.2 | 3V3 | +3V3 | 供电/地 | 元件面朝上，天线在上，USB在下；每列由上到下1–20。这是本项目坐标，不是厂家焊盘编号。
L20 | J2.1 | GND | GND | 供电/地 | 元件面朝上，天线在上，USB在下；每列由上到下1–20。这是本项目坐标，不是厂家焊盘编号。
R1 | J1.20 | GPIO46 |  | 保留不接 | 元件面朝上，天线在上，USB在下；每列由上到下1–20。这是本项目坐标，不是厂家焊盘编号。
R2 | J1.19 | GPIO45 |  | 保留不接 | 元件面朝上，天线在上，USB在下；每列由上到下1–20。这是本项目坐标，不是厂家焊盘编号。
R3 | J1.18 | GPIO42 |  | 保留不接 | 元件面朝上，天线在上，USB在下；每列由上到下1–20。这是本项目坐标，不是厂家焊盘编号。
R4 | J1.17 | GPIO41 |  | 保留不接 | 元件面朝上，天线在上，USB在下；每列由上到下1–20。这是本项目坐标，不是厂家焊盘编号。
R5 | J1.16 | GPIO15 | AMP_BCLK | 本轮分配 | 元件面朝上，天线在上，USB在下；每列由上到下1–20。这是本项目坐标，不是厂家焊盘编号。
R6 | J1.15 | GPIO16 | AMP_WS | 本轮分配 | 元件面朝上，天线在上，USB在下；每列由上到下1–20。这是本项目坐标，不是厂家焊盘编号。
R7 | J1.14 | GPIO17 | AMP_DIN | 本轮分配 | 元件面朝上，天线在上，USB在下；每列由上到下1–20。这是本项目坐标，不是厂家焊盘编号。
R8 | J1.13 | GPIO18 |  | 保留不接 | 元件面朝上，天线在上，USB在下；每列由上到下1–20。这是本项目坐标，不是厂家焊盘编号。
R9 | J1.12 | GND | GND | 供电/地 | 元件面朝上，天线在上，USB在下；每列由上到下1–20。这是本项目坐标，不是厂家焊盘编号。
R10 | J1.11 | GPIO21 | LCD_RST_N | 本轮分配 | 元件面朝上，天线在上，USB在下；每列由上到下1–20。这是本项目坐标，不是厂家焊盘编号。
R11 | J1.10 | GPIO40 | KEY_N | 本轮分配 | 元件面朝上，天线在上，USB在下；每列由上到下1–20。这是本项目坐标，不是厂家焊盘编号。
R12 | J1.9 | GPIO39 |  | 保留不接 | 元件面朝上，天线在上，USB在下；每列由上到下1–20。这是本项目坐标，不是厂家焊盘编号。
R13 | J1.8 | GPIO38 | ENC_SW_N | 本轮分配 | 元件面朝上，天线在上，USB在下；每列由上到下1–20。这是本项目坐标，不是厂家焊盘编号。
R14 | J1.7 | GPIO47 |  | 保留不接 | 元件面朝上，天线在上，USB在下；每列由上到下1–20。这是本项目坐标，不是厂家焊盘编号。
R15 | J1.6 | GPIO48 |  | 保留不接 | 元件面朝上，天线在上，USB在下；每列由上到下1–20。这是本项目坐标，不是厂家焊盘编号。
R16 | J1.5 | BOOT_GPIO0 |  | 保留不接 | 元件面朝上，天线在上，USB在下；每列由上到下1–20。这是本项目坐标，不是厂家焊盘编号。
R17 | J1.4 | 5V | +5V_MCU | 供电/地 | 元件面朝上，天线在上，USB在下；每列由上到下1–20。这是本项目坐标，不是厂家焊盘编号。
R18 | J1.3 | 5V | +5V_MCU | 供电/地 | 元件面朝上，天线在上，USB在下；每列由上到下1–20。这是本项目坐标，不是厂家焊盘编号。
R19 | J1.2 | 5V | +5V_MCU | 供电/地 | 元件面朝上，天线在上，USB在下；每列由上到下1–20。这是本项目坐标，不是厂家焊盘编号。
R20 | J1.1 | GND | GND | 供电/地 | 元件面朝上，天线在上，USB在下；每列由上到下1–20。这是本项目坐标，不是厂家焊盘编号。
