xaiojie/papabot/mechanical-design/assembly-v1/reports/measurement-checklist.csv

编号 | 待补项目 | 当前依据 | 测量基准/内容 | 影响 | 状态
M01 | 显示 PCB 实测长宽厚 | 商品91×44，厚度假设1.6 | 整板边缘与背面基准 | 修改壳体内腔与安装支架 | 未测量
M02 | 四孔中心距、孔径与边距 | 商品84.5×37.5，孔Ø3 | 同一板边基准 | 锁定支架孔位 | 未测量
M03 | 有效显示区长宽 | 按2.4英寸4:3推算48.768×36.576 | 点亮后实际发光边界 | 锁定开窗，避免遮挡中文 | 未测量
M04 | 玻璃与金属框长宽厚 | 建模59×41.5；商品59×42.5口径未明 | 玻璃边缘、金属框与PCB平面 | 确定遮光井尾部、玻璃间隙 | 未测量
M05 | LCD相对PCB的X/Z位置 | 假设LCD中心相对PCB中心左移10.5 | 左板边/下板边至显示区边 | 保证实际屏幕居中 | 未测量
M06 | EC11、旋钮帽总突出 | 假设向PCB正面突出约21 | PCB正面到帽最前点，分开记录轴与帽 | 确定前盖深度与拆盖路径 | 未测量
M07 | 独立按键位置与按压行程 | 示意模型 | PCB与按键最高点 | 按键让位及误触距离 | 未测量
M08 | 背面最高元件及排针方向 | 假设后向12针，间距2.54 | PCB背面、排针实际长度 | 支架开口与线缆弯曲区 | 未测量
M09 | 舵机型号、外形、孔距、输出轴 | 约9g舵机外形占位 | 厂家图加实物，确认轴向与舵盘 | 重建安装支架、腿关节与限位 | 未选型
M10 | 主控、语音、驱动、电源模块 | ESP32-S3等空间占位 | 最终型号或定制PCB | 板间距、固定柱、连接器开口 | 未选型
M11 | 前盖/底盖紧固与工具路径 | 定位有试验性0.2径向间隙 | 选定螺钉/螺母、扳手/螺丝刀 | 可拆结构和连续干涉检查 | 待设计
M12 | 材料、工艺、尺寸公差与样片 | 奶白/薄荷低光泽方向 | 商家实际材料与小件试配 | 决定独立细边、支柱、薄壁的可行性 | 待试样
M13 | 舵机电源、峰值电流与整机重心 | 本阶段无电气/重量结论 | 电源与器件选型、实测质量 | 承载、稳定性、散热与步态 | 待选型验证
