xaiojie/papabot/firmware/bringup/docs/reference/lckfb-pin-locations.csv

本项目位置 | 厂家原理图针号 | 厂家丝印
L1 | J2.20 | GPIO1
L2 | J2.19 | GPIO2
L3 | J2.18 | GPIO3
L4 | J2.17 | GPIO4
L5 | J2.16 | GPIO5
L6 | J2.15 | GPIO6
L7 | J2.14 | GND
L8 | J2.13 | GPIO7
L9 | J2.12 | GPIO8
L10 | J2.11 | GPIO9
L11 | J2.10 | GPIO10
L12 | J2.9 | GPIO11
L13 | J2.8 | GPIO12
L14 | J2.7 | GPIO13
L15 | J2.6 | GPIO14
L16 | J2.5 | RESET
L17 | J2.4 | 3V3
L18 | J2.3 | 3V3
L19 | J2.2 | 3V3
L20 | J2.1 | GND
R1 | J1.20 | GPIO46
R2 | J1.19 | GPIO45
R3 | J1.18 | GPIO42
R4 | J1.17 | GPIO41
R5 | J1.16 | GPIO15
R6 | J1.15 | GPIO16
R7 | J1.14 | GPIO17
R8 | J1.13 | GPIO18
R9 | J1.12 | GND
R10 | J1.11 | GPIO21
R11 | J1.10 | GPIO40
R12 | J1.9 | GPIO39
R13 | J1.8 | GPIO38
R14 | J1.7 | GPIO47
R15 | J1.6 | GPIO48
R16 | J1.5 | BOOT_GPIO0
R17 | J1.4 | 5V
R18 | J1.3 | 5V
R19 | J1.2 | 5V
R20 | J1.1 | GND
