xaiojie/papabot/mechanical-design/structure-a3/delivery/DesktopAssistant-A3/紧固件安装明细.csv

安装位置 | 螺丝规格 | 单台数量 | 装配备注
屏幕固定框→主壳 | M2×6 | 4 | R04/R01，螺母在主壳内侧槽
两块电源架→侧壁 | M2×6 | 8 | R17/R18；外侧装螺母，模块避开螺丝头
充电托架→后盖 | M2×6 | 2 | R09/R03，螺母在托架内侧槽
8个舵机安装耳 | M2×8 | 16 | 每个2颗；耳片厚度待实物复核
8个原装双臂舵盘→连杆 | M2×8 | 16 | 每个2颗；不能替代原舵机中心螺丝
小耳朵 | M2×8 | 2 | R12/R13；螺母从耳朵后侧装入
可换麦克风架 | M2×8 | 2 | R14/R01；内侧沉孔，外侧装螺母，实物复核螺丝尖端
主控PCB→R06 | M2×8 | 4 | 头径≤4mm、头高≤2mm；不用大垫片，保留PCB原Ø3.2孔
喇叭压圈 | M2×10 | 2 | R11/R03，后盖外侧装螺母
两条充电板压条 | M2×10 | 4 | R10/R09，托架底部装螺母
完整屏幕原板→固定框 | M3×8 | 4 | R04，配0.8mm垫片；旋钮与按键保持原装
可拆后盖→主壳 | M3×10 | 4 | R03/R01，配0.8mm垫片
底盘→主壳 | M3×10 | 4 | R05/R01，配0.8mm垫片；前2个固定点已转移到R01
主控架→底盘 | M3×10 | 4 | R06，侧装M3螺母，配0.8mm垫片
PCA9685架→底盘 | M3×10 | 4 | R16，侧装M3螺母，配0.8mm垫片
四个髋座→底盘 | M3×12 | 8 | 每座2颗；底盘顶部装螺母，配0.8mm垫片
深可拆前盖→主壳 | M3×30 | 4 | R02/R01，必须配0.8mm垫片；无深沉孔，螺杆名义Y−47～−17
