xaiojie/papabot/mechanical-design/print-v2/assembly-parts-plan.md

# 整套结构分件与装配计划

这是与当前暂定采购件对应的制造分件规划。除T01～T04C六个试配件已导出外，下表仍待细化，不应交商家当作已有完整STL文件。沿用奶油白主体、薄荷绿腿/耳、小耳、居中屏幕；8个MG90S，每腿2个。

| 计划件号 | 分件 | 计划数量 | 连接、拆装与工具空间 | 当前限制 |
| --- | --- | --- | --- | --- |
| P101 | 主壳 | 1 | 主要壳壁先以2.4mm设计；腿座接到底盘加强区；底面维修 | 现118mm外宽与屏幕右缘太紧，须复核后加宽或重排 |
| P102 | 浅前盖 | 1 | 前方可拆、定位台阶+M3螺钉/普通螺母；后续加入防脱螺母槽 | 玻璃内缩0.5～1；窗口用实测有效区/玻璃位置确定 |
| P103 | 前脸薄荷细边 | 0或1 | 优先与前盖一体后处理着色；如单独打印需足够厚度 | 旧V1的0.4mm薄片不直接作为独立打印件 |
| P104 | 显示模块支架 | 1 | 完整91×44PCB、4孔隔离支撑，不压背面元件；M3已有紧固 | 先用T01核孔，板厚、元件高度和玻璃偏置待测 |
| P105 | 可拆后控件面板 | 1 | EC11和独立按键移后；从内侧插拔接线；保留手/工具伸入 | 拆焊已获设计授权，实际未做；螺纹、防转、排线待测 |
| P106 | 底盖/承载底盘 | 1 | M3螺钉+垫片+普通螺母，从下方可拆；螺母需防脱结构 | 腿载荷不能只靠薄外壳；底盘厚度/筋需单腿验证 |
| P107 | 可换主控PCB支架 | 1 | 80×32板框和70×22孔距提案；M3尼龙垫柱绝缘，侧向USB工具通路 | PCB布局、高度、天线和线头返回后定柱高 |
| P108 | 电池托架 | 1 | 1mm EVA缓冲+10×150魔术贴；托架开11mm左右束带槽试配，不勒电芯 | 75×40×20为目标，最终包络和重心未定，不先精配 |
| P109 | 两路降压模块固定座 | 2 | 分开固定，裸导体绝缘，端子可拧；粗线应力释放 | DFR0753、UBEC实际外形与温升需核；不封死散热 |
| P110 | 麦克风可换座 | 1 | 与舵机机械隔离；EVA仅环形密封，中心通孔 | 商品身份存在差异，禁止先固定Ø14座 |
| P111 | 喇叭压圈/音腔座 | 1 | 软接触压边、螺钉拆换，导线不受拉 | Ø23.6×10.4商品标称；边框、磁体和声腔实测 |
| P112 | 左右小耳外框 | 2 | 内侧键定位+小螺丝锁定，不作把手，不堵拾音 | 相对壳体接头需完善；减少应力尖角 |
| P113 | 左右耳内片 | 2 | 机械限位/小螺丝或同色一体处理，避免依赖新增胶水 | 减少薄小独立嵌件；与耳外框先试配 |
| L101 | 髋舵机固定支架 | 4 | MG90S外壳耳孔固定；与底盘刚性连接；预留螺丝刀通道 | 同批舵机壳体、耳孔、出线方向未测 |
| L102 | 上腿/髋输出连杆 | 4 | 使用舵机自带舵盘，以已购M2螺丝螺母候选连接；避免直接打印细花键 | 舵盘孔距、中心螺丝、花键身份未定；不宣称可承载 |
| L103 | 膝舵机固定座 | 4 | 与上腿分件可维修，电线跨关节留弯曲圈并限位 | 两舵机每腿转轴、行程、反侧支撑待单腿设计 |
| L104 | 下腿与脚掌 | 4 | 脚底至少容纳Ø12硅胶软脚垫平面；舵盘固定可拆 | 足垫实际抓地、腿长、关节载荷及步态待试验 |
| L105 | 关节限位/反侧支撑件 | 按单腿确定 | 优先评估现有M3螺丝、平垫与打印衬套；必要时单列新物料 | 目前未增购轴承、金属轴或连杆，不假装已有这些配件 |

建议装配次序：先主控与两路供电台架通电，再用两只已有MG90S测试单腿，随后底盘/电池布局，安装完整屏幕支架，最后装前盖、后面板、小耳及其余三腿。显示或控件维护应能单独拆盖，不拆8只舵机。

螺母结构用已经加购的普通M2/M3螺母，先以T02/T03结果确定打印补偿。正式封闭螺母槽还需加入装入方向与防掉落设计；简单六角凹坑并不等于防脱。M3螺丝刀通道先预留约Ø8、M2约Ø6的直线通路，按照实际螺丝头型、工具和拆装方向调整。螺丝必须避开电芯与PCB焊点，选长后校核穿透余量，不能直接用采购包中最长螺丝。

线束路径应能以已购2.5mm扎带固定；设计槽以3.2×2mm作试验起点，圆滑入口不割线。关节活动线与舵盘留动态避让；18AWG供电线在底盘固定，绝缘焊点不要置于活动轴附近。电池XT30接头需要捏持、拔出和弯线空间，外壳内腔不能只按电池本体尺寸塞满。

先试配和单腿载荷，再确定最终PLA/PETG/其他材料。外观低光泽是已选方向，不能用渲染材质代替真实材料和强度验证。正式打印包需逐件STL、数量/颜色、建议摆放、关键配合尺寸、切片检查和已通过的装配记录；电子占位体、软脚垫、舵机自带舵盘及外购螺丝均不导出为打印件。
