xaiojie/papabot/mechanical-design/structure-a2/零件清单.md

# A2 整机打印零件清单

当前共 **32 个独立 STL，每个打印 1 件**。FL/FR/RL/RR 分别是左前/右前/左后/右后，以机器人自己的朝向判断。左右及前后孔位不同，请按件号取件。

尺寸来自已导出的 STL，顺序为导出文件的 X×Y×Z（mm），已经按建议打印方向旋转。导入切片器保持 **100% / 毫米**，不要再放大1000倍。STL统一在Z=0落底。

| 件号 | 零件用途 | 每台数量 | STL包络 mm | 导出姿态 |
|---|---|---:|---|---|
| R01 | 主外壳：加深后舱、舵机孔和模块座 | 1 | 124.00×76.00×91.50 | 正面朝下 |
| R02 | 浅前盖与麦克风声孔 | 1 | 124.00×76.00×12.70 | 正面朝下 |
| R03 | 后面板：旋钮、按键、开关、充电、喇叭与功放座 | 1 | 104.30×58.00×13.40 | 背面朝下 |
| R04 | 完整屏幕板固定框 | 1 | 106.50×58.00×5.60 | 背面朝下 |
| R05 | 加强底盘与电池托架 | 1 | 110.80×85.70×8.60 | 沿现有底面 |
| R06 | 主控PCB支撑架 | 1 | 104.00×41.50×31.40 | 倒置，支脚朝上 |
| R07 | EC11后置压片 | 1 | 26.00×19.00×2.00 | 正面朝下 |
| R08 | 独立按键后置压片 | 1 | 26.00×16.00×2.00 | 正面朝下 |
| R09 | Type-C充电板托架 | 1 | 34.00×32.00×8.20 | 沿现有底面 |
| R10_1 | 充电板边缘压条 1 | 1 | 29.00×3.40×4.80 | 沿现有底面 |
| R10_2 | 充电板边缘压条 2 | 1 | 29.00×3.40×4.80 | 沿现有底面 |
| R11 | 喇叭后压圈 | 1 | 40.60×29.00×2.00 | 正面朝下 |
| R12_L | 一体小耳朵 L | 1 | 17.60×18.66×6.47 | 正面朝下 |
| R12_R | 一体小耳朵 R | 1 | 17.60×18.66×6.47 | 正面朝下 |
| R13_L | 小耳朵内侧压垫 L | 1 | 10.00×10.00×1.20 | 沿现有底面 |
| R13_R | 小耳朵内侧压垫 R | 1 | 10.00×10.00×1.20 | 沿现有底面 |
| R14 | 可换麦克风托架 | 1 | 18.00×34.60×16.00 | 正面朝下 |
| R16 | PCA9685后舱安装架 | 1 | 78.50×31.00×32.40 | 倒置，支脚朝上 |
| R17 | DFR0753舵机降压固定架 | 1 | 33.00×54.00×2.40 | 侧面朝下 |
| R18 | 好盈UBEC逻辑降压固定架 | 1 | 46.86×54.50×2.40 | 侧面朝下 |
| L101_FL | 髋舵机固定座 FL | 1 | 55.40×24.00×40.00 | 侧面朝下 |
| L101_FR | 髋舵机固定座 FR | 1 | 55.40×24.00×40.00 | 侧面朝下 |
| L101_RL | 髋舵机固定座 RL | 1 | 55.40×29.00×40.00 | 侧面朝下 |
| L101_RR | 髋舵机固定座 RR | 1 | 55.40×29.00×40.00 | 侧面朝下 |
| L102_FL | 上腿连杆与膝舵机座一体 FL | 1 | 61.70×31.00×13.35 | 侧面朝下 |
| L102_FR | 上腿连杆与膝舵机座一体 FR | 1 | 61.70×31.00×13.35 | 侧面朝下 |
| L102_RL | 上腿连杆与膝舵机座一体 RL | 1 | 61.70×31.00×13.35 | 侧面朝下 |
| L102_RR | 上腿连杆与膝舵机座一体 RR | 1 | 61.70×31.00×13.35 | 侧面朝下 |
| L104_FL | 下腿与脚掌一体 FL | 1 | 53.70×39.00×18.00 | 侧面朝下 |
| L104_FR | 下腿与脚掌一体 FR | 1 | 53.70×39.00×18.00 | 侧面朝下 |
| L104_RL | 下腿与脚掌一体 RL | 1 | 53.70×39.00×18.00 | 侧面朝下 |
| L104_RR | 下腿与脚掌一体 RR | 1 | 53.70×39.00×18.00 | 侧面朝下 |

R05集成电池托架，R03集成喇叭套筒及功放支撑，L102集成上腿和膝舵机座，L104集成下腿和脚掌。耳朵内片已合并为浅浮雕，后处理上色即可。因此没有另缺一份独立电池盒、功放座、膝座、脚掌或耳朵内片。

电子模块、电池、金属螺丝、原装舵盘和硅胶脚垫在Blender里用于装配参照，不属于打印件。编号不连续是保留历史件号，不能据此判定缺件。

旧 `print-v2` 里的6个结构草稿和6个试配片仅保留历史；`structure-a2/stl` 里的单件R06是支架检查副本。整机统一使用本目录 **stl-complete/** 的32个文件。
