xaiojie/papabot/mechanical-design/structure-a3/零件清单.md

# A3 整机打印零件清单

**30个独立STL，每个打印1件。** 当前只取本目录的 `stl-complete/`。FL/FR/RL/RR为机器人自身的左前/右前/左后/右后。每个STL为单一闭合连通体，已按建议朝向旋转并在Z=0落底；导入切片器保持100%、毫米，不要放大1000倍。

| 件号 | 零件用途 | 单台数量 | 导出X×Y×Z包络 mm | 导出姿态 |
|---|---|---:|---|---|
| R01 | 主外壳：独立底盘固定点、舵机孔和模块座 | 1 | 124.00×76.00×91.50 | 正面朝下 |
| R02 | 深可拆前盖、内凹遮光井与导声管 | 1 | 124.00×76.00×28.70 | 正面朝下 |
| R03 | 可拆后盖：开关、充电、喇叭与功放座 | 1 | 104.30×58.00×13.40 | 背面朝下 |
| R04 | 完整屏幕板固定框 | 1 | 106.50×58.00×5.60 | 背面朝下 |
| R05 | 加强底盘与电池托架 | 1 | 110.80×85.70×8.60 | 沿现有底面 |
| R06 | 主控PCB支撑架 | 1 | 104.00×41.50×31.40 | 倒置，支脚朝上 |
| R09 | Type-C充电板托架 | 1 | 34.00×32.00×8.20 | 沿现有底面 |
| R10_1 | 充电板边缘压条 1 | 1 | 29.00×3.40×4.80 | 沿现有底面 |
| R10_2 | 充电板边缘压条 2 | 1 | 29.00×3.40×4.80 | 沿现有底面 |
| R11 | 喇叭后压圈 | 1 | 40.60×29.00×2.00 | 正面朝下 |
| R12_L | 一体小耳朵 L | 1 | 17.60×18.66×6.47 | 正面朝下 |
| R12_R | 一体小耳朵 R | 1 | 17.60×18.66×6.47 | 正面朝下 |
| R13_L | 小耳朵内侧压垫 L | 1 | 10.00×10.00×1.20 | 沿现有底面 |
| R13_R | 小耳朵内侧压垫 R | 1 | 10.00×10.00×1.20 | 沿现有底面 |
| R14 | 可换麦克风托架 | 1 | 18.00×34.60×16.00 | 正面朝下 |
| R16 | PCA9685后舱安装架 | 1 | 78.50×31.00×32.40 | 倒置，支脚朝上 |
| R17 | DFR0753舵机降压固定架 | 1 | 33.00×54.00×2.40 | 侧面朝下 |
| R18 | 好盈UBEC逻辑降压固定架 | 1 | 46.86×54.50×2.40 | 侧面朝下 |
| L101_FL | 髋舵机固定座 FL | 1 | 55.40×24.00×40.00 | 侧面朝下 |
| L101_FR | 髋舵机固定座 FR | 1 | 55.40×24.00×40.00 | 侧面朝下 |
| L101_RL | 髋舵机固定座 RL | 1 | 55.40×29.00×40.00 | 侧面朝下 |
| L101_RR | 髋舵机固定座 RR | 1 | 55.40×29.00×40.00 | 侧面朝下 |
| L102_FL | 上腿连杆与膝舵机座一体 FL | 1 | 61.70×31.00×13.35 | 侧面朝下 |
| L102_FR | 上腿连杆与膝舵机座一体 FR | 1 | 61.70×31.00×13.35 | 侧面朝下 |
| L102_RL | 上腿连杆与膝舵机座一体 RL | 1 | 61.70×31.00×13.35 | 侧面朝下 |
| L102_RR | 上腿连杆与膝舵机座一体 RR | 1 | 61.70×31.00×13.35 | 侧面朝下 |
| L104_FL | 下腿与脚掌一体 FL | 1 | 53.70×39.00×18.00 | 侧面朝下 |
| L104_FR | 下腿与脚掌一体 FR | 1 | 53.70×39.00×18.00 | 侧面朝下 |
| L104_RL | 下腿与脚掌一体 RL | 1 | 53.70×39.00×18.00 | 侧面朝下 |
| L104_RR | 下腿与脚掌一体 RR | 1 | 53.70×39.00×18.00 | 侧面朝下 |

相对A2，R01增加底盘前固定横梁，R02改深可拆前盖，R03取消旋钮/按键孔，R04补排针末端让位。R07、R08后置压片已取消，旋钮和按键保留在屏幕原板上。编号有空缺是有意保留历史件号。

R02集成遮光井和导声管；R05集成电池托架；R03集成喇叭套和功放固定座；L102集成上腿和膝舵机座；L104集成下腿和脚掌。无需另打印这些已集成结构。小耳内片为浅浮雕，后处理上色。

电子件、金属螺丝、原装舵盘、硅胶脚垫及画面中的屏幕内容都是装配参照，不导出为打印件。V1、A1、A2继续保留为历史，不与A3混打。
