xaiojie/papabot/mechanical-design/structure-a2/紧固件安装明细.csv

安装位置 | 螺丝规格 | 单台数量 | 装配备注
屏幕固定框→主壳 | M2×6 | 4 | R04/R01，螺母在主壳内侧槽
两块电源架→侧壁 | M2×6 | 8 | R17/R18；螺母从主壳外侧装入，模块边缘避开螺丝头
充电托架→后面板 | M2×6 | 2 | R09/R03，螺母在托架内侧槽
8个舵机安装耳 | M2×8 | 16 | 每个2颗；实物舵机耳片厚度需复核
8个原装双臂舵盘→打印连杆 | M2×8 | 16 | 每个2颗；不替代舵机中心螺丝
独立按键后置压片 | M2×8 | 2 | R08/R03，螺母从后面板外侧装入
EC11后置压片 | M2×8 | 2 | R07/R03，螺母从后面板外侧装入
小耳朵 | M2×8 | 2 | R12/R13；螺母从耳朵后侧装入
可换麦克风架 | M2×8 | 2 | R14/R01；内侧沉孔，螺母从外侧装入，试配后修短外露尖端
主控PCB→R06 | M2×8 | 4 | 头径≤4.0mm、头高≤2mm；不用大垫片，沿用PCB原Ø3.2孔
喇叭后压圈 | M2×10 | 2 | R11/R03，螺母从后面板外侧装入
两条充电板压条 | M2×10 | 4 | R10/R09，螺母从托架底部装入
屏幕原板→固定框 | M3×8 | 4 | R04，配0.8mm平垫片；螺母从框背面装入
前盖、后盖→主壳 | M3×10 | 8 | 各4颗；配0.8mm平垫片
底盘→前盖/主壳 | M3×10 | 4 | R05；配0.8mm平垫片，前2个螺母在前盖背部
主控架→底盘 | M3×10 | 4 | R06；M3螺母从支脚侧面装入，配0.8mm平垫片
PCA9685架→底盘 | M3×10 | 4 | R16；M3螺母从支脚侧面装入，配0.8mm平垫片
四个髋座→底盘 | M3×12 | 8 | 每座2颗；螺母从底盘顶部装入，配0.8mm平垫片
