xaiojie/papabot/hardware-selection/bom-v1/README.md

# 内置电池版：整机 BOM 与建模准备

> 历史版本：自2026-09-08起，当前选择与采购核算见[全套配件选型V2](../bom-v2/README.md)。本页N16R8占位及619.53元总额只代表V1；已确认主控改为LCKFB-ESP32S3R8N8。旧build-bom.mjs/build-lcsc-import.mjs是历史生成器，不应用于覆盖当前V2状态。

日期：2026-09-07。本轮更新电池定制要求、Type-C充电板、输入配件及舵机商品图。保留此前屏幕和奶油薄荷配色。尚未制作PCB、固件或正式打印文件。

[可编辑 Excel](exports/桌面助手-BOM与建模尺寸.xlsx) 包含采购BOM、开孔尺寸待办及分件计划。[电池与充电选型、给商家的定制文字](../power-selection-2s.md)。

## 当前选择和数量

- 舵机：MG90S 全金属齿轮180度，**8个**，每腿2个。随包舵盘、中心螺丝一起采购；单腿试样取其中2个，不额外增加到10个。

- 电池：**定制成品2S 7.4V 1000mAh，1包**。要求持续10A、允许充电至少1A、包内每节保护和被动均衡、共口P+/P-及XT30配对接头。定制需求已写，但商家可做性、交期、价格、真实尺寸与重量还没有确认。

- 充电板：**TELESKY MK021163，TYPE-C接口，2S8.4V，1块**。用户图五价14.13元、标注板体28×17mm。默认恒流电流和厚度、孔位仍未核实；先以0.4～0.5A充电作为设计目标，实际值必须匹配电池厂家允许范围。

- 输入配件：5V2A USB-A充电头1个、A转Type-C线1条。原面板充电插座预算改为线材，充电座已在P02板上；不再同时计旧8.4V外置充电器。已有合适配件可把数量改0。

## 金额口径

**参考现金预留 619.53 元**；各行低/高预留组合为 458.53～850.53 元，均不是商家总报价或获批新预算。

屏幕32.40元＋8个舵机80元＋充电板14.13元，已有用户截图价小计 **126.53元**。这些价格未验证结算价。定制电池80元只是预算，不使用普通对讲机电池14.70元或单节裸电芯11.80元作为定制包价格。

相较上一版580.40元，定制电池预留由55改80（+25），外置充电器20元改为板14.13元（-5.87），补5V输入适配器20元，总增39.13元。线材替代旧插座仍为5元。充电板改电流服务若收费需按报价更新。

| 编号 | 部件 / 规格 | 数量 | 参考单价（元） | 小计（元） | 当前状态 |
|---|---|---:|---:|---:|---|
| E01 | 途格斯 2.4寸 ST7789 TFT＋EC11 | 1 块 | 32.40 | 32.40 | 已选，待实测 |
| E02 | MG90S 全金属齿轮 180度，带舵盘螺丝 | 8 个 | 10.00 | 80.00 | 本轮选定，待实测 |
| E03 | ESP32-S3 N16R8 已焊排针开发板 | 1 块 | 45.00 | 45.00 | 推荐型号，板型待定 |
| E04 | PCA9685 16路 PWM 成品模块 | 1 块 | 12.00 | 12.00 | 推荐模块，待选商品 |
| E05 | I²S 数字麦克风模块，INMP441 类 | 1 块 | 8.00 | 8.00 | 推荐接口，待选商品 |
| E06 | MAX98357A I²S 单声道功放模块 | 1 块 | 6.00 | 6.00 | 推荐模块，待选商品 |
| E07 | 4Ω 3W 小喇叭，优先约28～30mm外形 | 1 个 | 6.00 | 6.00 | 规格方向，外形待选 |
| P01 | 定制2S 7.4V 1000mAh电池包＋保护均衡 | 1 包 | 80.00 | 80.00 | 规格选定；待商家确认可做 |
| P02 | TELESKY 2S 8.4V Type-C充电板 MK021163 | 1 块 | 14.13 | 14.13 | 选TYPE-C款；充电电流待核 |
| P03 | 舵机路降压模块，约5V大电流输出 | 1 块 | 28.00 | 28.00 | 电源路线候选，待选商品 |
| P04 | 逻辑/音频路降压模块，5V约2A级 | 1 块 | 12.00 | 12.00 | 电源路线候选，待选商品 |
| P05 | USB-A转Type-C充电线，支持5V2A | 1 条 | 5.00 | 5.00 | 选接口方向；线材待购 |
| P06 | 电源控制开关 | 1 个 | 5.00 | 5.00 | 开关外形待选 |
| P07 | 负载开关/保险、采样与滤波元件 | 1 套 | 15.00 | 15.00 | 原理图阶段定值 |
| P08 | 电源/信号线、排母及配套连接器 | 1 套 | 18.00 | 18.00 | 接口方向待定 |
| P09 | 定制载板/配电PCB首次打样 | 1 批 | 30.00 | 30.00 | 待设计 |
| P10 | 5V 2A USB-A成品电源适配器 | 1 个 | 20.00 | 20.00 | 输入规格选定；商品待购 |
| M01 | 壳体与支架螺钉、螺母、垫柱 | 1 套 | 15.00 | 15.00 | 规格与数量待结构设计 |
| M02 | 软脚垫4只 | 1 套 | 8.00 | 8.00 | 外形待定 |
| M03 | 电池束带、缓冲/导音泡棉和扎带 | 1 套 | 5.00 | 5.00 | 依结构裁切 |
| M04 | 整套壳体、腿及安装小件打印 | 1 套 | 90.00 | 90.00 | 分件计划，未出生产文件 |
| M05 | 屏幕样框、单腿与配合试样打印 | 1 轮 | 20.00 | 20.00 | 需尺寸后建模 |
| L01 | 多个供应商合计运费 | 1 项 | 25.00 | 25.00 | 待结算 |
| L02 | 补件与试制返工预留 | 1 项 | 40.00 | 40.00 | 预留 |
| | **现金预留合计** | | | **619.53** | |

PCB行计首次小批打样整单现金，以5片小批询价但单机只用1片。不计SMT，不把整批现金按五分之一摊去。模块、辅料与包内保护均衡不重复计价。整套打印及第一轮样片分别计；精细喷漆、购买工具、更多返工和持续语音服务未包含。

## 电源匹配与接口

电池连续10A、舵机降压5V6A级、逻辑降压5V2A级均为选型目标，尚未通过实物峰值和温升验证。容量与C数不能取代整包电芯、保护、接头和线材的电流核实。

首版关机充电。Type-C板给电池保护后充电口供电，电池经负载开关和两路降压给整机供电并共地。2S电压不直接送MG90S或ESP。充电板不承担八个舵机工作电源；PCA9685只提供PWM信号。

充电、每节电芯保护、均衡、负载降压分别核对。商品写“5V2A”是输入参数，不代表8.4V2A充电。图五没有给出默认恒流数值，本轮没有把它编成已知参数。电池定制单要求包内每节保护及均衡；商家未确认前不宣称组合已验证。

充电板可用28×17mm商品标注做初步包络；高度、USB口坐标、孔径孔距未给出。电池75×40×20mm、80g是询价目标，不是已知尺寸或已冻结仓体。电池和热源分开，插拔力由接口板支架承担。

## V1交付与屏幕前端

现有manifest **22/23项哈希一致**，当前 desktop-assistant-assembly-v1.blend 与最初校验值不同。保留当前模型及八张历史渲染，未恢复旧模型。本轮只更新采购和尺寸资料；原25项限定检查属于上次交付，没有新的运动或制造通过结论。

V1主体约118×84.6×76mm，含腿耳约208×106×122.5mm，显示玻璃后退约20.8mm。旧八个蓝色舵机为占位，P010连接区未完成，31个打印候选对象不等于31个可交商家生产件。

屏幕按上轮建议继续研究：保留91×44mm原PCB，EC11和独立按键移至后部可拆面板，前方只露居中屏幕，玻璃内缩0.5～1mm作为目标。拆焊和实际高度链未核实，尚未动硬件或CAD；仅摘旋钮帽未必能消除突出。商品59×42.5标注、V1的70×51开窗均不能直接当有效发光区和最终加工尺寸。

## 无舵机尺寸图时的工作方式

已收到MG90S黑色机身与塑料舵盘商品照片，可开始外观重建和可调整占位。商家没有工程图，因此安装耳孔、轴中心、舵盘厚度和螺钉配合必须在收货后实测；不从透视商品照反推精确孔距，也不按照片打印花键。先做可替换舵机托架，再用2个舵机验证单腿承载与运动。

## 开孔尺寸待办

| 器件 / 决定 | 要补齐什么 | 决定哪些结构 |
|---|---|---|
| 显示屏＋EC11整板 | 板厚、玻璃/发光区尺寸及偏置；旋钮/按键/排针总高 | 前盖、居中开窗、支架、机身深度 |
| 屏幕平齐安装方式 | 核实拆焊焊点、屏与PCB高度；玻璃内缩0.5～1仅设计目标 | 前盖、显示支架、后控件板；原PCB不裁切 |
| 8个MG90S本体 | 含安装耳尺寸、孔距孔径、轴中心/高度、线缆出口、质量 | 四腿安装座、关节位置与摆动范围 |
| 配套舵盘＋中心螺丝 | 舵盘厚度、孔位、花键配合、中心螺丝规格与工具空间 | 上/下腿连接；复用随包舵盘，不打印花键 |
| 内置电池包 | 商家确认可做、真实长宽厚/质量、插头位置与极性、充电上限 | 电池仓、底盖、重心；75×40×20只是询价目标 |
| Type-C充电板＋电源开关 | 板厚/最高件、孔径孔距、USB口坐标、允许面板厚度；开关外形 | 后部可更换接口板；USB插头和线束避让 |
| ESP32-S3主控板 | 具体板型长宽高、排针/排母、USB位置、插头空间、天线边界 | 可换托板与USB开孔 |
| 喇叭 | 外框、厚度、磁体、孔位/压边、出线位置与所需背腔 | 声孔、支架、壳内背腔 |
| 麦克风 | 顶/底拾音孔方向、板体和声孔坐标、接线高度 | 收音孔、导音泡棉与麦克风座 |
| PCA9685/功放/两路降压模块 | 外形、孔位、高件、端子、散热和线束插拔 | 可更换托板、内腔和通风 |
| 自定义PCB | 先共定板框、固定孔、接口方向、元件高度与禁布区 | 托板、机身内腔和外部接口 |
| 紧固件＋软脚垫 | 螺钉头/长度、螺母外形、柱高、脚垫外形 | 可拆壳体、舵盘连接和脚底 |
| 腿长、关节轴向和承载 | 运动范围、有效力臂、整机质量/重心、舵机持续工作能力 | 腿、支架、避让、站姿 |
| 打印材料与公差 | 材料、工艺、供应商公差；薄件厚度和孔配合试样 | 所有最终打印件，尤其关节和螺母槽 |

主控、功放、PCA9685和降压小板使用可更换托板，后部使用可更换接口板。先共定自制PCB板框、孔位、接口边和高度，再推进原理图与布线；外壳开孔仍以选定成品板与连接器的实际尺寸为准。

## 分件计划

下表是计划，允许将夹子/垫柱并入相邻部件；不等于已生成STL数量。外购舵机、配套舵盘和螺丝不打印。

| 编号 | 部件 | 预计数量 | 当前状态 |
|---|---|---:|---|
| S01 | 主壳 | 1 | V1有外形，结构待细化 |
| S02 | 可拆前盖 | 1 | 需要重做前端高度关系 |
| S03 | 底盖/维修盖 | 1 | V1有外形，锁止待设计 |
| S04 | 前脸薄荷装饰圈 | 1 | V1仅0.4mm深，需按工艺调整 |
| S05 | 屏幕固定支架 | 1 | V1占位支架，待实测 |
| S06 | 短遮光圈/玻璃保护边 | 1 | 重新设计 |
| S07 | 屏幕隔离垫柱 | 4 | 按实物定高，数量可合并 |
| S08 | 可更换电子托板 | 1 | V1有占位，孔位待定 |
| S09 | 耳框 | 2 | V1有形状，紧固待细化 |
| S10 | 耳内片 | 2 | V1厚0.7mm，待工艺调整 |
| S11 | 机身侧舵机安装座 | 4 | V1仅占位，需新建 |
| S12 | 上腿/第二舵机承载件 | 4 | 需按MG90S与舵盘重画 |
| S13 | 下腿 | 4 | 需按舵盘与步态重画 |
| S14 | 关节装饰盖 | 8 | V1有外观，需调整 |
| S15 | 电池托架 | 1 | 规格已写，实物尺寸与布局待定 |
| S16 | 电池压条/束带座 | 1 | 新增，随托架设计 |
| S17 | 喇叭支架/背腔件 | 1 | 新增/与壳体整合待定 |
| S18 | 麦克风固定座 | 1 | 新增，待麦克风板型 |
| S19 | 后部可更换接口与控件板 | 1 | 充电板型已选；孔位和控件移位待核 |
| S20 | 线束固定夹 | 2 | 建议起始数量，布局后调整 |
| S21 | 舵机局部装饰罩（可选） | 8 | 可选外观件，运动校核后决定 |

## 资料来源

[屏幕截图](../reference/screen-2p4-ec11-price-32p40.png)、[MG90S选中价](../reference/servo-option-2-mg90s-180-selected.png)、[本轮舵机商品图](../reference/servo-mg90s-product-photo.png)、[充电板图五](../reference/charger-telesky-2s-typec.png)、[定制入口图二](../reference/battery-custom-inquiry-7p4.png)。其他候选截图及详细比较见电源选型记录。

原厂型号参考：[MG90S](https://towerpro.com.tw/product/mg90s-3/)、[ESP32-S3 N16R8](https://www.waveshare.net/shop/ESP32-S3-DEV-KIT-N16R8.htm)、[PCA9685](https://www.nxp.com/docs/en/data-sheet/PCA9685.pdf)、[MAX98357A](https://www.analog.com/en/products/max98357a.html)。厂商芯片/型号资料不等于当前淘宝模块已经电气或机械验证。

本轮商品页读取被Computer Use自动访问审查拒绝，未绕过限制；价格来自用户截图，没有声称读到最新SKU详情。
