xaiojie/papabot/hardware-selection/bom-v2/README.md

# 桌面助手：全套配件选型 V2

> 当前全量Excel已更新为[V3导入版](../bom-v3/README.md)：补了PCA9685成品商品及两种线材，共43项、首表37项实物需求。V2保留为上一轮调研依据；其46行、769.56元和仅5项的导入子集均为历史口径。

更新：2026-09-08。优先检索立创商城及立创工业品，再用厂商官网补充成品模块。**已确认屏幕、8个MG90S、电池定制规格、TELESKY充电板，以及LCKFB-ESP32S3R8N8开发板。两路降压电源仍是本轮候选。** 用户已更正“舵机电源”为“舵机”，没有另行确认电源模块。

[全套配件 Excel：46项、10个工作表](桌面助手-全套配件选型V2.xlsx) · [结构化 BOM](bom-data.json) · [立创导入子集 Excel](立创BOM导入-已核料号子集.xlsx) · [导入 CSV](立创BOM导入-已核料号子集.csv) · [数量与金额核验](validation.json)

这是选型进展和可评审清单，尚未形成全部物料均已定型的采购单。没有下单、修改购物车、上传云BOM或联系供应商。网页库存/价格是本轮读取记录，采购时需重查。下面“推荐”均为助手本轮建议，不等于用户已经确认。

## 本轮建议的主要模块

| 用途 | 型号 / 商品 | 数量 | 单价 | 渠道与本轮状态 | 接入要求 |
|---|---|---:|---:|---|---|
| 主控 | [LCKFB-ESP32S3R8N8 / C20626143](https://item.szlcsc.com/22034693.html) | 1 | ¥35.90 | 用户已确认；立创现货1488 | 8MB Flash＋8MB PSRAM；附排针但未焊接 |
| 麦克风 | [SEN0327](https://www.dfrobot.com.cn/goods-2567.html) | 1 | ¥15.00 | 官网有货；推荐候选 | I²S，接3.3V；Ø14mm、底部拾音 |
| 功放 | [DFR0954 / MAX98357A](https://www.dfrobot.com.cn/goods-3573.html) | 1 | ¥30.00 | 官网有货；推荐候选 | I²S，接逻辑5V；扬声器BTL输出 |
| 喇叭 | [24MM-4Ω3W-2P1.25 / C50387237](https://item.szlcsc.com/53008620.html) | 1 | ¥9.69 | 立创现货89；推荐候选 | 4Ω/3W；参数表Ø23.6×10.4mm |
| 舵机降压 | [DFR0753](https://www.dfrobot.com.cn/goods-2971.html) | 1 | ¥55.00 | 官网有货；推荐测试候选 | 6–14V输入，5V输出，厂家标称最大8A |
| 逻辑/音频降压 | [第二块 DFR0753](https://www.dfrobot.com.cn/goods-2971.html) | 1 | ¥55.00 | 同款备选，暂用于完整方案计价 | 需求约2A级，性能偏富余；继续保留降本空间 |
| 舵机PWM | PCA9685 成品小板 | 1 | ¥12.00预留 | 低价现货SKU仍待选 | 逻辑3.3V，舵机5V独立配电；不要购成裸芯片 |

开发板按普通首档价计，学生价¥30.515有资格条件，本清单未套用。立创同款[DFR0954 / C21292518](https://item.szlcsc.com/22712835.html)显示¥37.75、库存0，因此本轮优先官网¥30的现货入口。

SEN0327官网商品文本没有注明INMP441芯片型号，本清单只确认其成品模块型号和I²S接口，不擅自补芯片型号。

**喇叭线端为1.25mm间距，DFR0954的插座为PH2.0，不能直插。** 当前接线设想为使用功放焊盘接喇叭线并绝缘；若想保留插拔，需要先核定喇叭连接器系列，再配准确转接线。功放OUT+和OUT−接扬声器两端，均不得接系统地。

## 立创可找到的配件及起订量

金额按“建议购买数量 × 首档单价”，逐行四舍五入到分。数量含起订多买的备件；螺丝、保险与线材仍有下列条件。

| 物料 | 立创编号 / 入口 | 暂定装机量 | 建议购买量 | 本行金额 | 状态与限制 |
|---|---|---:|---:|---:|---|
| LCKFB主控 | [C20626143](https://item.szlcsc.com/22034693.html) | 1 | 1 | ¥35.90 | 已确认板型 |
| 4Ω3W喇叭 | [C50387237](https://item.szlcsc.com/53008620.html) | 1 | 1 | ¥9.69 | 推荐；转接/焊线及背腔待落实 |
| 1000µF/10V电容，SHW1000UF10V8X12 | [C494548](https://item.szlcsc.com/505124.html) | 2 | 5 | ¥2.66 | 接舵机5V路；Ø8×12mm，脚距3.5mm |
| 470µF/16V电容，ERB16V470M8X12 | [C51953430](https://item.szlcsc.com/54681555.html) | 1 | 10 | ¥3.89 | 接逻辑5V路；Ø8×12mm |
| 1×20P/2.54排母，JILN22850120ANG1SYA01 | [C429947](https://item.szlcsc.com/426399.html) | 2 | 5 | ¥5.31 | 塑高8.5mm，供主控插座使用 |
| MINI 7.5A保险，029707.5WXNV | [C178942](https://item.szlcsc.com/190335.html) | 1 | 5 | ¥3.08 | 至少留1备件；电流值仍待浪涌/线材核对 |
| MINI PCB保险座，01530008Z | [C206907](https://item.szlcsc.com/208026.html) | 1 | 1 | ¥24.35 | 32V/20A PCB型，需要载板；并非带线保险座 |
| 24AWG软硅胶信号线，LCKFB-JUMP-WIRES-10P | [C53063971](https://item.szlcsc.com/56016470.html) | 暂3套 | 3套/30根 | ¥14.70 | 每套10根；公母/长度待核，不走动力主电流 |
| M2×6机牙螺丝，PM2X6 | [C357534 · MRO](https://item.szlcsc.com/mro/332656.html) | 暂20 | 100 | ¥1.07 | MOQ/增量100；装机数量和长度待结构 |
| M3×8机牙螺丝，PM3X8 | [C357544 · MRO](https://item.szlcsc.com/mro/332666.html) | 暂12 | 100 | ¥1.38 | MOQ/增量100；不是舵盘中心螺丝 |
| **以上本轮网页价合计** | | | | **¥102.03** | 含尚需设计或接口核对的候选，不是立即下单建议 |

立创导入文件只含前5项明确料号，金额**¥57.45**。保险座/保险取决于载板方案，线材头型未核，MRO螺丝规格还需结构决定，因此保留在全套BOM而未混入此子集。导入文件尚未上传验证；使用云BOM时按“商品编号”和“需求数量”映射列。它不是全机采购单。

开发板已附公排针，不重复买整套主控公针；电池定制要求含XT30配对接头，不另算2对。立创已查到标准[XT30U-M / C99101](https://item.szlcsc.com/mro/100314.html)及[XT30U-F / C99102](https://item.szlcsc.com/mro/100315.html)，但各MOQ5，首档价未核，默认额外采购0。

## 电源方案的适配边界

本轮推荐候选结构：电池保护后输出 → 近电池保险/合格配电路径 → 负载开关 → 舵机降压和逻辑降压。两路输出均为5V，分别布线并共地，**两块降压的5V输出不并联**。舵机总电流不经过主控、PCA9685小板普通铜箔或杜邦线。

充电支路：外部5V/2A充电头 → TELESKY Type-C充电板 → 电池厂家定义的保护后充电接口；首版工作负载关闭时充电。没有电源路径管理电路，尚不支持边充边用。电池保护/均衡的定制要求和充电板实测电流仍按[电池选型记录](../power-selection-2s.md)核对。

DFR0753的6V最低输入意味着不能一直运行到电池BMS的深放保护阈值。可先以带负载约6.4V停止舵机动作作为调试起点，最终阈值、回差、断电方式和电芯保护必须一起设计；**该策略尚未实现，也未证明6.4V能覆盖所有瞬时压降**。8.4V、7.4V以及低电量区间都要验证5V输出、舵机起身瞬态和壳内温升。厂家“最大8A”不等于本机连续8A已验证；网页效率数值也不能直接用于2S工况。

用于筛选的计算：若舵机30W（5V×6A）加逻辑10W（5V×2A），按**假设85%效率**及6.4V电池输入，约需7.35A。若舵机达到模块标称8A上限，则总输出50W，同条件约9.19A，已接近定制包10A目标。这只是功率估算，不是峰值测试或实际效率证据。

保险7.5A暂用于器件方向和预算，须根据电池上限、线材/接点、保险时间电流曲线和实测起身浪涌调整；不能看额定电流就认定匹配。先验证两舵机单腿，再逐步验证八舵机、Wi-Fi、显示和音频同时工作。

## 仍需完成的选型

| 类别 | 已确定的采购要求 | 本轮缺口 / 后续处理 |
|---|---|---|
| PCA9685成品小板 | 1块，16路PWM，逻辑3.3V，V+独立，优先可控制OE | 立创搜到的HAT缺货且贵；¥12是预留，普通成品小板具体店铺待落实 |
| 更便宜的逻辑降压 | 输入覆盖计划2S运行区间，固定5V连续约2A | 第二块DFR0753可作为备选；不能以最低7.5/8V输入的模块降本替换 |
| 操作开关、负载开关、采样及去耦 | 主干按10A目标设计；上电舵机默认关闭 | 先定原理图和断电策略，再选MOSFET/阻容与具体开关，不按小拨动开关外观直接冻结 |
| 电源线 | 红黑18AWG主干各1m、红黑20AWG短分支各1m，供裁切 | 立创检索多为整卷；需米售小包装，最终线径按压降/温升定 |
| 线束/转接 | 8路舵机3pin端口、模块短排针、信号线和喇叭焊线绝缘 | 线序/公母/长度及额定电流待线束表；暂不买不明规格转接插头 |
| 输入充电头和数据线 | 成品USB-A固定5V≥2A、A转C数据线1条 | 查到的绿联60116线缺货；20328充电头缺货且参数不足；已有合适件可复用并扣预算 |
| 紧固与安装 | M2螺母约20、M3热熔或捕获螺母约12、垫片约12、垫柱约4 | 材料/外径/长度须随载荷路径和实际板孔确定；不可把SMT铜螺母当热熔件 |
| 脚底与电池固定 | 软脚垫4只、10–12mm宽约150mm束带、泡棉、扎带、热缩管 | 规格和预算已列，小包装商品未锁定；脚垫外购与TPU打印二选一计价 |
| 定制电池与已选充电板 | 2S1000mAh持续≥10A的定制目标；关机充电 | 电池供货/报价/真实尺寸与充电板默认CC电流仍缺证据 |
| PCB与结构 | 小批载板、整套打印、屏幕框与单腿试样 | 原理图、PCB器件级BOM、生产图和运动/装配测试尚未完成 |

这些缺口没有用搜索词、相似裸芯片或缺货商品冒充已选SKU。全套表中的数值用于保持费用和配件覆盖，不表示全部完成采购验证。未追加相机、传感器、触摸屏或另一套舵机；现有功能范围为显示、语音和八舵机四足。

## 排除与备选依据

- [微雪 Servo Driver HAT](https://www.waveshare.net/shop/Servo-Driver-HAT.htm)官方确认PCA9685、3.3V逻辑、65×30mm并有预留I²C，能接其他主控；但板载5V只有3A。[立创C5374673](https://item.szlcsc.com/6230032.html)本轮¥100.93且缺货，不作为当前低价完整供电方案。
- [TPS5450-LZM5450-5V / C19673926](https://item.szlcsc.com/mro/20980610.html)虽有宽输入标题，详情建议≥2V压差、免散热<15W，不能据此认定支持整个2S电量范围下5V/6A。
- K7805-2000R3、K12T-6A-P、XL4016等输入下限过高；[DFR1015](https://www.dfrobot.com.cn/goods-3551.html)最低7.5V输入，[DFR0756](https://www.dfrobot.com.cn/goods-2970.html)有≥2V压差要求，均未用来替代两路候选。
- [DFR1202](https://www.dfrobot.com.cn/goods-4071.html)是¥68有货的6–24V转5V最大16A备选，30×26×8mm，高负载依赖背面散热焊盘和载板铜箔；不与DFR0753重复计价。PGOOD为5V信号，不能直接按ESP GPIO电平接入。
- 廉价[JDT 01530008.J / C55141810](https://item.szlcsc.com/58877668.html)保险座¥4.64，但额定/图纸未核。不能因为外形或编号相似就继承Littelfuse的32V/20A参数。
- MAX98357A裸芯片、INMP441裸芯片、直流Motor Driver HAT、贴片铜螺母和工业整卷线材均已排除直接替换。完整记录在Excel“排除记录”和“备选与缺货”。

## 费用与历史版本

| 口径 | 金额 |
|---|---:|
| 本轮网页观察价，含按MOQ买的余量和两块DFR0753备选 | ¥257.03 |
| 原屏幕、8舵机、充电板的历史截图价 | ¥126.53 |
| 定制电池、未定配件、PCB、打印、运费和返工预算 | ¥386.00 |
| **本方案参考现金预留** | **¥769.56** |

比V1的¥619.53增加¥150.03，主要来自两路降压备选、具体成品音频模块和拆细后的保护/线材费用。网页价小计也包含有条件候选，不能当成已买金额；¥386预算部分尚无真实报价。新的总预算上限未确认。

按两路DFR0753计价是为了呈现一套有具体电源入口的备选成本，不表示用户确认第二块。后续若逻辑路选到合适的价格P，方案总额变化为P−55；若改带线保险座，应扣掉当前PCB座再加入实际价。旧P07/P08/M01整套预算已经拆成明细，**没有叠加重复计算**。XT30配对件含在电池包要求里，舵盘/中心螺丝含在8个舵机里。

Excel为可筛选的静态快照，金额已重算核验。手工编辑数量后须同步重算，或修改[本版生成脚本](build-v2.py)后生成本目录文件。本脚本不覆盖V1，也不自动修改根目录的人工决策说明。[V1历史BOM](../bom-v1/README.md)及其旧生成器保留作历史，不能拿旧N16R8或旧总额覆盖当前选择。

## 当前成果与建模影响

本轮已阅读当前项目说明、外观决策、历史BOM、供电/舵机记录、建模/打印路线及总装验证资料。A奶油薄荷、居中屏幕、小耳饰和暂去刻字/Logo仍是外观方向。Blender V1及八视图已交付；原25项检查属于当时限定交付检查，不等于整机制造或运动通过。

此前完整性记录显示22/23项哈希匹配，当前主Blender文件与原交付校验值不同；本轮保留现状，未重建或恢复。CAD里的八个蓝色舵机仍是占位，屏幕玻璃后退约20.8mm；EC11/按键移到后部、玻璃内缩0.5–1mm只是待核实的改进方案。没有新的CAD、STL/3MF/STEP、原理图、PCB或固件交付。

新主控排母高度8.5mm、喇叭Ø23.6×10.4mm和麦克风Ø14mm/底部声孔必须进入下一轮布局。DFR0753与DFR0954的完整板框/高件尺寸、实际开发板GPIO/USB/天线边界、电池成品尺寸、舵盘载荷连接仍需补齐。Excel继承14项尺寸待办及21类打印分件计划，未把它们标成生产图。
