xaiojie/papabot/hardware-selection/bom-v3/README.md

> 历史快照：当前以[四类配件定型V4](../bom-v4/README.md)及其Excel为准。V4逻辑路改好盈86010010，总开关选S1A，仅保留1块DFR0753；下文V3待选状态不再代表本轮四类结果。

# 全量 BOM Excel：按立创当前字段导出

日期：2026-09-08。按用户要求，先制作Excel，由用户自行导入新版立创BOM。未修改当前云表，未上传或采购。

**全量清单已列好，全部物料选型尚未完成。** 当前共43项：37项实物需求，另有6项费用/服务/包内已含配件。其中19项已有具体型号或既定店铺款，18项还需定制确认、选定商品或电路/结构定型。因此本版是完整的当前选型清单，不标为最终采购单。

- [全量BOM Excel：优先打开这一份](桌面助手-全量BOM导入V3.xlsx)
- [全量首表 CSV](桌面助手-全量BOM导入V3.csv)
- [全部已知C编号 Excel：9项](立创BOM导入-全部已知C编号V3.xlsx)
- [全部已知C编号 CSV](立创BOM导入-全部已知C编号V3.csv)
- [机器可读数据与新商品证据](bom-data.json)
- [导出数量、字段和金额核验](validation.json)

## 怎样导入

全量Excel的第一个工作表为 **BOM导入_全量**，第1行就是表头，没有标题或合并单元格。前7列按用户当前页面排列：

| Excel字段 | 对应网页字段 | 处理方式 |
|---|---|---|
| 原型号 | 原型号 | 已查具体型号填写；未定型号留空，需求放在原参数 |
| 原品牌 | 原品牌 | 仅填已知品牌；所选MG90S未证明是TowerPro原厂，未补该品牌 |
| 原封装 | 原封装 | 未核实封装留空，不把袋装、整板尺寸当芯片封装 |
| 原参数 | 原参数 | 部件用途、规格与包装单位 |
| 原C编码 | 原C编码 | 仅9项查到的立创编号；外采和未定项不编造C码 |
| 单套用量 | 单套用量 | 本项目1台的数量，单位见后面的单位列 |
| 备损量 | 备损量 | 按1套采购计算，含MOQ多买余量及备件，为绝对数量 |

导入时选择首表，采购套数设 **1套**。例如PM2X6螺丝：单套20＋备损80＝购买100；1000µF电容：单套2＋备损3＝购买5。不要把“建议采购数量”再叠加进单套用量。FIT0030的“3包”表示30根线。

本轮未上传验证字段映射。若界面把备损量解释为百分比，则不要映射这一列；仅就1套采购而言，可以把“建议采购数量”映射为单套用量，备损设0。若增加套数，应重新按需求和MOQ计算。

外采和未定项不能保证在立创自动匹配。全量表保留它们，是为了覆盖整套配件和选型进度；不要把自动推荐的裸PCA9685/MAX98357A等芯片当成品模块。空型号行是否被网页保留也需要导入预览核对，Excel“全部43项总表”始终保留完整记录。

若只匹配已有C码，使用单独的9项文件。它包括保险/保险座等条件候选及MRO螺丝，并不表示这些器件已通过整机适配；若云BOM无法匹配MRO，按链接在工业品核对。在线匹配结果与结算数量仍需查看。

## 本轮补齐的具体商品

| 部件 | 商品与渠道 | 用量 | 页面单价 | 结果 |
|---|---|---:|---:|---|
| PCA9685成品小板 | [汉丽电子科技，HANLI 16路PWM/IIC模块](https://item.taobao.com/item.htm?id=967408745108) | 1块 | ¥8.90 | 页面有货；替换原¥12无SKU预算。电气接线/尺寸图仍需核对 |
| 母对母信号线 | [FIT0030，DFRobot官网](https://www.dfrobot.com.cn/goods-366.html) | 3包，共30根 | ¥6/包 | 有货；20cm、10根/包、母母，页面电流<1000mA |
| 电源线 | [FIT0585，DFRobot官网](https://www.dfrobot.com.cn/goods-1770.html) | 1套，红黑各1m | ¥10/套 | 有货；18AWG、0.75mm²、镀锡铜/硅胶 |

三项均为本轮推荐商品，尚未由用户逐项确认或购买。PCA商品页面快递5元，仍归入统一L01运费预留，不额外重复计。主干及短分支暂统一用FIT0585裁切，8个舵机的自带线复用；如实测布局长度不足再补件。网页线材“22A”标称不作为本机成束电流已验证的结论。

原V2的W03/W04/W05/W06四条红黑18/20AWG预算合并为V3的W03套装，所以总行数由46减为43。W02由头型未核的立创LCKFB线改为已核母母头的FIT0030，不再同时购买两种信号线。其余元件与接口边界继续参考[V2技术选型记录](../bom-v2/README.md)：两路DFR0753仍是备选计价，功放/喇叭插头不直配，充电板电流未知，首版关机充电。

## 完成度和后续填表条件

18项未定型记录都在Excel“仍需定型的项目”中，分为以下实际依赖：

| 依赖 | 涉及物料 | 收尾条件 |
|---|---|---|
| 定制电池 | P01 | 厂家确认可做、成品尺寸/电流及报价；目前只是已确认定制规格 |
| 商品及线束接口 | P05、P10、W07、W09、W10 | 充电头/数据线、端子排针、热缩管、洞洞板的具体小包装SKU |
| 电源原理图 | P06、F05、F06、F07 | 操作开关、负载开关、采样和去耦/默认关闭的电路定型，再给料号和实际件数 |
| 结构及小包装 | M03–M10 | 螺母/嵌件、垫片/垫柱、脚垫、束带、泡棉、扎带；尺寸和数量随板孔/电池/脚底确定 |

已有型号的19项也不等于全部工程验证完成：PCA模块需核对3.3V逻辑/OE与独立V+，电源需低电量/热测试，保险值和螺丝长度仍需电路或结构验证。全套PCB裸器件BOM必须在原理图形成后才能逐个准确列出；当前没有将一套“采样电路预算”伪装成已完成的器件清单。

后续沿用物料编号补型号、C编号、实际数量和价格，再导出同样字段的新版Excel。用户负责导入网页，这一交付偏好已写入项目记录。

## 金额

| 口径 | 金额 |
|---|---:|
| 本轮网页观察价，含两路DFR0753备选及MOQ | ¥279.23 |
| 历史屏幕、8舵机、充电板截图价 | ¥126.53 |
| 定制/未选件/PCB/打印/运费/返工预算 | ¥356.00 |
| **完整参考现金预留** | **¥761.76** |
| 其中：9项已知C编号物料 | ¥87.33 |

相对V2的¥769.56减少¥7.80。此金额是单机试制计划，非结算报价或新的获批总预算。6项不放进物料自动匹配的条目是：已含于电池包的XT30配对件、PCB打样、整套打印、试样打印、运费和返工预留；它们仍保留在全量总表中。

导入页采用纯数值，已核对“单套＋备损＝采购量”、C编号、行数、合并去重和金额；没有公式空缓存问题。手工修改数量/价格后须重算金额，或修改[生成脚本](build-v3.py)后重建本目录文件。V1/V2留作历史，不应用旧脚本覆盖当前选择。
