xaiojie/papabot/hardware-selection/bom-v4/README.md

> 采购文件已更新为[简洁分渠道V5](../bom-v5/README.md)。请只用V5的01文件导入立创；下文V4全量表保留工程记录，不再用于一键下单。型号和接线方案继续有效。

# 四类配件已定型：样机采购 BOM V4

2026-09-08。用户授权完成 PCA9685 成品、便宜的逻辑降压、总开关及小包装线材选型。本轮四类已选定，舵机路保留 **1 块 DFR0753**。这些是样机采购决定，尚未进行实物电气、温升或装配验证。

- [完整 Excel：首表按立创当前字段排列](桌面助手-全量BOM导入V4.xlsx)
- [立创已知 C 编号 Excel：10 项](立创BOM导入-全部已知C编号V4.xlsx)
- [全量导入 CSV](桌面助手-全量BOM导入V4.csv)
- [结构化 BOM、选型依据及来源](bom-data.json)
- [Excel 数量、字段与金额核验](validation.json)

## 本轮选定商品

| 物料 | 具体商品 / 购买规格 | 数量 | 单价 | 小计 | 查货结果 |
|---|---|---:|---:|---:|---|
| E04 PCA9685 | [汉丽电子科技 HANLI，16路 PWM/IIC 成品模块](https://item.taobao.com/item.htm?id=967408745108) | 1块 | ¥8.90 | ¥8.90 | 页面有货；淘宝外采 |
| P04 逻辑降压 | [顶峰模型，好盈 UBEC 3A（2–6S）](https://item.taobao.com/item.htm?id=820639316179)，厂家编号 **86010010**，购买 **3A(2-6S)** | 1个 | ¥35.00 | ¥35.00 | 已点选具体规格后核价、有货 |
| P06 总开关 | [NKK S1A / C5366606](https://item.szlcsc.com/6201668.html)，单刀单掷 ON-OFF 保持型、焊片 | 1个 | ¥29.42 | ¥29.42 | 立创现货16个，1个起订 |
| W02 信号线 | [FIT0030，20cm 母对母，10根/包](https://www.dfrobot.com.cn/goods-366.html) | 3包，共30根 | ¥6.00 | ¥18.00 | DFRobot官网有货 |
| W03 电源线 | [FIT0585，红黑18AWG硅胶线各1m](https://www.dfrobot.com.cn/goods-1770.html) | 1套 | ¥10.00 | ¥10.00 | DFRobot官网有货 |
| P03 保留舵机降压 | [DFR0753，6–14V输入、5V输出](https://www.dfrobot.com.cn/goods-2971.html) | 1块 | ¥55.00 | ¥55.00 | 官网有货；厂家最大8A，本机6A目标待测 |

本轮五行商品 **¥101.32**，加保留的舵机降压共 **¥156.32**。价格为网页观察快照；PCA店铺运费5元、好盈店铺运费6元已纳入L01统一运费预留，不在各行重复加。

立创优先：总开关可直接用 C5366606 匹配。此前查到的立创 PCA 成品板缺货且较贵；本次 UBEC 搜索没有找到对应稳压成品，MP1584相关结果有裸芯片或参数冲突，因此这两项采用淘宝，明确给出店铺和购买规格。信号线与电源线采用官网已核头型、线径和包装的型号。

## 逻辑降压和总开关的依据

[好盈官网](https://www.hobbywing.com/products/ubec-3a-2-6s99)明确列出：编号86010010，输入 **5.5–26V**，输出 **5V/3A 或 6V/3A**，跳帽切换，名义 **43×17×7mm、11g**。本机采用5V档，逻辑/屏幕/音频合计按5V/2A目标设计，比第二块DFR0753节省20元。它与旧报告排除的“UBEC 10A-Car、无5V档”是不同产品。

**到货先断电把跳帽设到5V，并空载测压后再接电子模块。** 厂家纹波小于50mVpp只对应12V输入、2A负载，不能写成2S电池下已测结果。安装须留引线、磁环和跳帽空间；保留原厂输入输出引线，核对极性后焊接/转接，不能用FIT0030承载整条逻辑路电流。

[NKK S1A官网规格页](https://www.nkkswitches.eu/products/Toggles/Toggles%20S/S1A/)列出 SPST、ON-OFF、15A(AC/DC)、30VDC、非发光、焊片及面板孔 **Ø12.5mm**。部分分销商写20A/DC，本版采用官网较保守的15A/DC表述，已高于本机工作母线设计电流；不把AC额定推导成DC额定。S1A本体比微型滑动开关大，后面板需按开关体、焊片、螺纹长度和操作空间布局，尚未修改CAD。

## 接线方案

```text
电池包保护后的 P+ ─ 保险 ─┬─ S1A总开关 ─┬─ DFR0753 ─ 舵机5V外部配电
                         │             └─ 好盈86010010（5V档）─ 逻辑/显示/音频
                         └─ 充电板 BAT+
电池包保护后的 P− ────────── 充电板 BAT− / 两路降压及信号共地
```

首版仍为**关机充电**。充电板接在开关前受保护节点，关掉S1A即可断开两路电池工作负载。两路5V输出不并联；外接调试USB可能另行给主控供电，调试接法需避免回灌。

原F05“高边负载开关与控制器小件”5元预留取消：S1A直接承担机械断开，已不需要该套手动控制器件。**本版不提供独立电子自动低压断电**；暂以负载下约6.4V停止动作并提示手动关机为起点，停动作不等于切断舵机电源。F06采样、回差和阈值还需电路/固件及压降测试，包内每节过放保护仍必须具备。不能等电池BMS动作才保证DFR0753处于≥6V输入范围。

PCA9685的VCC与I²C上拉都用3.3V，和ESP32共地；上电默认OE禁用方案计入F07，按到货板确认相关焊盘。仅从PCA小板引出PWM信号，8个舵机的正电源走外部配电通路，不经过PCA板上V+总线或ESP32开发板。

FIT0030是可直接插接的成品信号线；FIT0585是用于短电源段的硅胶线，需要裁切、焊接和绝缘。8个MG90S的自带线复用，电池定制要求已含XT30配对件，额外购买数量为0。主干18AWG按实际压降、成束和端点温升验证，不将网页22A宣称当作整机额定。载板排针、热缩管仍保留在其他辅料需求中；这份采购选择不表示整机线束已经加工或压接完成。

## Excel 导入及剩余项目

完整Excel保留 **42项总表**，其中 **36项实物需求**放在首表“BOM导入_全量”；另有6项费用/服务/包内件单独列出。本轮选定商品和保留舵机电源另放“本轮定型采购”，方便先采购。去掉F05后总行数从43变42。

首表前7列与用户当前页面一致：**原型号、原品牌、原封装、原参数、原C编码、单套用量、备损量**。选择第1行作表头，采购套数设 **1**。单套＋备损＝建议采购量，例如M2螺丝20＋80＝100个；FIT0030的3表示3包，不是3根。若网页备损字段采用百分比，则不映射该列，仅就1套采购把“建议采购数量”映射为单套用量，备损置0。

本轮新增S1A的C码，已知C码文件变为 **10项、¥116.75**。其中仍含此前保险/保险座及MRO等条件候选；如MRO无法自动匹配，按商品链接核对。外采不虚构C码，未定规格不虚构原型号；不要接受裸芯片自动替代成品板。用户自行导入新版云BOM，本轮未上传、改云表或下单。

原清单中仍有 **16项其他依赖**：电池定制供货P01；充电头/数据线P05/P10；采样/默认禁用小件F06/F07；载板排针/热缩管/洞洞板W07/W09/W10；结构辅料M03–M10。它们保留在“其他待定需求”，以免把本次四类完成误写成全机已具备生产BOM。屏幕、舵机和电池等现有决定延续，尚无正式原理图/PCB或固件。

## 当前金额

| 口径 | 金额 |
|---|---:|
| 网页观察商品，含MOQ | ¥288.65 |
| 历史用户截图价 | ¥126.53 |
| 定制、其他辅料、PCB、打印及费用预留 | ¥346.00 |
| **全套参考现金** | **¥761.18** |

相对V3：逻辑降压−20元，总开关由5元预留改29.42元（＋24.42元），删除F05预留−5元，净减少 **¥0.58**。这不是新的结算报价，346元仍为预算占位。

已重新打开两个Excel核验表头、各单元格、SKU/C码、单套＋备损数量、MOQ、全量金额及去重。导入单元格均为静态值。后续修改[bom-data.json](bom-data.json)后运行[build-v4.py](build-v4.py)重算；[select-v4.py](select-v4.py)仅用于重建本轮基线，会用V3加本轮选择重置数据，不用于日常编辑。V1–V3保留历史。
