xaiojie/papabot/hardware-selection/bom-v5/README.md

# 简洁采购清单 V5

更新：2026-09-08。以后采购Excel保持简洁，按渠道分文件，每份只含一个工作表。

| 文件 | 用途 | 内容 |
|---|---|---|
| [01-立创商城-BOM导入.xlsx](01-立创商城-BOM导入.xlsx) | 导入新版立创BOM | 10项，只有C编码、型号、数量3列 |
| [02-淘宝天猫-采购清单.xlsx](02-淘宝天猫-采购清单.xlsx) | 在淘宝/天猫按链接或既定商品购买 | 6项，含电池定制询价；7列 |
| [03-产品官网-采购清单.xlsx](03-产品官网-采购清单.xlsx) | 在DFRobot官网购买 | 5项；7列 |

**只将第01份导入立创，采购套数设1。** 三列分别映射为“原C编码、原型号、单套用量”。数量已是本次实际采购量，包含MOQ及备件，不再另加备损。无需上传后两份，也不要再用V4全量需求表一键下单。

## 立创10项的核实结果

本轮只读下载了用户当前V4云BOM的实际匹配结果，并核对对应立创商品页。下面10项的原C编码与匹配后商品编号全部相同、渠道全部为现货，数量满足起订量。两种MRO螺丝也已经在当前云BOM中正确匹配。

| 配件 | C编码 | 精确型号 | 本次购买数量 |
|---|---|---|---:|
| 开发板 | C20626143 | LCKFB-ESP32S3R8N8 | 1 |
| 喇叭 | C50387237 | 24MM-4Ω3W-2P1.25 | 1 |
| 总开关 | C5366606 | S1A | 1 |
| 7.5A保险丝 | C178942 | 029707.5WXNV | 5 |
| MINI保险座 | C206907 | 01530008Z | 1 |
| 1000µF电容 | C494548 | SHW1000UF10V8X12 | 5 |
| 470µF电容 | C51953430 | ERB16V470M8X12 | 10 |
| 20P排母 | C429947 | 22850120ANG1SYA01 | 5 |
| M2×6螺丝 | C357534 | PM2X6 | 100 |
| M3×8螺丝 | C357544 | PM3X8 | 100 |

当前账户导出报价中这10项合计 **¥111.37**（含开发板页面学生价），最终按下单结算。保险值、载板安装与螺丝长度延续样机选择，匹配成功不代表整机负载和结构已测试。

V4原始需求混入外采及内部物料代号，导致SEN0327被匹配成INMP441裸芯片，W07被当作同名海外商品，W10被匹配成整流桥；电池、充电板、好盈降压还被推荐为连接器。新版完全移除这些干扰行，只按已核C编号导入。DFR0954、DFR0753及FIT0030虽然也能找到订货或海外渠道，仍按已选的DFRobot国内官网采购，避免不必要的交期和MOQ。

核验依据保存在[evidence/lcsc-match-audit.json](evidence/lcsc-match-audit.json)。**新V5文件由用户自行导入，助手没有上传或修改当前云BOM，也没有下单。**

## 淘宝与官网

淘宝/天猫表：屏幕1块、MG90S定位舵机8个、PCA9685成品板1块、电池定制1包、MK021163充电板1块、好盈UBEC 3A(2-6S)1个。屏幕与舵机沿用用户已选购物车款，原商品链接未留存，表内没有编造链接。电池80元曾是预算，现已从采购单价中移除，报价栏留空并标为先询价。

DFRobot官网表：SEN0327麦克风1块、DFR0954功放1块、DFR0753舵机降压1块、FIT0030母母线3包（共30根）、FIT0585电源线1套（红黑各1米），网页参考共 **¥128**。本轮复核均显示有货。

好盈模块到货设为5V；舵机路保留1块DFR0753。FIT0030用于信号和小电流，FIT0585用于需自裁焊接的电源短线。接线与工程记录继续见[V4技术说明](../bom-v4/README.md)。

## 尚未放入下单文件的需求

以下保留在完整项目数据中，不混入可下单表：

- USB-A转C数据线、5V充电头：具体SKU未定，可复用已有合格配件。
- 采样/RC、去耦/OE小件、舵机端口排针：随原理图确定器件值和实际数量。
- 热缩管、洞洞板：小包装商品尚未定。
- 螺母/热熔嵌件、平垫片、隔离柱、软脚垫、魔术贴、泡棉、扎带：随结构、尺寸及包装确定。
- XT30配对件已要求随电池包提供，不额外买；PCB打样、打印、运费及返工为服务或预算项。

原42项记录全部保留在[bom-data.json](bom-data.json)，按10项立创、6项淘宝/天猫、5项官网、21项暂缓/服务/已包含项分配，没有丢项。本次交付是简洁的分渠道采购文件，不代表上述其余需求已全部选定。

三个Excel均已核验：单工作表、无合并标题、无公式、数量与超链接正确。重建脚本为[build-simple.py](build-simple.py)，依赖V4数据和本轮已保存的匹配核验；[validation.json](validation.json)记录检查结果。
