xaiojie/papabot/hardware-selection/bom-v6/README.md

# 简洁采购清单 V6

2026-09-08：原官网清单的五项均在淘宝/天猫找到并加购，刷新购物车已逐项核对数量、规格和价格。原购物车5项保留，现为10项；未下单或付款。

| 文件 | 用途 |
|---|---|
| [00-整机配件采购核对.xlsx](00-整机配件采购核对.xlsx) | 全部42条整机需求，单页8列；待补项排前，只用于核对，不导入立创 |
| [01-立创商城-BOM导入.xlsx](01-立创商城-BOM导入.xlsx) | 10项、3列、单页；与V5逐字节一致，只导入这份，采购套数设1 |
| [02-淘宝天猫-采购清单.xlsx](02-淘宝天猫-采购清单.xlsx) | 11项、7列、单页；保留原6项，再加入本轮5项 |

**原03官网清单五项已全部转入02，不再另买。** 为避免重复，本版不生成空的官网Excel；V5的03表仅作历史记录。11项淘宝采购需求不代表11项都在购物车：MG90S沿用已选8个180度款，本轮购物车未见；电池仍须确认定制规格。

| 本轮已加购 | 具体规格及数量 | 店铺 | 商品金额 |
|---|---|---|---:|
| [原款I²S麦克风](https://item.taobao.com/item.htm?id=610064842890) | SEN0327对应MSM261S4030H0成品模块，1块 | DFRobot官方品牌店 | ¥15.00 |
| [I²S功放](https://item.taobao.com/item.htm?id=866632847020&skuId=5886764007198) | MAX98357 焊接，1块 | 信诚新电子 | ¥5.19 |
| [原款舵机降压](https://item.taobao.com/item.htm?id=633486468011) | DFR0753，6–14V转5V/最大8A，1块 | DFRobot官方品牌店 | ¥55.00 |
| [母母信号线](https://detail.tmall.com/item.htm?id=608543275703&skuId=6167752202862) | 全铜、20cm、2.54mm、1排40根 | zave旗舰店 | ¥8.36 |
| [硅胶电源线](https://detail.tmall.com/item.htm?id=900626764964&skuId=5923525883949) | 红黑并线2×18AWG，1米，即每色各1米 | wxrkdz旗舰店 | ¥4.29 |

五项商品金额合计 **¥87.84**，相比原官网¥128少 **¥40.16**。商品页显示DFRobot运费¥6、功放运费¥2.40、两家线材免运费；同店合并运费和最终优惠以结算为准，本轮没有进入结算。商品价格、库存和预计发货时间是本次查看记录。

目前已选采购的已知商品金额为¥369.64：立创账户历史核对报价¥111.37，加淘宝已知价格¥258.27。未报价电池、待选辅料、制作服务及运费不包含在内。

## 整机核对总表

00总表合并两份采购Excel及未列入下单文件的21条需求，全部42条记录各出现一次。单页8列为状态、配件、规格、整机用量、采购量、渠道链接、已知金额、核对事项；筛选状态即可查看缺口。立创C编码保留在规格中，已有链接可直接打开。待定项目金额留空，没有将旧预算当作报价。两个下单文件保持不变。

目前9条已核对规格的淘宝配件已加购，10条已列立创BOM；这些状态不代表已下单/收货。购物车第10条为尚未确认符合定制要求的普通电池，列在“待确认定制”。8个MG90S上轮未见于购物车，列在“待加购”。

待补内容包括：定制电池、舵机；USB充电头/数据线（已有可复用）；热缩管、信号洞洞板和扎带小包装；电池采样、去耦/OE及舵机配电接口小件；螺母、嵌件、垫片、隔离柱、脚垫、束带与泡棉。载板/配电PCB和结构试样、整套打印另需设计与报价。XT30配对件按随电池供应确认，未重复计价；隔离柱/脚垫的外购与打印方案二选一。

整套打印包含所有计划壳体、腿、装饰及固定件；其21类计划组成和数量保存在该行规格单元格的备注中，未另算21笔采购。表末列出装配工具自备检查，不计作整机配件。详情数据见[review-data.json](review-data.json)，已通过[覆盖、数量和链接检查](review-validation.json)，可用[build-review.py](build-review.py)重建。

## 接线及替换说明

- 麦克风沿用原厂圆形Ø14mm模块，供电1.8–3.3V，本方案接3.3V；SCK/WS/SD为I²S，L/R低电平左声道、高电平右声道。厚度、排针和声孔位置仍需实测。
- 功放从DFR0954换成标准MAX98357A已焊成品板，照片标注2.5–5.5V、4–8Ω，本方案接逻辑5V及既定4Ω3W喇叭。喇叭1.25mm插头不能直插螺丝端子，需改焊导线并绝缘；BTL两端均不能接地。新板尺寸、孔距及端子空间待测，CAD未更新。
- DFR0753仍只有1块，用于舵机；官网淘宝参数6–14V输入、5V±1%输出、最大8A。整机5V/6A目标、低2S电压下表现及温升尚未实测。与好盈逻辑UBEC共地，两路5V输出不并联。
- 全铜母母线1排40根替代FIT0030的3包30根，多10根备用。仅作信号及小电流线，不承载舵机或电池总电流。
- 硅胶线替代FIT0585，详情图每芯镀锡铜0.75mm²、150股0.08mm、外径约2.3mm。双芯各1米，需自裁焊接；线长、压降、成束温升仍需验证。并线宽度及弯曲空间按实物布局。

购物车原有¥14.70电池是普通商品规格，目前没有证明满足持续≥10A、每节保护与均衡及XT30配对件的定制要求；未修改该行，Excel电池报价继续留空。其他电源架构、关机充电及电路依赖见[V4工程说明](../bom-v4/README.md)。

42项工程记录全部保留：10项立创、11项淘宝、0项其他官网、21项待定/服务/已含件。仍非全机生产BOM，未改Blender或执行实物测试。

依据：[购物车与选型核验](evidence/taobao-cart-audit.json)、[立创匹配核验](evidence/lcsc-match-audit.json)、[Excel检查结果](validation.json)。[build-simple.py](build-simple.py)可从V5重建本版，旧版文件不覆盖。
