xaiojie/papabot/pcb-design/native-rev-a/supplier-review-2026-09-09/sources/引脚说明.docx

序号 | 引脚标号 | 说明
1 | GND | 液晶屏电源地
2 | VCC | 液晶屏电源正(3.3V)
3 | SCL | 液晶屏SPI总线时钟信号
4 | SDA | 液晶屏SPI总线写数据信号
5 | RES | 液晶屏复位控制信号（低电平复位）
6 | DC | 液晶屏寄存器/数据选择控制信号（低电平：寄存器，高电平：数据）
7 | CS | 液晶屏片选控制信号（低电平使能）
8 | BLK | 液晶屏背光控制信号（高电平点亮，如不需要控制，请接3.3V）
9 | A | 编码器A相
10 | B | 编码器A相
11 | PUSH | 编码器按键
12 | K0 | 按键K0引脚
