xaiojie/papabot/pcb-design/native-rev-a/supplier-review-2026-09-09/sources/EC11资料/360度 旋转编码器模块/STC12参考例程.docx

#include<reg52.h>
//STC12C5A60S2
//旋转编码器一只引脚接中断1引脚，一只引脚接普通io口
//中断1引脚是P3^3
sbit PIN1=P3^4;

void inte_start (void)
{
EA=1; //开启总中断
EX1=1; //开启外部中断1触发开关
IT1=1; //外部中断1为下降沿触发
}

void encoder_inte (void) interrupt 2 //中断入口，无需调用
{
if(PIN1==0)
{
//假设编码器正转，这里做你想要做的事
}

else if (PIN1==1)
{
//假设编码器反转，这里做你想要做的事
}
}


int main (void)
{
inte_start ();//中断初始化，只需运行一次
while(1)
{

}

}
