xaiojie/papabot/pcb-design/native-rev-a/supplier-review-2026-09-09/sources/EC11资料/360度 旋转编码器模块/原理图.docx

半轴短柄无螺纹模块原理图：

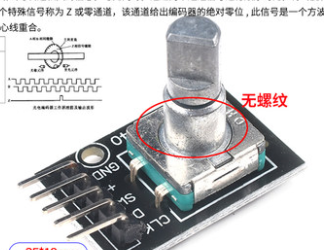
[picture p148: figure]

半轴长柄带螺纹模块原理图：

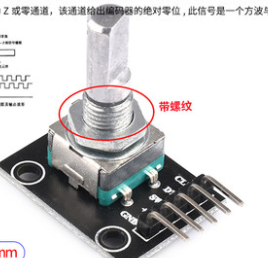
[picture p149: figure]

梅花短柄模块原理图：

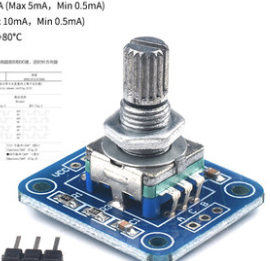
[picture p150: figure]

圆板带帽模块原理图：

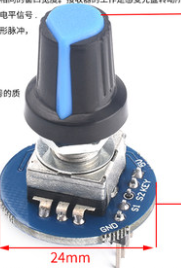
[picture p151: figure]
