xaiojie/papabot/mechanical-design/structure-a4/renders/A4-parts.png

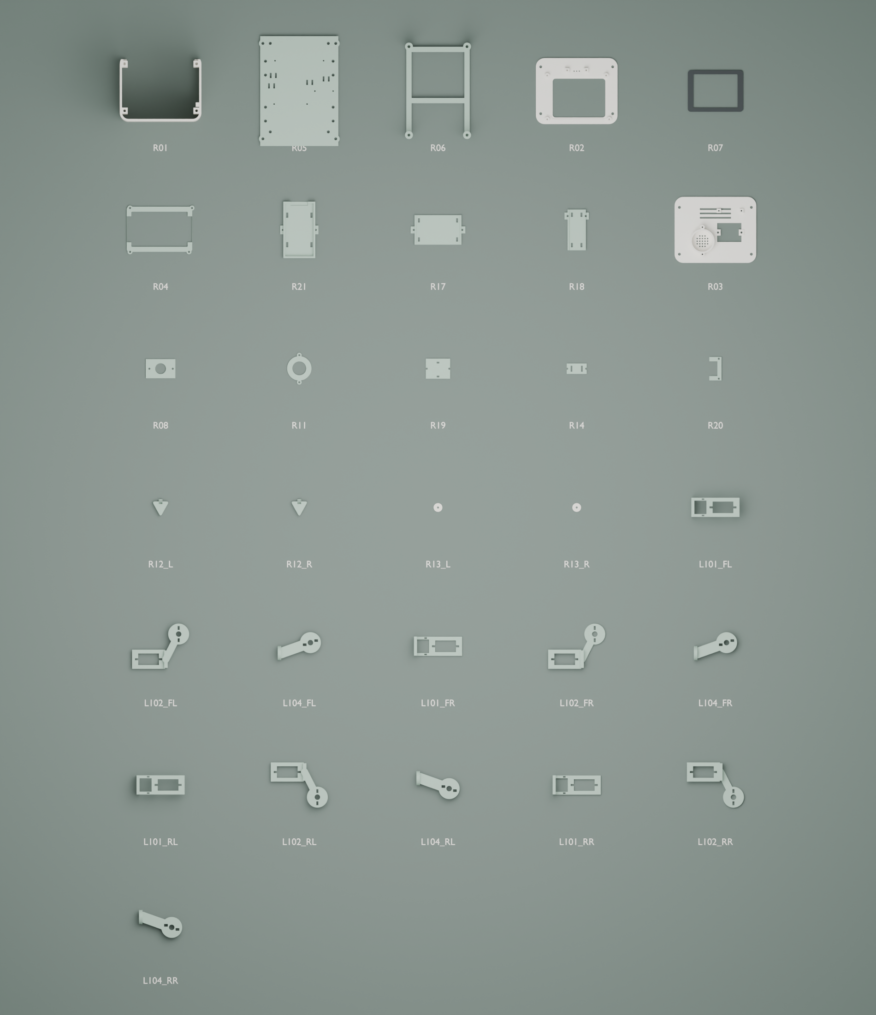
mechanical-design/structure-a4/renders/A4-parts.png
