xaiojie/papabot/pcb-design/native-rev-b/supplier-evidence/屏幕整板原理图.png

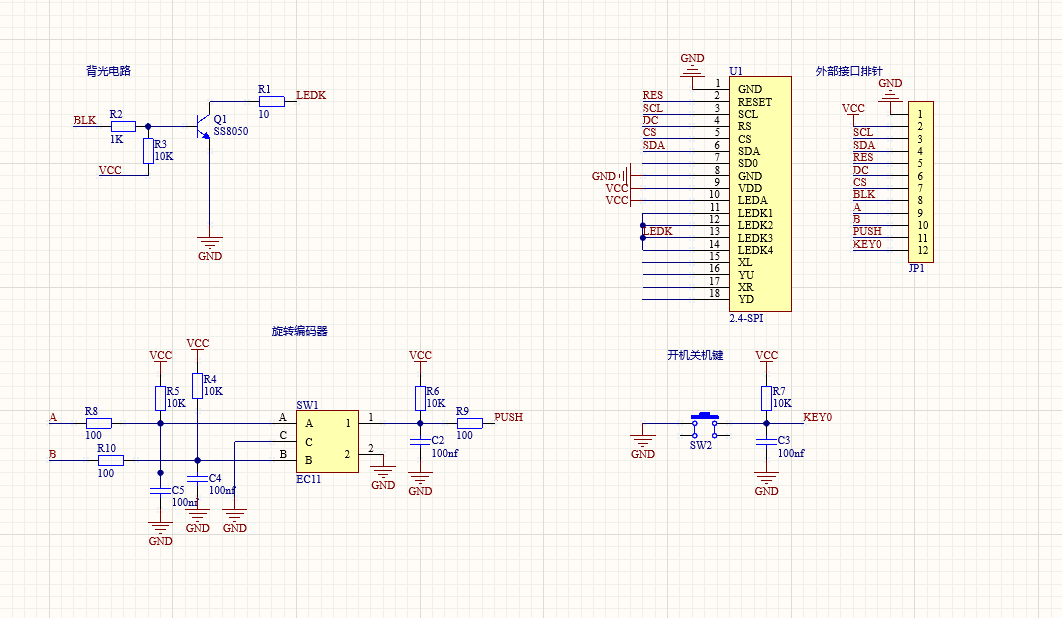
pcb-design/native-rev-b/supplier-evidence/屏幕整板原理图.png
