xaiojie/papabot/mechanical-design/print-v2/stl-structure-a1-DRAFT/R01__main_housing__DRAFT_mm.stl

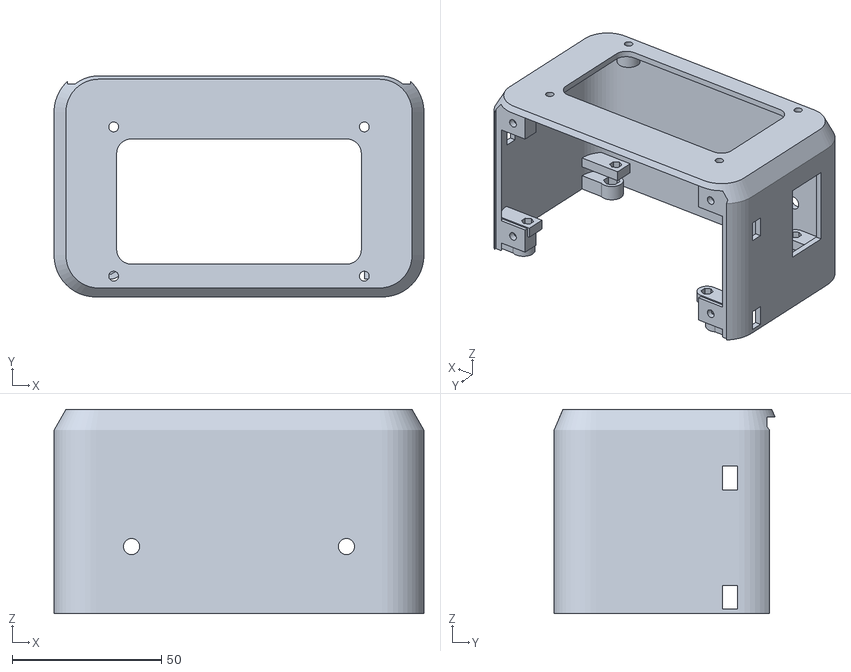
[picture p154: CAD file, 2026-10-26]
mechanical-design/print-v2/stl-structure-a1-DRAFT/R01__main_housing__DRAFT_mm.stl
124.0 x 74.1 x 68.5
