xaiojie/papabot/mechanical-design/battery-ace800-a3/stl/R21__ACE800__mm.stl

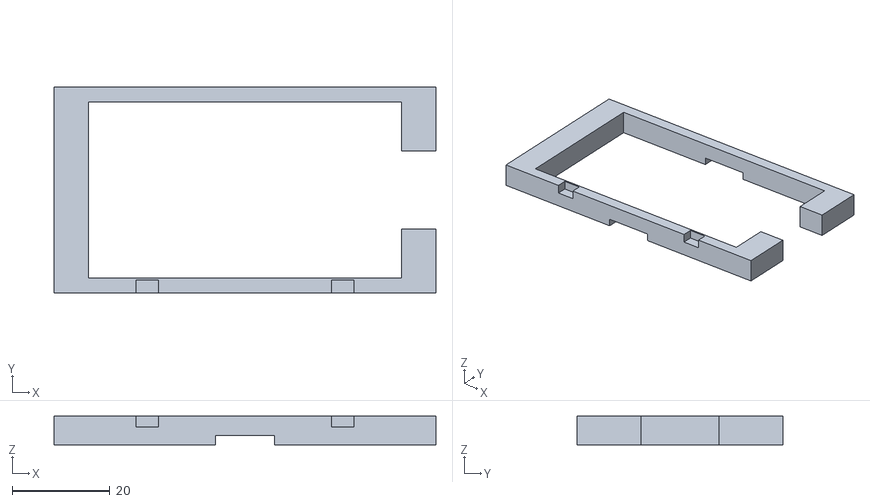
[picture p155: CAD file, 2026-10-26]
mechanical-design/battery-ace800-a3/stl/R21__ACE800__mm.stl
78.0 x 42.0 x 5.90
