xaiojie/papabot/mechanical-design/print-v2/stl/T04C__MG90S_body_opening_gauge__mm.stl

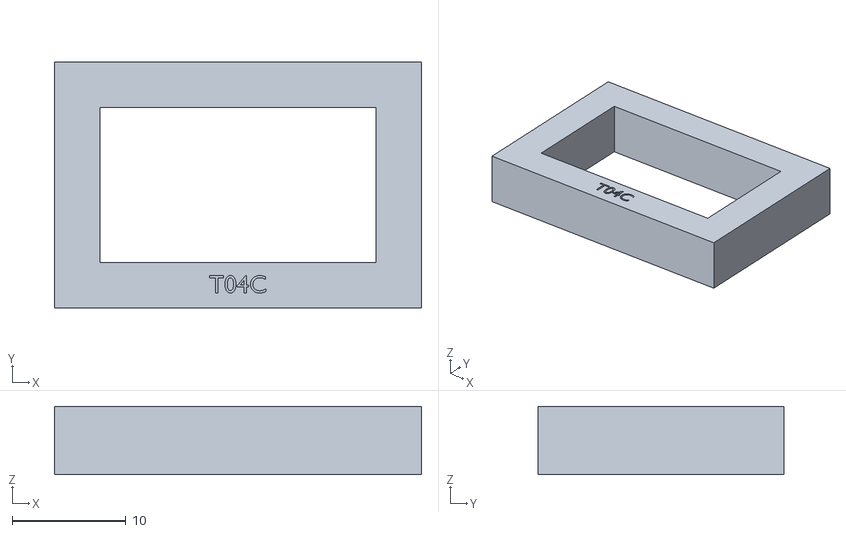
[picture p156: CAD file, 2026-10-26]
mechanical-design/print-v2/stl/T04C__MG90S_body_opening_gauge__mm.stl
32.2 x 21.6 x 6.00
