xaiojie/papabot/mechanical-design/structure-a2/stl-complete/R06__A2__mm.stl

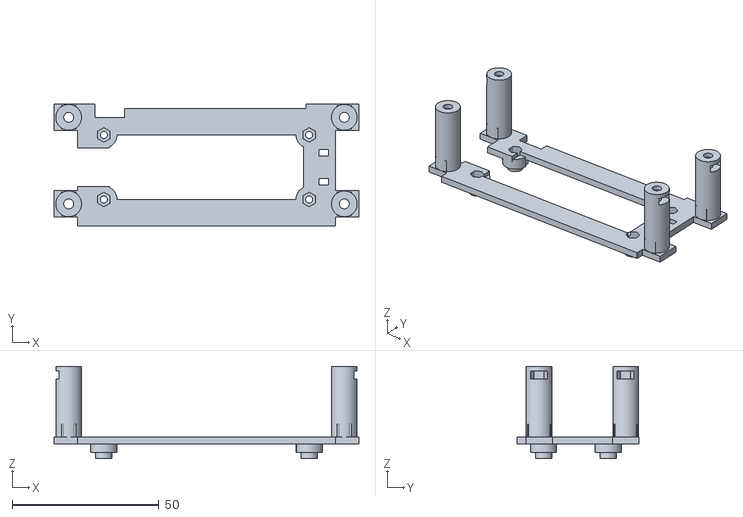
[picture p157: CAD file, 2026-10-26]
mechanical-design/structure-a2/stl-complete/R06__A2__mm.stl
104.0 x 41.5 x 31.4
