xaiojie/papabot/mechanical-design/structure-a3/delivery/DesktopAssistant-A3/stl-complete/R18__A3__mm.stl

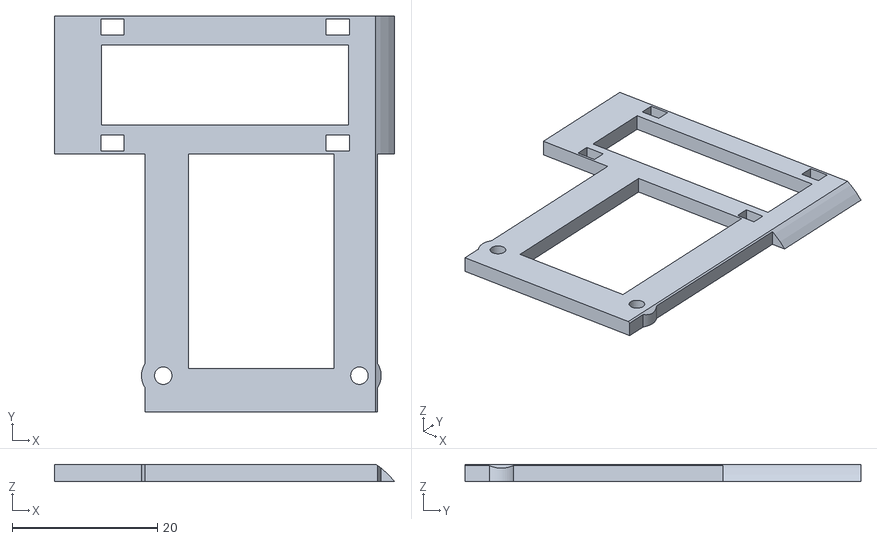
[picture p158: CAD file, 2026-10-26]
mechanical-design/structure-a3/delivery/DesktopAssistant-A3/stl-complete/R18__A3__mm.stl
46.9 x 54.5 x 2.40
