xaiojie/papabot/mechanical-design/structure-a3/stl-complete/L104_FL__A3__mm.stl

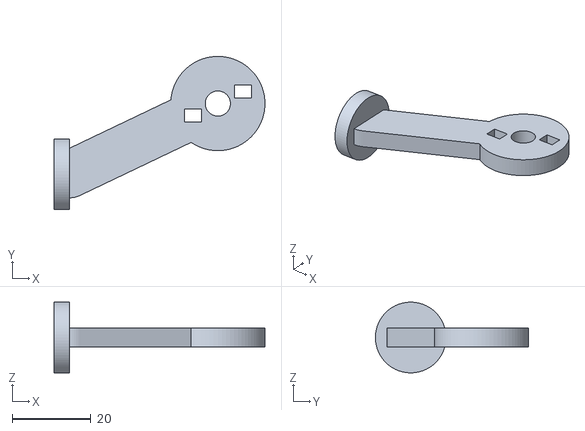
[picture p159: CAD file, 2026-10-26]
mechanical-design/structure-a3/stl-complete/L104_FL__A3__mm.stl
53.7 x 39.0 x 18.0
