xaiojie/papabot/mechanical-design/structure-a4/coupons/T01__A4__mm.stl

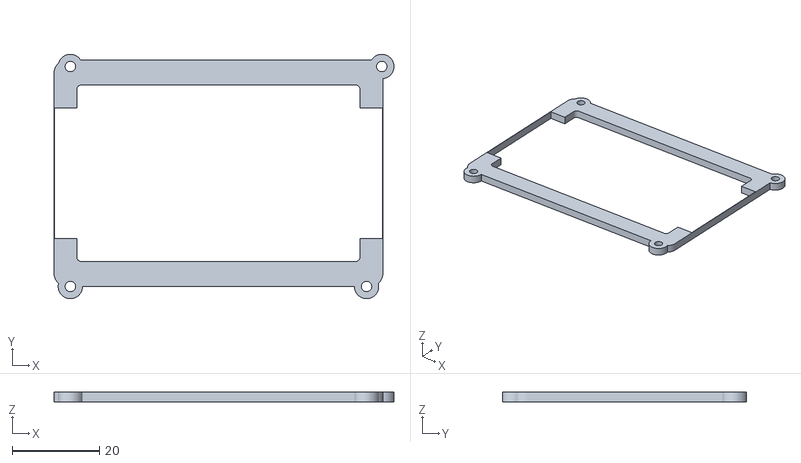
[picture p160: CAD file, 2026-10-26]
mechanical-design/structure-a4/coupons/T01__A4__mm.stl
78.1 x 56.1 x 2.20
