xaiojie/papabot/mechanical-design/structure-a5/coupons/T02__A5__mm.stl

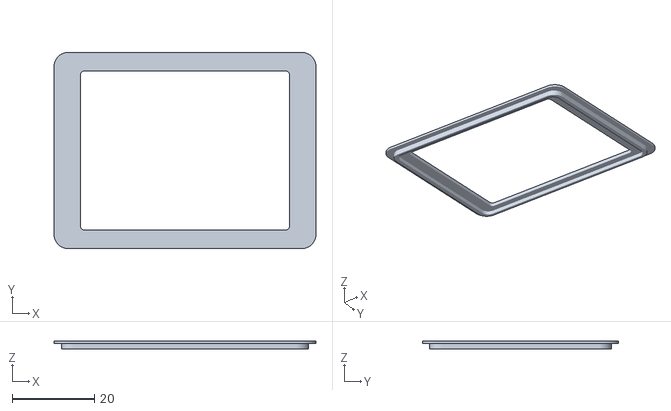
[picture p161: CAD file, 2026-10-26]
mechanical-design/structure-a5/coupons/T02__A5__mm.stl
63.8 x 47.8 x 2.00
