xaiojie/papabot/mechanical-design/structure-a5/stl-complete/L102_FR__A5__mm.stl

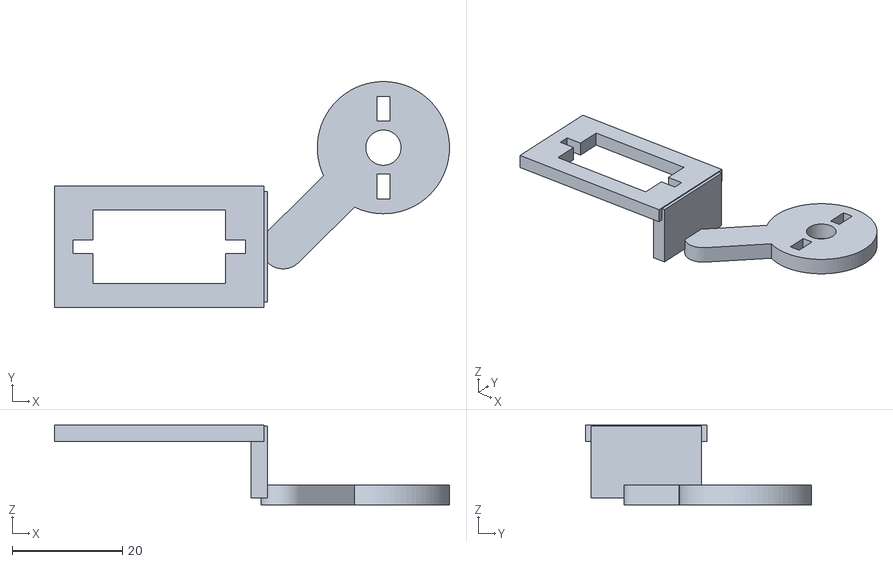
[picture p162: CAD file, 2026-10-26]
mechanical-design/structure-a5/stl-complete/L102_FR__A5__mm.stl
71.7 x 41.0 x 14.5
