xaiojie/papabot/mechanical-design/battery-ace800-a3/stl/R22__ACE800__mm.stl

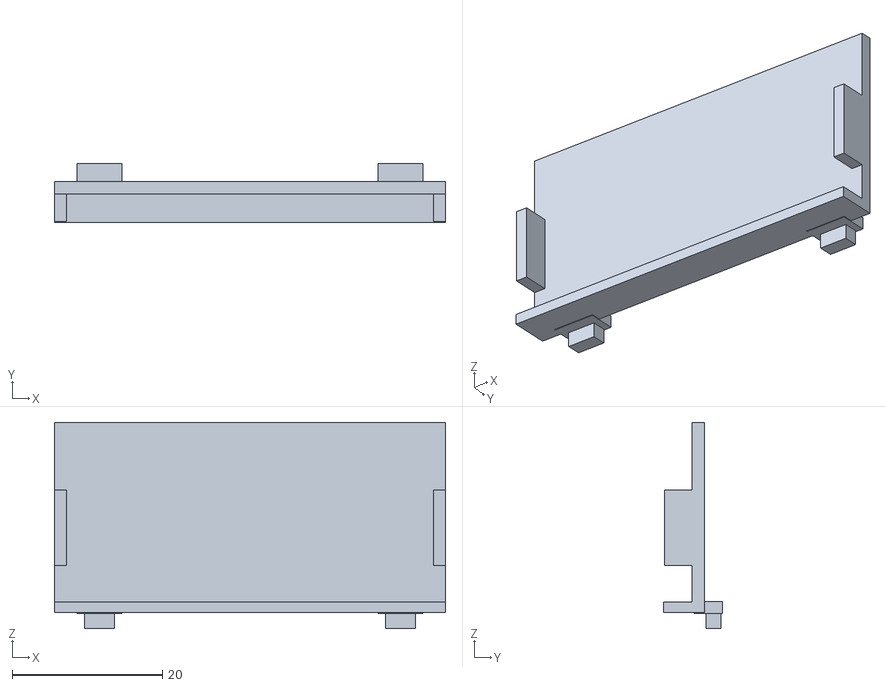
[picture p163: CAD file, 2026-10-26]
mechanical-design/battery-ace800-a3/stl/R22__ACE800__mm.stl
52.0 x 7.80 x 27.4
