xaiojie/papabot/mechanical-design/print-v2/stl-structure-a1-DRAFT/R05__bottom_cover_integrated_battery_tray__DRAFT_mm.stl

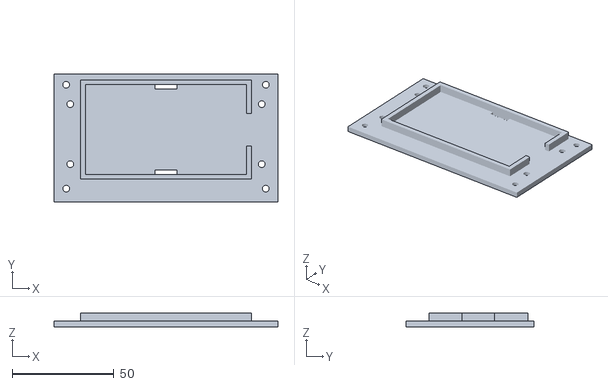
[picture p164: CAD file, 2026-10-26]
mechanical-design/print-v2/stl-structure-a1-DRAFT/R05__bottom_cover_integrated_battery_tray__DRAFT_mm.stl
110.0 x 62.7 x 6.80
