xaiojie/papabot/mechanical-design/structure-a3/stl-complete/L102_RR__A3__mm.stl

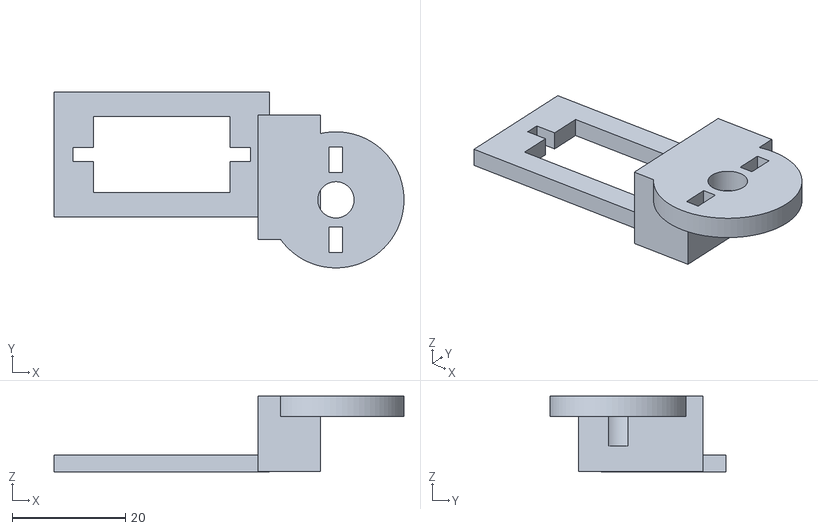
[picture p165: CAD file, 2026-10-26]
mechanical-design/structure-a3/stl-complete/L102_RR__A3__mm.stl
61.7 x 31.0 x 13.4
