xaiojie/papabot/mechanical-design/structure-a4/stl-complete/R14__A4__mm.stl

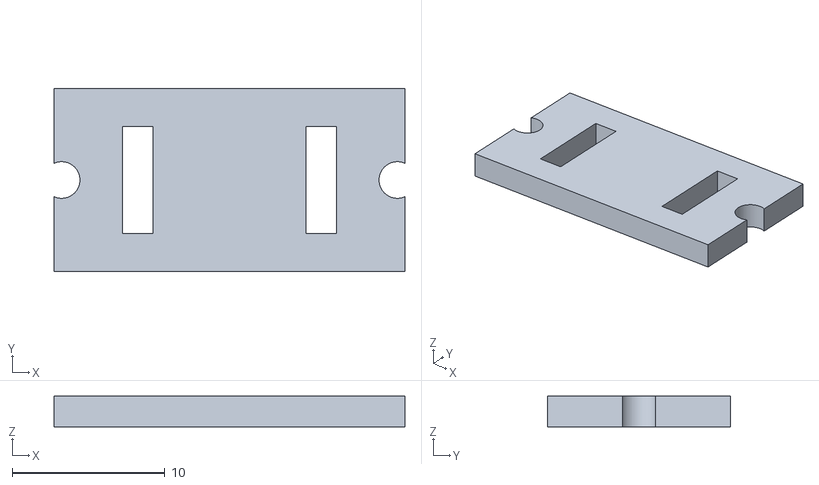
[picture p166: CAD file, 2026-10-26]
mechanical-design/structure-a4/stl-complete/R14__A4__mm.stl
23.0 x 12.0 x 2.00
