xaiojie/papabot/mechanical-design/structure-a5/coupons/T04__A5__mm.stl

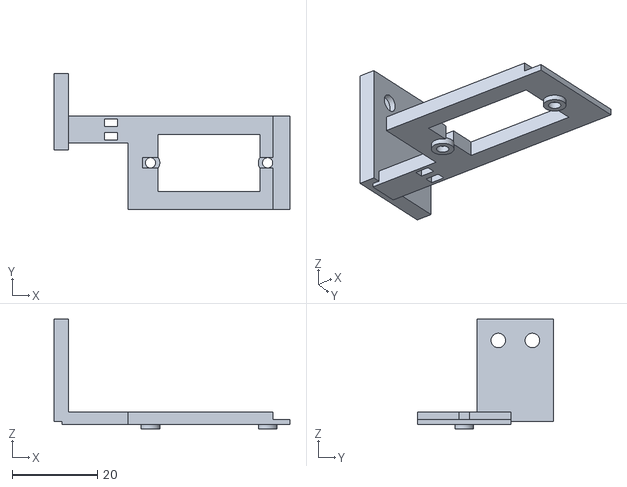
[picture p167: CAD file, 2026-10-26]
mechanical-design/structure-a5/coupons/T04__A5__mm.stl
55.4 x 32.0 x 25.8
