xaiojie/papabot/mechanical-design/structure-a5/stl-complete/R05__A5__mm.stl

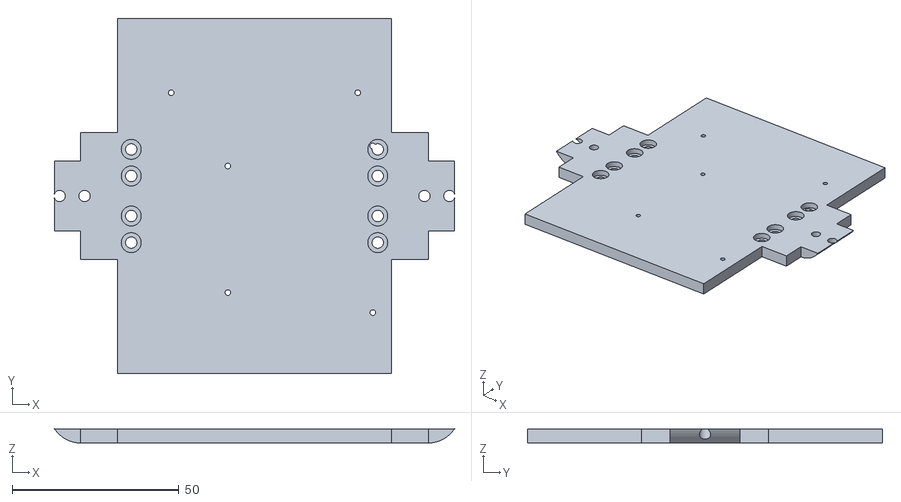
[picture p168: CAD file, 2026-10-26]
mechanical-design/structure-a5/stl-complete/R05__A5__mm.stl
120.1 x 106.6 x 4.30
