xaiojie/papabot/mechanical-design/print-v2/stl-structure-a1-DRAFT/R04__display_support_frame__DRAFT_mm.stl

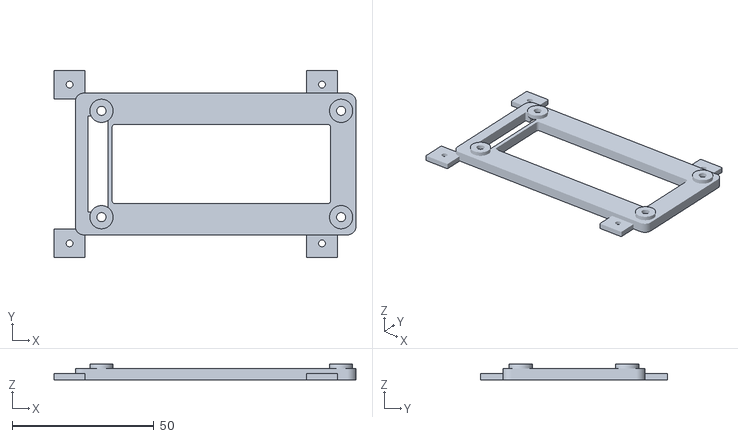
[picture p169: CAD file, 2026-10-26]
mechanical-design/print-v2/stl-structure-a1-DRAFT/R04__display_support_frame__DRAFT_mm.stl
106.5 x 66.0 x 5.60
