xaiojie/papabot/mechanical-design/structure-a2/stl-complete/R13_L__A2__mm.stl

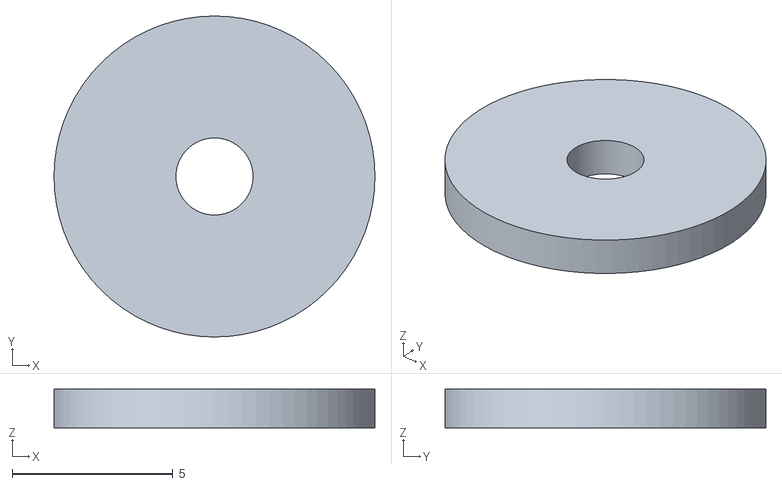
[picture p170: CAD file, 2026-10-26]
mechanical-design/structure-a2/stl-complete/R13_L__A2__mm.stl
10.0 x 10.0 x 1.20
