xaiojie/papabot/mechanical-design/structure-a3/delivery/DesktopAssistant-A3/stl-complete/L101_RL__A3__mm.stl

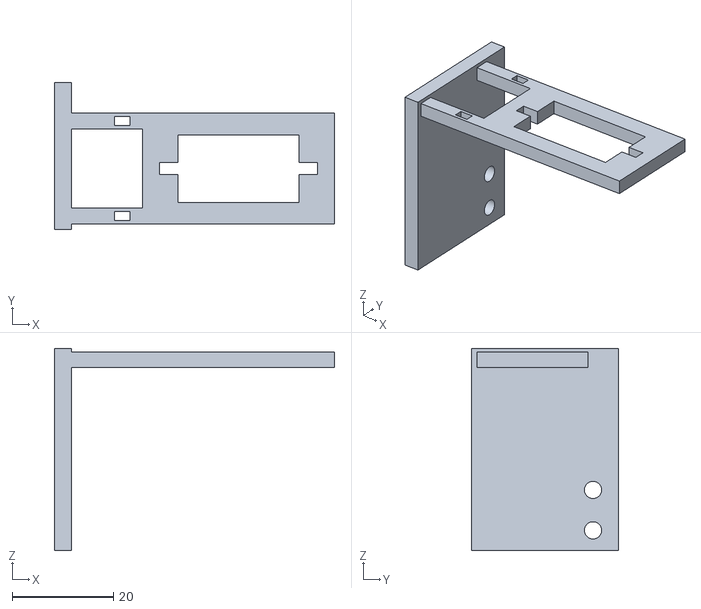
[picture p171: CAD file, 2026-10-26]
mechanical-design/structure-a3/delivery/DesktopAssistant-A3/stl-complete/L101_RL__A3__mm.stl
55.4 x 29.0 x 40.0
