xaiojie/papabot/mechanical-design/structure-a3/stl-complete/L101_FL__A3__mm.stl

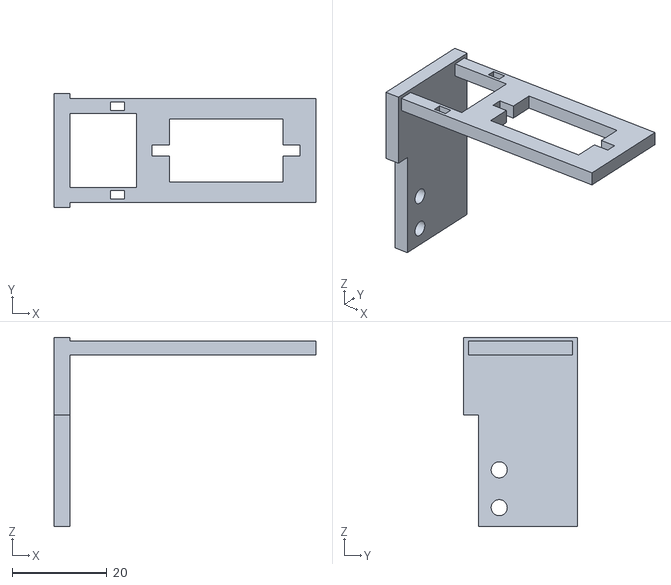
[picture p172: CAD file, 2026-10-26]
mechanical-design/structure-a3/stl-complete/L101_FL__A3__mm.stl
55.4 x 24.0 x 40.0
