xaiojie/papabot/mechanical-design/structure-a4/coupons/T05__A4__mm.stl

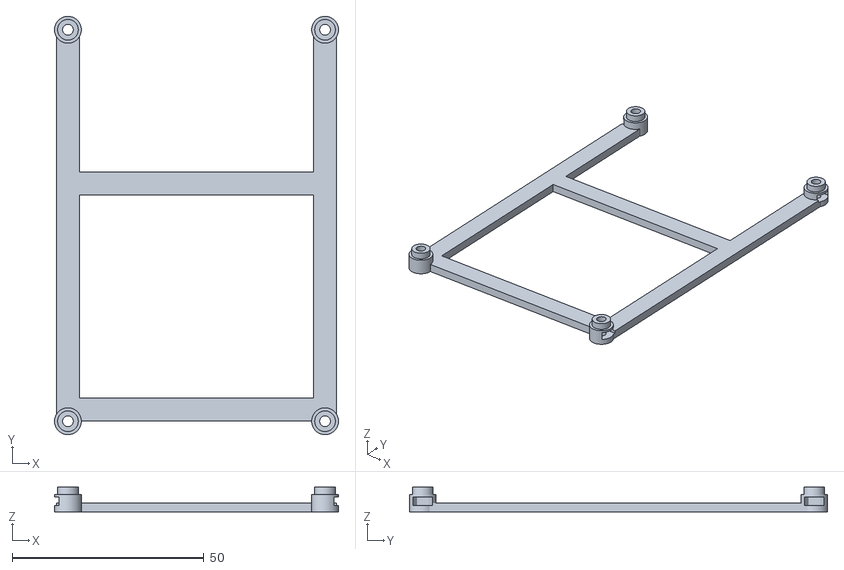
[picture p173: CAD file, 2026-10-26]
mechanical-design/structure-a4/coupons/T05__A4__mm.stl
74.0 x 109.0 x 6.50
