xaiojie/papabot/mechanical-design/structure-a5/stl-complete/L104_FL__A5__mm.stl

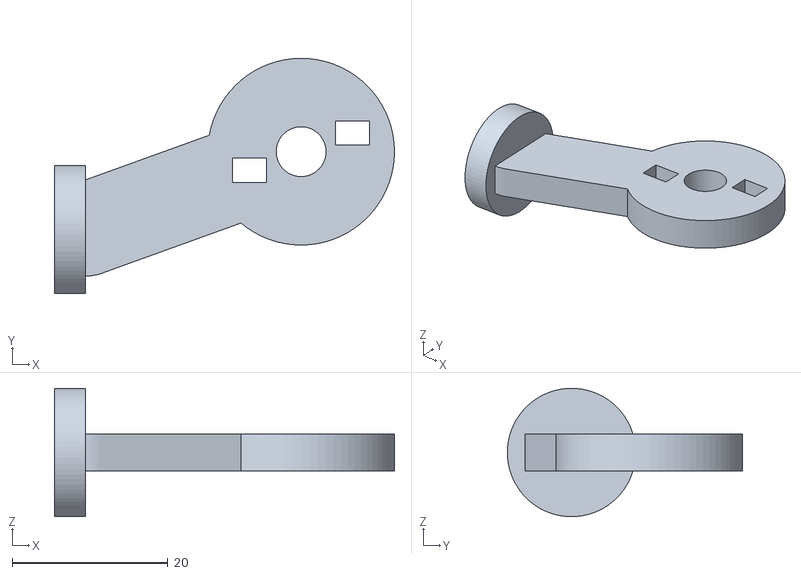
[picture p174: CAD file, 2026-10-26]
mechanical-design/structure-a5/stl-complete/L104_FL__A5__mm.stl
43.7 x 30.2 x 16.5
