xaiojie/papabot/mechanical-design/print-v2/stl-structure-a1-DRAFT/R02__shallow_front_cover__DRAFT_mm.stl

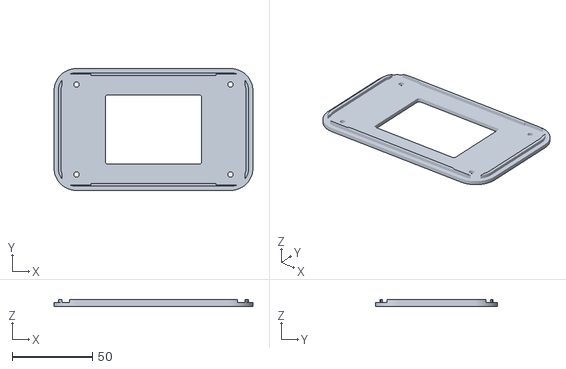
[picture p175: CAD file, 2026-10-26]
mechanical-design/print-v2/stl-structure-a1-DRAFT/R02__shallow_front_cover__DRAFT_mm.stl
124.0 x 76.0 x 4.40
