xaiojie/papabot/mechanical-design/print-v2/stl/T04A__MG90S_body_opening_gauge__mm.stl

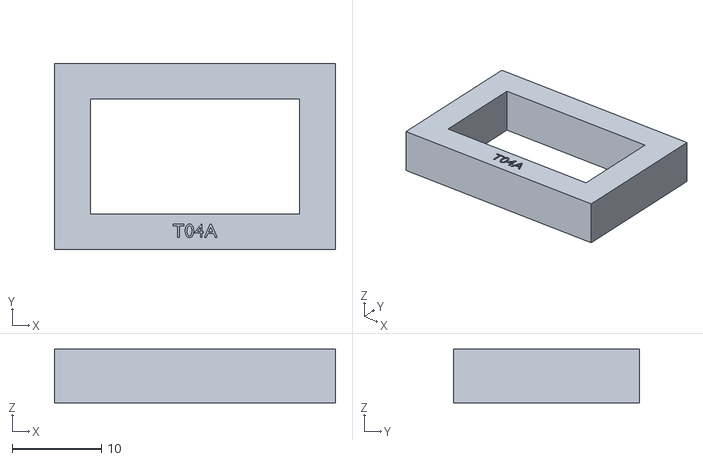
[picture p176: CAD file, 2026-10-26]
mechanical-design/print-v2/stl/T04A__MG90S_body_opening_gauge__mm.stl
31.4 x 20.8 x 6.00
