xaiojie/papabot/mechanical-design/structure-a2/stl-complete/R12_R__A2__mm.stl

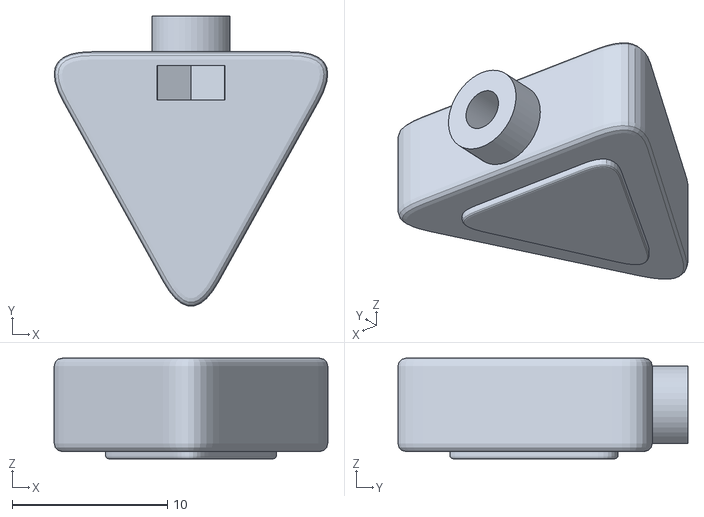
[picture p177: CAD file, 2026-10-26]
mechanical-design/structure-a2/stl-complete/R12_R__A2__mm.stl
17.6 x 18.7 x 6.47
