xaiojie/papabot/mechanical-design/structure-a4/coupons/T03__A4__mm.stl

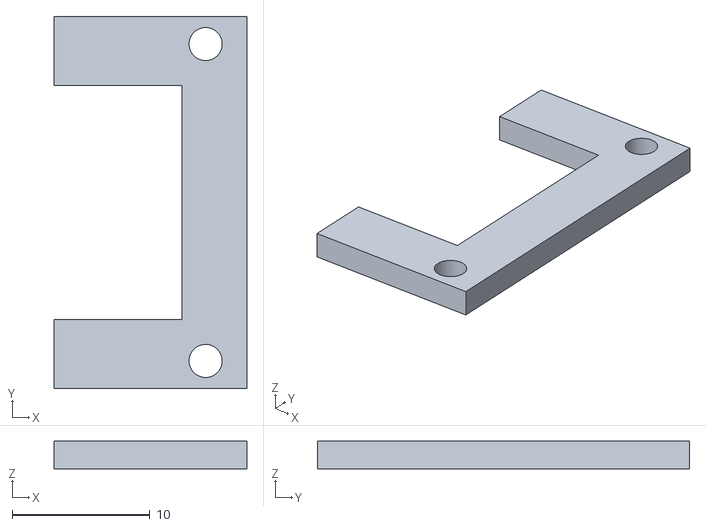
[picture p178: CAD file, 2026-10-26]
mechanical-design/structure-a4/coupons/T03__A4__mm.stl
14.0 x 27.0 x 2.00
