xaiojie/papabot/mechanical-design/structure-a4/stl-complete/R11__A4__mm.stl

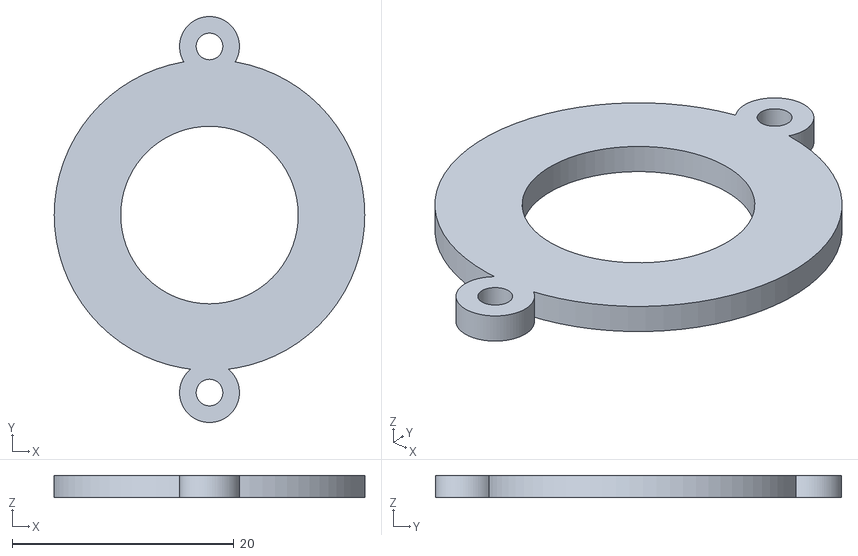
[picture p179: CAD file, 2026-10-26]
mechanical-design/structure-a4/stl-complete/R11__A4__mm.stl
28.0 x 36.6 x 2.00
