xaiojie/papabot/mechanical-design/structure-a5/coupons/T03__A5__mm.stl

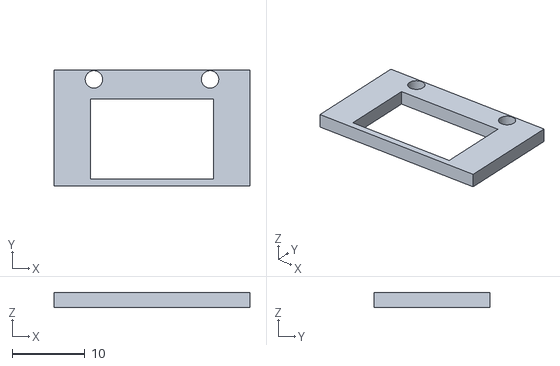
[picture p180: CAD file, 2026-10-26]
mechanical-design/structure-a5/coupons/T03__A5__mm.stl
27.0 x 16.0 x 2.00
