xaiojie/papabot/mechanical-design/print-v2/stl-structure-a1-DRAFT/R03__rear_controls_panel_BLANK__DRAFT_mm.stl

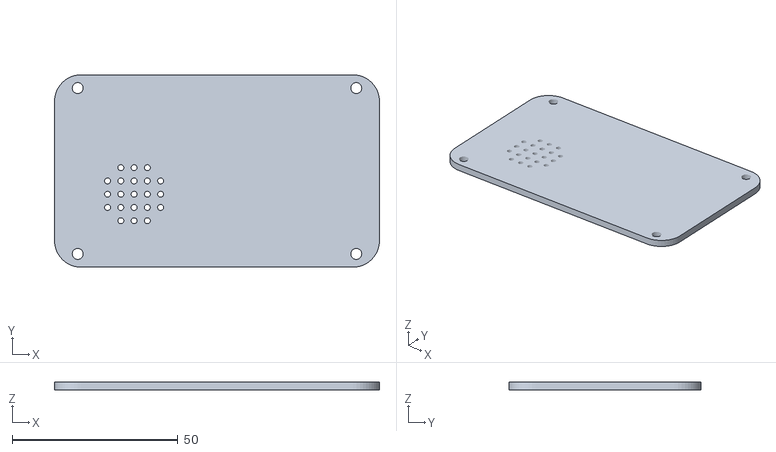
[picture p181: CAD file, 2026-10-26]
mechanical-design/print-v2/stl-structure-a1-DRAFT/R03__rear_controls_panel_BLANK__DRAFT_mm.stl
98.0 x 58.0 x 2.40
