xaiojie/papabot/mechanical-design/print-v2/stl/T04B__MG90S_body_opening_gauge__mm.stl

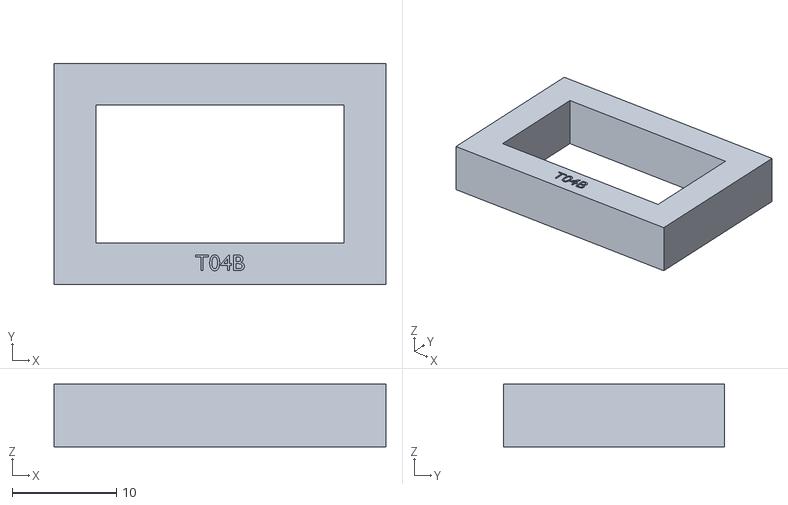
[picture p182: CAD file, 2026-10-26]
mechanical-design/print-v2/stl/T04B__MG90S_body_opening_gauge__mm.stl
31.8 x 21.2 x 6.00
