xaiojie/papabot/mechanical-design/structure-a2/stl-complete/R11__A2__mm.stl

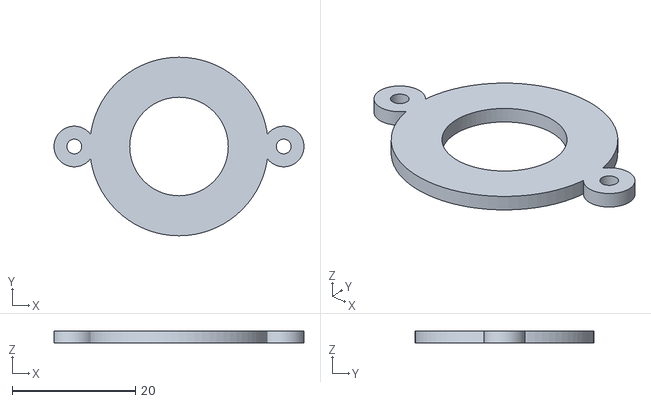
[picture p183: CAD file, 2026-10-26]
mechanical-design/structure-a2/stl-complete/R11__A2__mm.stl
40.6 x 29.0 x 2.00
