xaiojie/papabot/mechanical-design/structure-a3/stl-complete/R01__A3__mm.stl

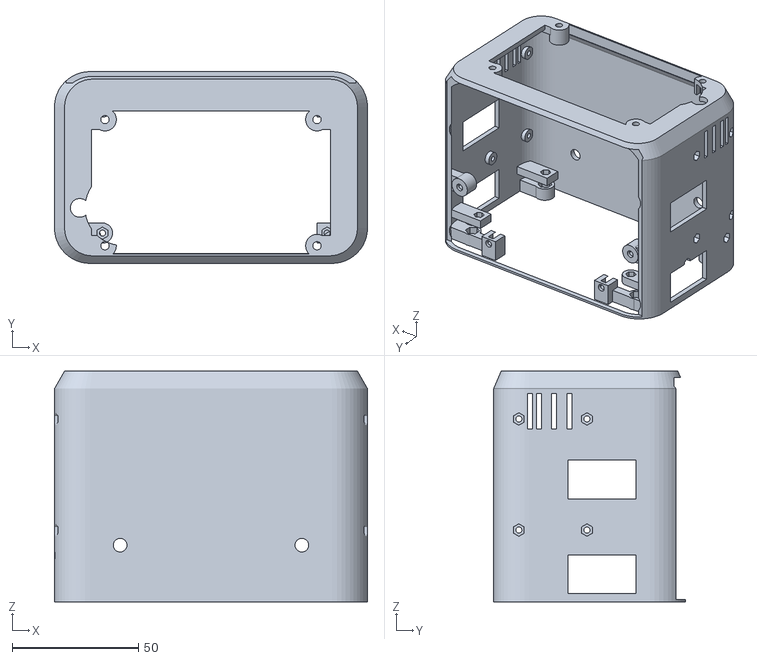
[picture p184: CAD file, 2026-10-26]
mechanical-design/structure-a3/stl-complete/R01__A3__mm.stl
124.0 x 76.0 x 91.5
