xaiojie/papabot/mechanical-design/structure-a4/coupons/T04__A4__mm.stl

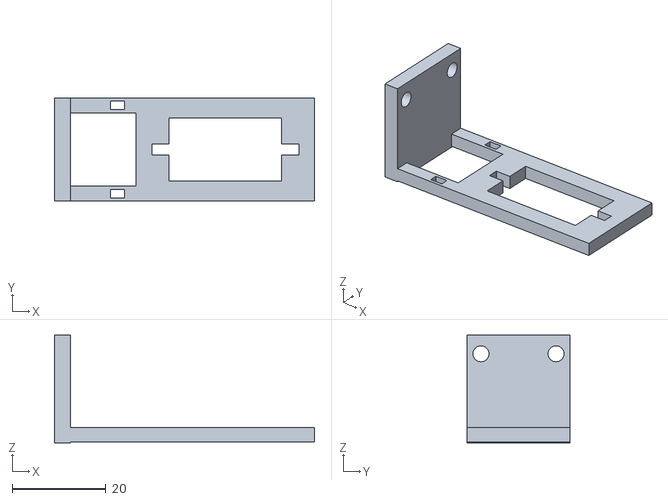
[picture p185: CAD file, 2026-10-26]
mechanical-design/structure-a4/coupons/T04__A4__mm.stl
55.4 x 22.0 x 23.0
