xaiojie/papabot/mechanical-design/structure-a4/stl-complete/R19__A4__mm.stl

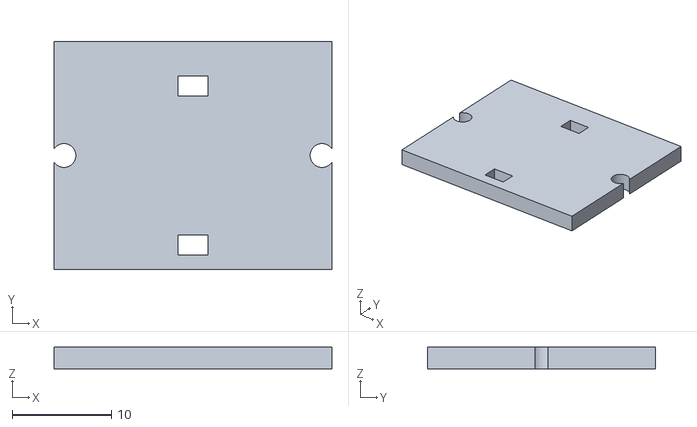
[picture p186: CAD file, 2026-10-26]
mechanical-design/structure-a4/stl-complete/R19__A4__mm.stl
28.0 x 23.0 x 2.20
