xaiojie/papabot/mechanical-design/structure-a5/coupons/T05__A5__mm.stl

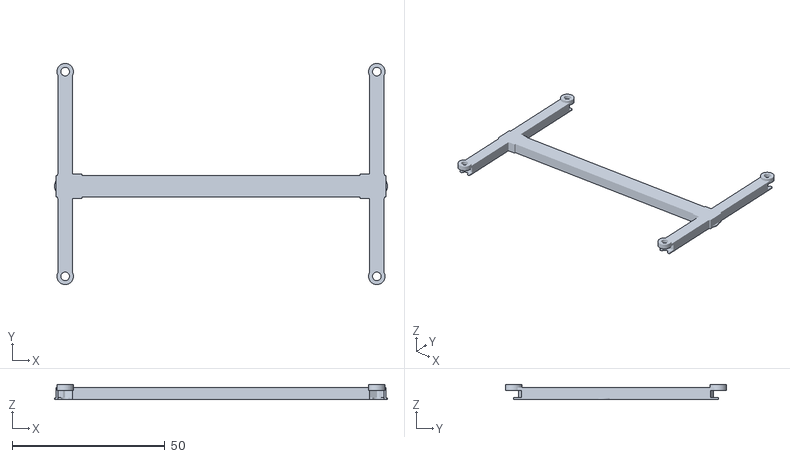
[picture p187: CAD file, 2026-10-26]
mechanical-design/structure-a5/coupons/T05__A5__mm.stl
109.0 x 72.4 x 5.00
