xaiojie/papabot/mechanical-design/structure-a5/stl-complete/R02__A5__mm.stl

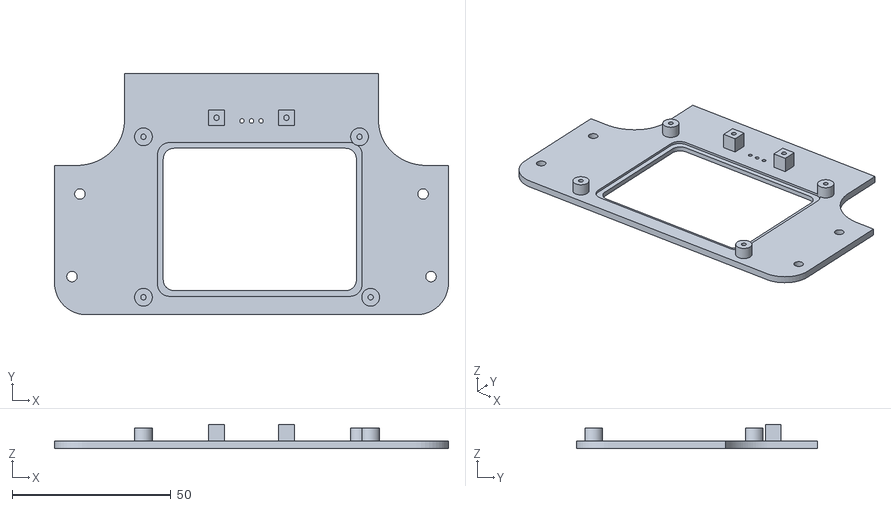
[picture p188: CAD file, 2026-10-26]
mechanical-design/structure-a5/stl-complete/R02__A5__mm.stl
124.0 x 76.0 x 7.70
