xaiojie/papabot/mechanical-design/print-v2/stl-structure-a1-DRAFT/R06__controller_carrier_bridge__DRAFT_mm.stl

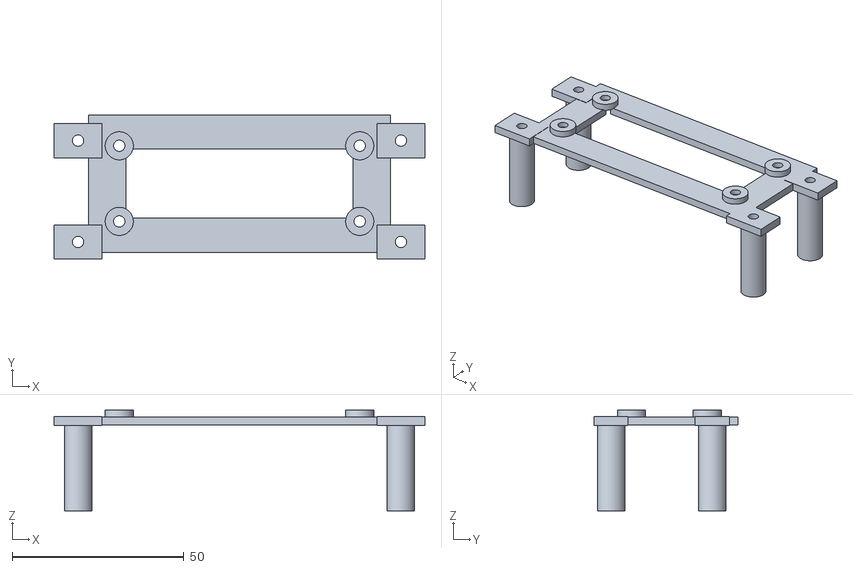
[picture p189: CAD file, 2026-10-26]
mechanical-design/print-v2/stl-structure-a1-DRAFT/R06__controller_carrier_bridge__DRAFT_mm.stl
108.0 x 42.0 x 29.4
