xaiojie/papabot/mechanical-design/print-v2/stl/T01__display_hole_pitch_frame__mm.stl

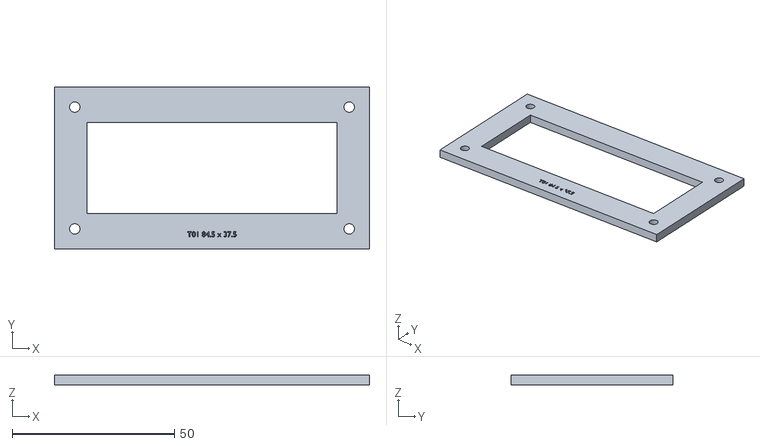
[picture p190: CAD file, 2026-10-26]
mechanical-design/print-v2/stl/T01__display_hole_pitch_frame__mm.stl
97.0 x 50.0 x 3.00
