xaiojie/papabot/mechanical-design/structure-a3/delivery/DesktopAssistant-A3/stl-complete/R03__A3__mm.stl

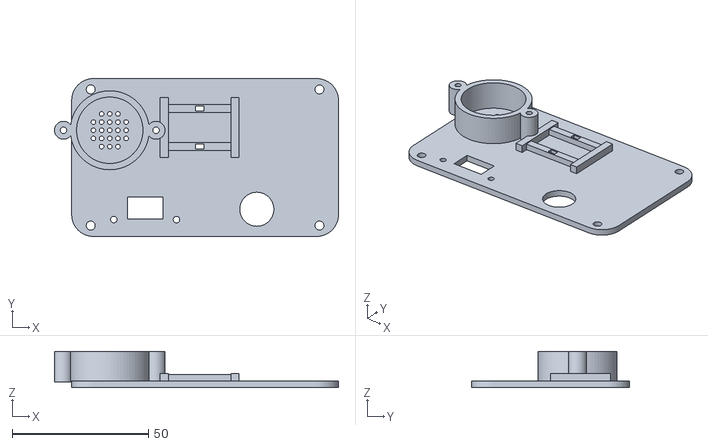
[picture p191: CAD file, 2026-10-26]
mechanical-design/structure-a3/delivery/DesktopAssistant-A3/stl-complete/R03__A3__mm.stl
104.3 x 58.0 x 13.4
