xaiojie/papabot/mechanical-design/structure-a3/stl-complete/R10_2__A3__mm.stl

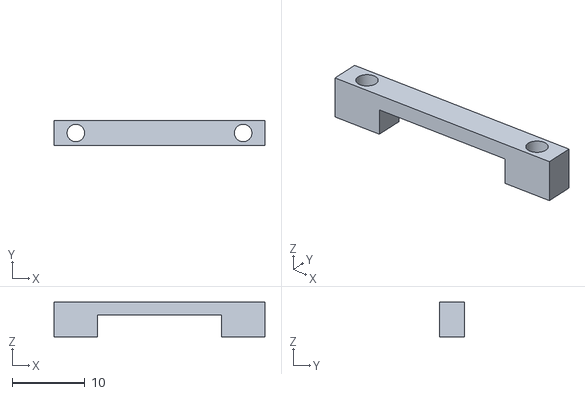
[picture p192: CAD file, 2026-10-26]
mechanical-design/structure-a3/stl-complete/R10_2__A3__mm.stl
29.0 x 3.40 x 4.80
