xaiojie/papabot/mechanical-design/structure-a5/stl-complete/R03__A5__mm.stl

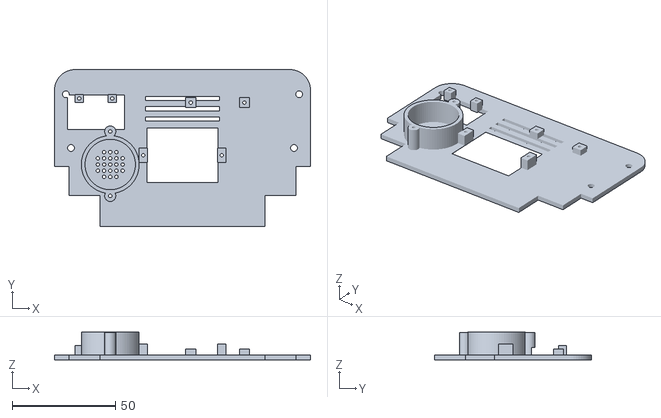
[picture p193: CAD file, 2026-10-26]
mechanical-design/structure-a5/stl-complete/R03__A5__mm.stl
124.0 x 76.0 x 13.5
