xaiojie/papabot/mechanical-design/structure-a2/stl-complete/R14__A2__mm.stl

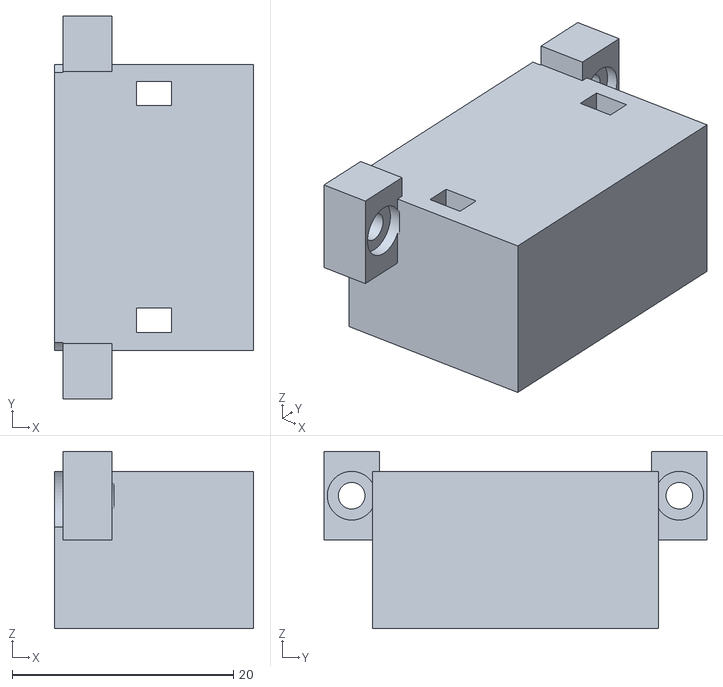
[picture p194: CAD file, 2026-10-26]
mechanical-design/structure-a2/stl-complete/R14__A2__mm.stl
18.0 x 34.6 x 16.0
