xaiojie/papabot/mechanical-design/structure-a4/stl-complete/R03__A4__mm.stl

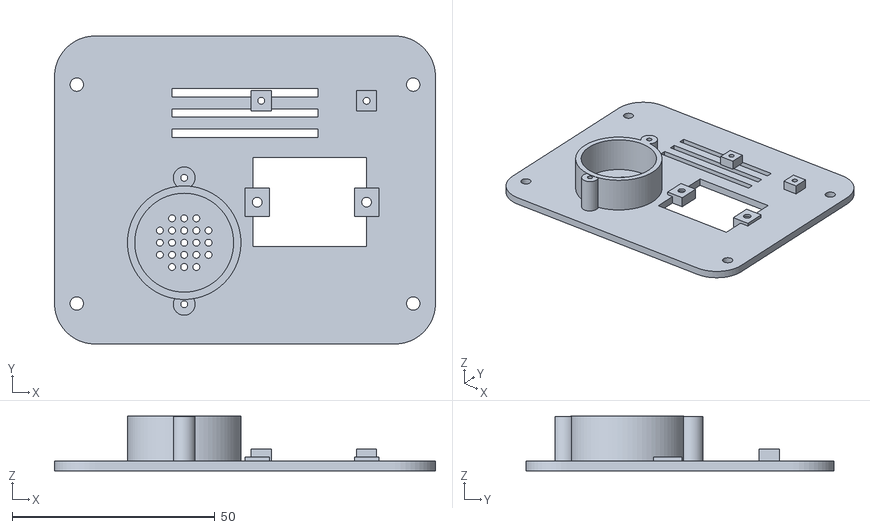
[picture p195: CAD file, 2026-10-26]
mechanical-design/structure-a4/stl-complete/R03__A4__mm.stl
94.0 x 76.0 x 13.5
