xaiojie/papabot/mechanical-design/structure-a2/stl-complete/R05__A2__mm.stl

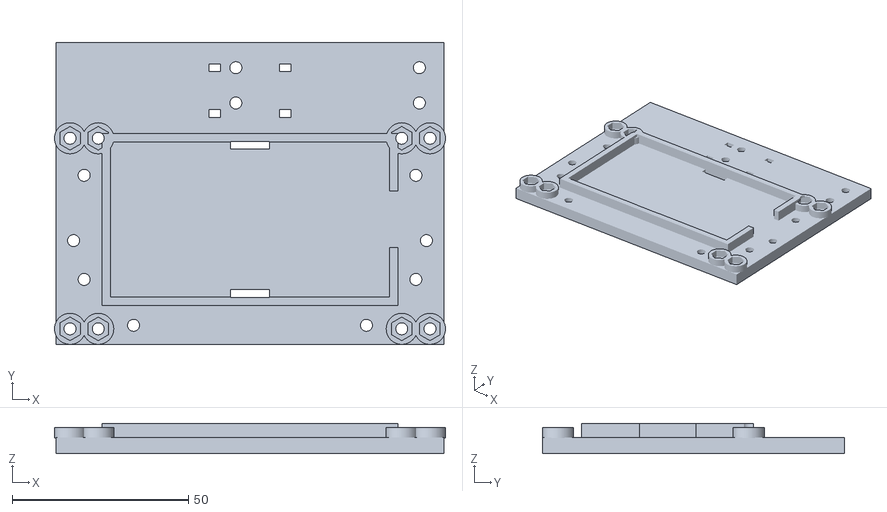
[picture p196: CAD file, 2026-10-26]
mechanical-design/structure-a2/stl-complete/R05__A2__mm.stl
110.8 x 85.7 x 8.60
