xaiojie/papabot/mechanical-design/structure-a3/delivery/DesktopAssistant-A3/stl-complete/R04__A3__mm.stl

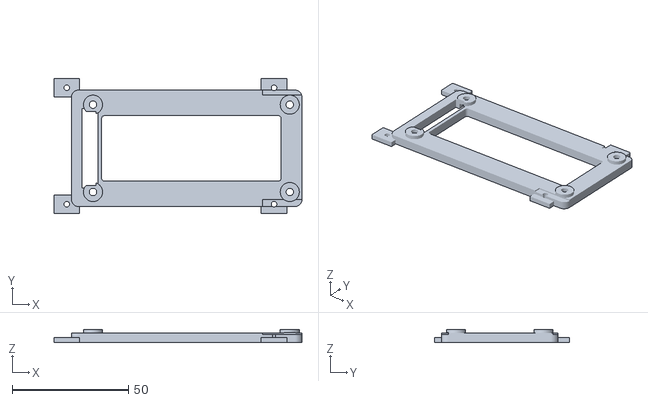
[picture p197: CAD file, 2026-10-26]
mechanical-design/structure-a3/delivery/DesktopAssistant-A3/stl-complete/R04__A3__mm.stl
106.5 x 58.0 x 5.60
