xaiojie/papabot/mechanical-design/structure-a2/stl-complete/R08__A2__mm.stl

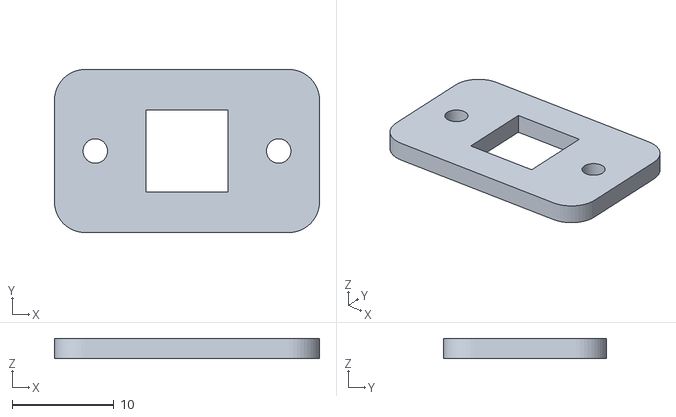
[picture p199: CAD file, 2026-10-26]
mechanical-design/structure-a2/stl-complete/R08__A2__mm.stl
26.0 x 16.0 x 2.00
