xaiojie/papabot/mechanical-design/structure-a4/stl-complete/L102_RR__A4__mm.stl

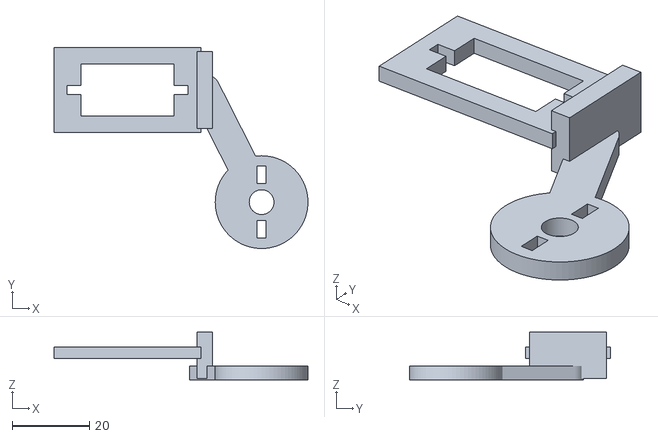
[picture p200: CAD file, 2026-10-26]
mechanical-design/structure-a4/stl-complete/L102_RR__A4__mm.stl
65.7 x 52.0 x 12.3
