xaiojie/papabot/mechanical-design/structure-a3/delivery/DesktopAssistant-A3/stl-complete/R09__A3__mm.stl

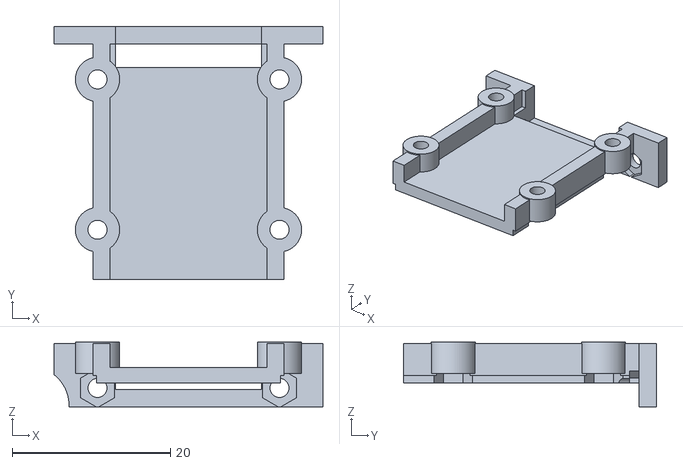
[picture p201: CAD file, 2026-10-26]
mechanical-design/structure-a3/delivery/DesktopAssistant-A3/stl-complete/R09__A3__mm.stl
34.0 x 32.0 x 8.20
