xaiojie/papabot/mechanical-design/structure-a4/stl-complete/L104_FR__A4__mm.stl

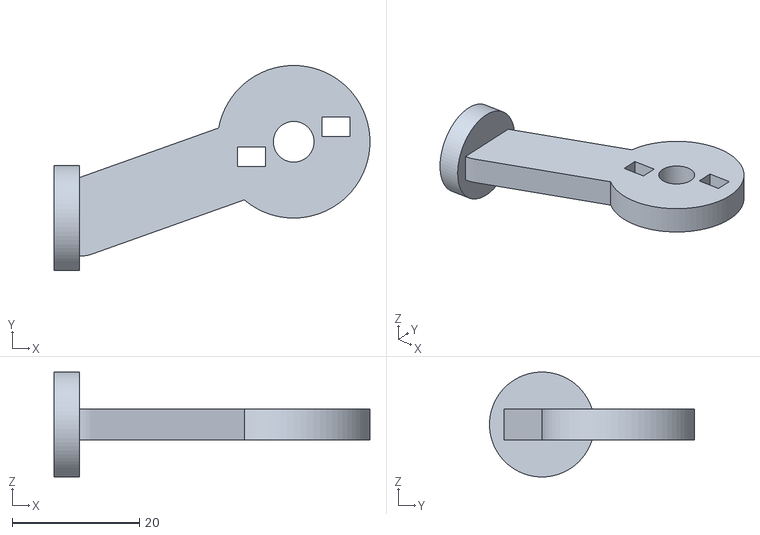
[picture p202: CAD file, 2026-10-26]
mechanical-design/structure-a4/stl-complete/L104_FR__A4__mm.stl
49.7 x 32.2 x 16.5
