xaiojie/papabot/mechanical-design/structure-a3/delivery/DesktopAssistant-A3/stl-complete/R17__A3__mm.stl

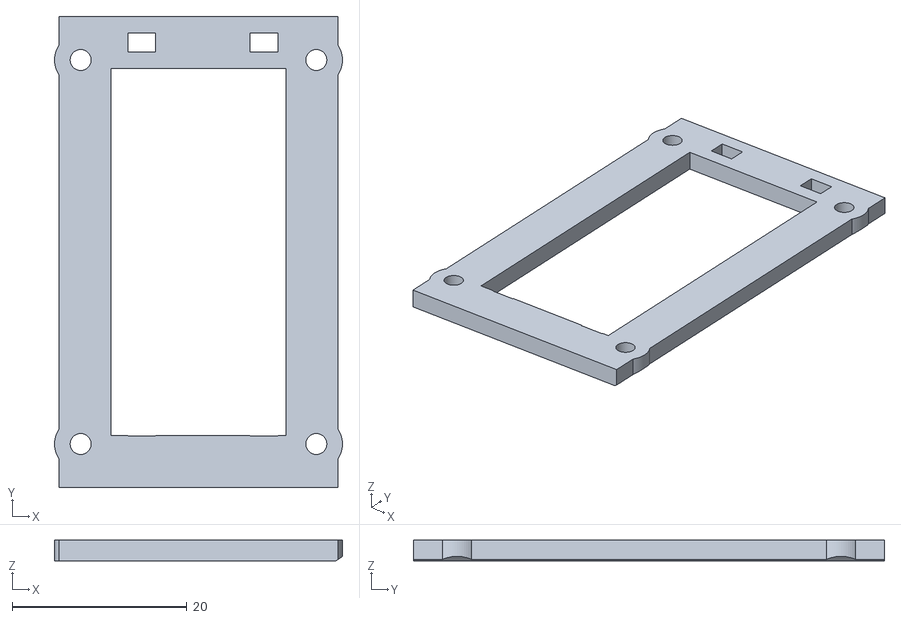
[picture p203: CAD file, 2026-10-26]
mechanical-design/structure-a3/delivery/DesktopAssistant-A3/stl-complete/R17__A3__mm.stl
33.0 x 54.0 x 2.40
