xaiojie/papabot/mechanical-design/structure-a5/stl-complete/R17__A5__mm.stl

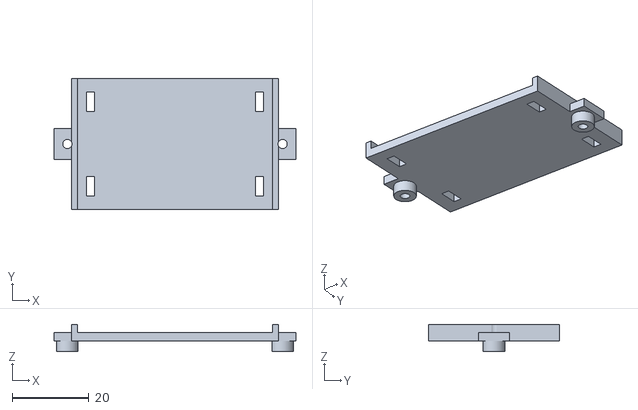
[picture p204: CAD file, 2026-10-26]
mechanical-design/structure-a5/stl-complete/R17__A5__mm.stl
63.0 x 34.0 x 7.10
