xaiojie/papabot/mechanical-design/structure-a3/delivery/DesktopAssistant-A3/stl-complete/R16__A3__mm.stl

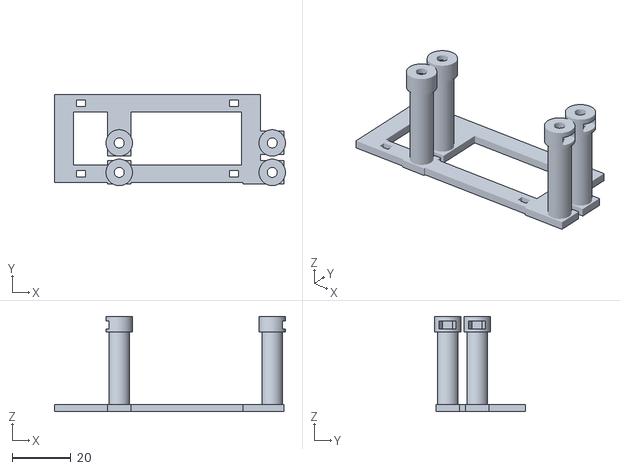
[picture p205: CAD file, 2026-10-26]
mechanical-design/structure-a3/delivery/DesktopAssistant-A3/stl-complete/R16__A3__mm.stl
78.5 x 31.0 x 32.4
