xaiojie/papabot/mechanical-design/structure-a5/stl-complete/R18__A5__mm.stl

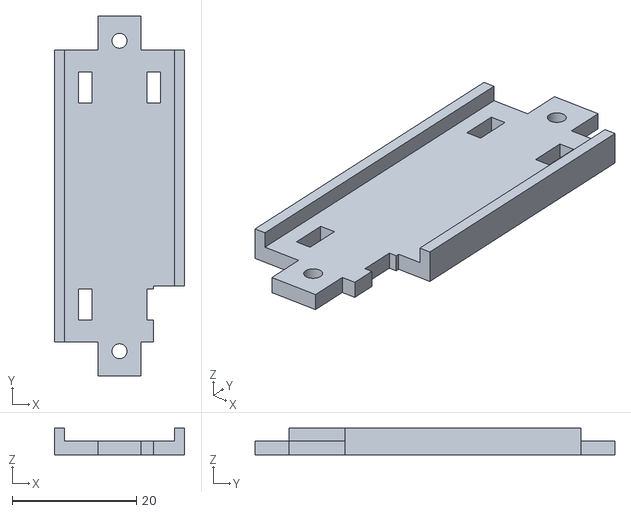
[picture p206: CAD file, 2026-10-26]
mechanical-design/structure-a5/stl-complete/R18__A5__mm.stl
21.0 x 58.0 x 4.30
