xaiojie/papabot/mechanical-design/structure-a3/delivery/DesktopAssistant-A3/stl-complete/R02__A3__mm.stl

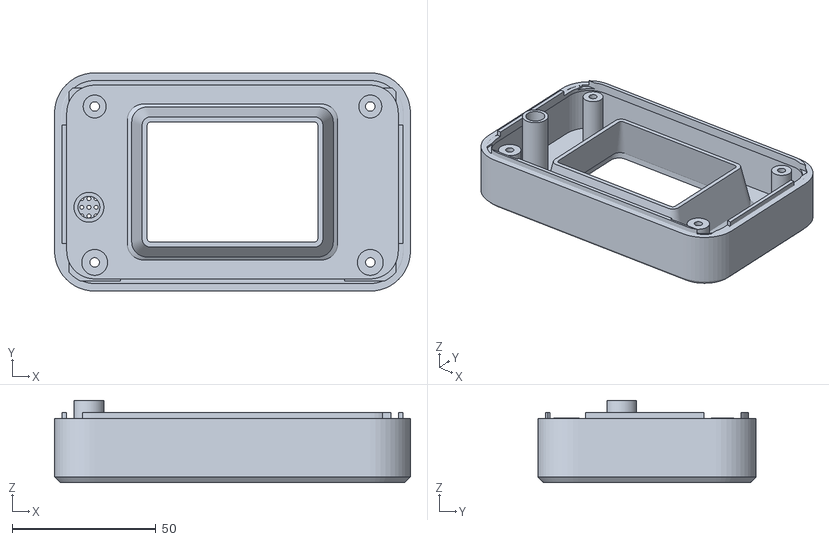
[picture p207: CAD file, 2026-10-26]
mechanical-design/structure-a3/delivery/DesktopAssistant-A3/stl-complete/R02__A3__mm.stl
124.0 x 76.0 x 28.7
