xaiojie/papabot/mechanical-design/structure-a4/stl-complete/R17__A4__mm.stl

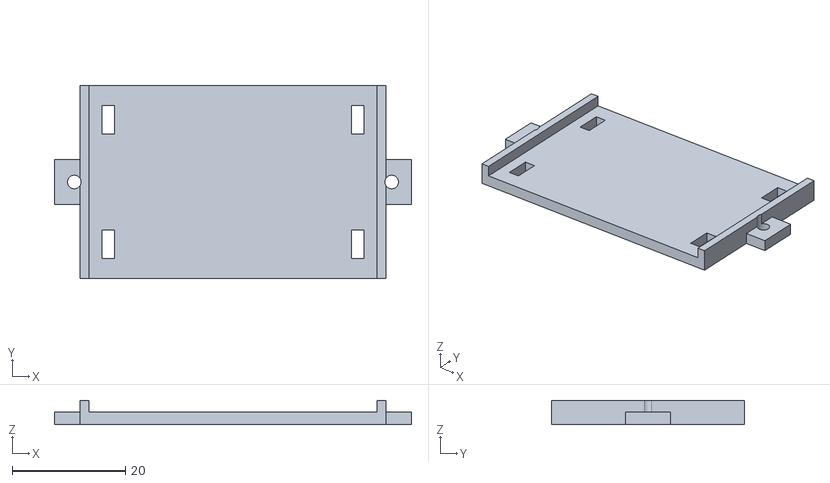
[picture p208: CAD file, 2026-10-26]
mechanical-design/structure-a4/stl-complete/R17__A4__mm.stl
63.0 x 34.0 x 4.30
