xaiojie/papabot/mechanical-design/structure-a2/stl-complete/R07__A2__mm.stl

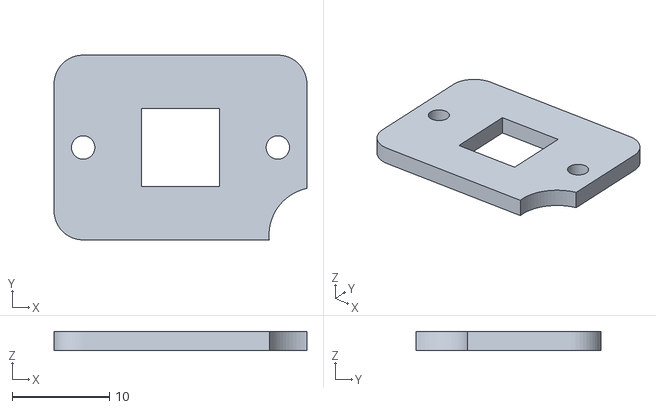
[picture p209: CAD file, 2026-10-26]
mechanical-design/structure-a2/stl-complete/R07__A2__mm.stl
26.0 x 19.0 x 2.00
