xaiojie/papabot/mechanical-design/structure-a4/stl-complete/R01__A4__mm.stl

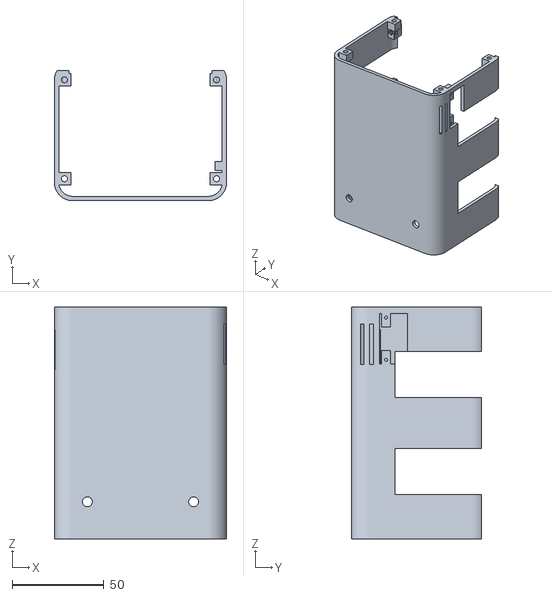
[picture p210: CAD file, 2026-10-26]
mechanical-design/structure-a4/stl-complete/R01__A4__mm.stl
94.0 x 71.2 x 126.6
