xaiojie/papabot/mechanical-design/structure-a5/stl-complete/R08__A5__mm.stl

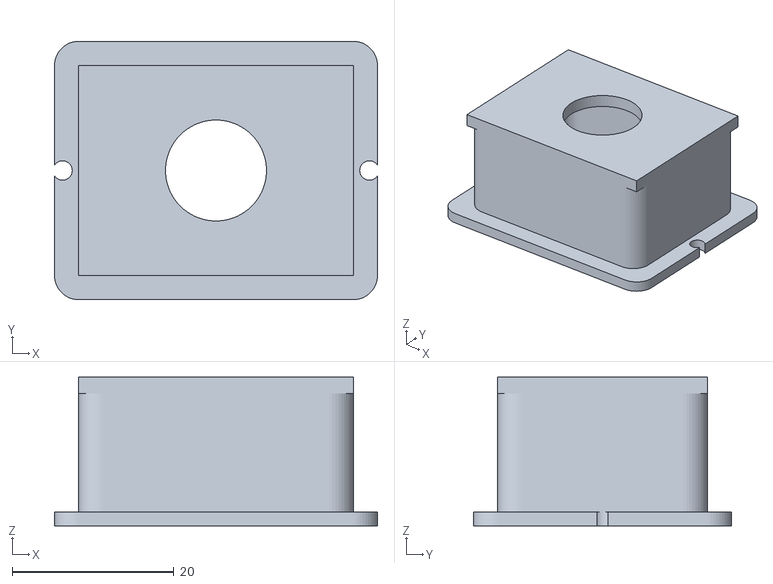
[picture p211: CAD file, 2026-10-26]
mechanical-design/structure-a5/stl-complete/R08__A5__mm.stl
40.0 x 32.0 x 18.4
