xaiojie/papabot/mechanical-design/structure-a2/stl-complete/R01__A2__mm.stl

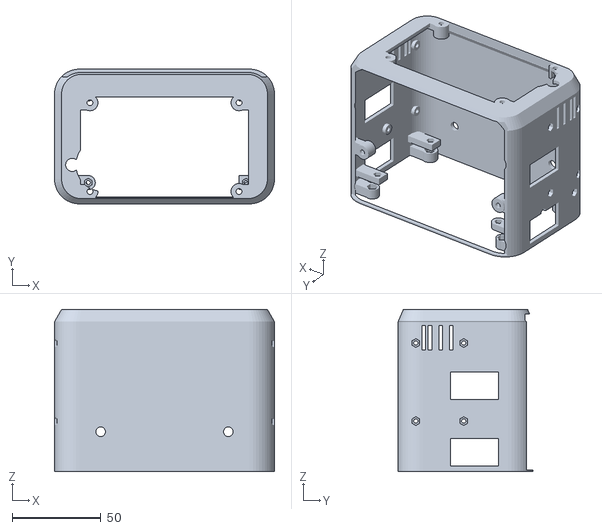
[picture p212: CAD file, 2026-10-26]
mechanical-design/structure-a2/stl-complete/R01__A2__mm.stl
124.0 x 76.0 x 91.5
