xaiojie/papabot/mechanical-design/structure-a5/stl-complete/R06__A5__mm.stl

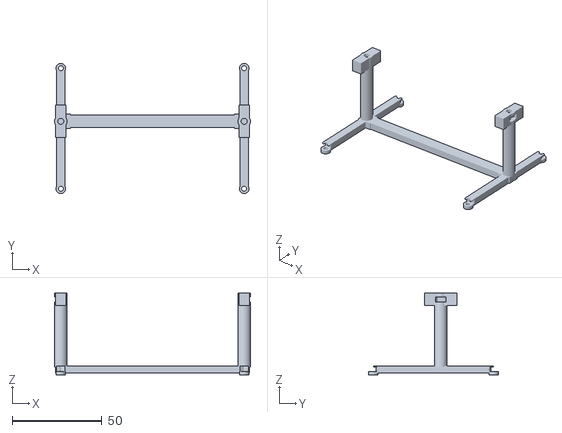
[picture p213: CAD file, 2026-10-26]
mechanical-design/structure-a5/stl-complete/R06__A5__mm.stl
109.0 x 72.4 x 45.6
