xaiojie/papabot/mechanical-design/structure-a2/stl-complete/R03__A2__mm.stl

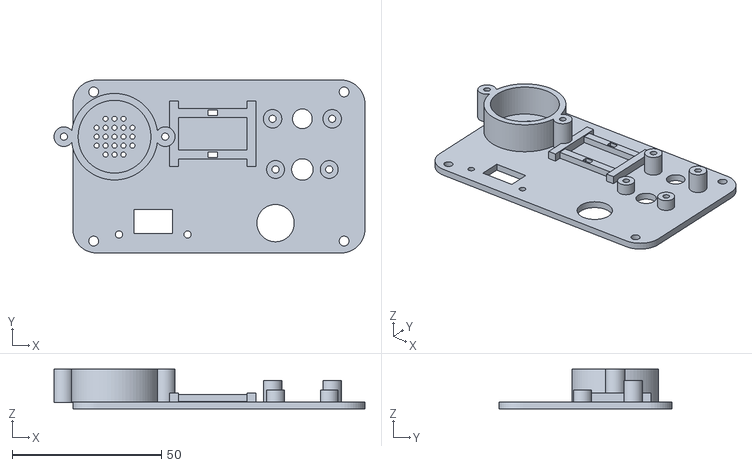
[picture p214: CAD file, 2026-10-26]
mechanical-design/structure-a2/stl-complete/R03__A2__mm.stl
104.3 x 58.0 x 13.4
