xaiojie/papabot/mechanical-design/structure-a4/stl-complete/R05__A4__mm.stl

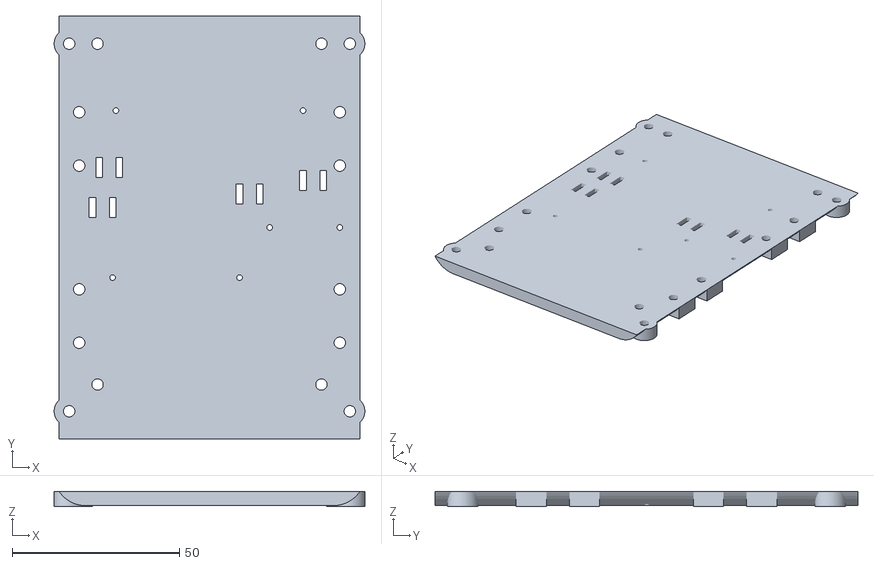
[picture p215: CAD file, 2026-10-26]
mechanical-design/structure-a4/stl-complete/R05__A4__mm.stl
93.0 x 126.6 x 4.60
