xaiojie/papabot/mechanical-design/structure-a4/stl-complete/R18__A4__mm.stl

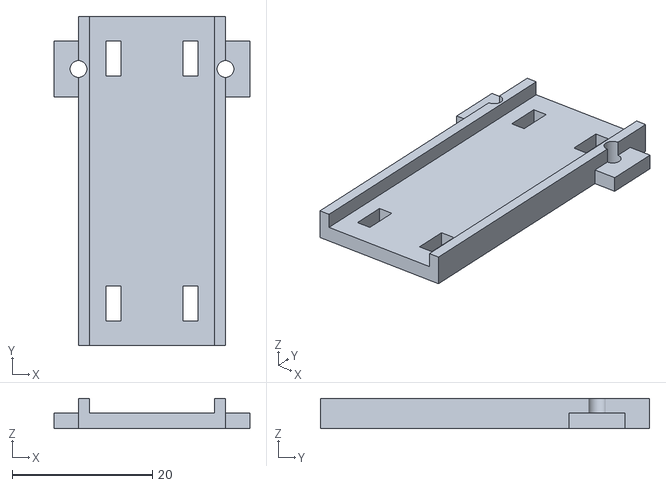
[picture p216: CAD file, 2026-10-26]
mechanical-design/structure-a4/stl-complete/R18__A4__mm.stl
28.0 x 47.0 x 4.30
