xaiojie/papabot/mechanical-design/structure-a5/stl-complete/R21__A5__mm.stl

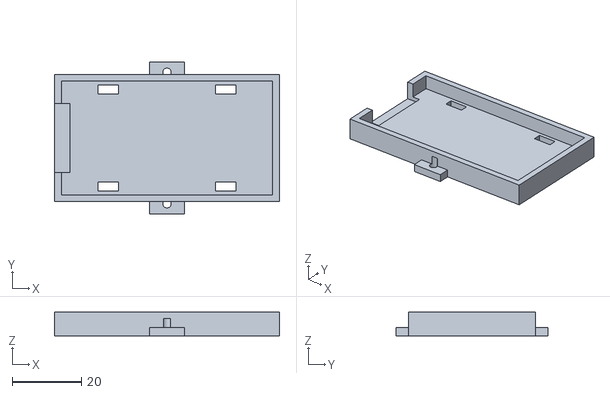
[picture p217: CAD file, 2026-10-26]
mechanical-design/structure-a5/stl-complete/R21__A5__mm.stl
65.0 x 44.0 x 6.90
