xaiojie/papabot/mechanical-design/structure-a4/stl-complete/R06__A4__mm.stl

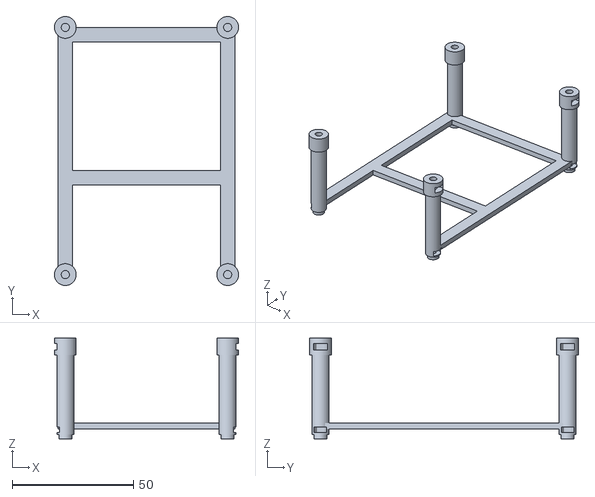
[picture p218: CAD file, 2026-10-26]
mechanical-design/structure-a4/stl-complete/R06__A4__mm.stl
76.0 x 111.0 x 41.6
