xaiojie/papabot/mechanical-design/structure-a5/stl-complete/R01__A5__mm.stl

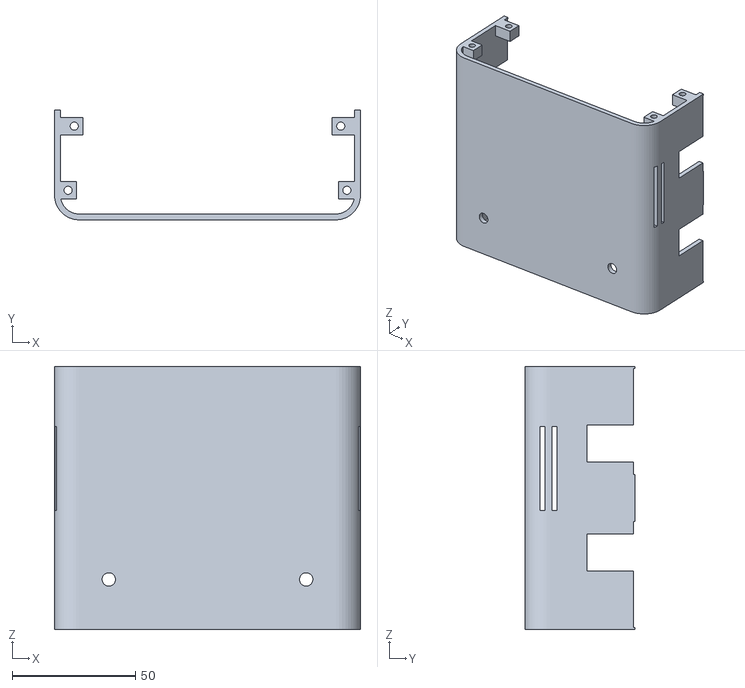
[picture p219: CAD file, 2026-10-26]
mechanical-design/structure-a5/stl-complete/R01__A5__mm.stl
124.0 x 44.5 x 106.6
