xaiojie/papabot/mechanical-design/structure-a4/stl-complete/R08__A4__mm.stl

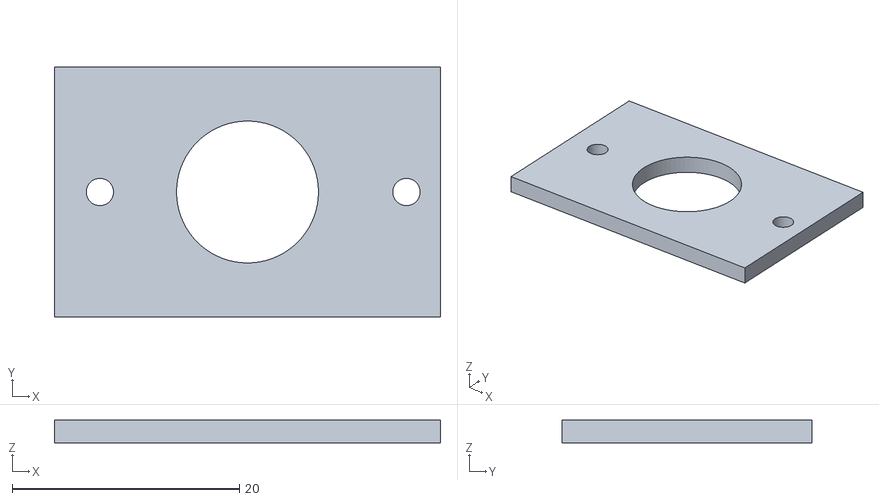
[picture p220: CAD file, 2026-10-26]
mechanical-design/structure-a4/stl-complete/R08__A4__mm.stl
34.0 x 22.0 x 2.00
