xaiojie/papabot/mechanical-design/structure-a2/stl-complete/R02__A2__mm.stl

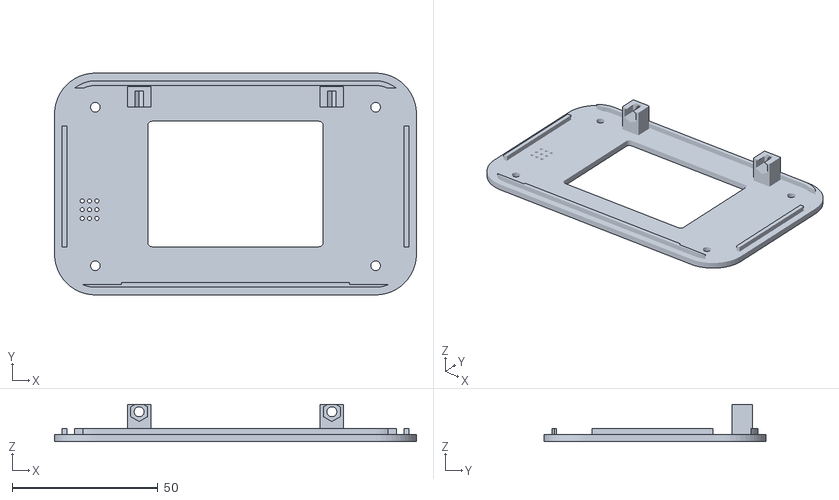
[picture p221: CAD file, 2026-10-26]
mechanical-design/structure-a2/stl-complete/R02__A2__mm.stl
124.0 x 76.0 x 12.7
