xaiojie/papabot/(list of files, cad)

Other CAD files:
mechanical-design/structure-a2/stl/R06__PCB_support_bridge_A2__mm.stl
mechanical-design/structure-a4/stl-complete/R04__A4__mm.stl
mechanical-design/structure-a2/stl-complete/R18__A2__mm.stl
mechanical-design/structure-a3/delivery/DesktopAssistant-A3/stl-complete/L104_RR__A3__mm.stl
mechanical-design/structure-a4/coupons/T02__A4__mm.stl
mechanical-design/structure-a4/stl-complete/R13_R__A4__mm.stl
mechanical-design/structure-a5/coupons/T01__A5__mm.stl
mechanical-design/structure-a3/delivery/DesktopAssistant-A3/stl-complete/R13_L__A3__mm.stl
mechanical-design/structure-a3/stl-complete/R13_R__A3__mm.stl
mechanical-design/structure-a5/stl-complete/R04__A5__mm.stl
mechanical-design/structure-a3/delivery/DesktopAssistant-A3/stl-complete/L104_RL__A3__mm.stl
mechanical-design/structure-a2/stl-complete/L101_FR__A2__mm.stl
mechanical-design/structure-a4/stl-complete/R20__A4__mm.stl
mechanical-design/structure-a3/delivery/DesktopAssistant-A3/stl-complete/L102_FL__A3__mm.stl
mechanical-design/structure-a3/stl-complete/R12_L__A3__mm.stl
mechanical-design/structure-a5/stl-complete/L104_RR__A5__mm.stl
mechanical-design/structure-a3/stl-complete/R11__A3__mm.stl
mechanical-design/structure-a5/stl-complete/L101_RR__A5__mm.stl
mechanical-design/structure-a3/delivery/DesktopAssistant-A3/stl-complete/R10_1__A3__mm.stl
mechanical-design/structure-a3/stl-complete/R05__A3__mm.stl
mechanical-design/structure-a5/stl-complete/R12_R__A5__mm.stl
mechanical-design/structure-a2/stl-complete/L101_RL__A2__mm.stl
mechanical-design/structure-a3/stl-complete/L102_FR__A3__mm.stl
mechanical-design/structure-a5/stl-complete/L104_FR__A5__mm.stl
mechanical-design/structure-a2/stl-complete/L101_FL__A2__mm.stl
mechanical-design/structure-a3/stl-complete/R06__A3__mm.stl
mechanical-design/structure-a4/stl-complete/L101_RR__A4__mm.stl
mechanical-design/structure-a2/stl-complete/R10_2__A2__mm.stl
mechanical-design/structure-a3/stl-complete/L101_FR__A3__mm.stl
mechanical-design/structure-a4/stl-complete/L104_RR__A4__mm.stl
mechanical-design/structure-a2/stl-complete/R16__A2__mm.stl
mechanical-design/structure-a3/delivery/DesktopAssistant-A3/stl-complete/R14__A3__mm.stl
mechanical-design/structure-a3/stl-complete/L102_RL__A3__mm.stl
mechanical-design/structure-a4/stl-complete/L101_FL__A4__mm.stl
mechanical-design/structure-a5/stl-complete/R19__A5__mm.stl
mechanical-design/structure-a2/stl-complete/L102_FL__A2__mm.stl
mechanical-design/structure-a5/stl-complete/L102_RR__A5__mm.stl
mechanical-design/structure-a3/delivery/DesktopAssistant-A3/stl-complete/L101_RR__A3__mm.stl
mechanical-design/structure-a5/stl-complete/R07__A5__mm.stl
mechanical-design/structure-a2/stl-complete/L104_FR__A2__mm.stl
mechanical-design/structure-a3/delivery/DesktopAssistant-A3/stl-complete/L104_FR__A3__mm.stl
mechanical-design/structure-a4/stl-complete/L104_RL__A4__mm.stl
mechanical-design/structure-a3/delivery/DesktopAssistant-A3/stl-complete/R12_R__A3__mm.stl
mechanical-design/structure-a4/stl-complete/L102_RL__A4__mm.stl
mechanical-design/structure-a2/stl-complete/L104_FL__A2__mm.stl
mechanical-design/structure-a4/stl-complete/R12_L__A4__mm.stl
mechanical-design/structure-a5/stl-complete/R20__A5__mm.stl
mechanical-design/structure-a2/stl-complete/L102_RR__A2__mm.stl
mechanical-design/structure-a4/stl-complete/L104_FL__A4__mm.stl
mechanical-design/structure-a5/stl-complete/L104_RL__A5__mm.stl
mechanical-design/structure-a4/stl-complete/R12_R__A4__mm.stl
mechanical-design/structure-a5/stl-complete/L101_RL__A5__mm.stl
mechanical-design/structure-a2/stl-complete/L101_RR__A2__mm.stl
mechanical-design/structure-a5/stl-complete/R14__A5__mm.stl
mechanical-design/structure-a2/stl-complete/R04__A2__mm.stl
mechanical-design/structure-a4/stl-complete/L102_FL__A4__mm.stl
mechanical-design/structure-a5/stl-complete/R11__A5__mm.stl
mechanical-design/structure-a2/stl-complete/L102_FR__A2__mm.stl
mechanical-design/structure-a5/stl-complete/L102_RL__A5__mm.stl
mechanical-design/structure-a2/stl-complete/L102_RL__A2__mm.stl
mechanical-design/structure-a4/stl-complete/L101_RL__A4__mm.stl
mechanical-design/structure-a5/stl-complete/R13_R__A5__mm.stl
mechanical-design/structure-a2/stl-complete/R13_R__A2__mm.stl
mechanical-design/structure-a4/stl-complete/L102_FR__A4__mm.stl
mechanical-design/structure-a5/stl-complete/L101_FR__A5__mm.stl
mechanical-design/structure-a2/stl-complete/R17__A2__mm.stl
mechanical-design/structure-a4/stl-complete/L101_FR__A4__mm.stl
mechanical-design/structure-a2/stl-complete/R12_L__A2__mm.stl
mechanical-design/structure-a2/stl-complete/L104_RL__A2__mm.stl
mechanical-design/structure-a4/stl-complete/R07__A4__mm.stl
mechanical-design/structure-a5/stl-complete/L101_FL__A5__mm.stl
mechanical-design/structure-a2/stl-complete/L104_RR__A2__mm.stl
mechanical-design/structure-a5/stl-complete/R12_L__A5__mm.stl
mechanical-design/structure-a2/stl-complete/R10_1__A2__mm.stl
mechanical-design/structure-a4/stl-complete/R21__A4__mm.stl
mechanical-design/structure-a5/stl-complete/L102_FL__A5__mm.stl
mechanical-design/structure-a2/stl-complete/R09__A2__mm.stl
mechanical-design/structure-a4/stl-complete/R13_L__A4__mm.stl
mechanical-design/structure-a5/stl-complete/R13_L__A5__mm.stl
mechanical-design/print-v2/stl/T02__M2_nut_fit_coupon__mm.stl
mechanical-design/print-v2/stl/T03__M3_nut_fit_coupon__mm.stl
