xaiojie/papabot/mechanical-design/structure-a3/装配与打印说明.md

# A3 装配与打印说明

本版按用户确认的旧V1结构修正：**屏幕竖直正对前方，原板旋钮和按键藏在可拆前盖里面，拆盖后操作。** 前盖外表面Y−46.2，玻璃前面约Y−25.41，名义内凹20.79mm。主壳、内部模块和四腿的其余结构沿用A2；本版仍用于首轮试装。

## 打印建议

- 主壳、盖板和支架优先PETG；腿件不建议用脆性展示树脂。PLA可先试孔位。
- 初始切片参考0.4mm喷嘴、0.2mm层高；壳盖4圈壁，腿座/连杆/底盘5～6圈壁、约35%～45%填充。这些是试打起点，尚未实际切片。
- R02正面朝下，后口朝上。四根长螺丝柱、内井、导声管与前盖已连接成一个打印件；检查导声管转接处和定位唇的局部支撑。R01螺丝座、R06/R16桥架和腿座横梁也需在切片器核查支撑。
- 螺母槽不能被难以拆除的支撑堵死。清理后手推试入螺母，薄壁螺丝座轻拧。M2通孔约Ø2.4，M3多数Ø3.3～3.4，实际补偿取决于打印机和材料。
- 前盖浅线槽涂薄荷色，遮光井内壁涂哑黑；黑色和薄荷色是同一实体的表面处理。STL不带这些颜色，Blender中保留材质区域。小耳浅浮雕区可涂奶油白。

## 装配顺序

1. 预装各处螺母：R06/R16支脚从侧槽装；R01前盖与屏幕框螺母从内侧装；两路电源架和麦克风架螺母从主壳外侧装；R03喇叭螺母从后盖外侧装。
2. 先组一条腿验证MG90S耳孔、原装双臂舵盘和活动间隙。髋舵机装L101，膝舵机装L102；卸载回中后用原装舵盘和中心螺丝连接。打印连杆与舵盘各用2颗M2固定，再装其余三腿。
3. 四个L101用8颗M3×12固定到R05。电池托架先放1mm EVA与目标尺寸假体，再试合电池束带。实际电池尚未确认，不能强压软包。
4. PCB用4颗小头M2×8固定到R06，头径≤4mm，不加大垫片；PCB原Ø3.2孔不改。R06/R16各用4颗M3×10固定到底盘。PCA9685用绝缘垫和扎带固定到开放架。
5. 装小耳、R14麦克风架和R17/R18电源架。模块边缘避开螺丝头。麦克风实际拾音口对准导声管；泡棉仅封边，不能覆盖声孔。
6. **保留完整91×44mm屏幕原板、原EC11和独立按键，不拆焊控件。** 屏幕4孔固定到R04，R04再固定到R01。屏幕显示面与前盖窗口平行，正对整机−Y方向。检查排针两端的让位。
7. 底盘固定到R01主壳，前2个M3螺母座现已移到主壳。检查线束避开屏幕、旋钮和前盖长柱后，沿+Y方向合前盖，用4颗M3×30配0.8mm垫片固定。不要自行加深沉孔或换更长螺丝，避免尖端触碰内部结构。
8. 喇叭装R03套筒，用R11压住外壳边缘；不得压振膜。充电板装R09，由R10两条压住已核实无元件的边缘；MAX98357用后盖中央绑带座固定；S1A用自身安装螺母固定。后盖没有EC11/独立按键。
9. 保险和XT30线束固定在底盘后部，舵机线留活动余量。后盖线束留检修余量，检查不夹线后锁4颗M3×10。贴4只脚垫。

## 前后盖拆卸

前盖：断电后取下正面4颗M3×30及垫片，沿整机−Y水平向前抽出。内井和导声管随盖一起移出，不连接电线；屏幕、旋钮、按键和麦克风保持固定。无需拆底盘或PCB。旋钮和独立按键需拆前盖后才能接触。

后盖：断电后松4颗固定螺丝，确认线束余量或断开相关插头，再沿+Y向后移出。充电架、喇叭压圈、总开关和功放随盖移动。此版只检查了名义硬件的离散拆卸位置，未建模柔性线束。

`A3-front-open.png`中，前盖先向前退出，再放到旁边方便观看；图中的侧向摆放不是拆卸方向。Blender主装配场景保留正确装配坐标。

USB调试首轮通过拆后盖、松右侧电源架接入主控USB。后盖Type-C为独立充电口，仍按既有方案关机充电。

## 紧固件与V7清单的差额

以下记录是采购核对，不代表到货；未更改购物车或下单。A3取消两块后控件压片，用量较A2减少4颗M2×8及4个M2螺母；前盖4颗M3改为30mm长。

| 规格 | 单台数量/备料数 | V7记录 | 处理 |
|---|---:|---|---|
| M2×6 | 14 | V7立创BOM列100颗 | 数量够；长度按实物复核 |
| M2×8 | 40 | V7未明确列此长度 | 建议备50颗；PCB的4颗须小头 |
| M2×10 | 6 | V7未明确列此长度 | 建议备10颗 |
| M2螺母 | 60 | V7淘宝列20颗 | 还差40颗；可加2包20颗，另备损耗 |
| M3×8 | 4 | V7立创BOM列100颗 | 数量够 |
| M3×10 | 16 | V7未明确列此长度 | 建议备20颗 |
| M3×12 | 8 | V7未明确列此长度 | 建议备10颗 |
| M3×30 | 4 | A3深前盖新增长度 | 前盖4颗；建议备6颗，配0.8mm平垫 |
| M3螺母 | 32 | V7淘宝列50颗 | 数量够 |
| M3平垫片 Ø6×0.8 | 32 | V7淘宝列200片 | 前盖按外径≤7mm预留；PCB的M2处不用此垫片 |
| 原装双臂舵盘及中心螺丝 | 8 | 随8个MG90S附带情况待确认 | 原装花键和中心螺纹，不能用普通M2代替 |
| Ø12×2硅胶脚垫 | 4 | V7淘宝列50只 | 每脚1只 |
| 10×150mm电池束带 | 1 | V7淘宝列2条 | 到货后确认搭接长度 |
| 1mm EVA薄垫 | 1 | V7淘宝列1卷 | 电池/模块边缘裁切；电源架可叠至约2mm |
| 2.5×100mm扎带 | 20 | V7淘宝列100条 | 走线备料，实际用量视线束确定 |

机牙螺丝位置共M2 60个、M3 32个，对应M2螺母60、M3螺母32及M3平垫32。具体分配见[紧固件安装明细.csv](紧固件安装明细.csv)。螺丝长度需要结合真实耳片/垫厚复核，不能顶住电路板或模块。

## 仍需实物确认

- 屏幕相对PCB的位置、真实可见区、排针高度及针序；原板安装孔标称84.5×37.5mm。屏幕原板不能裁切。
- **EC11轴长15mm不等于装板后旋钮的总高度。** A3按旧V1的旋钮包络留位，模型中旋钮最前点与盖内面约1.3mm轴向间隙；必须用所购实物核对，必要时加深前盖。
- 导声通道与真实麦克风声孔的密封和拾音效果；麦克风模块具体外形身份仍待确认。
- MG90S同批外形、耳孔、轴伸、舵盘和扭矩；电池75×40×20mm、≤80g是定制目标，不是实物结果。
- DFR0753包络为空间预留；PCA、功放、充电板元件位置、UBEC引线/磁环与线束弯曲待实测。
- 网格和名义干涉检查不代替实际切片、试装、强度、温升、连续运动、步态、RF和声学测试。
