xaiojie/papabot/pcb-design/native-rev-b/装配与上电核对.md

# RevB 载板装配与上电核对

2026-09-09电池适配补充：现货ACE800＋HX-2S-JH20外置保护均衡板；RevB铜线/接口继续兼容。整机GND、J9.2和充电负极统一接P−，不接原始B−。见[板外电源接线](../../hardware-selection/battery-stock-2026-09-09/接线与调试.md)。

2026-09-09。屏幕的 VCC 和 BLK 已改接独立 LCD_3V3 网络。**JP1、JP2、JP3 初装均保持断开，R4–R7 默认不焊。** 本板没有新增板载稳压芯片，J10 是外部稳压 3.3V 的接入口。

这块板只连接主控及模块的逻辑信号和电源。8 个舵机及功放功率支路仍走板外配线。本说明对应 RevB，旧 RevA 的屏幕 5V 接法已停用。

## 屏幕12针接线

旋钮与独立按键保留在完整原板上，藏在可拆前盖内。屏幕竖直朝前。先按模块丝印确认插接方向，再逐根接线；本载板的 J3+J7 拆分接口不能直接套用一根同序12针排线。

| 模块针号 | 模块丝印 | 载板针脚 | MCU或供电 | 说明 |
|---|---|---|---|---|
| 1 | GND | J3.1 | GND | 共地 |
| 2 | VCC | J3.2 | LCD_3V3 | 仅3.3V |
| 3 | SCL | J3.3 | GPIO12 | SPI时钟 |
| 4 | SDA | J3.4 | GPIO11 | SPI MOSI，不是I2C数据 |
| 5 | RES | J3.5 | GPIO21 | 复位 |
| 6 | DC | J3.6 | GPIO14 | 数据/命令 |
| 7 | CS | J3.7 | GPIO13 | 片选 |
| 8 | BLK | J3.8 | LCD_3V3 | 3.3V固定高电平，全亮，无软件调光 |
| 9 | A | J7.2 | GPIO7 | 旋钮A相 |
| 10 | B | J7.3 | GPIO2 | 旋钮B相 |
| 11 | PUSH | J7.5 | GPIO38 | 旋钮按压，按下为低 |
| 12 | K0 / KEY0 | J7.7 | GPIO40 | 独立按键，按下为低 |

J7.1/.4/.6 都是 GND 备用位，不接到模块的其他信号。模块的 GND 经 J3.1 与主控、稳压器共地。引脚说明中 B 相文字重复写成 A，按 B 标签及整板电路识别。模块自身已有四路10kΩ上拉，R4–R7 保留焊位但初装数量为0；原生库/BOM中的“加入BOM”不表示这些可选电阻需要焊接，装配以本版CSV的“初装数量/默认状态”为准。

## 屏幕3.3V的两种供电方式

| 方式 | JP3状态 | J10 | 条件 |
|---|---|---|---|
| 初始检查 | 断开 | 不接电源 | 屏幕无供电属于预期，先核对极性与短路 |
| 共用主控3.3V | 检查通过后跨接 | 不接外部电源 | 确认屏幕全亮最大电流，以及主控、麦克风、PCA等总负载的余量与温升 |
| 外部稳压3.3V | 保持断开 | 1脚3.3V，2脚GND | 外部稳压器先空载/带载确认输出和能力，MCU与LCD协调上电/掉电 |

**J10只能接稳压后的3.3V，不能接5V或电池。外接3.3V时禁止短接JP3，不能把两个稳压输出并在一起。** JP3本身是普通导线连接位，不提供限流或防倒灌。

屏幕全亮最大电流尚未取得；主控ME6217标称800mA是稳压器能力参数，并非800mA都留给外设。没有据此直接接通JP3。若采用独立稳压支路，还需确定实物模块、额定负载、输入/输出电容与安装位置；C5=100nF仅作旁路，不能替代稳压器要求的电容。

两种模式都要避免一侧未供电时经SPI或控件线给另一侧反向供电。初测可先用GPIO高阻、共同供电时序验证；如果实际上下电无法满足要求，需要带掉电保护的隔离/电平缓冲方案，不能只靠软件启动后的状态。先断电再插拔线束。

## 其余接口

元件面观察，连接器方形焊盘为1脚；详细坐标见[载板接口与引脚.csv](载板接口与引脚.csv)。

| 接口 | 从1脚起的针序或用途 |
|---|---|
| J1/J2 | 主控左/右排各20P；两排1脚均朝天线，2.54mm针距、17.78mm排距 |
| J4 | GND、3.3V、PCA_SDA、PCA_SCL、PCA_OE_N；只接PCA9685逻辑 |
| J5 | GND、3.3V、MIC_BCLK、MIC_WS、MIC_SD、GND；末脚接麦克风LR选左声道 |
| J6 | GND、AMP_BCLK、AMP_WS、AMP_DIN；MAX98357功率另接5V支路 |
| J8 | +5V_LOGIC、GND；只接已设为5V的逻辑UBEC |
| J9 | VBAT_SW、GND；只采样总开关后的电池电压 |
| JP1 | +5V_LOGIC、+5V_MCU；主控供电跨线，初始断开 |
| JP2 | VBAT_SW、VBAT_SENSE；采样跨线，初始断开 |
| JP3 | +3V3、LCD_3V3；屏幕电源选择跨线，初始断开 |
| J10 | LCD_3V3、GND；可选外部3.3V输入 |

J1/J2的左右按厂家主控元件面、天线在上的方向定义；本载板将主控横放，天线朝板左侧。不要把厂家原理图的连接器编号套成本载板编号。

## 元件与空间

- 板上24个设计焊位；初装R4–R7不焊，JP1–JP3不跨接，J10可预留。原理图另有板外C2，共25个实体元件。
- R1=100kΩ、R2=33kΩ、R3=10kΩ；C1/C3/C4/C5=100nF。C2=470µF/16V放在板外UBEC/功放支路，注意极性并绝缘固定。
- J10、JP3、C5中心分别为PCB坐标(74,11)、(74,16)、(74,21)mm。JP3优先贴板短导线，J10用短软线或实测可容纳的低矮连接器。库中的通用高排针模型不是已验证的装配选型。
- 主控插座J1/J2为C429947 / 22850120ANG1SYA01，塑高8.5mm。A3尚未实物试装，需核对插座、主控板底、线束、壳体与新增连接位的空间。
- 采购差额：100nF电容比RevA多1只，可先核现有电容包数量；JP3可用已有短导线。J10/外部3.3V稳压器是预留方案，尚未选购。没有改变购物车。

## 电源与首次上电

受保护2S电池经既定保险丝和总开关后分成两路5V稳压：DFR0753供舵机，好盈3A UBEC设5V后分别供J8与功放。两路共地，5V正极不能相并。8路舵机总电流走外部粗线，不经过载板或PCA模块的细铜箔。充电接总开关前的受保护分支，首版关机充电。

1. 不插主控和任何模块，JP1/JP2/JP3断开、R4–R7不焊。断电检查J8、J10极性，各电源与GND无短路，并确认LCD_3V3与5V网络、主控3.3V网络隔离。
2. 单独检查稳压器输出。逻辑UBEC为5V，外部屏幕支路如使用则为3.3V。未确认电流规格时使用可调限流电源逐步测试并记录，不能将空载电压正常当成满载通过。
3. 首次烧录先从插座拔出主控，单独接电脑USB。USB VBUS与主控5V排针直连，本载板没有自动电源切换。电池工作时不接电脑USB。
4. 拔掉USB、断电后插回主控，确认接法后接通JP1。先检查主控3.3V，再断电接通JP2并核对ADC_BAT；满电8.4V经100kΩ/33kΩ分压约2.084V，固件需设ADC量程并校准。
5. 按上面的供电模式准备屏幕，断电完成全部12针接线。上电后先测VCC/BLK为3.3V，检查控件高电平与主控3.3V兼容，再测试全亮、刷新、旋钮及按键。测量压降、电流和温升，含Wi-Fi、音频并发负载。
6. 再依次接麦克风、功放、PCA9685。PCA的OE高时禁用，若模块带OE下拉须核对并去除冲突。先单舵机小角度测试，再逐步增加数量和负载。

PCB文件复核已通过；实物针序、旋钮帽总高度、打印配合、天线/温升、供电时序与整机负载仍需样机验证。15mm是EC11柄长，不是PCB到旋钮帽顶端的总高。本轮未修改Blender或STL。
