xaiojie/papabot/pcb-design/integrated-v1/final-2026-09-12/装配与接线说明.md

# Integrated V1.0 · 装配与接线

本说明对应 2026-09-12 最终工程，具体引脚以同目录原理图 PDF 和 `接口引脚表.csv` 为准。实物装配和上电尚未执行。

## 1. 板载与板外物料

板载 BOM 是 83 个器件、37 种物料，包含保护/均衡、IP2326 充电、PCA9685、EC11、元件插座及连接器。F1 是保险丝座，保险丝插片须另配。

板外装配件包括 LCKFB-ESP32S3R8N8 开发板、HS24S010B 显示模块、逻辑路降压模块、DFR0753 舵机电源模块、I²S 麦克风模块、MAX98357 功放模块、喇叭、2S 电池、外置开关、100kΩ B4100 NTC、保险丝插片、跳帽、配对插头和线束。它们不应从本次板载 BOM 的数量中推断已经采购或包含。

## 2. 电源接口

| 接口 | 引脚 | 用途 |
|---|---|---|
| JBAT | 1=VBAT_RAW_N，2=VBAT_RAW_P | 原始电池主电源；3/4 为未接网络的固定焊脚 |
| JBAL | 1=VBAT_RAW_N，2=BM，3=VBAT_RAW_P | 两节串联电池的平衡检测接口 |
| J_SW | 1=VBAT_FUSED，2=VBAT_SW | 串接外置直流总开关；两个脚都属于正极路径 |
| J_LOG_IN | 1=VBAT_SW，2=GND | 输出至逻辑降压模块的输入端 |
| J_LOG_OUT | 1=+5V_LOGIC，2=GND | 从逻辑降压模块的 5V 输出返回主板 |
| J_SRV_IN | 1=VBAT_SW，2=GND | 输出至舵机降压模块的输入端 |
| J_SRV_OUT | 1=+5V_SERVO，2=GND | 从舵机降压模块的 5V 输出返回主板 |
| J6 | USB-C VBUS=5V | 充电输入；不是 ESP32 下载口，数据脚未使用 |
| J7 | 1=NTC，2=GND | 外部 100kΩ B4100 温度探头 |
| J10 | 1=LCD_3V3，2=GND | 可选外部稳压 3.3V 屏幕供电输入 |

`VBAT_RAW_N` 是保护 MOS 之前的电池负极。所有系统设备返回 `GND`，不能用额外线束把两者短接。两路 5V 电源共地、正极分开；调压和极性检查应在连接主板负载之前完成。JBAL 通过线色无法保证接线正确，须按电池 B− / BM / B+ 实际测量辨认。

## 3. 三个默认断开的跳线

| 跳线 | 断开时 | 后续启用条件 |
|---|---|---|
| JP_CHG | EN 被下拉，禁止充电 | 电池型号、充电电流、NTC 与保护动作完成台架核验后启用 |
| JP_MCU | +5V_LOGIC 与 MCU_5V 隔离 | 使用外部逻辑 5V 供电时配置；USB 调试时保持断开以避免并联回灌 |
| JP_LCD | 开发板 +3V3 与 LCD_3V3 隔离 | 选开发板 3.3V 为屏幕源时接通；使用 J10 外部 3.3V 时保持断开 |

三处丝印均标有 OPEN。屏幕供电只能选一个来源，不能将 J10 与开发板稳压输出直接并联。

## 4. 新屏幕线束

新选的 **HS24S010B / C5329587 不带旋钮和按钮**。主板 J3 为 **XH-10A / C2908608，2.5 mm** 接口；显示模组的排针是另一端，配线时按功能逐针连接，不应将两者当作可直接对插的同一种连接器。

| 主板 J3 | 主板网络 | 屏幕右排对应脚/信号 |
|---|---|---|
| 1 | GND | 1 GND |
| 2 | LCD_3V3 | 2 VCC |
| 3 | LCD_SCLK | 3 SCL |
| 4 | LCD_MOSI | 4 SDA |
| 5 | LCD_RST_N | 5 RES |
| 6 | LCD_DC | 6 DC |
| 7 | LCD_CS_N | 7 CS |
| 8 | LCD_3V3 | 8 LED / 背光 |
| 9 | NC | 9 FS0，不使用 |
| 10 | NC | 10 FCS，不使用 |

这是主板与屏幕指定右排 1–10 脚的线束定义。显示模块另一排的顺序不同，不能简单翻转插接。J3 的方焊盘对应 1 脚，配对插头观察方向需按实物键位核对。

EC1=EC1106S 是独立板载编码器：1=ENC_A、2=GND、3=ENC_B、4=ENC_SW_N，5/6/7=GND。它包含按压功能，不是屏幕上自带的旋钮，也没有沿用旧屏独立 KEY0 按钮。右下角位置须与新版外壳的操作开孔配合。

## 5. 音频和舵机

| 接口 | 按 1 → 6 顺序 |
|---|---|
| J4 麦克风 | MIC_BCLK、MIC_WS、MIC_SD、+3V3、GND、GND（L/R 选择） |
| J5 功放 | AMP_BCLK、AMP_WS、AMP_DIN、+5V_LOGIC、GND、GND（辅助） |

按模块上的信号名称配线，不以现有模块排针的物理顺序猜接。扬声器接功放的 OUT+ / OUT−，不把其中一端接主板 GND。

SV1–SV8 统一为 **1=PWM、2=+5V_SERVO、3=GND**。从主板正面看，信号脚靠板内侧，地脚靠右侧板边。SV1 对应 PCA9685 LED0 / PWM0，依次到 SV8=LED7 / PWM7。PCA9685 地址脚均接地，地址 0x40；OE 上拉默认禁止输出，固件先初始化 PWM 再启用。此处电路未做真实舵机动作测试。

## 6. 结构与后续验证

主板 110×75 mm，四个 Ø3.2 mm 安装孔中心距 102×67 mm。铜层为螺钉头保留半径 2.8 mm 净空。主控插座列距 17.78 mm，孔距 2.54 mm。完整 ESP32 开发板、插座高度、USB 插头、屏幕线束、外接模块、EC11 轴和机壳没有完成三维联合试装。

原 80×32 mm 载板的 A3 支架不能直接视为兼容。本次制造文件完成与整机已装入外壳是两个验收阶段。

建议实物顺序为：裸板外观和阻值 → 低限流分路供电 → 两路稳压输出 → 主控与屏幕 → 音频 → 单路舵机与八路负载 → 保护/均衡及充电验证 → 结构装配。充电应验证约 0.353A 的实际恒流、8.4V 截止、NTC、超时及电芯平衡；高电流路径须实测压降与温升。
