xaiojie/papabot/mechanical-design/structure-a2/装配与打印说明.md

# A2 装配、打印与紧固件说明

这是一套可编辑、可单件切片的整机试装模型。主体/腿/模块固定结构已建出；舵机、屏幕、电池和部分模块尚无同批实物尺寸，首轮用途是试装验证。

## 打印建议

- 主壳、盖板、支架建议PETG；承载腿件不建议用脆性普通展示树脂。PLA可先试孔位，但不能据此认定温升和长期受力合格。
- 初始切片参考：0.4mm喷嘴、0.2mm层高，主壳/盖板4圈壁；腿座、连杆、底盘5～6圈壁，约35%～45%填充。以上是起始建议，未实际切片或试打。
- STL已有建议朝向。R01内侧悬空螺丝座、R06/R16桥架、腿座横梁以及局部压条需要检查支撑；优先可移除的局部支撑，不能让封闭螺母槽被支撑堵死。
- 清理支撑和毛边后先手推试入螺母，再装零件。M2通孔设计Ø2.4，M3多数Ø3.4；槽公差受材料和机器影响。薄壁螺丝座轻拧，不用电动起子强攻。
- R12耳朵整体薄荷色打印，浅浮雕区可涂奶油白；壳体不加字样和Logo。

## 建议装配顺序

1. **先预装螺母。** R06/R16底部M3螺母从支脚侧槽装入；R06上部M2螺母从底侧装入。R01侧壁电源架/麦克风螺母从外侧装入。R03控件和喇叭螺母从外侧装入。孔槽配合松时可少量可移除胶固定螺母外缘，别堵螺纹。
2. **组单腿。** 每条腿由L101、L102、L104组成。先装髋舵机到L101、膝舵机到L102；在断载条件下通电回中，再用原装舵盘和原中心螺丝连接。打印连杆与双臂舵盘各用2颗M2固定。先把一条腿的耳孔、舵盘孔和活动间隙试通，再复制到其余三腿。
3. **组底盘。** 4个L101用8颗M3×12从底面固定到R05，顶部螺母槽先放螺母。电池托架内垫1mm EVA，穿10mm束带；先按目标假体试装，再放已确认尺寸的电池，束带不勒压软包。
4. **组主控与后舱。** 将PCB装到R06的4个绝缘台面上，用小头M2×8（头径≤4mm），不加大垫片；PCB本体的Ø3.2孔和电气文件不变。R06、R16各用4颗M3×10固定到底盘。PCA9685放在R16上用绝缘垫和扎带固定，连接器避开夹持边。
5. **组主壳附件。** 趁前后开口未封，装R12/R13耳朵、R14麦克风托架、R17/R18电源架。模块与架间留约2mm绝缘/缓冲空间并避开螺丝头。麦克风拾音口对准前盖声孔，泡棉只封边，不盖住拾音口。
6. **组前屏。** 保留91×44mm屏幕PCB完整，拆焊后置的EC11和独立按键另接线。屏幕4孔固定到R04，R04再固定到R01，最后装R02。屏幕有效区/排针高度及玻璃约0.8mm内缩均要用实物复核。
7. **组后面板。** 将喇叭、EC11、按键分别用R11/R07/R08压住外壳边缘，不能压振膜或裸焊点；充电板放R09，用R10两条压住已确认无元件的边缘。MAX98357装在R03中央绑带座。S1A用自身安装螺母固定。
8. **布线后合盖。** 保险及XT30线束固定在底盘后部扎带孔附近，舵机线留关节活动余量。模块之间按既有电气方案连线，舵机大电流使用独立配电线。先合主壳/底盘与前盖，再检查后盖线束不夹线，最后锁后盖。脚底贴4只硅胶垫。

USB调试首轮通过打开后盖、松开右侧电源架接入右向的主控USB；此版没有保证任意USB插头能直接穿过封闭壳体。充电使用独立的后面板Type-C口，仍按关机充电方案。

## 紧固件与V7采购清单的差额

原采购表是结构设计前的估数。下表按A2安装点更新，**不代表已经买到，也未修改购物车或下单**。普通M2不替代舵机中心螺丝。螺丝长度按无额外垫厚的模型核算，实装不得顶到电路板或模块；有外露尖端时选短一档或修短。

| 规格 | 单台数量/备料数 | V7已有记录 | A2处理 |
|---|---:|---|---|
| M2×6 | 14 | 100颗已列立创BOM | 数量够，长度与实物复核 |
| M2×8 | 44 | V7未明确列此长度 | 新增，建议备50颗；PCB用4颗必须小头 |
| M2×10 | 6 | V7未明确列此长度 | 新增，建议备10颗 |
| M2螺母 | 64 | 淘宝已选20颗 | 还差44颗；原20颗装可再备3包，总计80颗 |
| M3×8 | 4 | 100颗已列立创BOM | 数量够 |
| M3×10 | 20 | V7未明确列此长度 | 新增，建议备30颗 |
| M3×12 | 8 | V7未明确列此长度 | 新增，建议备10颗 |
| M3螺母 | 32 | 淘宝已选50颗 | 数量够 |
| M3平垫片（Ø6×0.8） | 32 | 淘宝已选200片 | 数量够；PCB的M2处不用此垫片 |
| 原装舵盘与中心螺丝 | 8 | 随8个MG90S附带情况待实物确认 | 原装花键和中心螺纹，不能用普通M2代替 |
| Ø12×2硅胶脚垫 | 4 | 淘宝已选50只 | 每脚1只 |
| 10×150mm电池束带 | 1 | 淘宝已选2条 | 电池实物到货后确认搭接长度 |
| 1mm EVA薄垫 | 1 | 淘宝已选1卷 | 按电池、模块、控件边缘裁切；电源模块可叠到约2mm |
| 2.5×100mm扎带 | 20 | 淘宝已选100条 | 建议预留20根，按走线裁定；不勒压电芯 |

每个机牙螺丝位置对应1个螺母：M2共64、M3共32。M3共32个位置使用Ø6×0.8mm平垫片。各安装位置的分配见[紧固件安装明细.csv](紧固件安装明细.csv)。

## 实物仍需确认的配合

- MG90S同批外形、耳孔距、轴伸、双臂舵盘厚度和孔距；模型用了可调耳槽及原装舵盘接口，没有打印花键。当前腿结构需要负载、扭矩和步态验证。
- 屏幕开窗和厚度、拆焊后残余高度、插头针序及线束弯曲；完整屏幕板不能裁切。
- 电池75×40×20mm是给商家的目标，并非已收到的成品尺寸；保护板、包膜、出线及≤80g重量仍以最终实物为准。
- DFR0753预留空间、麦克风模块外形身份、PCA9685及功放接插件、充电板元件位置、UBEC线头和磁环需复测。开放架和可换小支架用于后续调整。
- 静态干涉检查和32个腿部抽样姿态不等于连续运动扫掠、线束活动、强度、温升、RF或整机行走试验。
