xaiojie/papabot/mechanical-design/assembly-v1/gallery.html

# 奶油薄荷 · 总装 V1

第一阶段：可编辑 Blender 模型、八个视角与拆开状态。保留已选的 2.4 英寸 TFT＋EC11 模块，前盖、主壳、底盖、耳饰和四足分别组织。点击图片查看原尺寸。

整体效果

01 · 整体效果奶油薄荷 · 实际 Blender 渲染

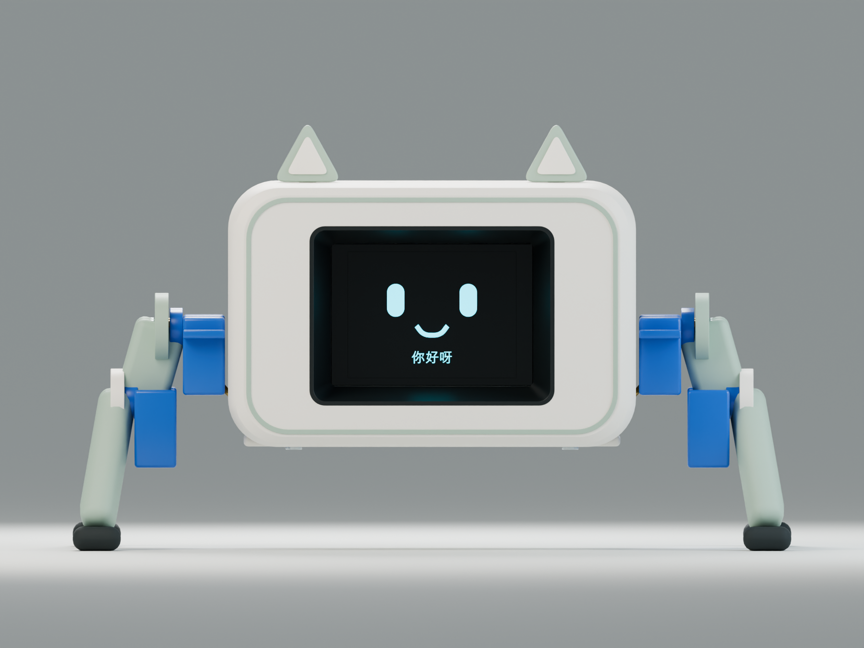
[picture p224: mechanical-design/assembly-v1/renders/front.png]
正面居中


02 · 正面居中118 mm 主体外宽；旋钮隐藏在前盖内

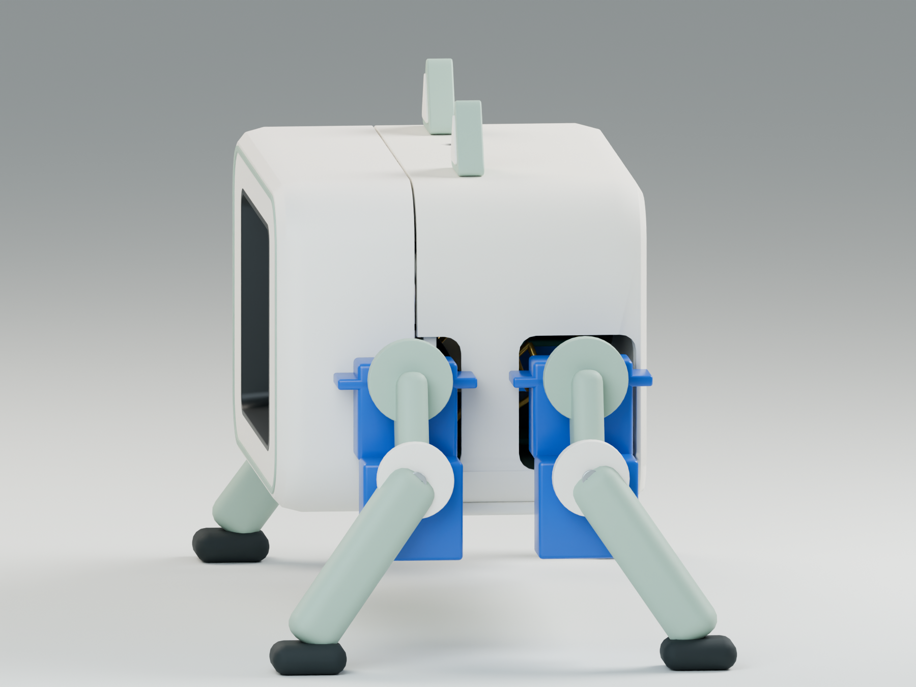
[picture p225: mechanical-design/assembly-v1/renders/side.png]
侧面与前盖分缝


03 · 侧面与前盖分缝完整旋钮使玻璃相对前盖后退约20.8 mm

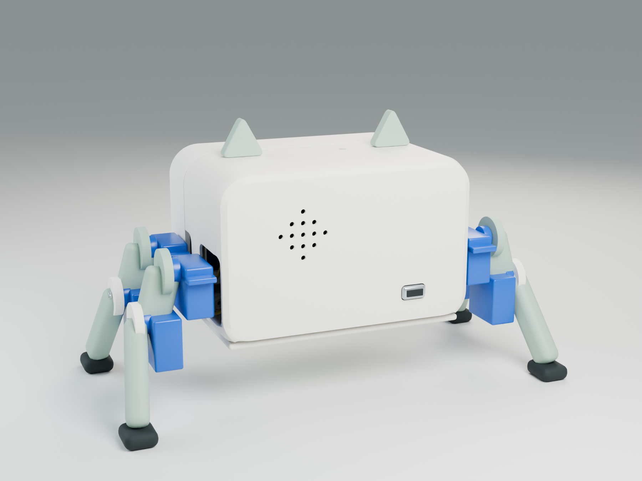
[picture p226: mechanical-design/assembly-v1/renders/rear.png]
背面


04 · 背面扬声器、麦克风、电源开口均待实际器件确认

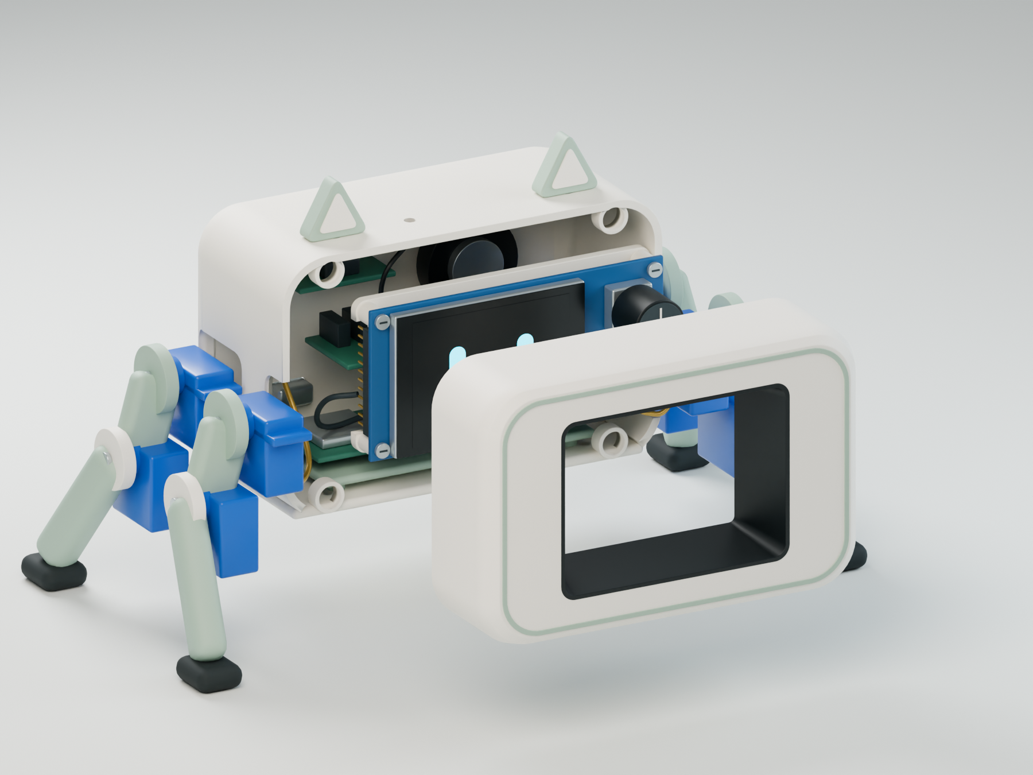
[picture p227: mechanical-design/assembly-v1/renders/front_open.png]
前盖拆开


05 · 前盖拆开第40帧；总成向前移动的展示姿态

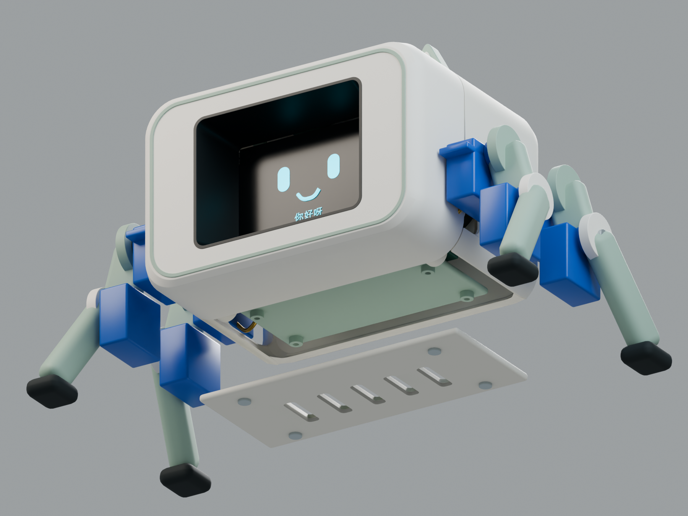
[picture p228: mechanical-design/assembly-v1/renders/bottom_open.png]
底盖拆开


06 · 底盖拆开第70帧；紧固与维修顺序待深化

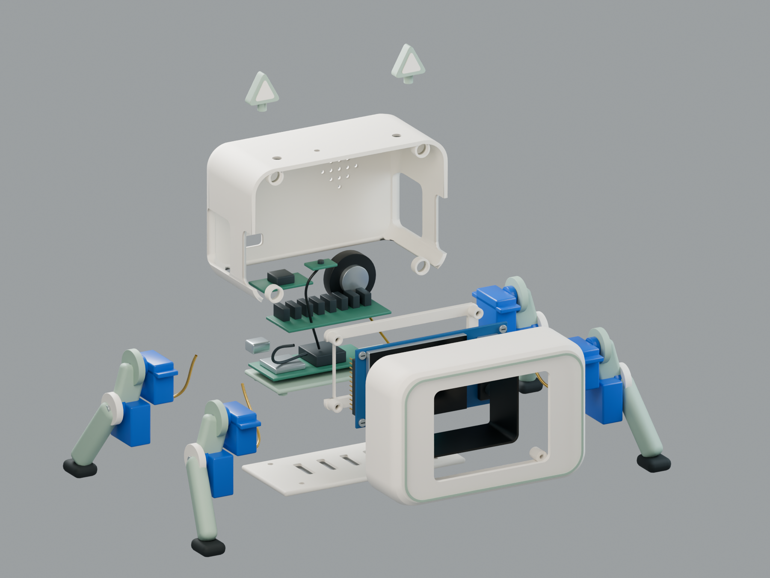
[picture p229: mechanical-design/assembly-v1/renders/exploded.png]
分件爆炸图


07 · 分件爆炸图第100帧；不代表生产装配顺序

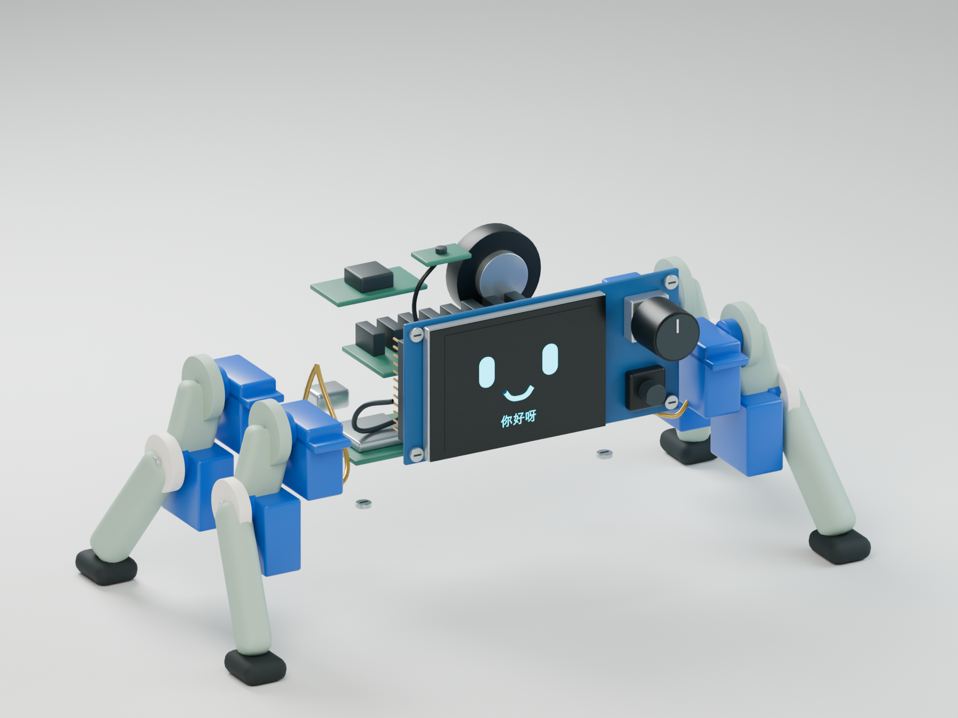
[picture p230: mechanical-design/assembly-v1/renders/layout.png]
内部空间


08 · 内部空间电子和舵机均含未选型的占位模型

这些图片均从本包的三维模型渲染。尺寸含设计假设；舵机连接、紧固、公差与运动尚未完成。当前为设计评审包，不是直接打印发布文件。
