xaiojie/papabot/hardware-selection/battery-stock-2026-09-09/power-wiring.png

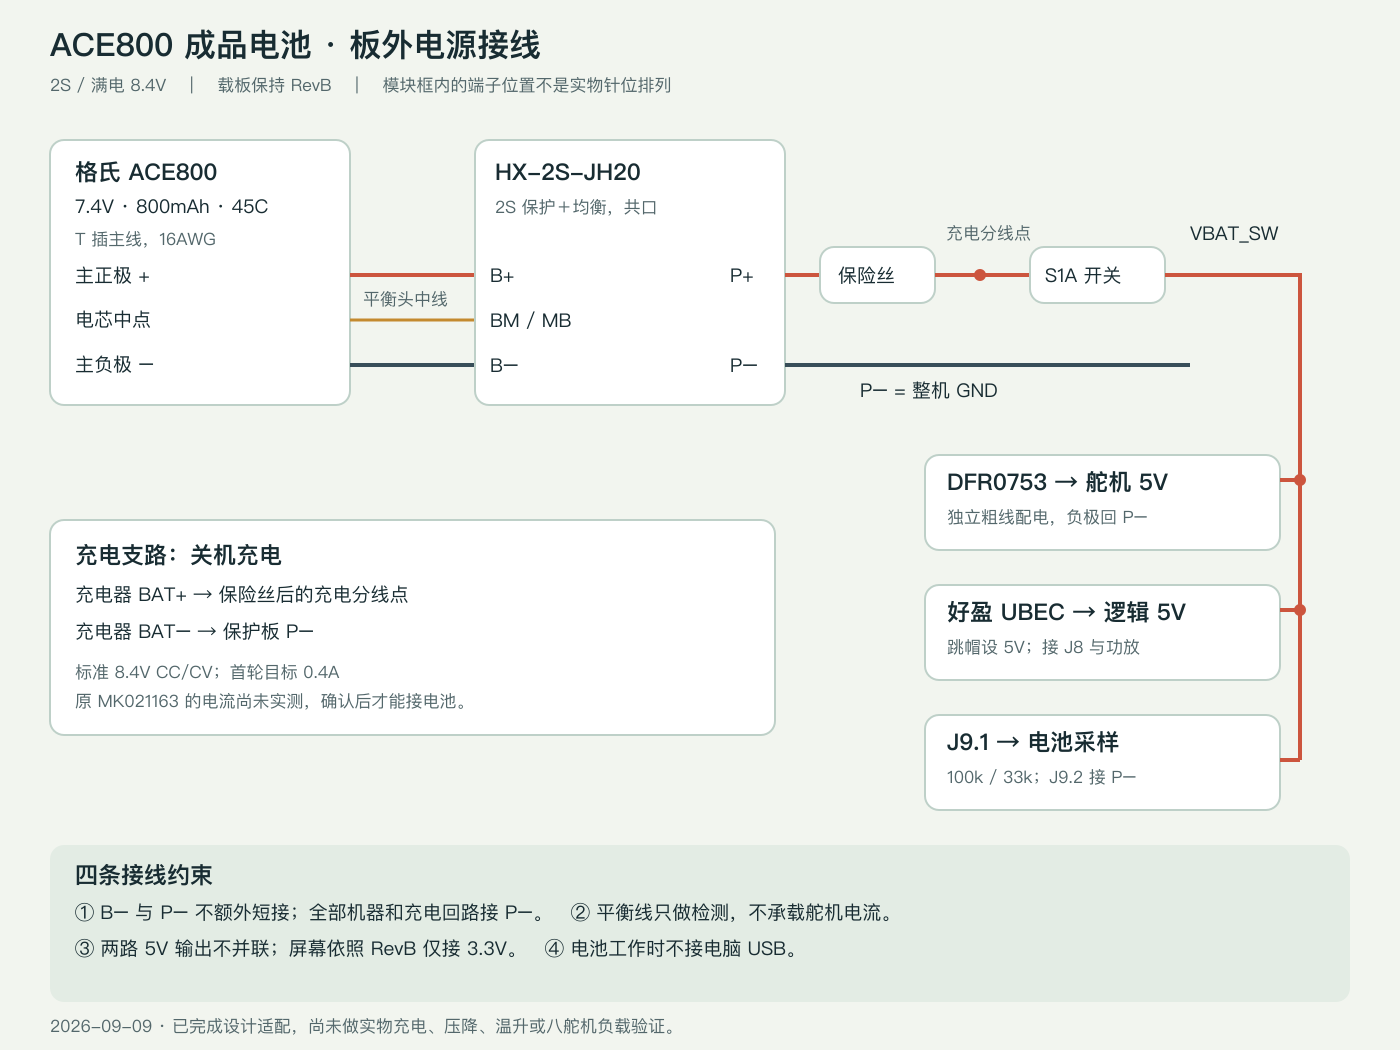
hardware-selection/battery-stock-2026-09-09/power-wiring.png
