xaiojie/papabot/mechanical-design/assembly-v1/previews/hero-preview.png

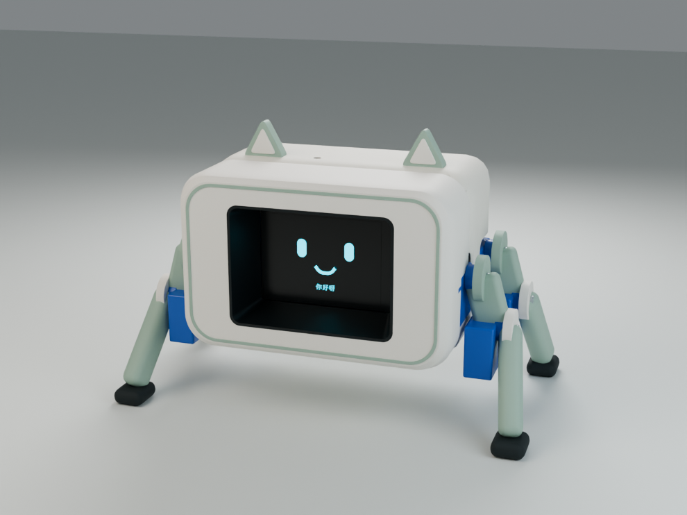
mechanical-design/assembly-v1/previews/hero-preview.png
