xaiojie/papabot/mechanical-design/print-v2/renders/structure-a1-front.png

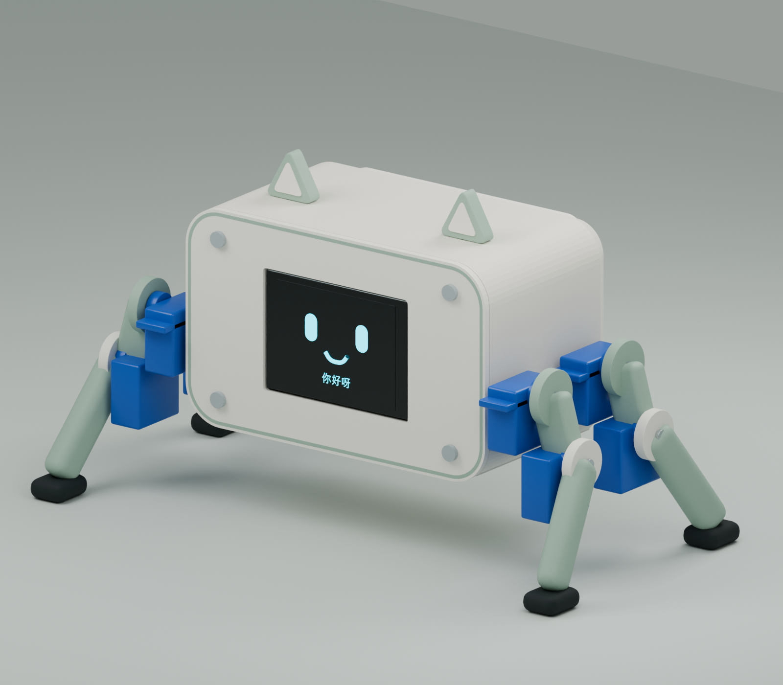
mechanical-design/print-v2/renders/structure-a1-front.png
