xaiojie/papabot/mechanical-design/print-v2/renders/structure-a1-internal-study.png

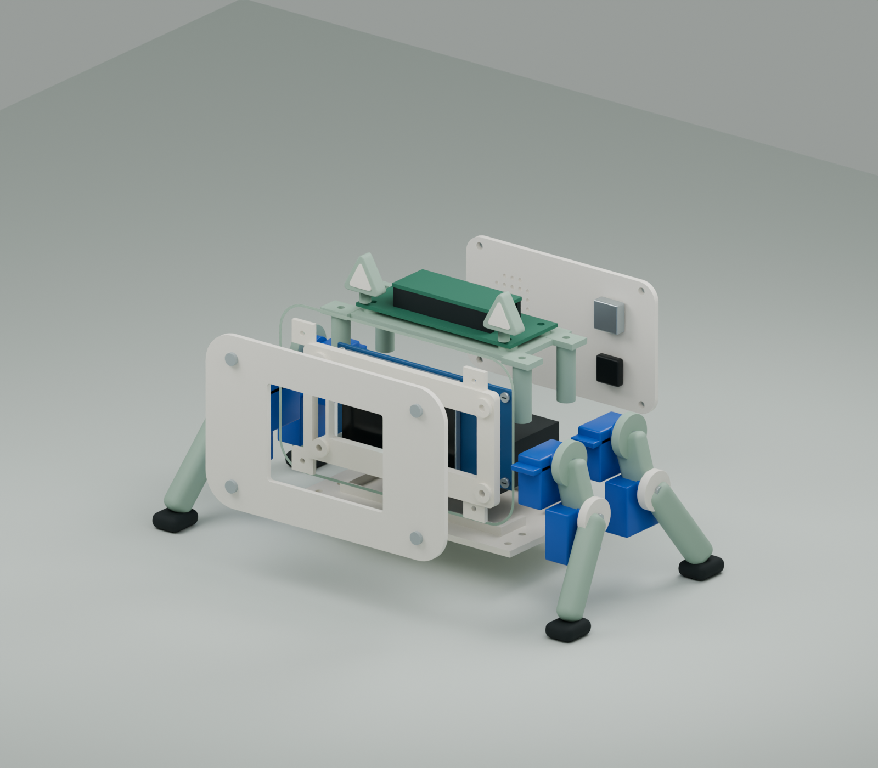
mechanical-design/print-v2/renders/structure-a1-internal-study.png
