xaiojie/papabot/mechanical-design/print-v2/renders/structure-a1-rear.png

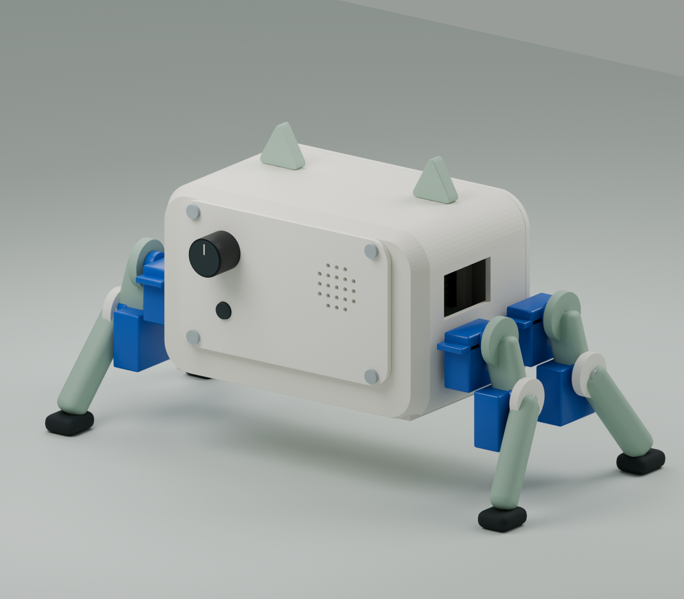
mechanical-design/print-v2/renders/structure-a1-rear.png
