xaiojie/papabot/docs/superpowers/plans/2026-09-09-development-bringup.md

# 开发测试接线与固件实施记录

用户已授权执行接线图和测试程序两项。日期：2026-09-09。

## 范围

- 主控：立创 ESP32S3R8N8，8 MB Flash / 8 MB OPI PSRAM，电脑 USB 供电，CH340 UART0 控制台。
- 屏幕：TOUGLESY 2.4 寸 ST7789 + EC11，3.3 V 外部稳压供电，12 针与 RevB 一致；旋钮/按键保留在原板。
- 舵机：1 个 MG90S，外部 5 V 供电，GPIO18 临时直接 PWM。与最终 PCA9685 接法分开。
- 先主控，再屏幕与控件，再单舵机。按单通道可调电源分别测试，不假定电源通道数或实测电流。
- 不改 PCB/机械，不采购、不烧录硬件；完成本机编译和可运行的行为测试，实机结果留空。

## 实现方案

独立工程 `firmware/bringup`，PlatformIO espressif32 6.12.0 / Arduino-ESP32 2.0.17；Adafruit ST7789 驱动与商家示例一致。引脚 JSON 生成固件头文件、CSV、接线 SVG，核对 RevB 的原始接口表。固件通过串口命令选择被动、屏幕或单舵机模式，默认不初始化屏幕、不输出舵机 PWM。舵机显式启用后只允许 1400–1600 μs，后续变化限速，10 秒无有效控制命令停止输出；这不切断舵机电源。

## 执行清单

- [x] 建立接线数据、工程配置、隔离工具链。
- [x] 先运行能失败的限幅/超时/消抖/编码器/命令测试，再实现对应逻辑。
- [x] 接入主控自检、显示/控件和单舵机驱动，完成 ESP32-S3 交叉编译。
- [x] 生成三阶段接线资料、焊接位置说明、烧录步骤和待填实测记录。
- [x] 检查图表渲染与引脚一致性，打包源码、编译产物和验证记录。

## 完成条件

固件实际交叉编译成功；主机行为测试通过；图表可读；源数据与当前 RevB 屏幕接口相同；烧录包地址来自本次构建工具，不猜测；报告明确没有实机验证，编译通过不代表屏幕负载、方向、针序或舵机行程已确认。

完成：ESP32-S3编译通过，11组/196项主机测试通过；39文件交付包CRC与SHA通过，独立解压后凭参考快照再生接线资料一致。尚未执行任何实机测试。
