xaiojie/papabot/firmware/bringup/docs/三件套接线-文字版.md

# 三个模块怎么接线（文字版）

一共 14 根线。分 4 组接，一组一组来，不要一次全插。

---

# 先认识三个模块

## 模块 ①　HW-793 电源模块

板子右边有 **3 组排针**，每组 2 排（上排 + 下排）：

```
蓝色排针  →  上排 = 3.3V    下排 = GND      （本次不用）
红色排针  →  上排 = 5V      下排 = GND      ← 用这个
黄色排针  →  上排 = 可调    下排 = GND      （本次不用）
```

左边红色端子 + DC 座 = 电源输入（二选一，插 DC 头就行）

**本次只从红色排针取 2 根线：上排的 5V、下排的 GND。**

---

## 模块 ②　ESP32-S3 开发板

**摆放姿势很重要：**

```
        天线（金属蛇形）朝上
        ┌─────────────┐
   左列 │             │ 右列
   L1→  │   ESP32-S3  │  ←R1
        │             │
        │             │
   L20→ │             │  ←R20
        └─────────────┘
          USB 口朝下
```

**元件面朝上、天线朝上、USB 口朝下。**

- **左列 20 个孔**：从上往下数，第 1 个是 L1，最下面一个是 L20
- **右列 20 个孔**：从上往下数，第 1 个是 R1，最下面一个是 R20

**每个孔旁边都有丝印**（印着 GPIO 号或 3V3/GND/5V）。

---

## 模块 ③　12 针屏幕

模块**顶边**有一排 12 个针，丝印是：

```
GND  VCC  SCL  SDA  RES  DC  CS  BLK  A  B  PUSH  K0
 1    2    3    4    5    6   7   8   9  10   11   12
```

**从左往右数，第 1 个是 GND，第 12 个是 K0。**

---

# 第 1 组：给开发板供电（2 根线）

> ⚠️ 做这步之前，**USB 线必须先拔掉**

| 从（HW-793）| 到（开发板）|
|---|---|
| 红排针 **上排** | 右列第 17 个孔（丝印 **5V**）|
| 红排针 **下排** | 右列最下面那个孔（丝印 **GND**）|

**这两个孔挨得很近，都在右列最下面。**

---

# 第 2 组：给屏幕供电（3 根线）

| 从（开发板）| 到（屏幕）|
|---|---|
| 左列第 17 个（丝印 **3V3**）| 屏幕第 **2** 针（VCC）|
| 左列第 18 个（丝印 **3V3**）| 屏幕第 **8** 针（BLK）|
| 左列最下面（丝印 **GND**）| 屏幕第 **1** 针（GND）|

> 🔴 **重点：屏幕 2 针和 8 针都接 3.3V，不是 5V！**
> 接 5V 会烧坏屏幕（背光还亮，但永远黑屏）

---

# 第 3 组：SPI 信号（5 根线）

| 从（开发板）| 到（屏幕）|
|---|---|
| 左列第 13 个（丝印 **12**）| 屏幕第 **3** 针（SCL）|
| 左列第 12 个（丝印 **11**）| 屏幕第 **4** 针（SDA）|
| 右列第 10 个（丝印 **21**）| 屏幕第 **5** 针（RES）|
| 左列第 15 个（丝印 **14**）| 屏幕第 **6** 针（DC）|
| 左列第 14 个（丝印 **13**）| 屏幕第 **7** 针（CS）|

---

# 第 4 组：旋钮和按键（4 根线）

| 从（开发板）| 到（屏幕）|
|---|---|
| 左列第 8 个（丝印 **7**）| 屏幕第 **9** 针（A）|
| 左列第 2 个（丝印 **2**）| 屏幕第 **10** 针（B）|
| 右列第 13 个（丝印 **38**）| 屏幕第 **11** 针（PUSH）|
| 右列第 11 个（丝印 **40**）| 屏幕第 **12** 针（K0）|

---

# 全部 14 根线汇总（一张表）

| 序号 | 从哪 | 到哪 | 作用 |
|:--:|---|---|---|
| 1 | HW-793 红排针 **上排** | 开发板右列第 17 个（5V）| 供电 |
| 2 | HW-793 红排针 **下排** | 开发板右列最下面（GND）| 共地 |
| 3 | 开发板左列第 17 个（3V3）| 屏幕 2 针 VCC | **屏幕供电 3.3V** |
| 4 | 开发板左列第 18 个（3V3）| 屏幕 8 针 BLK | **背光 3.3V** |
| 5 | 开发板左列最下面（GND）| 屏幕 1 针 GND | 共地 |
| 6 | 开发板左列第 13 个（12）| 屏幕 3 针 SCL | SPI 时钟 |
| 7 | 开发板左列第 12 个（11）| 屏幕 4 针 SDA | SPI 数据 |
| 8 | 开发板右列第 10 个（21）| 屏幕 5 针 RES | 复位 |
| 9 | 开发板左列第 15 个（14）| 屏幕 6 针 DC | 数据/命令 |
| 10 | 开发板左列第 14 个（13）| 屏幕 7 针 CS | 片选 |
| 11 | 开发板左列第 8 个（7）| 屏幕 9 针 A | 旋钮 A |
| 12 | 开发板左列第 2 个（2）| 屏幕 10 针 B | 旋钮 B |
| 13 | 开发板右列第 13 个（38）| 屏幕 11 针 PUSH | 旋钮按压 |
| 14 | 开发板右列第 11 个（40）| 屏幕 12 针 K0 | 独立按键 |

---

# 接完先别通电，检查这 3 项

| # | 怎么查 | 正常 |
|:--:|---|---|
| 1 | 万用表**蜂鸣档**，量开发板的 3V3 ↔ GND | **不响**（响了说明短路，别通电）|
| 2 | 蜂鸣档量 5V ↔ GND | **不响** |
| 3 | 确认 **USB 线拔掉了** | 必须 |

**三项都过了，再插 DC 头通电。**

---

# 通电后量这一个数（最重要）

**万用表直流档，红笔戳屏幕第 2 针、黑笔戳屏幕第 1 针：**

| 量到 | 结论 | 怎么办 |
|---|---|---|
| **3.3V** | ✅ 供电正确 | 问题在 SPI 线或固件，接着查 |
| **5.0V** | ❌ **接错了！** | **立刻断电**，把屏幕 2 针改接到开发板 3V3 |
| **0V** | ❌ 没供上电 | 查第 3 根线通不通 |
| **2V 左右** | ⚠️ 带不动 | 屏幕改从 HW-793 蓝排针取 3.3V |

---

# 你的症状：「屏幕亮但没画面」

```
背光还亮   →  说明第 4 根线（BLK）接对了、有电
但没画面   →  说明 ST7789 控制器没工作
```

**最可能的两个原因：**

1. **屏幕 2 针接到了 5V** → 控制器过压（ST7789 最大只能 4.6V）
2. **某根 SPI 线接错了或没插紧**

**先量那个 3.3V。量出来是 5V 的话，原因就找到了。**
