xaiojie/papabot/firmware/bringup/docs/屏幕接线速查.md

# 屏幕模块 → 开发板 接线速查（台面调试用）

> 用途：屏幕到货后，**不上载板**，直接用杜邦线连开发板，先跑通显示与输入
> 依据：`pcb-design/native-rev-b/装配与上电核对.md`、`firmware/assistant/include/config.h`

---

## 一、屏幕 12 针 → 开发板

| 模块针号 | 模块丝印 | 接到 | 说明 |
|---|---|---|---|
| 1 | `GND` | **GND** | 共地 |
| 2 | `VCC` | **3V3** | ⚠️ 用 3.3V，别接 5V |
| 3 | `SCL` | **GPIO12** | SPI 时钟 |
| 4 | `SDA` | **GPIO11** | ⚠️ **不是 I2C 数据，是 SPI MOSI** |
| 5 | `RES` | **GPIO21** | 复位 |
| 6 | `DC` | **GPIO14** | 数据/命令 |
| 7 | `CS` | **GPIO13** | 片选 |
| 8 | `BLK` | **3V3** | 背光常亮（本方案不做调光）|
| 9 | `A` | **GPIO7** | 旋钮 A 相 |
| 10 | `B` | **GPIO2** | 旋钮 B 相 |
| 11 | `PUSH` | **GPIO38** | 旋钮按压，**按下为低** |
| 12 | `K0` | **GPIO40** | 独立按键，**按下为低** |

这 12 个脚和固件 `config.h` 里已定义的一致，直接能用。

---

## 二、🔴 三条必读

### ① 不买"12P 同序排线"直接插

仓库文档明确写了：

> 本载板的 J3+J7 拆分接口**不能直接套用一根同序 12 针排线**

模块丝印顺序和我们的 GPIO 分配**不是一一对应**的，必须**逐根接**。

### ② `SDA` 不是 I2C

模块第 4 针丝印写 `SDA`，容易以为要接 I2C。**它是 SPI 的 MOSI（数据输出）**，接 GPIO11。

### ③ 别一根一根现插现试

**先把 12 根线全部接好、用万用表通断档每根确认一遍，再上电。**

理由：屏幕 SPI 接错不一定立刻坏，但会花屏/白屏，那时候你分不清是**接错**还是**固件问题**。

---

## 三、上电顺序建议

```
1. 断电状态下接好 12 根线
2. 万用表逐根确认通断（尤其 GND 和 3V3 没有短路）
3. 上电，先只烧 bench-v1，跑屏幕自检（颜色条 / 旋转 / 反色）
4. 确认屏幕正常后，再烧 assistant 固件
```

> **先跑 bench-v1 是有意的**：它是专门做硬件自检的，能单独验证屏幕，不和产品逻辑混在一起。
> 屏幕正常了再上 assistant，出问题时可归因。

---

## 四、以后要接的（先记着，现在别接）

### 麦克风（Sipeed I2S_Mic / MSM261S4030H0）

| 模块脚 | 接到 |
|---|---|
| GND | GND |
| VCC | 3V3 |
| SCK | **GPIO4**（MIC_BCLK）|
| WS | **GPIO5**（MIC_WS）|
| SD | **GPIO6**（MIC_SD）|
| LR | **GND** ← 选左声道 |

⚠️ 麦克风**必须单独用一路 I2S**，不能和屏幕/功放共用。

### 功放（MAX98357A）

| 模块脚 | 接到 |
|---|---|
| GND | GND |
| BCLK | **GPIO15**（AMP_BCLK = R5）|
| LRC | **GPIO16**（AMP_WS = R6）|
| DIN | **GPIO17**（AMP_DIN = R7）|
| Vin | **5V**（独立短粗线）|
| SD_MODE | ⚠️ **保持模块原配置，禁止接 GPIO 或上拉** |

> ⚠️ **2026-09-11 修正**：原文档此处把 BCLK/LRC 写成了 GPIO16/GPIO15（写反）。
> 以 `firmware/assistant/docs/语音指令与语音包设计.md`（`AMP_BCLK = R5`）
> 和 `pcb-design/rev-a/01-controller-pinout.csv`（`R5=GPIO15, R6=GPIO16`）为准。

⚠️ 功放 5V **走独立短粗线**，不从开发板细针取电。喇叭接 `SPK_P`/`SPK_N`，**两端都不接地**。

---

## 五、接线自检清单

焊完 / 接完以后逐条打勾：

- [ ] 12 根线全部接好，没有一根悬空
- [ ] 万用表确认 **3V3 与 GND 不短路**
- [ ] `VCC` 和 `BLK` 都接的是 **3.3V**（不是 5V）
- [ ] `SDA` 接的是 GPIO11（当成 MOSI 用）
- [ ] 排针焊接方向：**长针朝屏幕背面**，线从背后走
- [ ] 逐个脚确认**不虚焊、不连锡**（相邻脚最容易连）
- [ ] 上电后屏幕**先跑 bench-v1** 验证

---

## 六、如果屏幕不正常，按这个顺序排查

| 现象 | 先查 |
|---|---|
| **整屏纯白，但串口还是 `mode=PASSIVE`** | **屏没被初始化过** —— 这是预期状态，发 `screen start` |
| 全黑，背光也不亮 | `BLK` 有没有接 3V3；`VCC` 有没有电 |
| 背光亮但全白（且已 `screen start`） | `SCLK` / `MOSI` / `CS` / `DC` 四根；`RES` |
| 花屏 / 颜色不对 | 旋转和反色设置；`MOSI` 和 `SCLK` 有没有接反 |
| 旋钮不灵 / 跳步 | `A` / `B` 两根有没有接反或虚焊 |
| 按键没反应 | `PUSH`(GPIO38) / `K0`(GPIO40)，确认按下为低 |
