xaiojie/papabot/firmware/bringup/docs/验证记录.md

# bench-v1 验证记录

日期：2026-09-09 建立。**2026-09-10 更新：主控已到货并通过实机自检；屏幕与舵机仍未测。**

## 实机验证：主控（2026-09-10）

主控 LCKFB-ESP32S3R8N8 已实测。逐项实测值见[实机验收记录](实机验收记录.csv)。

| 项目 | 实测结果 | 依据 |
|---|---|---|
| 芯片/板卡 | ESP32-S3 rev0，2 核 240 MHz，8MB Flash + 8MB PSRAM | esptool `flash_id` 与 `selftest` |
| Flash | PASS 8388608 字节 | `selftest` |
| PSRAM | PASS：堆管理总量 8386295（容差内），64KiB 样本写入/回读/取反回读 PASS | `selftest` |
| Wi-Fi / RF 通路 | 扫描到 12 个网络（含 3 个隐藏），RSSI −55…−89 dBm；收到的 2.4GHz 信道集合 {1,5,6,7,13} 与同一位置 Mac 完全一致，且条目多于 Mac 列出的 7 个 | `wifi scan` |
| Wi-Fi 连接与联网 | 关联成功（ch7、RSSI −68 dBm、DHCP 得到 192.168.1.93）；DNS 10 ms、TCP:80 22 ms、HTTP `200 OK` 40 ms | `wifi connect` + `net test` |
| LED | 绿 LED（GPIO48，低有效，经 R25 15k）每秒短闪；红 LED（PWR）常亮 | 目视与厂家原理图核对 |
| BOOT 按键 | 按 3 次计 3 次，无抖动重复；RST 后计数与 uptime 均归零 | 串口日志 |
| 上电默认状态 | `PASSIVE`，PWM 关闭，未初始化屏幕 | `status` |

**控制台改走原生 USB，不走 CH340。** CH340（`1A86:7523`）在 USB 总线上枚举成功，但 macOS 不带 CH34x 驱动，因此没有生成 `/dev` 节点；`kextstat` 中无任何 CH34x/WCH 驱动。实测改用板载 USB-Serial/JTAG（`303A:1001` → `/dev/cu.usbmodem*`），**无需安装驱动**，烧录（`Hash of data verified`）与双向串口均通过。该板一个 Type-C 口经 WCH USB HUB 同时接出 CH340 与原生 USB 两路，与厂家原理图一致。

为此新增编译环境 `lckfb_s3_usbjtag`：`ARDUINO_USB_MODE=1` + `ARDUINO_USB_CDC_ON_BOOT=1`，使 `Serial` 指向 USB-Serial/JTAG。该环境**故意不挂 `export_firmware.py`**，不会覆盖默认环境已验证的交付镜像；实测确认 `artifacts/firmware/` 逐字节未变。

已知限制：按 RST 时 USB 会重新枚举，开机横幅早于端口重新打开，**该控制台抓不到开机提示**（UART 控制台无此问题）。改用 `status` 的 `uptime_ms` 判断是否刚复位。

### 本次修复：PSRAM 严格相等判定

实机首次运行报 `FAIL PSRAM: 8386295 bytes, expected 8388608`。查 Arduino-ESP32 `cores/esp32/ESP.cpp` 确认：

```cpp
uint32_t EspClass::getPsramSize(void) {
  if(psramFound()){
    multi_heap_info_t info;
    heap_caps_get_info(&info, MALLOC_CAP_SPIRAM);
    return info.total_free_bytes + info.total_allocated_bytes;  // 堆管理总量，非裸容量
  }
  return 0;
}
```

它返回的是**堆分配器管理的 PSRAM 总量**，比物理容量少一块保留区，因此与标称值做 `==` 在健康硬件上必然失败。这是一处**固件判定缺陷，不是硬件缺陷**：esptool 报 `Embedded PSRAM 8MB`，64KiB 样本测试 PASS，`largest_block=8257524`（与真实 8MB 器件相符）。

修复：新增纯函数 `withinMemoryTolerance()`（`include/control_logic.h`），`selftest` 改用容差判定并打印 PSRAM 堆拆分；`status` 的 `PSRAM=` 标签改为 `PSRAM_heap=` 以免再次误读。该策略已加入主机测试。

### Wi-Fi 连接：凭据处理与实测边界

`wifi connect <SSID> <密码>` 是可选的一次性联通测试，不是最终产品的配网方案。设计约束如下：

- **只存 RAM，绝不写 flash。** Arduino-ESP32 的 `WiFiGenericClass::_persistent` 默认是 `true`，直接 `WiFi.begin()` 会把口令提交到 NVS。固件在连接前显式调用 `WiFi.persistent(false)`。
- **实测验证**：连接成功后用 esptool 读出 NVS 分区（0x9000、20 KiB）逐字节检查，`stkj` 口令、SSID 的 UTF-8 字节、以及 `sta.ssid`/`sta.pswd`/`sta.config` 三个键**均不存在**；分区 89% 为 `0xFF`，`nvs.net80211` 中只有 SDK 默认的 `WIFI_STA_DEF`、`cal_data`、`phy`、`dhcp_state` 等条目。
- **复位即失效**：硬复位后 `wifi status` 返回未连接（status=255），RAM 中的凭据随之下线。
- **不回显**：口令从不回显、不进入 `status`，`stop`/`!` 会连同 Wi-Fi 一起关闭射频。
- 口令上限受 96 字节命令行长度限制；SSID 支持 UTF-8（为此把行缓冲的非 ASCII 过滤去掉，只保留控制字符过滤），并有主机测试覆盖。

以上仅为一次联通性验证，**不代表语音/联网应用固件已完成**。

## 已完成的验证（本机，2026-09-10 前）

| 项目 | 结果 | 依据 |
|---|---|---|
| ESP32-S3 交叉编译 | 通过 | `../build.log` 的 `[SUCCESS]` |
| 编译器 | Xtensa ESP32-S3 GCC 8.4.0 | PlatformIO构建日志 |
| 框架 | Arduino-ESP32 2.0.17 / `3.20017.241212+sha.dcc1105b` | 固定依赖与构建日志 |
| 8MB Flash / OPI PSRAM配置 | 已核对实际编译参数 | `../artifacts/compile-config-check.json`，含`qio_opi/include`与`BOARD_HAS_PSRAM` |
| 串口控制台 | 默认环境 UART0/CDC-on-boot=0；另增 USB-Serial/JTAG 环境 | 同上；两个环境均可编译，实机走 USB-Serial/JTAG |
| 屏幕12针、GPIO及物理位置 | 与RevB接口及主控位置资料一致 | 生成器每次编译前校验；参考快照在`reference` |
| 主机行为测试 | 12组、203项断言通过 | `../test/host-test-results.txt`，开启AddressSanitizer与UndefinedBehaviorSanitizer |
| 固件、bootloader镜像 | esptool镜像校验及内嵌SHA通过 | `../artifacts/image-info.txt`与`bootloader-info.txt` |
| 分区表/烧录地址 | 由构建工具导出并解析 | `../artifacts/firmware/flash-manifest.json`与`partition-layout.csv` |
| 页面预览 | 已在Codex浏览器检查图示和文字 | 三页签显示、Home键切换、接线表点击对应SVG高亮 |
| 工具链全量重建 | 清空构建目录后从零编译通过（9.3s） | 2026-09-10 `bash scripts/pio.sh run --target clean` 后重建，`[SUCCESS]` |
| 通电前自检向导 | 全通过 exit 0、门禁失败 exit 1，两条路径实测 | `../scripts/preflight_check.py`；失败时输出处置办法并可用 `--from` 续跑 |
| 自检向导记录落位 | 14 项记录逐项写入日志，顺序正确 | 预演与交互各跑一遍，见 `scripts/preflight_check.py --rehearse` |

基础板配置的显示名称带“No PSRAM”，是PlatformIO原始DevKitC-1-N8名称。本工程覆盖成`qio_opi`，已从实际编译命令核对，而不是把默认板名当作实测结果。板上 8MB PSRAM 已于 2026-09-10 由实机 `selftest` 确认。

本次固件链接使用RAM 44,600 bytes，应用程序709,441 bytes；应用分区3,342,336 bytes，约21.2%。这是静态链接占用，不是Wi-Fi运行时峰值内存。最终镜像的字节数和SHA以flash-manifest为准。

12组行为测试覆盖：按钮抖动、启动时长按与计时回绕、编码器正反计数与非法跃迁、舵机必须启用、脉宽范围、变化限速、无效命令不续时、有效命令/到期边界、超时回绕、严格命令解析、超长串口输入整行丢弃，以及内存容量容差判定（含真实实测值 8386295 必须通过、4MB 器件必须失败的边界）。先对未实现的保守框架运行得到34项失败，再实现逻辑并通过测试。它们没有模拟出真实电压、电流、PWM波形或机械动作。

## 烧录文件

| 文件 | 地址 |
|---|---|
| bootloader.bin | 0x0000 |
| partitions.bin | 0x8000 |
| boot_app0.bin | 0xE000 |
| firmware.bin | 0x10000 |

这些地址来自本次PlatformIO构建，不是手工猜测。建议让PlatformIO按工程设置烧录全部配套文件。2026-09-10 已对 USB-JTAG 环境执行一次 `upload`（未执行 `erase_flash`），烧录后 esptool 报告 `Hash of data verified`。

打包脚本会比对当前源码与编译时SHA、四个镜像SHA，再校验ZIP CRC和每个文件。包内有`SHA256SUMS.txt`，外部有`dist/package-validation.json`。程序源码有变化时，脚本会要求重新编译。

## 仍需验证

主控的芯片、存储器、Wi-Fi、LED 与按键已于 2026-09-10 实测通过。以下仍未测：

- **屏幕**：实物 12 针朝向与焊点、外部 3.3V 供电、全亮/刷新电流、色条与方向/反色、EC11 每格计数、PUSH/KEY0 计数。
- **舵机**：5V 电源能力与限流、实物 S/正/负 针序、1500μs 首次中位、1000–2000μs 空载动作（两路）、启动电流与压降。
- **整机**：8 舵机同时负载、屏幕/语音/Wi-Fi 并发、温升、PCB 打样与机械配合、步态与声学。

自检向导只验证“流程能不能走完、门禁会不会拦住”，它本身不测任何电气量。`--rehearse` 的输出是步骤清单，**不是实测结果**。

USB与外部供电的受控时序必须按接线说明执行；软件不提供未供电器件的硬件隔离。单舵机超时仅停发PWM，不切断5V。以上结果不是PCB打样、整机负载或机械配合的批准。
