xaiojie/papabot/firmware/bringup/docs/实机验收记录.csv

阶段 | 项目 | 期望/填写说明 | 实测结果 | 状态 | 日期 | 备注
主控 | 实际型号/板卡版本 | 与立创ESP32S3R8N8资料一致 | LCKFB-ESP32S3R8N8；ESP32-S3 rev0，8MB Flash + 8MB PSRAM | 通过 | 2026-09-10 | esptool 读出 Embedded PSRAM 8MB / Flash 8MB，R8 变体确认
主控 | 电脑串口路径 | 记录实际CH340串口 | /dev/cu.usbmodem11401（ESP32-S3 原生 USB-Serial/JTAG） | 改用原生USB | 2026-09-10 | CH340(1A86:7523)已枚举但 macOS 无 CH34x 驱动，未生成 /dev 节点；改走板载 USB-Serial/JTAG，无需装驱动
主控 | 芯片/Flash/PSRAM | ESP32-S3 / 8MB / 8MB | ESP32-S3 rev0 / Flash 8388608 / PSRAM 堆 8386295 | 通过 | 2026-09-10 | getPsramSize() 返回堆管理总量而非裸容量，差 2313B；已改为容差判定并打印堆拆分
主控 | 64KiB PSRAM样本测试 | PASS | PASS（写入→回读→取反回读） | 通过 | 2026-09-10 | largest_block=8257524，与真实 8MB 器件一致
主控 | LED/BOOT按压 | LED短闪；按一次计数一次 | 绿 LED(GPIO48) 每秒短闪；红 LED(PWR) 常亮；BOOT 按 3 次计 3 次，RST 后计数归零 | 通过 | 2026-09-10 | GPIO48 低有效经 R25 15k；RST 后 uptime 与 BOOT 计数均归零
主控 | Wi-Fi扫描 | 记录数量；不以0个单独判定故障 | 12 个网络（含 3 个隐藏）；RSSI -55…-89 dBm；2.4GHz 信道 {1,5,6,7,13} | 通过 | 2026-09-10 | 收到的 2.4GHz 信道集合与同一位置 Mac 完全一致，且条目多于 Mac 列出的 7 个；最强 -55 dBm。扫描后自动关闭 Wi-Fi，未保存任何凭据
主控 | Wi-Fi连接与联网 | 连接后能解析DNS并访问外网 | 连接成功：ch7、RSSI −68 dBm、DHCP 得到 192.168.1.93；DNS→153.3.238.28(10ms)、TCP:80(22ms)、HTTP 200 OK(40ms) | 通过 | 2026-09-10 | SSID 为 UTF-8 中文名，验证了行缓冲的 UTF-8 通路（网络名按要求不写入文件）。凭据仅存 RAM：已读 NVS 分区确认无 sta.ssid/sta.pswd，复位后 wifi status 为未连接
屏幕 | 实物12针方向/焊点 | 按丝印逐根核对，无连锡 |  | 待实测
屏幕 | 外部空载/模块端VCC、BLK | 3.3V稳压；记录实际值 |  | 待实测
屏幕 | 全亮电流/刷新电流 | 未知；测得后填写 |  | 待实测
屏幕 | 色条/白边/方向 | 红绿蓝白正确、无裁切或镜像 |  | 待实测
屏幕 | 最终rotation/invert | 默认3/1，按实物选定 |  | 待实测
屏幕 | 编码器转10格/反转10格 | 记录divisor 2或4与方向，无多跳 |  | 待实测
屏幕 | PUSH/KEY0按压 | 各按10次计数10次；长按不重复 |  | 待实测
屏幕 | 受控上/下电 | USB先上后断，屏幕后上先断 |  | 待实测
舵机 | 电源5V输出能力/限流 | 记录实测电压、可用电流、设置 |  | 待实测
舵机 | 实物S/正/负针序 | 按实际插头定义确认 |  | 待实测
舵机 | 1500us首次中位 | 卸舵盘/腿，记录方向与是否异常 |  | 待实测
舵机 | 1450/1550/1500us空载 | 动作平稳，无持续堵转/异常发热 |  | 待实测
舵机 | 10秒超时/stop | PWM停止；注意电源仍接通 |  | 待实测
舵机 | 启动电流/压降 | 记录实际值；不等同8舵机负载 |  | 待实测
