xaiojie/papabot/firmware/bringup/docs/麦克风6针接线表.csv

模块针号 | 模块丝印 | 接到哪里 | 开发板位置 | 用途
1 | SCK | GPIO4 | L4 | I2S信号
2 | WS | GPIO5 | L5 | I2S信号
3 | SD | GPIO6 | L6 | I2S信号
4 | VDD | 开发板 3V3 (L17 / L18 / L19) | L17 | 3.3V供电
5 | GND | 公共 GND | L7 | 共地
6 | L/R | 公共 GND（选左声道，不可悬空） | L7 | 共地
