xaiojie/papabot/firmware/bringup/docs/assistant-ui-clock-weather.png

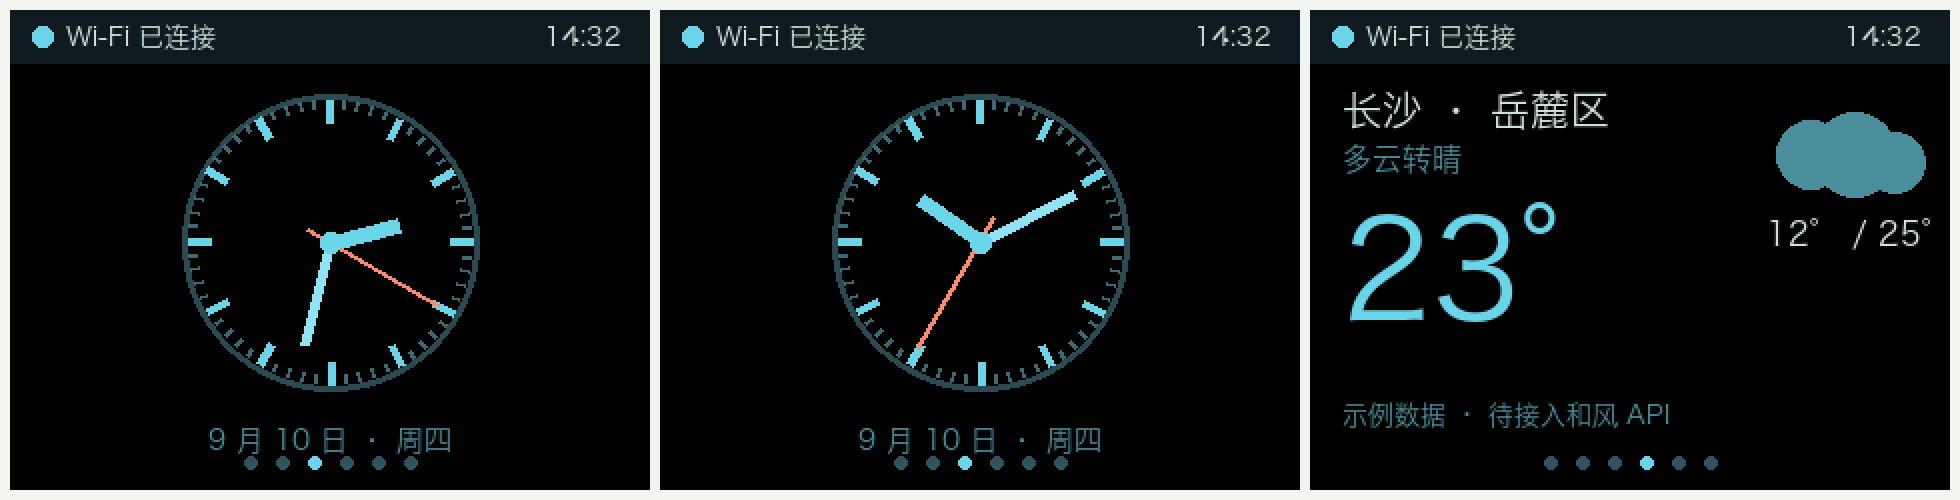
firmware/bringup/docs/assistant-ui-clock-weather.png
