xaiojie/papabot/firmware/bringup/docs/assistant-ui-face-moods.png

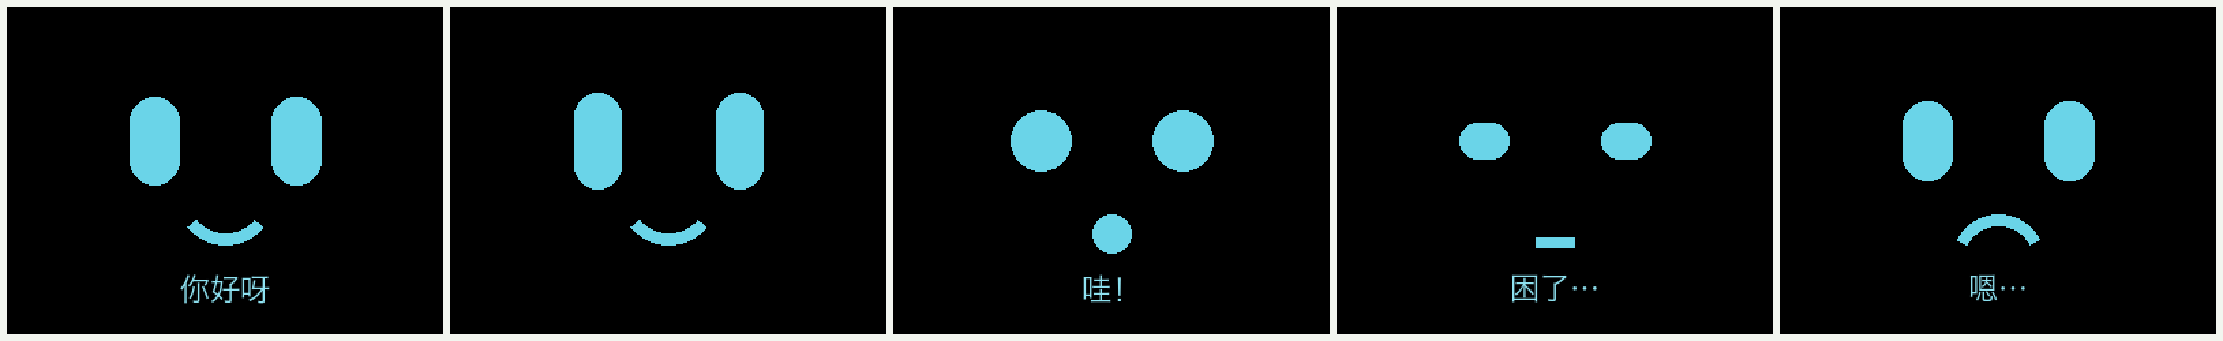
firmware/bringup/docs/assistant-ui-face-moods.png
