xaiojie/papabot/firmware/bringup/docs/cjk-render-proof.png

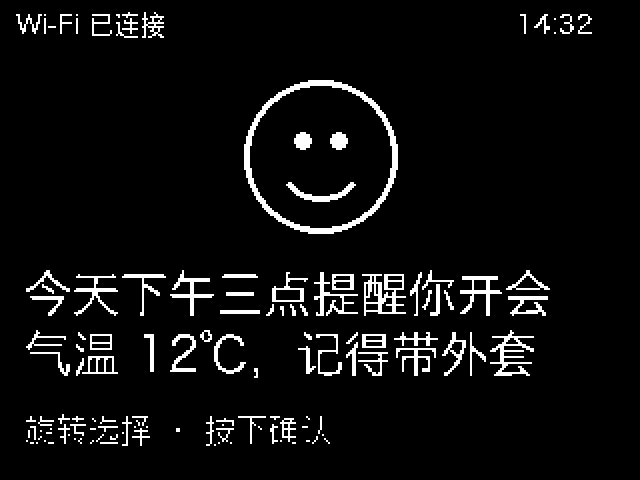
firmware/bringup/docs/cjk-render-proof.png
