xaiojie/papabot/firmware/bringup/docs/screen-simulator-reference.png

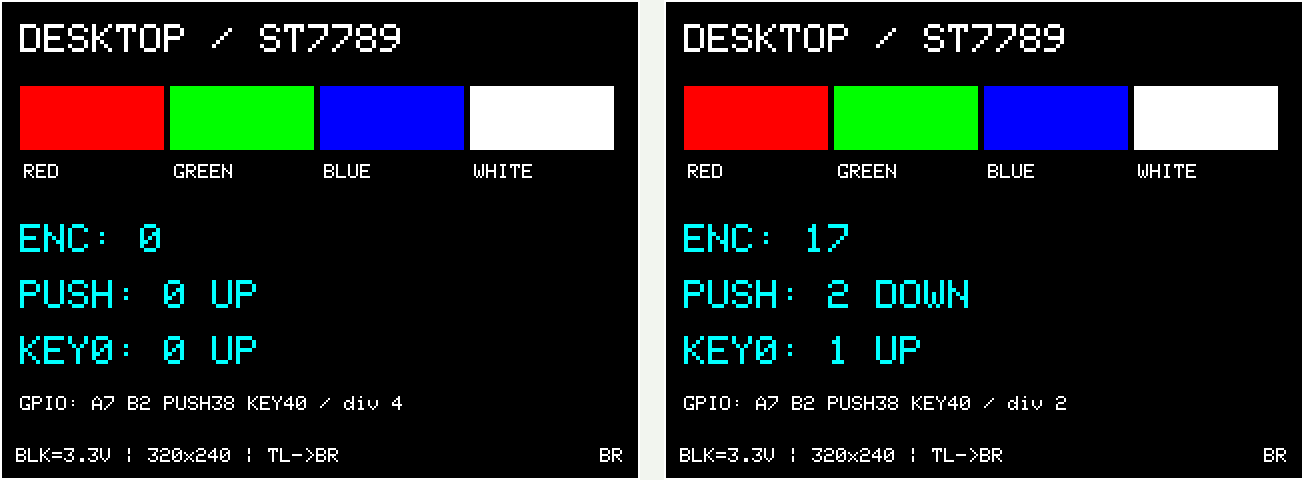
firmware/bringup/docs/screen-simulator-reference.png
