xaiojie/papabot/firmware/bringup/docs/三件套接线与排障.png

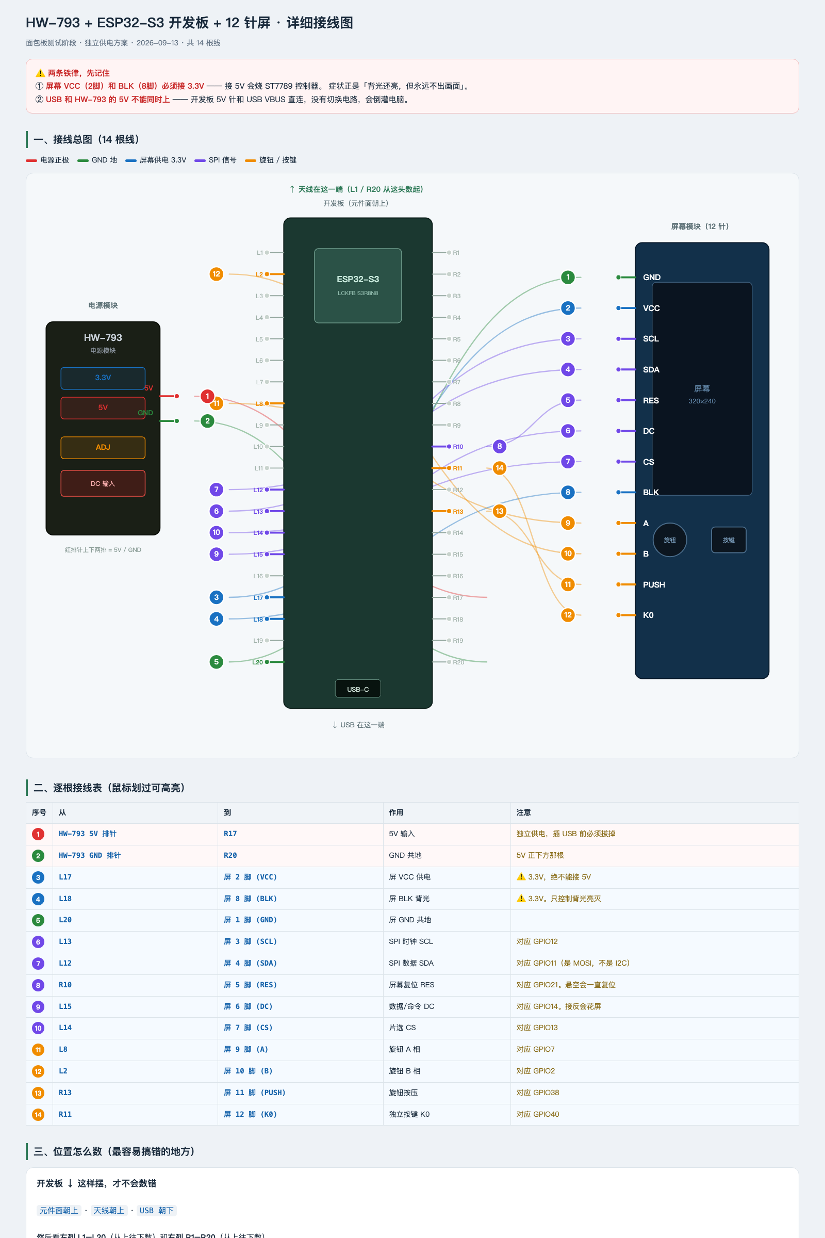
firmware/bringup/docs/三件套接线与排障.png
