xaiojie/papabot/firmware/bringup/docs/供电接线图.png

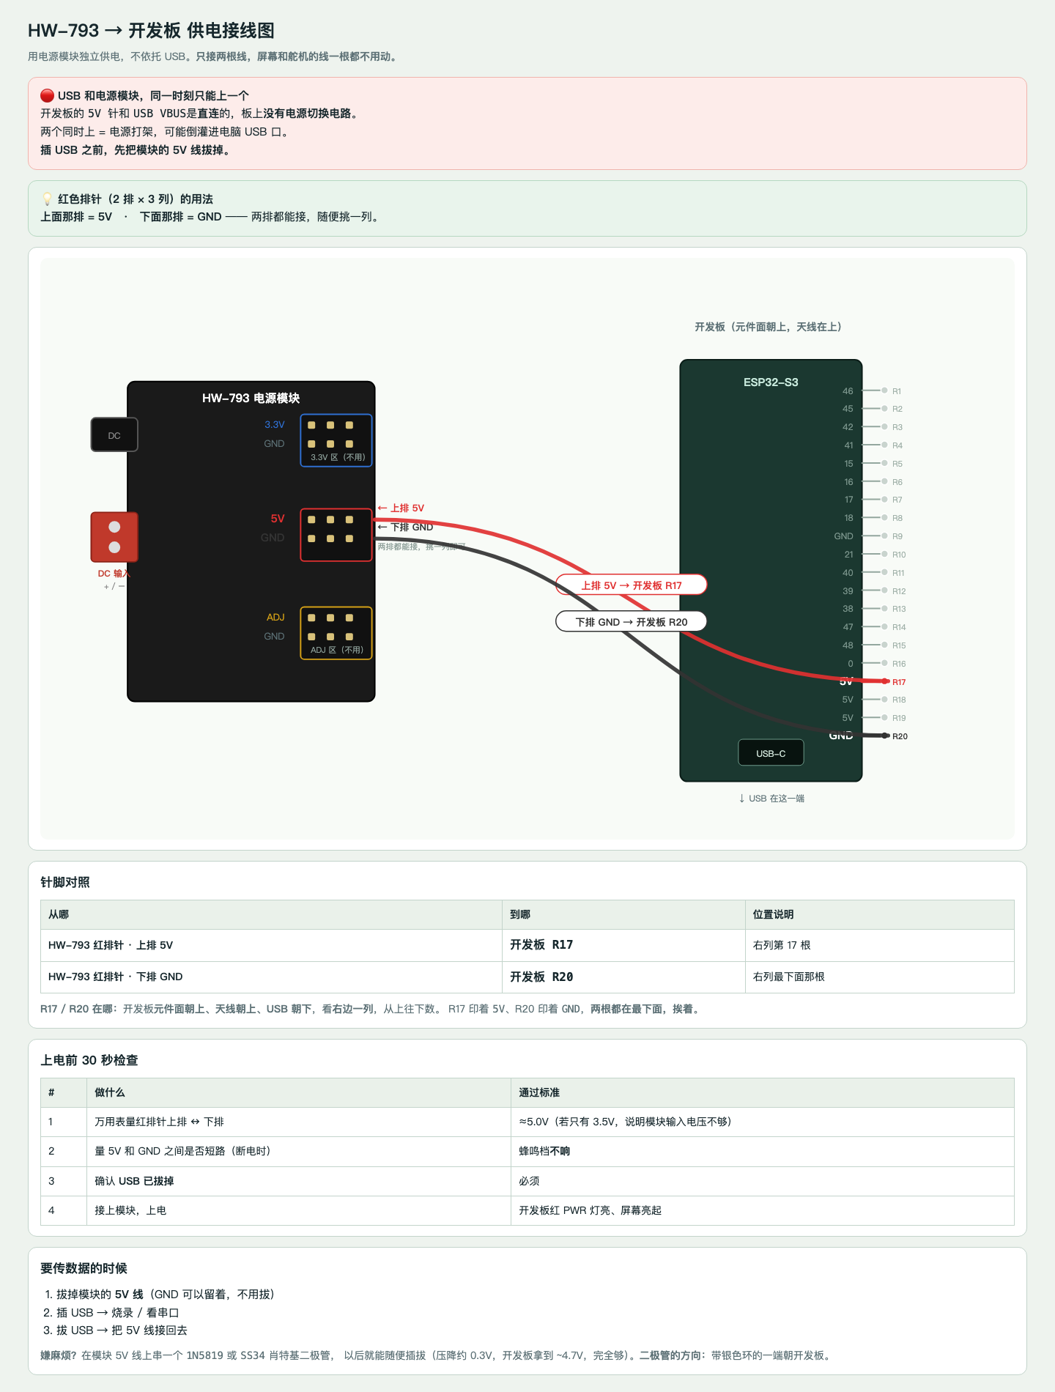
firmware/bringup/docs/供电接线图.png
