xaiojie/papabot/firmware/bringup/docs/接线示意图.png

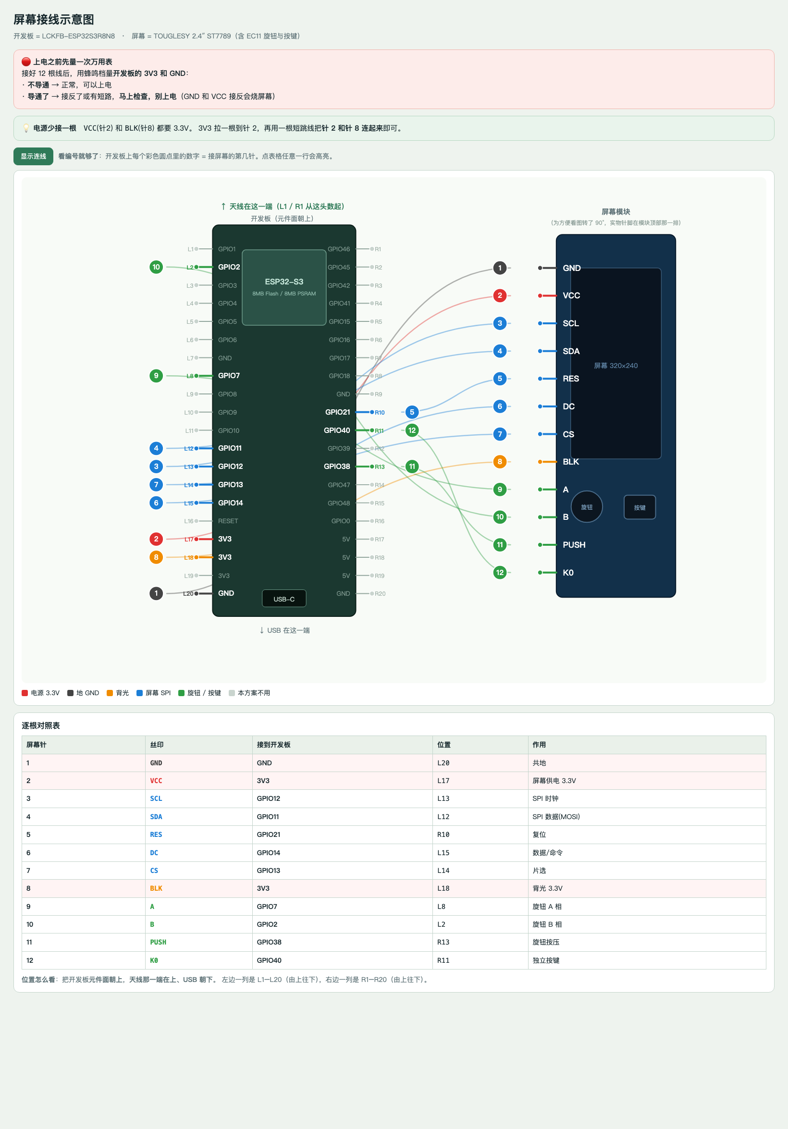
firmware/bringup/docs/接线示意图.png
