xaiojie/papabot/firmware/bringup/docs/整机链路图.png

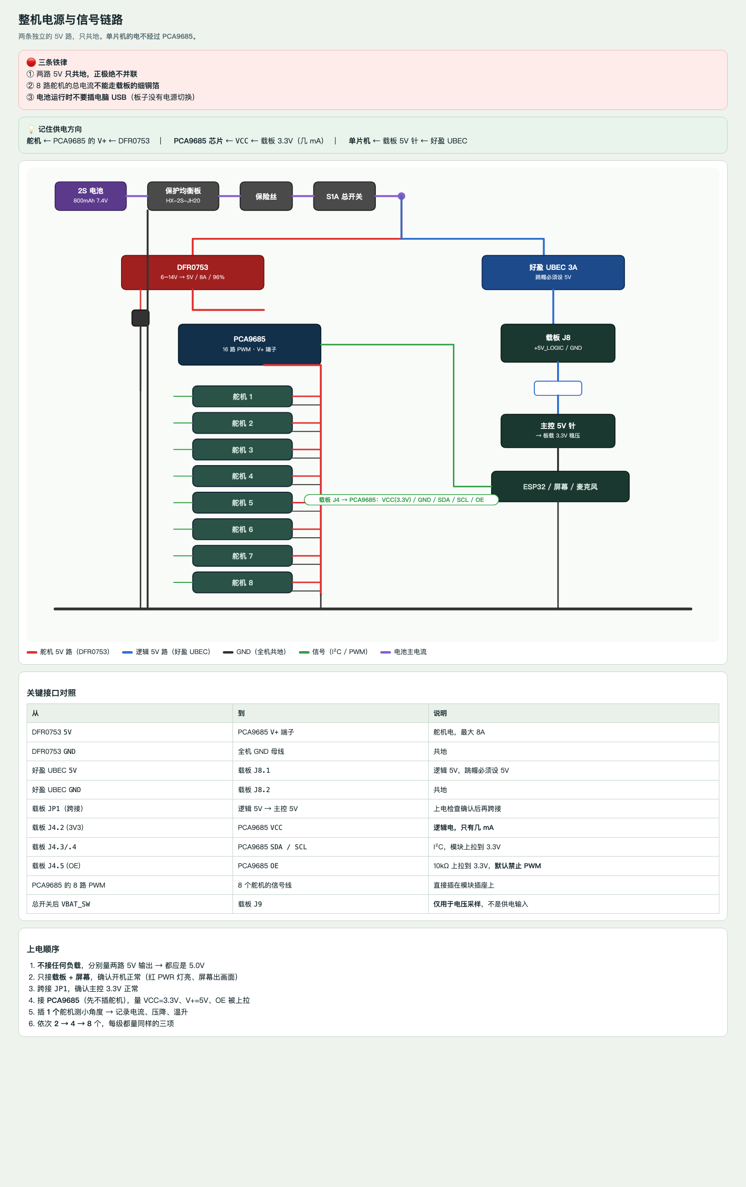
firmware/bringup/docs/整机链路图.png
