xaiojie/papabot/firmware/bringup/docs/集成板接线关系总图-截图.png

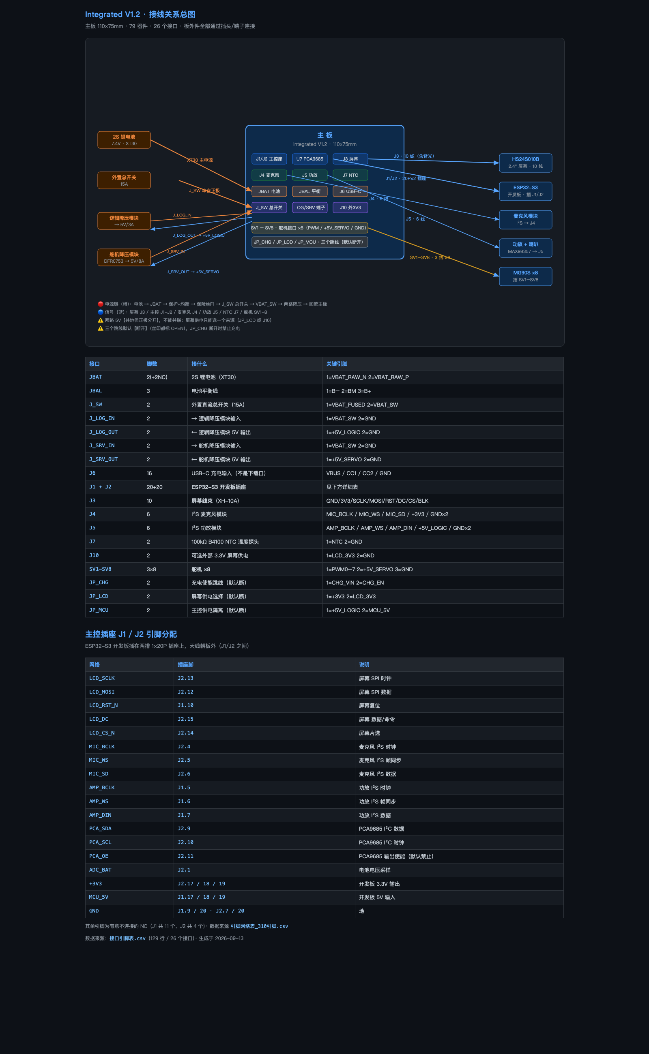
firmware/bringup/docs/集成板接线关系总图-截图.png
