xaiojie/papabot/design-coordination/history/before-a3/README.md

# ESP 系列四足智能桌面助手：项目交接说明

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

更新日期：2026-09-08。当前进行样机采购，设计与负载验证尚未完成。

已清理早期外观草稿、未选配色及旧模型打包副本；当前入口与源文件保留，详见[文件清理记录](../../../docs/history/文件清理记录-2026-09-08.md)。

## 当前设计入口：整机结构 A2

[整机结构A2](../../../mechanical-design/structure-a2/README.md)已建出32个独立打印件，含可编辑Blender总装、爆炸关系和零件总览；当前STL统一在`mechanical-design/structure-a2/stl-complete/`，每个打印1件。32件STL拓扑检查通过，静态装配实体干涉检查未发现超过0.05mm³的冲突；实物尺寸、线束、负载及步态仍需验证。用户最新要求后台专心建模，不再逐件打开Blender界面。

机身含前后盖约124×96.8×76mm，屏幕原91×44mm板保留完整，EC11和独立按键按后置拆焊接线布置。PCB板底放在整机Z66；PCB固定用4颗小头M2×8，原Ø3.2孔位不变。[零件清单](../../../mechanical-design/structure-a2/零件清单.md)及[装配与紧固件说明](../../../mechanical-design/structure-a2/装配与打印说明.md)列出全套零件和V7采购表需要补充的螺丝长度、M2螺母数量。

嘉立创EDA专业版原生工程`DesktopAssistant_RevA`保留既有原理图、80×32mm载板和25个网络布线，入口见[原生PCB检查版](../../../pcb-design/native-rev-a/README.md)。原生PCB严格DRC、原理图及独立网络/几何检查的既有结果保留；板框导出识别已修复。本轮继续结构设计，没有改变电气PCB文件，也未下单打样。[协调记录](design-coordination/README.md)已同步到A2。

## 0. 当前采购交付 V7

[整机配件核对Excel](../../../hardware-selection/bom-v7/00-整机配件采购核对.xlsx)为单页8列44行，覆盖原42类整机需求。采样/去耦按真实SKU拆列，同一包电容只计一次。

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

Type-C数据/充电线取消本次采购；PCB打样、整套3D及试样打印暂缓。电池采用2S1P、7.4V/满8.4V、1000mAh、整包持续≥10A，含逐节保护/均衡、18AWG短引线和XT30配对件。目标75×40×20mm、≤80g，真实尺寸与供货仍需商家确认。[电池定制文字](../../../hardware-selection/bom-v7/03-电池定制-发给商家.txt)由用户自行发送。

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

新补直插电阻/电容为原型器件；100k/33k分压和10k OE上拉尚未实施，先核板上电路。紧固件与绝缘垫柱用于试装，结构按实物复测。V7采购整理时保留Blender用户改动；后续结构进度以顶部A2入口为准。

用户已明确选定 **途格斯 / TOUGLESY 2.4 英寸 TFT 彩屏 + EC11 旋转编码器模块**，并表示已加入购物车，尚未确认下单或收货。它是 **ST7789、320×240、SPI、不带触摸** 的独立显示模块；不再要求 OLED / AMOLED。

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

**最新决定：用户已明确敲定 A「奶油薄荷」——奶油白机身与前盖、薄荷绿腿与耳框及细边、磨砂低光泽方向。** 颜色代码为设计目标；具体打印基材、层纹粗细、后处理与供应商实物色样仍需确认。

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

已选配色为 A 奶油薄荷。V7 的其余配色及 V8 蓝白探索方案已于目录清理时移入废纸篓；当前保留 A 原图、提示词和配色记录。

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

V1的可拆前盖仅露显示区，完整旋钮和按键藏在盖内，形成约20.8mm内缩。用户随后确认保留91×44mm完整PCB，将EC11和独立按键移到后部可拆面板；A2已按该决定建模，玻璃内缩约0.8mm仍是待测目标。硬件拆焊尚未实际执行。配色和耳饰沿用，刻字/Logo暂缓。

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

以下保留早期交接背景；OLED 和外接电源首版等建议均由本节最新决定更新。当前已有包含 PCB 的模块级 BOM 与预算预留，最终商品/结算价格、原理图和 PCB 器件级 BOM、实物验证仍待完成。

## 1. 接手时先读这一段

用户想做一只可爱的 ESP 系列智能桌面助手，具有显示屏、语音输入输出、四条能够行走的腿。屏幕既要显示表情，也要显示中文文本和其他信息。

最初用户明确要求“价格控制在300以内，性价比要最高”。随后用户强调屏幕是第一眼就看到的东西，允许屏幕预算稍微提高，并希望寻找 **2.4～3.0 英寸 OLED**，同时避免屏幕过大导致整机变大。

**屏幕现已选定为 2.4 英寸 TFT + EC11，舵机为8个MG90S全金属齿轮180度，主控为LCKFB-ESP32S3R8N8，详见第0节；PCB方案、舵机实测尺寸与承载待验证。新的整机总预算上限未确定。** 接手者应保留低成本目标，并按已选模块继续核算包含PCB的整机成本。下文高价OLED候选没有获得采购确认。

本次 OLED 调研在形成最终答复前，被用户主动中断，转而要求整理交接。因此下文 OLED 结果是已做的调研记录，不是已经获得用户认可的最终方案。

## 2. 用户原始意图与最新偏好

按对话顺序：

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

可以确定的要求：

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

尚未确认：

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

## 3. 已产出的外观概念

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

初版小屏构想和 V2–V5 过渡外观已移出工作目录。概念图用于外观参考，实际安装尺寸、承载和运动仍需按实物验证。

## 4. 当前建议的系统架构（未定稿）

### 主控与显示

早期建议：

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

最新 AMOLED 候选使用 QSPI 显示接口，不能直接套用早期 ST7789 普通 SPI 屏的连接和初始化方案。

### 语音

建议架构：

麦克风 → ESP32-S3 → Wi-Fi → 语音识别 / 大模型 / 语音合成服务 → ESP32-S3 → 功放及喇叭。

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

### 四足机构

当前建议为 **8 个小型定位舵机，每腿两个关节：水平摆腿 + 上下抬腿**，采用低矮、四脚外伸的小龟 / 爬行式结构。

方案比较：

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

工程限制：

- 8 自由度不代表足端能自由控制 XYZ，也不保证抬起一条腿后自然稳定。
- 每次抬脚前，需结合支撑三角形和重心调试站姿与步态。
- 第一版目标是平整表面上的基本前进、慢速转向和简单姿态动作，不应承诺精致犬步或可靠自主巡游。
- MiniKame / Kame32 可作为机械与步态参考，加装显示屏后仍需重新验证重心。

早期尺寸与重量目标，仅用于开始布局：

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

扭矩粗算仅用于筛选：

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

### 电源与活动范围

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

## 5. 屏幕选型的演变

### A. 最早的 1.54 英寸方案：已被用户的新需求替代

1.54 英寸、240×240、ST7789 彩屏，原分配预算 22 元。适合表情，但用户要求更大并显示文本，不能继续以此作为最终选型。

### B. 2.4 英寸 LCD 候选：仍可作成本对照，当前不应视为首选已定

具体调研过正点原子 ATK-MD0240：

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

文字排版估算：

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

### C. 最新优先调研：2.41 英寸彩色 AMOLED

AMOLED 适合黑底表情：黑色区域不发光，可让眼睛和文字显得更突出。实际观感仍取决于盖板反光、亮度、调光及 UI；不能概括成 OLED 一定在所有方面优于 LCD。

#### 候选 1：Waveshare ESP32-S3-Touch-AMOLED-2.41

已核实厂商资料：

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

价格记录：

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

版本与尺寸：

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

#### 候选 2：LILYGO T4-S3

已核实厂商资料：

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

价格与状态，2026-09-07 查询记录：

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

接口及资料问题：

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

#### 需要区分的另一类 OLED

调研也看到微雪 2.42 英寸 SSD1309 OLED：

- 128×64，白色或黄色单色版本，SPI / I²C。
- 国际官网显示 USD 12.99。
- 虽然尺寸和“OLED”字样符合搜索条件，但它不是高分辨率彩色 AMOLED；不应直接当作彩色表情 + 中文信息界面的升级方案。

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

## 6. 早期预算表：仅用于追溯，最新方案必须重算

以下是早期模块方案的设计分配，不是已经核实的店铺报价：

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

注意：

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

## 7. 建议的制作顺序与 PCB 路线

对用户提出的制作流程，已解释为：

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

关键区分：

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

## 8. 早期交接时的工作状态（历史，以第 0 节最新记录为准）

已经完成：

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

尚未完成：

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

没有下单、部署服务或连接用户设备。本交接不代表硬件已经验证可行。

## 9. 早期 OLED 调研后续建议（历史，已被第 0 节更新）

优先完成“2.4～3.0 英寸 OLED 选型 + 整机预算”这一小步：

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

不要默认用户已经选定微雪、LILYGO 或批准显著提高整机总预算。继续搜索、比较和设计属于当前工作范围。

## 10. 官方资料索引

### 主控、语音、运动与供电参考

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

### 早期 LCD 参考

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

### 微雪 AMOLED

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

### LILYGO AMOLED

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

以上价格和可售状态是 2026-09-07 的查询记录，采购前应重新核实。

## 11. 可直接发给新 Codex 对话的启动消息

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

旧V1–V6保留历史，勿运行旧生成器覆盖V7。BlenderV1用户修改必须保留；本轮不改CAD，不设计PCB，不下打印单。整机尚未完成原理图/PCB/固件、实物尺寸/电气/负载验证。更新2026-09-08。
