xaiojie/papabot/hardware-selection/bom-v7/history/README.md

# ESP 系列四足智能桌面助手：项目交接说明

更新日期：2026-09-08  
阶段：既定屏幕、奶油薄荷配色、8个MG90S、2S1000mAh电池定制规格、TELESKY充电板和LCKFB-ESP32S3R8N8延续。本轮PCA9685、逻辑降压、总开关和小包装线材已全部定为样机采购型号；电池供货、充电电流及实物验证待完成。Blender V1已交付，尚无正式打印包、PCB或固件。

## 0. 当前已选方案：TFT + EC11、奶油薄荷、MG90S、LCKFB-ESP32S3R8N8

**整机缺项核对：[00-整机配件采购核对.xlsx](../../bom-v6/00-整机配件采购核对.xlsx)**。单页8列覆盖42条整机需求，待补项排前，区分已加购、已列立创BOM、待定/自备及打印费用；报价空白不是免费。原01/02下单文件保持不变。

**最新采购交付为[简洁分渠道V6](../../bom-v6/README.md)**：立创单页3列10项，淘宝/天猫单页7列11项。原官网五项已在淘宝找到并加购，购物车从5项增至10项；新增商品共87.84元、不含运费，未下单。麦克风和DFR0753沿用原厂，功放改MAX98357A焊接成品5.19元，信号线改全铜20cm母母40根8.36元，电源线改2×18AWG红黑各1米4.29元。原03官网清单不再另购。只导入[01立创BOM](../../bom-v6/01-立创商城-BOM导入.xlsx)，与V5逐字节一致，数量已含MOQ/备件。所有Excel继续保持简洁。当前购物车未见MG90S，普通电池SKU的定制能力仍未核；功放实物尺寸与端子适配待验证。

**本轮四类配件已定型：HANLI PCA9685成品板×1（8.90元）、好盈UBEC 3A(2-6S)/86010010×1（35元，跳帽必须5V）、立创NKK S1A/C5366606×1（29.42元）、全铜母母20cm信号线1排40根（8.36元）和2×18AWG红黑硅胶线各1米（4.29元）。** 舵机路保留1块DFR0753（55元），取消第二块同款及F05重复MOSFET预算。用户已授权助手完成本轮选型，不再等待逐型号确认；实物温升/压降/尺寸未验证。详见[选型与接线V4](../../bom-v4/README.md)；V4保留42项工程总表，实际下单改用上面的V6分渠道文件。全套参考现金761.18元，其中346元仍为定制/试制等预算。另16项电池定制、辅料和电路/结构依赖保留，四类商品定型不等于全机生产BOM完成。主控仍为用户确认的LCKFB-ESP32S3R8N8/C20626143，8MB Flash＋8MB PSRAM，附未焊排针；音频现为SEN0327、淘宝MAX98357A焊接成品及C50387237喇叭。

**已选电池与充电：定制成品2S 7.4V 1000mAh电池包1包＋TELESKY MK021163 TYPE-C接口2S8.4V充电板1块。** 定制要求含持续10A、每节保护与均衡、XT30配对接头；商家能否做、成品尺寸与报价尚未确认。充电板截图价14.13元、标注28×17mm，默认充电电流及厚度/孔位待核。详见[电源选择与定制文字](../../power-selection-2s.md)。屏幕、8个舵机、充电板的126.53元有历史用户截图价格；电池80元仍为预算，不能套用14.7元普通对讲机电池价。[V1的619.53元BOM](../../bom-v1/README.md)保留作历史，当前采购文件以V6为准，型号与接线延续V4。新的总预算上限仍未确认。

**最新舵机选型：图二「MG90S舵机（全金属齿轮）180度」，整机 8 个、每腿 2 个。** 用户截图单价 10 元，舵机小计 80 元；尚未核实结算价、下单、实物尺寸或承载能力。建议先用 2 个完成单腿试样。详见 [舵机选型与商品截图](../../servo-mg90s-180.md)。assembly-v1 的八个蓝色舵机仍为历史占位模型，后续依实际尺寸和舵盘重做腿部安装结构。

用户已明确选定 **途格斯 / TOUGLESY 2.4 英寸 TFT 彩屏 + EC11 旋转编码器模块**，并表示已加入购物车，尚未确认下单或收货。它是 **ST7789、320×240、SPI、不带触摸** 的独立显示模块；不再要求 OLED / AMOLED。

商品标称整板 **91×44 mm**，四个 **Ø3 mm** 安装孔，孔中心距 **84.5×37.5 mm**。正面布局为屏幕在左、旋钮在右上、独立按键在右下，外壳需整体容纳这块 PCB。排针是否已焊接及其朝向仍待核实。

- [第一阶段 Blender 总装与交付说明](../../../mechanical-design/assembly-v1/README.md)
- [本轮 V1 文件完整性检查：22/23 项一致，当前 Blender 文件已有变化](../../bom-v1/assembly-v1-inspection.json)
- [实际 Blender 渲染：八视图](../../../mechanical-design/assembly-v1/gallery.html)
- [保存后重开验证与工程限制](../../../mechanical-design/assembly-v1/reports/validation-report.md)
- [最终已选配色：A 奶油薄荷](../../../mechanical-design/concepts/design-v7-cmf-options/a-cream-mint.png)
- [配色选择与当前工程状态](design-selection.json)
- [Blender 整机建模、分件与打印交付路线](../../../mechanical-design/modeling-and-print-plan.md)
- [历史 V8：三款 B/C 蓝白组合与原备选对比](design-v8-bc-refined/comparison.html)
- [V8 原图、配色分配与完整提示词](design-v8-bc-refined/design-notes.md)
- [V7：六款配色与表面对比页](design-v7-cmf-options/comparison.html)
- [V7 六款原图、材质路线与提示词](../../../mechanical-design/concepts/design-v7-cmf-options/design-notes.md)
- [V6 外观比例基准：紧凑居中比例](../../../mechanical-design/concepts/design-v6-compact-centered/desktop-pet-compact-centered-v6.png)
- [V6 尺寸假设、居中计算与限制](../../../mechanical-design/concepts/design-v6-compact-centered/design-notes.md)
- [历史外观效果图 V5：爬爬/Jay 刻字与小耳饰](design-v5-engraving-ears/desktop-pet-jay-ears-v5.png)
- [V5 文字、图案与头饰设计说明](design-v5-engraving-ears/design-notes.md)
- [历史外观效果图 V4：加宽机身、显示区居中](design-v4-centered-face/desktop-pet-centered-face-v4.png)
- [V4 整板偏置安装、居中依据与尺寸说明](design-v4-centered-face/design-notes.md)
- [历史外观效果图 V3：仅露屏幕的可拆前盖](design-v3-covered-face/desktop-pet-covered-face-v3.png)
- [V3 前盖构想、控件使用与兼容说明](design-v3-covered-face/design-notes.md)
- [历史外观效果图 V2：旋钮与按键外露](design-v2-2.4-ec11/desktop-pet-2.4-ec11-v2.png)
- [模块参数与 V2 尺寸依据](design-v2-2.4-ec11/design-notes.md)
- [用户商品规格图](design-v2-2.4-ec11/display-module-reference.png)

**最新决定：用户已明确敲定 A「奶油薄荷」——奶油白机身与前盖、薄荷绿腿与耳框及细边、磨砂低光泽方向。** 颜色代码为设计目标；具体打印基材、层纹粗细、后处理与供应商实物色样仍需确认。

用户授权后，第一阶段已完成：Blender 5.2.1 LTS 建立独立对象组成的整机总装，生成八张真实渲染，包含前盖/底盖拆开及爆炸姿态、元件占位、待测尺寸表。最终文件保存后重开通过本轮25项限定检查。主壳与前盖、底盖、耳饰、屏幕支架等可单独编辑；舵机承载连接、紧固件、公差、运动与实物试配尚未完成，没有输出 STL/3MF/STEP 生产包。

V7 六款历史候选仍保留，V8 的 BC1 冰川蓝白、BC2 雪白海盐、BC3 晴空霜白也已生成并保存为探索记录；B/C 和 V8 不再是当前最终配色。用户提供的淘宝截图仅作为可询价工艺线索，没有向店铺发消息或采购。

比例沿用 V6：压缩横向长度，保留已认可的小耳饰，暂去全部刻字和 Logo。以商品整板 91 mm、屏幕组件标注 59 mm 研究约 118 mm 外宽（不含腿）的居中方案；该宽度基于屏幕左边距约 5.5 mm、板右侧总余量约 3 mm 的假设，尚未实测，不是最小宽度或已验证尺寸。

所选模块不变，仍通过偏置整块 PCB 让显示区中心对准机身中心。右侧控件使屏幕偏离整板中心，仅在 91 mm 整板外加 3～5 mm 并不能保证显示区居中；本轮假设下板左侧需约 24 mm、右侧约 3 mm。必须实测屏幕相对 PCB 的位置，不能宣称已经同时满足极小板边余量与居中。此前 130 mm 宽度为历史设计预估。

V1的可拆前盖仅露显示区，完整旋钮和按键藏在盖内，形成约20.8mm内缩。用户要求减少内缩、尽量平齐；上轮已推荐保留91×44mm完整PCB，将EC11和独立按键移到后部可拆面板，玻璃内缩0.5～1mm作为设计目标。拆焊可行性和实际高度尚未核实，用户未单独确认拆焊执行，本轮未改硬件或CAD。配色和耳饰沿用，刻字/Logo暂缓。

V2 曾以宽 112×深 82×高 72 mm 预估机身；后续加宽及覆盖旋钮所需的前盖深度尚未实测，不能沿用旧数值作为最终尺寸。商品图的“显示区域 59×42.5 mm”与 2.4 英寸标称不一致，开窗、有效显示区相对 PCB 的位置、模块厚度与安装间隙须以实物复核。历史概念图未完成 CAD 装配验证。最新 assembly-v1 是数值建模的 Blender 总装，检查范围与未完成项见其验证报告，不能等同于制造装配确认。

当前总装的主体设计包络约118×84.6×76 mm，含腿耳的静态包络约208×106×122.5 mm。四腿外移用于避开偏置屏幕PCB，安装载荷路径待所选 MG90S 的实际尺寸和舵盘确认后设计；屏幕后退约20.8 mm源于保留完整EC11的假设。以上均未冻结为实物加工尺寸。

以下保留早期交接背景；OLED 和外接电源首版等建议均由本节最新决定更新。当前已有包含 PCB 的模块级 BOM 与预算预留，最终商品/结算价格、原理图和 PCB 器件级 BOM、实物验证仍待完成。

## 1. 接手时先读这一段

用户想做一只可爱的 ESP 系列智能桌面助手，具有显示屏、语音输入输出、四条能够行走的腿。屏幕既要显示表情，也要显示中文文本和其他信息。

最初用户明确要求“价格控制在300以内，性价比要最高”。随后用户强调屏幕是第一眼就看到的东西，允许屏幕预算稍微提高，并希望寻找 **2.4～3.0 英寸 OLED**，同时避免屏幕过大导致整机变大。

**屏幕现已选定为 2.4 英寸 TFT + EC11，舵机为8个MG90S全金属齿轮180度，主控为LCKFB-ESP32S3R8N8，详见第0节；PCB方案、舵机实测尺寸与承载待验证。新的整机总预算上限未确定。** 接手者应保留低成本目标，并按已选模块继续核算包含PCB的整机成本。下文高价OLED候选没有获得采购确认。

本次 OLED 调研在形成最终答复前，被用户主动中断，转而要求整理交接。因此下文 OLED 结果是已做的调研记录，不是已经获得用户认可的最终方案。

## 2. 用户原始意图与最新偏好

按对话顺序：

1. 用户希望“基于ESP系列的单片机做一个可爱的智能桌面助手”，需要显示屏、语音输入输出和四条能走路的腿，先设计雏形并提出建议。
2. 用户明确预算：“价格控制在300以内，性价比要最高”。
3. 用户询问制作流程是否应当是：设计 PCB、焊接、编写程序、打印外壳、组装。
4. 用户希望屏幕比最初的 1.54 英寸更大，除了表情，还能显示文本等信息。
5. 早期 OLED 屏幕偏好原文（已被第 0 节的选型决定更新）：
   > 对于屏幕的预算可以稍稍提高一点，因为这是第一眼就回看到的东西，你找找oled屏幕呢？显示效果应该会好一些，然后屏幕尺寸可以在2.4到3之间，太大了也就意味着整体会变大

可以确定的要求：

- ESP 系列平台。
- 可爱、适合放在桌面，外观和屏幕观感重要。
- 语音输入和输出。
- 四条实际能实现基本行走的腿。
- 显示表情，也能显示中文文本、时间、提醒等信息。
- 当前屏幕已确定为 2.4 英寸 ST7789 TFT + EC11，不带触摸；此前 OLED / AMOLED 为历史候选。
- 性价比优先；原整机预算 300 元，最新允许屏幕适当加预算，但尚无新的具体金额。
- 用户有设计 PCB、焊接和打印外壳的制作意向。

尚未确认：

- 是否必须完全离线对话。此前方案以联网语音对话为假设。
- 用户现有工具、焊接水平、是否拥有 3D 打印机。
- 第一版已确认内置电池；本轮定制2S1000mAh需求和TELESKY Type-C充电板款式已选，定制供货、实际充电电流与两路降压的负载验证待核。
- 对行走距离、速度、姿态和稳定性的具体验收要求。
- 是否接受“现成屏幕主控一体板 + 自制底板”的组合。
- 首版已选屏幕不带触摸；旋钮和独立按键的具体交互功能尚待设计。

## 3. 已产出的外观概念

附件：

- `esp32-desktop-pet-concept.png`：已生成的概念图。
- `esp32-desktop-pet-image-prompt.txt`：完整生成提示词，使用内置 imagegen 工具生成。

图中方向：

- 奶白色圆角机身、黑色屏幕脸、青色表情。
- 浅绿色外伸短腿，部分蓝色小舵机外露。
- 四足低重心、桌面宠物风格。
- 机身后方有外接电源线。
- 临时名称“豆豆”，未由用户确定。

**上述旧图使用的是早期 1.54 英寸屏幕构想。最新 2.4 英寸 TFT + EC11 外观图及说明见第 0 节。** 两版图像均不是 CAD、结构装配图或可直接打印文件；图中的关节数量、轴向、安装和内部空间不能作为工程依据。

可以沿用圆角机身、黑底表情和柔和配色；屏幕比例、机身前脸、重量分布需根据最终元件重新调整。

## 4. 当前建议的系统架构（未定稿）

### 主控与显示

早期建议：

- ESP32-S3 开发板，优先 N16R8，即 16 MB Flash、8 MB PSRAM。
- 通过 SPI 控制普通彩色 LCD。
- 如果采用已调研的 AMOLED + ESP32-S3 一体板，它可以替代早期的独立主控板和显示模块，应从 BOM 中扣除被替代的两项。

最新 AMOLED 候选使用 QSPI 显示接口，不能直接套用早期 ST7789 普通 SPI 屏的连接和初始化方案。

### 语音

建议架构：

麦克风 → ESP32-S3 → Wi-Fi → 语音识别 / 大模型 / 语音合成服务 → ESP32-S3 → 功放及喇叭。

- 可参考小智 ESP32 开源项目，减少联网语音、表情显示和设备控制的基础开发量。
- 原型可使用 I²S 麦克风、MAX98357A 功放和小喇叭；具体模块和接线尚未确定。
- 开放式聊天主要依赖后端服务；本地表情与预设动作可以离线运行。
- 少量离线命令可研究乐鑫 ESP-SR MultiNet。
- 首版建议“走动结束后倾听，再回答”，减少舵机机械噪声对收音的干扰。
- 麦克风和喇叭应考虑分开布置；未验证全双工对话、回声消除或边走边听效果。
- 采用显示主控一体板时，应重新核实剩余 GPIO、I²S、I²C 和固件兼容性，不能默认现成小智固件直接适用。

### 四足机构

当前建议为 **8 个小型定位舵机，每腿两个关节：水平摆腿 + 上下抬腿**，采用低矮、四脚外伸的小龟 / 爬行式结构。

方案比较：

- 4 舵机：便宜，但每腿单关节无法独立控制抬脚与前进，常依赖特殊连杆、脚形、摇摆或滑动。
- 8 舵机：当前建议的成本与动作能力折中。
- 12 舵机：动作空间更大，但增加成本、重量、结构与供电负担，暂不作为首版目标。

工程限制：

- 8 自由度不代表足端能自由控制 XYZ，也不保证抬起一条腿后自然稳定。
- 每次抬脚前，需结合支撑三角形和重心调试站姿与步态。
- 第一版目标是平整表面上的基本前进、慢速转向和简单姿态动作，不应承诺精致犬步或可靠自主巡游。
- MiniKame / Kame32 可作为机械与步态参考，加装显示屏后仍需重新验证重心。

早期尺寸与重量目标，仅用于开始布局：

- 机身约 8 × 6 cm。
- 连腿站立占地约 13～16 cm。
- 身体离桌面约 2～3 cm。
- 整机尽量约 200～250 g；更大的屏幕和主板可能要求修订。
- 短腿、薄壁外壳、柔软脚垫，避免厚重前脸。

扭矩粗算仅用于筛选：

以 250 g 总重、有效水平力臂 3 cm、2～3 条腿主要承重估算，静态约 0.25～0.375 kgf·cm；乘 2～3 倍初步余量约 0.5～1.13 kgf·cm，尚未充分计入碰撞、摩擦和载荷不均。

TowerPro SG90 官方标称 9 g、4.8 V 下 1.8 kgf·cm 堵转扭矩。堵转扭矩不能当持续工作能力；廉价兼容舵机不能视为必然达到原厂规格。建议先买单条腿所需舵机验证承重和动作，再决定批量采购。

### 电源与活动范围

- 此前建议第一版外接电源，暂不带电池，以减重并控制费用。
- 5 V 5 A 适配器只是候选起点，未证明能满足实际八个舵机的同时动作。
- 需测试单舵机、八舵机起身，以及 Wi-Fi、显示和扬声器同时运行时的峰值电流及压降。
- 从电源处分出主控和舵机两路，共地；舵机电流不经过 ESP 开发板或普通面包板电源条。
- PCA9685 负责 PWM 控制信号，不能因此忽略舵机的大电流配电。
- 首版在地面或带围边托盘中验证，默认不自主巡游。尚未设计可靠的桌边检测系统。
- 外接线从较低位置引出并留松弛，避免把轻量机器人拖偏。

## 5. 屏幕选型的演变

### A. 最早的 1.54 英寸方案：已被用户的新需求替代

1.54 英寸、240×240、ST7789 彩屏，原分配预算 22 元。适合表情，但用户要求更大并显示文本，不能继续以此作为最终选型。

### B. 2.4 英寸 LCD 候选：仍可作成本对照，当前不应视为首选已定

具体调研过正点原子 ATK-MD0240：

- 2.4 英寸。
- ST7789，320×240，可横屏。
- 厂商标注全视角。
- 四线 SPI，3.3 V 供电与 I/O。
- 模块尺寸 72 × 43.65 mm。
- 有官方驱动和接口资料。
- 没有核实到当前人民币到手价；此前 30～40 元仅为屏幕采购目标，不能写成该型号实时报价。

文字排版估算：

- 320×240 横屏，左右各留 12 px。
- 24 px 全角汉字每行约 12 个。
- 表情 + 短字幕：约 2 行。
- 阅读模式：约 5 行。
- 这些基于假设字号及行距，未实现 UI。
- 相同分辨率与像素字号下，2.8 英寸比 2.4 英寸字更大，但不会显示更多字。

### C. 最新优先调研：2.41 英寸彩色 AMOLED

AMOLED 适合黑底表情：黑色区域不发光，可让眼睛和文字显得更突出。实际观感仍取决于盖板反光、亮度、调光及 UI；不能概括成 OLED 一定在所有方面优于 LCD。

#### 候选 1：Waveshare ESP32-S3-Touch-AMOLED-2.41

已核实厂商资料：

- 2.41 英寸彩色 AMOLED，600×450。
- QSPI，显示驱动 RM690B0。
- 电容触控，触控控制器 FT6336。
- ESP32-S3R8，16 MB Flash + 8 MB PSRAM。
- 带 RTC、6 轴 IMU、TF 卡槽及锂电池充电相关电路。
- 引出 GPIO、I²C、UART、USB 等接口。
- 厂商选型表没有将该型号列为自带麦克风和喇叭的完整语音板，需要外接音频电路。
- 有无外壳两种产品形态，自制机器人外壳时可优先研究无壳版本。

价格记录：

- 查询时国际官网显示 **USD 49.99～53.99，依版本**。
- 这是“屏幕 + ESP32-S3 主板”价格，不是单独屏幕价格。
- 国内商品页遇到滑动验证，**人民币到手价、国内运费及最终版本库存未确认**。
- 没有执行滑动验证、购物车操作或下单。

版本与尺寸：

- 官方最新文档区分 V1、V2，显示、触控、中断与扩展 I/O 定义有变化，示例与固件不能互用。
- 必须按实际 PCB 版本核对原理图后再设计配套底板。
- 已找到官方尺寸图和尺寸文件 ZIP，但本轮没有完成对整板尺寸的可靠读取；不要编造尺寸或套用 LILYGO 的尺寸。
- 官方网页列出亮度 800 cd/m²、对比度 100000:1，属于厂商规格，未实测。
- 音频与四足并发运行、GPIO 分配、功耗及刷新表现均未实测。

#### 候选 2：LILYGO T4-S3

已核实厂商资料：

- 官方名称 **T4-S3**；没有确认另一个独立产品名“T-AMOLED 2.41”。
- 2.41 英寸彩色 AMOLED 电容触控屏，450×600，横屏为 600×450，QSPI。
- ESP32-S3R8，16 MB Flash + 8 MB PSRAM。
- 有效显示区 36.2×48.96 mm，横置约 48.96×36.2 mm。
- 官方无壳尺寸图示总成 56×44×13 mm，图中包含屏、PCB及焊接排针，不能把 13 mm 当裸屏厚度。
- 带壳图示 59×46×14 mm。
- 独立 PCB、裸屏尺寸及厚度公差未进一步核实。

价格与状态，2026-09-07 查询记录：

- Basic [H678]：**USD 56.89**。
- 带壳 + 已焊母排 [H711]：USD 58.99。
- 带壳 + 已焊公排 [H724]：USD 60.23。
- 查询时官网具体变体数据标为可售；未验证用户地址的配送和结算状态。
- 官网 USD 1.10 的 “Only Sheild” 是配件选项，不能当成整板价。
- 国内人民币售价与最终到手价未确认。

接口及资料问题：

- 2×15 针 GPIO 接口，间距 1.27 mm。
- 两个 JST-SH 1.0 mm 插座，官方引脚图为一个 UART GPIO43/44、一个 I²C GPIO6/7；Wiki 概括描述存在差异，设计前要对照具体板版次。
- GPIO18 被屏幕 TE 信号占用，不能随意分配给外设。
- 未见板载完整麦克风 / 功放语音链路或舵机直插口。
- 商品页 / Wiki 亮度写 800 cd/m²，官方仓库表格写 550 nits，属于待核实冲突。
- 外接音频、PCA9685 和舵机电源的整体适配未验证。

#### 需要区分的另一类 OLED

调研也看到微雪 2.42 英寸 SSD1309 OLED：

- 128×64，白色或黄色单色版本，SPI / I²C。
- 国际官网显示 USD 12.99。
- 虽然尺寸和“OLED”字样符合搜索条件，但它不是高分辨率彩色 AMOLED；不应直接当作彩色表情 + 中文信息界面的升级方案。

当前检索中，2.41 英寸 AMOLED 一体板是较明确的可开发候选。没有完成全市场扫描，不能断言 2.4～3.0 英寸范围只存在这些产品。2.8 英寸附近也有 MIPI 面板，若继续研究裸屏，必须核对其接口是否能被 ESP32-S3直接使用，以及驱动、电源、连接器和单片采购渠道。

## 6. 早期预算表：仅用于追溯，最新方案必须重算

以下是早期模块方案的设计分配，不是已经核实的店铺报价：

| 项目 | 分配金额 |
|---|---:|
| ESP32-S3 N16R8 开发板 | 30 元 |
| 1.54 英寸 ST7789 屏 | 22 元 |
| I²S 麦克风 + MAX98357A + 小喇叭 | 18 元 |
| SG90 级定位舵机 × 8 | 80 元 |
| PCA9685 模块 | 10 元 |
| 5 V 5 A 外接电源候选 | 30 元 |
| 分电、开关、电容、线材 | 22 元 |
| 轻量外壳、腿和支架 | 35 元 |
| 螺丝、脚垫 | 10 元 |
| 电容触摸模块 | 3 元 |
| 合计 | 260 元 |
| 运费、舵机差价及补件预留 | 40 元 |
| 原总上限 | 300 元 |

注意：

- 没有单列定制 PCB 打样、额外连接器及焊接耗材。
- 不包括购买焊接工具或 3D 打印机。
- 不包括联网语音服务的后续费用。
- 8 个舵机实际可能需要 80～100 元甚至更多，取决于可靠性和供货。
- 若采用 AMOLED 一体板，可扣除早期主控 30 元和屏幕 22 元，其他原分配约 208 元，但仍须逐项修正。
- 以目前已查到的一体板海外官网价，整机总额将明显高于原预算；国内价未确认，不能直接把美元标价当国内采购价，也不能声称 300 元已能实现新方案。
- 用户允许在屏幕上适当增加投入；新的总额应提供具体方案后再由用户确定。

## 7. 建议的制作顺序与 PCB 路线

对用户提出的制作流程，已解释为：

1. 确定元件和整体布局，先放入屏幕、主板、舵机及必要走线空间。
2. 使用模块验证显示、语音和单条腿，编写基础程序；随后验证多舵机同时工作。
3. 在接口、供电、板框和安装孔明确后，设计原理图与 PCB。
4. PCB 打样、焊接，先检查电源，再逐个接入外设。
5. 联调舵机零位、限位、步态、表情和语音。
6. 根据真实线束与元件位置，打印完整外壳并总装。
7. 验证装壳后的行走、收音、温升、供电和结构干涉。

关键区分：

- 腿和支架需要较早制作 / 打印，用于实际步态测试。
- 外壳布局与 PCB 并行规划，最终装饰外壳稍后定稿。
- 程序从模块验证阶段开始，不应等全部焊完才首次开发。
- 第一版可以做“成熟模块 / 屏幕主控板 + 自定义集成底板”，后续再考虑更高集成度。
- 是否采用上述 PCB 路线尚未由用户最终选定。

## 8. 早期交接时的工作状态（历史，以第 0 节最新记录为准）

已经完成：

- 前期方案讨论、机械与电源粗评估。
- 一张外观概念图及生成提示词。
- 1.54 / 2.4 / 2.8 英寸 LCD 的尺寸与文字显示讨论。
- 2.41 英寸微雪、LILYGO 彩色 AMOLED 候选的初步官方资料与价格调研。
- 本交接说明和文件打包。

尚未完成：

- 最终 BOM 及人民币实际到手价。
- 屏幕、主控和舵机定型。
- 原理图、PCB、Gerber、焊接图。
- GPIO 分配与完整供电设计。
- 任何固件项目、代码或测试。
- CAD、STL、STEP 或可打印结构。
- 模块采购、焊接、打印、实物组装与实测。

没有下单、部署服务或连接用户设备。本交接不代表硬件已经验证可行。

## 9. 早期 OLED 调研后续建议（历史，已被第 0 节更新）

优先完成“2.4～3.0 英寸 OLED 选型 + 整机预算”这一小步：

1. 阅读本交接及概念图，保留最新尺寸和屏幕优先级。
2. 比较至少一个屏幕主控一体板方案与一个能实际单片购买的独立 AMOLED 屏 / 模块方案；若独立方案不合适，应明确原因。
3. 核实国内可买型号、人民币价格、版本、整板 / 裸屏尺寸、显示接口、所需供电及剩余可用 GPIO。
4. 说明如何连接语音输入输出和 8 个舵机，是否有适配现有固件的依据。
5. 重新列出包含 PCB 的整机预算，区分实时报价和估算，避免重复计算一体板已包含的主控。
6. 给出明确推荐，再确定新的预算范围与最终选型。
7. 定型后推进电气连接图和内部布局，再进行原理图 / PCB；当前没有启动正式制作的定稿方案。

不要默认用户已经选定微雪、LILYGO 或批准显著提高整机总预算。继续搜索、比较和设计属于当前工作范围。

## 10. 官方资料索引

### 主控、语音、运动与供电参考

- [ESP32-S3-WROOM-1 规格](https://www.espressif.com/sites/default/files/documentation/esp32-s3-wroom-1_wroom-1u_datasheet_en.pdf)
- [小智 ESP32](https://github.com/78/xiaozhi-esp32)
- [ESP-SR MultiNet](https://docs.espressif.com/projects/esp-sr/zh_CN/latest/esp32s3/speech_command_recognition/README.html)
- [MiniKame 原作者仓库](https://github.com/javierih/minikame)
- [Kame32](https://github.com/JavierIH/Kame32)
- [TowerPro SG90](https://towerpro.com.tw/product/sg90-7/)
- [MAX98357A](https://www.analog.com/en/products/max98357a.html)
- [PCA9685 数据手册](https://www.nxp.com/docs/en/data-sheet/PCA9685.pdf)

### 早期 LCD 参考

- [ATK-MD0240 官方资料](https://github.com/alientek-module/LCD-module_2.4-inch_ATK-MD0240)
- [ATK-MD0240 SPI 示例](https://wiki.alientek.com/docs/Boards/IoT/DNT5M/example-base/spilcd/)
- [微雪 2.4 英寸 LCD](https://www.waveshare.com/wiki/2.4inch_LCD_Module)
- [LCDWIKI 2.8 英寸 IPS](https://www.lcdwiki.com/2.8inch_IPS_SPI_Module_ILI9341)

### 微雪 AMOLED

- [国内商品页](https://www.waveshare.net/shop/ESP32-S3-Touch-AMOLED-2.41.htm)
- [国际商品页](https://www.waveshare.com/esp32-s3-touch-amoled-2.41.htm)
- [官方文档及版本差异](https://docs.waveshare.com/ESP32-S3-Touch-AMOLED-2.41)
- [原理图、尺寸文件和示例](https://docs.waveshare.com/ESP32-S3-Touch-AMOLED-2.41/Resources-And-Documents)
- [V2 官方仓库](https://github.com/waveshareteam/ESP32-S3-Touch-AMOLED-2.41-V2)
- [官方尺寸图](https://www.waveshare.com/img/devkit/ESP32-S3-Touch-AMOLED-2.41/ESP32-S3-Touch-AMOLED-2.41-details-size.jpg)
- [尺寸文件 ZIP](https://files.waveshare.com/wiki/ESP32-S3-Touch-AMOLED-2.41/Dimension_Appearance_Diagram.zip)
- [单色 OLED 对照](https://www.waveshare.com/product/2.42inch-oled-module.htm)

### LILYGO AMOLED

- [T4-S3 官方商品页](https://lilygo.cc/products/t4-s3)
- [官方商品变体数据](https://lilygo.cc/products/t4-s3.js)
- [官方 Wiki](https://wiki.lilygo.cc/products/t4-series/t4-s3/)
- [官方代码仓库](https://github.com/Xinyuan-LilyGO/LilyGo-AMOLED-Series)
- [官方 DXF](https://github.com/Xinyuan-LilyGO/LilyGo-AMOLED-Series/blob/master/dimensions/T4-S3-AMOLED.dxf)
- [无壳尺寸图](https://cdn.shopify.com/s/files/1/0617/7190/7253/files/T4-S3_3.jpg?v=1712915514)
- [带壳尺寸图](https://cdn.shopify.com/s/files/1/0617/7190/7253/files/T4_S3_5.jpg?v=1712827651)
- [官方引脚图](https://cdn.shopify.com/s/files/1/0617/7190/7253/files/T4-S3-2.41_2.jpg?v=1740477913)

以上价格和可售状态是 2026-09-07 的查询记录，采购前应重新核实。

## 11. 可直接发给新 Codex 对话的启动消息

先读README.md第0节、design-selection.json和hardware-selection/bom-v6/README.md。采购Excel保持单页简表：01立创10项3列，02淘宝11项7列；原03官网五项已全部转到淘宝，不重复购买。01立创与V5逐字节一致，由用户自行导入、套数1。

本轮按用户授权，将SEN0327对应MSM261S4030H0麦克风1块15元、MAX98357焊接功放1块5.19元、DFR0753舵机降压1块55元、全铜母母20cm信号线1排40根8.36元、2×18AWG红黑硅胶并线1米4.29元加入淘宝购物车，刷新后验证原5项增至10项，各新增数量1，共87.84元未含运费；未下单。商品链接、SKU和核验记录见V6。麦克风与降压沿用原款；功放、信号线和电源线替换原DFR0954/FIT0030/FIT0585。新功放螺丝端子需适配喇叭1.25mm插头、BTL不接地，尺寸待测。

既定屏幕TOUGLESY2.4寸ST7789+EC11、奶油薄荷、8个MG90S180度、LCKFB-ESP32S3R8N8、定制2S1000mAh持续≥10A含每节保护均衡和XT30、TELESKY MK021163 TYPE-C充电板延续。当前购物车未见MG90S；普通14.70元电池SKU不能认定满足定制要求，电池供货/报价/成品尺寸及充电电流仍待核。逻辑用好盈3A(2-6S)/86010010，跳帽设5V；总开关NKK S1A。保险后、开关前接充电支路，S1A断两路负载，首版关机充电；共地，两路5V输出不并联。PCA只输出PWM，舵机总电流走外部配电。

V6保留42项工程需求，10立创+11淘宝+21待定/服务/已含件，并非完整生产BOM。当前工程预算721.02元仍含346元占位；已知采购商品369.64元不含未报价电池、待定辅料、服务、运费。旧V1–V5为历史，不要运行旧生成器覆盖新交付。BlenderV1及八视图保留，用户有修改，勿覆盖；无正式打印包/原理图/PCB/固件。后续接线、尺寸、实物负载和温升测试尚待完成。更新2026-09-08。
