xaiojie/papabot/docs/guides/开发与调试.md

# 开发与调试手册

[返回项目首页](../../README.md) · [固件入口](../../firmware/README.md) · [项目进度](../../项目进度总览.md)

本文保留原项目首页的安装、接线、固件架构、命令与故障排查说明，整理于 **2026-10-26**。
**适用对象是旧 TOUGLESY ST7789 + EC11 的开发板台架**：本页引脚、供电顺序与旋钮操作均按这套硬件编写。
新版集成 PCB 使用 **HS24S010B，无 EC11**，请以 [新版 PCB 装配与接线](../../pcb-design/integrated-v1/final-no-encoder-2026-09-12/装配与接线说明.md) 为准；新板适配仍需实物验证。

以下命令默认从仓库根目录执行，资源生成小节除外。文中的屏幕、网页与舵机实测数据来自 **2026 年 9 月台架记录**，不是本轮重新上电测得；当前硬件状态见上方进度入口。

## 一、环境依赖与安装

### 1.1 硬件

- LCKFB-ESP32S3R8N8 开发板（**必须是 8 MB Flash + 8 MB PSRAM**，N8R8）
- TOUGLESY 2.4″ ST7789 模块（12 针，含 EC11）
- **外部 3.3 V** 给屏幕（模块 VCC 与 BLK）、**外部 5 V** 给舵机
- USB **数据**线（不是只能充电的线）

### 1.2 软件

| 依赖 | 版本 | 用途 |
|---|---|---|
| Python | ≥ 3.9 | 生成器、主机测试 |
| PlatformIO | 6.1.18 | 编译 / 烧录 |
| Node.js | ≥ 20 | 网页控制台中转服务 |
| Pillow | 任意近期版 | 字库与 GIF 转动画 |

### 1.3 安装步骤

```bash
git clone https://github.com/xaiojie/papabot.git
cd papabot

# 建一个隔离的 PlatformIO 环境（会生成 firmware/bringup/.venv）
bash firmware/bringup/scripts/setup.sh
```

脚本内容相当于：

```bash
python3 -m venv firmware/bringup/.venv
firmware/bringup/.venv/bin/python -m pip install "platformio==6.1.18" "urllib3<2"
```

如果当前终端设置了会干扰构建的 `PYTHONPATH`，可在命令前加 `env -u PYTHONPATH`。下文示例统一使用这一写法：

```bash
env -u PYTHONPATH bash firmware/bringup/scripts/pio.sh run -e lckfb_s3_usbjtag
```

> **为什么**：某些托管环境会往 `PYTHONPATH` 注入 Python 垫片，导致
> `generate_wiring.py` 里的 `Path.mkdir(exist_ok=True)` 抛 `PermissionError`
> （不是 `FileExistsError`，`exist_ok` 拦不住），prebuild 直接失败、整个编译挂掉。

网页中转服务（可选，Node.js ≥ 20；前端和 HTTPS/WSS 反向代理见 [部署记录](../../firmware/web-console/部署记录.md)）：

```bash
# 先在本地环境中设置 PAPA_USER、PAPA_PASS、PAPA_DEVICE_KEY、PAPA_TOKEN_SECRET
# 密码和密钥自行生成，不写进源码或提交到 Git
cd firmware/web-console/server
npm install
PAPA_BIND=127.0.0.1 PAPA_PORT=8790 npm start
```

---

## 二、编译与烧录

两套固件共用同一块板子，**分工不同**：

| 工程 | 用途 | 适合什么时候烧 |
|---|---|---|
| `bringup` | 硬件自检台：屏幕彩条、旋钮计数、麦克风电平、舵机单步 | 接线后第一次上电、怀疑硬件坏了 |
| `assistant` | 产品固件：表情、时钟、天气、动画、网页控制 | 硬件确认没问题之后 |

### 2.1 选端口与环境

```bash
ls /dev/cu.*          # macOS
```

| 端口 | 对应 env | 说明 |
|---|---|---|
| `/dev/cu.usbmodem*` | `lckfb_s3_usbjtag` | **原生 USB-Serial/JTAG，免装驱动**（推荐） |
| `/dev/cu.wchusbserial*` | `lckfb_s3_bringup` / `lckfb_s3_assistant` | 板载 CH340K，需装 CH34x 驱动 |

### 2.2 烧录

```bash
# 硬件自检
env -u PYTHONPATH firmware/bringup/.venv/bin/pio run \
    --project-dir firmware/bringup -e lckfb_s3_usbjtag \
    -t upload --upload-port /dev/cu.usbmodemXXXX

# 产品固件（复用 setup.sh 创建的 PlatformIO 环境）
env -u PYTHONPATH firmware/bringup/.venv/bin/pio run \
    --project-dir firmware/assistant -e lckfb_s3_usbjtag \
    -t upload --upload-port /dev/cu.usbmodemXXXX
```

烧不进去时：按住 **BOOT** → 点一下 **RESET** → 松开 BOOT，进下载模式重试。
烧完按 RESET 正常启动，**不要一直按住 BOOT**。

### 2.3 主机测试（不用板子）

```bash
# bringup：命令解析逻辑
python3 firmware/bringup/scripts/test_host.py

# assistant：脏矩形与 SPI 预算
python3 firmware/assistant/scripts/test_host.py
```

---

## 三、配置说明

### 3.1 旧屏台架引脚表（bringup 以 `wiring.json` 为准）

| 功能 | GPIO | 位置提示 |
|---|---|---|
| LCD_SCLK | 12 | 左列 L13 |
| LCD_MOSI | 11 | 左列 L12（模块丝印写 `SDA`，**不是 I²C**） |
| LCD_RST | 21 | 右列 R10 |
| LCD_DC | 14 | 左列 L15 |
| LCD_CS | 13 | 左列 L14 |
| ENC_A / ENC_B | 7 / 2 | L8 / L2 |
| ENC_PUSH | 38 | R13（按下为低） |
| KEY0 | 40 | R11（按下为低） |
| SERVO0 / SERVO1 | 18 / 15 | 台架试验脚，**不代表载板已有舵机座** |
| MIC_BCLK / WS / SD | 4 / 5 / 6 | INMP441，L/R 接地选左声道 |
| LED | 48 | 低电平点亮 |
| BOOT | 0 | 低电平有效 |

> 屏幕 `VCC` 与 `BLK` **只能接 3.3 V**。RevA 时代用 5 V，旧习惯必须丢掉。

### 3.2 两套固件的配置入口不同

**`bringup`：改 `wiring.json`，不要改生成的头文件**

```bash
vim firmware/bringup/wiring.json
env -u PYTHONPATH python3 firmware/bringup/scripts/generate_wiring.py
```

`generate_wiring.py` 会校验 GPIO 冲突、位置合法性和重复占用，然后生成
`include/board_config.h`。手改 `board_config.h` 会在下次构建时被覆盖。

**`assistant`：直接改 `include/config.h`**

| 配置项 | 默认值 | 说明 |
|---|---|---|
| `SCREEN_W/H` | 320×240 | 逻辑分辨率（横屏） |
| `PANEL_NATIVE_W/H` | 240×320 | **面板原生尺寸，必须竖屏传参**，传反会导致画面转 90° 且地址回绕 |
| `SCREEN_ROTATION` | 3 | 横屏 |
| `SCREEN_INVERT` | false | 这块模组设 true 会变白底暗红 |
| `SPI_HZ_DEFAULT` | 10 MHz | 提频与帧率需在实际模组、接线和页面上测量 |
| `SERVO_COUNT / SERVO_PINS` | 2 / {18, 15} | 当前双路台架；扩展前复核引脚、PWM 通道、控制逻辑与供电 |
| `SERVO_MIN_US / MAX_US` | 1000 / 2000 | 当前脉宽范围，不能直接等同 0–180°；每个关节需独立标定 |
| `WEATHER_REFRESH_MS` | 20 min | 和风免费版有日调用上限 |
| `QUOTA_REFRESH_MS` | 5 min | 额度变化比天气频繁 |
| `NET_RETRY_MS` | 60 s | 失败重试，否则断网开机永远空状态 |

### 3.3 运行期配置（写进 NVS，掉电不丢）

凭据**不写进源码**，只在设备上用串口命令配置：

```
wifi connect <SSID> <密码>        连接并保存，开机自动重连
wifi connect <SSID> <密码> ram    只连本次，不保存
wifi forget                       清除已保存的凭据
cloud key <密钥>                  配置云端设备密钥
set qwkey <和风 Key>              天气 API Key（值不回显）
set qwhost <API Host>             和风项目 API Host
```

`config` 命令可以查看当前存了什么（密钥只显示"已设置/未设置"）。

### 3.4 分区表

`assistant` 用自定义的 `partitions-assistant-8mb.csv`：

```
nvs       0x9000   0x5000
app0      app,factory  0x10000  0x6E0000   (6.875 MB，单 app、无 OTA、无 SPIFFS)
coredump  0x6F0000 0x10000
```

- 这台设备**不用 OTA、不用文件系统**：字库和动画在编译期通过 `embed_files` 直接进 flash。
- `nvs` 偏移与 PlatformIO 默认的 `default_8MB.csv` 一致；只刷应用且不擦除 NVS 时可保留 Wi-Fi 凭据，全片擦除会清空配置。
- `bringup` 仍用 `default_8MB.csv`（它的发布包按原布局做过哈希），两个工程分区表**故意不一致**。

### 3.5 资源文件

| 文件 | 生成方式 | 说明 |
|---|---|---|
| `data/cjk16.bin` / `cjk24.bin` | `scripts/make_cjk_font.py` | GB2312 4444 字形，16 / 24 px |
| `data/anim.bin` | `scripts/make_gif_anim.py` | GFX1 v2 动画包，当前 3 部 |

```bash
# 此小节从 assistant 目录执行
cd firmware/assistant

# 字库
python3 scripts/make_cjk_font.py

# 动画：路径后面加 :2 表示按步长 2 抽帧
python3 scripts/make_gif_anim.py a.gif "b.gif:2" -o data/anim.bin --preview
```

> **字库许可**：当前 16/24 px 字模取自 macOS 自带字体，再分发许可尚未确认。
> 对外再分发前请替换为思源黑体 / Noto Sans CJK 等允许再分发的字体，并保留其许可文件。

---

## 四、主要模块与核心逻辑

### 4.1 为什么架构长这样：SPI 带宽是硬上限

面板是**只写 SPI**（没有 MISO），10 MHz 下推一屏 320×240 要：

```
320 × 240 × 2 字节(RGB565) = 153,600 B
153,600 × 8 / 10,000,000   ≈ 123 ms  →  8 fps 封顶
```

所以**绝不能每帧全屏重绘**，否则动画一顿一顿。于是有了下面两条设计：

1. **帧缓冲放 PSRAM**（153,600 B，减少对内部 SRAM 的占用），Canvas 在内存里画完再推。
2. **脏矩形局部刷新**：只把发生变化的矩形区域推给屏幕。
   实测表情页脏矩形 160×136 → **37.8 ms**，比全屏 133 ms 快 3.5 倍。

### 4.2 `bringup`（硬件自检台）

| 文件 | 作用 |
|---|---|
| `wiring.json` | 接线真值源，生成 `board_config.h` |
| `include/control_logic.h` | 纯命令解析（无硬件依赖）→ 可在 PC 上跑单元测试 |
| `src/main.cpp` | 屏幕 / 舵机 / 麦克风 / 编码器驱动 + 串口命令台 |

设计要点：**解析逻辑与硬件驱动分离**。`control_logic.h` 只把字符串变成命令结构体，
不碰任何外设，因此 16 组、293 项断言能在主机上跑完，不用反复烧板子。

状态机是显式的：`PASSIVE`（什么都不初始化）↔ `SCREEN` ↔ `SERVO`。
`screen` 与 `servo` 互斥，切过去要先 `stop`。

### 4.3 `assistant`（产品固件）

| 文件 | 作用 |
|---|---|
| `main.cpp` | 启动流程、主循环、串口命令台、云端命令桥 |
| `apps.cpp` | 9 个页面：表情 / 数字钟 / 表盘 / 天气 / 额度 / 状态 + 每部动画一页 |
| `canvas.cpp` + `dirty.h` | 帧缓冲、RGB565 绘制、脏矩形累积与推屏 |
| `anim.cpp` | GFX1 v2 解码：第 0 帧整存，其后叠加差分 |
| `net.cpp` | Wi-Fi、NTP、HTTP（天气 / 额度） |
| `cloud.cpp` | WSS 客户端，连 `papa.papaclaoud.top` 中转 |
| `font_ascii.cpp` | ASCII 字模；中文走 `cjk*.bin` 查表 |

**启动顺序**（串口能看到对应日志）：

```
boot: config → spi → panel init → panel ok → canvas
     → anim 载入 → framebuffer 分配 → CJK 字库 → inputs
     → goto face → 自动连 Wi-Fi → NTP → cloud WSS → READY
```

**页面编号**：`0`face `1`clock `2`analog `3`weather `4`chatgpt `5`sys，
之后每部动画占一页 → 当前 3 部动画共 **9 页（0–8）**。旋钮转动即切页。

**动画格式（GFX1 v2）**

```
Header : "GFX1" | u8 version=2 | u8 count | u16 reserved
Record : u16 w,h,frames,delayMs,reserved | u32 paletteOff | u32 frameIndexOff | u32 dataOff
Frame0 : w*h 字节索引，整帧
FrameN : [u32 start | u16 run | run 字节] × N | u32 0xFFFFFFFF
```

`start` 是**绝对像素位置**，不是"相对跳过"。v1 用 `u16 start`，单帧像素数硬上限
65535 —— 320×240（76800）根本编不出来，所以升到 v2 时把 `start` 放宽到 u32。
**脚本的 `VERSION` 与 `anim.cpp` 的 `kFormatVersion` 必须同步**，不一致固件会拒绝加载。

### 4.4 `web-console`（papa-relay）

- Node.js + `ws`，默认端口 **8790**（`PAPA_PORT` 可改）
- 两个 WSS 通道：设备主动连上来 + 浏览器连上来，服务端做双向转发
- HTTP 接口：`/api/health`、`/api/login`、`/api/status`、`/api/device/ping`
- 部署实例：<https://papa.papaclaoud.top/>

设备端在 `cloud.cpp` 里主动连出，所以**不需要公网 IP、不需要端口映射**。

---

## 五、启动与使用方法

### 5.1 开机

1. 按本页台架供电顺序连接 USB 和外部电源；板载 LED 1 Hz 心跳表示主控在跑。电池整机供电仍待独立验收。
2. 屏幕先黑一下再出表情页。
3. 串口打印 `READY.` 后即可接命令。
4. Wi-Fi 若已保存过凭据会自动重连，随后自动同步 NTP、拉天气与额度。

### 5.2 旧屏台架的实体操作

| 操作 | 效果 |
|---|---|
| 转旋钮 | 上/下一页（顺时针下一屏） |
| 按旋钮 | 当前页确认 / 换情绪 |
| 按独立键 | 页面自定义动作 |

### 5.3 串口命令台（115200）

```
help | status | stats [on|off] | dump | dumpr
next | prev | screen <0-8|name>
mood [next]                     换表情情绪
ntp                             立即对时
wifi connect/forget/status/scan/off
cloud status | cloud key <密钥> | cloud forget
set nick / qwhost / qwkey / qwloc / subhost / adminkey / account / subkey
quota | usage | weather         立即拉取
spi <10|20|40>                  改 SPI 时钟
servo arm|center|stop [n]       舵机上电回中 / 松力（n 省略=全部）
servo pulse [n] <1000-2000>     设脉宽
servo status                    各路状态
config                          查看已存配置
```

> 有些命令（`dump` / `dumpr`）会输出几十万字节，读的时候记得别设太短的超时。
> **不要把"返回空串"当成命令结束** —— 偶发一次空回不代表命令不存在，重发即可。

### 5.4 网页控制台

部署示例为 <https://papa.papaclaoud.top/>；运行时需要服务可用、设备在线并使用对应的登录凭据。
登录后可查看状态、切屏、换表情和查看远程画面。约 4.5 fps 是历史台架数据，当前代码按浏览器连接数自动开关推流；本轮未复测线上服务。

---

## 六、常见问题（FAQ）

### 屏幕整块纯白

**先别拆线。** `bringup` 复位后停在 `PASSIVE`，这个状态**一行屏幕初始化都不发**，
而 `BLK` 接的是 3.3 V 常亮 → 面板有电、没命令 → 肉眼就是纯白。

```
screen start
```

出彩条即正常。真正要查线的情况是：**已经 `screen start` 之后**还是白的。

### 串口一回 `SCREEN active`，但屏还是不亮

正常。ST7789 **只写、没有 MISO**，固件根本读不回面板状态。
`SCREEN active` 只证明"初始化命令发出去了"，**判断屏幕只能靠眼睛**。

### 每次打开串口设备就重启

预期。打开 `/dev/cu.usbmodem*` 会触发复位（`USB_UART_CHIP_RESET`），
所以**一批命令必须在同一次串口会话里发完**，否则状态全丢。

### 编译报 `PermissionError` / prebuild 失败

`PYTHONPATH` 垫片问题，加 `env -u PYTHONPATH` 前缀：

```bash
env -u PYTHONPATH firmware/bringup/.venv/bin/pio run --project-dir firmware/assistant -e lckfb_s3_usbjtag
```

### `pio.sh` 说找不到 PlatformIO

仓库自带的 `.venv` / `.tools` 不在版本库里，需要自己建：

```bash
bash firmware/bringup/scripts/setup.sh
```

`pio.sh` 的查找顺序：`.tools/bringup-venv/bin/pio` → `工程/.venv/bin/pio` → `PATH`。
`assistant/scripts/pio.sh` 不会查找相邻的 `bringup/.venv`；从根目录使用本手册中的完整路径，或将 `firmware/bringup/.venv/bin` 加入 `PATH`。

### 串口列表里看不到设备

先换一根**数据线**；再看是不是选错了口。同一块板可能同时出现原生 USB 和 CH340 两个口，
**不要凭列表顺序选**。

### 舵机不动 / 一直嗡嗡响 / 发热

- 不动：确认已 `servo arm`（未 arm 时 PWM 根本没开）、外部 5 V 是否上电、信号线是否接对。
- 持续嗡响、发热或无法运动时，先断电检查是否堵转或顶到机械限位；在当前 1000–2000 µs 范围内重新标定，缩小行程，不能凭脉宽推定角度。
- 10 秒没新指令会自动松力（停 PWM，**但没有断舵机电源**）。
- 舵机 5 V **必须外部供电**，不能从开发板取。

### 中文显示成方块 / 乱码

`data/cjk*.bin` 没被链接进去。检查 `platformio.ini` 的 `board_build.embed_files`，
并确认文件确实存在（它们是二进制资源，不是 git 忽略项）。

### 动画屏只画一半 / 花屏

先确认 `anim.bin` 的版本与固件匹配（`GFX1` 后第 5 个字节应为 `2`）。
脚本和 `anim.cpp` 版本不一致时，固件会打印"版本不支持"并拒绝加载 —— 重新生成即可。

### 天气 / 额度一直是空的

按顺序查：`wifi status` → 有没有 IP；`ntp` → 时间是否有效；
`config` → `qwkey` / `subkey` 是否已设置。HTTP 失败会 60 s 后重试，也可以 `weather` / `quota` 立即拉。

### 网页控制台连不上设备

看设备串口是否打印 `[cloud] ✅ 已连上中转服务`。断线会自动重连；
若一直失败，检查 `cloud key` 是否配置、网络是否能出 443。

---

## 七、安全红线与注意事项

1. **屏幕 VCC 和 BLK 只能 3.3 V。** 接 5 V 可能不可逆损坏。
2. **屏幕不允许单独带电。** 控件上拉接在屏幕 VCC 上，屏幕带电而主控没电会经信号线倒灌。
3. **任何接线动作前，USB 和外部电源都必须断开。** 不允许带电插拔杜邦线。
4. **不要让外部 3.3 V 正极接到开发板的 3V3 / 5V 排针。** 两边各自供电、只共地。
5. **舵机 5 V 走外部独立供电**，与逻辑 5 V 只共地不并联。
6. **上电顺序**：先 USB、确认 `PASSIVE`，再开外部 3.3 V；断电反过来。
7. **凭据不入库。** 设备端口令与 API 密钥通过串口写入 NVS；服务端密码与密钥通过本地环境变量配置。
8. **字库再分发许可待确认。** 当前字模来自 macOS 自带字体，对外再分发前请替换并保留新字体的许可文件。
9. **脉宽 ≠ 角度。** `1000–2000 µs` 是电气行程，装上腿以后每个关节要单独标定。
