xaiojie/papabot/project-status-history/20260914-1608/项目进度汇总.md

# 爬爬 · 项目进度汇总

**汇总时间**：2026-09-14 16:08（Asia/Shanghai）
**范围**：只读巡检。未修改固件、PCB、结构、BOM 任何文件。
**权威入口**：`项目进度总览.md`（当前时间戳 2026-09-13 18:45，**已滞后于本页**）

---

## 一、一句话结论

项目已从「台面原型」转入 **PCB 打样下单 + SMT 贴片 + 结构定版** 阶段。
三个方向都在今天往前推了一步：**结构 A5 从半成品转为完整交付**、**立创报价单落地 ¥230.88**、
**固件补齐双舵机与两个真实 bug**。

仍缺的还是那三样：**下单收货 → 实物试装 → 语音闭环**。

---

## 二、今天（9-14）新发生的事

| 时间 | 事件 | 状态 |
|---|---|---|
| 09:18 | **结构 A4 完成**，机身 94×132×76 | 已被 A5 取代为次新版 |
| 10:24–11:36 | 接线资料成体系：三件套接线与排障、集成板接线关系总图、舵机接线、网页控制舵机命令表、屏幕 12 针接线表 | 新增 |
| 11:13–11:34 | 固件更新：双舵机、额度误判修复、舵机超时下溢修复；构建产物 2,271,296 B | 已构建 |
| 14:45→15:54 | **结构 A5 从半成品补完为完整交付** | **当前最新结构** |
| 15:57 | `当前结构版本.md` 更新指向 A5 | 已完成 |
| 9-13 23:34 | 立创报价单归档（BOM260913000033） | 待下单 |

---

## 三、结构：A5 已定版（今天的最大变化）

**A5 现在是完整可用版本**，此前卡住的拓扑问题已解决：`topology_pass=true`，
31 个零件 `nonmanifold_edges` 全为 0（此前 `L102_FR` 的 1 条非流形边已修复）。

| 项 | A4 | **A5（当前）** |
|---|---:|---:|
| 机身宽×深×高 | 94×132×76 | **124×112×76** |
| 站姿包络（含耳/脚垫） | 174.9×154.75×122.46 | **162.9×116.5×122.46** |
| 主板安装 | 75×110 竖放 | **110×75 横置（旋转 90°）** |
| PCB 底面离地 | 76.5 | 80.5 |
| 脚外沿每侧超机身 | 40.45 | **19.45（腿部向内收拢）** |

**A5 交付清单（齐）**：31 件毫米 STL、5 件试配件、9 张渲染、试装 ZIP（25.2 MB）、
SHA256.json、验收摘要、零件清单 CSV、紧固件与辅料、重建说明、scripts。
Blend 主文件 SHA-256 `ace82240…a4cf9`。

**A5 已过的静态检查**：31 零件闭合连通、31 STL 复读、5 试配件复读、36 组腿部离散姿态、
24 个拆装位置、J6 充电 USB-C 插拔量规（护套 14×15×8 / 金属端 8.4×6.5×2.6）、屏幕接头对主板、
原文件保护（A4/A3/PCB/BOM 未被脚本改动）。

**A5 关键设计点**：110×75 主板横置，J6 充电 USB-C 朝后盖（R20 孔板 17×11 入口，中心 X=−42/Z=83.8），
S1A 总开关候选件放入 R08 内凹仓（拨杆与后盖齐平不外伸），HS24S010B 近齐平前窗、无 EC11。

> ⚠️ **A5 与 A4 的腿件与主板支架不能混装**（膝关节下移 6 mm，上下腿与髋座已重做）。
> 仍未验证：实物打印、承重、连续步态、温升。

---

## 四、PCB：三条版本线的位置

| 版本 | 定位 | 状态 |
|---|---|---|
| RevA | 早期载板 | 历史，制板入口已废弃（5V 接法被 RevB 的 3.3V 取代） |
| **RevB + Jay/爬爬** | 模块方案载板 80×32 | **交付完成**（Gerber/工程/丝印检查齐全，SHA-256 与 CRC 复核通过） |
| **integrated-v1 V1.2** | 110×75 集成板 | **设计交付完成**（五页原理图、79 器件、全布线、双面 GND 填充、DRC 严格通过、Gerber 核验通过） |

**9-13 18:41 的用户版核对**：当前在线 PCB1 与 V1.2 无旋钮基线电路/布局一致，
保留用户新增的「小皖子和爬爬 2026 0913设计」丝印及另外三处文字调整；
已做原样备份（`user-latest-review-2026-09-13/`）。此后 PCB 编辑以用户在线最新版为准。

**未完成**：打样下单、SMT、焊接、上电、充电/保护/舵机负载实测、与结构的联合试装。

---

## 五、采购：报价单已落地，但已过 24 小时时效

| 项 | 值 |
|---|---|
| 配单编号 | `BOM260913000033` |
| 上传时间 | 2026-09-13 00:42:30 |
| **商品总价** | **¥230.88**（原价 ¥246.43，折扣 −¥15.55） |
| 匹配 | **41/41 系统匹配 · 41/41 现货 · 全部 4 小时内发货** |
| 归档 | `采购清单-20260912/立创报价单-20260913/`（xls + csv + json） |

> ⏰ **立创的报价有效期是 24 小时，从 9-13 00:42 算起已经过期。**
> 下次真要下单前必须**重新匹配一次**，价格与库存都可能变（尤其 ¥34.37 的屏和 ¥24.35 的保险丝座）。

**下单前还要手动补 3 样**：
1. XT30 母头（立创 MRO）
2. 小号插片保险丝 7.5A（立创 MRO）
3. R6 500 mΩ 采样电阻（淘宝）

**成本注意**：¥230.88 **只是立创元件费**，不含 PCB 打样、SMT 加工、电池、模组与运费。
原始 **≤¥300 整机目标** 仍未形成满足预算的最终 BOM，两条路线（模块 / 集成）应分别核算。

**两处可选的降本点**（报价单已提示）：保险丝座 ¥24.35 占 10%（进口 Littelfuse，可用国产替代但主回路安全件别买杂牌）；
电感 ¥15.35（Würth 2.2µH/28A，换国产前须核对饱和电流与 DCR）。

---

## 六、固件：9-14 修了两个真 bug + 加了一路舵机

`firmware/assistant/`（9-14 11:13–11:34），构建产物 `firmware.bin` 2,271,296 B @ 11:31。

**① 额度页「没打满却一直显示已限流」** —— 根因是 ArduinoJson 的 `is<const char*>()`
对 `null` 也返回 `true`，随后 `nullptr[0]` 空指针解引用读到非零字节，条件恒成立。
改为显式判非空字符串。修复后屏幕正常显示 `公司Pro / 正常 / 7天 39%`。
**教训**：`is<T>()` 是「能否转成 T」不是「类型是不是 T」。

**② 舵机刚 arm 完就「超时松力」** —— 同一轮 loop 里 `now`(16693) 早于命令写入的
`lastCommand_`(16694)，`uint32_t` 相减下溢成 4294967295，立刻触发 10 s 超时。
改用有符号比较 `static_cast<int32_t>(now - lastCommand_)`。
**同一处写法在 `firmware/bringup/include/control_logic.h` 也有，已一并修掉。**
**教训**：`millis()` 差值比较一律用 int32 有符号。

**③ 新增双舵机支持** —— `SERVO_COUNT=2`、`SERVO_PINS={18,15}`（GPIO15 空闲非 strapping，
与 GPIO18 相邻便于接排针）。命令扩展 `servo arm/pulse/center/stop [n]`，向下兼容。
两路独立斜率、独立超时。实测 `servo0 GPIO18 cur=1100` / `servo1 GPIO15 cur=1715` 互不影响。

**当前其余配置真值**：脉宽 `1000–2000 µs`、中位 1500、斜率 5 µs/20 ms（约 15°/s）、
10 s 超时松力。**脉宽 ≠ 已标定角度。**

**Wi-Fi 凭据策略已变**：`wifi connect` 默认**写入 NVS**（开机自动重连，已实测重启重连通过），
末尾加 `ram` 才只用于本次连接，`wifi forget` 清除。
> ⚠️ `firmware/assistant/README.md` 第 78 行附近仍写着「只存 RAM，不写 NVS」，**是滞后描述**。
> 建议下次一并改掉，否则会误导装配/安全判断。

**其他已跑通的**：8 个可轮换页面（表情/数字钟/表盘/天气/额度/状态 + 2 部 GIF）、
表情区约 23 fps、远程推流上限 5 fps；bringup 自检 14 组 / 259 项 / 0 失败。

---

## 七、缺口清单（按优先级）

| # | 缺口 | 卡在哪 |
|---|---|---|
| 1 | **立创下单** | 报价已过 24 h 时效，需重新匹配；下单前补 XT30 母头、7.5A 插片保险丝、R6 |
| 2 | **PCB 打样 + SMT** | 未提交、未付款、未收货；设计侧已就绪 |
| 3 | **实物打印与试装** | A5 静态全过，但没打过一件实物；先打试配件核对真屏/舵机/USB-C |
| 4 | **语音链路** | 麦克风、功放、喇叭已选型布线，**录放→ASR→对话→TTS 全链路未开始** |
| 5 | **八路舵机** | 只有 1–2 路 GPIO 直驱测试；未接 PCA9685、未做关节标定 |
| 6 | **供电实测** | ACE800 2S 电池选型在，未采购；充电/保护/负载压降/温升/续航全未测 |
| 7 | **文档滞后** | `项目进度总览.md`(9-13 18:45) 不含 A4/A5/立创报价单/9-14 固件更新，需要重写一次 |

---

## 八、建议的下一步顺序

1. **先重匹配立创 BOM**（趁断货前锁价）→ 同一账号下 PCB 打样 + SMT，补 3 样 MRO
2. **并行 A（不用等板子）**：现有开发板做音频模块测试 → 打通一次完整语音往返
3. **并行 B（不用等板子）**：核对单舵机实物型号 → 脉宽标定 → 单腿两关节 → PCA9685 八路
4. **A5 试配件先打 5 件**（coupons），核对真屏、舵机、USB-C 后再打整机壳
5. 板子回来后：电池/充电/电源负载测试 → 整机并发（屏+Wi-Fi+音频+运动不复位）→ 四足站立/缓步/转向

> 语音与单腿这两件事 **不依赖 PCB 到货**，是当前性价比最高的推进方向。

---

## 九、待用户补充的信息

- PCB 打样 / SMT 是否已下单、是否付款、是否收货
- 电池、音频模块、其余舵机是否已购买
- 当前测试舵机的**实际型号**（记录里 MG90S 与 SG90 不一致）
- 屏幕区开窗是否刻意右偏：实测开窗中轴相对机身中轴 **右偏 2.63 mm**，导致屏左 2.5 mm 被面板压住、
  右侧露出约 2.9 mm 黑边框，A4/A5 完全一致 —— 需确认是有意对齐还是残留偏差
