xaiojie/papabot/project-status-history/20260915-0900/项目进度汇总.md

# 桌面助手 · 项目进度汇总（2026-09-15 09:00）

> 自动汇总任务生成，只读巡检，未改动任何工程文件。
> 上一份汇总：`project-status-history/20260914-1608/项目进度汇总.md`（昨日 16:08）。
> 增量核查窗口：2026-09-14 16:15 之后变更的文件（共 19 个，全部位于 `firmware/bringup/`）。

## 一、整体阶段判断

**项目仍处于「PCB 打样下单 + 结构定版 + 模块联调」阶段。** 能显示中文/表情、联网拉取
天气与额度、网页远程控制的桌面原型已在运行；语音链路、四足行走、内置电池整机尚未完成。

与昨日汇总相比：**主结构 A5 已于 9-14 15:57 完整交付并成为当前结构版本**；
昨日傍晚（17:12–17:31）完成了一批 bringup 层的**麦克风接线文档与控制逻辑/测试更新**，
这是两次汇总之间唯一的实质性工程进展。

## 二、各分项现状

| 分项 | 当前状态 | 待办 / 缺口 |
|---|---|---|
| 主控 | ESP32-S3 实机验收通过（bringup 14 组 / 259 项 / 0 失败） | 整机并发与长期稳定性 |
| 屏幕 | 旧 TOUGLESY 屏点亮运行中；A4/A5 已按新屏 HS24S010B 建模 | 新屏未购买/到货；无旋钮固件适配 |
| 麦克风 | **INMP441 首次接通**（BCLK=GPIO4、WS=GPIO5、SD=GPIO6，L/R 接地），`mic start/read/swap/stop` 命令已进 bringup | 录音→ASR→对话→TTS 全链路未通 |
| 舵机 | 单舵机（GPIO18 临时路径）可动；双舵机已入主固件；限幅 1000–2000µs | 八路 PCA9685、关节标定、单腿与步态 |
| 网页控制台 | https://papa.papaclaoud.top/ 正常，设备在线（昨日 health 查询 ok） | AP 配网、多设备 |
| PCB | RevB 交付完整；integrated-v1 V1.2 无旋钮版 DRC/Gerber 全过，9-13 起以用户在线最新版为准 | 打样/SMT 下单、焊接、上电实测 |
| 结构 | **A5 为当前版本**：31 件 STL + 5 试配件 + 9 渲染，拓扑/干涉/姿态/拆卸检查全过；A5 膝关节下移 6mm，与 A4 零件不通用 | 试配件实物打印、实装 |
| 电池供电 | 格氏 ACE800 2S 选型定版 | 采购、充电/负载/温升实测 |
| 采购 | 立创报价 ¥230.88（9-14）已归档但 **24h 时效已过，需重新匹配** | 补 MRO、重新下单 |

## 三、昨日 16:08 之后的增量（本次巡检重点）

全部集中在 `firmware/bringup/`，9-14 17:12–17:31 之间完成：

1. **麦克风接线固化进真值链路**：`wiring.json` 新增 `mic` 段 → `generate_wiring.py`
   生成 `board_config.h`（`MIC_BCLK/MIC_WS/MIC_SD`）。接线判别法记录：
   `mic swap` 对调时钟后若输出全零，说明原接线正确。
2. **实测踩坑已记录**：MEMS 麦有约 1% 满量程的直流偏置，算声级必须先扣直流；
   扣除后交流本底约 -53 dBFS。
3. **控制逻辑与主机测试更新**：`control_logic.h`、`main.cpp`、
   `test_control_logic.cpp` 均有改动。
4. **接线文档体系成型**：新增/重渲染《INMP441麦克风接线.md》《舵机接线.md》
   及 3 张 SVG 接线图、2 张 CSV 接线表、舵机速查卡、docs/index.html，
   由 `render_docs.py` 统一生成——今后接线资料改 `wiring.json` 重跑脚本即可。

## 四、待用户确认 / 补充的事项

- PCB（RevB / integrated-v1）与 A5 试配件是否已下单、到货。
- 立创报价单已过时效，需重新匹配后再决定下单。
- 现用测试舵机实物型号（MG90S 还是 SG90）。
- 新屏开窗与面板的对位偏差（开窗比屏宽仅大 0.4mm、中轴右偏约 2.6mm）是否为刻意设计。

## 五、建议的下一步顺序

1. 立创重新匹配下单 + 补 MRO；确认 PCB/打印订单状态。
2. 语音链路推进：在已接通的 INMP441 上完成录音→ASR→TTS 一次闭环。
3. 舵机：单舵机标定 → 单腿两关节 → PCA9685 八路。
4. A5 试配件打印与关键件实装。
5. 电池/充电/负载实测，再组合整机。

## 证据索引

- `项目进度总览.md`（9-12/9-13 版）—— 版本线与各分项口径的权威入口（自身已滞后于 A5）
- `firmware/bringup/wiring.json` / `include/board_config.h` / `src/main.cpp`（9-14 17:2x）
- `firmware/bringup/docs/INMP441麦克风接线.md` / `舵机接线.md` / `index.html`（9-14 17:12–17:31）
- `mechanical-design/structure-a5/` —— A5 交付与检查报告
- `pcb-design/integrated-v1/user-latest-review-2026-09-13/核对结论.md` —— PCB 当前制板入口
- `project-status-history/20260914-1608/项目进度汇总.md` —— 上一份汇总
