xaiojie/papabot/hardware-selection/bom-v7/history/servo-mg90s-180.md

# 舵机选型：MG90S 全金属齿轮 180 度

日期：2026-09-07。用户要求从两张商品截图中确定所需型号；本轮选定图二已勾选的 **「MG90S舵机（全金属齿轮）180度」**，用于四足样机。尚无下单、收货或负载验证记录。

## 所选商品与数量

| 项目 | 决定或依据 |
| --- | --- |
| 商品型号 / SKU 原文 | MG90S舵机（全金属齿轮）180度 |
| 控制要求 | 可控制目标角度的定位舵机；不选连续旋转版本 |
| 整机数量 | 8 个，四条腿各 2 个 |
| 截图单价 | 人民币 10 元 / 个 |
| 舵机小计 | 8 × 10 = 80 元；不是整机 BOM 总价 |
| 先行试样建议 | 2 个组成单腿样机，截图价格小计 20 元；验证后补齐其余 6 个 |
| 配件线索 | 主图展示三线接头、塑料舵盘与螺丝，实际随包数量及规格待核实 |
| 采购状态 | 仅完成选型；未执行加入购物车、下单或付款 |
| 价格证据 | 用户提供的商品截图；未核实实时结算价、运费或批量价格 |

商品页面完整链接未出现在截图中，未推断商品 ID。依据保存在 [图二：所选 MG90S](reference/servo-option-2-mg90s-180-selected.png) 和 [图一：对照 SG90](reference/servo-option-1-sg90-selected.png)。

图一当前选中的是「SG90舵机（塑齿轮）90–180度」，5.8 元属于该选项，不能套用到 MG90S。图一也列出了同名 MG90S 全金属 180 度 SKU，但其选中价格未展示。图二的规格与价格对应关系更明确。

## 选择理由与机械接口

腿部关节需要保持和重复到达目标角度，故选择 180 度定位款。优先使用商家标注的全金属齿轮款作为承载关节的样机方向，不选「三个塑料齿轮」混合款或「塑齿轮 360 度」选项；内部齿轮材质仍需实物确认。连续旋转舵机与定位舵机用途不同，可参考 [TowerPro 连续旋转款产品资料](https://towerpro.com.tw/product/sg90-360-degree-continuous-rotation-servo/)。

舵机是外购成品。腿、支架和装饰盖由项目设计；优先通过配套舵盘连接输出轴，再将腿件固定到舵盘。全金属齿轮不意味着舵盘或外壳也是金属。assembly-v1 中的八个蓝色模型仍是旧占位体，本次没有替换模型，也没有冻结安装孔或承载结构。

## 建模和试样前需取得的数据

1. 该店实物的外壳尺寸、安装耳总长、孔距 / 孔径、输出轴中心位置及高度、线缆出口位置。
2. 所附舵盘的厚度、孔距、轴配合与中心螺丝规格；采用实物配套舵盘，不直接凭照片打印花键接口。
3. 供电范围、PWM 信号要求、可用角度范围和限位；上电先回中，再校准各关节端点。
4. 在预计整机重量和腿长下的单腿保持 / 运动能力、温升和电流；据此确定供电与能否扩展到整机。选中型号不等于承载和行走已经验证。

[TowerPro MG90S 官方资料](https://towerpro.com.tw/product/mg90s-3/)列出本体标称 22.8 × 12.2 × 28.5 mm、重量 13.4 g、4.8 V 下堵转扭矩 1.8 kgf·cm，可作型号尺度参考。当前淘宝商品未核实为同一厂家和版次，不能把这些数值直接作为这批商品的加工或电气依据。堵转扭矩也不能当作可长期使用的工作扭矩。

下一阶段据该店尺寸图和实物数据替换舵机占位模型，重做贴近已选参考图的腿部支架，并完成单腿试配。屏幕平齐改造仍是独立待处理项。

## 本轮补充商品外观图

用户表示商家没有工程尺寸图，提供了[MG90S黑色机身及配套舵盘照片](reference/servo-mg90s-product-photo.png)。本次采购数量为**8个**，每腿2个；单腿试样从8个中取2个，备用不计入基本数量。照片用于外观和可调整包络，安装耳孔距、轴心和舵盘配合由实物测量后冻结。不直接用照片制作精确花键。
