xaiojie/papabot/pcb-design/integrated-v1/repair-2026-09-12/修复与检查记录.md

# 新版原理图修复与 PCB 转换记录

> **本页是原理图修复与初始 PCB 转换阶段快照。** 后续已修正 J3 为 10 针屏幕线束接口，当前为 83 个器件、323 个引脚、45 个 NC；有效显示图页 UUID 为 `2f4bfc0bfa3d836a`。PCB 全部布局布线与双面接地填充现已完成，最终工程、BOM、PDF 和 Gerber 请从 [最终交付](../final-2026-09-12/README.md) 获取。

2026-09-12 · DesktopAssistant_Integrated · 嘉立创EDA专业版 3.2.149

**已完成原理图修复、原生 DRC 检查和关联 PCB 转换。PCB 当前是元件与飞线已导入的初始稿，尚未做板框、布局、布线和制造检查。**

本记录及下列导出文件优先于 integrated-v1 目录内较早的选品、BOM、原理图、网络表与摆放方案。

## 可直接使用的文件

- [完整可编辑工程](generated/DesktopAssistant_Integrated_SCH_checked_PCB_imported_20260912.epro2)
- [五页原理图 PDF](generated/Integrated_schematic_final.pdf)
- [当前 BOM：从原生原理图网表导出](generated/当前BOM.csv)
- [当前全部引脚网络表](generated/当前引脚网络表.csv)
- [原理图核对结果](generated/verification.json)
- [PCB 导入核对结果](generated/pcb-verification.json)
- [修改前完整备份](before/DesktopAssistant_Integrated_before_repair.epro2)
- [原理图通过检查、尚未创建 PCB 时的备份](generated/Integrated_schematic_verified.epro2)

BOM 仅含板载器件。外部开发板、降压模块、麦克风/功放模块、电池、温度探头、7.5A 保险丝、开关、跳帽帽和线束须另列装配清单。库存及价格未在本次重新核验。

## 原理图布局

原单页拆为五张原生可编辑 A3 图页，按电源与信号流向排列。每页使用功能分区、统一对齐、短导线及网络标签；跨页同名网络在原生网表中核验。消除了旧单页拥挤和区域重叠。

| 页 | 内容 | 当前 UUID |
|---|---|---|
| 01_电池保护与均衡 | 电池/平衡接口、保护 IC、背靠背 MOS、两节均衡 | 654247b3dab7ee5f |
| 02_USB充电 | USB-C、同步升压充电、NTC、使能和状态 | 1b2919cc1262fe39 |
| 03_配电与主控 | 保险丝/开关、两路外置降压接口、ESP32 插座、采样 | 8e03abe4b069eaeb |
| 04_显示音频与交互 | 3.3V 屏幕支路、I²S 模块线束、编码器 | 6aaab90468b1a4a8 |
| 05_舵机控制 | PCA9685、默认禁止输出、八路三针舵机接口 | 7020da259480076a |

已逐页检查实际 PDF 渲染；图片 `generated/final-sheet-1.png` 至 `final-sheet-5.png` 对应上述顺序。

## 修复的电路问题

1. **保护与均衡**：U1 改为 HY2120-CB；修正 R1/R2 与检测端滤波；分开原始电池负极 `VBAT_RAW_N` 和保护后 `GND`；修正 Q1/Q2 源极、栅极及共漏极连接。U2/U3 使用适合 N-MOS 驱动的 HY2213-BB3A，按其实际引脚定义连接；加入每节 100Ω/100nF 滤波、220Ω 泄放和 100kΩ 栅极下拉。均衡电流约 19mA，4.2V 时泄放电阻功耗约 0.08W。
2. **充电**：纠正 IP2325 的电流配置/拓扑问题，改用 IP2326 2S 同步升压充电电路；VSYS 与 VOUT 分离，充电返回接保护后 GND。255kΩ ISET 对应公式计算约 0.353A；VSET/CON_SEL 按 8.4V/2S 默认配置。使用外部 100kΩ B4100 NTC 探头接口，82kΩ 并联电阻；默认 JP_CHG 断开、EN 下拉禁止充电。
3. **配电**：原误用二极管的 SW1 改为外部直流开关线束接口 J_SW；保险丝与保险丝座只保留一条串联电气路径，7.5A 插片作为装配件。逻辑与舵机降压模块改为明确的输入/输出端子，两个 5V 输出正极分离。JP_MCU 默认断开，用于 USB 调试供电隔离。
4. **屏幕、音频与控制**：保持 `LCD_3V3` 支路、JP_LCD 默认断开和 J10 外部 3.3V 输入；补充去耦及编码器按键上拉。麦克风和功放使用按信号标明的线束接口。
5. **舵机**：PCA9685 使用 3.3V、OE 10kΩ 上拉默认禁止输出、EXTCLK 接地并补去耦；八路接口统一为 1=PWM、2=+5V_SERVO、3=GND。
6. **真实器件与封装**：三个跳帽采用 B-2100S02P-A110（C124375）；八个舵机排针采用 PZ254V-11-03P（C2937625）。保留位号与唯一 ID，完成实际器件标准化。

## 检查证据

| 检查 | 结果 |
|---|---|
| 嘉立创EDA原生原理图 DRC | 致命错误 0、错误 0、警告 0；严格通过返回 true |
| DRC 信息提示 | 24 条内容提示，关于描述性位号格式及 IC/连接器空 Value；保留检查规则，未屏蔽 |
| 原理图器件 / 引脚 / 网络 | 83 / 333 / 62 |
| 有意 NC 引脚 | 55 |
| 单引脚孤立网络 | 0 |
| 原生网表逐引脚与审阅连接表比较 | 不一致 0 |
| 保护、充电、供电隔离和舵机等独立功能约束 | 15 / 15 通过 |
| PCB 封装 / 焊盘 / 网络 | 83 / 333 / 62 |
| 原理图 → PCB 焊盘网络比较 | 不一致 0；漏件 0；多余焊盘 0 |
| 工程 ZIP 完整性 | CRC 通过 |

DRC 面板“全部/信息”计数可能包含开始/完成日志；结果日志明确为 24 条信息提示。通过的是**原理图**检查，不代表已完成 PCB 布线或实物电气测试。

## PCB 结果与下一阶段

PCB 名称 `PCB1`，UUID `bc31667e02a33e5b`，属于 `Board1`，关联原理图 UUID `6c93ab84d69093e6`。已在 EDA 中实际应用导入修改，并确认画布上存在封装与飞线，保存成功。

接下来需要先核对结构与接口位置，再做分区布局、关键回路与大电流走线、地回流及铺铜。此前 110×75mm、两层/1.6mm/2oz 是候选参数，本次尚未锁定板框，也未生成打样 Gerber。开发板两排插座、屏幕、模块安装和线束出线位置须随实物/结构一起复核。

充电电流约 0.353A 是公式值；ISET 所选值在数据表典型 0.5A 示例之外，应在接实际电池之前验证恒流、截止、超时和 NTC 动作。保护/均衡阈值、MOS 温升、舵机启动峰值及供电压降也需台架测试。当前未进行实物上电、充放电、固件烧录或舵机动作。

## 工程备份与复现注意

最终完整工程的 SHA256：`ef5bd5fc0dd64f179a90b38133af8bc139c224f996fcab08db2e3cc03968aea9`。

`audit/` 保留 Bridge 调用及结果；`final-01.source` 至 `final-05.source`、`final-pcb.source` 是最终原生源快照，原生网表及 DRC JSON 在 `generated/`。

本版 EDA 对已有图页调用 `setDocumentSource()` 后，曾出现画面更新但原生网表缓存未更新的问题。已通过创建新图页、恢复经审阅源文件，并以原生网表逐引脚核对解决。不要对现有图页直接重跑 `apply_schematic.py`、`polish_layout.py` 或旧版 `fix_metadata.py`；它们保留作审计，不作为最终工程入口。当前应打开上述最终 epro2 工程继续工作。
