xaiojie/papabot/docs/history/project-status/20260912-163905/项目进度总览.md

# 桌面助手 · 项目进度总览

> 整理时间：2026-09-11
> 依据：仓库实际文件 + 实机遥测 + 真实 API 返回
> **本文替代 `PROGRESS.md`（2026-09-10 版），补充了 PCB 三条线的完整状态**

---

## 0. 一句话状态

**PCB 从未弃用 —— RevA 和 RevB 都是 DRC 通过、Gerber 齐全的完整设计。RevB（含中文丝印）是当前可下单的版本。**

**新做的「单板全集成」是第三条线，目前只完成了原理图，PCB 还没导入成功 —— 它是补充方案，不是替代品。**

未完成的：PCB 下单、结构件打印、整机组装、电池定制。

---

## 1. PCB：三条并行线（关键）

### 1.1 总览

| 版本 | 定位 | 状态 | 产物 |
|---|---|---|---|
| **RevA** | 第一版载板 | ✅ **完成，可下单** | Gerber + 检查包 + 原生工程 |
| **RevB** | 第二版载板 | ✅ **完成，可下单（推荐）** | Gerber + 复核包 + 原生工程 |
| **RevB + 中文丝印** | 装饰版 | ✅ **完成，可下单** | Gerber + 原生工程 |
| `integrated-v1` | 单板全集成 | ⚠️ **仅原理图** | 无 Gerber |

> **⚠️ 重要：RevA / RevB 的所有产物、Gerber、原生工程都完整保留，随时可下单。**
> 用户从未决定弃用它们。

---

### 1.2 RevA（第一版）

**产物：**
```
pcb-design/native-rev-a/
├── DesktopAssistant_RevA_Gerber_review.zip      ← Gerber 制板文件
├── DesktopAssistant_RevA_PCB检查包.zip           ← 复核包
├── DesktopAssistant_RevA_PCB_review.epro2        ← 原生工程（313,757 字节）
└── history/                                     ← 4 个历史快照
pcb-design/rev-a/
├── DesktopAssistant_RevA.eprj2                  ← 嘉立创工程源
├── 01-controller-pinout.csv                     ← ★ 引脚映射（唯一真相）
├── 02-gpio-plan.csv
├── 03-logical-netlist.json
├── 04-connector-map.csv
└── board-interface.svg / power-schematic.svg / signal-schematic.svg
```

**验证数据（`delivery-manifest.json`）：**
```
native_pcb_drc_pass:        True
native_schematic_drc_pass:  True
geometry_pass:              True
connected_nets:             25
orphan_copper_count:        0
```

**已知缺陷**：无铺铜地平面（这是做 `integrated-v1` 时的改进动机之一）

---

### 1.3 RevB（第二版 · 当前推荐）

**产物：**
```
pcb-design/native-rev-b/
├── DesktopAssistant_RevB_Gerber_review.zip       ← Gerber 制板文件
├── DesktopAssistant-RevB-PCB复核包.zip            ← 复核包（1,641,548 字节）
├── README.md                                     ← 电路/装配/上电说明
└── before/                                       ← 修改前快照
```

**验证数据（`delivery-manifest.json`）：**
```
native_pcb_drc_pass:        True
native_schematic_drc_pass:  True
geometry_pass:              True
gerber_geometry_matches:    True      ← Gerber 与几何逐项一致
connected_nets:             26
component_pads:             104
orphan_copper_count:        0
```

**复核包内容（`delivery-check.json`）：**
```
passed:              True
zip_crc_pass:        True
manifest_files:      28 个
pin_csv_rows:        104
bom_csv_rows:        25
screen_csv_rows:     12
```

---

### 1.4 RevB + 中文丝印（Jay / 爬爬）

**产物：**
```
pcb-design/revb-lettering-2026-09-10/
├── DesktopAssistant_RevB_Jay_PaPa_Gerber.zip     ← ★ 带名字的 Gerber
├── DesktopAssistant_RevB_Jay_PaPa.epro2          ← 带名字的原生工程
├── gerber-top-preview.png                        ← Gerber 正面预览
├── verification.json                             ← 验证记录
└── before/                                       ← 修改前工程和 PCB 源文件
```

**丝印细节：**
```
位置：正面左上方，J7 左侧，约 3mm 高，普通白色丝印
内容：「Jay」（可编辑文字）+「爬爬」（6 块锁定实心矢量，不依赖中文字库）
尺寸：13.32 × 3.00 mm，距上板边 1.20 mm
最近阻焊开窗间距：1.38 mm
```

**验证数据（`verification.json`）：**
```
passed:                              True
native_project_existing_records_unchanged: True
new_top_silkscreen_objects:          7
native_pcb_drc_errors:               0
gerber_geometry_rounding:            1e-5 mm
existing_top_silk_unchanged:         True
lettering_only_no_circuit_or_mechanical_change: True
129 个电镀孔（含 25 过孔）+ 4 个非电镀孔不变
fabrication_order_placed:            False   ← 未下单
```

> **本目录替代旧版无名字的 Gerber，作为当前文字版交付入口。**

---

### 1.5 integrated-v1（单板全集成 · 新方案）

**动机**：把原来分散的模块（充电板、舵机降压、逻辑降压…）整合到一块 PCB

**已完成：**
```
✅ 嘉立创EDA 里的原理图
   工程 DesktopAssistant_Integrated  (50ae04bdafb74b93b94b7cc4c08171e1)
   58 元件 / 225 网络端口 / 223 导线 / 50 种网络 / 10 个区块
   图纸 A3
   DRC: 0 致命错误 · 0 错误 · 2 个建议性警告
```

**未完成：**
```
❌ PCB 导入 —— pcb_Document.importChanges() 返回 true 但 PCB 里 0 元件
   试过：无参 / 传原理图页 UUID / 传 Schematic UUID / 先存原理图再导
   待查：是否弹了确认对话框
```

**⚠️ 两个必须先解决的问题：**
1. **HY2213 引脚定义未核实** —— 官方手册是 PDF 抓不到，`BAL_GATE1/2` 目前标 NC
2. **BOM 里 HY2213-AB3B 要改成 BB3A** —— AB3B 是 P-MOS 版，配不上 N-MOS 的 AO3400A

**结论**：`integrated-v1` 是**探索性方案**，在 PCB 导出验证完成前，**RevB 仍是主交付版本**。

---

## 2. 固件：两个工程，都实机验证过

| 工程 | 定位 | 代码量 | 单测 | 状态 |
|---|---|---|---|---|
| `firmware/bringup/` | bench-v1 硬件自检 | 4,390 行 | 14 用例 / 259 检查 | ✅ 实机通过 |
| `firmware/assistant/` | 产品固件 六屏应用 | 2,496 行 | 5 用例 / 25 检查 | ✅ 实机跑通 |

**两者分开、互不覆盖**：bench-v1 是「板子是否正常」的判据，assistant 是产品。

**八屏全部完成**（① 表情 23fps ② 数字时钟 ③ 表盘时钟 ④ 天气 ⑤ 账号额度 ⑥ 状态 ⑦⑧ GIF）

**构建占用**：
```
RAM    [==        ]  22.3%   (73,112 / 327,680 字节)
Flash  [====      ]  42.6%   (1,422,493 / 3,342,336 字节)
```

**三个关键技术决定**（都有实测支撑）：
- **脏矩形刷新**：全屏 7.5fps → 表情区 160×136 达到 **23fps**
- **自带中文字库**：4,444 字形 / 16px+24px 两套 / 521 KB（⚠️ 现用 macOS 字体，发布前须换思源黑体）
- **串口实时取景**：RLE 编码把单帧从 312KB 压到 6.8KB，**17.8fps**

---

## 3. 硬件

| 分项 | 状态 | 说明 |
|---|---|---|
| **主控** | ✅ 已到手验证 | LCKFB-ESP32S3R8N8，8MB Flash + 8MB Octal PSRAM |
| **屏幕** | ✅ 已到货点亮 | TOUGLESY 2.4″ ST7789 320×240，飞线跑通全部 8 屏 |
| **旋钮/按键** | ✅ 已到 | EC11 编码器 + KEY0 |
| **舵机** | ✅ 已能驱动 | SG90 首测通过；主固件内置控制（GPIO18，含限幅/斜率/超时三重保护）|
| **电池** | ⏸ 定制洽谈中 | 2S1P 7.4V / 真实 1000mAh / 持续 ≥10A |
| **PCB** | ⏸ **暂缓下单** | **RevA/RevB/RevB中文版都已出 Gerber，随时可下** |
| **结构件** | ⏸ 暂停 | Blender 源文件在 `mechanical-design/` |

**实机验证的硬件事实**：
```
chip      ESP32-S3 rev0
Flash     8,388,608 字节
PSRAM     heap 8,386,295 字节
LED       GPIO48 绿灯 1 Hz，PWR 红灯常亮
```

---

## 4. 采购

```
立创       10 项    ¥111.37
淘宝       26 项    ¥355.93
────────────────────────────
已知参考            ¥467.30   （不含定制电池/运费/打样）

未下单、未给商家发消息
```

**电池定制要求**（待商家确认）：
```
2S1P 7.4V / 满 8.4V，真实 1000mAh，整包持续 ≥10A
逐节保护/均衡，18AWG 短引线 + XT30 配对件
目标尺寸 75×40×20mm / 80g
```

**采购表**：`hardware-selection/bom-v7/`（V1–V6 保留历史，勿用旧生成器覆盖 V7）

---

## 5. 外部集成（都已打通）

| 数据源 | 状态 | 踩到的坑 |
|---|---|---|
| **和风天气** | ✅ 实测 `20°C 阴 18~25C` | 只开 443、无条件 gzip、TLS 握手爆 8KB 栈 |
| **sub2api 账号额度** | ✅ 实测 `公司Pro 7天100% 重置券2张` | 请求头套两层、没解 chunked |

---

## 6. 阻塞与待办

### 🔴 必须先解决

| 项 | 说明 |
|---|---|
| **integrated-v1 的 PCB 导入** | `importChanges()` 无效，需人工试「设计 → 导入变更」 |
| **HY2213 引脚定义** | 未拿到，`BAL_GATE1/2` 标 NC |
| **HY2213 型号** | AB3B（P-MOS）→ 应为 BB3A（N-MOS）|
| **字库授权** | 现用 macOS 字体，发布前须换思源黑体 |

### ⏸ 暂缓

| 项 | 说明 |
|---|---|
| **PCB 下单** | RevA/RevB/RevB中文版都随时可下 |
| **结构件打印** | Blender 源文件就绪 |
| **电池定制** | 等商家报价 |

### ❌ 未开始

- 整机组装（拆焊接线）
- 语音 / 舵机 / 供电的实物联调
- 表情与信息联动（纯软件，不依赖硬件）
- 长按 / 双击交互
- 开机配网页

---

## 7. 凭据与安全

**仓库里：零残留**（Wi-Fi 密码、和风 Key、凭据 ID、API Host、admin Key、sk- Key 全部扫过）

**设备 flash 里：**
```
Wi-Fi 密码      ✅ 不落盘（关掉 WiFi.persistent，NVS 里搜不到）
Wi-Fi SSID      ✅ 不落盘
和风 Key        ⚠️ 在 NVS（设计内，低价值）
sub2api admin Key ⚠️ 在 NVS（用户明确选择直连方案）
```

> **产品化前必须改**：admin Key 权限很高，拿到 flash 就拿到整个中转站的管理权限。
> 建议改成「服务端加一个只返回这几个数字的只读接口」。

---

## 8. 文件索引

### 入口
| 文件 | 用途 |
|---|---|
| `README.md` | 项目交接总说明 |
| `START-HERE.txt` | 最新状态速览 |
| **`项目进度总览.md`** | **本文件** |

### PCB
| 路径 | 说明 |
|---|---|
| `pcb-design/native-rev-b/` | **RevB 电路/装配/上电说明 + Gerber + 复核包** |
| `pcb-design/revb-lettering-2026-09-10/` | **RevB 中文丝印版（当前文字版交付入口）** |
| `pcb-design/native-rev-a/` | RevA Gerber + 检查包 |
| `pcb-design/rev-a/` | RevA 设计源 + **01-controller-pinout.csv（引脚映射唯一真相）** |
| `pcb-design/integrated-v1/` | 单板全集成（原理图完成，PCB 待导入）|
| `pcb-design/integrated-v1/交接说明.md` | 集成版的现状 + 避坑清单 |

### 固件
| 路径 | 说明 |
|---|---|
| `firmware/assistant/README.md` | 应用固件全部技术细节与踩坑记录 |
| `firmware/assistant/src/` | main.cpp / apps.cpp / canvas.cpp / net.cpp |
| `firmware/bringup/README.md` | 硬件自检工程说明 |

### 硬件与结构
| 路径 | 说明 |
|---|---|
| `hardware-selection/bom-v7/` | **采购底表 V7** |
| `hardware-selection/power-selection-2s.md` | 2S 供电选型 |
| `mechanical-design/` | Blender 结构件 |
| `design-coordination/` | 并行设计协调记录 |

---

## 9. 验证方式说明

本文所有「✅」都对应一种可复现的验证：

| 标记 | 含义 |
|---|---|
| 实机遥测 | 串口命令读出的真实数值（帧率、内存、RSSI、NTP）|
| 真实 API | 实际 HTTP 请求返回（和风天气、sub2api 额度）|
| 帧缓冲 dump | 从设备 PSRAM 抓出画面重建的 PNG |
| 单元测试 | 主机侧纯逻辑测试，可随时重跑 |
| 文件扫描 | 全仓库 grep 凭据字符串 |
| DRC 日志 | 嘉立创EDA 导出的设计规则检查报告 |
| Gerber 比对 | 交付 Gerber 与源几何逐项对照 |
