xaiojie/papabot/pcb-design/integrated-v1/repair-2026-09-12/generated/PCB_imported.webp

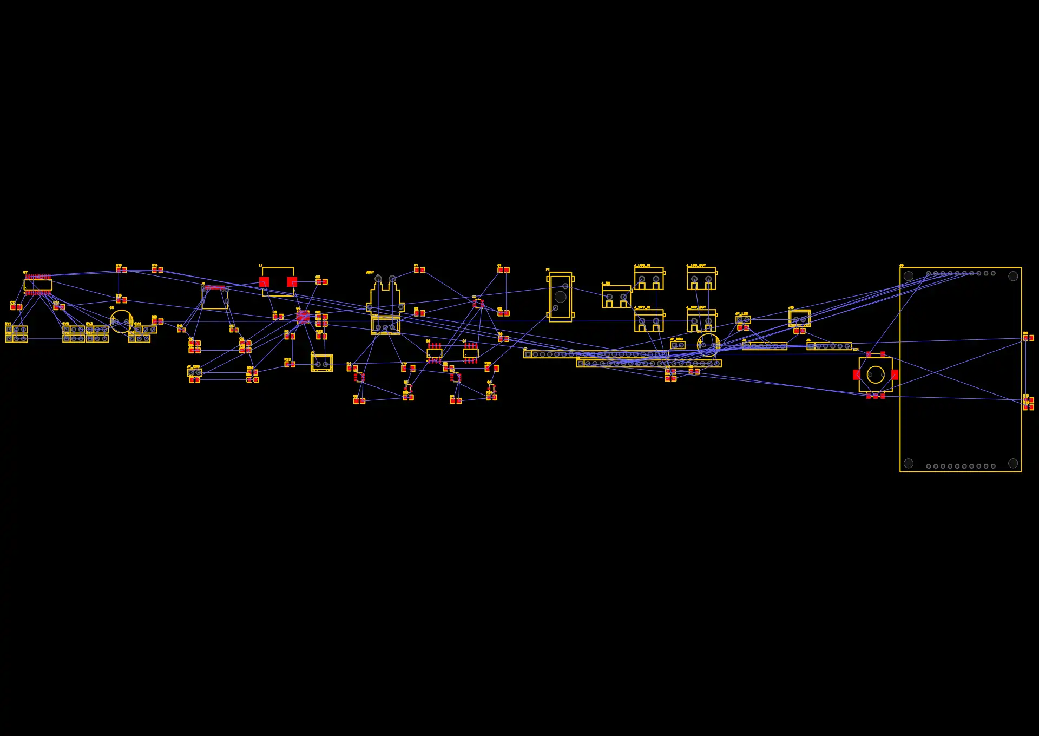
pcb-design/integrated-v1/repair-2026-09-12/generated/PCB_imported.webp
