xaiojie/papabot/pcb-design/integrated-v1/repair-2026-09-12/generated/review-1.png

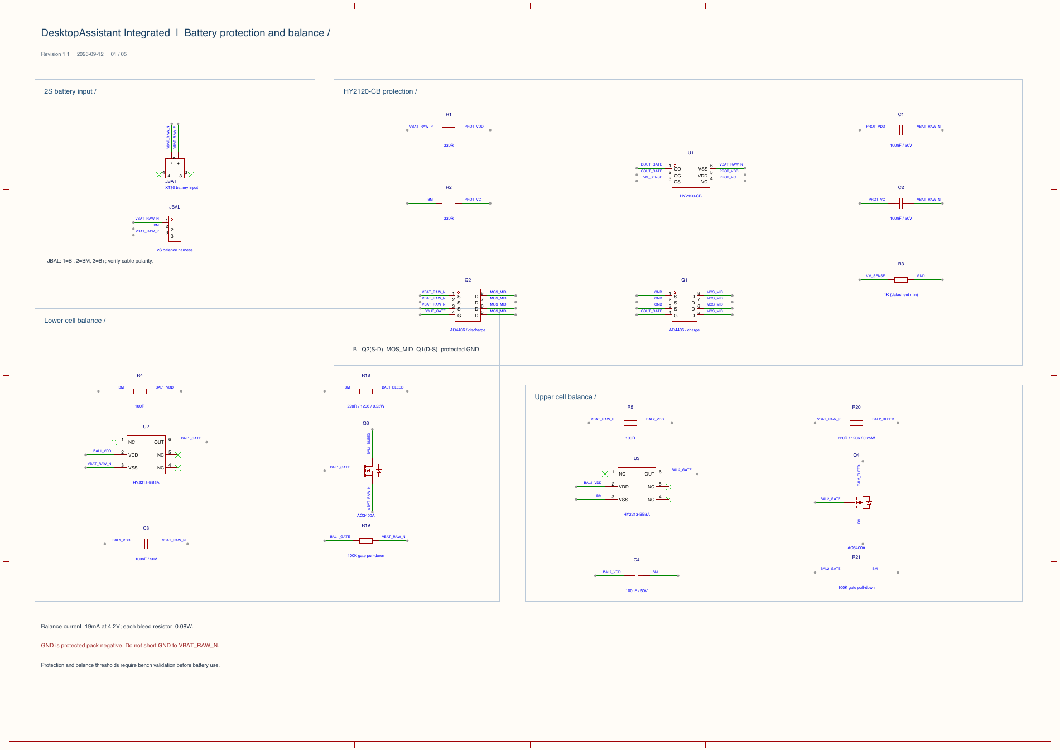
pcb-design/integrated-v1/repair-2026-09-12/generated/review-1.png
