xaiojie/papabot/pcb-design/integrated-v1/repair-2026-09-12/HY2213-application.png

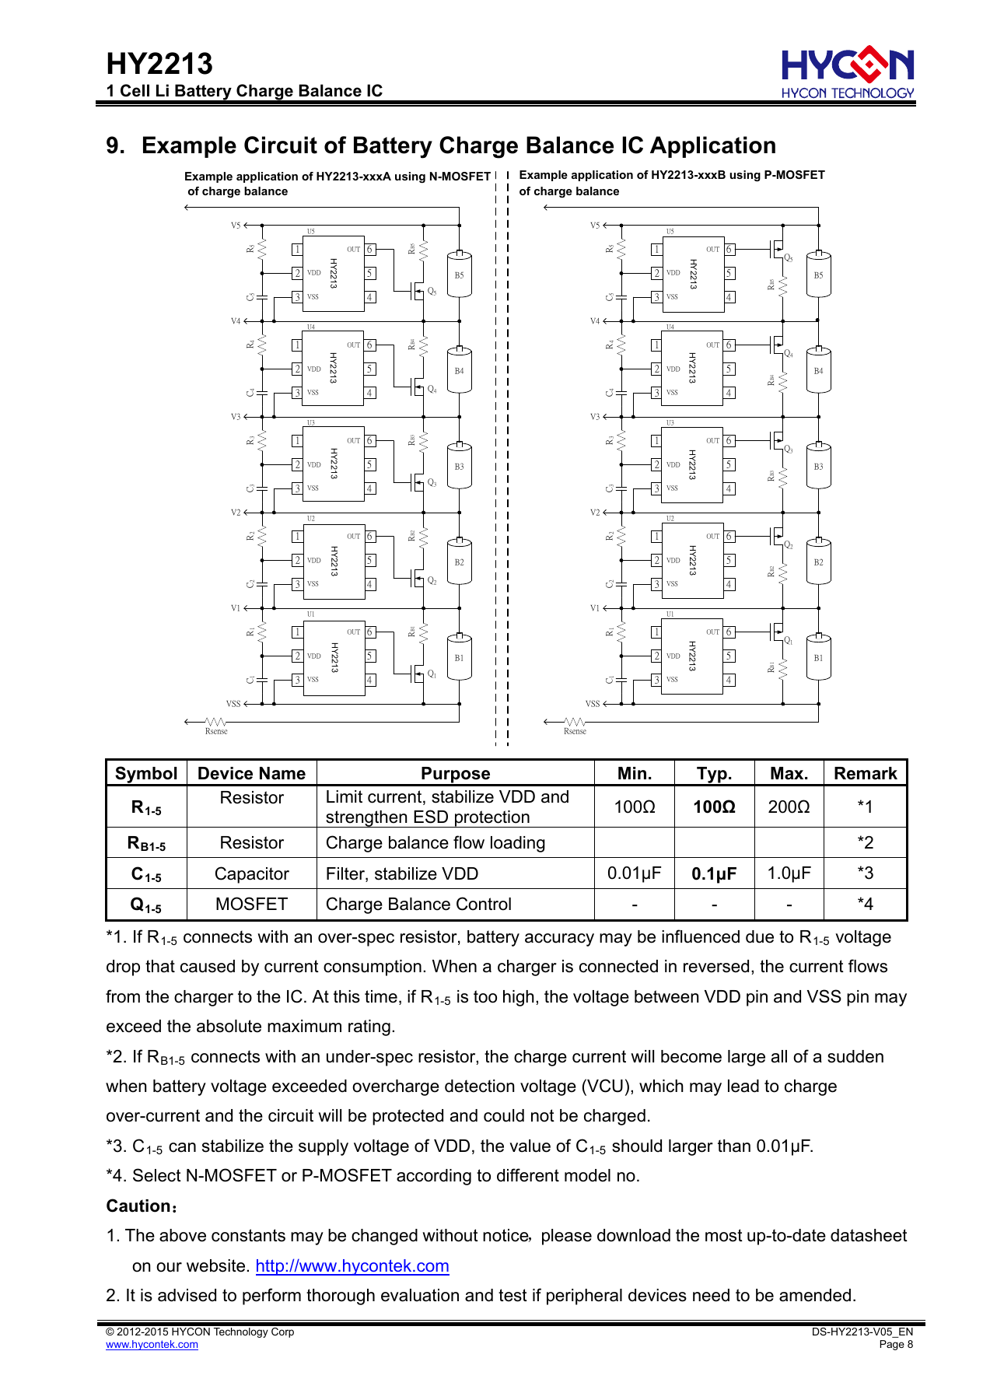
pcb-design/integrated-v1/repair-2026-09-12/HY2213-application.png
