xaiojie/papabot/pcb-design/integrated-v1/repair-2026-09-12/IP2326-application.png

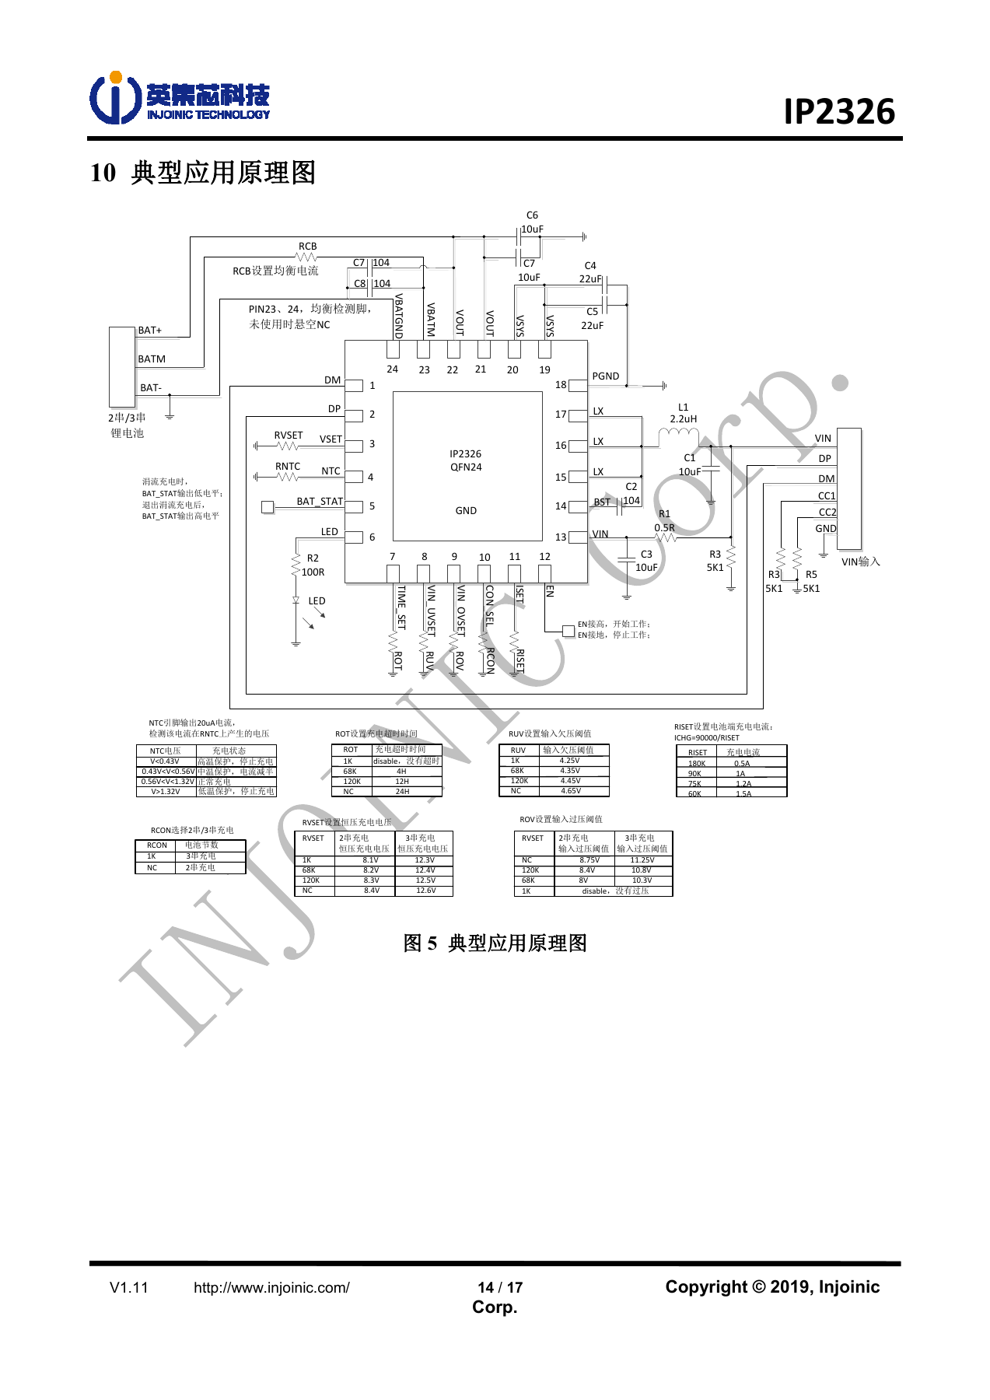
pcb-design/integrated-v1/repair-2026-09-12/IP2326-application.png
