xaiojie/papabot/pcb-design/integrated-v1/no-encoder-2026-09-12/Native_PDF_before_text_normalization.pdf

## 2S battery input / 原始电芯端

# DesktopAssistant Integrated | Battery protection and balance / 电池保护与均衡

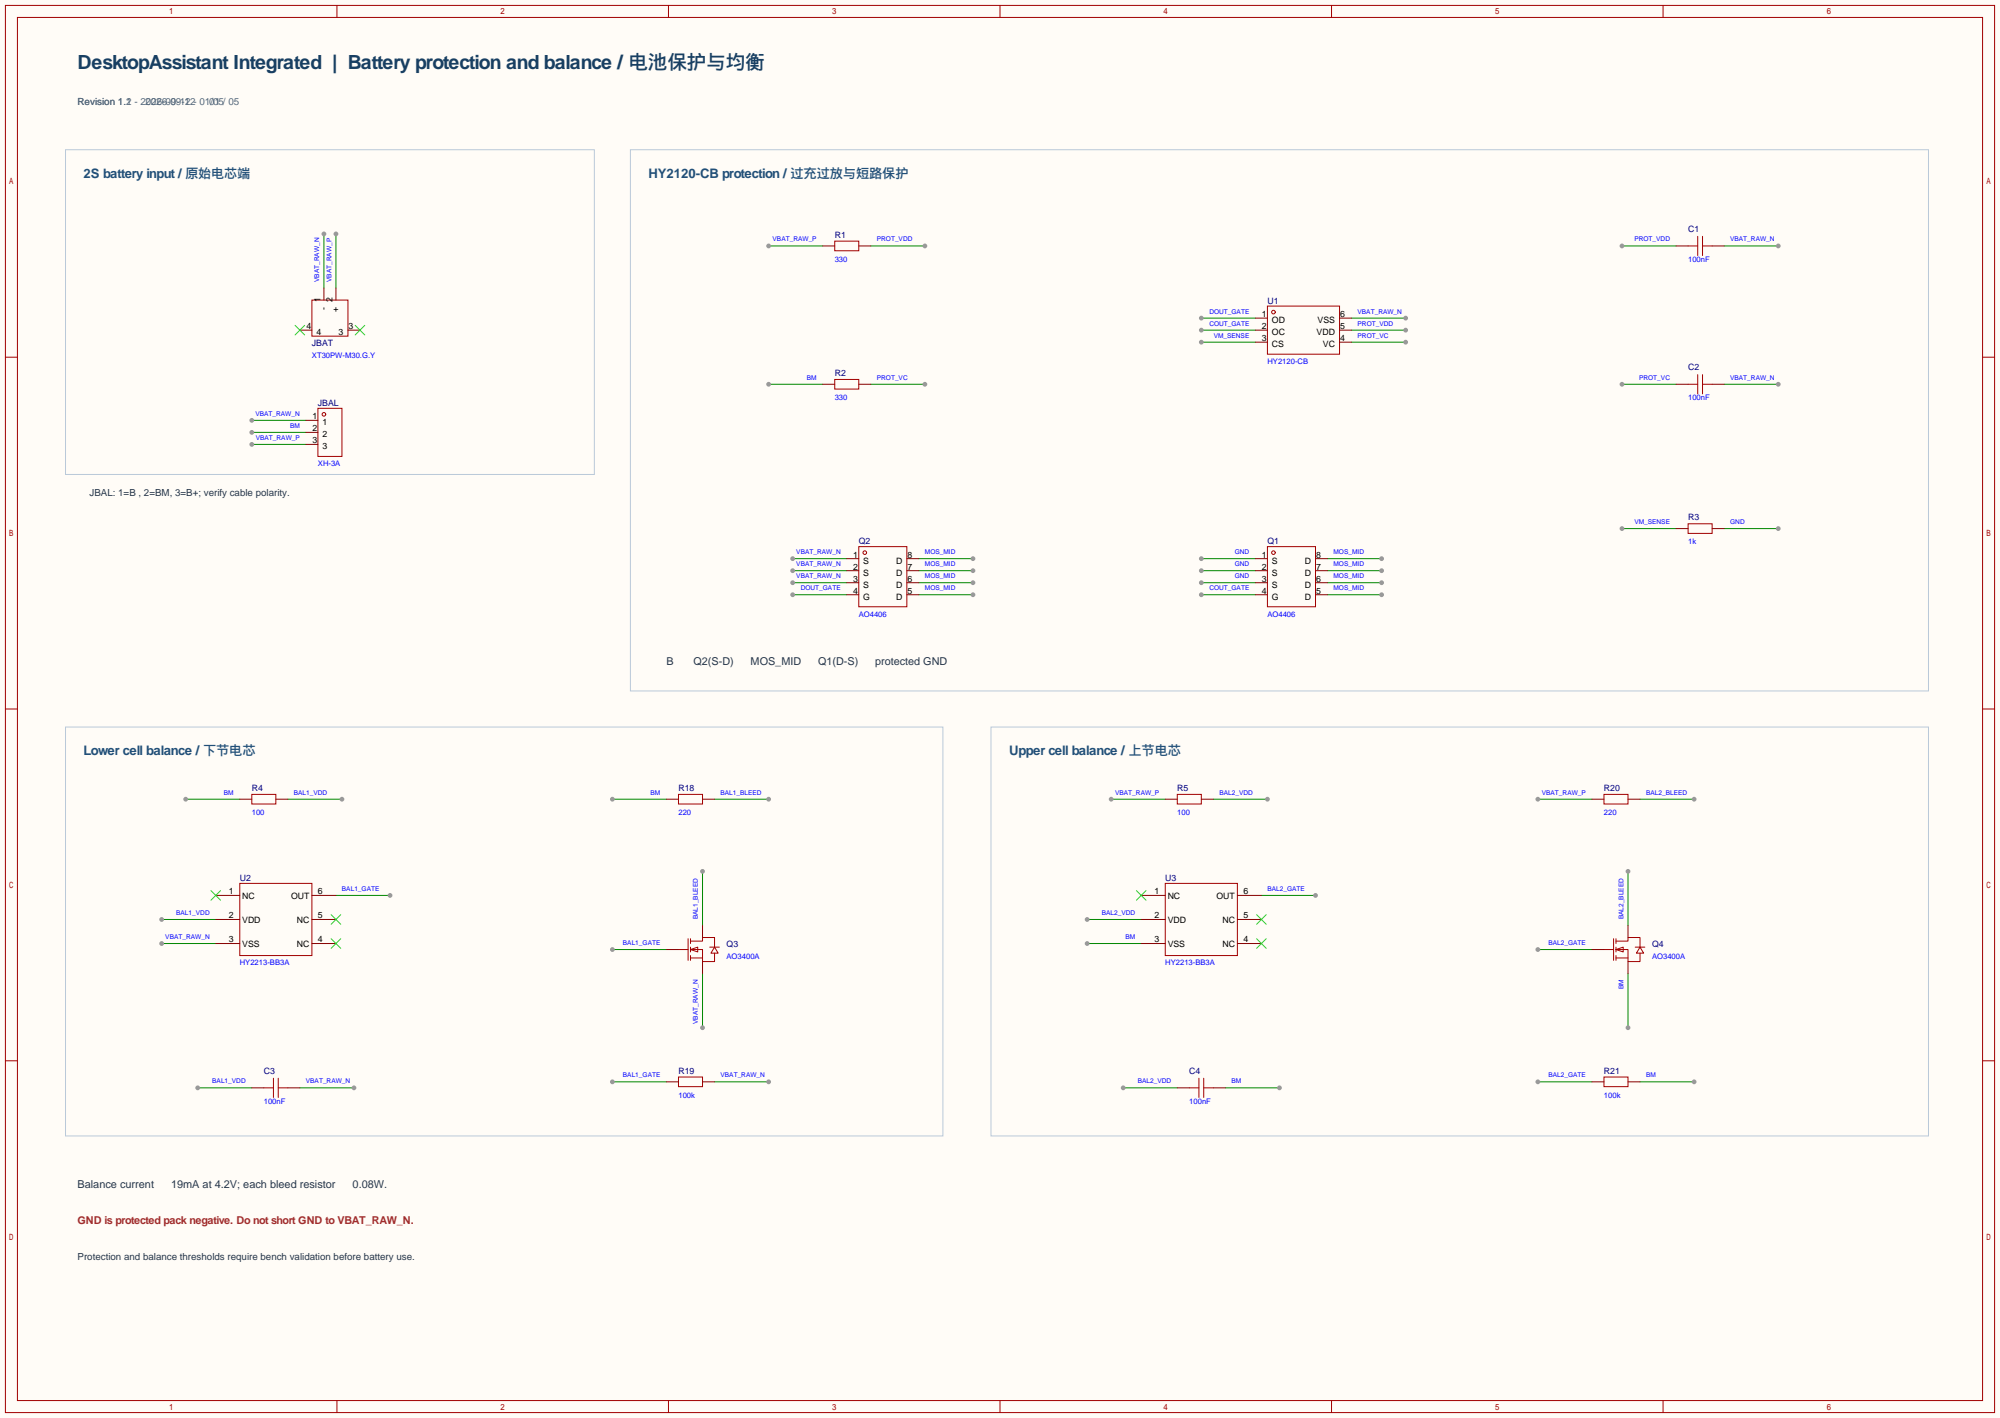
[picture p263: page 1]

JBAL: 1=B , 2=BM, 3=B+; verify cable polarity.

Lower cell balance / 下节电芯

Upper cell balance / 上节电芯

Balance current 19mA at 4.2V; each bleed resistor 0.08W.

GND is protected pack negative. Do not short GND to VBAT_RAW_N.

Protection and balance thresholds require bench validation before battery use.

## 5V USB-C input / 专用 5V 适配器

# DesktopAssistant Integrated | USB-C charger / 2S 锂电充电

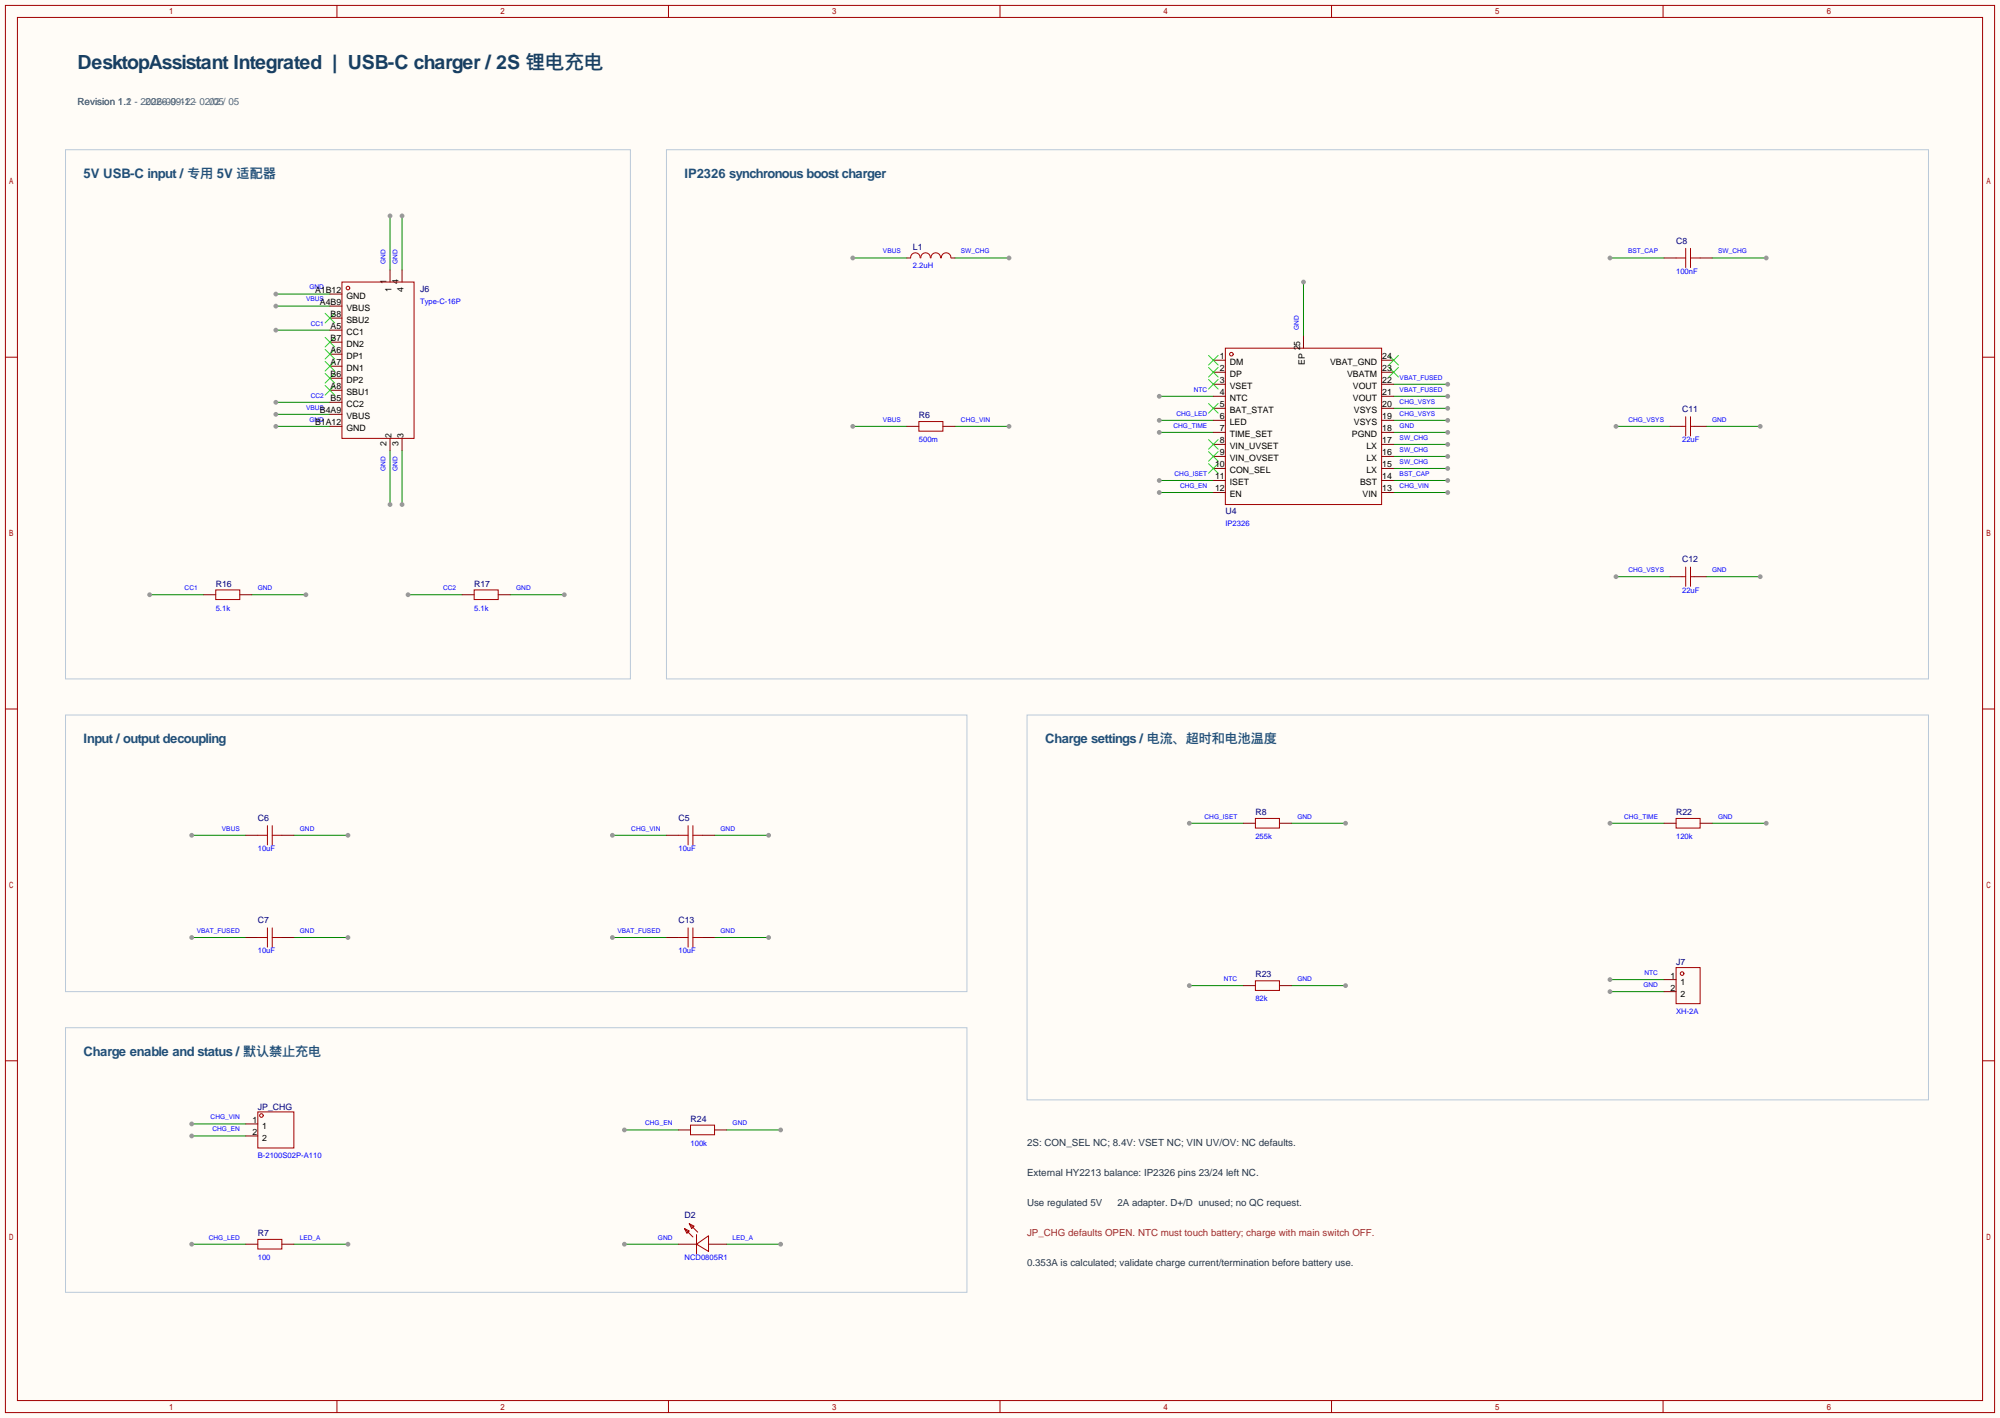
[picture p264: page 2]

Charge settings / 电流、超时和电池温度

Charge enable and status / 默认禁止充电

2S: CON_SEL NC; 8.4V: VSET NC; VIN UV/OV: NC defaults.

External HY2213 balance: IP2326 pins 23/24 left NC.

Use regulated 5V 2A adapter. D+/D unused; no QC request.

JP_CHG defaults OPEN. NTC must touch battery; charge with main switch OFF.

0.353A is calculated; validate charge current/termination before battery use.

## Protected pack fuse switch regulators

# DesktopAssistant Integrated | Power and MCU / 配电与主控

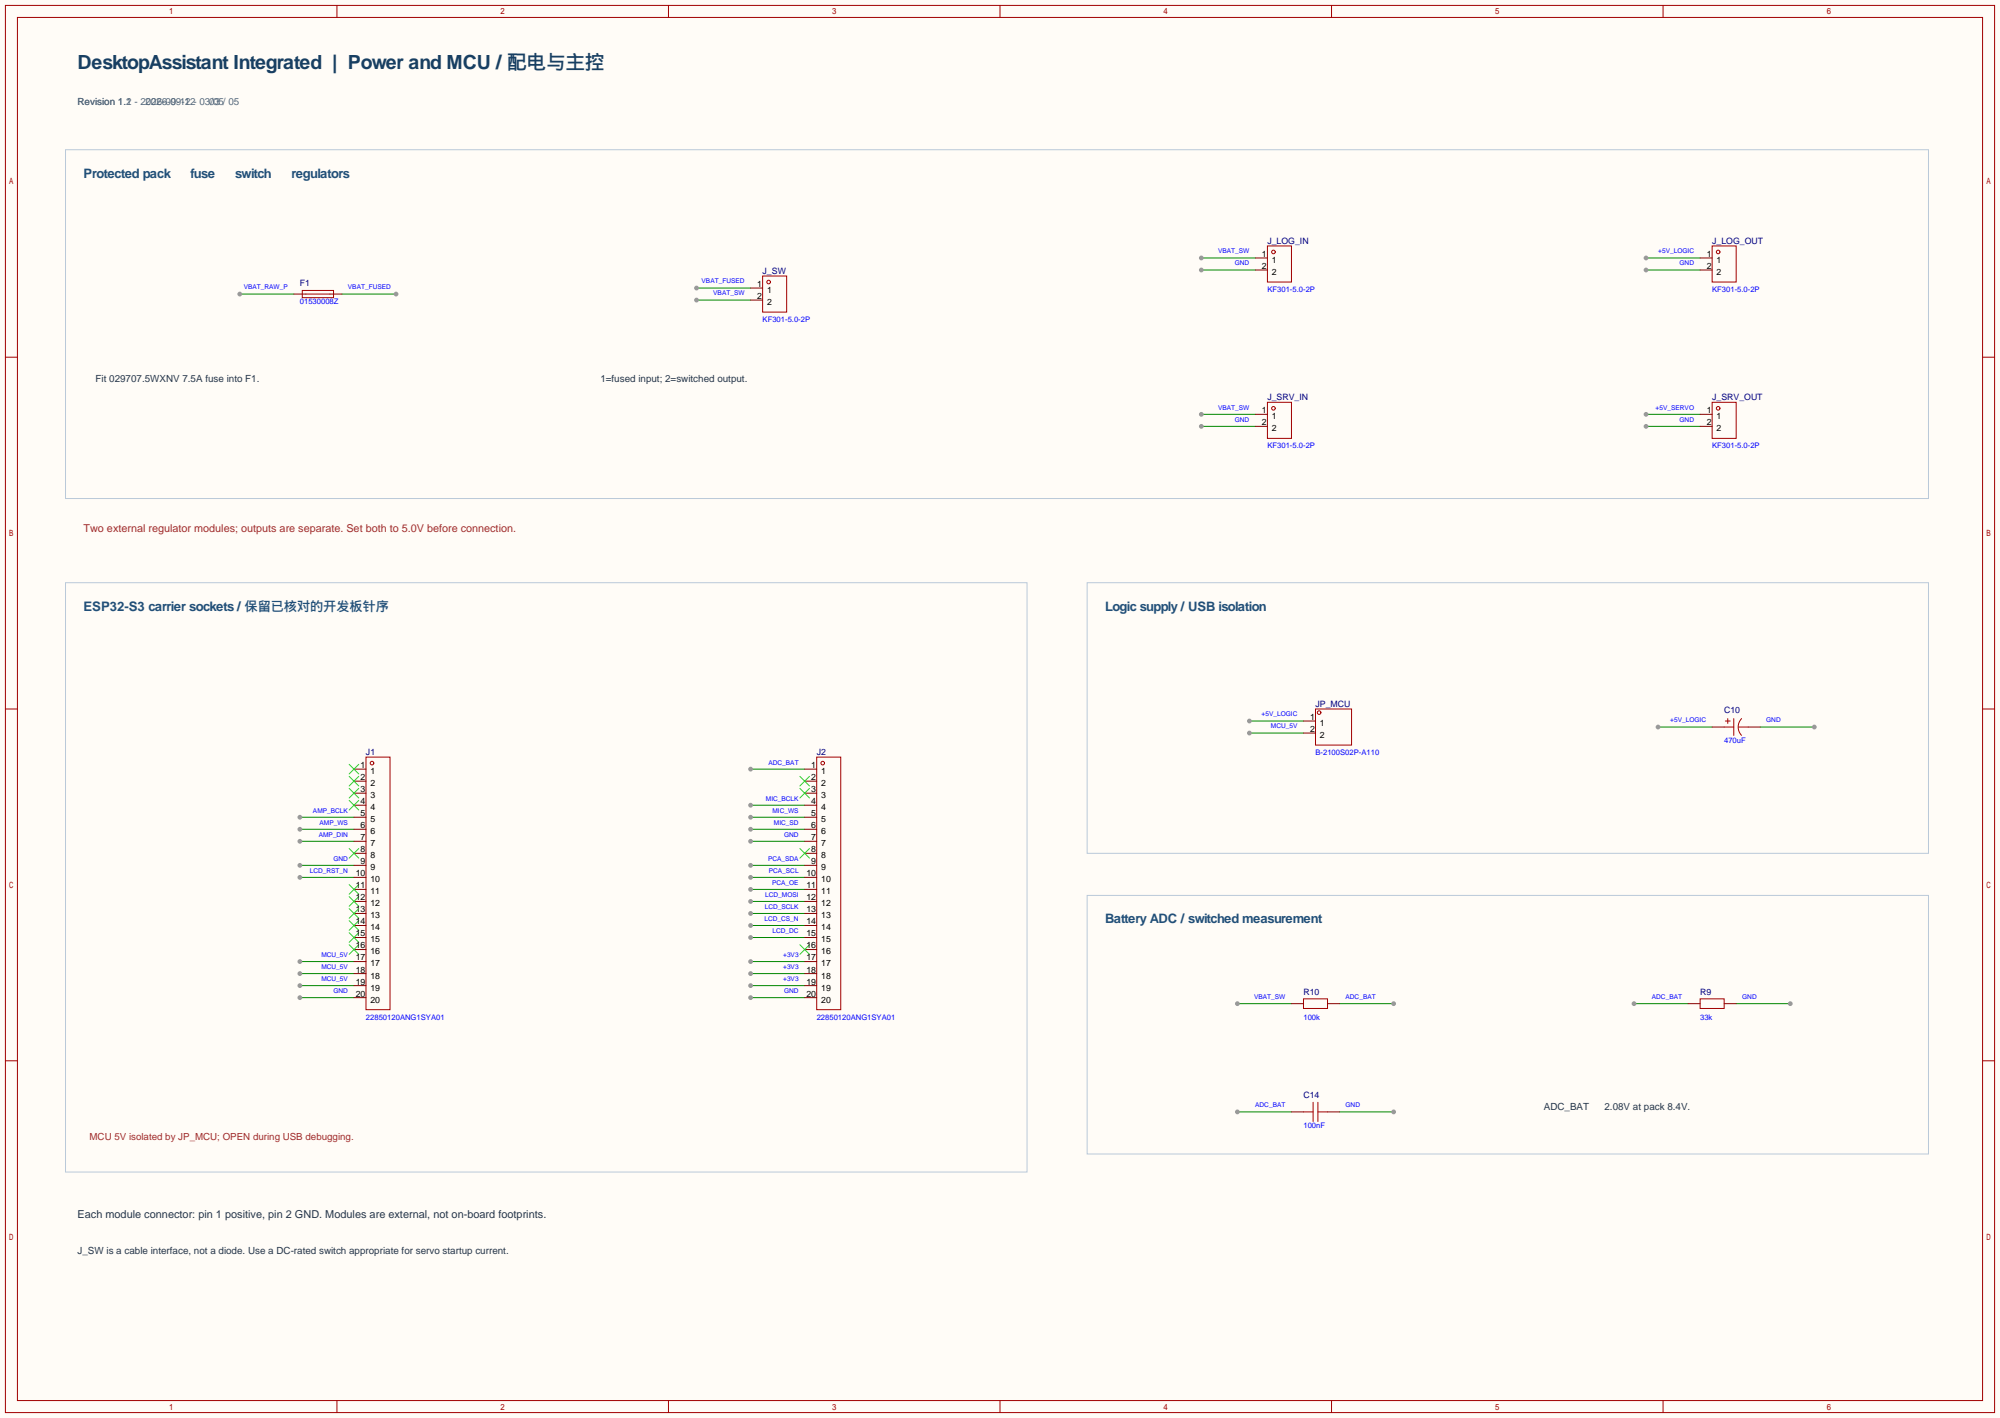
[picture p265: page 3]

1=fused input; 2=switched output.

Two external regulator modules; outputs are separate. Set both to 5.0V before connection.

Logic supply / USB isolation

Battery ADC / switched measurement

MCU 5V isolated by JP_MCU; OPEN during USB debugging.

Each module connector: pin 1 positive, pin 2 GND. Modules are external, not on-board footprints.

J_SW is a cable interface, not a diode. Use a DC-rated switch appropriate for servo startup current.

GND; MIC_WS; MIC_BCLK; LCD_3V3; AMP_WS; AMP_BCLK; AMP_DIN; +5V_LOGIC; MIC_SD; 长排针,2.54mm,6p; I2S module harnesses / 音频线束接口; 3.3V LCD supply / 独立隔离的屏幕支路; JP_LCD

LCD source follows RevB isolation strategy. This page does not connect the two regulator outputs.

All ESP32 signals are 3.3V. Debounce encoder and button in firmware.

LCD_3V3; LCD_SCLK; LCD_MOSI LCD_RST_N LCD_DC LCD_CS_N; GND; SPI display harness / 屏幕线束接口

J3: cable to external HS24S010B pins 1-10; pins 9/10 NC.

## EC11 controls / 旋钮与按压

# DesktopAssistant Integrated | Display, audio and controls / 显示音频与交互

Speaker connects to amplifier OUT+/OUT , not motherboard GND.

Select ONE LCD source. Keep JP_LCD open when J10 is used.

These are wire-harness pinouts; follow signal names on the modules.

J5: 1=BCLK, 2=WS, 3=DIN, 4=5V, 5=GND, 6=GND aux.

J4: 1=BCLK, 2=WS, 3=SD, 4=3V3, 5=GND, 6=L/R GND.

## ST7789V2 - 240 x 320 - 4-wire SPI - 3.3V only

## CN1: 1 GND | 2 VCC | 3 SCL | 4 SDA | 5 RES

## CN1: 6 DC | 7 CS | 8 BLK | 9 FSO | 10 FCS

BLK is a control input: held HIGH for backlight ON.

FSO/FCS: optional font/flash; pins 9/10 are NC here.

Pin table and mechanical CN1 agree; inset schematic differs.

Check actual screen silk before wiring the XH-to-2.54mm cable.

# DesktopAssistant Integrated | Display and audio / 显示与音频

## HS24S010B interface notes / 屏幕接口说明

All ESP32 and LCD signals are 3.3V. No on-board encoder or user buttons.

## PCA9685 " I2C 0x40 " OE high = outputs disabled

# DesktopAssistant Integrated | PWM and servos / 舵机控制与配电

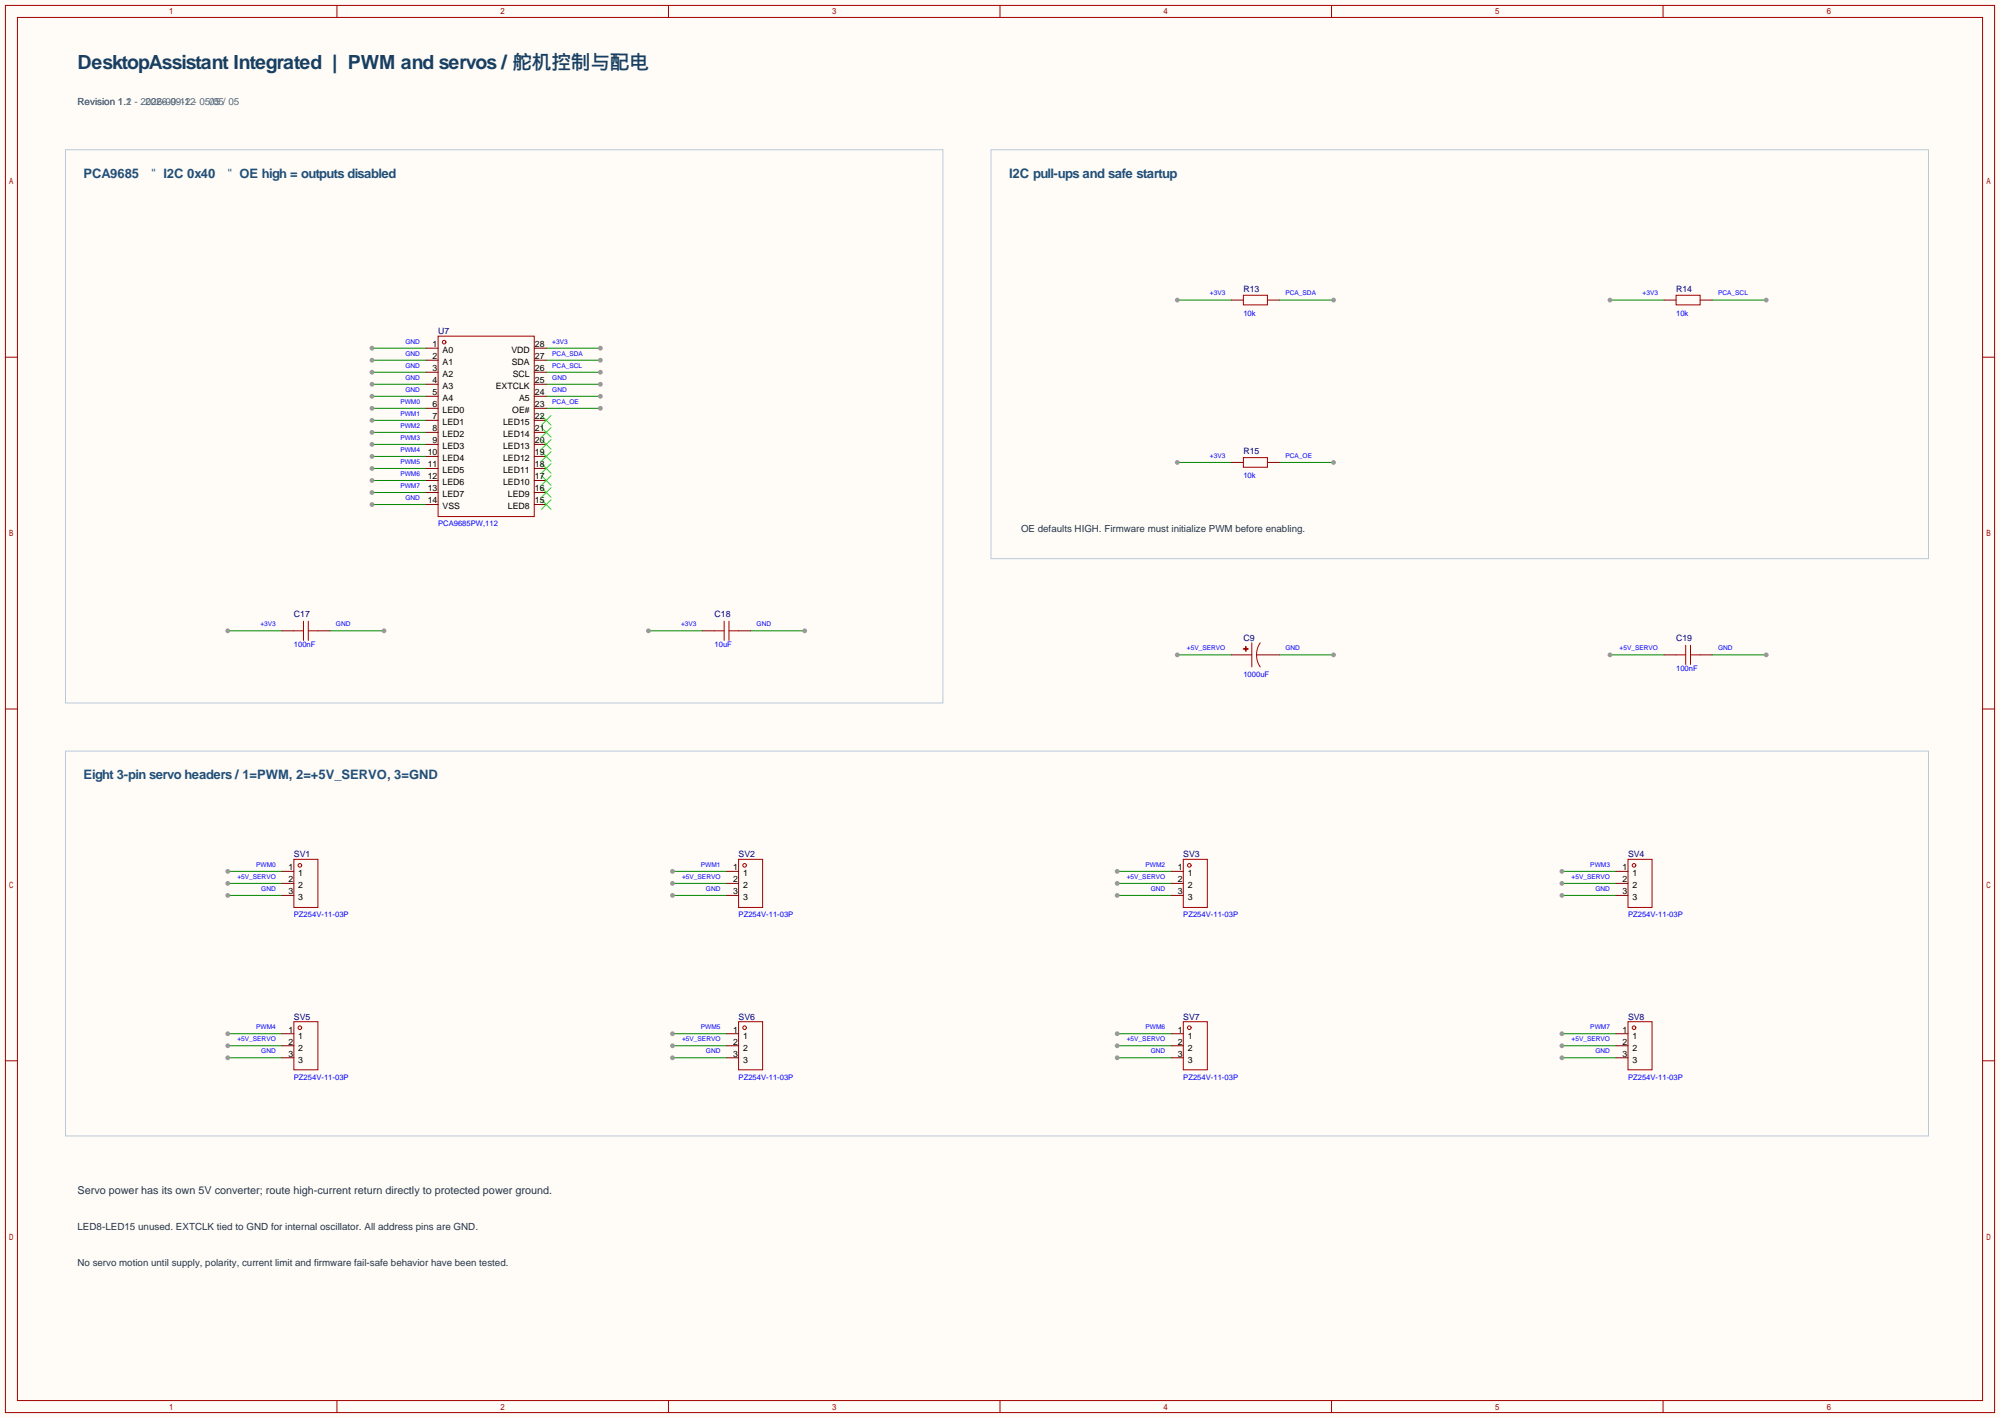
[picture p266: page 5]

I2C pull-ups and safe startup

OE defaults HIGH. Firmware must initialize PWM before enabling.

Eight 3-pin servo headers / 1=PWM, 2=+5V_SERVO, 3=GND

Servo power has its own 5V converter; route high-current return directly to protected power ground.

LED8-LED15 unused. EXTCLK tied to GND for internal oscillator. All address pins are GND.

No servo motion until supply, polarity, current limit and firmware fail-safe behavior have been tested.
