xaiojie/papabot/pcb-design/integrated-v1/repair-2026-09-12/generated/Integrated_schematic.pdf

OD 1
OC 2

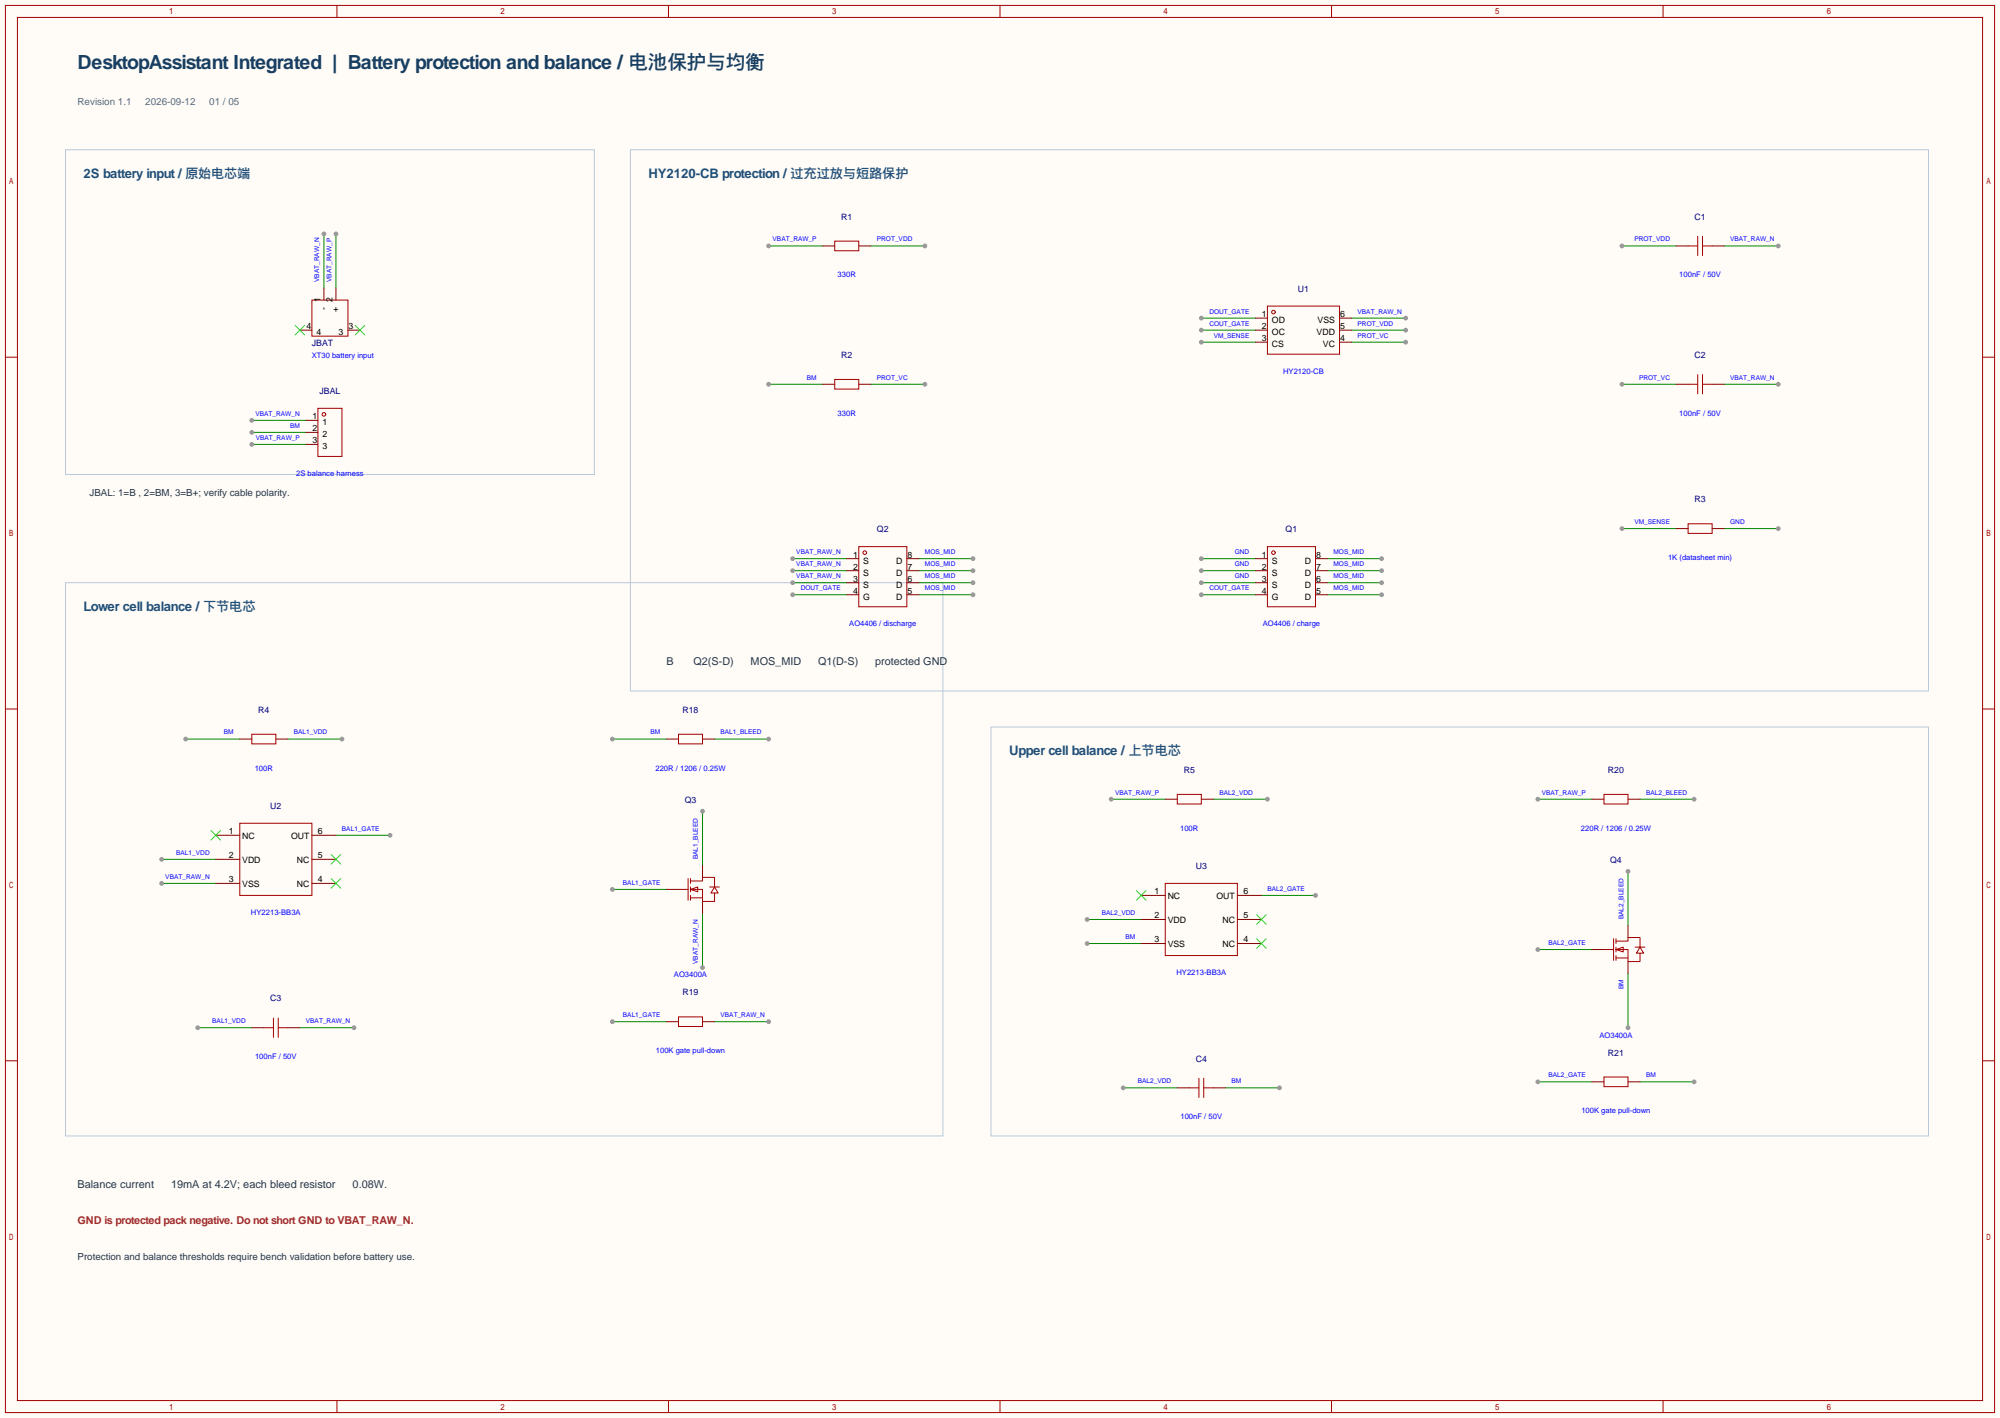
[picture p267: page 1]

DesktopAssistant Integrated | Battery protection and balance / 电池保护与均衡

JBAL: 1=B , 2=BM, 3=B+; verify cable polarity.

Lower cell balance / 下节电芯

Upper cell balance / 上节电芯

Balance current 19mA at 4.2V; each bleed resistor 0.08W.

GND is protected pack negative. Do not short GND to VBAT_RAW_N.

Protection and balance thresholds require bench validation before battery use.

C8

L1

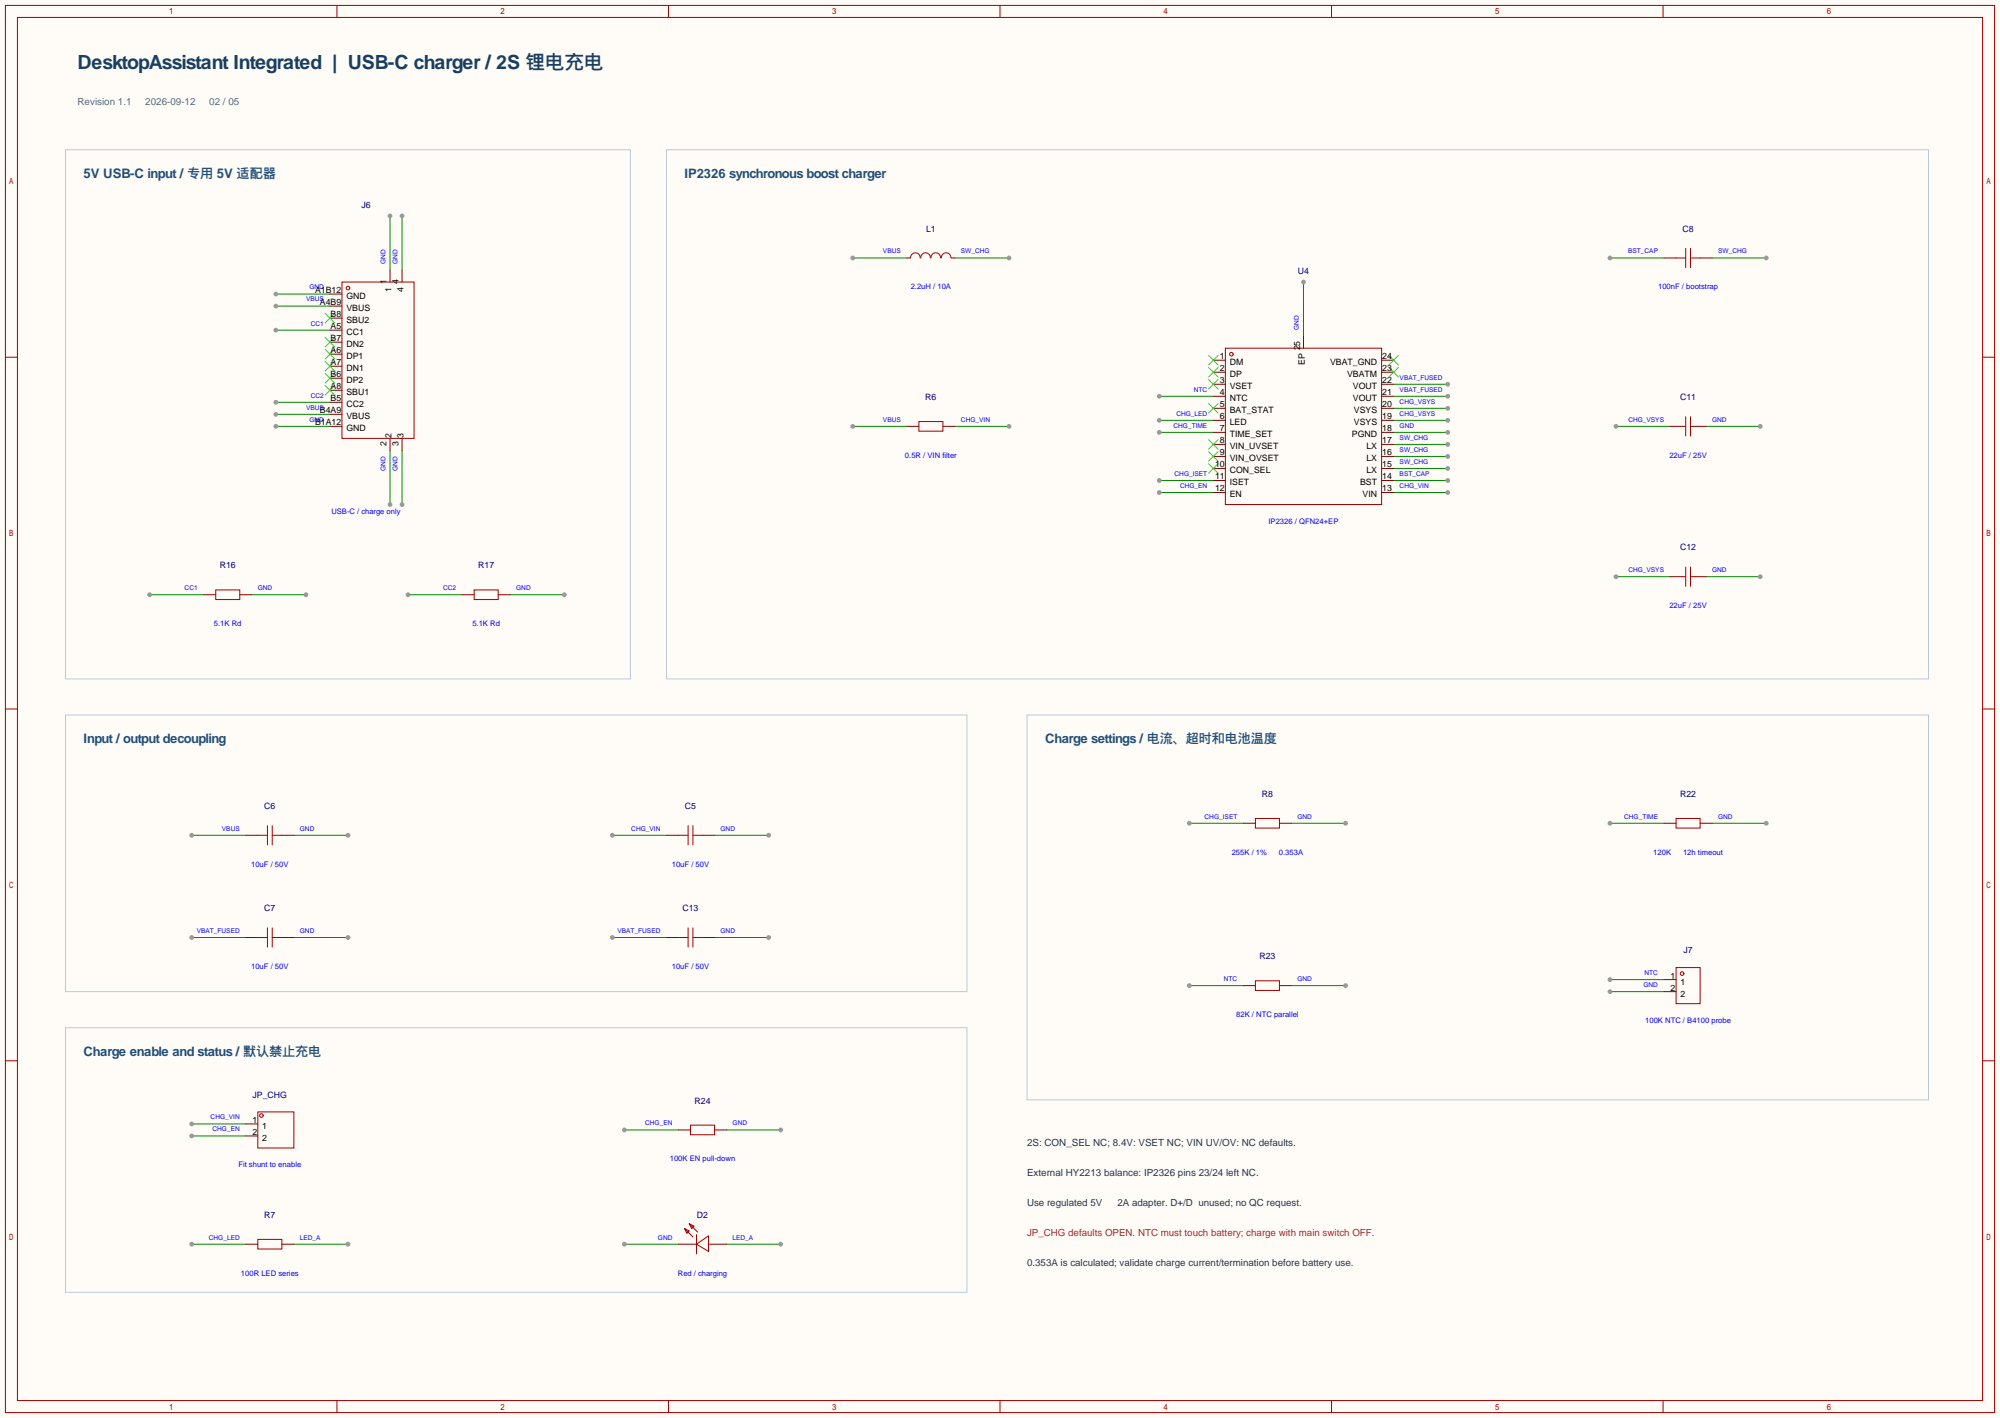
[picture p268: page 2]

DesktopAssistant Integrated | USB-C charger / 2S 锂电充电

5V USB-C input / 专用 5V 适配器

Charge settings / 电流、超时和电池温度

Charge enable and status / 默认禁止充电

2S: CON_SEL NC; 8.4V: VSET NC; VIN UV/OV: NC defaults.

Fit shunt to enable

External HY2213 balance: IP2326 pins 23/24 left NC.

Use regulated 5V 2A adapter. D+/D unused; no QC request.

JP_CHG defaults OPEN. NTC must touch battery; charge with main switch OFF.

0.353A is calculated; validate charge current/termination before battery use.

1

1

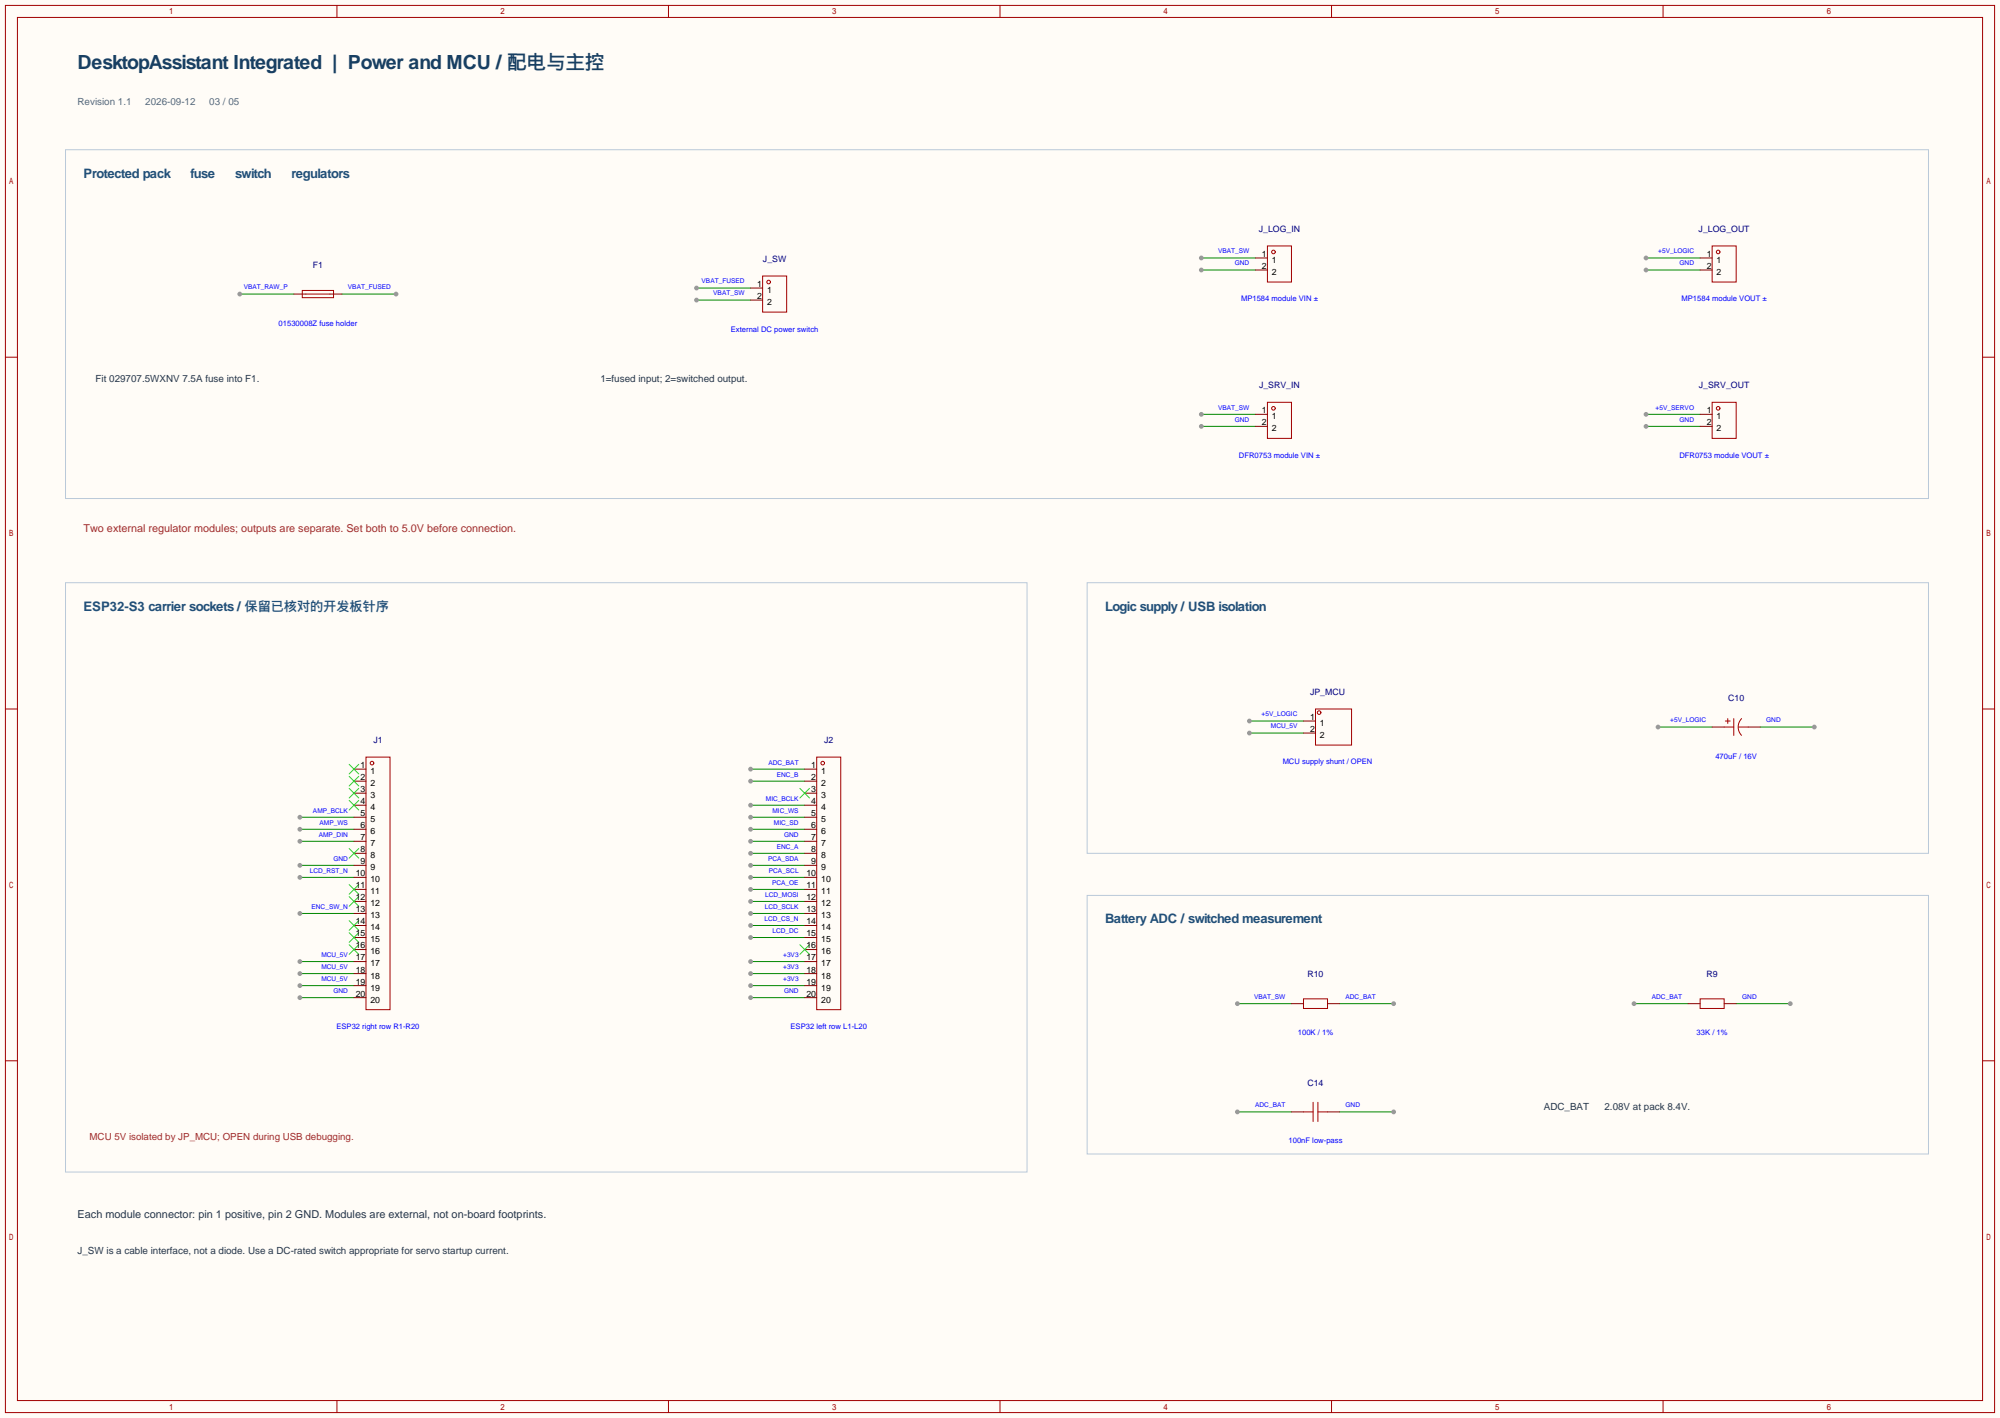
[picture p269: page 3]

DesktopAssistant Integrated | Power and MCU / 配电与主控

Protected pack fuse switch regulators

External DC power switch

1=fused input; 2=switched output.

Two external regulator modules; outputs are separate. Set both to 5.0V before connection.

Logic supply / USB isolation

MCU supply shunt / OPEN

Battery ADC / switched measurement

MCU 5V isolated by JP_MCU; OPEN during USB debugging.

Each module connector: pin 1 positive, pin 2 GND. Modules are external, not on-board footprints.

J_SW is a cable interface, not a diode. Use a DC-rated switch appropriate for servo startup current.

## GND 1 VCC 2

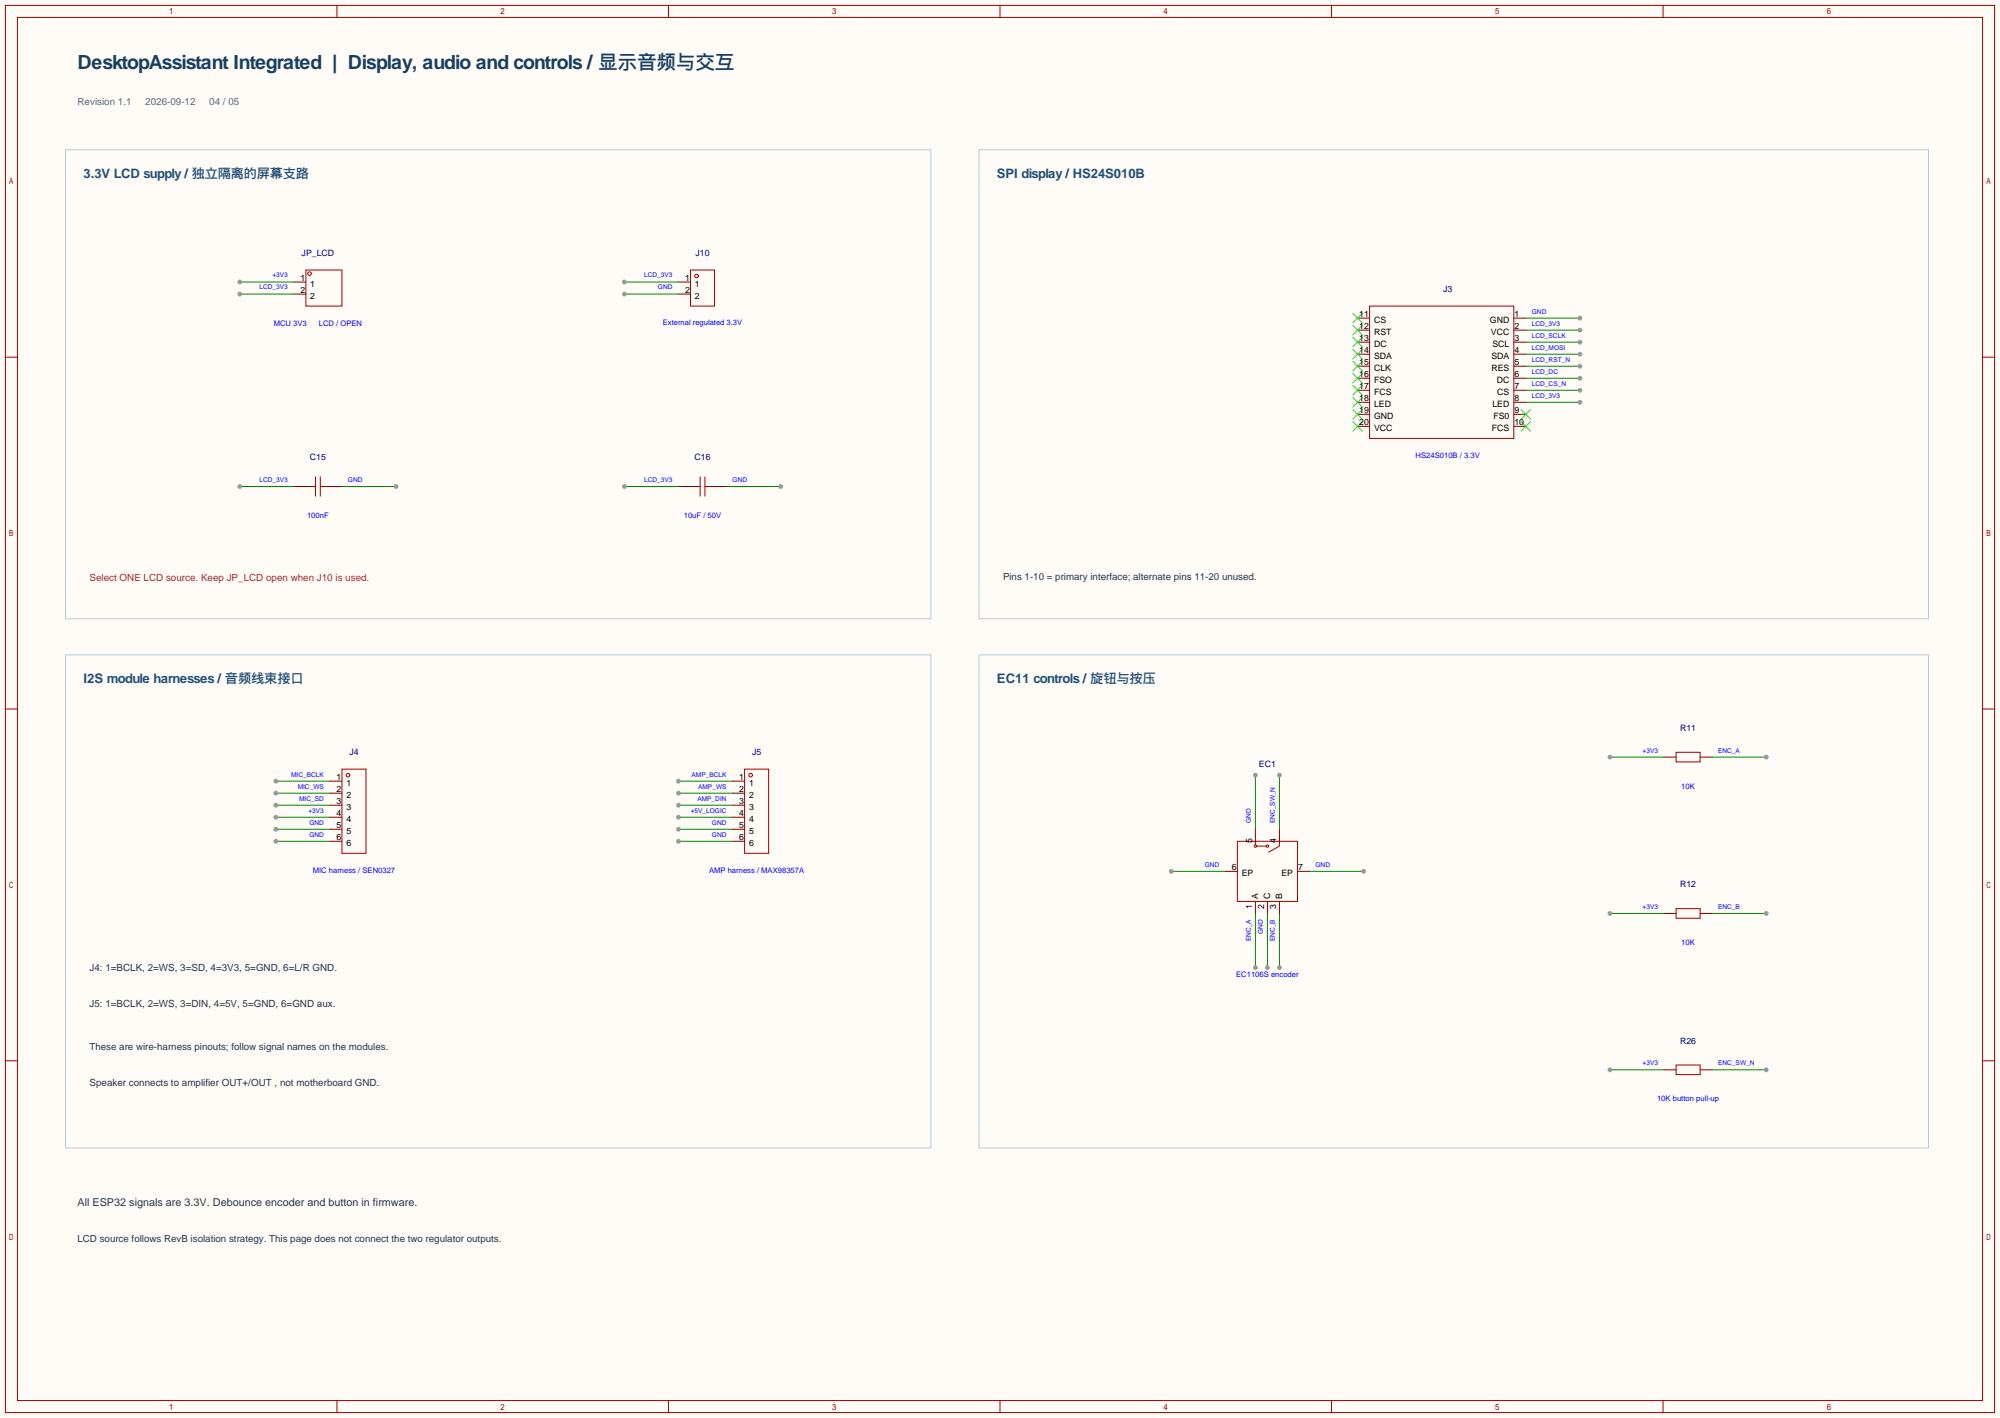
[picture p270: page 4]

DesktopAssistant Integrated | Display, audio and controls / 显示音频与交互

Select ONE LCD source. Keep JP_LCD open when J10 is used.

Pins 1-10 = primary interface; alternate pins 11-20 unused.

J4: 1=BCLK, 2=WS, 3=SD, 4=3V3, 5=GND, 6=L/R GND.

J5: 1=BCLK, 2=WS, 3=DIN, 4=5V, 5=GND, 6=GND aux.

These are wire-harness pinouts; follow signal names on the modules.

Speaker connects to amplifier OUT+/OUT , not motherboard GND.

All ESP32 signals are 3.3V. Debounce encoder and button in firmware.

LCD source follows RevB isolation strategy. This page does not connect the two regulator outputs.

A0 1
A1 2

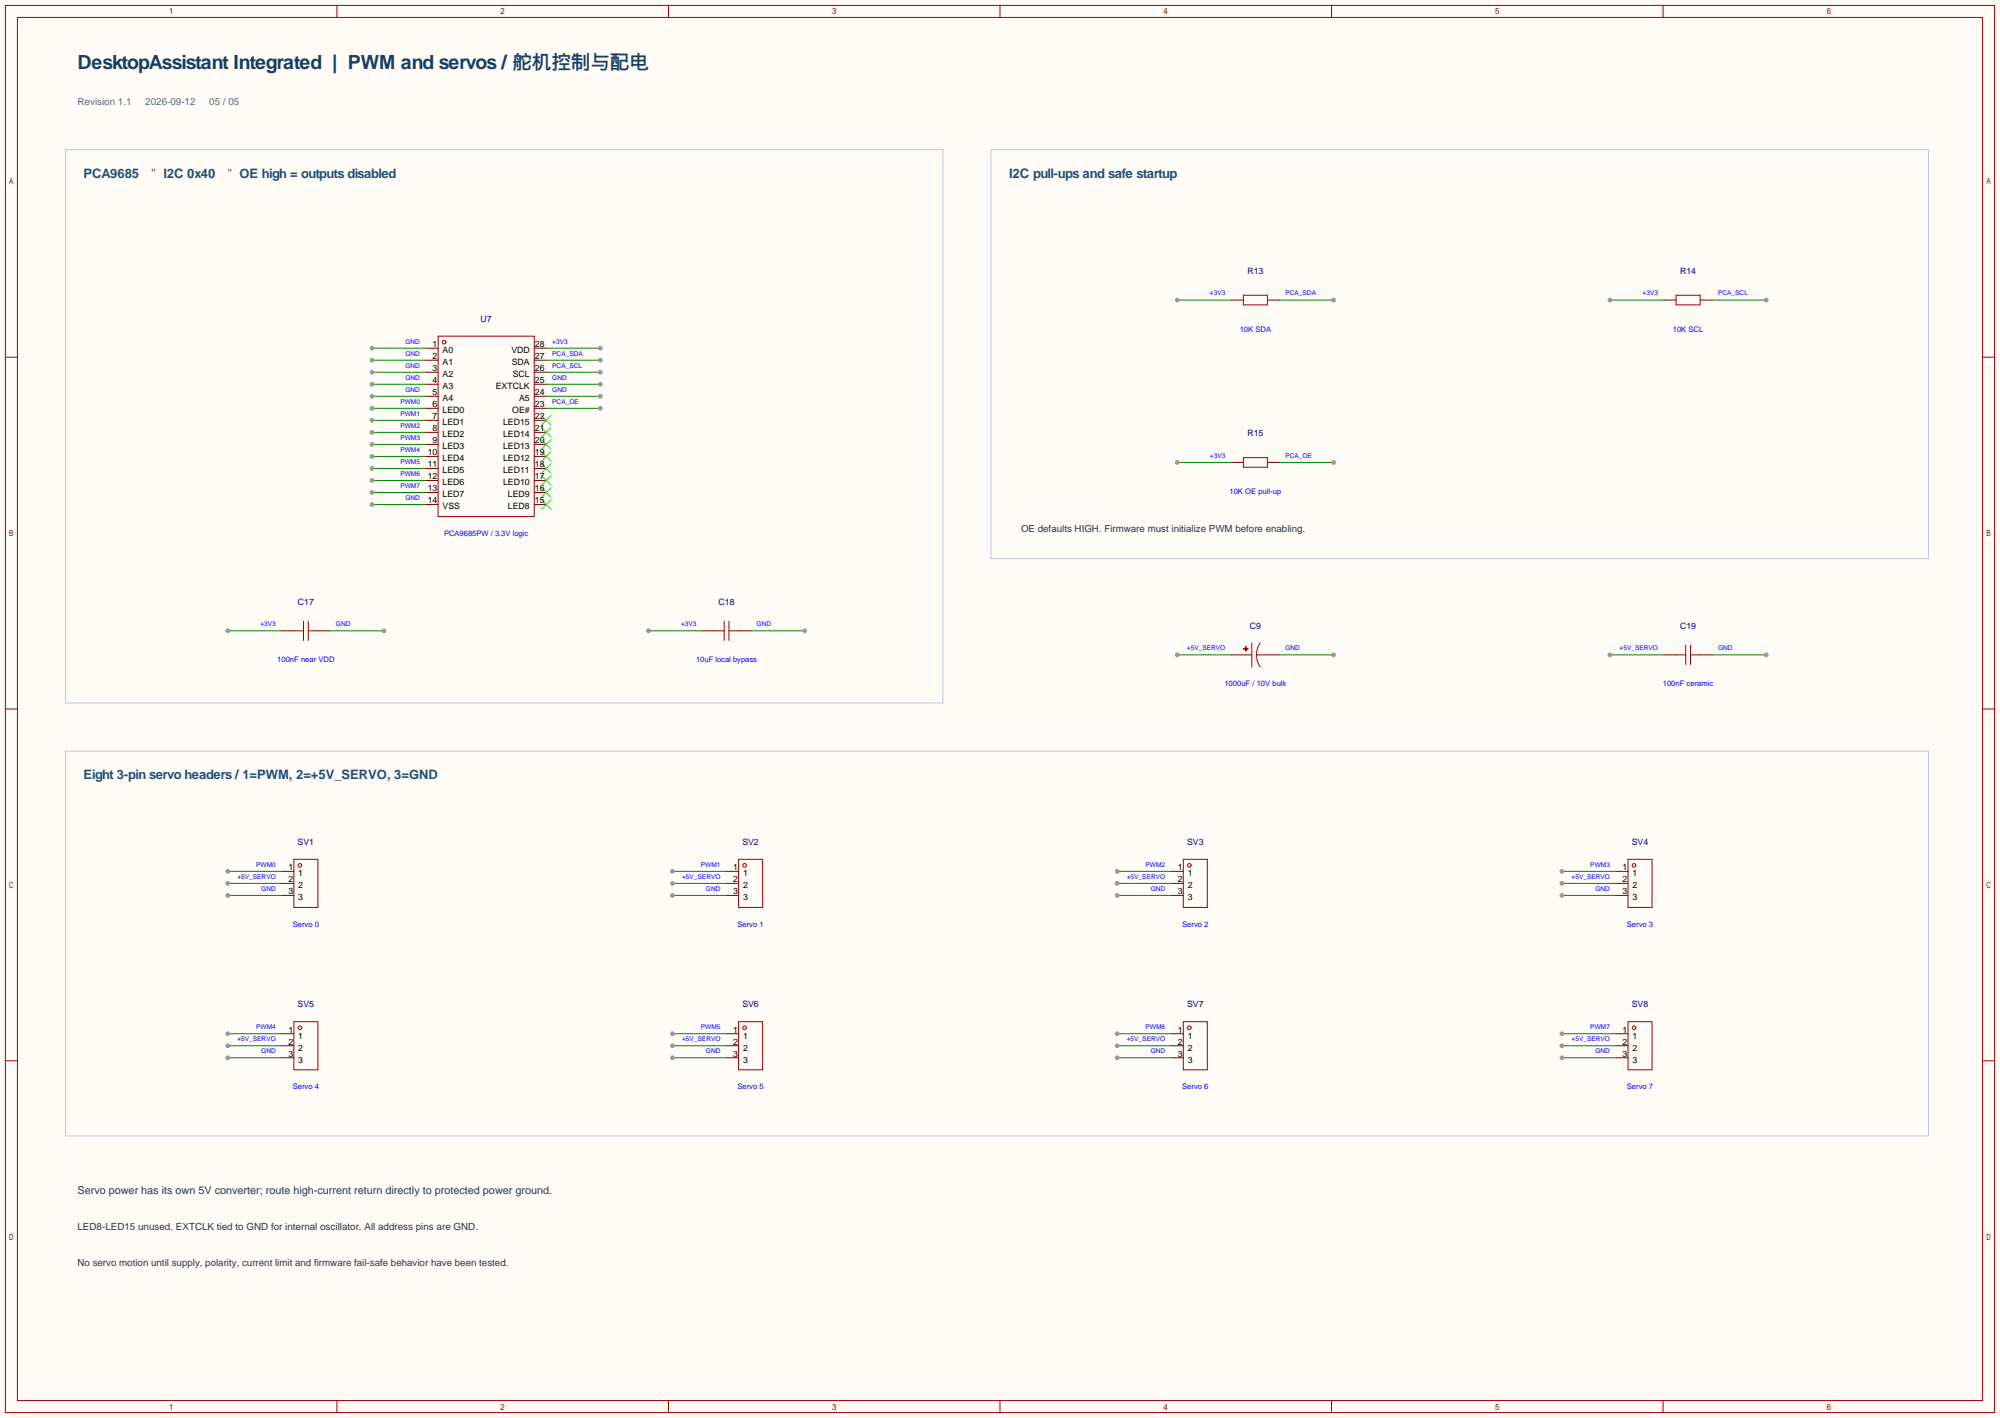
[picture p271: page 5]

DesktopAssistant Integrated | PWM and servos / 舵机控制与配电

PCA9685 " I2C 0x40 " OE high = outputs disabled

I2C pull-ups and safe startup

OE defaults HIGH. Firmware must initialize PWM before enabling.

Eight 3-pin servo headers / 1=PWM, 2=+5V_SERVO, 3=GND

Servo power has its own 5V converter; route high-current return directly to protected power ground.

LED8-LED15 unused. EXTCLK tied to GND for internal oscillator. All address pins are GND.

No servo motion until supply, polarity, current limit and firmware fail-safe behavior have been tested.
