xaiojie/papabot/pcb-design/native-rev-a/supplier-review-2026-09-09/sources/EC11资料/EC1103-D5-K15F7.pdf

I

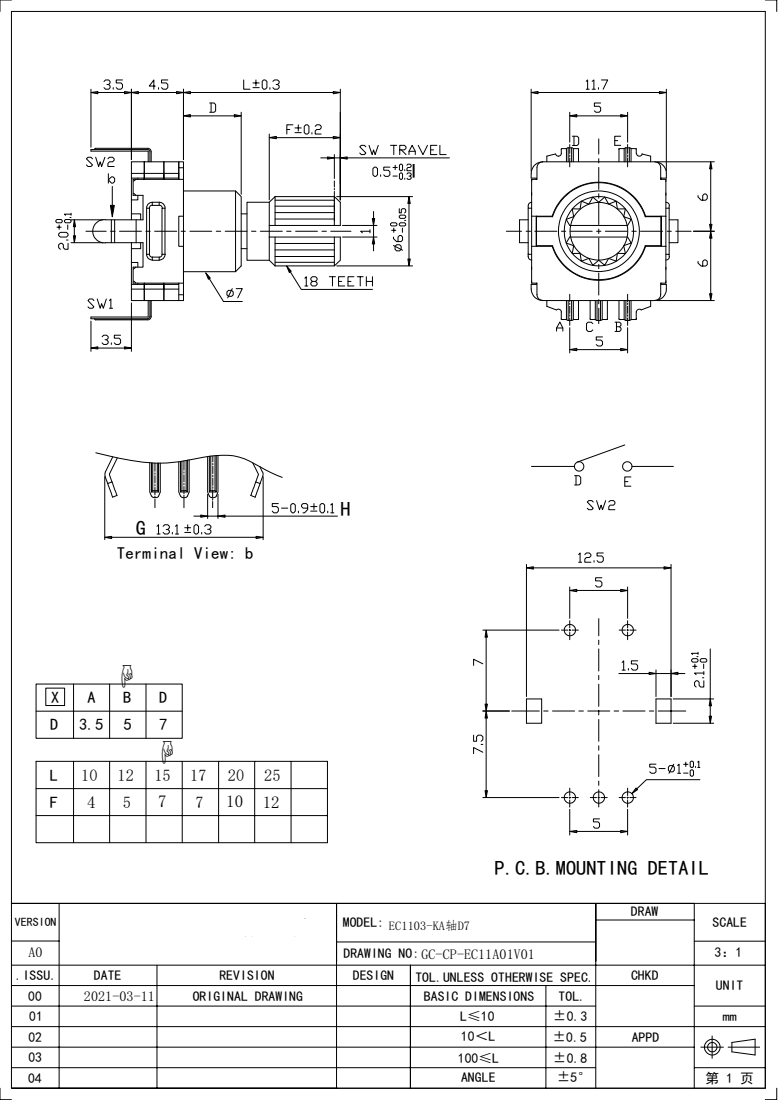
[picture p272: page 1]
VERSION; .ISSU.; DATE; REVISION; MODEL:; DRAWING NO:; DESIGN; BASIC DIMENSIONS; ANGLE; TOL.; DRAW; CHKD; APPD; SCALE; UNIT; ORIGINAL DRAWING; TOL.UNLESS OTHERWISE SPEC.; EC1103-KA轴D7; Terminal View: b; P.C.B.MOUNTING DETAIL; 李大伟; 东莞市点到面科技有限公司; Dongguan PtoS Technology Co., Ltd
