xaiojie/papabot/(list of files, drawings)

Other design files:
mechanical-design/structure-a2/reports/pcb-fastener-head-check.json
pcb-design/integrated-v1/final-2026-09-12/PCB_DRC_final.json
pcb-design/integrated-v1/final-2026-09-12/Schematic_DRC_final.json
pcb-design/integrated-v1/final-no-encoder-2026-09-12/Schematic_verification.json
pcb-design/integrated-v1/layout-2026-09-12/native-critical.dsn
pcb-design/integrated-v1/layout-2026-09-12/native-placed.dsn
pcb-design/integrated-v1/layout-2026-09-12/routing-input.dsn
pcb-design/integrated-v1/no-encoder-2026-09-12/pcb-after-deletion-drc.json
pcb-design/integrated-v1/no-encoder-2026-09-12/pcb-baseline-drc.json
pcb-design/integrated-v1/no-encoder-2026-09-12/pcb-before.json
pcb-design/integrated-v1/no-encoder-2026-09-12/pcb-deletion-plan.json
pcb-design/integrated-v1/no-encoder-2026-09-12/schematic-deletion-plan.json
pcb-design/integrated-v1/repair-2026-09-12/generated/pcb-components-raw.json
pcb-design/integrated-v1/repair-2026-09-12/generated/pcb-pad-netlist.json
pcb-design/integrated-v1/repair-2026-09-12/generated/pcb-verification.json
pcb-design/native-rev-a/history/before-outline-recognition-fix/pcb-persisted-geometry.json
pcb-design/native-rev-a/history/before-outline-recognition-fix/pcb-routed-readback.json
pcb-design/native-rev-a/pcb-current-silk.json
pcb-design/native-rev-a/pcb-free-pads.json
pcb-design/native-rev-a/pcb-imported-pads.json
pcb-design/native-rev-a/pcb-netlist-check.json
pcb-design/native-rev-a/pcb-persisted-geometry.json
pcb-design/native-rev-a/pcb-placed-pads.json
pcb-design/native-rev-a/pcb-routed-readback.json
pcb-design/native-rev-a/pcb-silk-attributes.json
pcb-design/native-rev-a/schematic-polish-before.json
pcb-design/native-rev-a/schematic-tight-labels.json
pcb-design/native-rev-b/before/pcb-live-readback.json
pcb-design/native-rev-b/before/schematic-final-components.json
pcb-design/native-rev-b/before/schematic-readback.json
pcb-design/native-rev-b/pcb-final-readback.json
pcb-design/native-rev-b/pcb-free-pads.json
pcb-design/native-rev-b/pcb-persisted-geometry.json
pcb-design/native-rev-b/pcb-placed-pads.json
pcb-design/native-rev-b/pcb-placed-readback.json
pcb-design/native-rev-b/pcb-synced.json
pcb-design/native-rev-b/schematic-initial-drc-errors.json
pcb-design/native-rev-b/schematic-modification-plan.json
pcb-design/native-rev-b/schematic-new-parts.json
