xaiojie/papabot/(commit log)

2026-10-26 初始提交：ESP32-S3 四足桌面助手（爬爬）
    - firmware/：bringup 硬件自检 + assistant 产品固件（9 屏 / 3 部 GIF 动画）
    - pcb-design/：RevA、RevB 模块载板、integrated-v1 集成板（原理图/PCB/Gerber）
    - mechanical-design/：A2–A5 结构、装配、打印件与 STL
    - hardware-selection/：选型、BOM、电池/舵机/屏幕资料
    - 设计记录：design-selection.json、项目进度总览.md、design-coordination/
    本次未入库（见 .gitignore）：
    - 编译产物 .pio/ 约 187 MB
    - PCB EDA audit 转储约 319 MB
    - Blender 母版（*.blend / *.blend1）约 262 MB，待装 git-lfs 后纳入
    - 四个整机试装包 ZIP 约 120 MB，建议走 GitHub Rel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
2026-10-26 docs: 重写 README 为完整的项目说明
    覆盖功能与用途、目录结构、环境依赖与安装、配置说明、主要模块与核心逻辑、
    启动与使用、常见问题、安全红线、未验证项与文档索引。
    旧的分日期交接说明移到 docs/交接说明-2026-09-12.md 保留。
2026-10-26 docs: 加 MIT LICENSE 与 README 首图
    - LICENSE：MIT，覆盖固件、网页控制台、PCB 与结构设计文件
    - docs/images/a5-hero.jpg：structure-a5 渲染图，1600px / 154 KB（原图 2.2 MB）
    - README：顶部插入首图（标注为渲染而非实物照片），许可章节改为 MIT 并说明第三方资料与字库边界
2026-10-26 chore: 把误入仓库的翻译云目录移出
    翻译云-php-demo / 翻译云-支付业务实现 属于另一个项目，只是恰好放在同一工作目录，
    不属于 papabot。已加入 .gitignore，本地文件保留不受影响。
2026-10-26 chore: 整理项目目录并清理本机依赖与缓存
2026-10-26 docs: 补齐第三方原始资料并建立来源索引
2026-10-26 docs: 重写项目 README 并添加状态徽章
